reivax-boucoi/PCB_Kicad/Planar_XFMR/Validation/rounded_internal_corners_issue.png

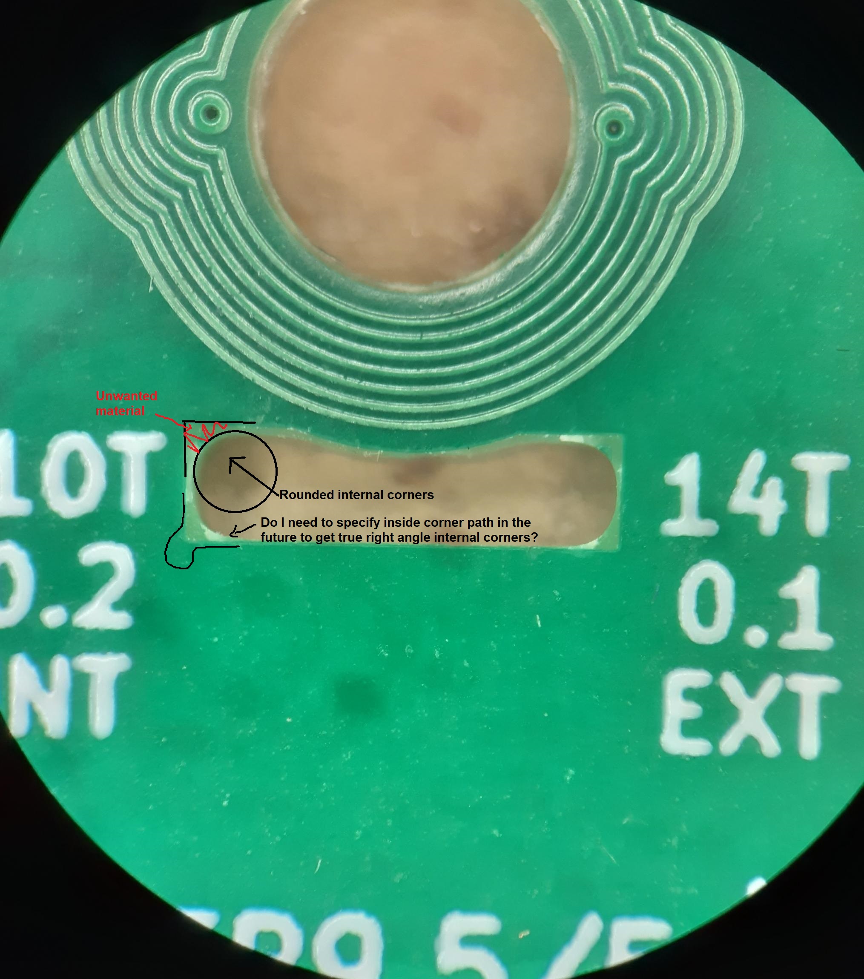
Planar_XFMR/Validation/rounded_internal_corners_issue.png
