reivax-boucoi/PCB_Kicad/Planar_XFMR/Validation/raw_brd.png

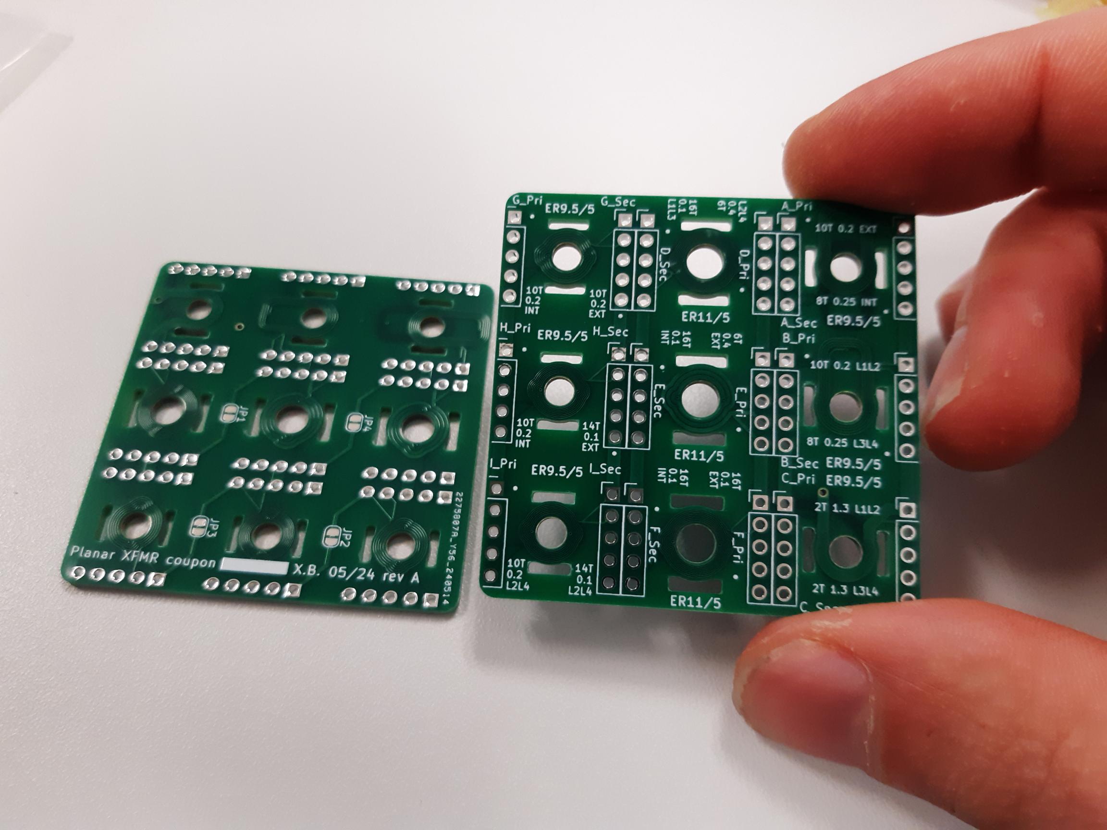
Planar_XFMR/Validation/raw_brd.png
