reivax-boucoi/PCB_Kicad/Planar_XFMR/Dimensions_labels.pptx

Core width

Pw

W

Sw

D S C S C S C S D

H

## Slide 2

N87 EP9.5-5 core (400nH/turns², B max = 390mT)

L1 copper 1oz

Prepreg 7628 0.21mm

L2 copper 0.5oz

Core 0.6mm

L2 copper 0.5oz

Prepreg 7628 0.21mm

L1 copper 1oz

Primary +

Primary -

Secondary +

Secondary -

Dielectric strength : 30kV/mm min.
