reivax-boucoi/PCB_Kicad/bike_lights2/bike_lights2_top.png

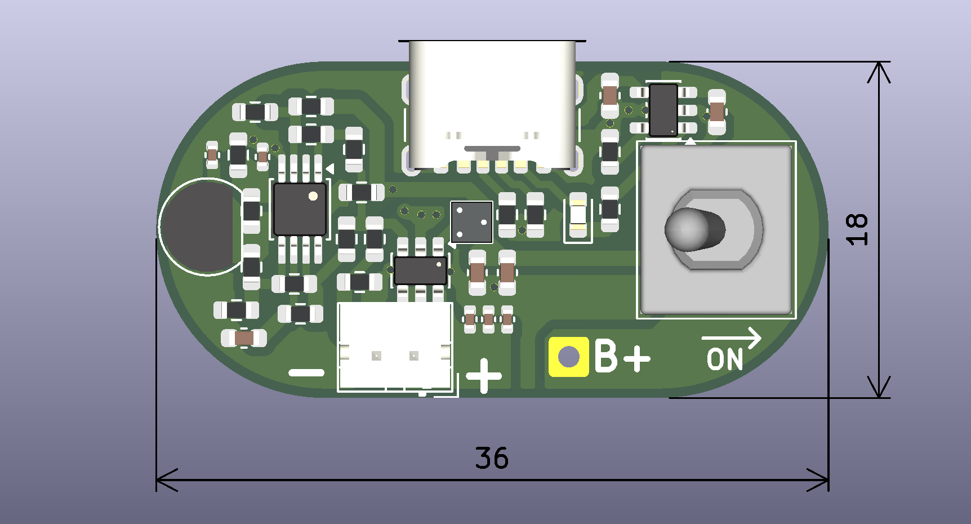
bike_lights2/bike_lights2_top.png
