reivax-boucoi/PCB_Kicad/elevator_altimeter/elevator_altimeter_back.png

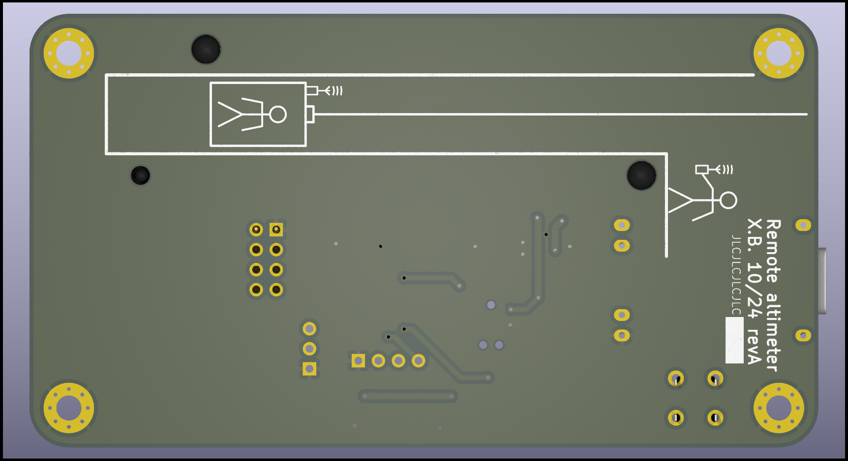
elevator_altimeter/elevator_altimeter_back.png
