reivax-boucoi/PCB_Kicad/elevator_altimeter/elevator_altimeter_front.png

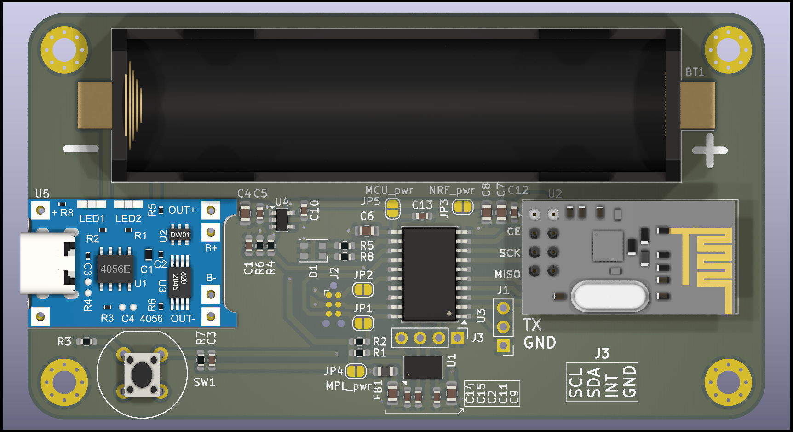
elevator_altimeter/elevator_altimeter_front.png
