reivax-boucoi/PCB_Kicad/elevator_altimeter/elevator_altimeter_iso.png

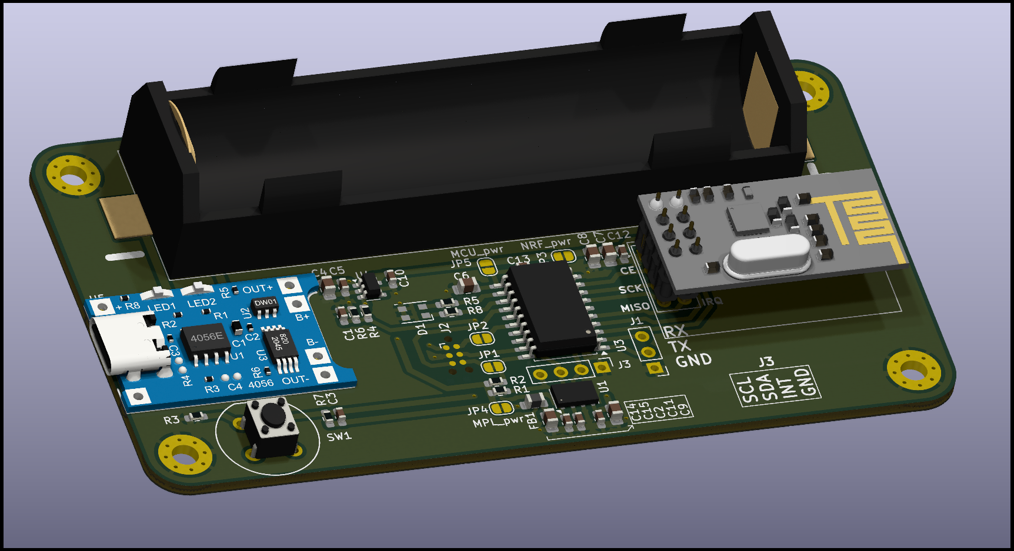
elevator_altimeter/elevator_altimeter_iso.png
