reivax-boucoi/PCB_Kicad/hall_sensor_matrix/hall_sensor_matrix_v2/hall_sensor_matrix_v2_back.png

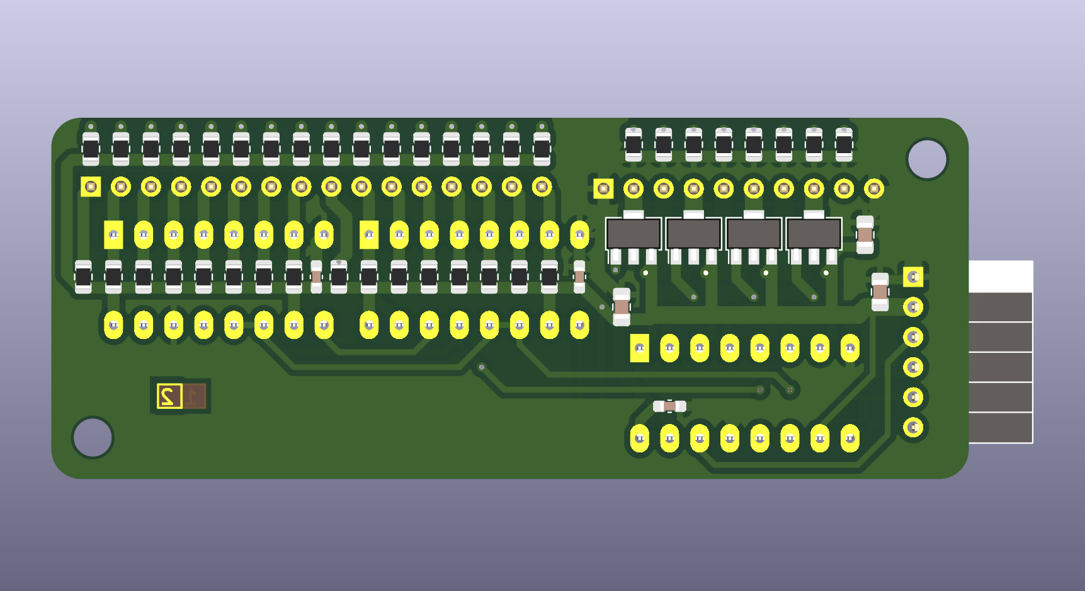
hall_sensor_matrix/hall_sensor_matrix_v2/hall_sensor_matrix_v2_back.png
