reivax-boucoi/PCB_Kicad/horse_feeder/Documentation/Source/system_diagram.drawio.png

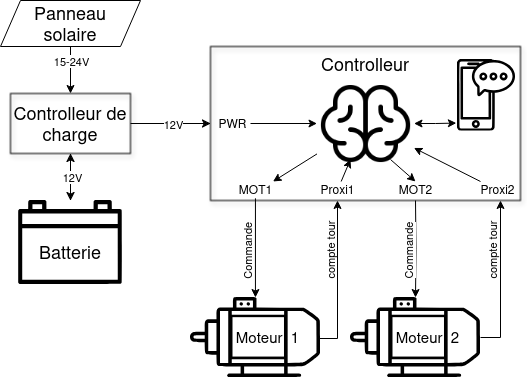
horse_feeder/Documentation/Source/system_diagram.drawio.png
