reivax-boucoi/PCB_Kicad/horse_feeder/HW/PCB_v2_M590E/horse_feeder_bot.png

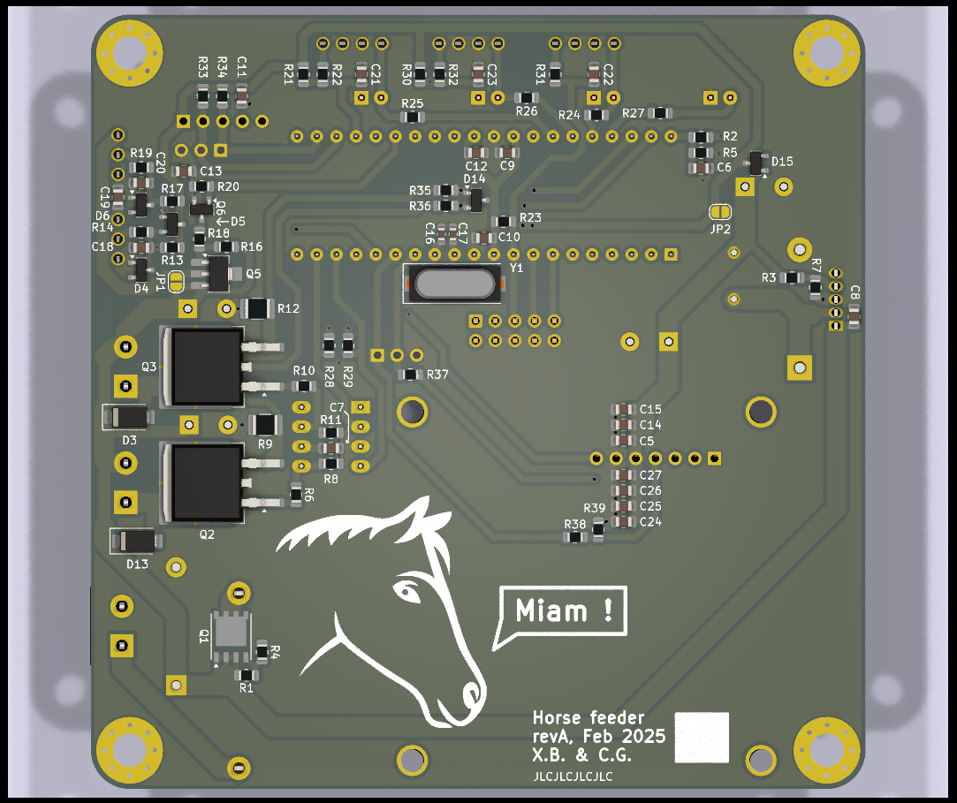
horse_feeder/HW/PCB_v2_M590E/horse_feeder_bot.png
