reivax-boucoi/PCB_Kicad/horse_feeder/HW/tremie/vue_coupe.png

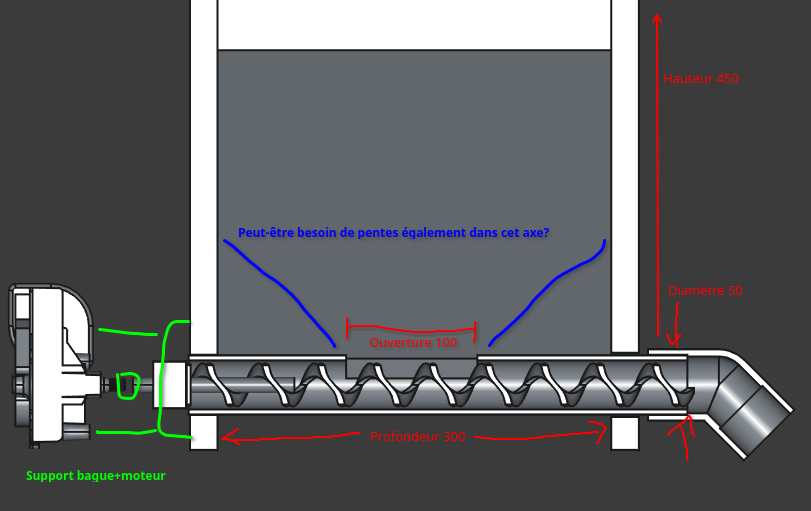
horse_feeder/HW/tremie/vue_coupe.png
