reivax-boucoi/PCB_Kicad/horse_feeder/HW/tremie/vue_iso.png

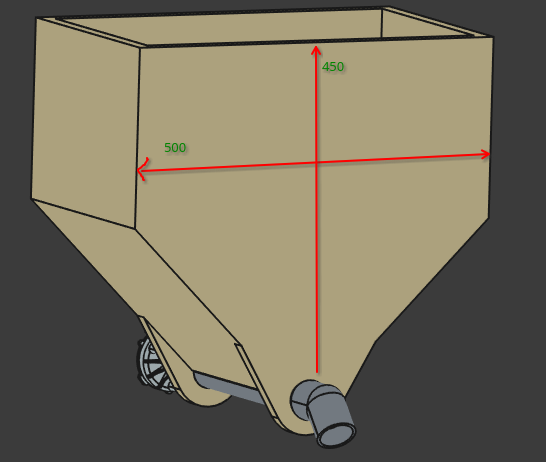
horse_feeder/HW/tremie/vue_iso.png
