reivax-boucoi/PCB_Kicad/Kheprism/HW/PCB_Ventil/PCB_Ventil_bot.png

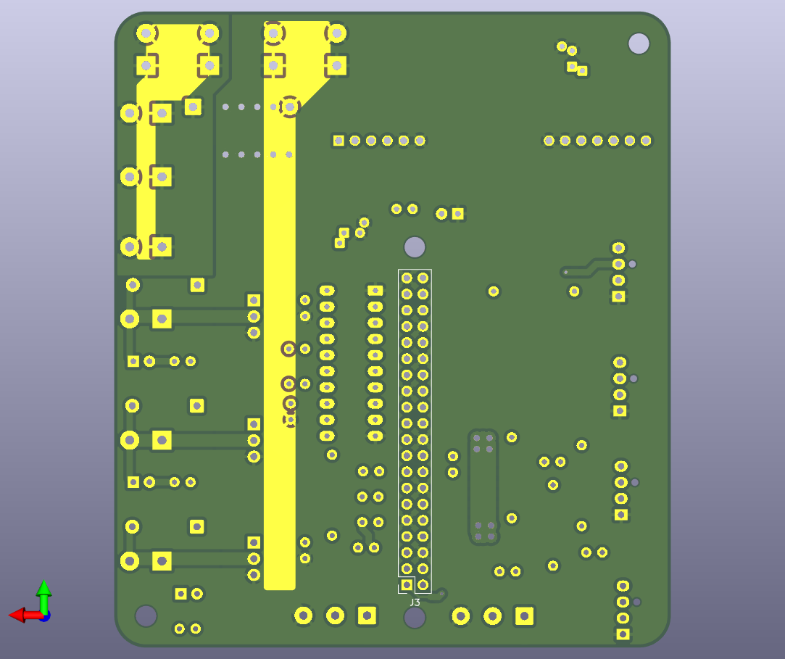
Kheprism/HW/PCB_Ventil/PCB_Ventil_bot.png
