reivax-boucoi/PCB_Kicad/Kheprism/HW/PCB_Ventil/PCB_Ventil_top.png

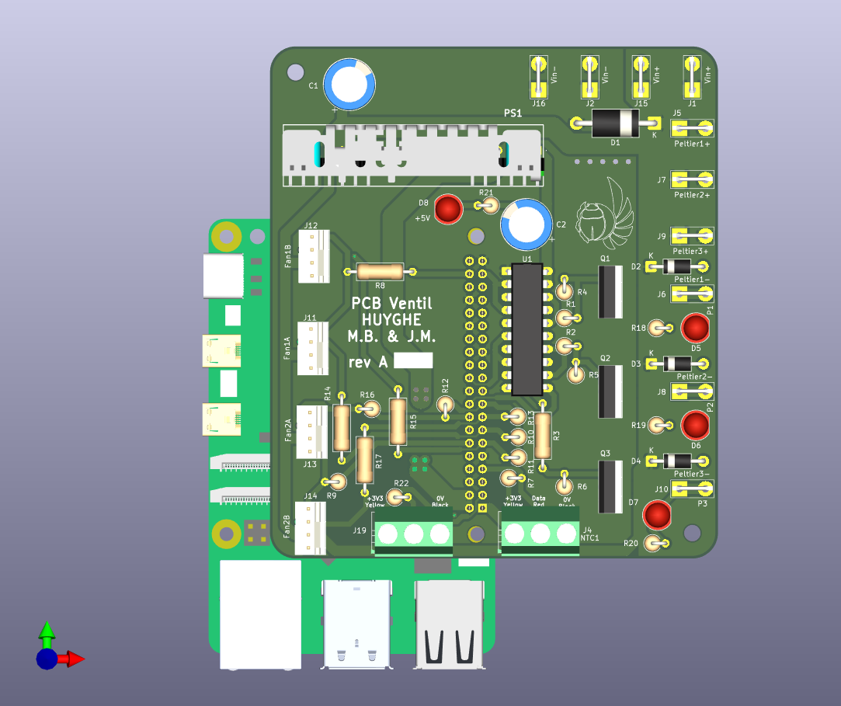
Kheprism/HW/PCB_Ventil/PCB_Ventil_top.png
