reivax-boucoi/PCB_Kicad/LED_poi/CTRL_board/LED_poi_brd_bot.png

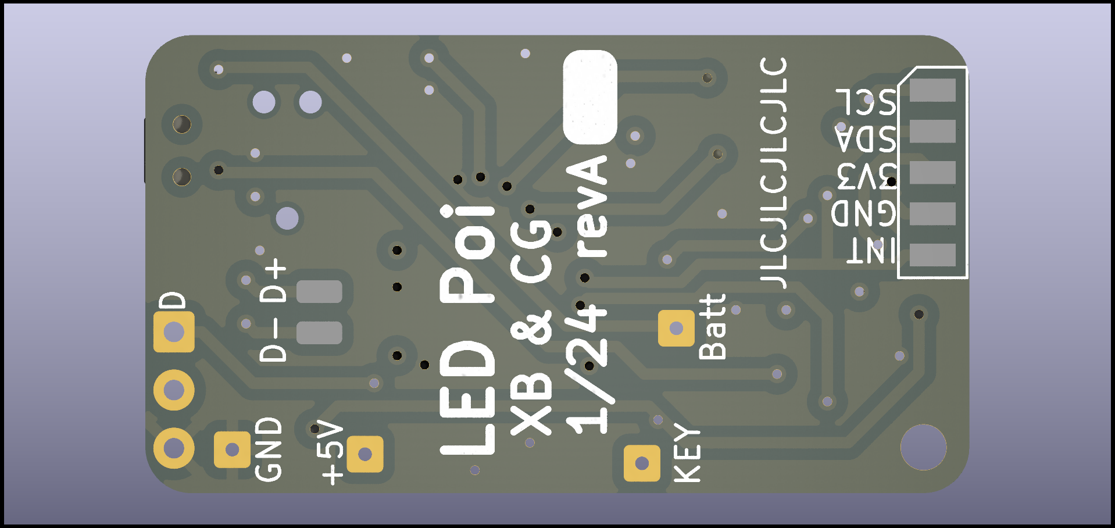
LED_poi/CTRL_board/LED_poi_brd_bot.png
