reivax-boucoi/PCB_Kicad/LED_poi/CTRL_board/LED_poi_brd_iso.png

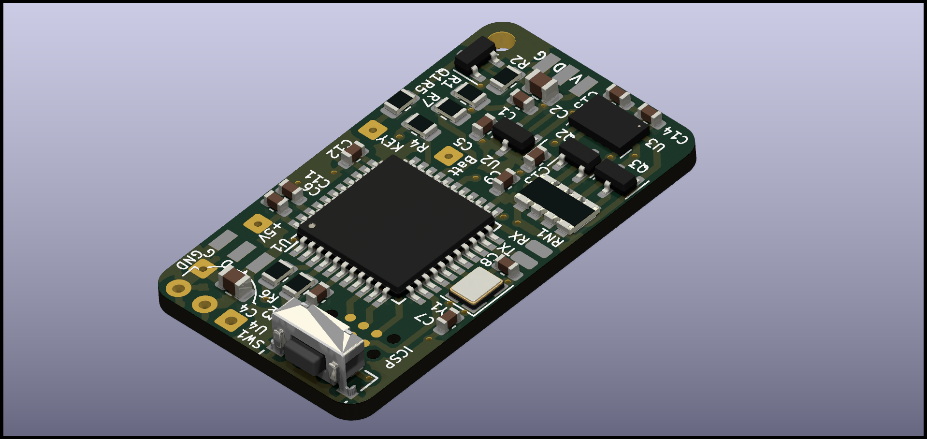
LED_poi/CTRL_board/LED_poi_brd_iso.png
