reivax-boucoi/PCB_Kicad/LED_poi/CTRL_board/LED_strip.png

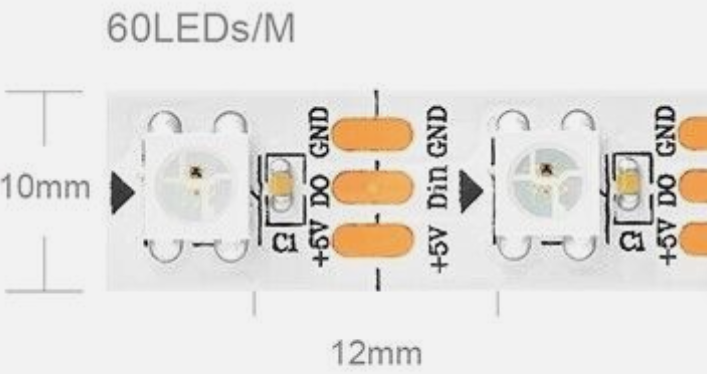
LED_poi/CTRL_board/LED_strip.png
