reivax-boucoi/PCB_Kicad/LED_poi/CTRL_board/USB_charger_pic.png

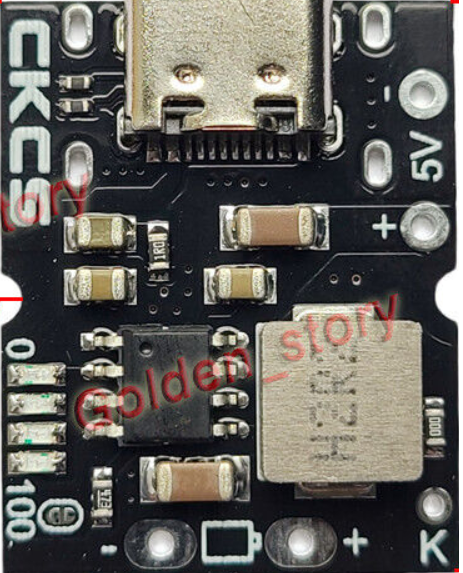
LED_poi/CTRL_board/USB_charger_pic.png
