reivax-boucoi/PCB_Kicad/LED_poi/Mechanical/mechanical_concept.png

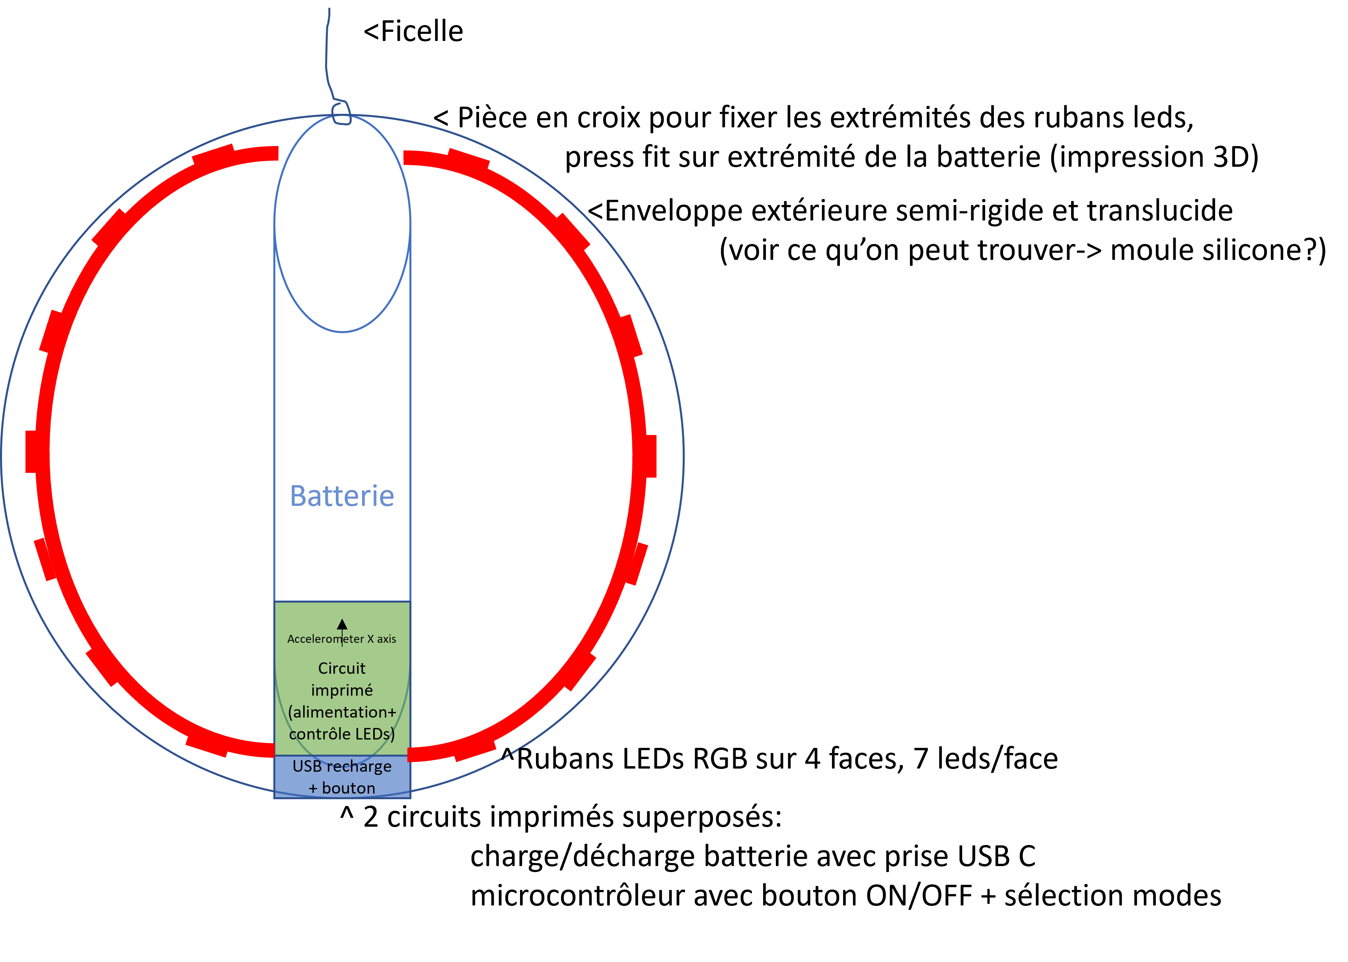
LED_poi/Mechanical/mechanical_concept.png
