reivax-boucoi/PCB_Kicad/LED_poi/Software/Accelero/capture_ko_sat.png

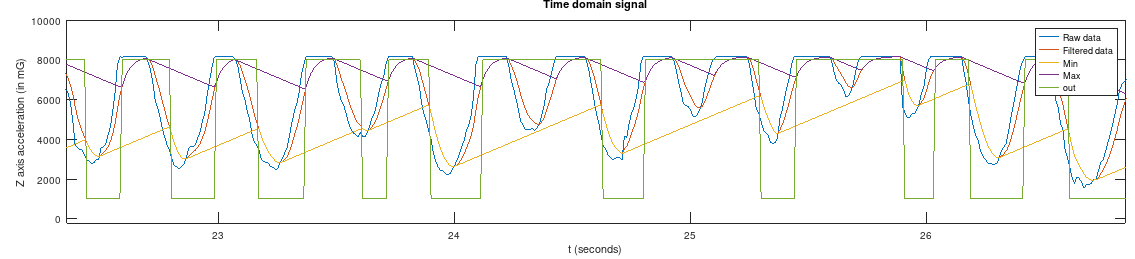
LED_poi/Software/Accelero/capture_ko_sat.png
