reivax-boucoi/PCB_Kicad/LED_poi/Software/Accelero/capture_ok.png

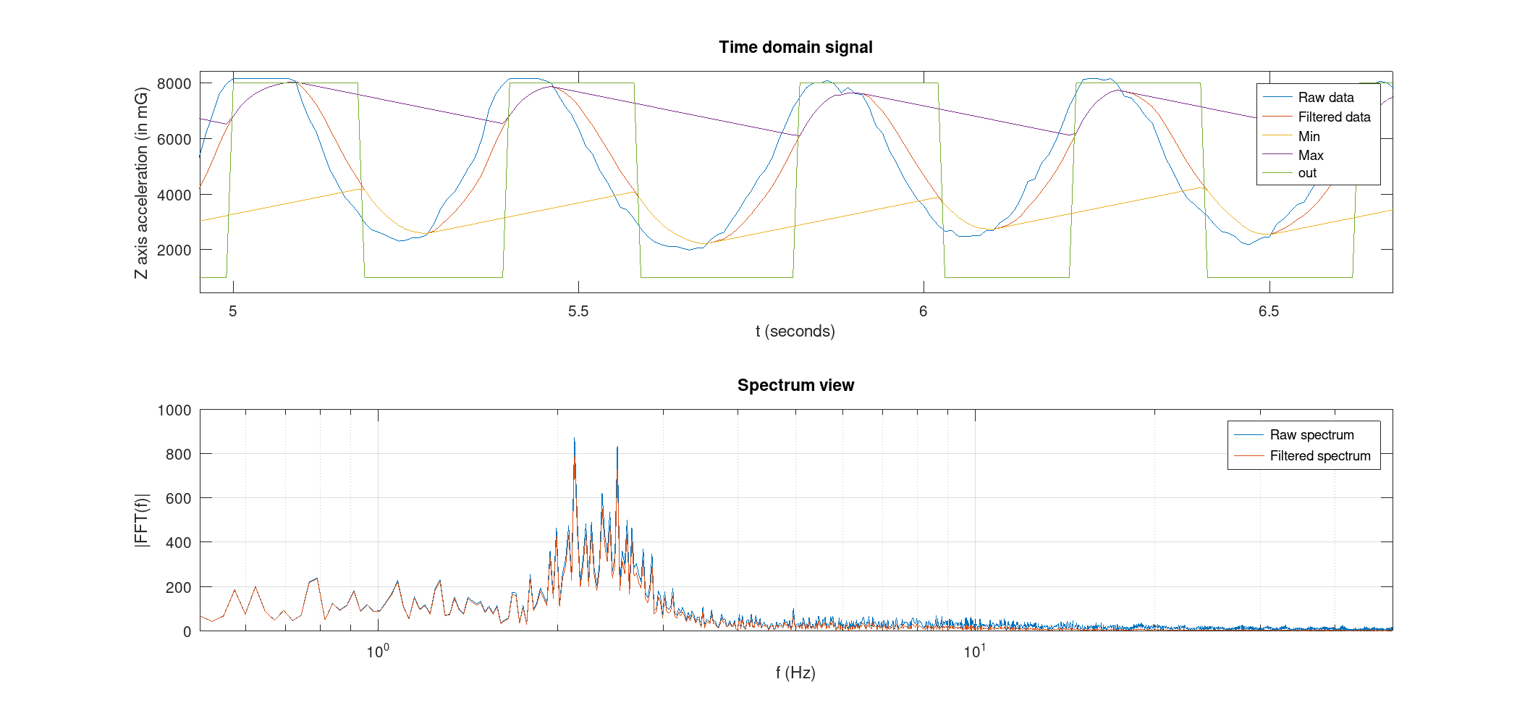
LED_poi/Software/Accelero/capture_ok.png
