reivax-boucoi/PCB_Kicad/Planar_XFMR/core.png

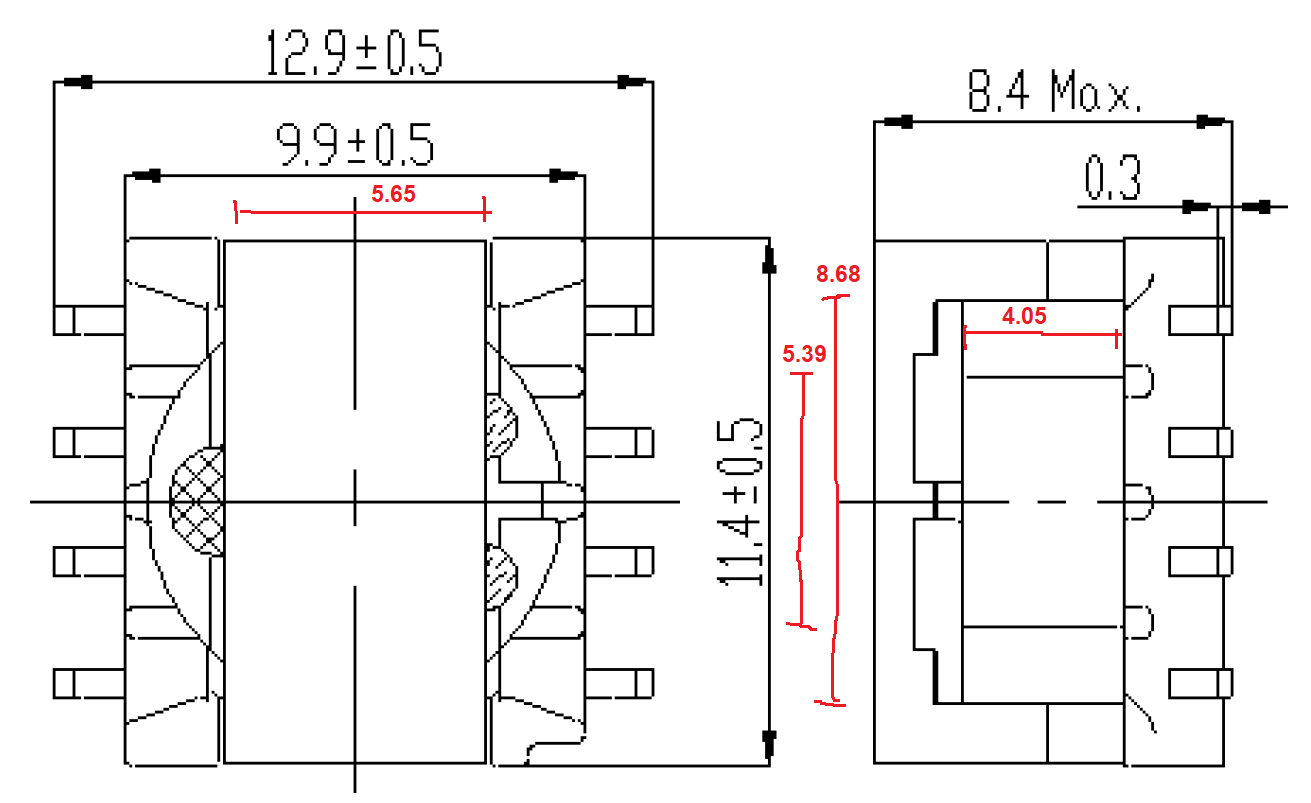
Planar_XFMR/core.png
