reivax-boucoi/PCB_Kicad/Planar_XFMR/Core_dimensions_labels.png

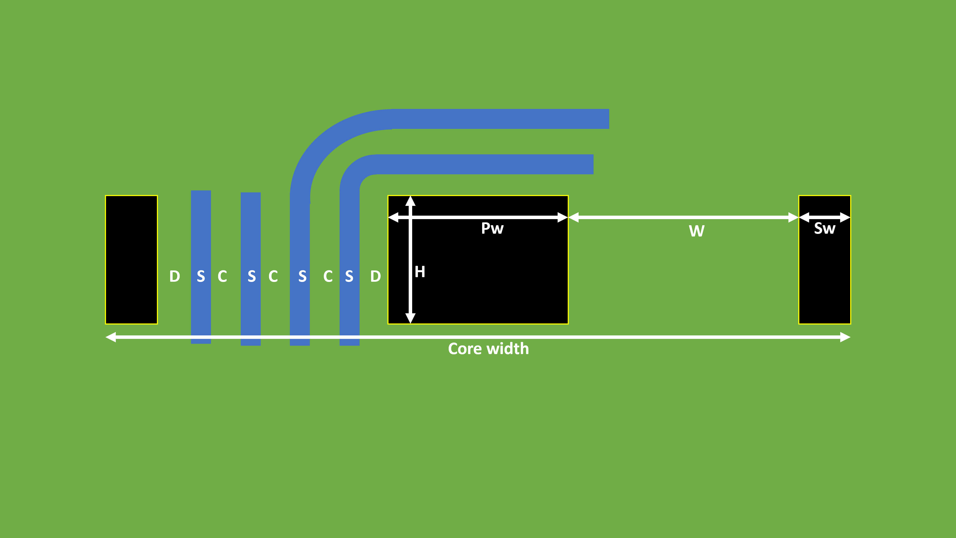
Planar_XFMR/Core_dimensions_labels.png
