reivax-boucoi/PCB_Kicad/split-flap-display2/split-flap-display2_front.png

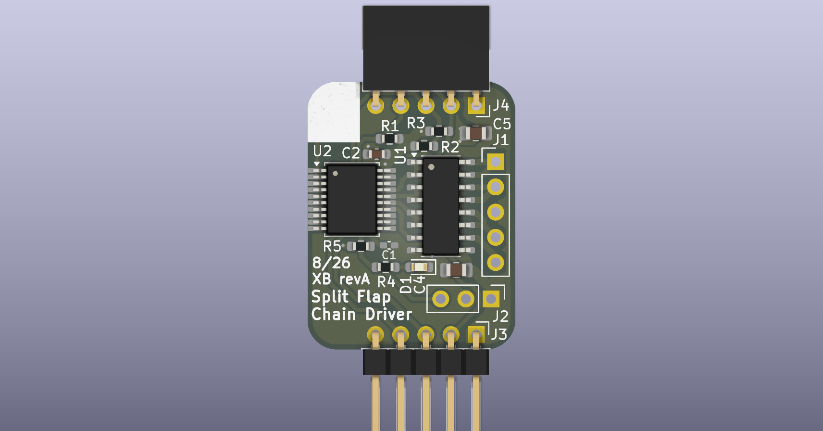
split-flap-display2/split-flap-display2_front.png
