reivax-boucoi/PCB_Kicad/Kheprism/HW/PCB_Ventil/PCB_Ventil_BOM.ods

Reference | Qty | DNP | Value | Unit Price | Total Price per board | Part Number | Footprint | Datasheet
C1,C2 | 2 | X | 100u |  | 0.00 € |  | Capacitor_THT:CP_Radial_D10.0mm_P2.50mm_P5.00mm | ~
D1 | 1 |  | P6KE36A/B | 0.11 € | 0.11 € | P6KE36A/B | Diode_THT:D_DO-201AE_P15.24mm_Horizontal | https://www.digikey.com/en/products/detail/yageo/P6KE36A-B/15856144
D2,D3,D4 | 3 |  | 1N4002 | 0.05 € | 0.14 € | 1N4002-G | Diode_THT:D_DO-41_SOD81_P10.16mm_Horizontal | https://www.digikey.com/en/products/detail/comchip-technology/1N4002-G/3307976
D5,D6,D7 | 3 |  | LED | 0.08 € | 0.23 € | BL-B5134-1-TBS20A | LED_THT:LED_D5.0mm | https://www.digikey.com/en/products/detail/american-bright-optoelectronics-corporation/BL-B5134-1-TBS20A/22486920
J1 | 1 |  | Vin+ | 0.08 € | 0.08 € | 4966 | 1287_250mil_Tab_P5.08:Faston_1287-250mils_P5.08mm | https://www.digikey.com/en/products/detail/keystone-electronics/4966/303924
J2 | 1 |  | Vin- | 0.08 € | 0.08 € | 4966 | 1287_250mil_Tab_P5.08:Faston_1287-250mils_P5.08mm | https://www.digikey.com/en/products/detail/keystone-electronics/4966/303924
J3 | 1 |  | Raspberry_Pi_4 | 1.76 € | 1.76 € | 61304021821 | Connector_PinSocket_2.54mm:PinSocket_2x20_P2.54mm_Vertical | https://www.digikey.com/en/products/detail/w%C3%BCrth-elektronik/61304021821/16608657
J4 | 1 |  | DS18B20 | 0.42 € | 0.42 € | BLR513-5-V | TerminalBlock:TerminalBlock_MaiXu_MX126-5.0-03P_1x03_P5.00mm | https://www.digikey.com/en/products/detail/dcomponents/BLR513-5-V/27565851
J5 | 1 |  | Peltier1+ | 0.08 € | 0.08 € | 4966 | 1287_250mil_Tab_P5.08:Faston_1287-250mils_P5.08mm | https://www.digikey.com/en/products/detail/keystone-electronics/4966/303924
J6 | 1 |  | Peltier1- | 0.08 € | 0.08 € | 4966 | 1287_250mil_Tab_P5.08:Faston_1287-250mils_P5.08mm | https://www.digikey.com/en/products/detail/keystone-electronics/4966/303924
J7 | 1 |  | Peltier2+ | 0.08 € | 0.08 € | 4966 | 1287_250mil_Tab_P5.08:Faston_1287-250mils_P5.08mm | https://www.digikey.com/en/products/detail/keystone-electronics/4966/303924
J8 | 1 |  | Peltier2- | 0.08 € | 0.08 € | 4966 | 1287_250mil_Tab_P5.08:Faston_1287-250mils_P5.08mm | https://www.digikey.com/en/products/detail/keystone-electronics/4966/303924
J9 | 1 |  | Peltier3+ | 0.08 € | 0.08 € | 4966 | 1287_250mil_Tab_P5.08:Faston_1287-250mils_P5.08mm | https://www.digikey.com/en/products/detail/keystone-electronics/4966/303924
J10 | 1 |  | Peltier3- | 0.08 € | 0.08 € | 4966 | 1287_250mil_Tab_P5.08:Faston_1287-250mils_P5.08mm | https://www.digikey.com/en/products/detail/keystone-electronics/4966/303924
J11 | 1 |  | Fan1A | 0.44 € | 0.44 € | 470531000 | Connector:FanPinHeader_1x04_P2.54mm_Vertical | https://www.digikey.com/en/products/detail/molex/0470531000/2421261
J12 | 1 |  | Fan1B | 0.44 € | 0.44 € | 470531000 | Connector:FanPinHeader_1x04_P2.54mm_Vertical | https://www.digikey.com/en/products/detail/molex/0470531000/2421261
J13 | 1 |  | Fan2A | 0.44 € | 0.44 € | 470531000 | Connector:FanPinHeader_1x04_P2.54mm_Vertical | https://www.digikey.com/en/products/detail/molex/0470531000/2421261
J14 | 1 |  | Fan2B | 0.44 € | 0.44 € | 470531000 | Connector:FanPinHeader_1x04_P2.54mm_Vertical | https://www.digikey.com/en/products/detail/molex/0470531000/2421261
PS1 | 1 |  | NID100-5 | 9.00 € | 9.00 € | NID100-5 | Librairie de Mano:NID1005 | https://www.meanwell.co.uk/power-supplies/dc-dc-power-supplies/nid100-series
Q1,Q2,Q3 | 3 |  | DMT6009LCT | 0.64 € | 1.92 € | DMT6009LCT | Package_TO_SOT_THT:TO-220-3_Vertical | https://www.digikey.com/en/products/detail/diodes-incorporated/DMT6009LCT/6051857
R1,R2,R3 | 3 |  | 100 | 0.02 € | 0.07 € | CFR-25JR-52-100R | Resistor_THT:R_Axial_DIN0309_L9.0mm_D3.2mm_P12.70mm_Horizontal | https://www.digikey.com/en/products/detail/yageo/CFR-25JR-52-100R/11950
R4,R5,R6,R7 | 4 |  | 10k | 0.02 € | 0.09 € | CFR-25JR-52-10K | Resistor_THT:R_Axial_DIN0309_L9.0mm_D3.2mm_P2.54mm_Vertical
R8,R9,R14,R15,R16,R17 | 6 |  | 100 | 0.02 € | 0.13 € | CFR-25JR-52-100R | Resistor_THT:R_Axial_DIN0309_L9.0mm_D3.2mm_P2.54mm_Vertical | https://www.digikey.com/en/products/detail/yageo/CFR-25JR-52-100R/11950
R10,R11,R12,R13 | 4 |  | 2k | 0.02 € | 0.09 € | CFR-25JR-52-2K | Resistor_THT:R_Axial_DIN0309_L9.0mm_D3.2mm_P2.54mm_Vertical | https://www.digikey.com/en/products/detail/yageo/CFR-25JR-52-2K/11981
R18,R19,R20 | 3 |  | 10k | 0.02 € | 0.07 € | CFR-25JR-52-10K | Resistor_THT:R_Axial_DIN0309_L9.0mm_D3.2mm_P2.54mm_Vertical | https://www.digikey.com/en/products/detail/yageo/CFR-25JR-52-10K/11998
U1 | 1 |  | CD74HCT241E | 0.86 € | 0.86 € | CD74HCT241E | Package_DIP:DIP-20_W7.62mm_LongPads | https://www.digikey.com/en/products/detail/texas-instruments/CD74HCT241E/38438
Total component count per board: | 45 |  |  | Total BOM price per board: | 17.27 €
Number of boards: | 10 |  |  | Total BOM price: | 172.70 €
 |  |  |  | PCB price (10 boards): | 85.50 €
 |  |  |  | PCB shipping: | 15.00 €
 |  |  |  | Total board cost: | 27.32 €
