reivax-boucoi/PCB_Kicad/Planar_XFMR/track_calc.xlsx

Sheet: EELP22
 |  |  |  |  |  |  |  | Current | 0.1 | A | Equivalent DC current | Vout | 24 | V |  |  |  | Ae | 78.5 | mm²
Core dimensions | Core width | 21.8 | mm | Total core width |  |  |  |  |  |  |  | Iout | 0.1 | A |  |  |  | L | 38 | µH
 | Pw | 5 | mm | Central pillar width |  |  |  |  |  |  |  | Pout | 2.4 | W |  |  |  | N | 5 | turns
 | H | 15.8 | mm | Central pillar height |  |  |  |  |  |  |  | Eff | 65% |  |  |  |  | Idc | 300 | mA
 | Sw | 2.5 | mm | Side lobe width |  |  |  |  |  |  |  | Pin | 3.692307692 | W |  |  |  | Ipk | 4.00 | A
 | Al | 1520 | nH/turn² | TODO: measure on core |  |  |  |  |  |  |  | Vin | 24 | V |  |  |  | Bmax | 387.26 | mT | Keep below 390mT
 | W | 5.9 | mm | Winding width W=(Core_width - Pw )/2 - Sw |  |  |  | T1 | 4 |  | # turns on Layer 1 | Iin | 0.1538461538 | A
 | Max T | 30 |  | Max number of turns using min spacing/min track size Max T = (W-2D+C)/(C+S) |  |  |  | T2 | 5 |  | # turns on Layer 2 | Dmax | 45% |  | Fsw | 300 | kHz | Ve | 120 | mm^3
 |  |  |  |  |  |  |  | T3 | 2 |  | # turns on Layer 3 | N ideal | 1.222222222 |  | Dmax | 42% |  | PV@300kHz | 390 | kW/m^3
 |  |  |  |  |  |  |  | Ttot | 4 |  | Total number of turns |  |  |  | Lpri max | 45.9 | µH | PV@500kHz | 215 | kW/m^3
Variable constraints | D | 0.3 | mm | Min copper to edge clearance |  |  |  | L | 24.3 | µH | Expected magnetizing inductance |  |  |  | Lpri targ | 24.3 | µH | P 300k | 46.8 | mW | Core losses
 | C | 0.1 | mm | Min track spacing |  |  |  |  |  |  |  |  |  |  | Lsec targ | 36.3 | µH | P 500k | 25.8 | mW
 | Copper 1 | 35 | µm |  |  |  |  |  |  |  |  |  |  |  | Npri targ | 3.998354925 | turns
 | Copper 2 | 35 | µm |  |  |  |  | R1 | 94.58440563 | mΩ | Layer 1 DCR |  |  |  | Nsec targ | 4.886878242 | turns
 | Copper 3 | 35 | µm |  |  |  |  | R2 | 0 | mΩ | Layer 2 DCR
 | N layers | 1 |  |  |  |  |  | R3 | 0 | mΩ | Layer 3 DCR
 |  |  |  |  |  |  |  | Rtot | 94.58440563 | mΩ | Total winding DCR (without vias) |  |  |  |  |  |  | Max energy transfer:
JLC capabilities | Min C | 0.09 | mm | Min track spacing |  |  |  |  |  |  |  |  |  |  |  |  |  | Lpri | 60 | µH
 | Min S | 0.09 | mm | Min track width |  |  |  | L1 section | 64.8 | mils² |  |  |  |  |  |  |  | I sat (+margin) | 1.1 | A
 | Min D | 0.3 | mm | Min trace to outline distance |  |  |  | L1 T rise | 0.005486624737 | °C |  |  |  |  |  |  |  | E pulse | 36.3 | µJ
 | Inner copper | 17.5 | µm |  |  |  |  | L2 section | 50.8 | mils² |  |  |  |  |  |  |  | Fsw | 100 | kHz
 | Outer copper | 35 | µm |  |  |  |  | L2 T rise | 0 | °C |  | 35/35 | Secondary |  |  |  |  | Pin calc | 3.63 | W
 | Cr | 1.72e-08 | Ω*m | Copper resistivity |  |  |  | L3 section | 134.7 | mils² |  | 7 | turns | N | 1.75
 |  |  |  |  |  |  |  | L3 T rise | 0 | °C |  | 40 | µH
step: | 5% |  |  |  |  |  |  |  |  |  |  | 429 | mOhm
 | S(mm) | Max Turns | Track length(mm) | Cross section (mm²) | Resistance L1 (mΩ) | Resistance L2 (mΩ) | Resistance L3 (mΩ)
 | 0.090 | 28.0 | 1719.2 | 0.0032 | 9387.580494 | 9387.580494 | 9387.580494 |  |  |  |  | 35/35 | Primary
 | 0.095 | 27.0 | 1651.6 | 0.0033 |  |  |  |  |  |  |  | 4 | turns | 1.2mm
 | 0.099 | 27.0 | 1662.1 | 0.0035 | 8231.653799 | 8231.653799 | 8231.653799 |  |  |  |  | 24.3 | µH
 | 0.104 | 26.0 | 1594.4 | 0.0036 | 7520.341695 | 7520.341695 | 7520.341695 |  |  |  |  | 150 | mOhm
 | 0.109 | 25.0 | 1526.8 | 0.0038
 | 0.115 | 25.0 | 1537.1 | 0.0040 | 6576.329345 | 6576.329345 | 6576.329345
 | 0.121 | 24.0 | 1469.4 | 0.0042 | 5987.21568 | 5987.21568 | 5987.21568
 | 0.127 | 23.0 | 1401.8 | 0.0044
 | 0.133 | 23.0 | 1411.9 | 0.0047 | 5218.023246 | 5218.023246 | 5218.023246 |  |  |  |  |  |  |  |  |  |  |  | Order options:
 | 0.140 | 22.0 | 1344.1 | 0.0049 | 4730.769221 | 4730.769221 | 4730.769221
 | 0.147 | 21.0 | 1276.4 | 0.0051 |  |  |  |  |  |  |  |  |  |  |  |  |  | $2 | 4Layer 50x50mm
 | 0.154 | 21.0 | 1286.0 | 0.0054 | 4105.719205 | 4105.719205 | 4105.719205 |  |  |  |  |  |  |  |  |  |  |  | or
 | 0.162 | 20.0 | 1218.0 | 0.0057 |  |  |  |  |  |  |  |  |  |  |  |  |  | $7 | 4Layer 100x100mm
 | 0.170 | 20.0 | 1227.7 | 0.0059 | 3555.016586 | 3555.016586 | 3555.016586 |  |  |  |  |  |  |  |  |  |  | $3 | Material: FR4 TG155
 | 0.178 | 19.0 | 1159.3 | 0.0062 | 3197.188344 | 3197.188344 | 3197.188344 |  |  |  |  |  |  |  |  |  |  | $0 | HASL
 | 0.187 | 18.0 | 1091.1 | 0.0065 |  |  |  |  |  |  |  |  |  |  |  |  |  | $15 | Inner & outer copper weight 1oz
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
 | 532.032 | 0.0 | 0.0 | 18.6211
 | 558.634 | 0.0 | 0.0 | 19.5522
 | 586.565 | 0.0 | 0.0 | 20.5298
 | 615.894 | 0.0 | 0.0 | 21.5563
 | 646.688 | 0.0 | 0.0 | 22.6341
 | 679.023 | 0.0 | 0.0 | 23.7658
 | 712.974 | 0.0 | 0.0 | 24.9541
 | 748.622 | 0.0 | 0.0 | 26.2018
 | 786.054 | 0.0 | 0.0 | 27.5119

Sheet: ER11-12V
 |  |  | https://www.mouser.fr/ProductDetail/EPCOS-TDK/B65525J0160A087
 |  |  | https://www.digikey.com/en/products/detail/epcos-tdk-electronics/B65525J0160A087/3913735 |  |  |  |  | Current | 0.1 | A | Equivalent DC current | Vout | 21 | V |  |  |  | Ae | 8.81 | mm²
Core dimensions | Core width | 11 | mm | Total core width |  |  |  |  |  |  |  | Iout | 0.1 | A |  |  |  | L | 80 | µH
 | Pw | 4.25 | mm | Central pillar width |  |  |  |  |  |  |  | Pout | 2.1 | W |  |  |  | N | 14 | turns
 | H | 4.25 | mm | Central pillar height |  |  |  |  |  |  |  | Eff | 70% |  |  |  |  | Idc | 100 | mA
 | Sw | 1.15 | mm | Side lobe width |  |  |  |  |  |  |  | Pin | 3 | W |  |  |  | Ipk | 476.19 | mA
 | Al | 160 | nH/turn² | TODO: measure on core |  |  |  |  |  |  |  | Vin | 24 | V |  |  |  | Bmax | 308.86 | mT | Keep below 390mT
 | W | 2.225 | mm | Winding width W=(Core_width - Pw )/2 - Sw |  |  |  | T1 | 3 |  | # turns on Layer 1 | Iin | 0.125 | A
 | Max T | 9 |  | Max number of turns using min spacing/min track size Max T = (W-2D+C)/(C+S) |  |  |  | T2 | 3 |  | # turns on Layer 2 | Dmax | 45% |  | Fsw | 250 | kHz | Ve | 120 | mm^3
 |  |  |  |  |  |  |  | T3 | 2 |  | # turns on Layer 3 | N ideal | 1.069444444 |  | Dmax | 42% |  | PV@300kHz | 390 | kW/m^3
 |  |  |  |  |  |  |  | Ttot | 6 |  | Total number of turns |  |  |  | Lpri max | 67.7 | µH | PV@500kHz | 215 | kW/m^3
Variable constraints | D | 0.3 | mm | Min copper to edge clearance |  |  |  | L | 5.8 | µH | Expected magnetizing inductance |  |  |  | Lpri targ | 60 | µH | P 300k | 46.8 | mW | Core losses
 | C | 0.1 | mm |  |  |  |  |  |  |  |  |  |  |  | Lsec targ | 68.6 | µH | P 500k | 25.8 | mW
 | Copper 1 | 35 | µm |  |  |  |  |  |  |  |  |  |  |  | Npri targ | 19.36491673 | turns
 | Copper 2 | 35 | µm |  |  |  |  | R1 | 59.20107158 | mΩ | Layer 1 DCR |  |  |  | Nsec targ | 20.70970262 | turns
 | Copper 3 | 35 | µm |  |  |  |  | R2 | 59.20107158 | mΩ | Layer 2 DCR
 | N layers | 2 |  |  |  |  |  | R3 | 0 | mΩ | Layer 3 DCR
 |  |  |  |  |  |  |  | Rtot | 118.4021432 | mΩ | Total winding DCR (without vias) |  |  |  |  |  |  | Max energy transfer:
JLC capabilities | Min C | 0.09 | mm | Min track spacing |  |  |  |  |  |  |  |  |  |  |  |  |  | Lpri | 60 | µH
 | Min S | 0.09 | mm | Min track width |  |  |  | L1 section | 24.8 | mils² |  |  |  |  |  |  |  | I sat (+margin) | 1.1 | A
 | Min D | 0.3 | mm | Min trace to outline distance |  |  |  | L1 T rise | 0.02677702159 | °C |  |  |  |  |  |  |  | E pulse | 36.3 | µJ
 | Inner copper | 17.5 | µm |  |  |  |  | L2 section | 24.8 | mils² |  |  |  |  |  |  |  | Fsw | 100 | kHz
 | Outer copper | 35 | µm |  |  |  |  | L2 T rise | 0.02677702159 | °C |  | 17.5/17.5 | Secondary |  |  |  |  | Pin calc | 3.63 | W
 | Cr | 1.72e-08 | Ω*m | Copper resistivity |  |  |  | L3 section | 28.4 | mils² |  | 16 | turns | N | 2.666666667
 |  |  |  |  |  |  |  | L3 T rise | 0 | °C |  | 41 | µH
step: | 7% |  |  |  |  |  |  |  |  |  |  | 2775 | mOhm | 1388/+0°C
 | S(mm) | Max Turns | Track length(mm) | Cross section (mm²) | Resistance L1 (mΩ) | Resistance L2 (mΩ) | Resistance L3 (mΩ) |  |  |  |  | +4°C
 | 0.090 | 9.0 | 176.5 | 0.0032 | 963.7000986 | 963.7000986 | 963.7000986 |  |  |  |  | 35/35 | Primary
 | 0.096 | 8.0 | 153.2 | 0.0034 |  |  |  |  |  |  |  | 6 | turns
 | 0.103 | 8.0 | 154.4 | 0.0036 |  |  |  |  |  |  |  | 5.8 | µH
 | 0.110 | 8.0 | 155.7 | 0.0039 | 693.8569075 | 693.8569075 | 693.8569075 |  |  |  |  | 118 | mOhm | 237/+6°C
 | 0.118 | 7.0 | 132.6 | 0.0041
 | 0.126 | 7.0 | 133.7 | 0.0044
 | 0.135 | 7.0 | 134.9 | 0.0047
 | 0.145 | 7.0 | 136.1 | 0.0051 | 462.8244956 | 462.8244956 | 462.8244956
 | 0.155 | 6.0 | 113.0 | 0.0054
 | 0.165 | 6.0 | 114.0 | 0.0058
 | 0.177 | 6.0 | 115.1 | 0.0062 | 319.5455009 | 319.5455009 | 319.5455009
 | 0.189 | 5.0 | 92.4 | 0.0066
 | 0.203 | 5.0 | 93.2 | 0.0071
 | 0.217 | 5.0 | 94.1 | 0.0076
 | 0.232 | 5.0 | 95.0 | 0.0081 | 201.2555734 | 201.2555734 | 201.2555734
 | 0.248 | 4.0 | 72.5 | 0.0087
 | 0.266 | 4.0 | 73.1 | 0.0093
 | 0.284 | 4.0 | 73.8 | 0.0100
 | 0.304 | 4.0 | 74.6 | 0.0106
 | 0.325 | 4.0 | 75.4 | 0.0114 | 113.8109655 | 113.8109655 | 113.8109655
 | 0.348 | 3.0 | 53.0 | 0.0122
 | 0.373 | 3.0 | 53.4 | 0.0130
 | 0.399 | 3.0 | 53.9 | 0.0140
 | 0.427 | 3.0 | 54.4 | 0.0149
 | 0.457 | 3.0 | 55.0 | 0.0160 | 59.20107158 | 59.20107158 | 59.20107158
 | 0.488 | 2.0 | 33.4 | 0.0171
 | 0.523 | 2.0 | 33.6 | 0.0183
 | 0.559 | 2.0 | 33.8 | 0.0196
 | 0.598 | 2.0 | 34.1 | 0.0209
 | 0.640 | 2.0 | 34.3 | 0.0224
 | 0.685 | 2.0 | 34.6 | 0.0240
 | 0.733 | 2.0 | 34.9 | 0.0257 | 23.39905166 | 23.39905166 | 23.39905166
 | 0.784 | 1.0 | 14.8 | 0.0275
 | 0.839 | 1.0 | 14.8 | 0.0294
 | 0.898 | 1.0 | 14.8 | 0.0314
 | 0.961 | 1.0 | 14.8 | 0.0336
 | 1.028 | 1.0 | 14.8 | 0.0360
 | 1.100 | 1.0 | 14.8 | 0.0385
 | 1.177 | 1.0 | 14.8 | 0.0412
 | 1.260 | 1.0 | 14.8 | 0.0441
 | 1.348 | 1.0 | 14.8 | 0.0472
 | 1.442 | 1.0 | 14.8 | 0.0505
 | 1.543 | 1.0 | 14.8 | 0.0540 | 4.724822317 | 4.724822317 | 4.724822317
 | 1.651 | 0.0 | 0.0 | 0.0578
 | 1.767 | 0.0 | 0.0 | 0.0618
 | 1.890 | 0.0 | 0.0 | 0.0662
 | 2.023 | 0.0 | 0.0 | 0.0708
 | 2.164 | 0.0 | 0.0 | 0.0757
 | 2.316 | 0.0 | 0.0 | 0.0810

Sheet: ER9.5-48V
 |  |  |  |  |  |  |  | Current | 0.1 | A | Equivalent DC current | Vout | 24 | V |  |  |  | Ae | 8.81 | mm²
Core dimensions | Core width | 9.5 | mm | Total core width |  |  |  |  |  |  |  | Iout | 0.1 | A |  |  |  | L | 78 | µH
 | Pw | 3.5 | mm | Central pillar width |  |  |  |  |  |  |  | Pout | 2.4 | W |  |  |  | N | 14 | turns
 | H | 3.5 | mm | Central pillar height |  |  |  |  |  |  |  | Eff | 70% |  |  |  |  | Idc | 100 | mA
 | Sw | 1 | mm | Side lobe width |  |  |  |  |  |  |  | Pin | 3.428571429 | W |  |  |  | Ipk | 0.50 | A
 | Al | 400 | nH/turn² | TODO: measure on core |  |  |  |  |  |  |  | Vin | 30 | V |  |  |  | Bmax | 316.20 | mT | Keep below 390mT
 | W | 2 | mm | Winding width W=(Core_width - Pw )/2 - Sw |  |  |  | T1 | 5 |  | # turns on Layer 1 | Iin | 0.1142857143 | A
 | Max T | 8 |  | Max number of turns using min spacing/min track size Max T = (W-2D+C)/(C+S) |  |  |  | T2 | 5 |  | # turns on Layer 2 | Dmax | 45% |  | Fsw | 500 | kHz | Ve | 120 | mm^3
 |  |  |  |  |  |  |  | T3 | 2 |  | # turns on Layer 3 | N ideal | 0.9777777778 |  | Dmax | 42% |  | PV@300kHz | 390 | kW/m^3
 |  |  |  |  |  |  |  | Ttot | 10 |  | Total number of turns |  |  |  | Lpri max | 46.3 | µH | PV@500kHz | 215 | kW/m^3
Variable constraints | D | 0.3 | mm | Min copper to edge clearance |  |  |  | L | 40.0 | µH | Expected magnetizing inductance |  |  |  | Lpri targ | 40 | µH | P 300k | 46.8 | mW | Core losses
 | C | 0.1 | mm |  |  |  |  |  |  |  |  |  |  |  | Lsec targ | 38.2 | µH | P 500k | 25.8 | mW
 | Copper 1 | 35 | µm |  |  |  |  |  |  |  |  |  |  |  | Npri targ | 10 | turns
 | Copper 2 | 35 | µm |  |  |  |  | R1 | 214.3049604 | mΩ | Layer 1 DCR |  |  |  | Nsec targ | 9.777777778 | turns
 | Copper 3 | 35 | µm |  |  |  |  | R2 | 214.3049604 | mΩ | Layer 2 DCR
 | N layers | 2 |  |  |  |  |  | R3 | 0 | mΩ | Layer 3 DCR
 |  |  |  |  |  |  |  | Rtot | 428.6099208 | mΩ | Total winding DCR (without vias) |  |  |  |  |  |  | Max energy transfer:
JLC capabilities | Min C | 0.09 | mm | Min track spacing |  |  |  |  |  |  |  |  |  |  |  |  |  | Lpri | 60 | µH
 | Min S | 0.09 | mm | Min track width |  |  |  | L1 section | 10.3 | mils² |  |  |  |  |  |  |  | I sat (+margin) | 1.1 | A
 | Min D | 0.3 | mm | Min trace to outline distance |  |  |  | L1 T rise | 0.1140712349 | °C |  |  |  |  |  |  |  | E pulse | 36.3 | µJ
 | Inner copper | 17.5 | µm |  |  |  |  | L2 section | 10.3 | mils² |  |  |  |  |  |  |  | Fsw | 100 | kHz
 | Outer copper | 35 | µm |  |  |  |  | L2 T rise | 0.1140712349 | °C |  | 17.5/17.5 | Secondary |  |  |  |  | Pin calc | 3.63 | W
 | Cr | 1.72e-08 | Ω*m | Copper resistivity |  |  |  | L3 section | 28.4 | mils² |  | 10 | turns | N | 0.7142857143
 |  |  |  |  |  |  |  | L3 T rise | 0 | °C |  | 40 | µH
step: | 7% |  |  |  |  |  |  |  |  |  |  | 429 | mOhm
 | S(mm) | Max Turns | Track length(mm) | Cross section (mm²) | Resistance L1 (mΩ) | Resistance L2 (mΩ) | Resistance L3 (mΩ)
 | 0.090 | 7.0 | 115.3 | 0.0032 |  |  |  |  |  |  |  | 35/35 | Primary
 | 0.096 | 7.0 | 116.1 | 0.0034 |  |  |  |  |  |  |  | 14 | turns
 | 0.103 | 7.0 | 117.0 | 0.0036 |  |  |  |  |  |  |  | 78.4 | µH
 | 0.110 | 7.0 | 117.9 | 0.0039 | 525.6743187 | 525.6743187 | 525.6743187 |  |  |  |  | 1934 | mOhm
 | 0.118 | 6.0 | 97.9 | 0.0041
 | 0.126 | 6.0 | 98.6 | 0.0044
 | 0.135 | 6.0 | 99.5 | 0.0047
 | 0.145 | 6.0 | 100.4 | 0.0051 | 341.2490638 | 341.2490638 | 341.2490638
 | 0.155 | 5.0 | 80.4 | 0.0054 |  |  |  |  |  |  |  |  |  |  |  |  |  |  | Order options:
 | 0.165 | 5.0 | 81.1 | 0.0058
 | 0.177 | 5.0 | 81.8 | 0.0062 |  |  |  |  |  |  |  |  |  |  |  |  |  | $2 | 4Layer 50x50mm
 | 0.189 | 5.0 | 82.6 | 0.0066 | 214.3049604 | 214.3049604 | 214.3049604 |  |  |  |  |  |  |  |  |  |  |  | or
 | 0.203 | 4.0 | 63.0 | 0.0071 |  |  |  |  |  |  |  |  |  |  |  |  |  | $7 | 4Layer 100x100mm
 | 0.217 | 4.0 | 63.5 | 0.0076 |  |  |  |  |  |  |  |  |  |  |  |  |  | $3 | Material: FR4 TG155
 | 0.232 | 4.0 | 64.1 | 0.0081 |  |  |  |  |  |  |  |  |  |  |  |  |  | $0 | HASL
 | 0.248 | 4.0 | 64.7 | 0.0087 |  |  |  |  |  |  |  |  |  |  |  |  |  | $15 | Inner & outer copper weight 1oz
 | 0.266 | 4.0 | 65.3 | 0.0093 | 120.8272175 | 120.8272175 | 120.8272175 |  |  |  |  |  |  |  |  |  |  | $0 | Plugged vias
 | 0.284 | 3.0 | 45.9 | 0.0100 |  |  |  |  |  |  |  |  |  |  |  |  |  | $0 | Min size/hole diameter 0.3mm/0.45mm
 | 0.304 | 3.0 | 46.3 | 0.0106 |  |  |  |  |  |  |  |  |  |  |  |  |  |  |  | No extra charge for hole<0.3mm if pad>=0.45mm
 | 0.325 | 3.0 | 46.7 | 0.0114 |  |  |  |  |  |  |  |  |  |  |  |  |  | $8 | Board outline tolerance: +/-0.1mm (precision)
 | 0.348 | 3.0 | 47.1 | 0.0122 |  |  |  |  |  |  |  |  |  |  |  |  |  | $0.5 | Confirm production file: yes
 | 0.373 | 3.0 | 47.6 | 0.0130 |  |  |  |  |  |  |  |  |  |  |  |  |  | $0 | Remove order number: specify a location
 | 0.399 | 3.0 | 48.1 | 0.0140 | 59.22714428 | 59.22714428 | 59.22714428
 | 0.427 | 2.0 | 29.1 | 0.0149
 | 0.457 | 2.0 | 29.3 | 0.0160
 | 0.488 | 2.0 | 29.5 | 0.0171 |  |  |  |  |  |  |  |  |  |  |  |  |  | proto | $15
 | 0.523 | 2.0 | 29.7 | 0.0183 |  |  |  |  |  |  |  |  |  |  |  |  |  | HB 4L 15x15 | $55
 | 0.559 | 2.0 | 29.9 | 0.0196
 | 0.598 | 2.0 | 30.2 | 0.0209
 | 0.640 | 2.0 | 30.4 | 0.0224 | 23.34884256 | 23.34884256 | 23.34884256
 | 0.685 | 1.0 | 12.9 | 0.0240
 | 0.733 | 1.0 | 12.9 | 0.0257
 | 0.784 | 1.0 | 12.9 | 0.0275
 | 0.839 | 1.0 | 12.9 | 0.0294
 | 0.898 | 1.0 | 12.9 | 0.0314
 | 0.961 | 1.0 | 12.9 | 0.0336
 | 1.028 | 1.0 | 12.9 | 0.0360
 | 1.100 | 1.0 | 12.9 | 0.0385
 | 1.177 | 1.0 | 12.9 | 0.0412
 | 1.260 | 1.0 | 12.9 | 0.0441
 | 1.348 | 1.0 | 12.9 | 0.0472 | 4.698397014 | 4.698397014 | 4.698397014
 | 1.442 | 0.0 | 0.0 | 0.0505
 | 1.543 | 0.0 | 0.0 | 0.0540
 | 1.651 | 0.0 | 0.0 | 0.0578
 | 1.767 | 0.0 | 0.0 | 0.0618
 | 1.890 | 0.0 | 0.0 | 0.0662
 | 2.023 | 0.0 | 0.0 | 0.0708
 | 2.164 | 0.0 | 0.0 | 0.0757
 | 2.316 | 0.0 | 0.0 | 0.0810

Sheet: Sheet2
 |  |  |  |  |  |  | Al | 155 | nH/turns² | With DC bias |  | 6 turns |  |  |  | 7 turns |  |  |  | 10 turns
 |  |  |  |  | Turns | 100kHz standalone | Formula | Error |  | Turns | 100kHz | Current | L 100k |  |  | Current | L 100k |  |  | Current | L 100k |  |  | Conductor width W | Conductor height | Er | Er eff | pF/cm
Fsw | 500 | kHz | µ0 | 1 | 1 | 159 | 155 | 2.51572327% |  | 1 | 150 | 0 | 4.87 |  | 0 | 0 | 6.31 |  | 0 | 0 | 14.22 |  | 0 | 0.127 | 0.254 | 4.6 | 2.9 | 0.6708
Tsw | 2 | µs | µrdg | 1 | 2 | 633 | 620 | 2.05371248% |  | 2 | 582 | 0.1 | 4.87 | 0% | 0.6 | 0.1 | 6.4 | 1.426307448% | 0.7 | 0.2 | 14.29 | 0.4922644163% | 2 | 0.254 | 0.254 | 4.6 | 3.1 | 0.8956
 |  |  | Bm | 400 | 3 | 1370 | 1395 | -1.824817518% |  | 3 | 1000 | 0.3 | 4.88 | 0.205338809% | 1.8 | 0.2 | 6.44 | 2.06022187% | 1.4 | 0.4 | 14.33 | 0.7735583685% | 4 | 0.508 | 0.254 | 4.6 | 3.3412 | 1.3143
Pout | 2.5 | W |  |  | 4 | 2516 | 2480 | 1.430842607% |  | 4 | 1818 | 0.5 | 4.88 | 0.205338809% | 3 | 0.4 | 6.48 | 2.694136292% | 2.8 | 0.6 | 14.3 | 0.5625879044% | 6 | 1 | 0.254 | 4.6 | 3.6095 | 2.0974
duty | 40% |  |  |  | 5 | 3500 | 3875 | -10.71428571% |  | 5 | 2900 | 0.7 | 4.88 | 0.205338809% | 4.2 | 0.6 | 6.5 | 3.011093502% | 4.2 | 0.9 | 14.2 | -0.1406469761% | 9 | 2 | 0.254 | 4.6 | 3.8888 | 3.6715
Ton | 0.8 | µs |  |  | 6 | 5420 | 5580 | -2.95202952% |  | 6 | 4630 | 1.44 | 4.85 | -0.4106776181% | 8.64 | 0.9 | 6.51 | 3.169572108% | 6.3 | 1.2 | 14 | -1.547116737% | 12 | 20 | 0.254 | 4.6 | 4.453 | 32.2164
Eout | 5 | µJ |  |  | 7 | 7360 | 7595 | -3.192934783% |  | 7 | 6310 | 1.9 | 4.8 | -1.437371663% | 11.4 | 1.2 | 6.5 | 3.011093502% | 8.4 | 1.5 | 13.6 | -4.360056259% | 15
Efficiency | 70% |  |  |  | 8 | 9640 | 9920 | -2.904564315% |  | 10 | 14220 | 2.2 | 4.78 | -1.848049281% | 13.2 | 1.5 | 6.5 | 3.011093502% | 10.5 | 1.8 | 12.9 | -9.282700422% | 18
Em | 7.142857143 | µJ |  |  |  |  |  |  |  |  |  | 2.6 | 4.67 | -4.106776181% | 15.6 | 1.8 | 6.43 | 1.901743265% | 12.6 | 2.1 | 11.3 | -20.53445851% | 21
Pmax | 8.928571429 | W |  |  |  |  |  |  |  |  |  | 2.8 | 4.62 | -5.133470226% | 16.8 | 2.1 | 6.36 | 0.7923930269% | 14.7 | 2.2 | 9.9 | -30.37974684% | 22 | W (mm) | height (mm) | L (cm) | Er | Cap | Cap+edge
 |  |  |  |  |  |  |  |  |  |  |  | 3 | 4.59 | -5.749486653% | 18 | 2.5 | 6.19 | -1.901743265% | 17.5 | 2.3 | 7.6 | -46.55414909% | 23 | 0.15 | 0.21 | 1 | 4.2 | 2.655 | 3.1077
Vol | 8.928571429e-11 |  |  |  |  |  |  |  |  |  |  |  |  |  |  | 2.9 | 5.77 | -8.557844691% | 20.3 | 2.5 | 5 | -64.83825598% | 25
 |  |  |  |  | 0.97 | 2.5 | 38.8% |  |  |  |  |  |  |  |  | 2.8 | 5.95 | -5.705229794% | 19.6 |  |  |  | 0
 |  |  |  |  |  |  |  |  |  |  |  |  |  |  |  |  |  |  |  |  |  |  |  | W(mm) | t(µm) | g(mm) | d | Cap in pf/m
 |  |  |  |  |  |  |  |  |  |  |  |  |  |  |  |  |  |  |  |  |  |  |  | 10 | 2 | 0.5 | 3.5 | 0.99
 |  |  |  |  | 48 | V |  | 950
 |  |  |  |  | 24 | V |  | 10
 |  |  |  |  | 10 | mA |  | 2000
 |  |  |  |  | 24 | V |  | 4.726368159 | V
 |  |  |  |  | 2.4 | kOhm
 |  |  |  |  | 240 | mW

Sheet: Sheet1
Pout needed | 1.5 | W
burst duty | 85%
Pout pk | 1.76 | W
Est eff | 75%
Pin pk | 2.35 | W | E pulse | 7.54147813 | µJ | P/Fsw
Fsw | 312 | kHz |  |  |  | E=1/2Li²
Tsw | 3.205128205 | µs |  |  |  | i=sqrt(2E/L)
Vin | 30 | V
Lpri | 79 | µH
Ipri min | 0.44 | A
chg time | 1.15 | µs |  |  |  | U=Ldi/dt
chg duty | 35.89964225% |  |  |  |  | dt=Ldi/U
chg time comp | 1.21 | µs
chg duty comp | 37.86445611%
Iavg | 82.7 | mA
Irms | 155.2 | mA |  |  |  | i(t)=(v-v*exp(-rt/L))/r
Pmos | 81.9310962 | mW |  |  |  | t(i)=-ln((V-Ri)/V)*L/R
Rth mos | 350 | °C/W |  |  | t | 2.67 | µs
Trise MOS | 28.67588367 | °C |  |  | i | 0.9029102764 | A
Coil DCR | 2 | Ω
MOS Rdson | 4 | Ω
Shunt | 1 | Ω
Total R | 7 | Ω

Sheet: ER11-48V
 |  |  | https://www.mouser.fr/ProductDetail/EPCOS-TDK/B65525J0160A087
 |  |  | https://www.digikey.com/en/products/detail/epcos-tdk-electronics/B65525J0160A087/3913735 |  |  |  |  | Current | 0.24 | A | Equivalent DC current | Vout | 21 | V |  |  |  |  | Ae | 12.4 | mm²
Core dimensions | Core width | 11 | mm | Total core width |  |  |  |  |  |  |  | Iout | 0.1 | A |  |  |  |  | L | 23.0 | µH
 | Pw | 4.25 | mm | Central pillar width |  |  |  |  |  |  |  | Pout | 2.1 | W |  |  |  |  | N | 12 | turns
 | H | 4.25 | mm | Central pillar height |  |  |  |  |  |  |  | Eff | 70% |  |  |  |  |  | Idc | 500 | mA
 | Sw | 1.15 | mm | Side lobe width |  |  |  |  |  |  |  | Pin | 3 | W |  |  |  |  | Ipk | 2380.95 | mA
 | Al | 160 | nH/turn² | TODO: measure on core |  |  |  |  |  |  |  | Vin | 24 | V |  |  |  |  | Bmax | 368.66 | mT | Keep below 390mT
 | W | 2.225 | mm | Winding width W=(Core_width - Pw )/2 - Sw |  |  |  | T1 | 3 |  | # turns on Layer 1 | Iin | 0.125 | A
 | Max T | 9 |  | Max number of turns using min spacing/min track size Max T = (W-2D+C)/(C+S) |  |  |  | T2 | 3 |  | # turns on Layer 2 | Dmax | 45% |  | Fsw | 250 | kHz |  | Ve | 120 | mm^3
 |  |  |  |  |  |  |  | T3 | 3 |  | # turns on Layer 3 | N ideal | 1.069444444 |  | Dmax | 42% |  |  | PV@300kHz | 390 | kW/m^3
 |  |  |  |  |  |  |  | T4 | 3 |  | # turns on Layer 4
 |  |  |  |  |  |  |  | Ttot | 12 |  | Total number of turns |  |  |  | Lpri max | 67.7 | µH |  | PV@500kHz | 215 | kW/m^3
Variable constraints | D | 0.3 | mm | Min copper to edge clearance |  |  |  | L | 23.0 | µH | Expected magnetizing inductance |  |  |  | Lpri targ | 60 | µH |  | P 300k | 46.8 | mW | Core losses
 | C | 0.1 | mm |  |  |  |  |  |  |  |  |  |  |  | Lsec targ | 68.6 | µH |  | P 500k | 25.8 | mW
 | Copper 1 | 35 | µm |  |  |  |  |  |  |  |  |  |  |  | Npri targ | 19.36491673 | turns
 | Copper 2 | 35 | µm |  |  |  |  | R1 | 58.8169432 | mΩ | Layer 1 DCR |  |  |  | Nsec targ | 20.70970262 | turns
 | Copper 3 | 35 | µm |  |  |  |  | R2 | 58.8169432 | mΩ | Layer 2 DCR
 | N layers | 4 |  |  |  |  |  | R3 | 117.6338864 | mΩ | Layer 3 DCR
 |  |  |  |  |  |  |  | Rtot | 235.2677728 | mΩ | Total winding DCR (without vias) |  |  |  |  |  |  |  | Max energy transfer:
JLC capabilities | Min C | 0.09 | mm | Min track spacing |  |  |  |  |  |  |  |  |  |  |  |  |  |  | Lpri | 23 | µH
 | Min S | 0.09 | mm | Min track width |  |  |  | L1 section | 25.0 | mils² |  |  |  |  |  |  |  |  | I sat (+margin) | 0.5 | A
 | Min D | 0.3 | mm | Min trace to outline distance |  |  |  | L1 T rise | 0.193353915 | °C |  |  |  |  |  |  |  |  | E pulse | 2.875 | µJ
 | Inner copper | 35 | µm |  |  |  |  | L2 section | 25.0 | mils² |  |  |  |  |  |  |  |  | Fsw | 450 | kHz
 | Outer copper | 35 | µm |  |  |  |  | L2 T rise | 0.193353915 | °C |  | 35/35 | Secondary |  |  |  |  |  | Pin calc | 1.29375 | W
 | Cr | 1.72e-08 | Ω*m | Copper resistivity |  |  |  | L3 section | 22.2 | mils² |  | 8 | turns | N | 0.6666666667
 |  |  |  |  |  |  |  | L3 T rise | 0.2342865184 | °C |  | 10.2 | µH
step: | 6% |  |  |  |  |  |  |  |  |  |  | 228 | mOhm |  |  |  |  | 35/35 | Secondary
 | S(mm) | Max Turns | Track length(mm) | Cross section (mm²) | Resistance L1 (mΩ) | Resistance L2 (mΩ) | Resistance L3 (mΩ) |  |  |  |  |  |  |  |  |  |  | 8 | turns | N | 0.6666666667
 | 0.090 | 9.0 | 176.5 | 0.0032 | 963.7000986 | 963.7000986 | 963.7000986 |  |  |  |  | 35/35 | Primary |  |  |  |  | 10.2 | µH
 | 0.095 | 8.0 | 153.1 | 0.0033 |  |  |  |  |  |  |  | 12 | turns |  |  |  |  | 228 | mOhm
 | 0.101 | 8.0 | 154.1 | 0.0035 |  |  |  |  |  |  |  | 23 | µH
 | 0.107 | 8.0 | 155.1 | 0.0038 |  |  |  |  |  |  |  | 237 | mOhm |  |  |  |  | 35/35 | Primary
 | 0.114 | 8.0 | 156.3 | 0.0040 | 675.8467589 | 675.8467589 | 675.8467589 |  |  |  |  |  |  |  |  |  |  | 12 | turns
 | 0.120 | 7.0 | 132.9 | 0.0042 |  |  |  |  |  |  |  |  |  |  |  |  |  | 23 | µH
 | 0.128 | 7.0 | 133.9 | 0.0045 |  |  |  |  |  |  |  |  |  |  |  |  |  | 235 | mOhm
 | 0.135 | 7.0 | 134.9 | 0.0047
 | 0.143 | 7.0 | 136.0 | 0.0050 | 465.8042523 | 465.8042523 | 465.8042523
 | 0.152 | 6.0 | 112.8 | 0.0053
 | 0.161 | 6.0 | 113.6 | 0.0056
 | 0.171 | 6.0 | 114.5 | 0.0060
 | 0.181 | 6.0 | 115.5 | 0.0063 | 313.428975 | 313.428975 | 313.428975
 | 0.192 | 5.0 | 92.5 | 0.0067
 | 0.203 | 5.0 | 93.2 | 0.0071
 | 0.216 | 5.0 | 94.0 | 0.0075
 | 0.229 | 5.0 | 94.8 | 0.0080
 | 0.242 | 5.0 | 95.7 | 0.0085 | 194.0274204 | 194.0274204 | 194.0274204
 | 0.257 | 4.0 | 72.8 | 0.0090
 | 0.272 | 4.0 | 73.4 | 0.0095
 | 0.289 | 4.0 | 74.0 | 0.0101
 | 0.306 | 4.0 | 74.6 | 0.0107
 | 0.324 | 4.0 | 75.3 | 0.0114 | 114.1544495 | 114.1544495 | 114.1544495
 | 0.344 | 3.0 | 52.9 | 0.0120
 | 0.364 | 3.0 | 53.3 | 0.0128
 | 0.386 | 3.0 | 53.7 | 0.0135
 | 0.409 | 3.0 | 54.1 | 0.0143
 | 0.434 | 3.0 | 54.6 | 0.0152
 | 0.460 | 3.0 | 55.1 | 0.0161 | 58.8169432 | 58.8169432 | 58.8169432
 | 0.488 | 2.0 | 33.4 | 0.0171
 | 0.517 | 2.0 | 33.5 | 0.0181
 | 0.548 | 2.0 | 33.7 | 0.0192
 | 0.581 | 2.0 | 33.9 | 0.0203
 | 0.616 | 2.0 | 34.2 | 0.0215
 | 0.653 | 2.0 | 34.4 | 0.0228
 | 0.692 | 2.0 | 34.6 | 0.0242
 | 0.733 | 2.0 | 34.9 | 0.0257 | 23.39371881 | 23.39371881 | 23.39371881
 | 0.777 | 1.0 | 14.8 | 0.0272
 | 0.824 | 1.0 | 14.8 | 0.0288
 | 0.873 | 1.0 | 14.8 | 0.0306
 | 0.926 | 1.0 | 14.8 | 0.0324
 | 0.981 | 1.0 | 14.8 | 0.0343
 | 1.040 | 1.0 | 14.8 | 0.0364
 | 1.103 | 1.0 | 14.8 | 0.0386
 | 1.169 | 1.0 | 14.8 | 0.0409
 | 1.239 | 1.0 | 14.8 | 0.0434
 | 1.313 | 1.0 | 14.8 | 0.0460
 | 1.392 | 1.0 | 14.8 | 0.0487
 | 1.475 | 1.0 | 14.8 | 0.0516 | 4.941088254 | 4.941088254 | 4.941088254

Sheet: 48V_design_measurements
 | 48V
F | 177.3 | pri1+pri2+caps
IN1 | 161.9 | pri1+pri2
IN2 | x
IN3 | x
IN4 | 204.6 | pri1+pri2+supply |  | supply 75.6mm
B | 170.7 | pri1+pri2+feed
tot | 725.5
pri X HS | L1 | L2 | L5 | L6 | total | config | width (mm) | length (mm) | DCR (mΩ) | Current at 20°C rise
tours | 3 | 3 | 3 | 3 | 12 | L1->L2->L5->L6 in series | 0.45 | 250.3 | 613 | 1.54
pri X LS | L1 | L2 | L5 | L6 | total | config | width (mm) | length (mm) | DCR (mΩ) | Current at 20°C rise
 | 6 | 6 | 6 | 6 | 12 | (L1->L2)//(L5->L6) | 0.18 | 598 *2 in // | 1275 | 0.84
pri X HS |  |  | pri X LS |  |  | sec X HS
segments droits |  |  | 7.6 | top |  | 7.85 | L3
13.12 | bot |  | 20.04
21.33 |  |  | 19.96
19.63 |  |  | 18.8
11.57 |  |  | 17.64
7.8 |  |  | 16.48
19.63 |  |  | 15.32
21.33 |  |  | 30.65
25.06 |  |  | 20.04 | Début L2
21.33 |  |  | 7.6
19.63 |  |  | 20.04
9.32 |  |  | 19.96
10.25 |  |  | 18.8
19.63 |  |  | 17.64
21.33 |  |  | 16.48
9.3 | top |  | 15.32 | Fin L2
250.26 | tot segments |  | 282.37 | total L1+L2
segments courbes |  |  | segments courbes
rayon (mm) | angle (°) | longueur (mm) | rayon (mm) | angle (°) | longueur (mm)
2.71 | 242 | 11.4462183 | 2.52 | 242 | 10.64371591
3.26 | 236 | 13.42786513 | 2.8 | 239 | 11.67974335
3.8 | 231 | 15.32050017 | 3.08 | 236 | 12.68644927
 | tot arc/layer | 40.19458361 | 3.35 | 233 | 13.62316748
 | tot arc | 160.7783344 | 3.64 | 231 | 14.67542648
tot arc+segments |  |  | 3.91 | 229 | 15.62750359
411.0383344 | mm |  |  | tot arc/layer | 78.93600608
 |  |  |  | tot arc | 315.7440243
 |  |  | tot arc+segments
 |  |  | 598.1140243 | mm
