reivax-boucoi/PCB_Kicad/LED_poi/calculs.xlsx

Sheet: Main
Vitesse rotation max | 1.2 | tours/s |  | Autonomie cible | 1.5 | heures | (a pleine puissance (blanc, x2 sur utilisation moyenne)
Vitesse rotation max | 1.8 | tours/s
Diamètre boule | 8.2 | cm
Longueur ficelle | 42 | cm
Période rotation max | 833.3333333 | ms |  | Diamètre intérieur boule | 7.2 | cm |  | Comparaison de tailles de batteries lithium courantes
Période rotation min | 555.5555556 | ms |  | Périmètre intérieur boule | 22.6 | cm |  | Si la 26650 est trop lourde on pourra passer sur la 18650 (autonomie /2)
 |  |  |  | # demi-diamètres | 4 |  |  | Cell name | Capacity (Ah) | Diameter (mm) | Length (mm) | Min diam. ball | Volume (cm3) | Weight (g) | Density (g/cm3) | Est. Lifetime (hours)
 |  |  |  | Longueur total ruban | 90.5 | cm |  | 18650 | 2.2 | 18 | 650 | 650.2 | 165.4 | 50 | 0.302 | 0.8
WS2812 refresh rate | 400 | Hz | 400Hz, 2812B is 2kHz? |  |  |  |  | 26650 | 5 | 26 | 650 | 650.5 | 345.1 | 103.5311859 |  | 1.8
WS2812 refresh interval | 2.5 | ms |  |  |  |  |  | 21700 | 5 | 21 | 700 | 700.3 | 242.5 | 70 | 0.289 | 1.8
WS2812 data rate | 800 | kbps |  | Densité ruban | 60 | LEDs/m |  | 32700 | 6 | 32 | 700 | 700.7 | 563.0 | 168.8920211 |  | 2.1
WS2812 data length | 24 | bits |  | Pitch ruban | 1.67 | cm/LED |  | 4680 | 26 | 46 | 800 | 801.3 | 1329.5 | 355 | 0.267 | 9.2
frame bit length | 168 | bits |  | # LEDs total | 28
frame duration (+RST) | 260 | µs |  | # LEDs par branche | 7 |  | < 4 branches en étoile couvrant 4 demi-périmètres de la boule
LED Busy ratio | 10.4% |  | < occupation temps processeur | Puissance individuelle | 0.3 | W/LED
 |  |  |  | Puissance ruban | 8.4 | W | < j'espère que ce sera assez lumineux. A voir en fonction de la transparence du boitier
Rayon effectif | 46.1 | cm |  | Tension LEDs | 5 | V
Périmètre cercle | 289.6548427 | cm |  | Courant LEDs | 1.68 | A
Vitesse cercle min | 347.5858112 | cm/s |  | Boost efficiency | 80%
Vitesse cercle max | 625.6544601 | cm/s
Résolution spatiale Vmax | 3.1 | cm | < taille mini d'un segment de couleur en rot°
Résolution spatiale Vmin | 1.7 | cm
 |  |  |  | Puissance batterie | 10.5 | W
 |  |  |  | Capacité batterie min | 15.75 | Wh
Fréquence quartz | 16 | MHz |  | Tension batterie | 3.7 | V
Tolérance quartz | 30 | ppm |  | Courant batterie | 2.8 | A
Durée show | 5 | min |  | Capacité batterie min | 4.26 | Ah
Décalage max | 18 | ms | < décalage entre 2 poi après 5min
Décalage RC 5% | 30 | s |  | Standby current | 3000 | µA
 |  |  |  | Storage lifetime | 59.1 | days | < durée de vie de la batterie en stockage (autodécharge)
Vitesse angulaire max | 11.31 | rad/s
Vitesse angulaire min | 7.54 | rad/s
Acceleration min | 2.67 | g
Acceleration max | 6.01 | g
Si je ne me plante pas, l'accéléromètre devrait retourner sur l'axe colinéaire à la ficelle: - une valeur contante proportionnelle à la vitesse de rotation - et +/- 1g lié à la gravité (peut être utilisé pour une synchro angulaire du motif) cf onglet Accéléro

Sheet: Weight
Case | 65 | g
Battery | 104 | g | Possibilité de réduire à 50g (45min d'autonomie au lieu d'1h30)
LED strip | 7 | g
Charger PCB | 3 | g
Ctrl PCB | 5 | g
3D prints | 5 | g
 |  |  | Les masses sont estimées au pifomètre pour l'instant (sauf batterie)
Total | 189 | g
Masse cible | 155 | g
Ecart | 21.93548387%
Un recherche rapide pour une enveloppe translucide (à voir si il faut qqch de plus rigide):
https://www.amazon.fr/SENHAI-silicone-cr%C3%A9atifs-fabrication-d%C3%A9coration/dp/B09YV1P8BJ
https://www.amazon.fr/SAVITA-Moules-Silicone-Tailles-Compte-gouttes/dp/B09T9HXSCL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
https://www.amazon.fr/Moule-boules-silicone-r%C3%A9sine-pendentif/dp/B0CM3B7629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
https://www.amazon.fr/iSuperb-Silicone-Sph%C3%A9riques-Pendentif-Artisanat/dp/B09Q2V88KN

Sheet: BOM
 | Reference | Value | Footprint | DNP | Qty | Unit cost | Total cost
Carte contrôle | C1, C5, C6, C9, C12, C14, C15 | 100n | Capacitor_SMD:C_0603_1608Metric |  | 7.00 | $0.01 | $0.07
 | C2-C4 | 10u | Capacitor_SMD:C_0805_2012Metric |  | 3.00 | $0.01 | $0.03
 | C7, C8 | 22p | Capacitor_SMD:C_0603_1608Metric |  | 2.00 | $0.01 | $0.02
 | C10, C11 | 1u | Capacitor_SMD:C_0603_1608Metric |  | 2.00 | $0.01 | $0.02
 | C13 | 2u2 | Capacitor_SMD:C_0603_1608Metric |  | 1.00 | $0.01 | $0.01
 | J1-J3 | Conn_01x03 | Connector_PinHeader_2.54mm:PinHeader_1x03_P2.54mm_Vertical | x | 3.00 | $0 | $0.00
 | J4 | D+ | Connector_Wire:SolderWire-0.1sqmm_1x01_D0.4mm_OD1mm | x | 1.00 | $0 | $0.00
 | J5 | Batt | Connector_Wire:SolderWire-0.75sqmm_1x01_D1.25mm_OD2.3mm | x | 1.00 | $0 | $0.00
 | J6 | +5V | Connector_Wire:SolderWire-0.75sqmm_1x01_D1.25mm_OD2.3mm | x | 1.00 | $0 | $0.00
 | J7 | KEY | Connector_Wire:SolderWire-0.1sqmm_1x01_D0.4mm_OD1mm | x | 1.00 | $0 | $0.00
 | J8 | D- | Connector_Wire:SolderWire-0.1sqmm_1x01_D0.4mm_OD1mm | x | 1.00 | $0 | $0.00
 | J9 | GND | Connector_Wire:SolderWire-0.75sqmm_1x01_D1.25mm_OD2.3mm | x | 1.00 | $0 | $0.00
 | J10 | AVR-ICSP-TagConnect | Connector:Tag-Connect_TC2030-IDC-NL_2x03_P1.27mm_Vertical | x | 1.00 | $0 | $0.00
 | J11 | Ext_ACC | Connector_PinHeader_2.54mm:PinHeader_1x05_P2.54mm_Vertical | x | 1.00 | $0 | $0.00
 | J12 | RX | Connector_Wire:SolderWirePad_1x01_SMD_1x2mm | x | 1.00 | $0 | $0.00
 | J13 | TX | Connector_Wire:SolderWirePad_1x01_SMD_1x2mm | x | 1.00 | $0 | $0.00
 | Q1-Q3 | 2N7002 | Package_TO_SOT_SMD:SOT-23 |  | 3.00 | $0.05 | $0.15
 | R1, R5, R7 | 10k | Resistor_SMD:R_0805_2012Metric |  | 3.00 | $0.01 | $0.03
 | R2 | 100k | Resistor_SMD:R_0805_2012Metric |  | 1.00 | $0.01 | $0.01
 | R3, R6 | 22 | Resistor_SMD:R_0805_2012Metric |  | 2.00 | $0.01 | $0.02
 | R4 | 10 | Resistor_SMD:R_0805_2012Metric |  | 1.00 | $0.01 | $0.01
 | RN1 | 10k | Resistor_SMD:R_Array_Convex_4x1206 |  | 1.00 | $0.03 | $0.03
 | SW1 | SW_Push | footprints:TL3330 |  | 1.00 | $0.03 | $0.03
 | U1 | ATmega32U4-A | Package_QFP:TQFP-44_10x10mm_P0.8mm |  | 1.00 | $4.80 | $4.80
 | U2 | MCP1810 | Package_TO_SOT_SMD:SOT-23 |  | 1.00 | $0.30 | $0.30
 | U3 | ADXL343 | Package_LGA:LGA-14_3x5mm_P0.8mm_LayoutBorder1x6y |  | 1.00 | $2.53 | $2.53
 | Y1 | 16MHz | Crystal:Crystal_SMD_SeikoEpson_FA238-4Pin_3.2x2.5mm |  | 1.00 | $0.41 | $0.41
 | U4 | TSOP23xx | OptoDevice:Vishay_MOLD-3Pin |  | 1.00 | $1.38 | $1.38
Autres composants | LED strip | 293044194822 | 1M WS2812B/5050 LED 60Leds/m |  | 0.25 | $9.90 | $2.48
 | Ctrl bare PCB |  | 5pcs 4 layers 38x20mm |  | 0.20 | $4.40 | $0.88
 | Battery | 26650 | To be confirmed |  | 1.00 | $3.40 | $3.40
 | Charge board | 264869408372 | 5V 2A USB C battery charger for 18650 |  | 0.25 | $12.67 | $3.17
 | Case | ? | ? |  | 1.00 | 0 | $0.00
 |  |  |  | # of components: | 47.70 | Total HW cost | $19.77

Sheet: Accelerometer
Speed | 90 | rpm | Ang. Speed | 9.425 | rad/s | Centripetal | 4.18 | g
Speed | 60 | rpm | Ang. Speed | 6.283 | rad/s | Centripetal | 1.86 | g
Timestep | 3 | ms | Radius | 0.461 | m
 |  | 60 RPM |  |  |  |  | 90 RPM
 | Time(ms) | Position (°) | Gravity | Forces sum | Pos° | Gravity | Forces sum |  | Min
 | 0 | 0 | 0 | 1.86 | 0.00 | 0 | 4.18 |  | 4.18
 | 3 | 1.08 | 0.01884843972 | 1.87 | 1.62 | 0.02827056677 | 4.20 |  | 4.18
 | 6 | 2.16 | 0.03769018267 | 1.89 | 3.24 | 0.05651853448 | 4.23 |  | 4.18
 | 9 | 3.24 | 0.05651853448 | 1.91 | 4.86 | 0.08472132214 | 4.26 |  | 4.18
 | 12 | 4.32 | 0.07532680553 | 1.93 | 6.48 | 0.1128563849 | 4.29 |  | 4.18
 | 15 | 5.4 | 0.09410831332 | 1.95 | 8.10 | 0.1409012319 | 4.32 |  | 4.18
 | 18 | 6.48 | 0.1128563849 | 1.97 | 9.72 | 0.1688334447 | 4.34 |  | 4.18
 | 21 | 7.56 | 0.1315643591 | 1.99 | 11.34 | 0.1966306946 | 4.37 |  | 4.18
 | 24 | 8.64 | 0.1502255891 | 2.01 | 12.96 | 0.2242707609 | 4.40 |  | 4.18
 | 27 | 9.72 | 0.1688334447 | 2.02 | 14.58 | 0.2517315487 | 4.43 |  | 4.18
 | 30 | 10.8 | 0.1873813146 | 2.04 | 16.20 | 0.278991106 | 4.45 |  | 4.18
 | 33 | 11.88 | 0.2058626088 | 2.06 | 17.82 | 0.3060276422 | 4.48 |  | 4.18
 | 36 | 12.96 | 0.2242707609 | 2.08 | 19.44 | 0.3328195445 | 4.51 |  | 4.18
 | 39 | 14.04 | 0.2425992308 | 2.10 | 21.06 | 0.359345396 | 4.53 |  | 4.18
 | 42 | 15.12 | 0.2608415063 | 2.12 | 22.68 | 0.3855839923 | 4.56 |  | 4.18
 | 45 | 16.2 | 0.278991106 | 2.13 | 24.30 | 0.4115143586 | 4.59 |  | 4.18
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
 | 1656 | 236.16 | -0.8305958992 | 1.03 | 174.24 | 0.1003617149 | 4.28 |  | 3.26
 | 1659 | 237.24 | -0.8409445823 | 1.01 | 175.86 | 0.07219377188 | 4.25 |  | 3.26
 | 1662 | 238.32 | -0.8509944818 | 1.00 | 177.48 | 0.04396811832 | 4.22 |  | 3.26
 | 1665 | 239.4 | -0.860742027 | 1.00 | 179.10 | 0.01570731731 | 4.19 |  | 3.26
 | 1668 | 240.48 | -0.8701837547 | 0.99 | 180.72 | -0.01256603988 | 4.16 |  | 3.26
