reivax-boucoi/PCB_Kicad/transistor_clock/transistor_clock.ods

Designator | Value | Foootprint | Assembly? | LCSC PN | Price /unit | Qty | Price /comp type | Joints/unit | Joints tot
> C1, C2, C4, C7, C13, C15, C17, C19, C22, C27, C28, C31, C36, C39, C43, C57, C58, C60, C61, C67, C72, C76, C79 | 10u | Capacitor_SMD:C_0805_2012Metric | True | C15850 | 0.0105 | 23 | 0.2415 | 2 | 46
> C3, C8-C12, C14, C16, C18, C23-C26, C32-C35, C40, C44-C55, C62-C64, C85-C96 | 1n | Capacitor_SMD:C_0603_1608Metric | True | C1588 | 0.0027 | 45 | 0.1215 | 2 | 90
> C5, C6, C20, C21, C29, C30, C37, C38, C41, C42, C56, C59, C68, C69, C73, C77, C80 | 100n | Capacitor_SMD:C_0603_1608Metric | True | C14663 | 0.0021 | 17 | 0.0357 | 2 | 34
> C65, C66, C74, C75, C81-C83 | 470u | Capacitor_SMD:CP_Elec_8x5.4 | False |  |  | 7 | 0 |  | 0
> C70, C71 | 1u | Capacitor_SMD:C_0805_2012Metric | False |  |  | 2 | 0 |  | 0
C78 | 220p | Capacitor_SMD:C_0805_2012Metric | False |  |  | 1 | 0 |  | 0
> D1-D7, D63, D64, D119-D122, D124-D126, D128, D129, D131, D133, D135, D138, D140, D143, D145, D146, D149, D199, D201, D251, D254, D257, D259, D260, D263, D268, D279, D280, D282-D284, D316, D317 | LED | footprints:LED_filament_38mm | False |  | 0.41 | 43 | 17.63 |  | 0
> D8-D62, D65-D118, D123, D127, D130, D132, D134, D136, D137, D139, D141, D142, D144, D147, D148, D150-D198, D200, D202-D250, D252, D253, D255, D256, D258, D261, D262, D264-D267, D269-D278, D281, D285-D296, D298-D315, D318-D327 | 1N4148W | Diode_SMD:D_SOD-123 | True | C81598 | 0.0061 | 283 | 1.7263 | 2 | 566
D297 | 3V3 | Diode_SMD:D_MiniMELF | False |  |  | 1 | 0 |  | 0
> H2-H4 | M4 | MountingHole:MountingHole_4.3mm_M4 | False |  |  | 3 | 0 |  | 0
J2 | 2mm | Connector_JST:JST_PH_B2B-PH-K_1x02_P2.00mm_Vertical | False |  |  | 1 | 0 |  | 0
> JP1, JP2 | VCC | Jumper:SolderJumper-2_P1.3mm_Open_RoundedPad1.0x1.5mm | False |  |  | 2 | 0 | 2 | 4
> Q1-Q9, Q11, Q13, Q15, Q17, Q19-Q29, Q31-Q33, Q35, Q36, Q38, Q39, Q41, Q42, Q44-Q46, Q48, Q49, Q51, Q53, Q54, Q56-Q59, Q61-Q63, Q65-Q67, Q69, Q71, Q73, Q75, Q76, Q78-Q80, Q82-Q85, Q87, Q89, Q91, Q93, Q94, Q96, Q97, Q99-Q101, Q103-Q106, Q108, Q110, Q111, Q113, Q115, Q118, Q121, Q124, Q127, Q132, Q134, Q136, Q138, Q140, Q142, Q144, Q146, Q148, Q150, Q152, Q154, Q155, Q157, Q158 | MMBT5551 | Package_TO_SOT_SMD:SOT-23 | True | C2145 | 0.0136 | 101 | 1.3736 | 3 | 303
> Q10, Q12, Q14, Q16, Q18, Q30, Q34, Q37, Q40, Q43, Q47, Q50, Q52, Q55, Q60, Q64, Q68, Q70, Q72, Q74, Q77, Q81, Q86, Q88, Q90, Q92, Q95, Q98, Q102, Q107, Q109, Q112, Q114, Q116, Q117, Q119, Q120, Q122, Q126, Q128, Q131, Q133, Q135, Q137, Q139, Q141, Q143, Q145, Q147, Q149, Q151, Q153, Q156 | MMBT5401 | Package_TO_SOT_SMD:SOT-23 | True | C8326 | 0.0137 | 53 | 0.7261 | 3 | 159
Q123 | VN3205 | Package_TO_SOT_SMD:SOT-89-3 | False |  |  | 1 | 0 |  | 0
R1 | 3k9 | Resistor_SMD:R_0603_1608Metric | False |  |  | 1 | 0 |  | 0
> R2, R3, R5, R7, R9, R11, R13, R15, R17, R18, R21, R23, R25, R27, R29, R31, R33, R35, R37, R39, R41, R43, R45, R47, R49, R51, R52, R55, R57, R59, R61, R63, R65, R67, R69, R71, R73, R75, R77, R79, R81, R83, R85, R87, R89, R90, R93, R95, R97, R99, R101, R103, R105, R107, R109, R111, R113, R115, R117, R118, R121, R123, R125, R127, R129, R131, R133, R135, R137, R139, R141, R143, R145, R147, R149, R151, R153, R155, R157, R159, R161, R163, R165, R167, R168, R171, R173, R175, R177, R179, R181, R183, R185, R187, R189, R191, R193-R196, R199, R201, R203, R205, R207, R209, R211, R213, R215, R217, R219, R221, R225, R227, R229, R232, R233, R237, R238, R241, R246, R249, R251, R254, R260, R262, R264, R265, R273, R275, R277, R279, R281, R283, R285, R287, R289, R291, R293, R295, R297, R299, R301, R303, R305, R307, R309, R311, R313, R315, R317, R319-R321, R324, R326-R328 | 10k | Resistor_SMD:R_0603_1608Metric | True | C25804 | 0.0008 | 158 | 0.1264 | 2 | 316
> R4, R6, R8, R10, R12, R14, R16, R40, R42, R44, R46, R48, R50, R54, R56, R58, R64, R66, R72, R78, R84, R92, R98, R108, R114, R116, R124, R126, R130, R132, R142, R152, R158, R160, R170, R186, R198, R200, R202, R208, R210, R212, R222, R223, R230, R231, R239, R242, R247, R250, R256-R259, R263, R266, R330, R331 | 100k | Resistor_SMD:R_0603_1608Metric | True | C25803 | 0.0009 | 58 | 0.0522 | 2 | 116
> R19, R20, R22, R24, R26, R28, R30, R32, R34, R36, R38, R53, R60, R62, R68, R70, R74, R76, R80, R82, R86, R88, R91, R94, R96, R100, R102, R104, R106, R110, R112, R119, R120, R122, R128, R134, R136, R138, R140, R144, R146, R148, R150, R154, R156, R162, R164, R166, R169, R172, R174, R176, R178, R180, R182, R184, R188, R190, R192, R197, R204, R206, R214, R216, R218, R220, R224, R226, R228, R235, R240, R243, R245, R248, R252, R255, R272, R274, R276, R278, R280, R282, R284, R286, R288, R290, R292, R294, R296, R298, R300, R302, R304, R306, R308, R310, R312, R314, R316, R318, R323, R325, R329 | 2k2 | Resistor_SMD:R_0603_1608Metric | True | C4190 | 0.0009 | 103 | 0.0927 | 2 | 206
R234 | 4.7k | Resistor_SMD:R_0603_1608Metric | False |  |  | 1 | 0 |  | 0
> R236, R244, R261 | 1k | Resistor_SMD:R_0603_1608Metric | True | C21190 | 0.0005 | 3 | 0.0015 | 2 | 6
R253 | 22k | Resistor_SMD:R_0603_1608Metric | False |  |  | 1 | 0 |  | 0
> R267, R269 | DNP | Resistor_SMD:R_0603_1608Metric | False |  |  | 2 | 0 |  | 0
> RV1, RV2 | 1k | Potentiometer_THT:Potentiometer_Vishay_T73YP_Vertical | False |  |  | 2 | 0 |  | 0
SW1 | Heures | footprints:TL3330 | False |  |  | 1 | 0 |  | 0
SW2 | Minutes | footprints:TL3330 | False |  |  | 1 | 0 |  | 0
> TP1-TP4 | GND | footprints:RCSRCW_0C_testpoint_1206 | False |  |  | 4 | 0 |  | 0
TP5 | VCC | footprints:RCSRCW_0C_testpoint_1206 | False |  |  | 1 | 0 |  | 0
TP6 | VD | footprints:RCSRCW_0C_testpoint_1206 | False |  |  | 1 | 0 |  | 0
TP7 | Vref | footprints:RCSRCW_0C_testpoint_1206 | False |  |  | 1 | 0 |  | 0
TP8 | 50Hz | footprints:RCSRCW_0C_testpoint_1206 | False |  |  | 1 | 0 |  | 0
TP9 | 5Hz | footprints:RCSRCW_0C_testpoint_1206 | False |  |  | 1 | 0 |  | 0
TP10 | 1s | footprints:RCSRCW_0C_testpoint_1206 | False |  |  | 1 | 0 |  | 0
TP11 | 10s | footprints:RCSRCW_0C_testpoint_1206 | False |  |  | 1 | 0 |  | 0
TP12 | 1min | footprints:RCSRCW_0C_testpoint_1206 | False |  |  | 1 | 0 |  | 0
TP13 | 10min | footprints:RCSRCW_0C_testpoint_1206 | False |  |  | 1 | 0 |  | 0
TP14 | 1hr | footprints:RCSRCW_0C_testpoint_1206 | False |  |  | 1 | 0 |  | 0
TP15 | 24_rst | footprints:RCSRCW_0C_testpoint_1206 | False |  |  | 1 | 0 |  | 0
 |  |  |  |  |  |  | 0 |  | 0
 |  |  |  |  |  |  | 0 |  | 0
 |  |  |  |  |  |  | 0 |  | 0
 |  |  |  |  |  |  | 0 |  | 0
 |  |  |  |  |  |  | 0 |  | 0
 |  |  |  |  |  |  | 0 |  | 0
 |  |  |  |  |  |  | 0 |  | 0
 |  |  |  |  |  |  | 0 |  | 0
 |  |  |  |  |  |  | 0 |  | 0
 |  |  |  |  |  |  | 0 |  | 0
 |  |  |  |  |  | NB components | Raw comp cost | Exlc filament | NB joints
 |  |  |  |  |  | 929 | 22.1275 | 4.4975 | 1846
 |  |  |  |  |  | Setup fee | 8
 |  |  |  |  |  | Stencil | 1.5
 |  |  |  |  |  | Joints | 3.1382
 |  |  |  |  |  | Xray | 1.6
 |  |  |  |  |  | Total / brd | 9.2357
 |  |  |  |  |  | Assy Qty | 5
 |  |  |  |  |  | Tot assy | 55.6785
 |  |  |  |  |  | PCB tot | 16 | For 5 brds
 |  |  |  |  |  | Tot | 71.6785
