reivax-boucoi/PCB_Kicad/3phase_gen/3phase_gen.ods

Placed | Sourced | Qty | Reference(s) | Value | Footprint
 | x | 20 | C1, C2, C3, C5, C7, C10, C12, C13, C14, C16, C17, C18, C19, C20, C22, C23, C26, C27, C28, C29 | 100n | Capacitor_SMD:C_0805_2012Metric_Pad1.15x1.40mm_HandSolder
 | x | 6 | C4, C6, C8, C11, C21, C25 | 10u | Capacitor_THT:CP_Radial_D5.0mm_P2.50mm
 | x | 1 | C9 | 1u | Capacitor_THT:C_Disc_D6.0mm_W2.5mm_P5.00mm
 | - | 1 | C15 | DNP | Capacitor_SMD:C_0805_2012Metric_Pad1.15x1.40mm_HandSolder
 | x | 1 | C24 | 10u | Capacitor_SMD:C_0805_2012Metric_Pad1.15x1.40mm_HandSolder
 | x | 1 | D1 | D | Diode_THT:D_DO-15_P12.70mm_Horizontal
 | x | 2 | D4, D5 | BAT54W | Package_TO_SOT_SMD:SOT-323_SC-70
 | - | 1 | F1 | Fuse | Fuse:Fuseholder_Cylinder-5x20mm_Stelvio-Kontek_PTF78_Horizontal_Open
 | x | 1 | FB1 | BlueBead | solar_mppt1:FerriteBead
 | - | 4 | H1, H2, H3, H4 | MountingHole_Pad | MountingHole:MountingHole_3.2mm_M3_Pad
 | - | 1 | J1 | Conn_02x06_Odd_Even | Connector_PinHeader_2.54mm:PinHeader_2x06_P2.54mm_Horizontal
 | x | 1 | J2 | Conn_WallSocket_Earth | footprints:IEC_mains_3pin
 |  | 1 | J3 | INTERLOCK | Connector_Wire:SolderWirePad_1x02_P3.81mm_Drill1.2mm
 | - | 4 | J4, J5, J6, J10 | Conn_01x08 | Connector_PinHeader_2.54mm:PinHeader_1x08_P2.54mm_Vertical
 | - | 2 | J7, J8 | Conn_01x01 | Connector_PinHeader_2.54mm:PinHeader_1x01_P2.54mm_Vertical
 | - | 3 | J9, J14, J15 | Conn_01x05 | Connector_PinHeader_2.54mm:PinHeader_1x05_P2.54mm_Vertical
 | - | 2 | J11, J13 | Conn_01x03 | Connector_PinHeader_2.54mm:PinHeader_1x03_P2.54mm_Vertical
 | - | 1 | J12 | Conn_01x02 | Connector_PinHeader_2.54mm:PinHeader_1x02_P2.54mm_Vertical
 | - | 1 | JP1 | Jumper_3_Bridged12 | Jumper:SolderJumper-3_P1.3mm_Bridged12_RoundedPad1.0x1.5mm
 | - | 1 | NT1 | GNDS | NetTie:NetTie-2_SMD_Pad0.5mm
 | ! | 6 | R1, R11, R12, R13, R14, R15 | 1M | Resistor_THT:R_Axial_DIN0207_L6.3mm_D2.5mm_P10.16mm_Horizontal
 | x | 3 | R2, R3, R16 | 470 | Resistor_SMD:R_0805_2012Metric_Pad1.15x1.40mm_HandSolder
 |  | 1 | R4 | 0 | Resistor_THT:R_Axial_DIN0207_L6.3mm_D2.5mm_P10.16mm_Horizontal
 | x | 6 | R5, R6, R7, R8, R9, R10 | 1M | Resistor_SMD:R_0805_2012Metric_Pad1.15x1.40mm_HandSolder
 | x | 1 | T1 | Transformer_1P_1S | footprints:VB1-2-1-12_transformer
 | xx | 2 | U1, U3 | 74HC14 | Package_DIP:DIP-14_W7.62mm_LongPads
 | x! | 1 | U2 | TangNano | footprints:TangNano
 | x | 1 | U4 | MAX1112 | Package_SO:SSOP-20_5.3x7.2mm_P0.65mm
 | x | 1 | U5 | MIC5209 | Package_TO_SOT_SMD:SOT-223-3_TabPin2
 | x | 1 | U6 | L7805 | Package_TO_SOT_THT:TO-220F-3_Vertical
