reivax-boucoi/PCB_Kicad/horse_feeder/HW/packing_list.ods

Qté | Composant | Prix/unité | Prix tot | Statut | Description
2 | moteurs essuie glace | 20 | 40 |  | A la casse?
2 | vis sans fin | 14 | 28 |  | https://www.amazon.com/MorningRo-Brushing-Replacement-Bushing-Pellet/dp/B0DC6WQ6ZV
2 | Capteurs proximité | 2 | 4 |  | Commandé le 12/02
1 | Tube PVC Ø40 4m | 6 | 6 |  | Brico Chatel
2 | Coude 45° PVC Ø40 | 3 | 6 |  | Brico Chatel
1 | Panneau solaire 40W | 0 | 0 |  | A ramener de TLS
1 | Controleur solaire MPPT | 0 | 0 |  | A ramener de TLS
2 | Batteries Pb 12Ah | 0 | 0 |  | A ramener de TLS
1 | PCB contrôle | 2 | 2 |  | Commandé le 16/02
1 | Boitier PCB contrôle | 0 | 0
1 | Carte SIM | 10 | 10 |  | Free? Abonné freebox?
