reivax-boucoi/PCB_Kicad/3phase_gen/3phase_gen-drl_map.dxf

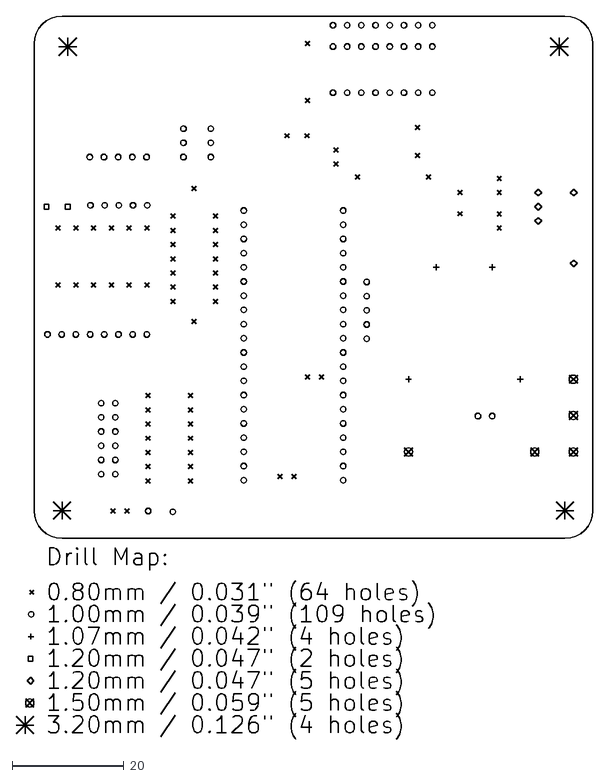
[picture p33: CAD file, 2022-01-01]
3phase_gen/3phase_gen-drl_map.dxf
103.2 x 129.4
