reivax-boucoi/PCB_Kicad/bike_lights2/bike_lights2.step

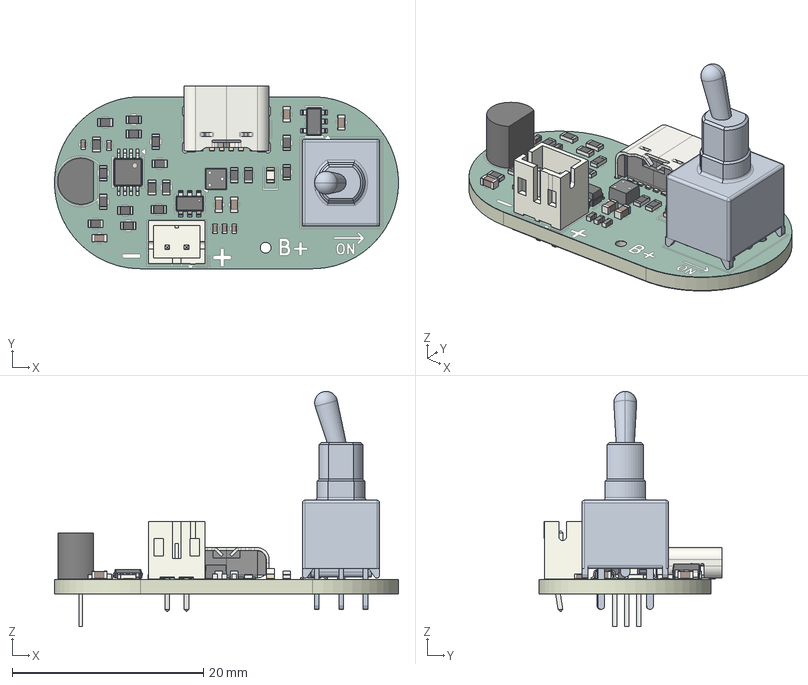
[picture p34: CAD file, 2026-08-25]
bike_lights2/bike_lights2.step
36.0 x 19.1 x 24.6 mm
C_0603_1608Metric x 5
TL42P005000
EPL2014
SOT-23-6
SOT-23-5
R_0603_1608Metric x 18
USB_C_Receptacle_GCT_USB4125-xx-x_6P_TopMnt_Horizontal
C_0402_1005Metric x 5
JST_B2B_PH_K
MSOP-8_3x3mm_P0.65mm
LED_0603_1608Metric
TO-92_Inline_Narrow
bike_lights2_silkscreen x 2
bike_lights2_soldermask x 2
bike_lights2_PCB
