reivax-boucoi/PCB_Kicad/horse_feeder/HW/tremie/LJ12A3-4-Z_BX v6.step

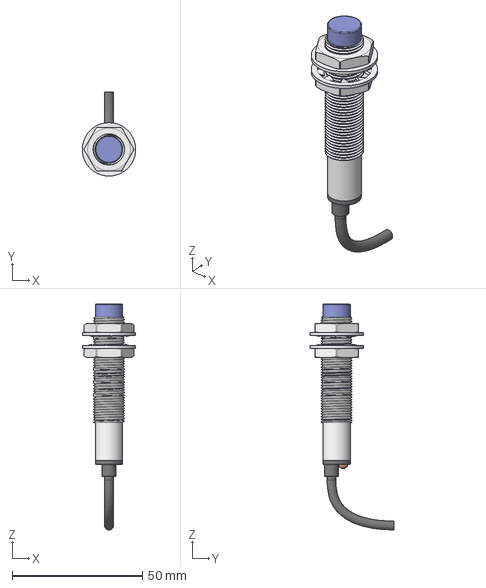
[picture p35: CAD file, 2025-02-26]
horse_feeder/HW/tremie/LJ12A3-4-Z_BX v6.step
20.5 x 32.3 x 86.7 mm
93925A300 x 2
Nut x 2
