reivax-boucoi/PCB_Kicad/hv_discharge_v2c/hv_discharge_v2c.step

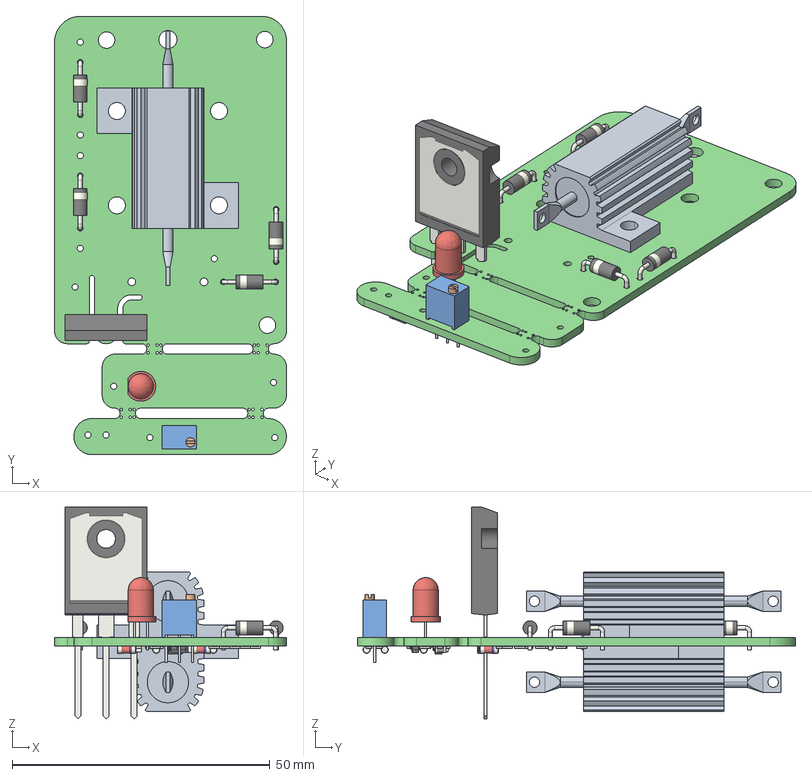
[picture p36: CAD file, 2022-10-03]
hv_discharge_v2c/hv_discharge_v2c.step
45.0 x 85.0 x 41.1 mm
hv_discharge_v2c PCB
