reivax-boucoi/PCB_Kicad/Kheprism/HW/PCB_Ventil/Kicad/keystone-PN4966.STEP

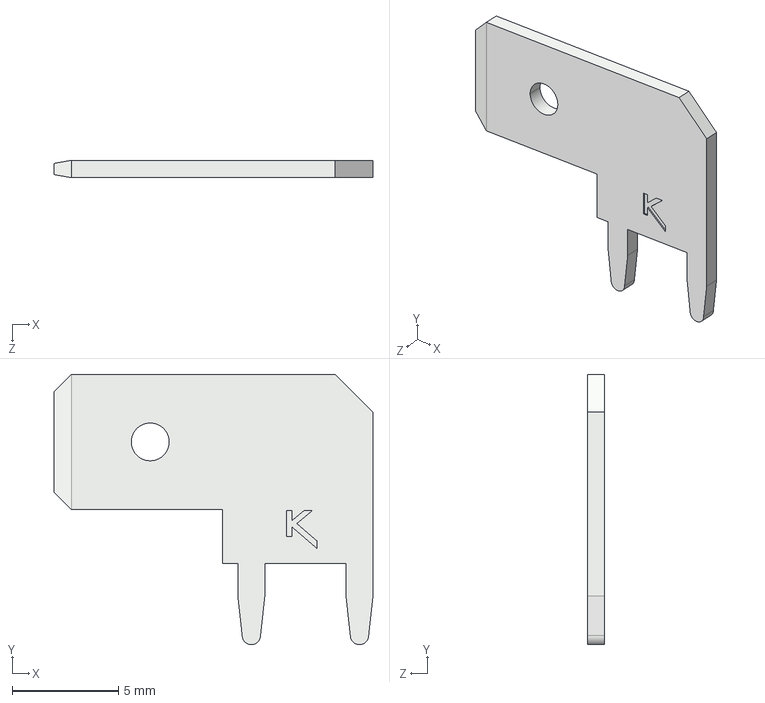
[picture p37: CAD file, 2026-03-25]
Kheprism/HW/PCB_Ventil/Kicad/keystone-PN4966.STEP
15.0 x 12.7 x 0.813 mm
