reivax-boucoi/PCB_Kicad/LabBooster/LabBooster-drl_map.dxf

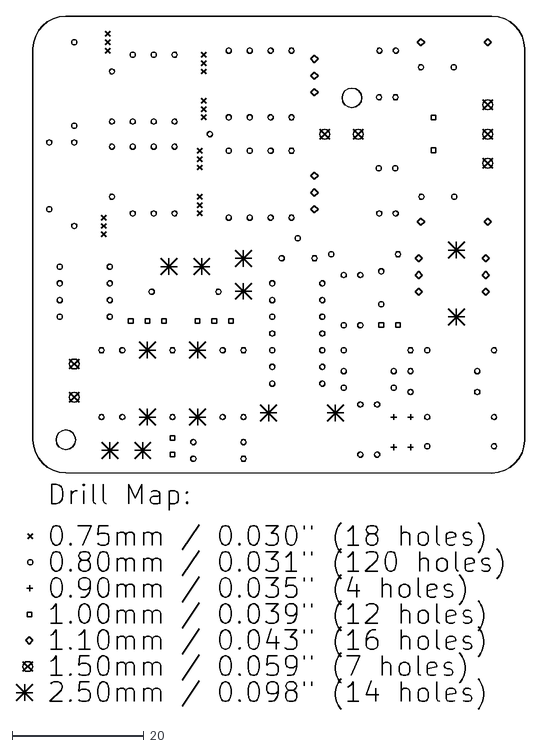
[picture p38: CAD file, 2022-01-09]
LabBooster/LabBooster-drl_map.dxf
77.3 x 105.4
