reivax-boucoi/PCB_Kicad/LED_poi/Mechanical/USB_C_Receptacle_GCT_USB4105-xx-A_16P_TopMnt_Horizontal.step

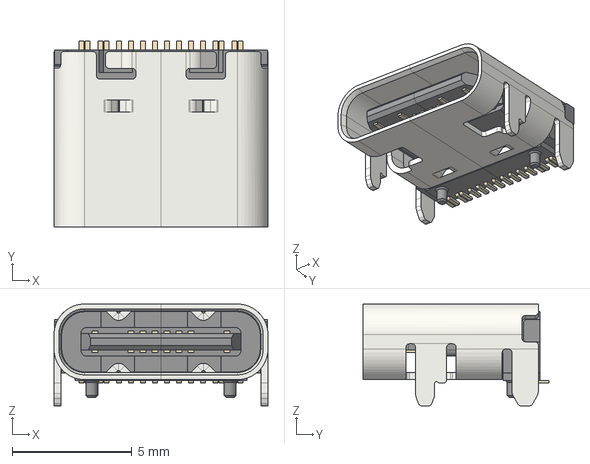
[picture p39: CAD file, 2024-04-03]
LED_poi/Mechanical/USB_C_Receptacle_GCT_USB4105-xx-A_16P_TopMnt_Horizontal.step
8.94 x 7.78 x 4.26 mm
