reivax-boucoi/PCB_Kicad/Planar_XFMR/3D/ER_cores.FCStd

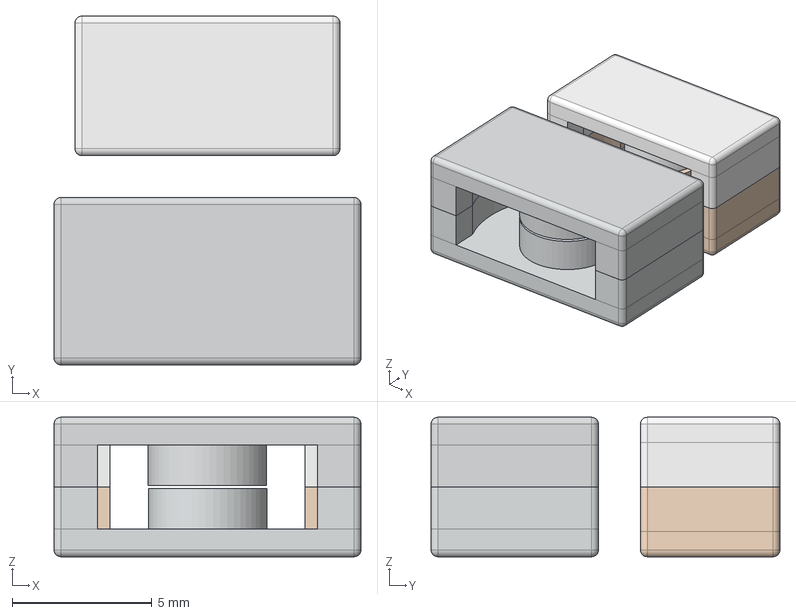
[picture p40: CAD file, 2025-01-23]
Planar_XFMR/3D/ER_cores.FCStd
11.0 x 12.5 x 5.00 mm
ER11-5_top
ER11-5
ER9.5-5
ER9.5-5_top
