reivax-boucoi/PCB_Kicad/Planar_XFMR/output/Planar_XFMR-In1_Cu.dxf

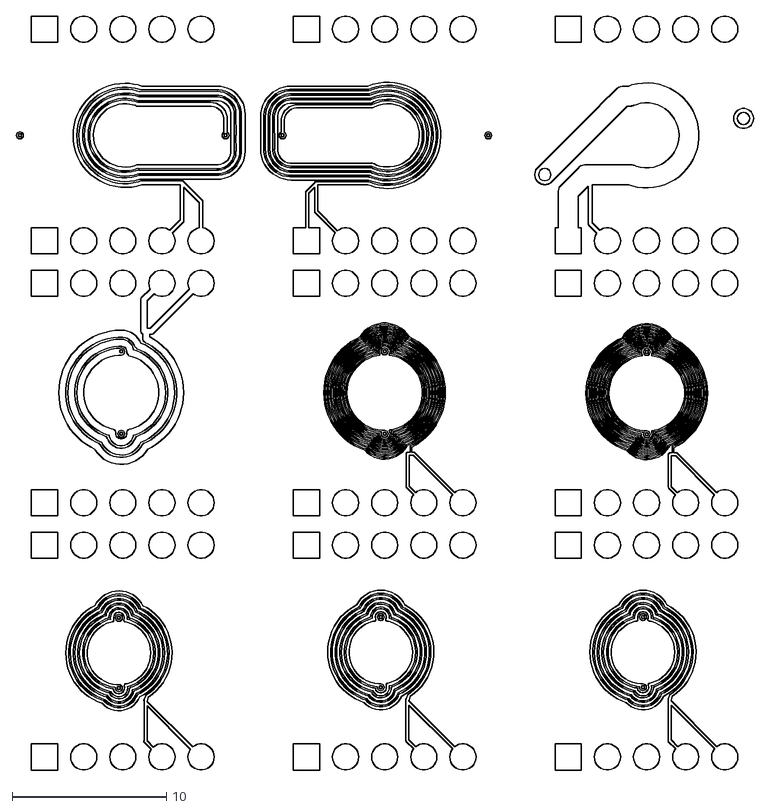
[picture p41: CAD file, 2024-10-03]
Planar_XFMR/output/Planar_XFMR-In1_Cu.dxf
47.8 x 48.9
