reivax-boucoi/PCB_Kicad/Planar_XFMR/Planar_XFMR.step

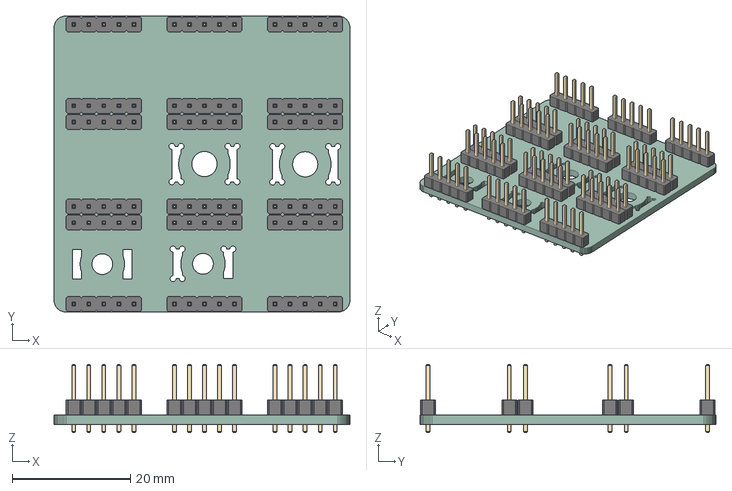
[picture p42: CAD file, 2024-03-06]
Planar_XFMR/Planar_XFMR.step
50.0 x 50.0 x 11.5 mm
PinHeader_1x05_P254mm_Vertical x 18
Planar_XFMR PCB
