reivax-boucoi/PCB_Kicad/solar_mppt1/freecad/inductor_support.FCStd

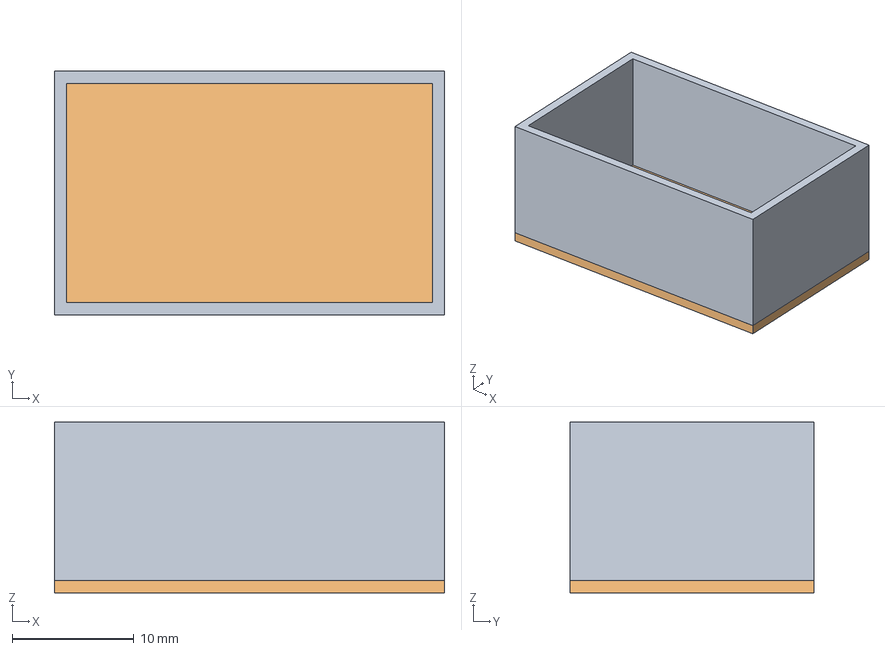
[picture p43: CAD file, 2022-01-03]
solar_mppt1/freecad/inductor_support.FCStd
32.0 x 20.0 x 14.0 mm
