reivax-boucoi/PCB_Kicad/weight_scale/Hardware/Enclosure-Bottom_lid.stl

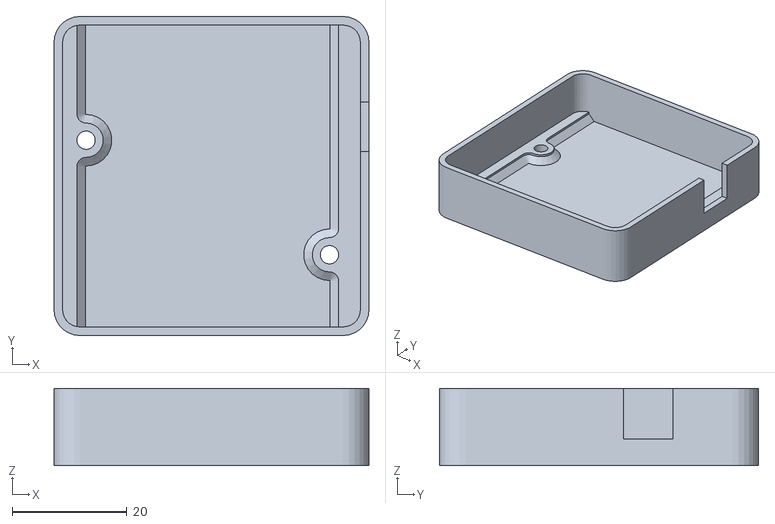
[picture p44: CAD file, 2025-01-23]
weight_scale/Hardware/Enclosure-Bottom_lid.stl
55.0 x 55.7 x 13.5
