reivax-boucoi/PCB_Kicad/horse_feeder/HW/tremie/tremie0.FCStd

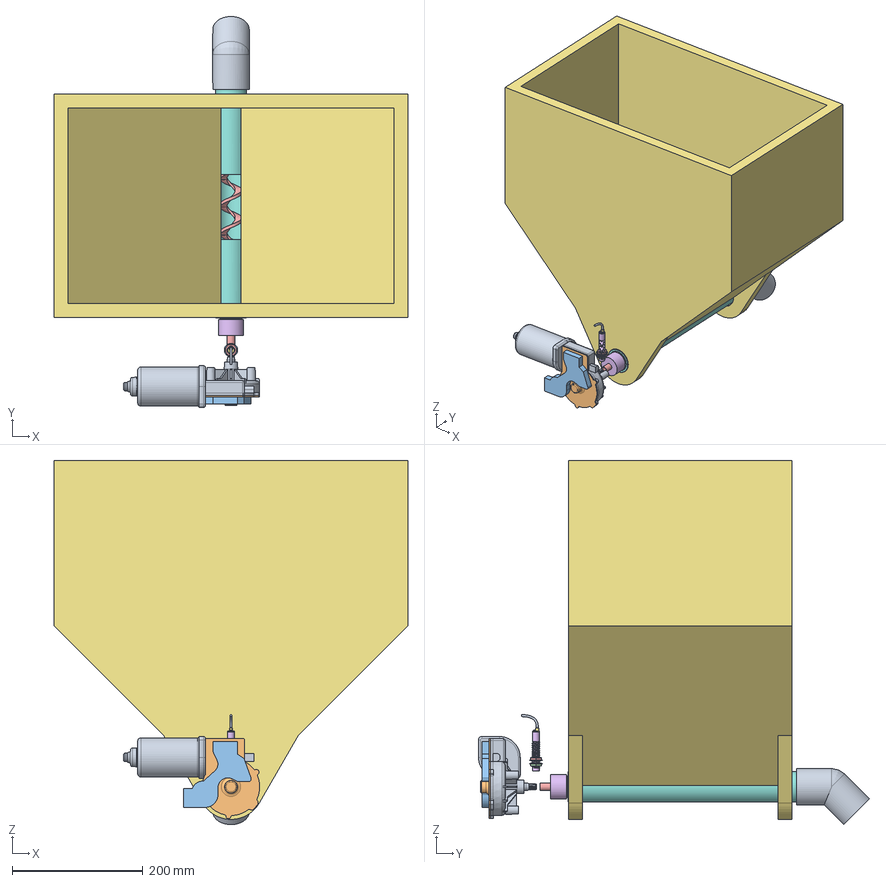
[picture p45: CAD file, 2025-02-26]
horse_feeder/HW/tremie/tremie0.FCStd
542.0 x 599.0 x 558.0 mm
Motor MAN TGA
Motor MAN TGA001
Motor MAN TGA002
Motor MAN TGA003
Leadscrew_body
screw_bushing
pipe001
elbow_45
93925A300
93925A301
Nut
Nut001
