reivax-boucoi/PCB_Kicad/Kheprism/HW/PCB_Ventil/Kicad/raspberry_pi_5.step

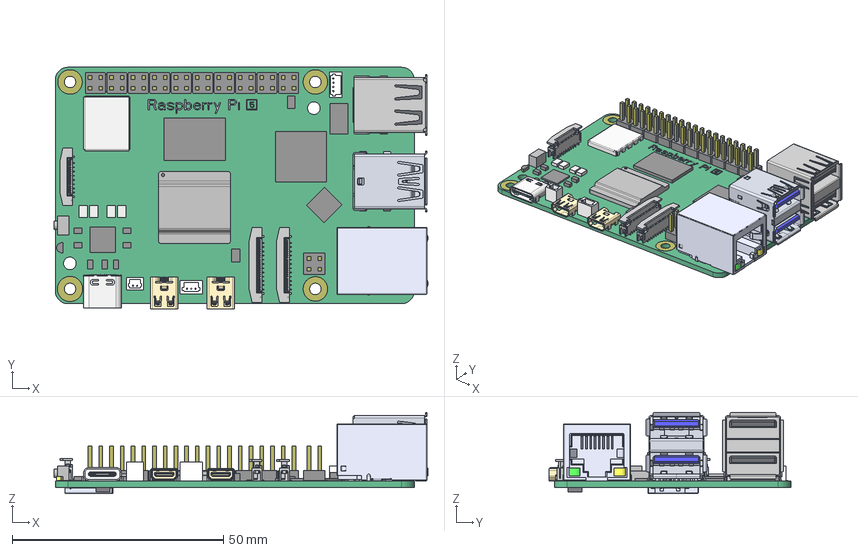
[picture p46: CAD file, 2026-03-25]
Kheprism/HW/PCB_Ventil/Kicad/raspberry_pi_5.step
88.5 x 57.2 x 19.2 mm
CONNECTOR
GPIO-HEADER
GROUND-1426
GROUND-1427
GROUND-1428
GROUND-1429
PCB
RAM
CPU
CHIP-1454
CHIP-1455
CHIP-1456
CHIP-1457
PMIC
POE_GEOMETRY
PWR-CONNECTOR
RP1
UART
XB-U224-08XN-1XR61
GIGABIT_ETHERNET_PORT__RPI4MODE
IMPORTED6-42380_1
IMPORTED9-52935_1
IMPORTED10-72927_1
IMPORTED7-187449_1
IMPORTED5-264500_1
IMPORTED3-272013_1
IMPORTED2-275127_1
N-396500_1
IMPORTED4-497392_1
IMPORTED8-498029_1
FEMALE_USB_TYPE_C_CONNECTOR__RP
FEMALE_MICRO_HDMI_CONNECTOR__RP x 2
2X_USB3_0_PORTS__RPI4MODELB_ANY
IR_1
CYPRESS_CYW43455_WIRELESS_MODUL
SWITCH-1559
LOGO
