reivax-boucoi/PCB_Kicad/LED_poi/Mechanical/all_Freecad.FCStd

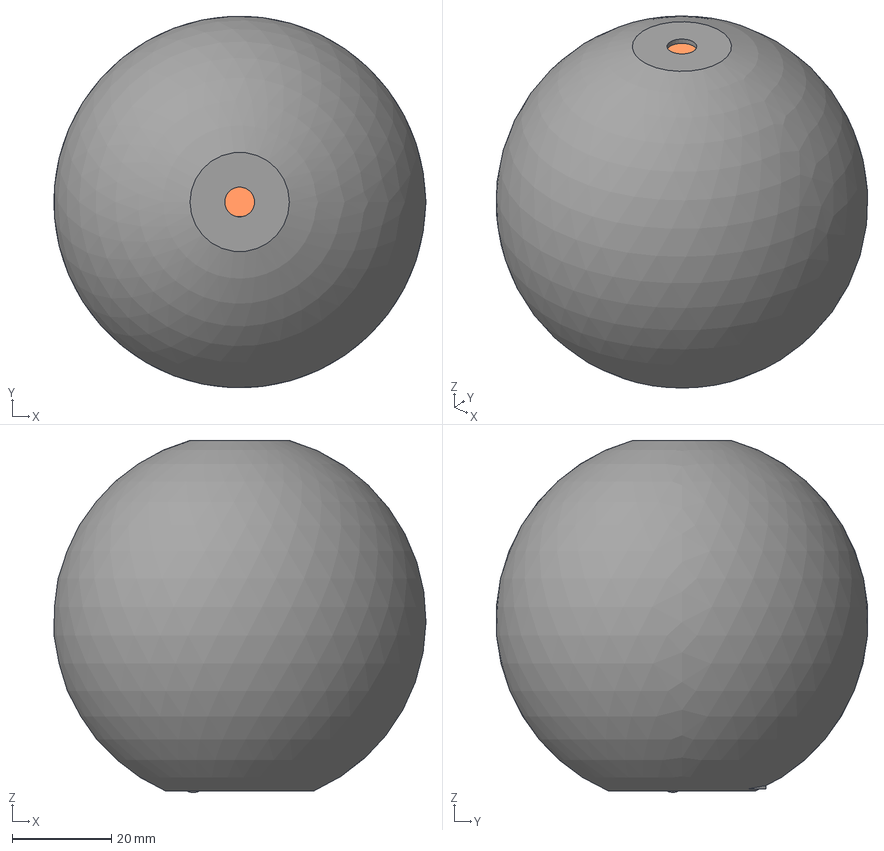
[picture p47: CAD file, 2024-04-03]
LED_poi/Mechanical/all_Freecad.FCStd
74.9 x 74.8 x 70.9 mm
Battery
Chg_PCB
USB_C_Receptacle_GCT_USB4105-xx-A_16P_TopMnt_Horizontal1_USB_C_Receptacle_16P_TopMnt_Horizontal_GCT_USB4105-xx-A_001
C_0603_1608Metric
SOT_23
R_Array_Convex_4x1206
C_0603_1608Metric002
R_0805_2012Metric
C_0805_2012Metric
C_0603_1608Metric004
R_0805_2012Metric002
Crystal_SMD_SeikoEpson_FA238-4Pin_3.2x2.5mm
SOT_024
R_0805_2012Metric004
TQFP_44_10x10mm_P08mm
R_0805_2012Metric006
C_0603_1608Metric006
C_0603_1608Metric008
SOT_025
R_0805_2012Metric008
C_0603_1608Metric010
R_0805_2012Metric010
C_0603_1608Metric012
C_0603_1608Metric014
C_0603_1608Metric016
SOT_026
LGA_14_3x5mm_P08mm_LayoutBorder1x6y
R_0805_2012Metric012
C_0603_1608Metric018
C_0603_1608Metric020
C_0805_2012Metric002
C_0603_1608Metric022
Vishay_MOLD-3pin
_autosave-LED_poi_PCB
BotCap
