reivax-boucoi/PCB_Kicad/Planar_XFMR/3D/Planar_XFMR-In2_Cu.dxf

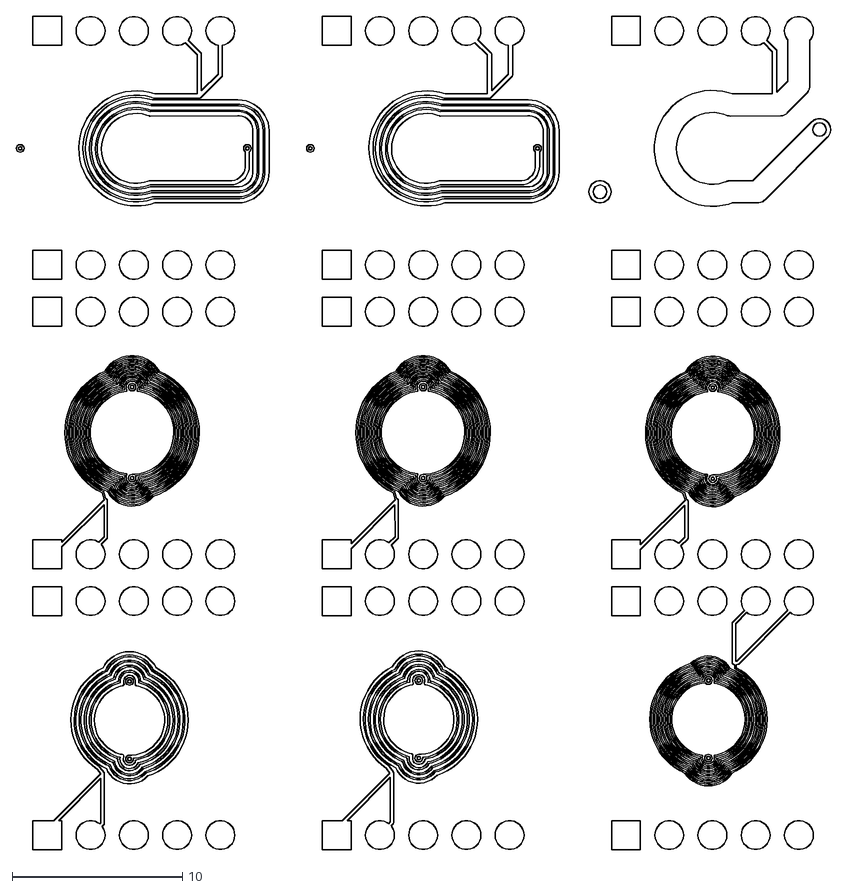
[picture p48: CAD file, 2024-10-03]
Planar_XFMR/3D/Planar_XFMR-In2_Cu.dxf
47.8 x 48.9
