reivax-boucoi/PCB_Kicad/weight_scale/Hardware/Enclosure-Top_lid.stl

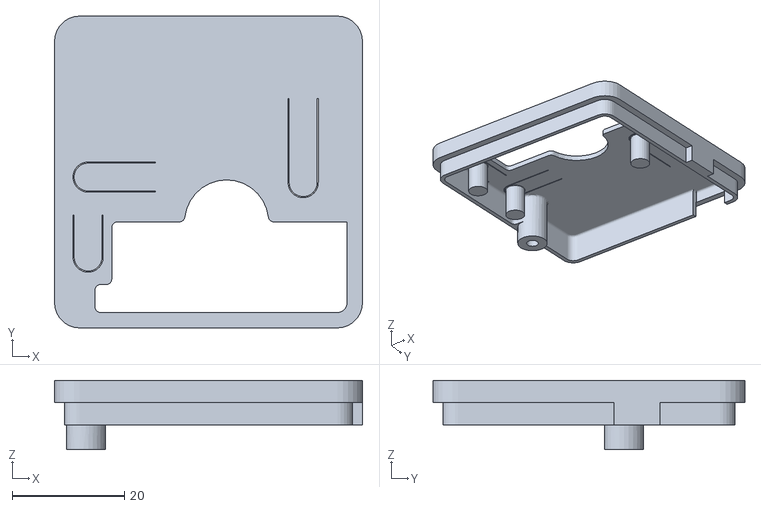
[picture p49: CAD file, 2025-01-23]
weight_scale/Hardware/Enclosure-Top_lid.stl
55.0 x 55.7 x 12.4
