reivax-boucoi/PCB_Kicad/horse_feeder/HW/tremie/wiper_motor.stp

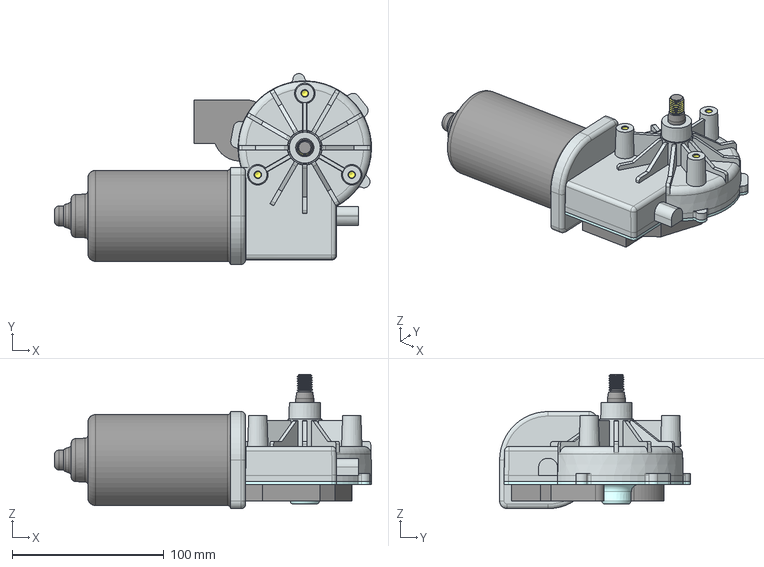
[picture p50: CAD file, 2025-02-20]
horse_feeder/HW/tremie/wiper_motor.stp
209.0 x 125.8 x 88.5 mm
