reivax-boucoi/PCB_Kicad/Kheprism/HW/PCB_Ventil/Kicad/c-63951-1-s-3d.stp

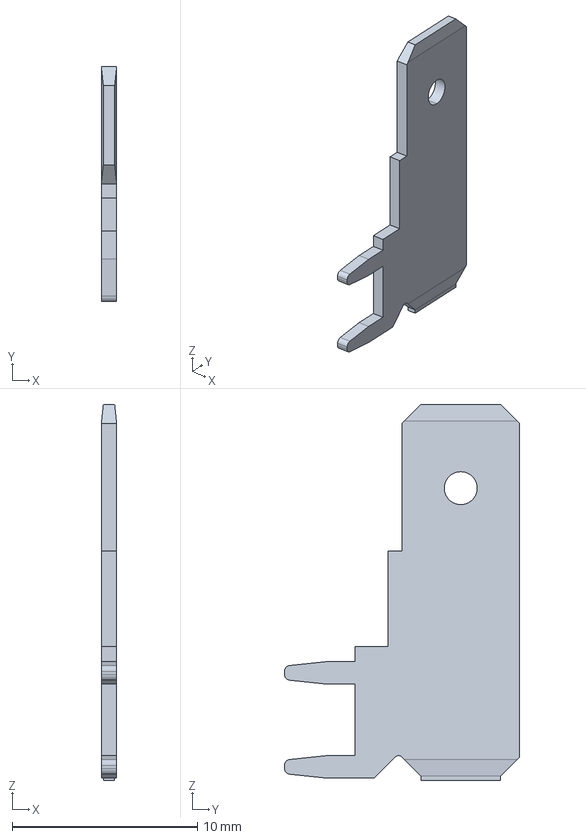
[picture p51: CAD file, 2026-03-25]
Kheprism/HW/PCB_Ventil/Kicad/c-63951-1-s-3d.stp
0.8 x 12.7 x 20.3 mm
