reivax-boucoi/PCB_Kicad/LED_poi/Mechanical/LED_poi_brd.step

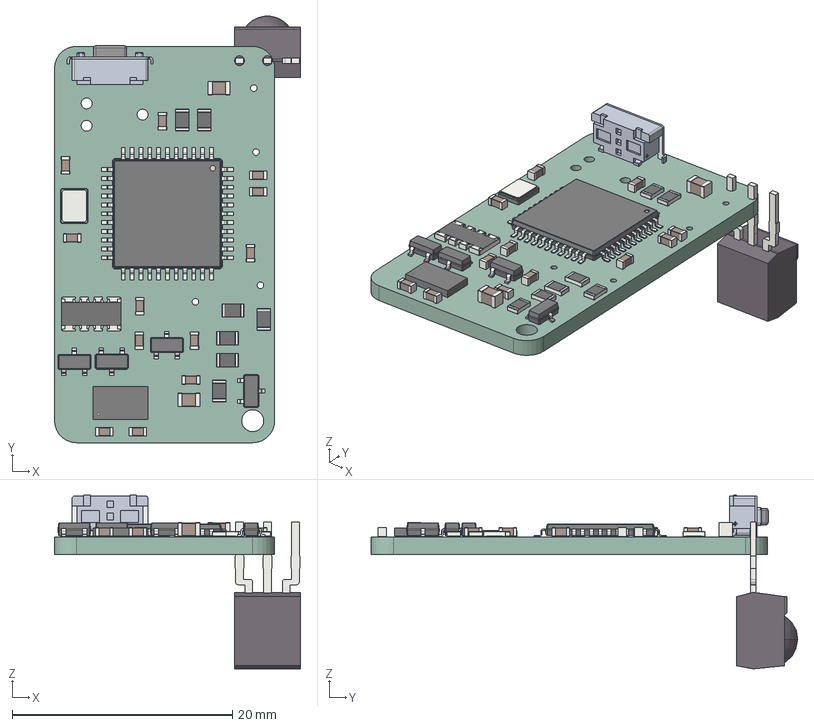
[picture p52: CAD file, 2024-04-03]
LED_poi/Mechanical/LED_poi_brd.step
22.3 x 38.7 x 15.8 mm
C_0603_1608Metric x 12
SOT_23 x 4
R_Array_Convex_4x1206
R_0805_2012Metric x 7
C_0805_2012Metric x 2
Crystal_SMD_SeikoEpson_FA238-4Pin_3.2x2.5mm
TQFP_44_10x10mm_P08mm
LGA_14_3x5mm_P08mm_LayoutBorder1x6y
Vishay_MOLD-3pin
_autosave-LED_poi_PCB
