reivax-boucoi/PCB_Kicad/weight_scale/Hardware/Enclosure_course.FCStd

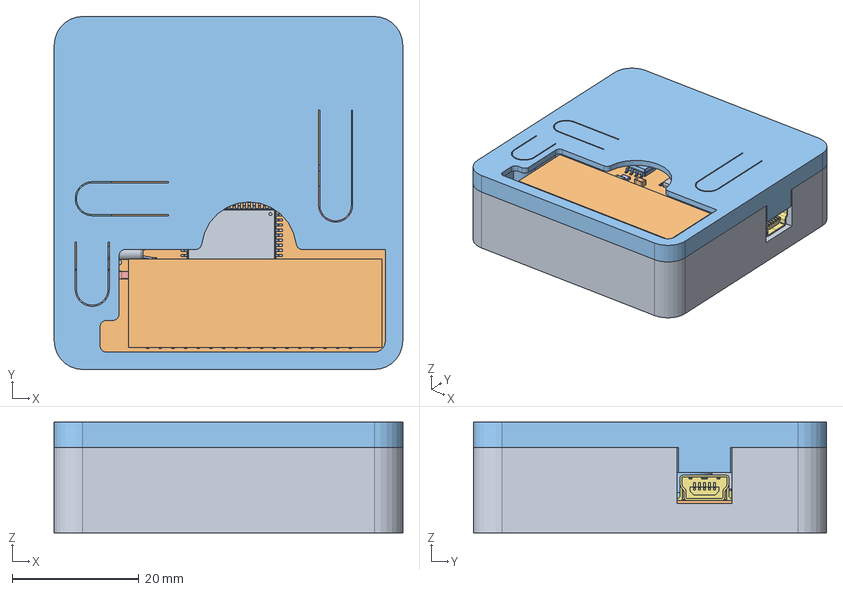
[picture p53: CAD file, 2025-01-23]
weight_scale/Hardware/Enclosure_course.FCStd
55.0 x 55.7 x 17.5 mm
Bottom_lid
C_0805_2012Metric
C_1206_3216Metric
R_0805_2012Metric
C_0805_2012Metric002
L_0805_2012Metric
C_0805_2012Metric004
C_0805_2012Metric006
R_0805_2012Metric002
CQ assembly
CQ assembly001
CQ assembly002
CQ assembly003
CQ assembly004
C_0805_2012Metric008
SOT_23_5
SW_PUSH_6mm
JST_B2B_XH_A
C_0805_2012Metric010
C_0805_2012Metric012
SW_PUSH_6mm002
C_0805_2012Metric014
C_0805_2012Metric016
C_0805_2012Metric018
R_0805_2012Metric004
C_0805_2012Metric020
SOIC_8_39x49mm_P127mm
R_0805_2012Metric006
C_0805_2012Metric022
R_0805_2012Metric008
R_0805_2012Metric010
C_1206_3216Metric002
C26_LF_Horizontal_1EP_2
C_1206_3216Metric004
R_0805_2012Metric012
R_0805_2012Metric014
R_0805_2012Metric016
C_1206_3216Metric006
LED_0805_2012Metric
TSSOP_20_44x65mm_P065mm
L_0805_2012Metric002
C_0805_2012Metric024
C_0805_2012Metric026
C_0805_2012Metric028
R_0805_2012Metric018
USB_Mini-B_Lumberg_2486_01_Horizontal
R_0805_2012Metric020
TQFP_64_14x14mm_P08mm
SOT_23_006
C_1206_3216Metric008
R_0805_2012Metric022
C_0805_2012Metric030
C_0805_2012Metric032
R_0805_2012Metric024
SW_PUSH_6mm004
C_0805_2012Metric034
_autosave-weight_scale_PCB
Top_lid
