reivax-boucoi/PCB_Kicad/Kheprism/HW/PCB_Ventil/Kicad/c-216926-1-a-3d.stp

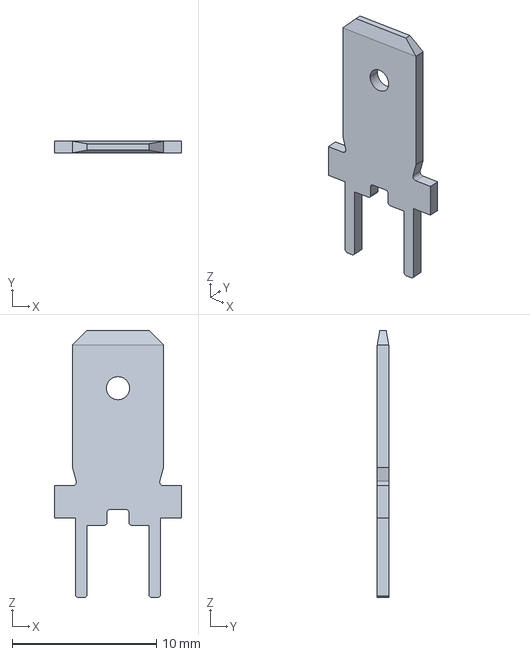
[picture p54: CAD file, 2026-03-25]
Kheprism/HW/PCB_Ventil/Kicad/c-216926-1-a-3d.stp
8.80 x 0.8 x 18.5 mm
