reivax-boucoi/PCB_Kicad/Kheprism/HW/PCB_Ventil/Kicad/NID100-5.stp

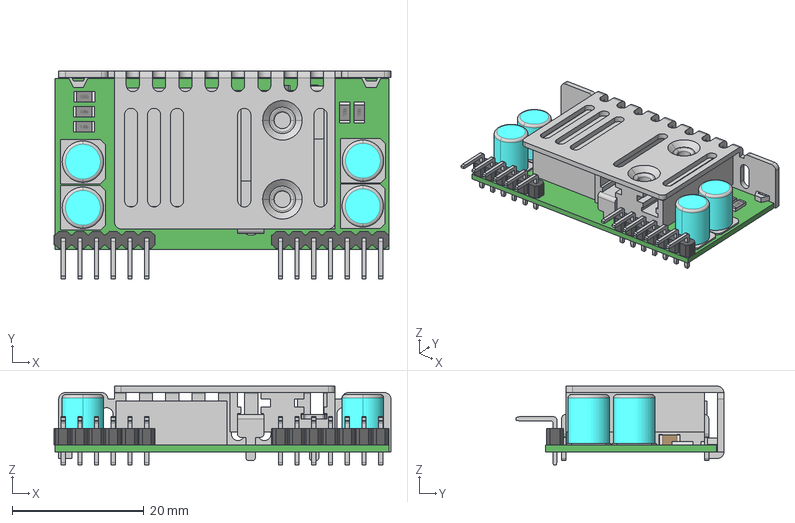
[picture p55: CAD file, 2026-03-25]
Kheprism/HW/PCB_Ventil/Kicad/NID100-5.stp
51.2 x 31.6 x 12.0 mm
HS-SZ091
HS-SZ090
a
CHBW
CHBW.1
CHBW.2
CHBW.2.1
L1
R0805_2.PRT x 4
R0805_1.PRT x 4
R1206_2.PRT x 5
R1206_1.PRT x 5
749839240.PRT
JS11201.1.1.1.1.1.1.1.1.1.1.1.1
JS11201.1.1.1.1.1.1.1.1.1.1.1
JS11201.1.1.1.1.1.1.1.1.1
JS11201.1.1.1.1.1.1.1.1.1.1
JS11201.1.1.1.1.1.1.1.1
JS11201.1.1.1.1.1.1
JS11201.1.1.1.1.1.1.1
JS1120 x 2
JS11201.1.1.1.1.1.2.1.1.1
JS11201.1.1.1.1.1.2.1.1
JS11201.1.1.1.1.1.2.1
JS11201.1.1.1.1.1.2
JS11201.1.1.1.1.1.2.1.1.1.1
JS11201.1.1.1.1.1
