reivax-boucoi/PCB_Kicad/(list of files, cad)

Other CAD files:
transistor_clock/Mechanical/transistor_clock.FCStd
transistor_clock/Mechanical/transistor_clock.dxf
