reivax-boucoi/PCB_Kicad/Planar_XFMR/Validation/DCR_valid.xlsx

 |  |  |  |  | Cr | 1.72e-08 | Ω*m | Copper resistivity
 |  | DCR (mΩ)
Winding | Proto | G | G | H | I | I | H
 | Winding | Pri | Sec | Pri | Pri | Sec | Sec
 | # of turns | 10 | 10 | 10 | 10 | 14 | 14
 | Track width (mm) | 0.2 | 0.2 | 0.2 | 0.2 | 0.1 | 0.1
 | Layers | L2L3 | L1L4 | L2L3 | L2L4 | L1L3 | L1L4
Measured DCR (mΩ) | #1 | 695 | 541 |  | 605 | 2280 | 2129
 | #2 | 695 | 561 |  | 634 | 2293 | 2179
 | #3 | 693 | 557 |  | 628 | 2222 | 2127
 | #4 | 690 | 592 |  | 640 | 2330 | 2273
 | #5 | 687 | 576 |  | 634 | 2279 | 2207
 | AVG | 692 | 565.4 |  | 628.2 | 2280.8 | 2183
 | VAR | 12 | 376.3 |  | 186.2 | 1507.7 | 3686
Calc | Length (mm) | 183 | 183 |  | 183 | 261.2 | 261.2
 | DCR (mΩ) | 525 | 450 |  | #REF! | #REF! | 1282
 |  | 31.80952381% | 25.64444444% |  | #REF! | #REF! | 70.28081123%
