reivax-boucoi/PCB_Kicad/Hi-pot_tester/Hi-pot_tester_3D_bot.png

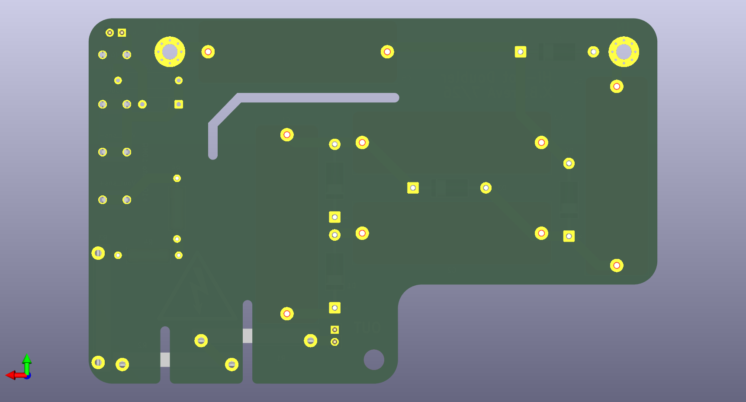
Hi-pot_tester/Hi-pot_tester_3D_bot.png
