reivax-boucoi/PCB_Kicad/hv_discharge_v2c/hv_discharge_v2_schematic.pdf

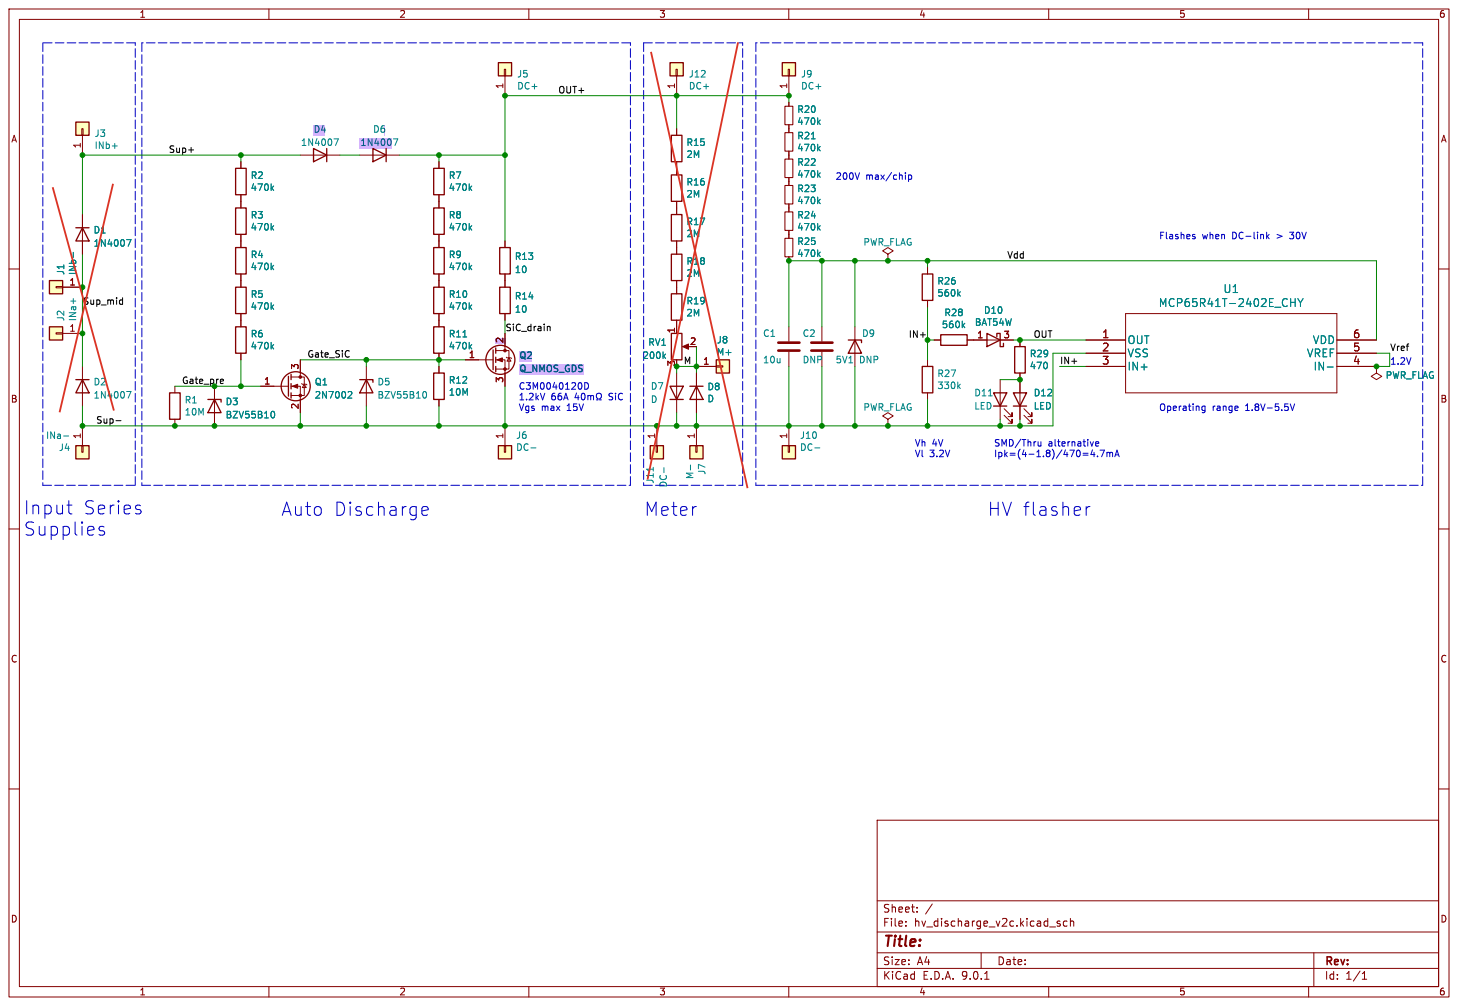
[picture p58: page 1]

Id: 1/1 Title: File: hv_discharge_v2c.kicad_sch Sheet: /
