reivax-boucoi/PCB_Kicad/transistor_clock/transistor_clock_schematic.pdf

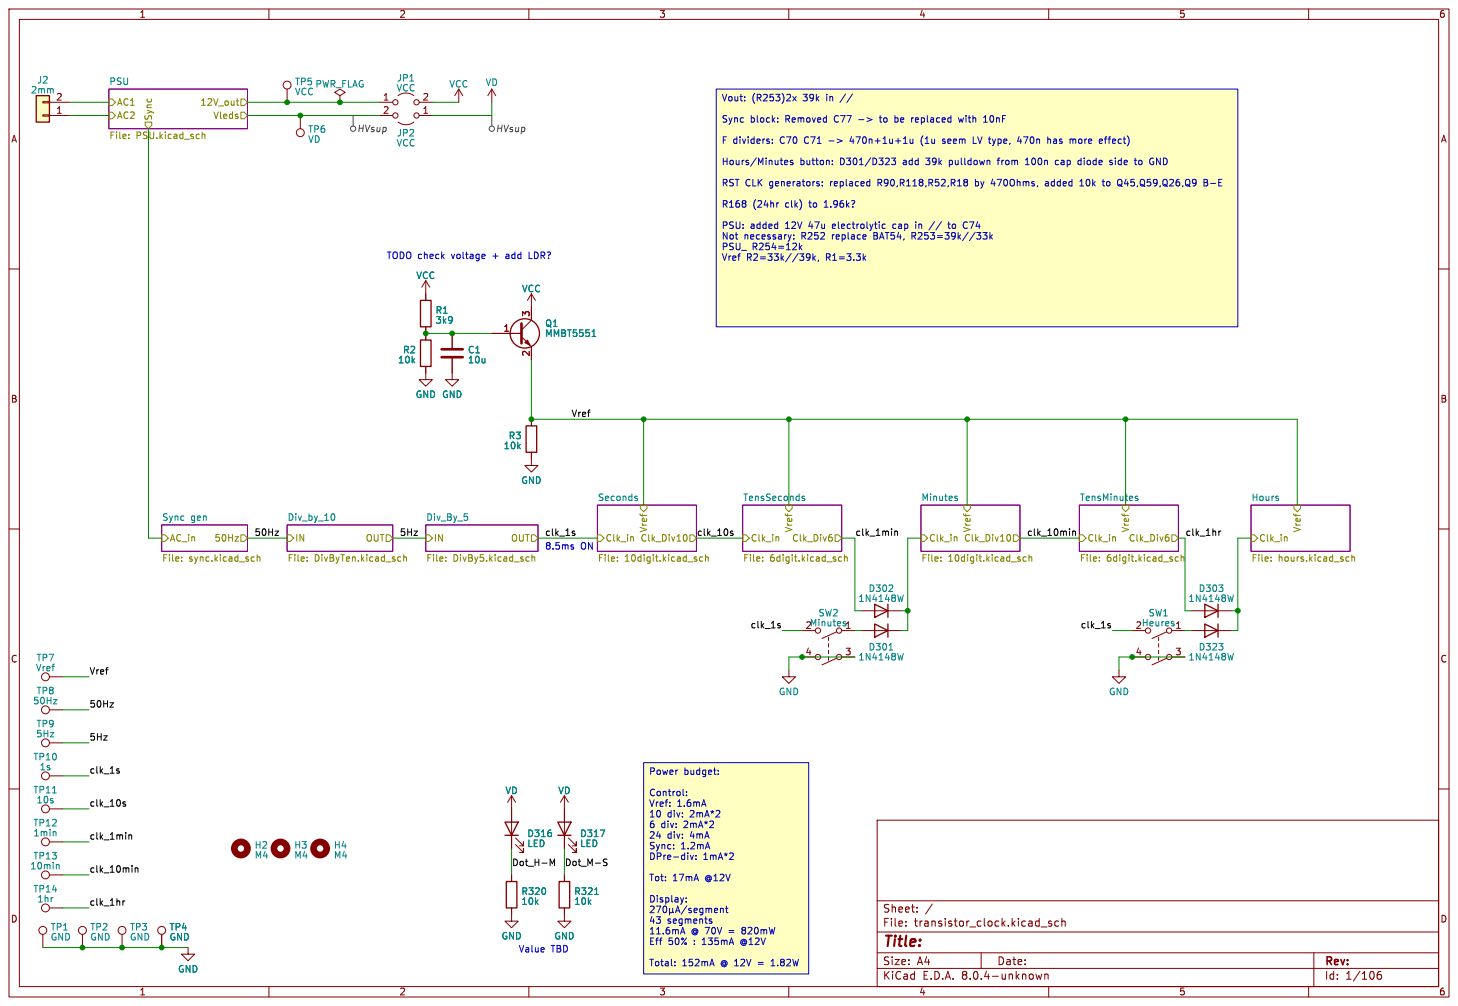
[picture p59: page 1]

TODO check voltage + add LDR?

Power budget: Control: Vref: 1.6mA

Id: 1/106 Title: File: transistor_clock.kicad_sch Sheet: /

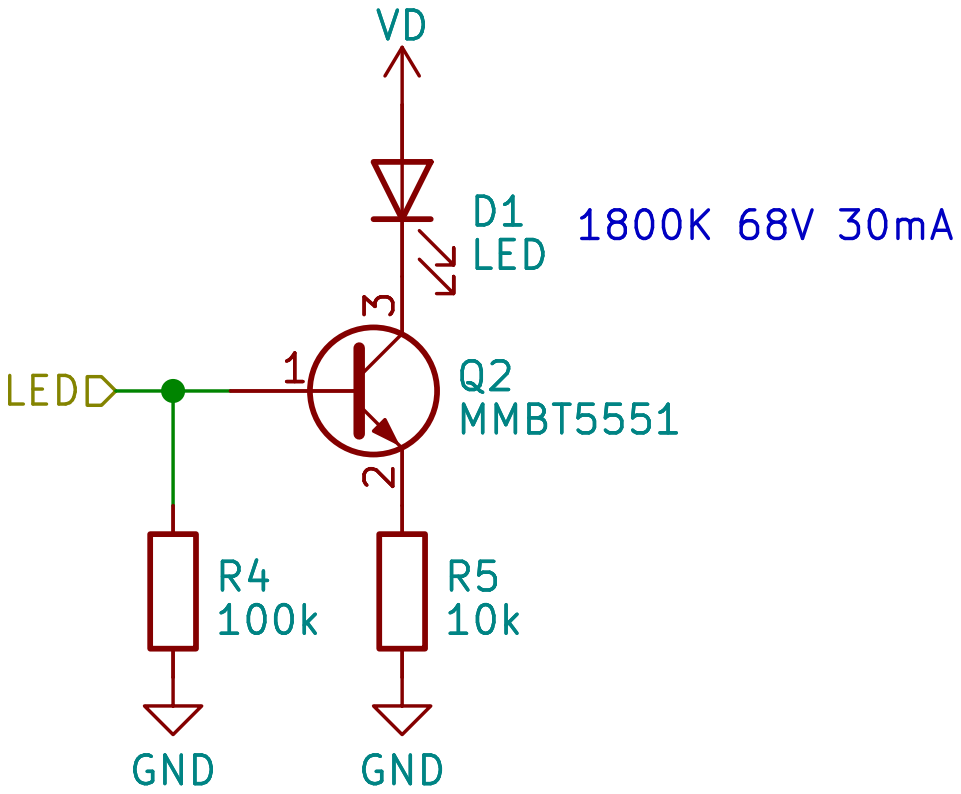
[picture p60: page 2]

Id: 2/106 Title: File: segment.kicad_sch Sheet: /Seconds/segmentA/

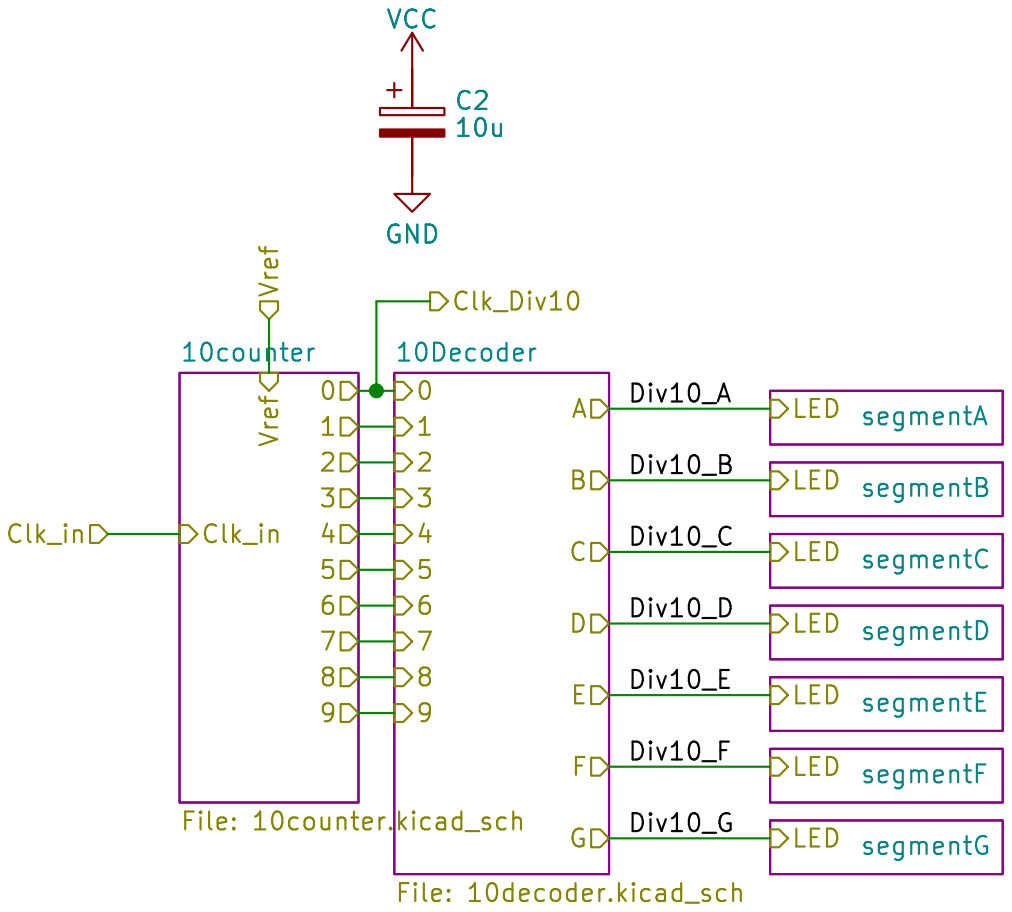
[picture p61: page 3]

Id: 3/106 Title: File: 10digit.kicad_sch Sheet: /Seconds/

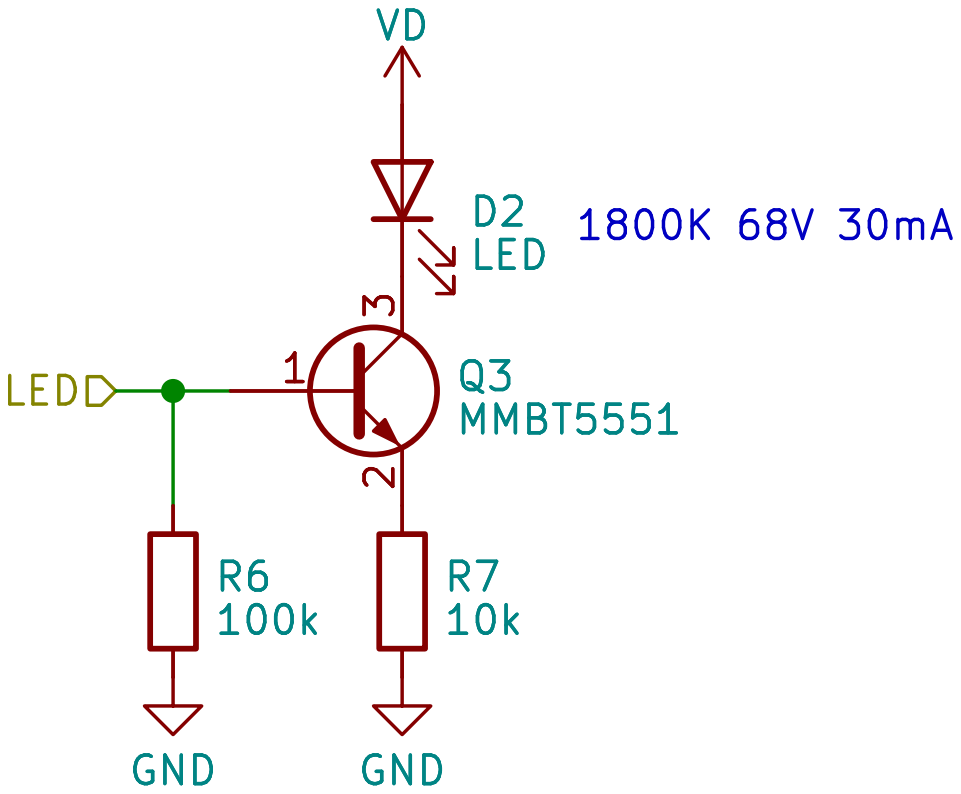
[picture p62: page 4]

Id: 4/106 Title: File: segment.kicad_sch Sheet: /Seconds/segmentB/

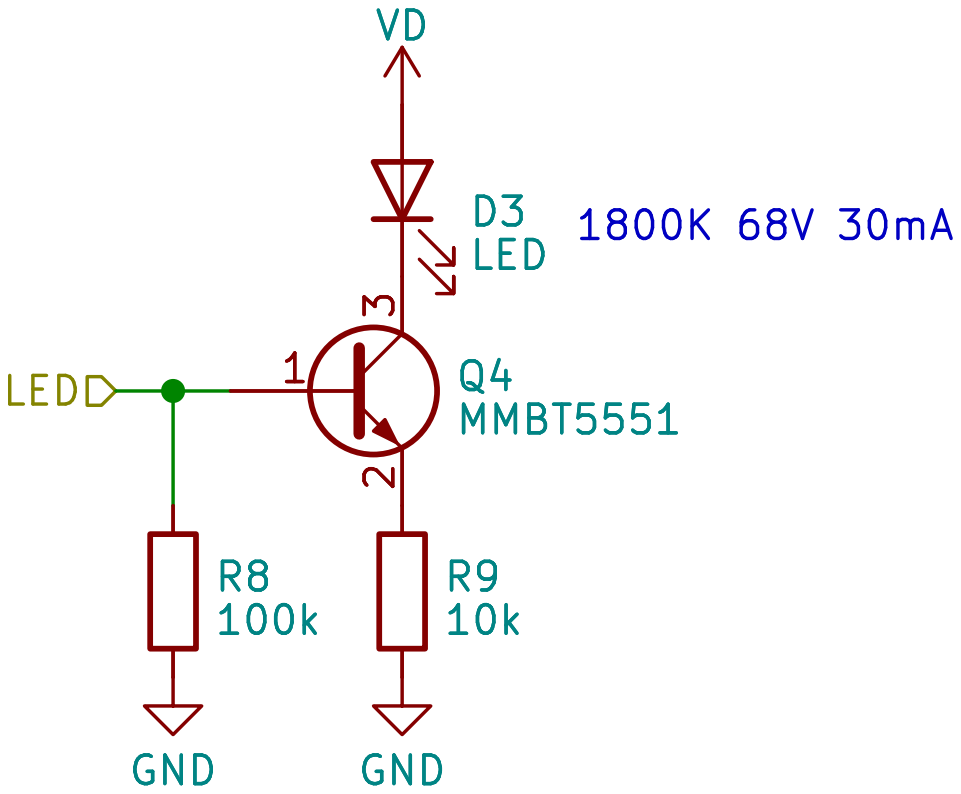
[picture p63: page 5]

Id: 5/106 Title: File: segment.kicad_sch Sheet: /Seconds/segmentC/

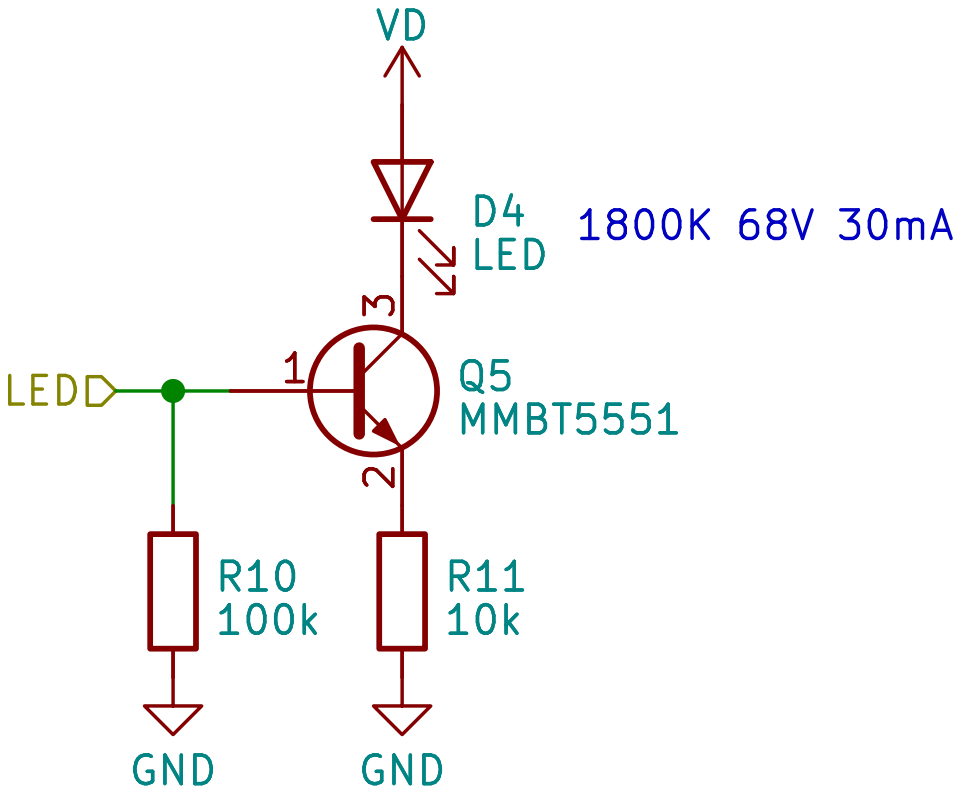
[picture p64: page 6]

Id: 6/106 Title: File: segment.kicad_sch Sheet: /Seconds/segmentD/

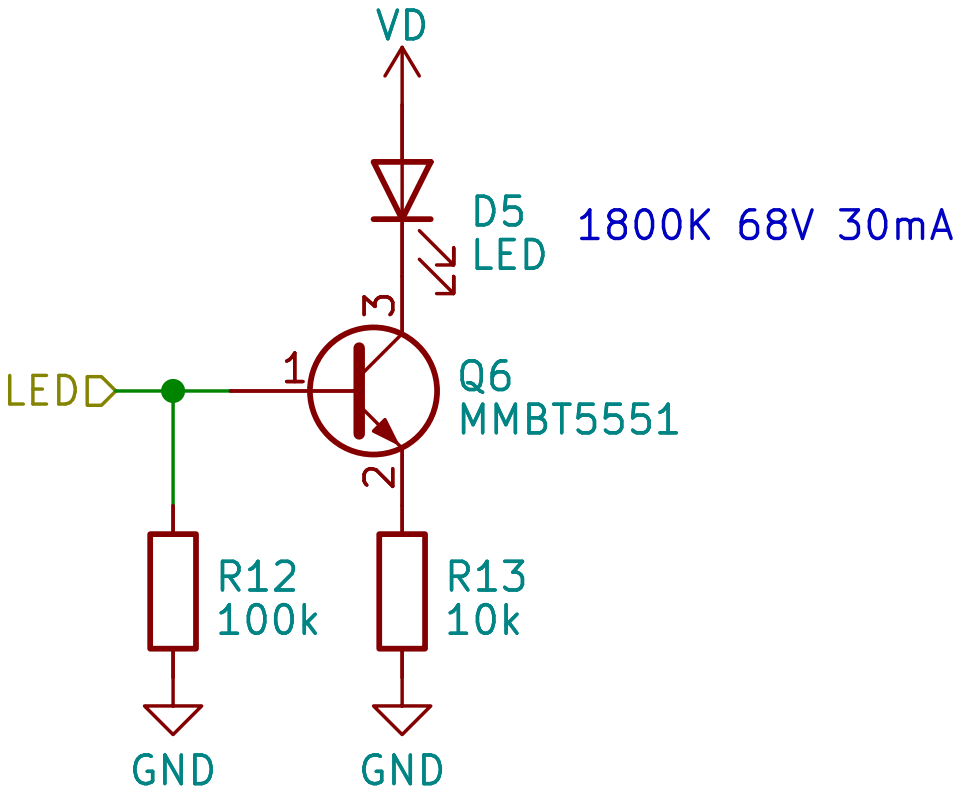
[picture p65: page 7]

Id: 7/106 Title: File: segment.kicad_sch Sheet: /Seconds/segmentE/

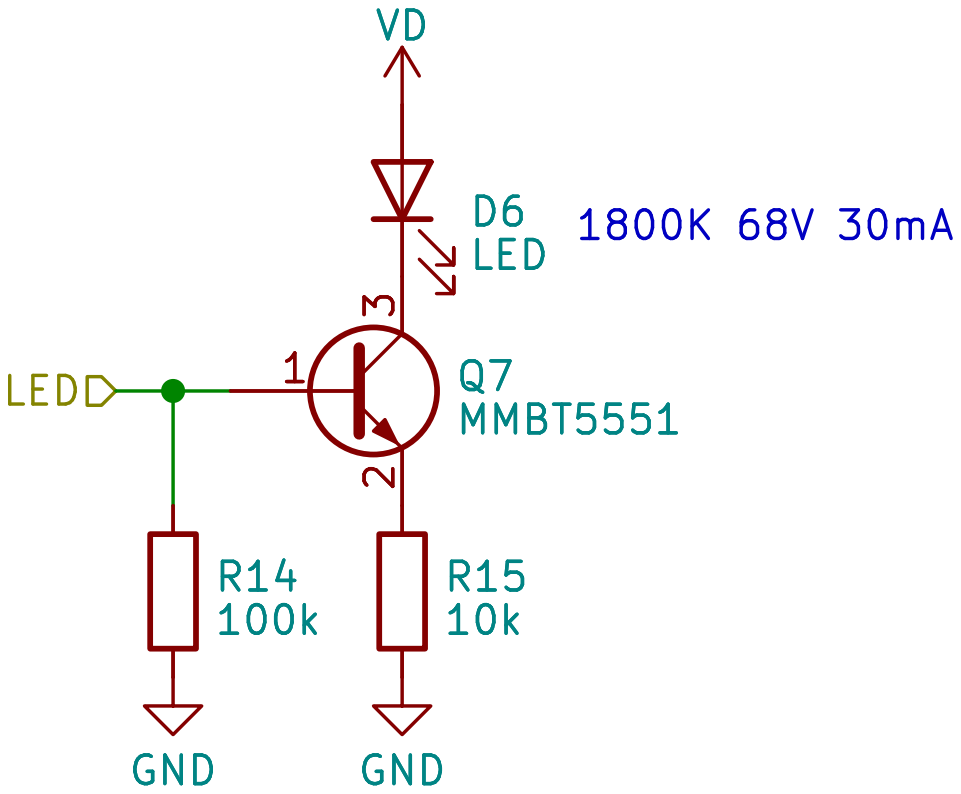
[picture p66: page 8]

Id: 8/106 Title: File: segment.kicad_sch Sheet: /Seconds/segmentF/

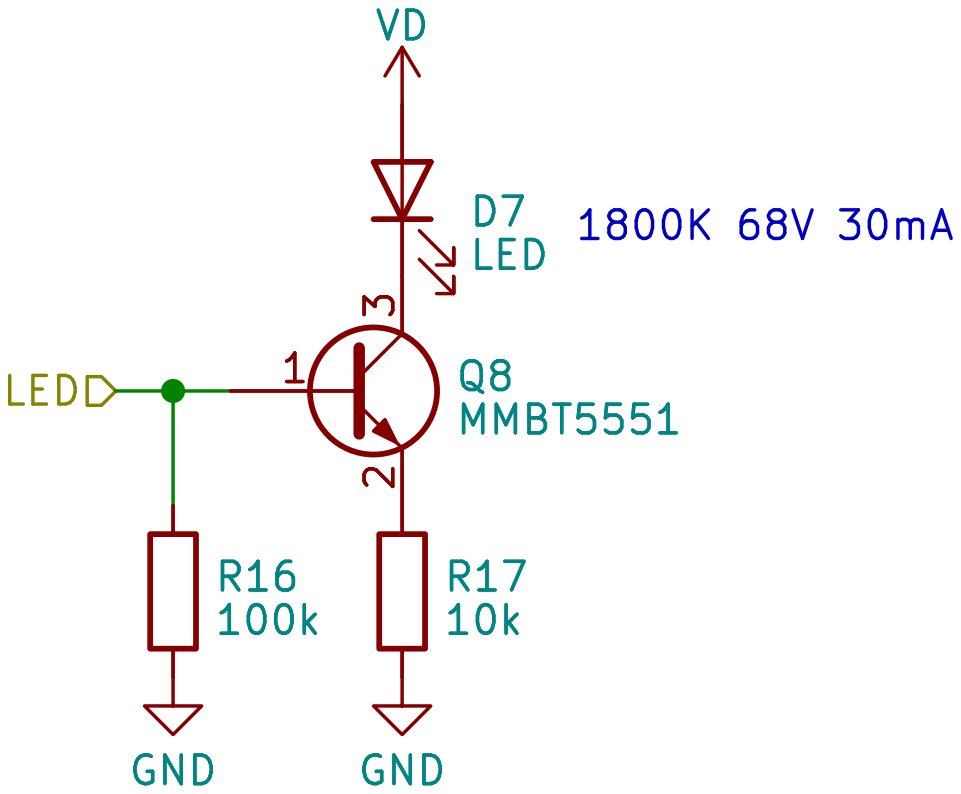
[picture p67: page 9]

Id: 9/106 Title: File: segment.kicad_sch Sheet: /Seconds/segmentG/

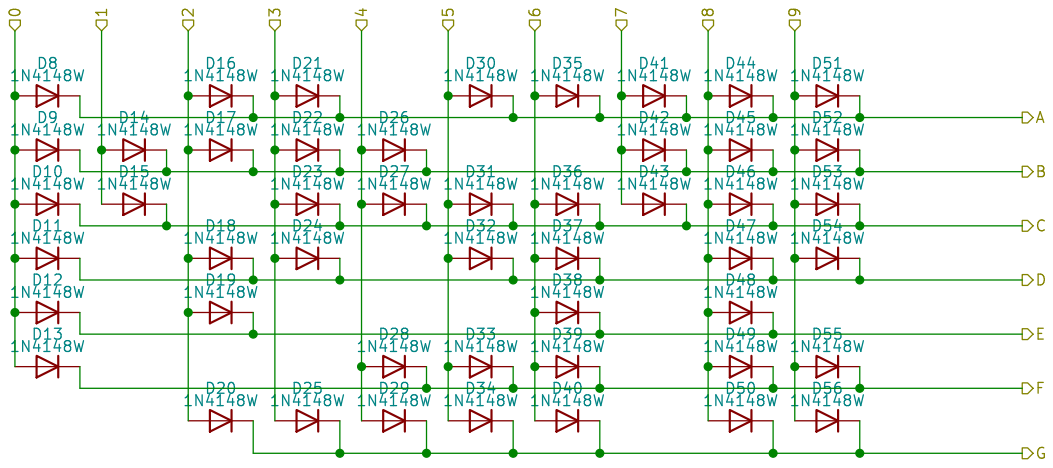
[picture p68: page 10]

Id: 10/106 Title: File: 10decoder.kicad_sch Sheet: /Seconds/10Decoder/

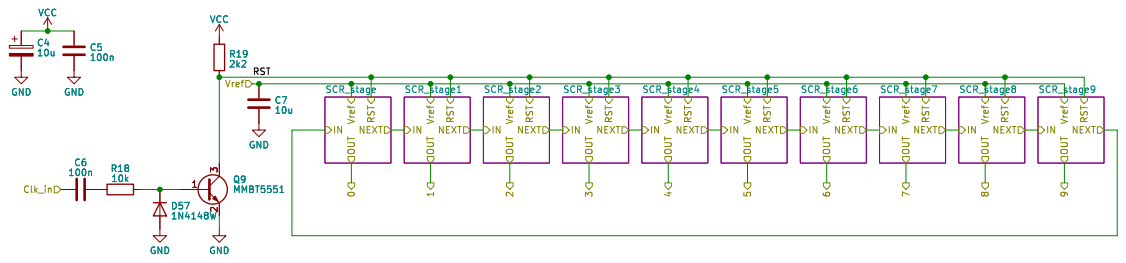
[picture p69: page 11]

Id: 11/106 Title: File: 10counter.kicad_sch Sheet: /Seconds/10counter/

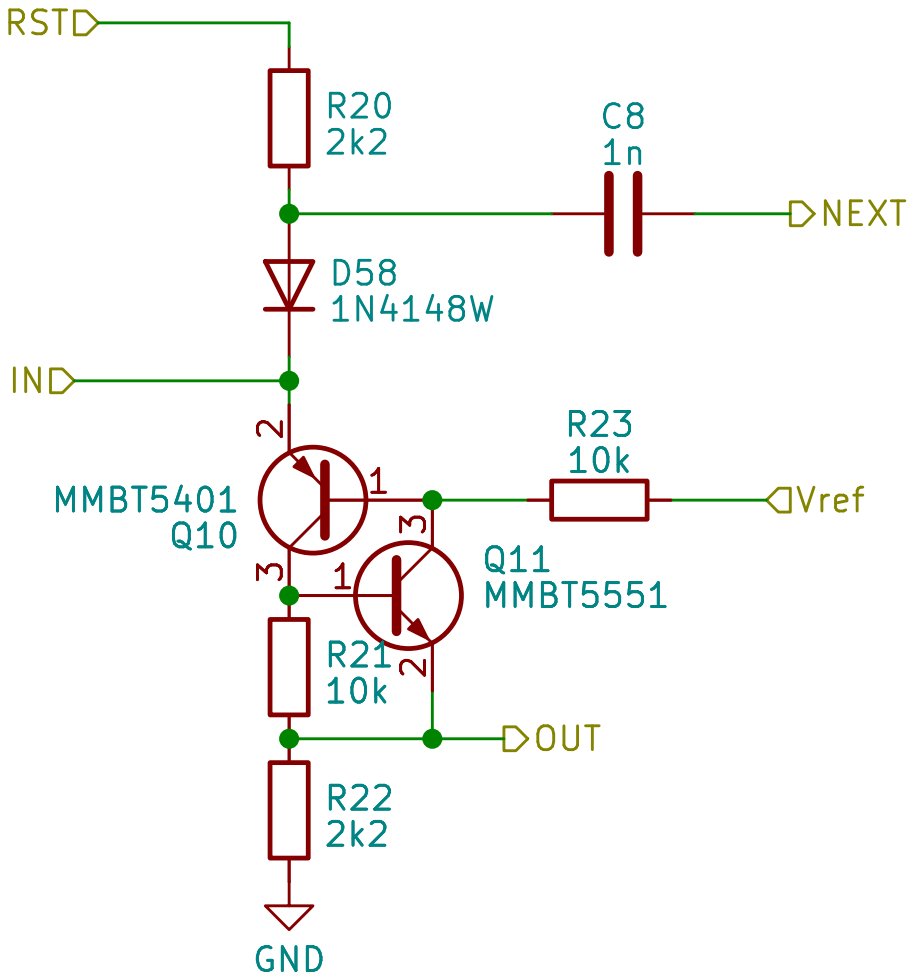
[picture p70: page 12]

Id: 12/106 Title: File: scr_stage.kicad_sch Sheet: /Seconds/10counter/SCR_stage/ R22

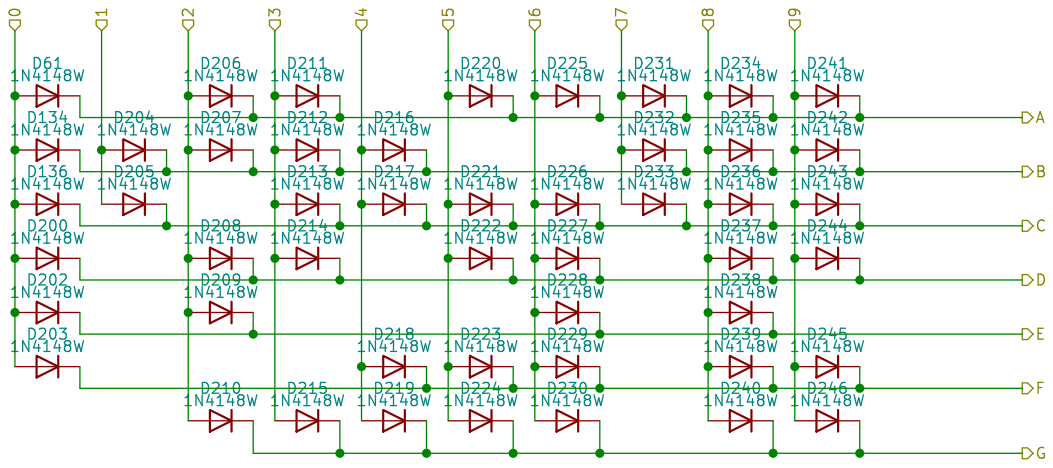
[picture p71: page 13]

Id: 13/106 Title: File: 10decoder.kicad_sch Sheet: /Hours/10Decoder1/

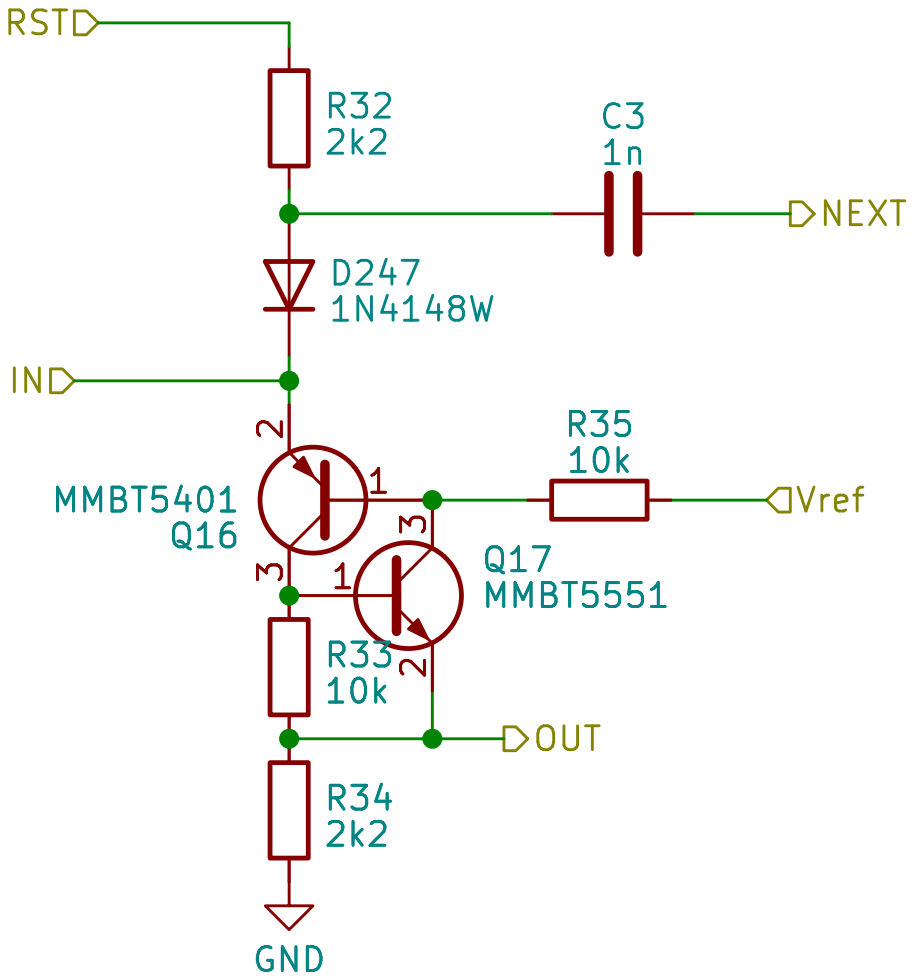
[picture p72: page 14]

Id: 14/106 Title: File: scr_stage.kicad_sch Sheet: /Hours/SCR_stage0/ R34

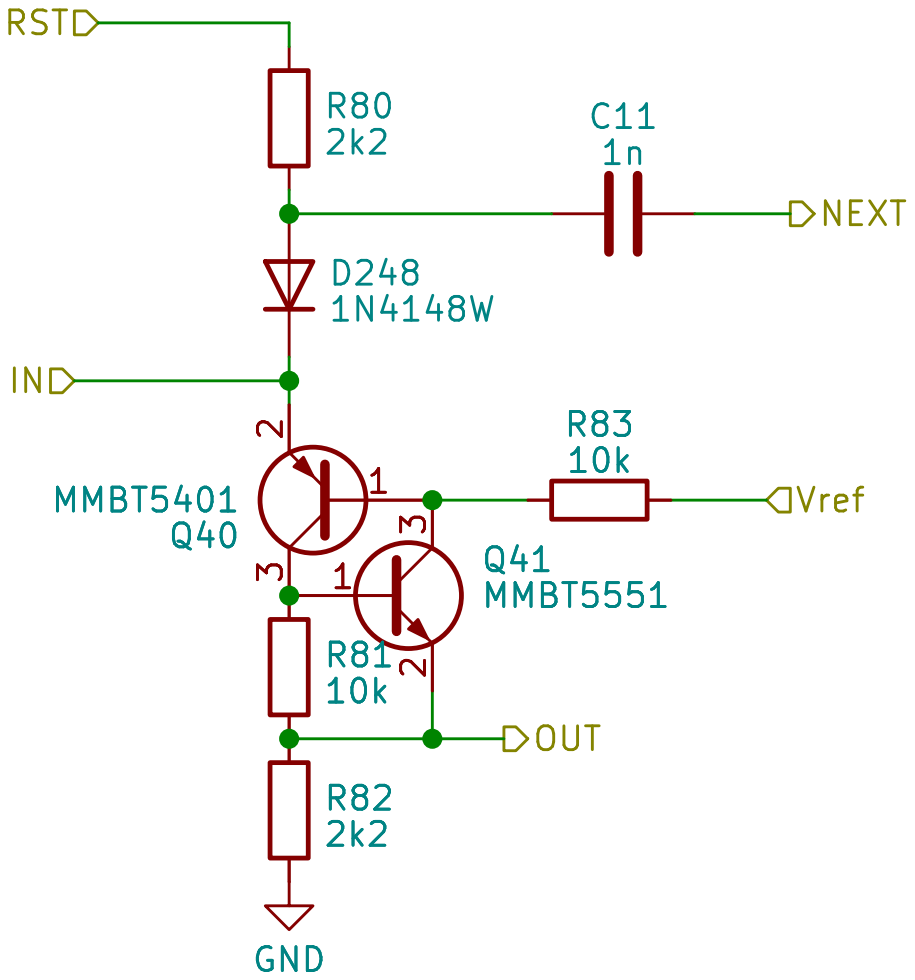
[picture p73: page 15]

Id: 15/106 Title: File: scr_stage.kicad_sch Sheet: /Hours/SCR_stage2/ R82
2k2 GND

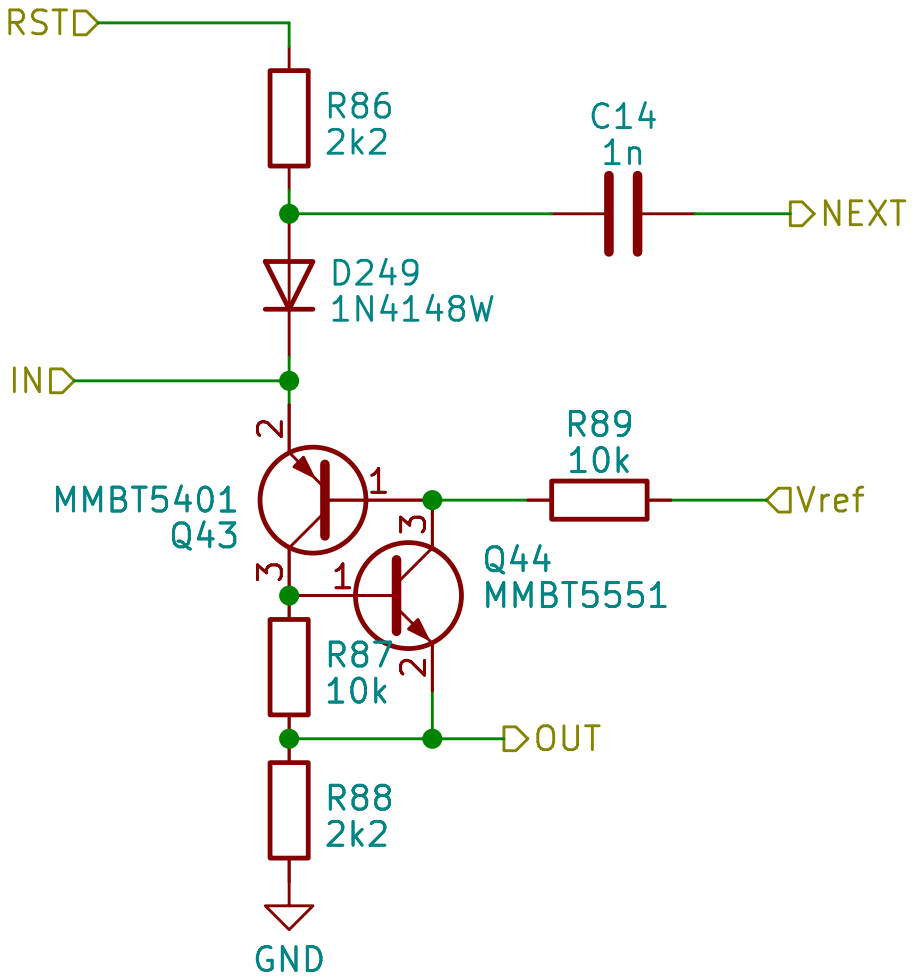
[picture p74: page 16]

Id: 16/106 Title: File: scr_stage.kicad_sch Sheet: /Hours/SCR_stage1/ R88

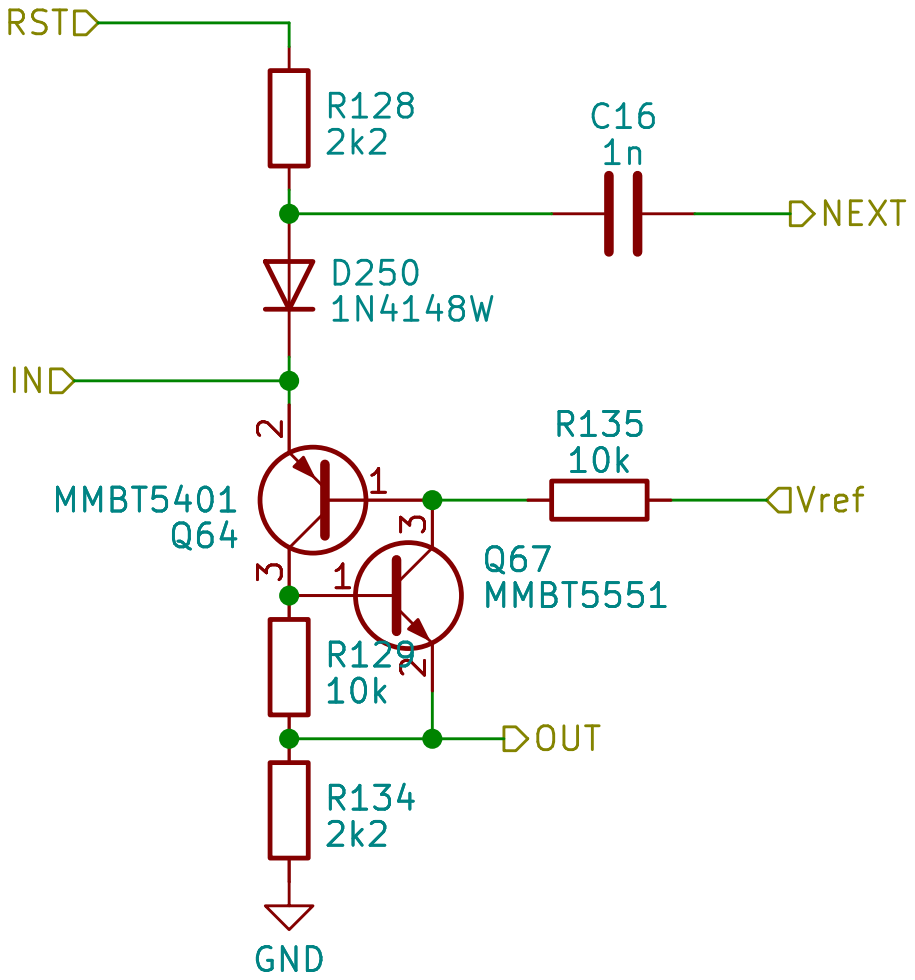
[picture p75: page 17]

Id: 17/106 Title: File: scr_stage.kicad_sch Sheet: /Hours/SCR_stage5/ R134

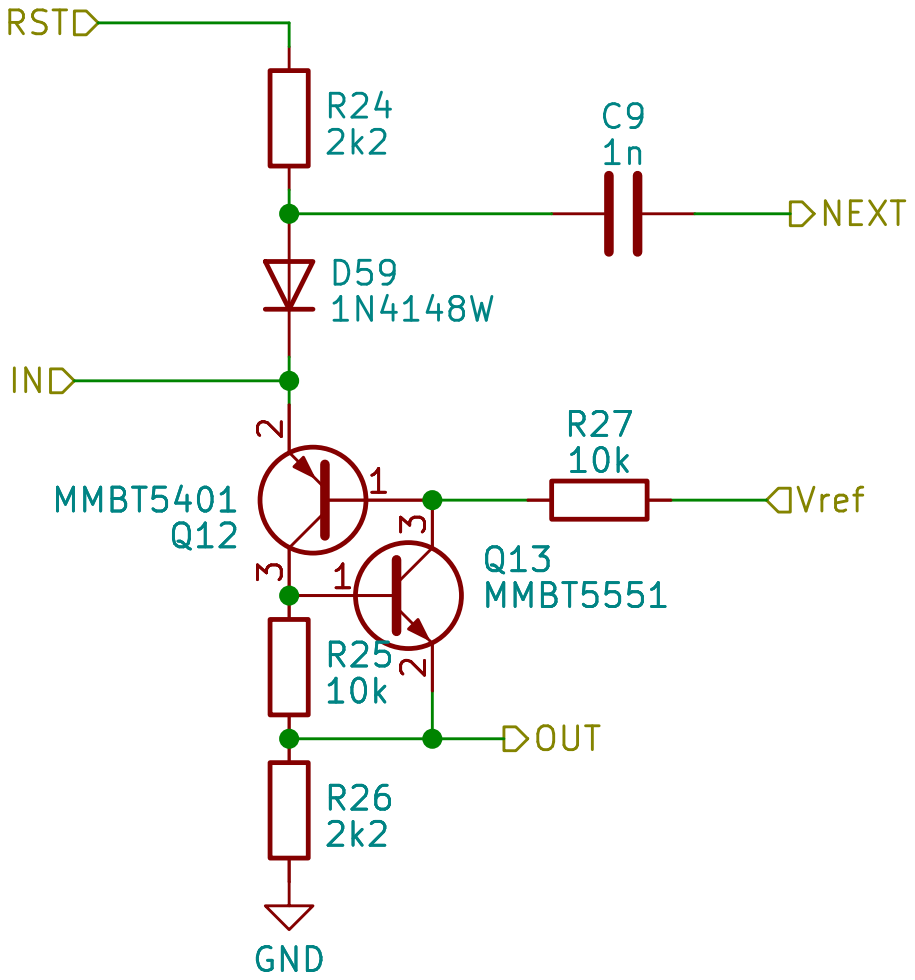
[picture p76: page 18]

Id: 18/106 Title: File: scr_stage.kicad_sch Sheet: /Seconds/10counter/SCR_stage1/ R26
2k2 GND

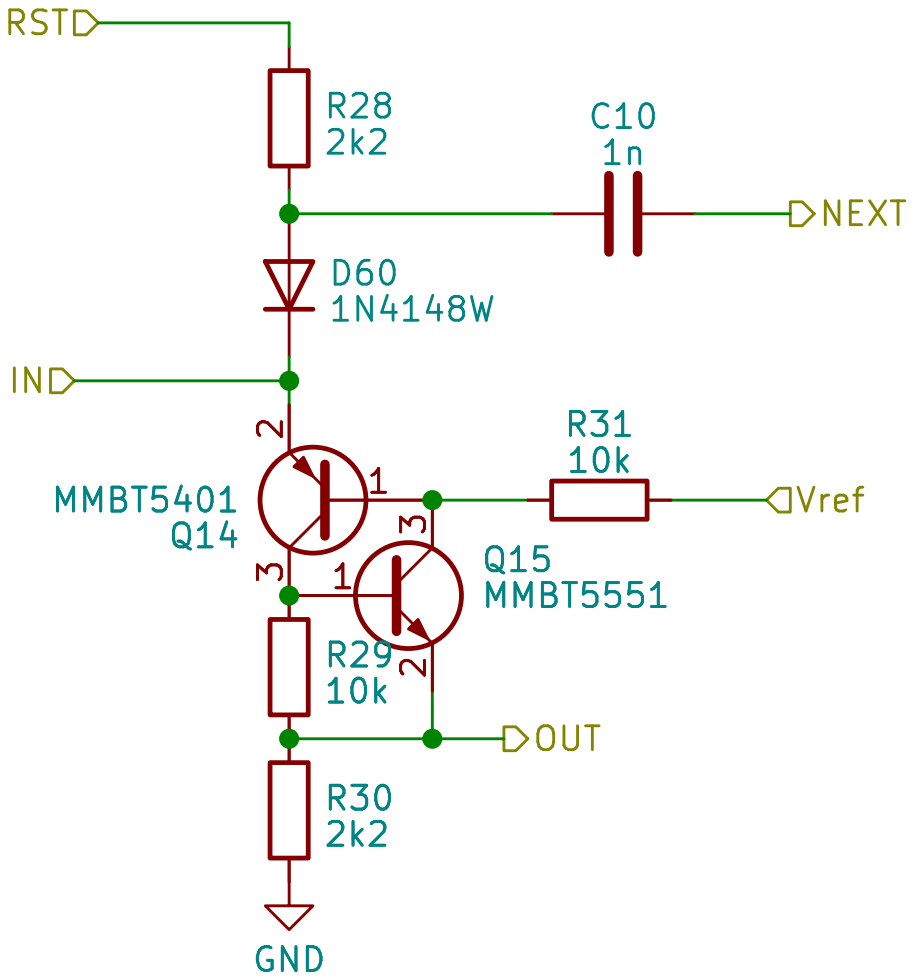
[picture p77: page 19]

Id: 19/106 Title: File: scr_stage.kicad_sch Sheet: /Minutes/10counter/SCR_stage1/ R30

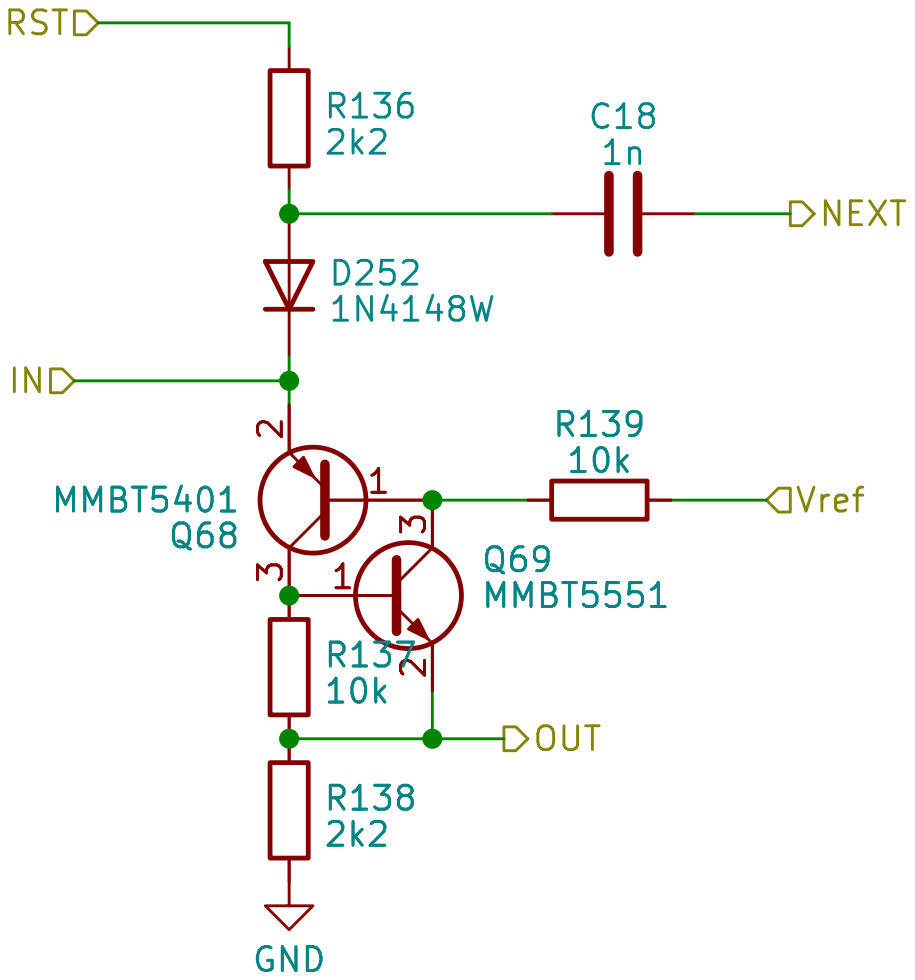
[picture p78: page 20]

Id: 20/106 Title: File: scr_stage.kicad_sch Sheet: /Hours/SCR_stage3/ R138

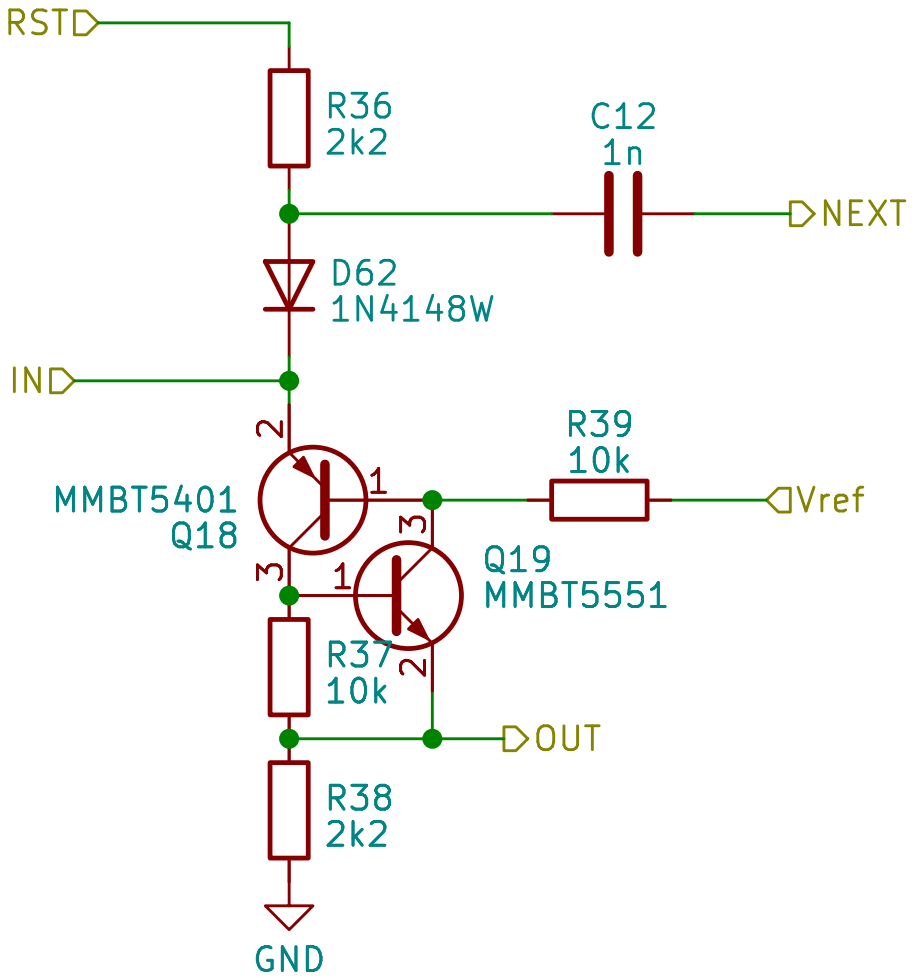
[picture p79: page 21]

Id: 21/106 Title: File: scr_stage.kicad_sch Sheet: /Seconds/10counter/SCR_stage2/ R38
2k2 GND

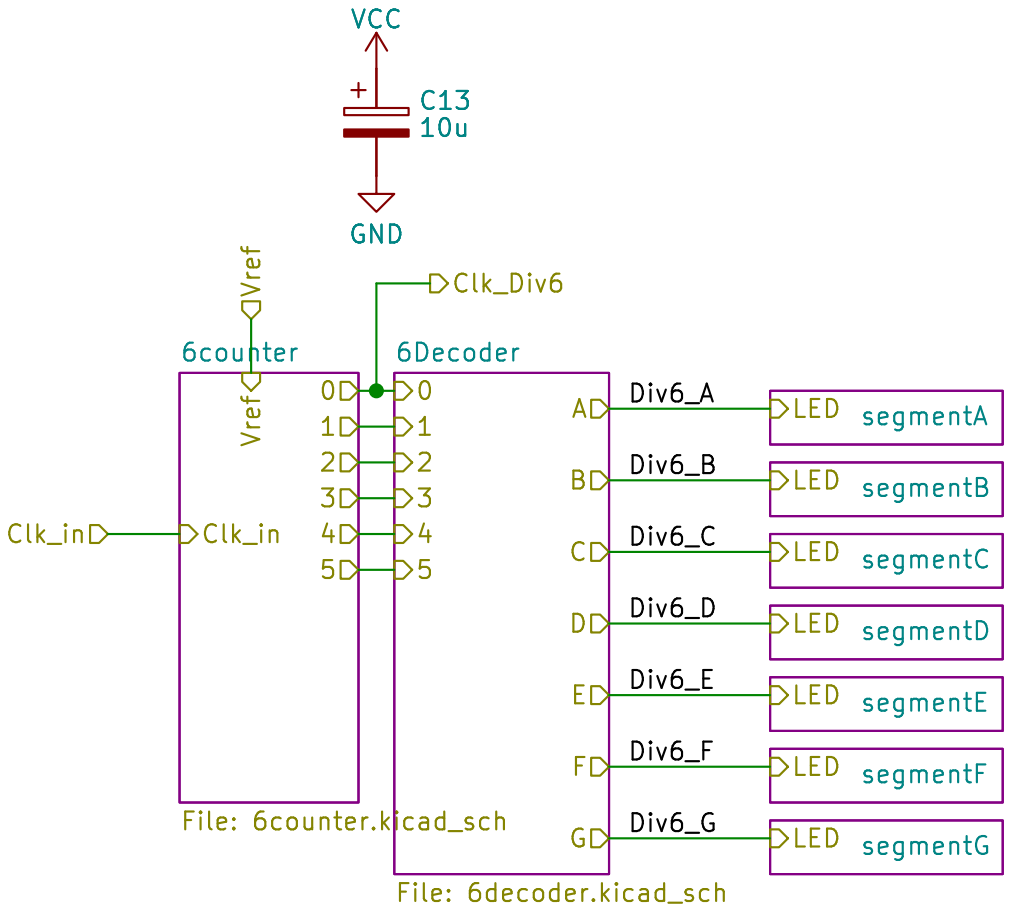
[picture p80: page 22]

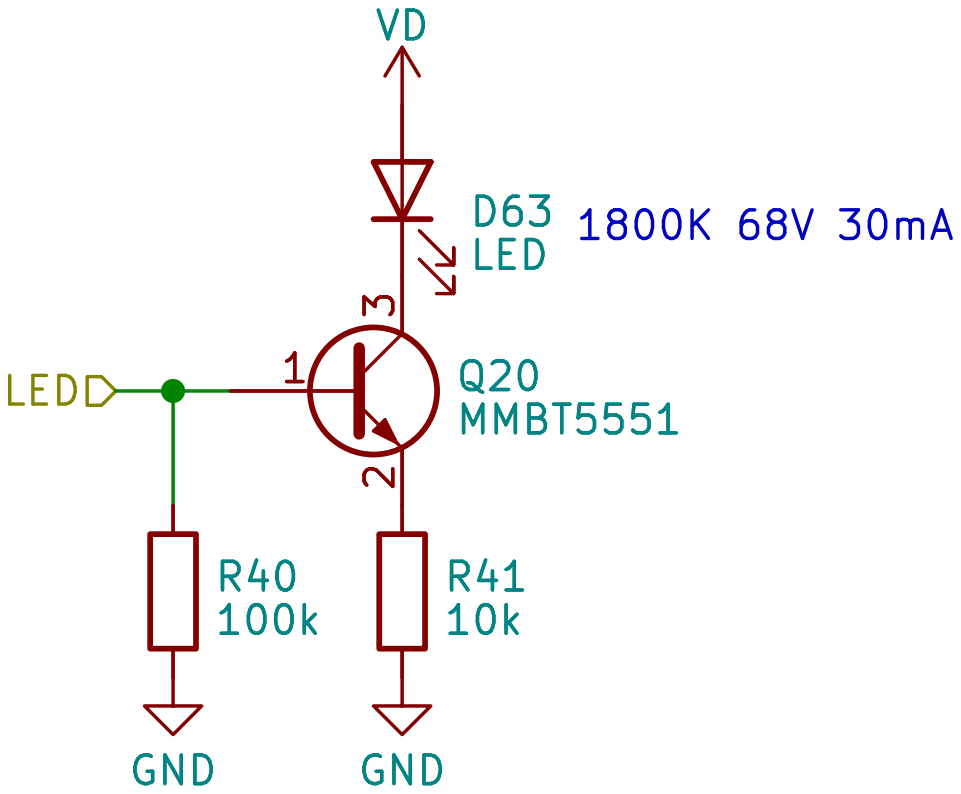
[picture p81: page 23]

Id: 23/106 Title: File: segment.kicad_sch Sheet: /TensSeconds/segmentC/

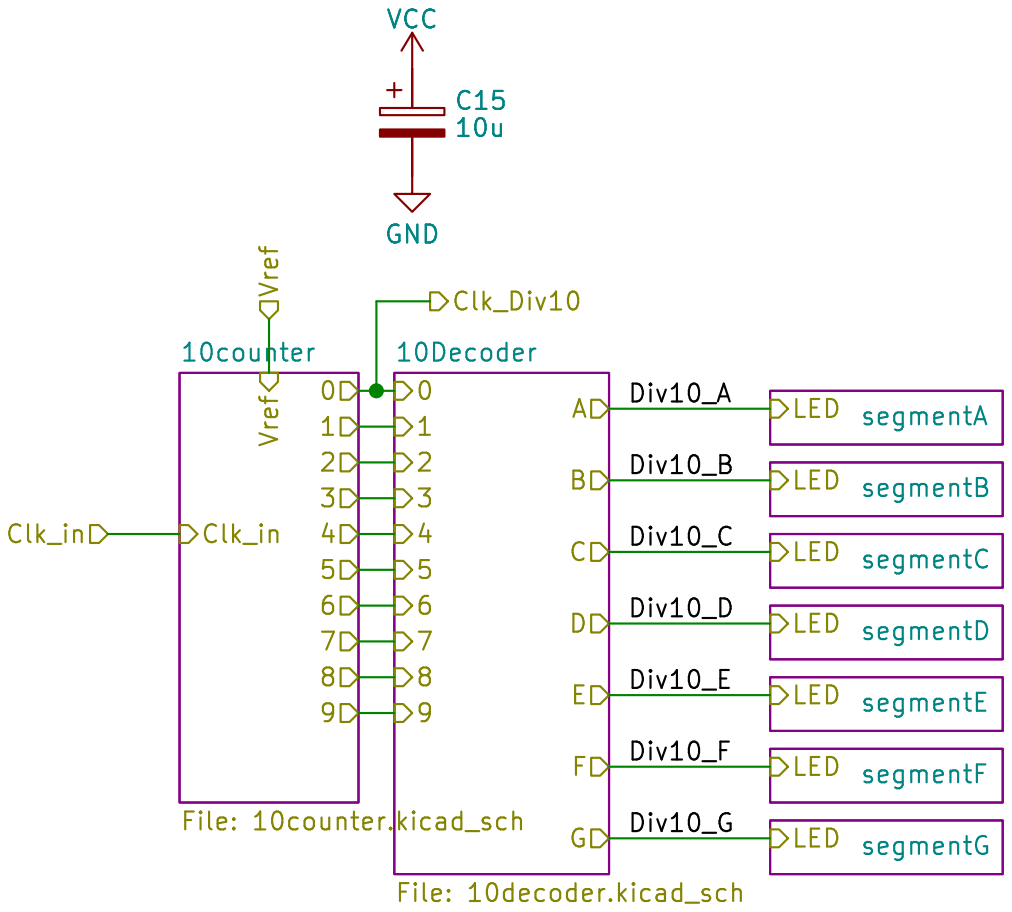
[picture p82: page 24]

Id: 24/106 Title: File: 10digit.kicad_sch Sheet: /Minutes/

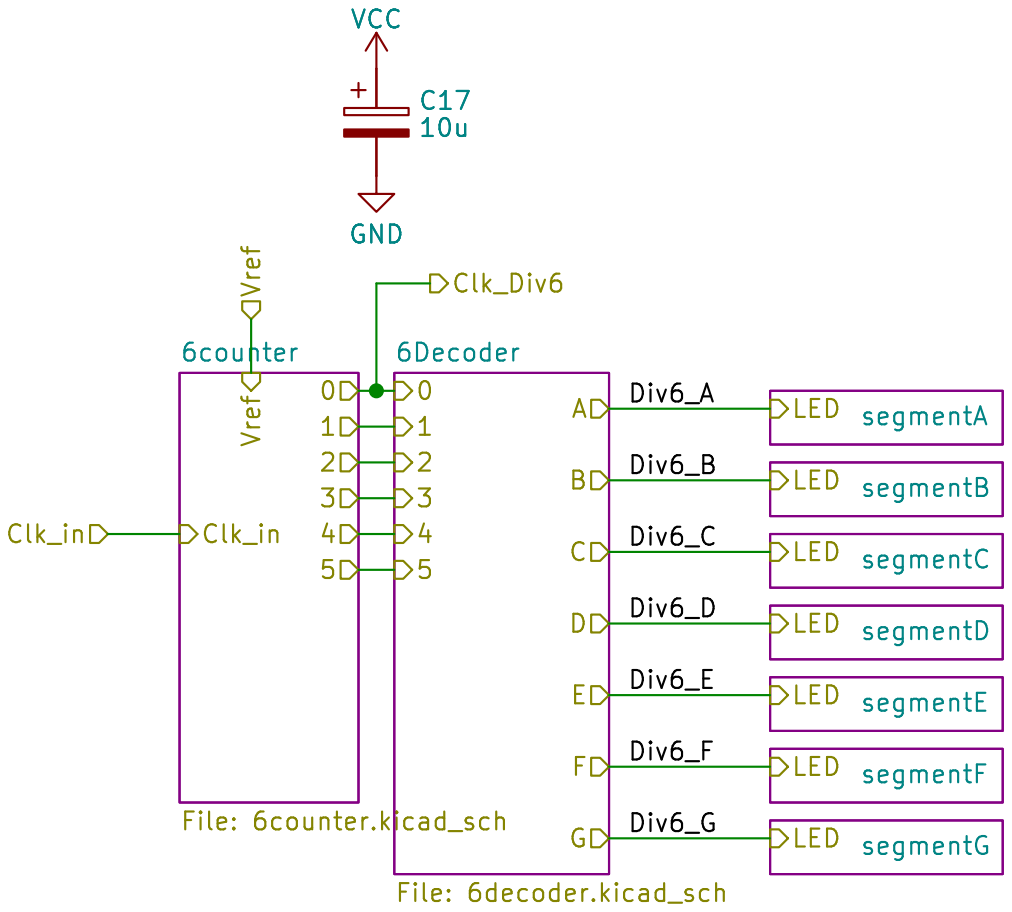
[picture p83: page 25]

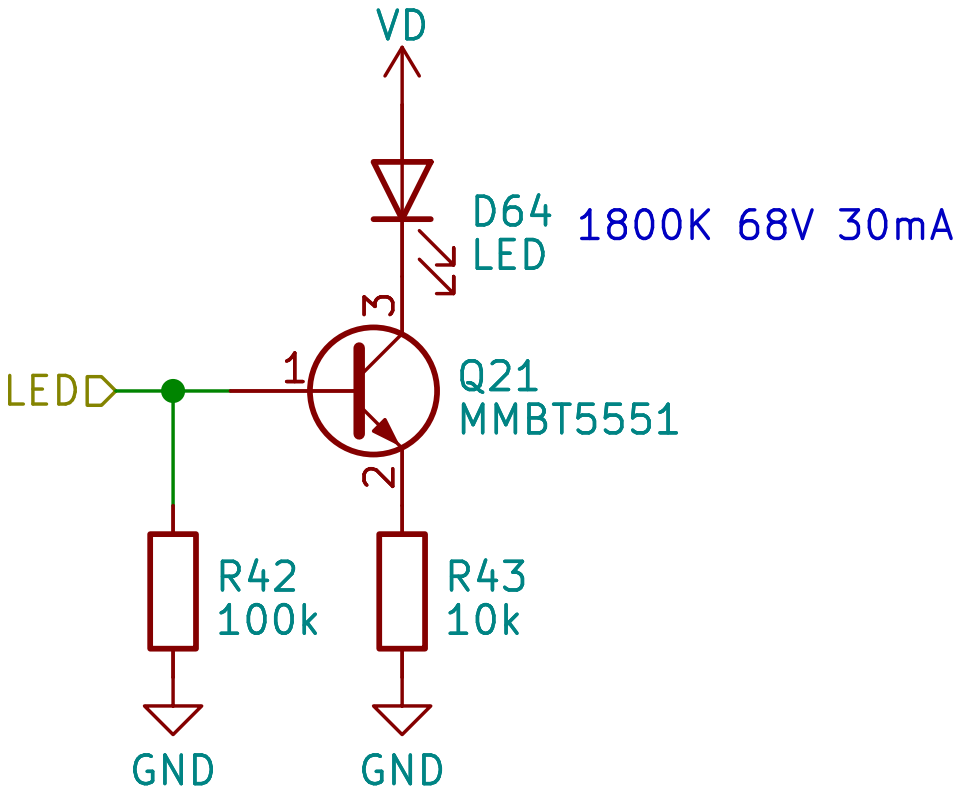
[picture p84: page 26]

Id: 26/106 Title: File: segment.kicad_sch Sheet: /TensMinutes/segmentD/

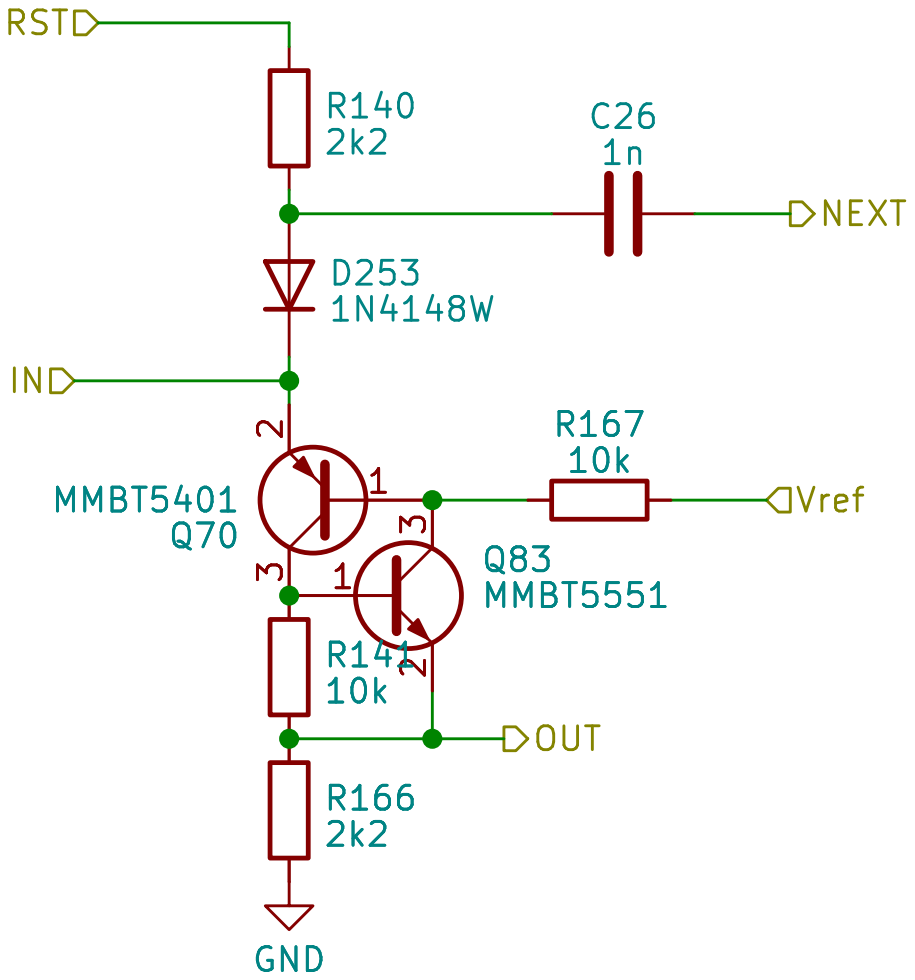
[picture p85: page 27]

Id: 27/106 Title: File: scr_stage.kicad_sch Sheet: /Hours/SCR_stage4/ R166

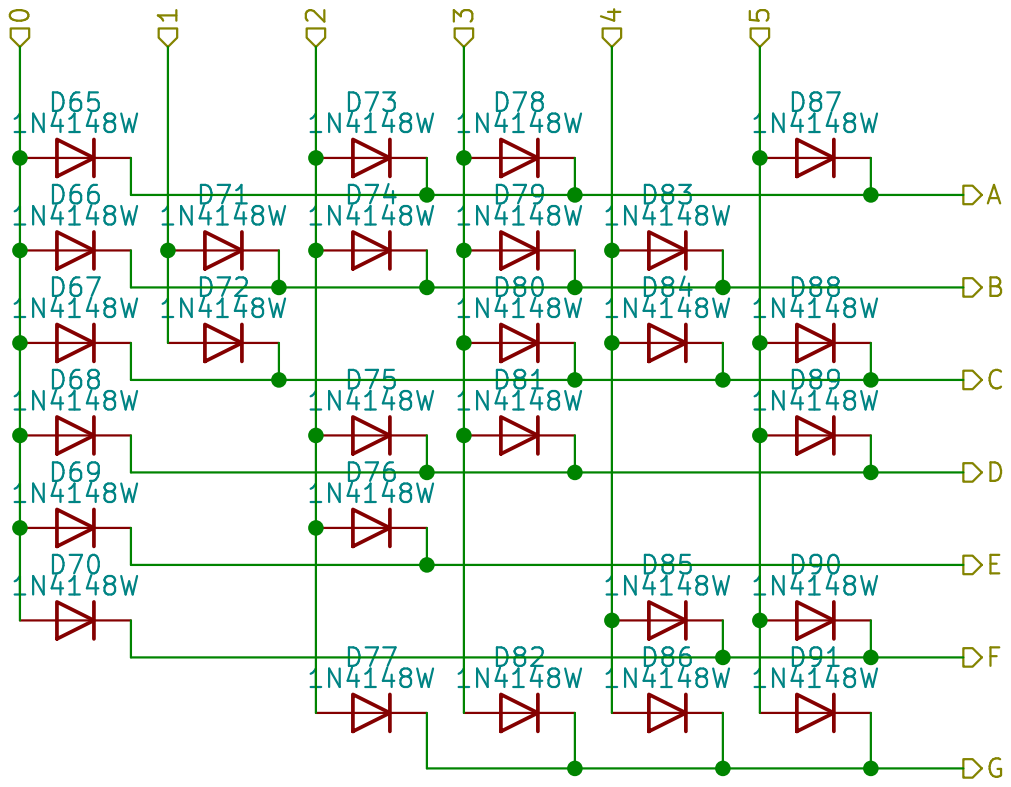
[picture p86: page 28]

Id: 28/106 Title: File: 6decoder.kicad_sch Sheet: /TensMinutes/6Decoder/ D70

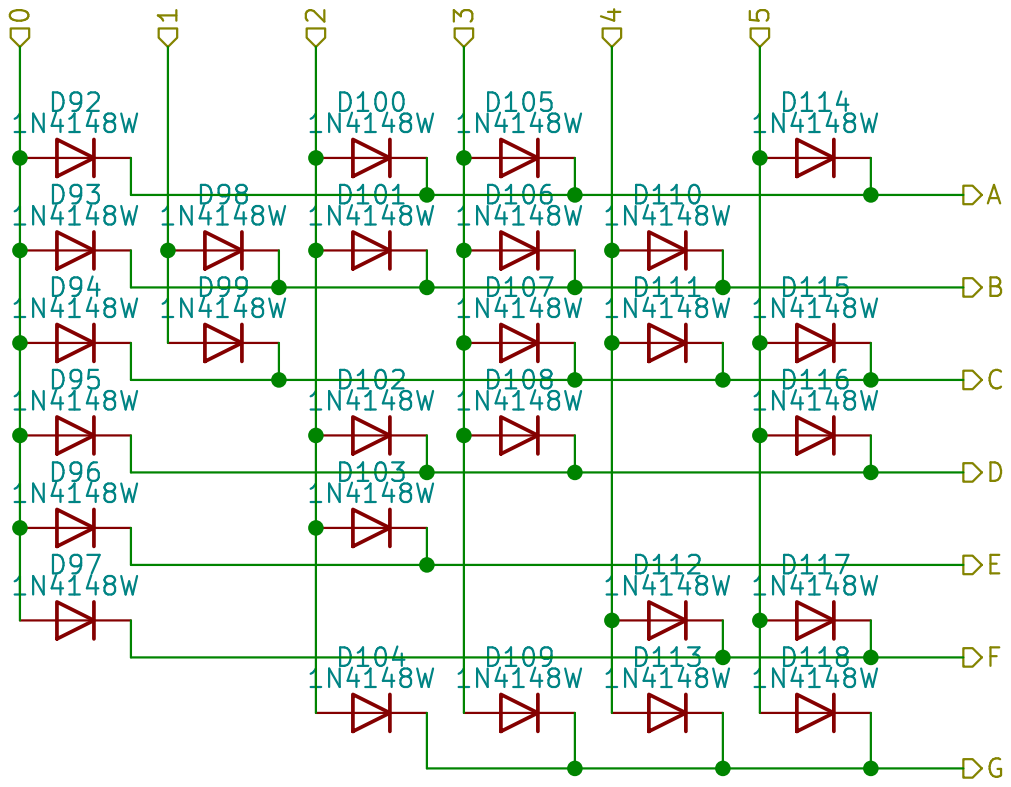
[picture p87: page 29]

Id: 29/106 Title: File: 6decoder.kicad_sch Sheet: /TensSeconds/6Decoder/ D97

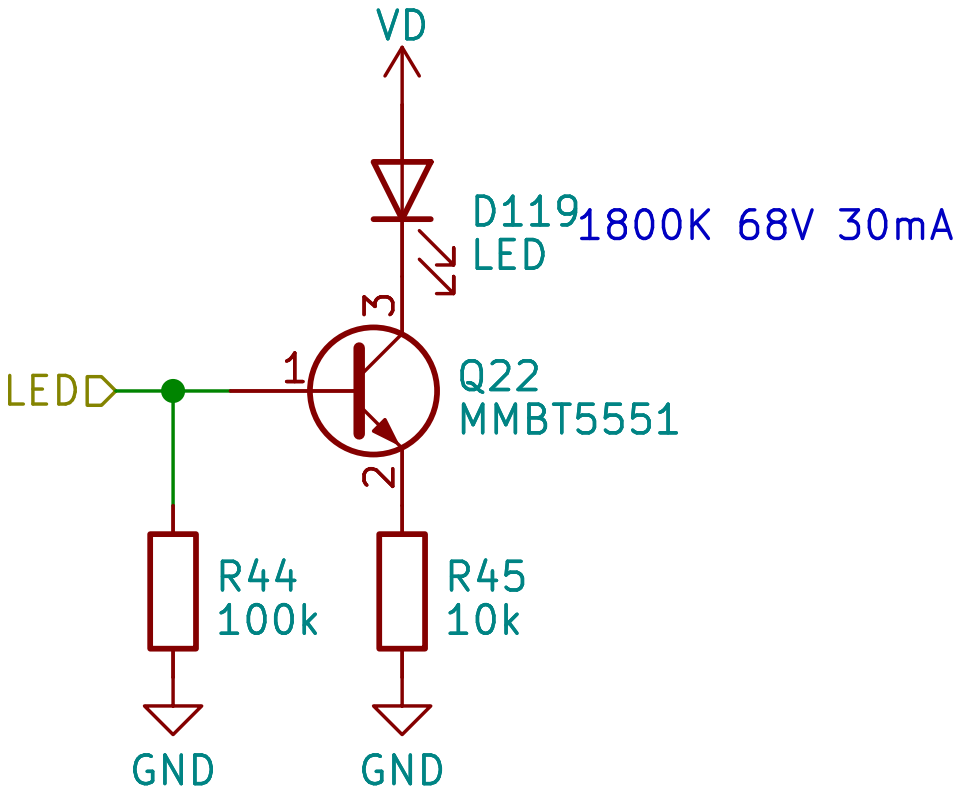
[picture p88: page 30]

Id: 30/106 Title: File: segment.kicad_sch Sheet: /TensSeconds/segmentG/

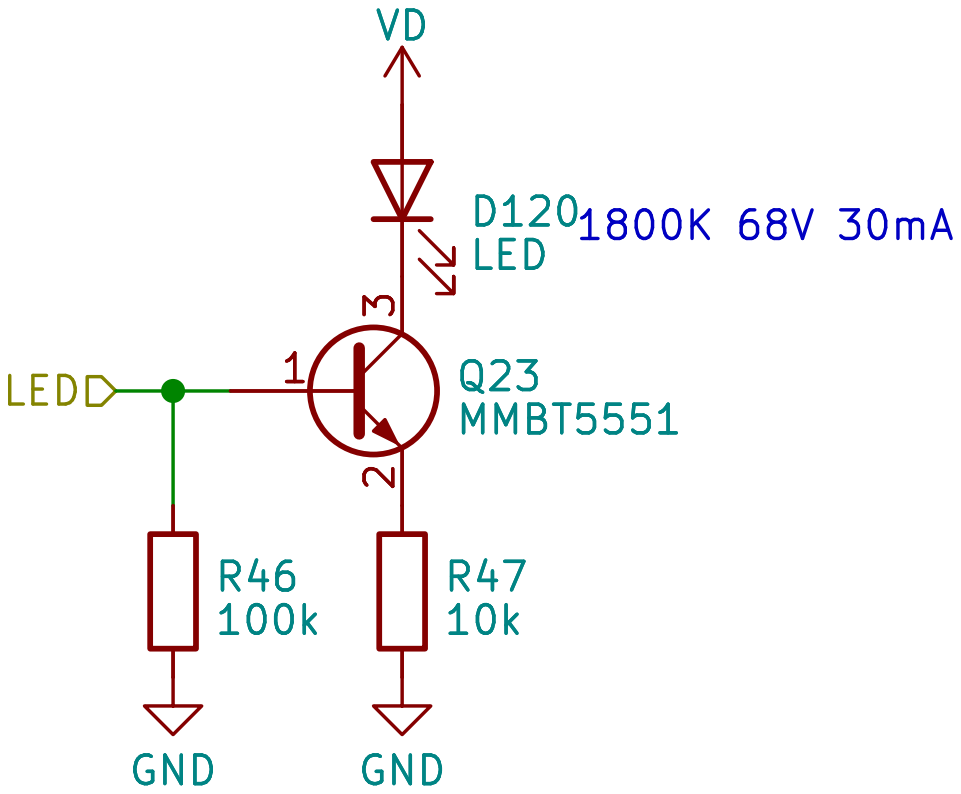
[picture p89: page 31]

Id: 31/106 Title: File: segment.kicad_sch Sheet: /TensMinutes/segmentE/

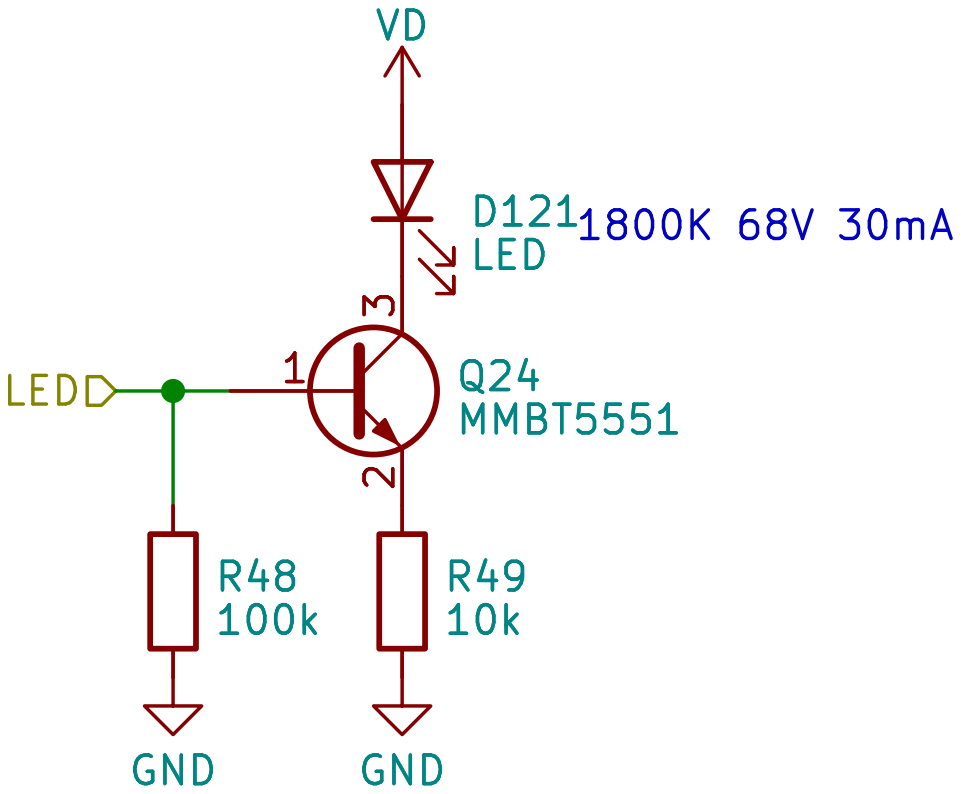
[picture p90: page 32]

Id: 32/106 Title: File: segment.kicad_sch Sheet: /TensSeconds/segmentA/

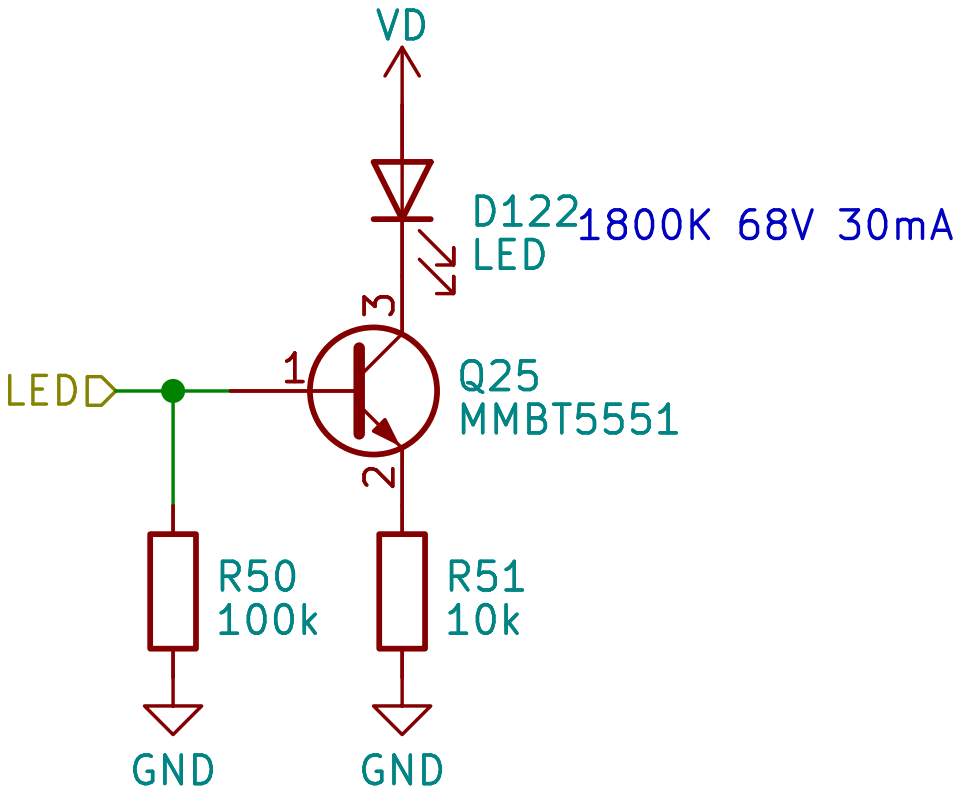
[picture p91: page 33]

Id: 33/106 Title: File: segment.kicad_sch Sheet: /Minutes/segmentA/

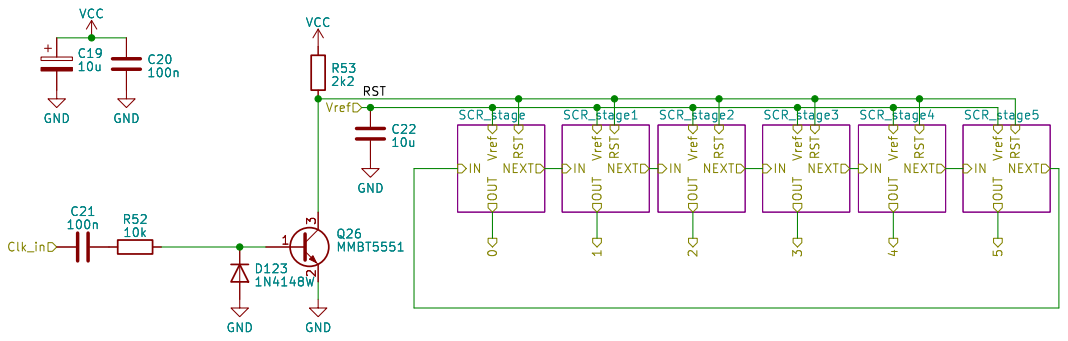
[picture p92: page 34]

Id: 34/106 Title: File: 6counter.kicad_sch Sheet: /TensSeconds/6counter/

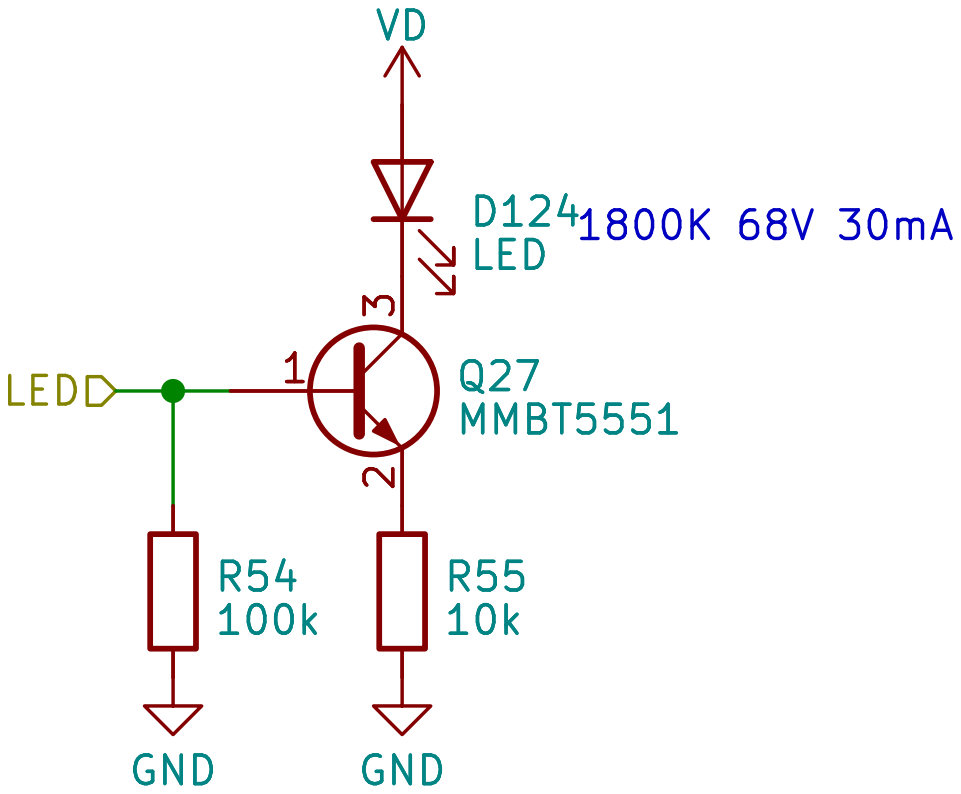
[picture p93: page 35]

Id: 35/106 Title: File: segment.kicad_sch Sheet: /Minutes/segmentB/

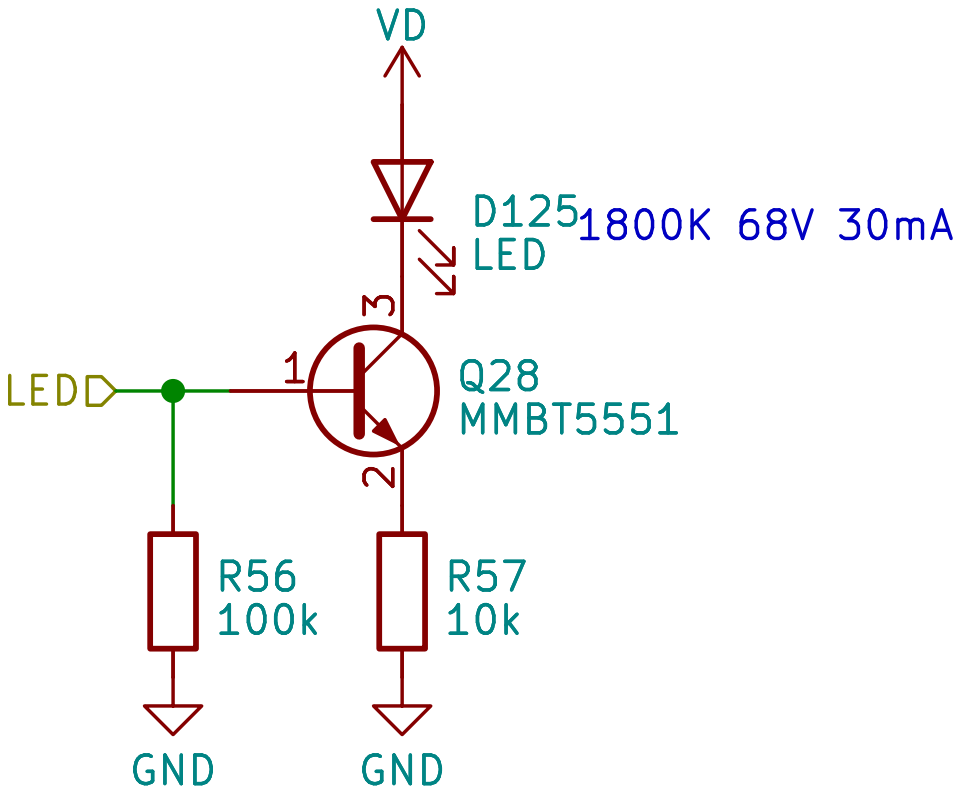
[picture p94: page 36]

Id: 36/106 Title: File: segment.kicad_sch Sheet: /TensSeconds/segmentE/

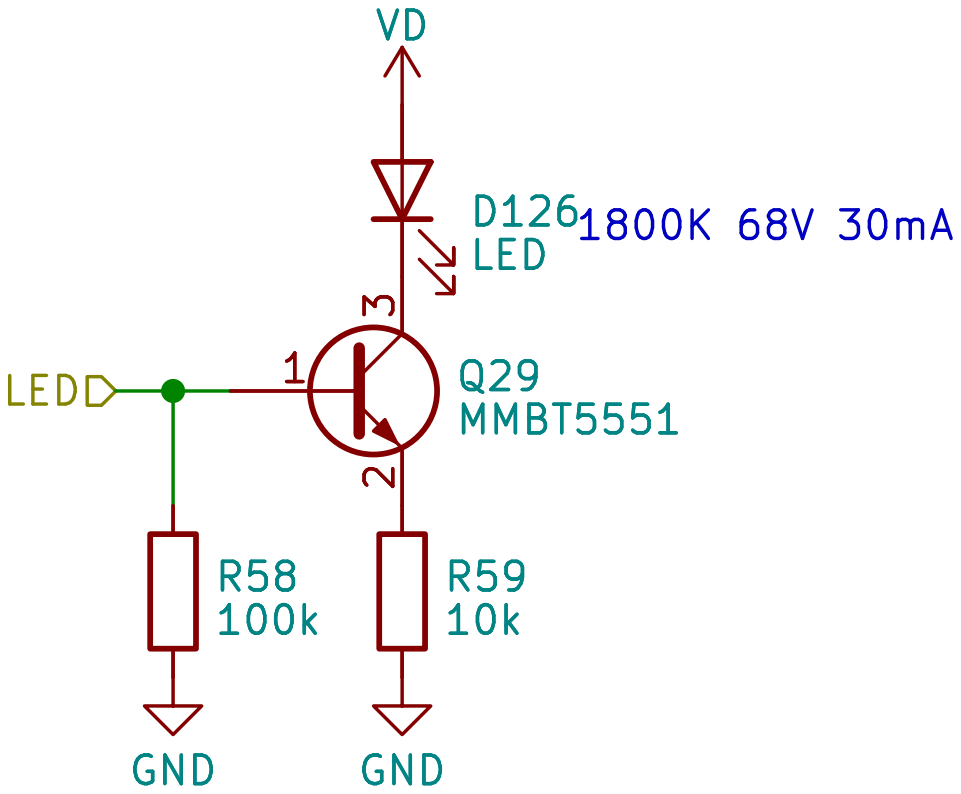
[picture p95: page 37]

Id: 37/106 Title: File: segment.kicad_sch Sheet: /TensSeconds/segmentD/

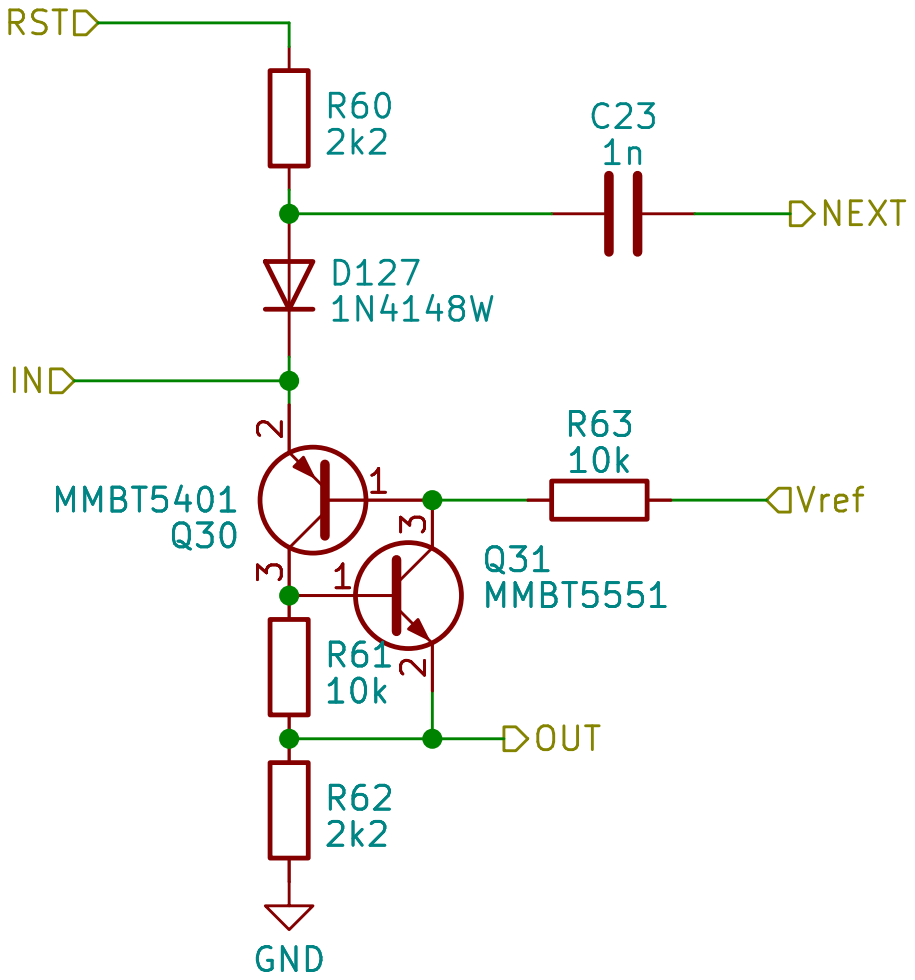
[picture p96: page 38]

Id: 38/106 Title: File: scr_stage.kicad_sch Sheet: /Seconds/10counter/SCR_stage3/ R62

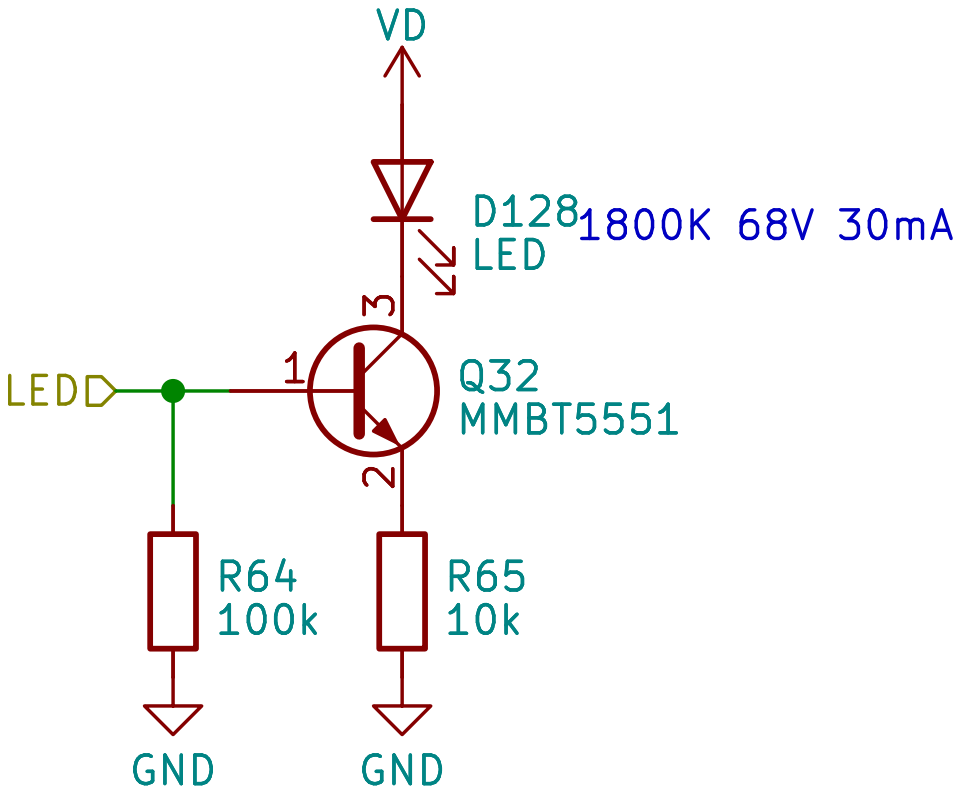
[picture p97: page 39]

Id: 39/106 Title: File: segment.kicad_sch Sheet: /TensSeconds/segmentF/

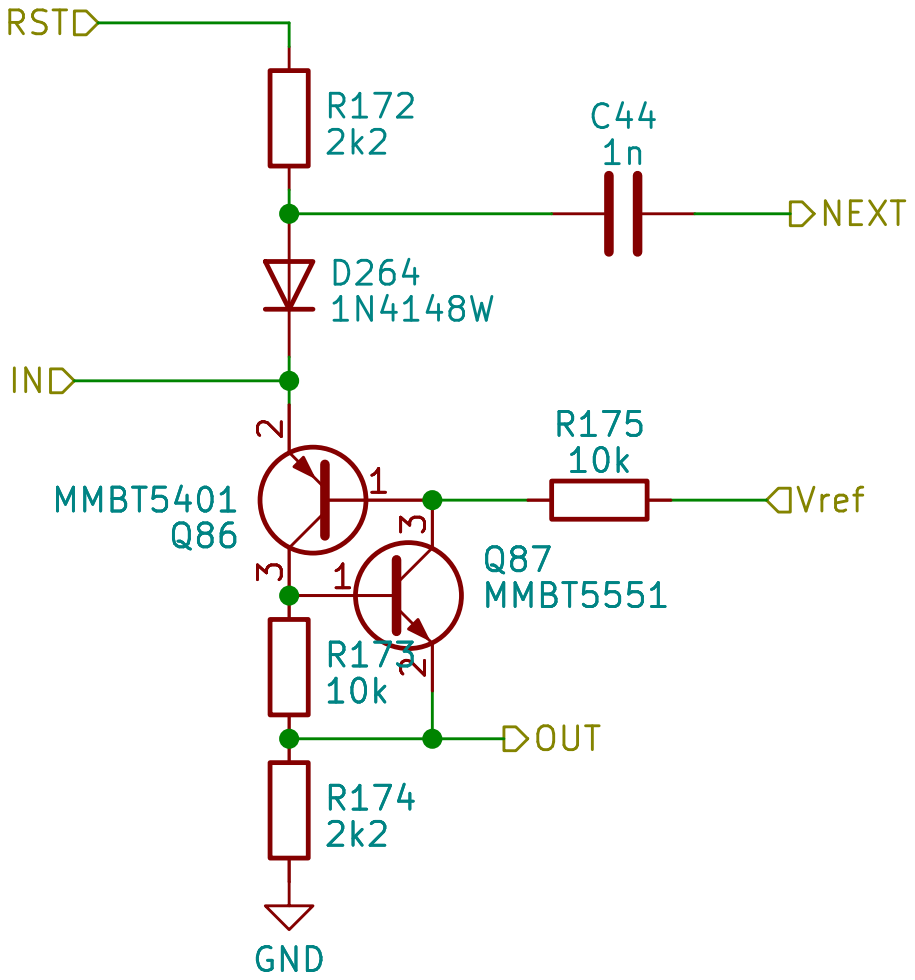
[picture p98: page 40]

Id: 40/106 Title: File: scr_stage.kicad_sch Sheet: /Hours/SCR_stage6/ R174
2k2 GND

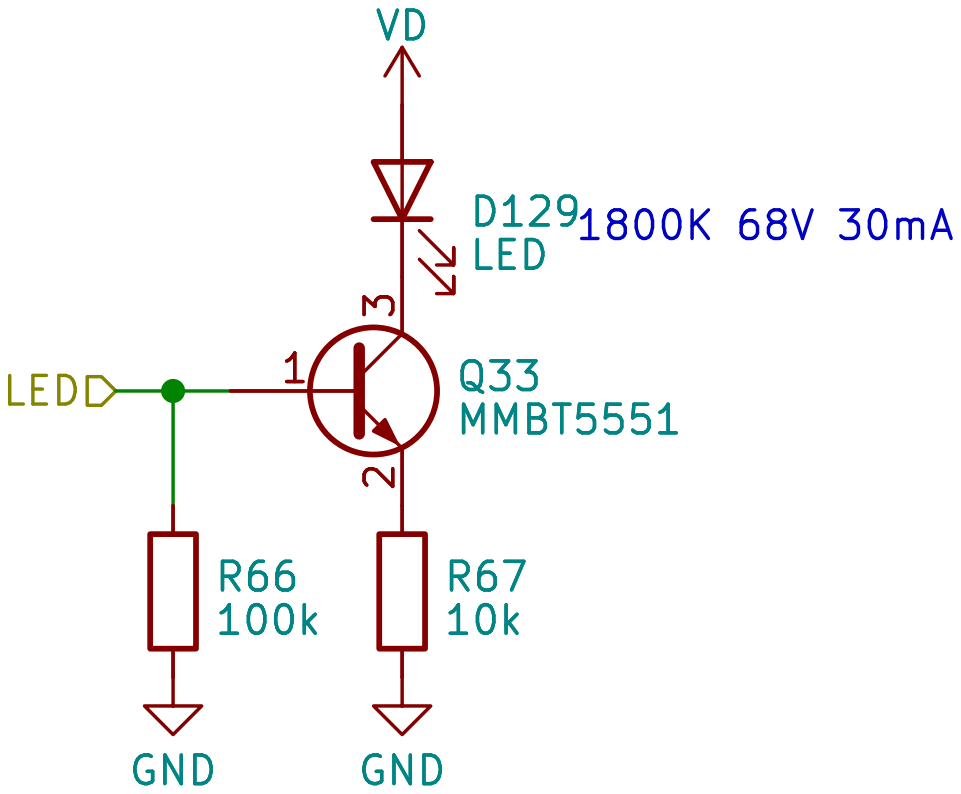
[picture p99: page 41]

Id: 41/106 Title: File: segment.kicad_sch Sheet: /TensSeconds/segmentB/

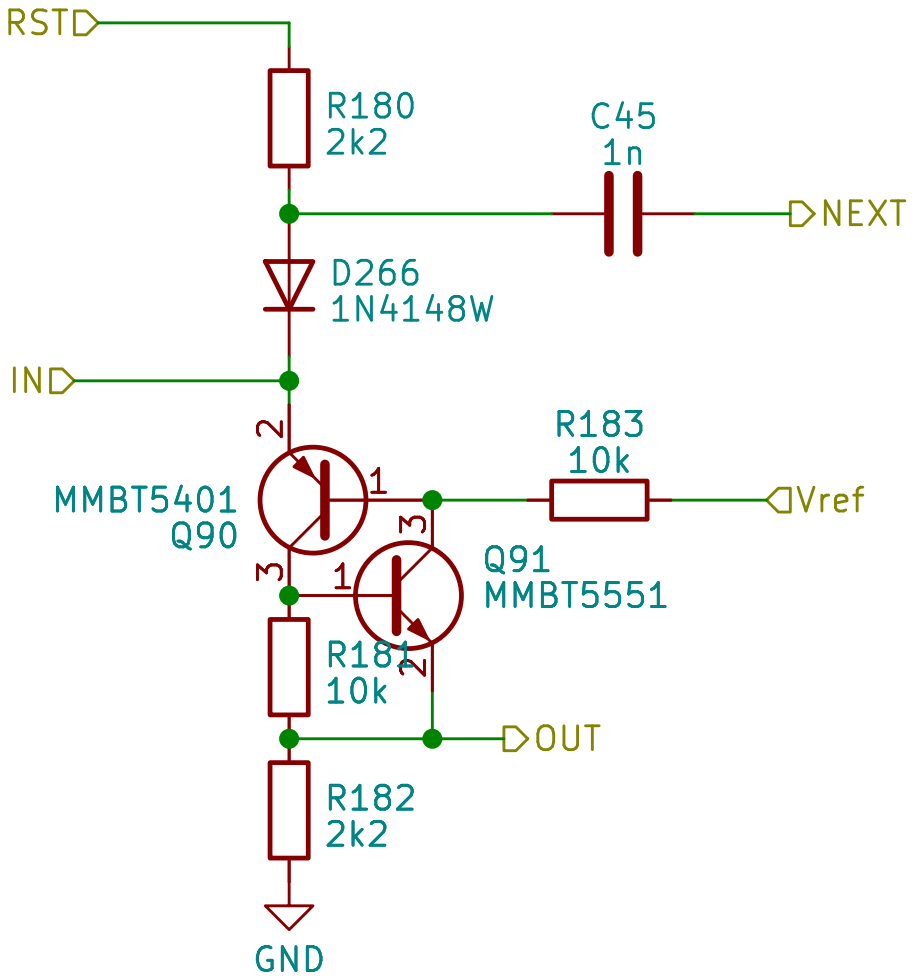
[picture p100: page 42]

Id: 42/106 Title: File: scr_stage.kicad_sch Sheet: /Hours/SCR_stage9/ R182

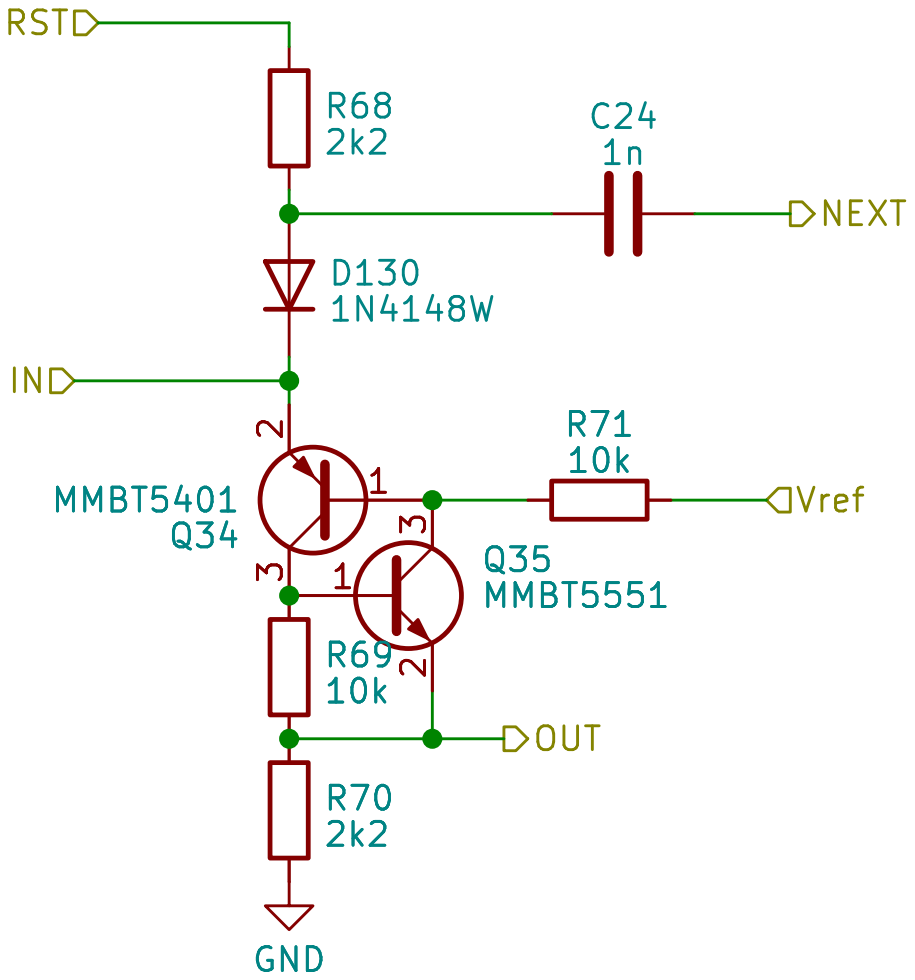
[picture p101: page 43]

Id: 43/106 Title: File: scr_stage.kicad_sch Sheet: /Minutes/10counter/SCR_stage3/ R70

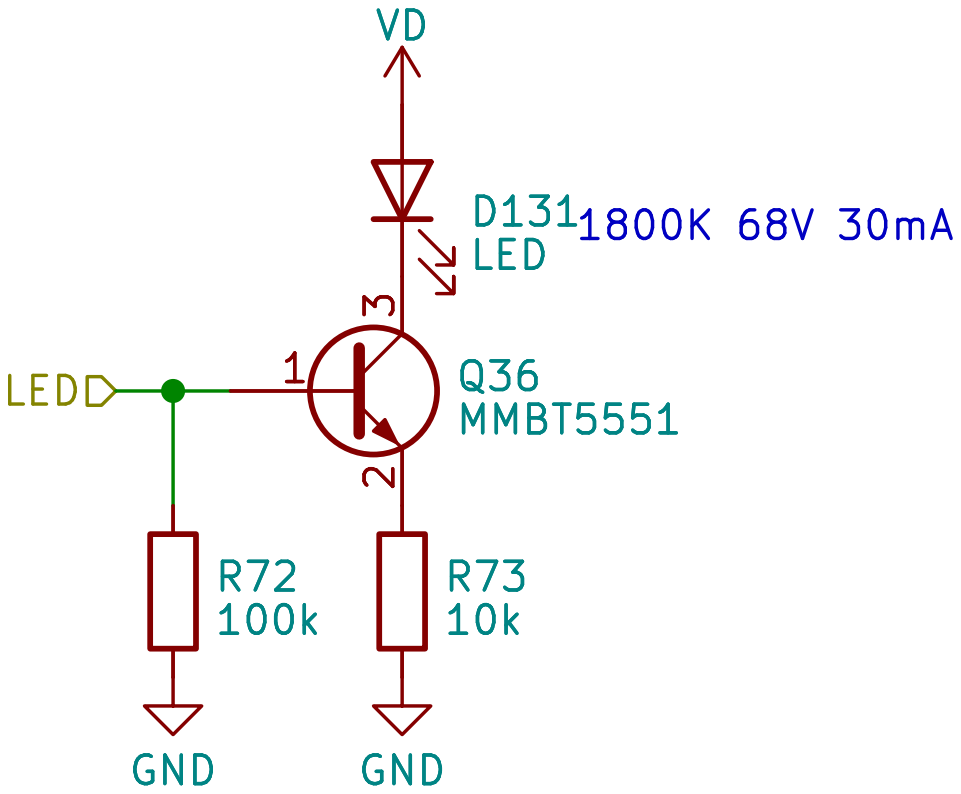
[picture p102: page 44]

Id: 44/106 Title: File: segment.kicad_sch Sheet: /TensMinutes/segmentC/

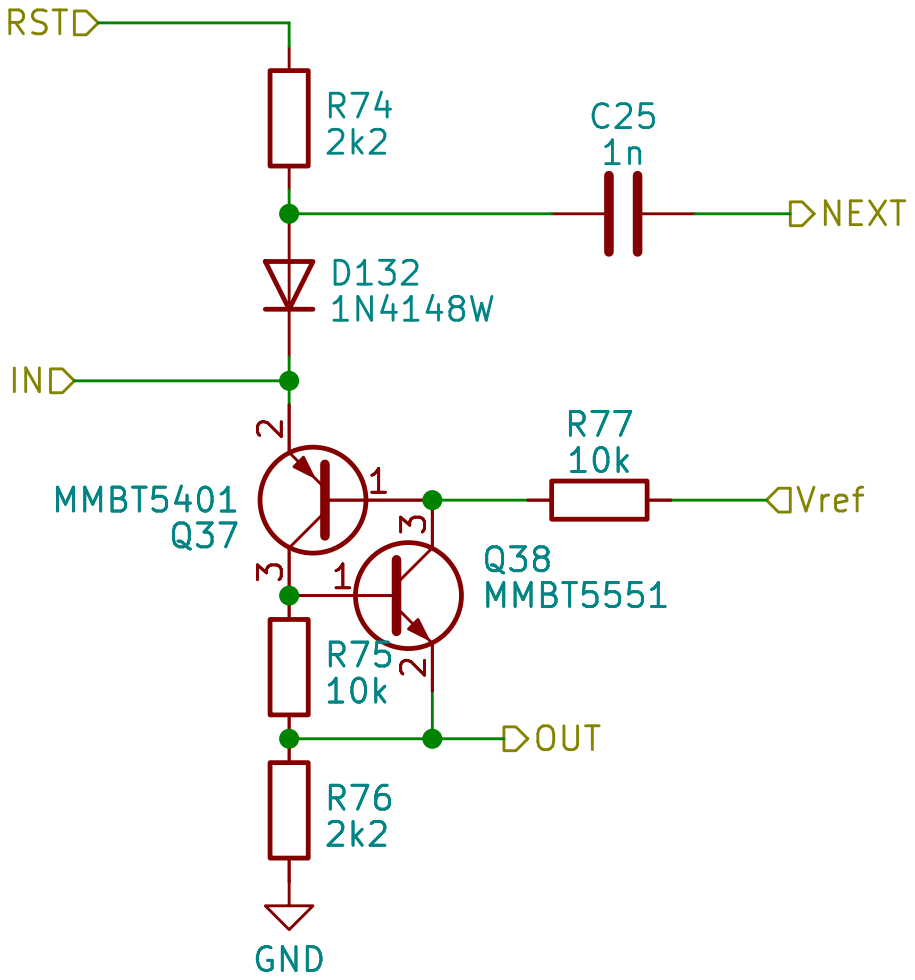
[picture p103: page 45]

Id: 45/106 Title: File: scr_stage.kicad_sch Sheet: /Minutes/10counter/SCR_stage2/ R76
2k2 GND

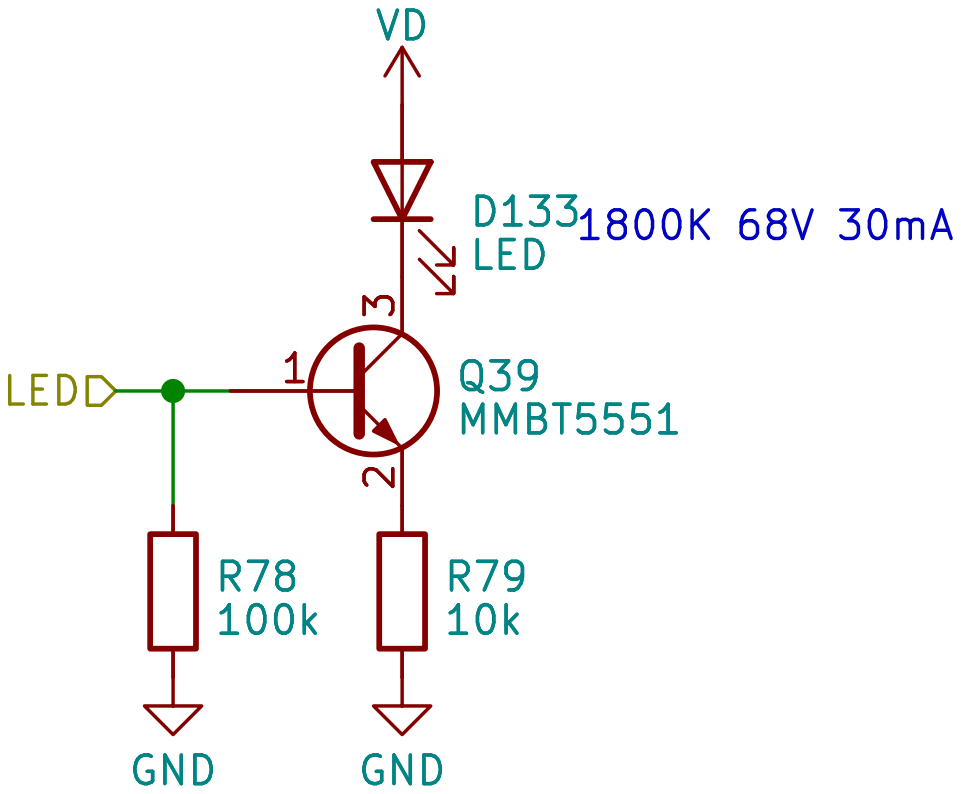
[picture p104: page 46]

Id: 46/106 Title: File: segment.kicad_sch Sheet: /TensMinutes/segmentA/

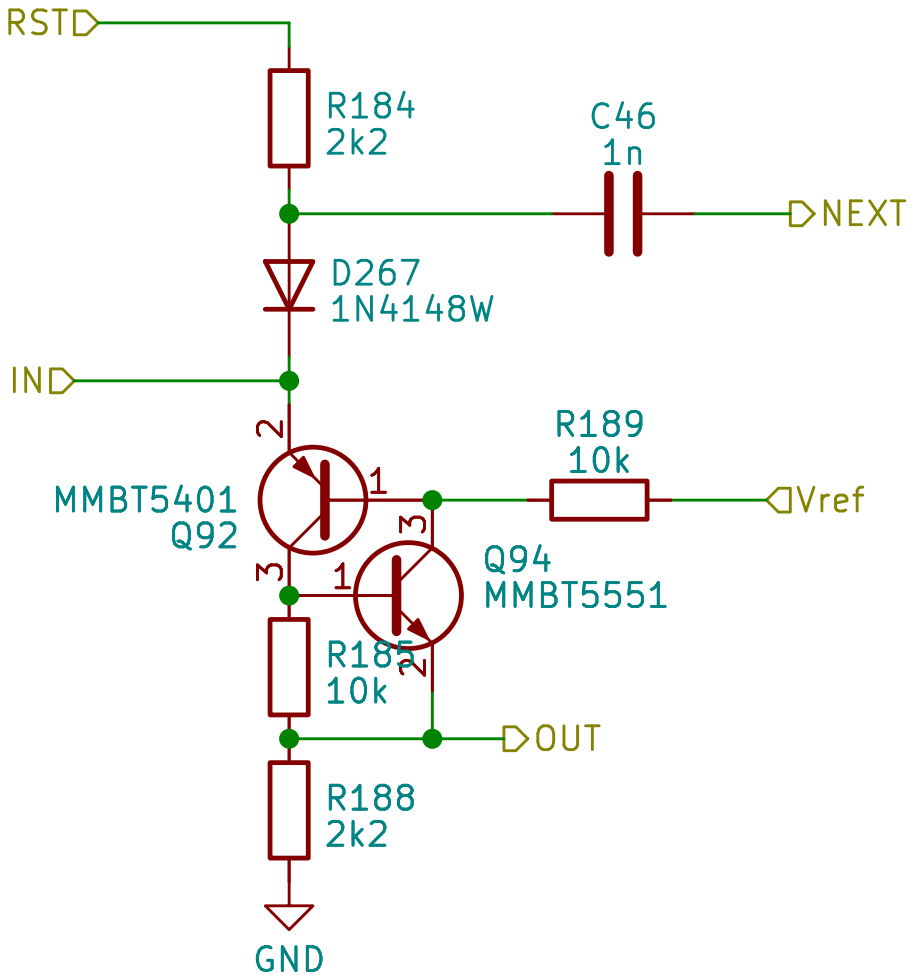
[picture p105: page 47]

Id: 47/106 Title: File: scr_stage.kicad_sch Sheet: /Hours/SCR_stage7/ R188

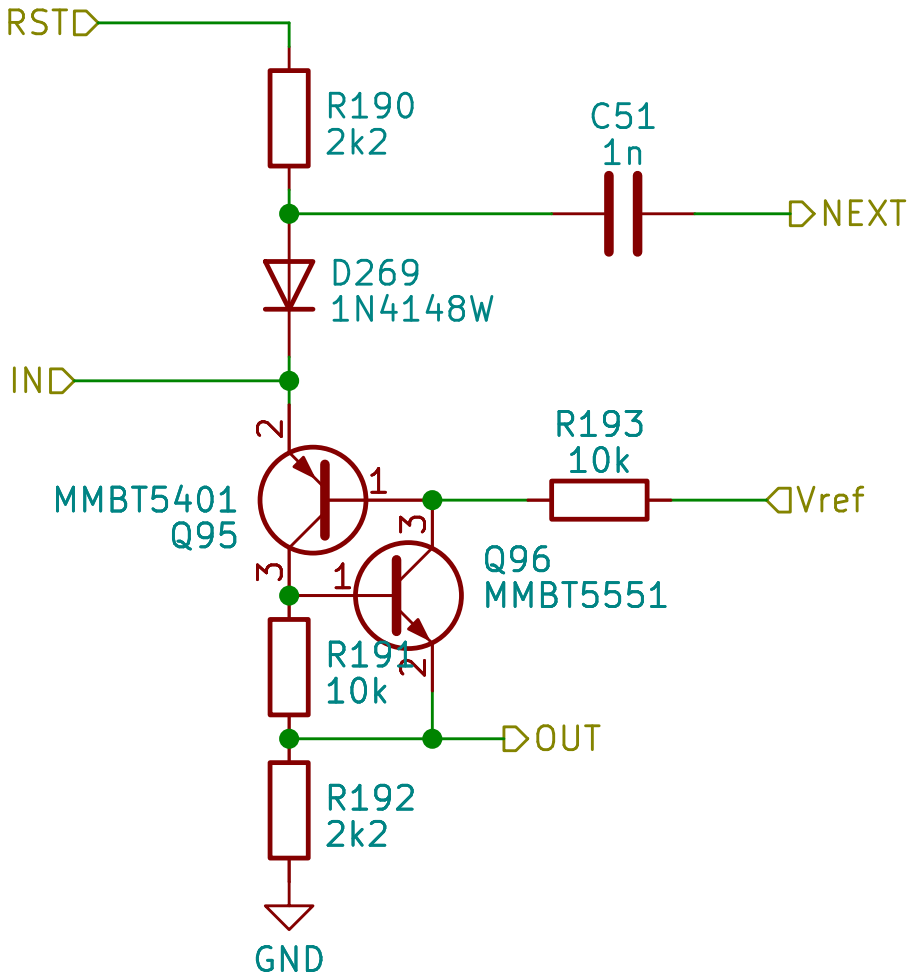
[picture p106: page 48]

Id: 48/106 Title: File: scr_stage.kicad_sch Sheet: /Hours/SCR_stage8/ R192

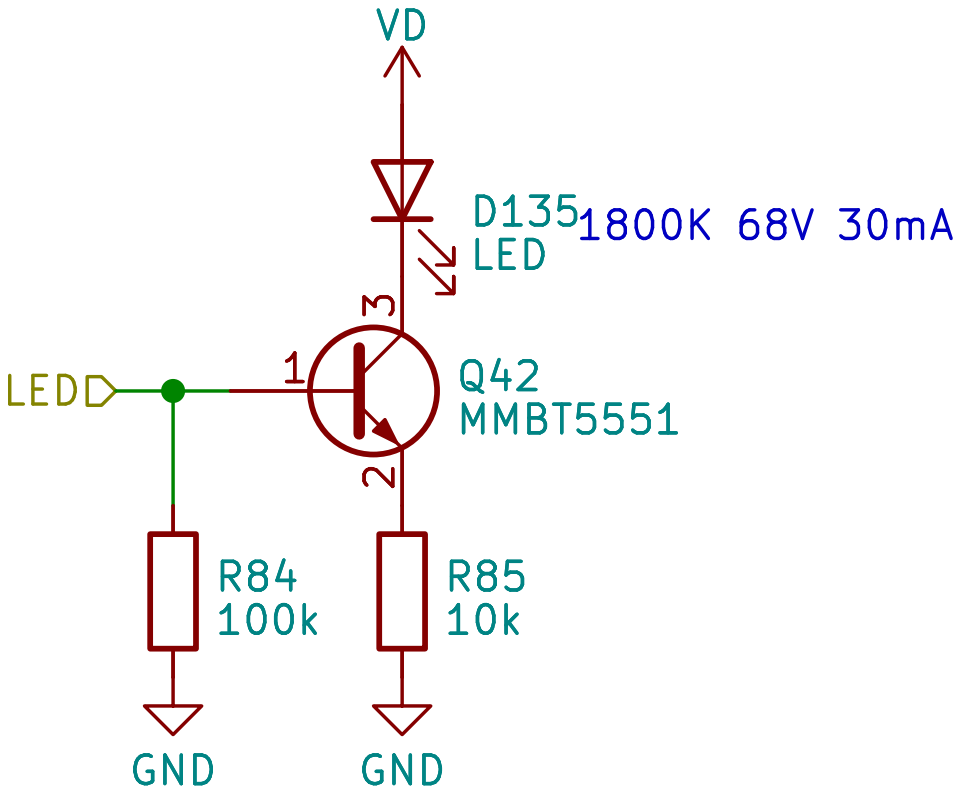
[picture p107: page 49]

Id: 49/106 Title: File: segment.kicad_sch Sheet: /TensMinutes/segmentG/

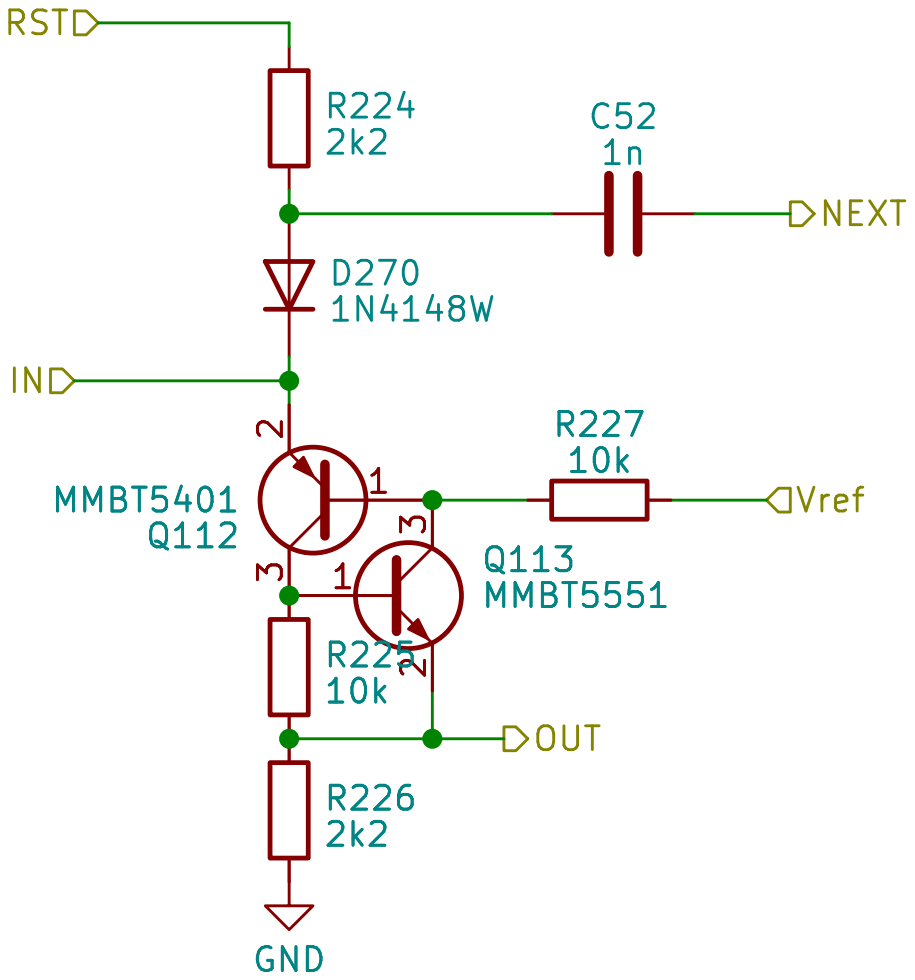
[picture p108: page 50]

Id: 50/106 Title: File: scr_stage.kicad_sch Sheet: /Hours/SCR_stage11/ R226
2k2 GND

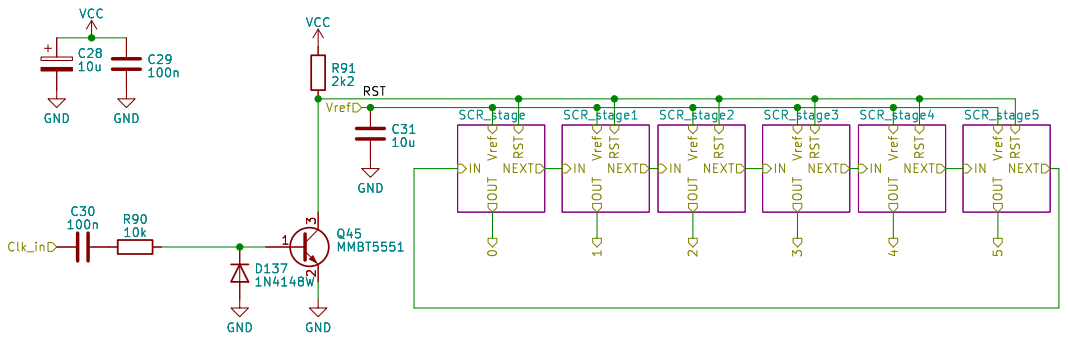
[picture p109: page 51]

Id: 51/106 Title: File: 6counter.kicad_sch Sheet: /TensMinutes/6counter/

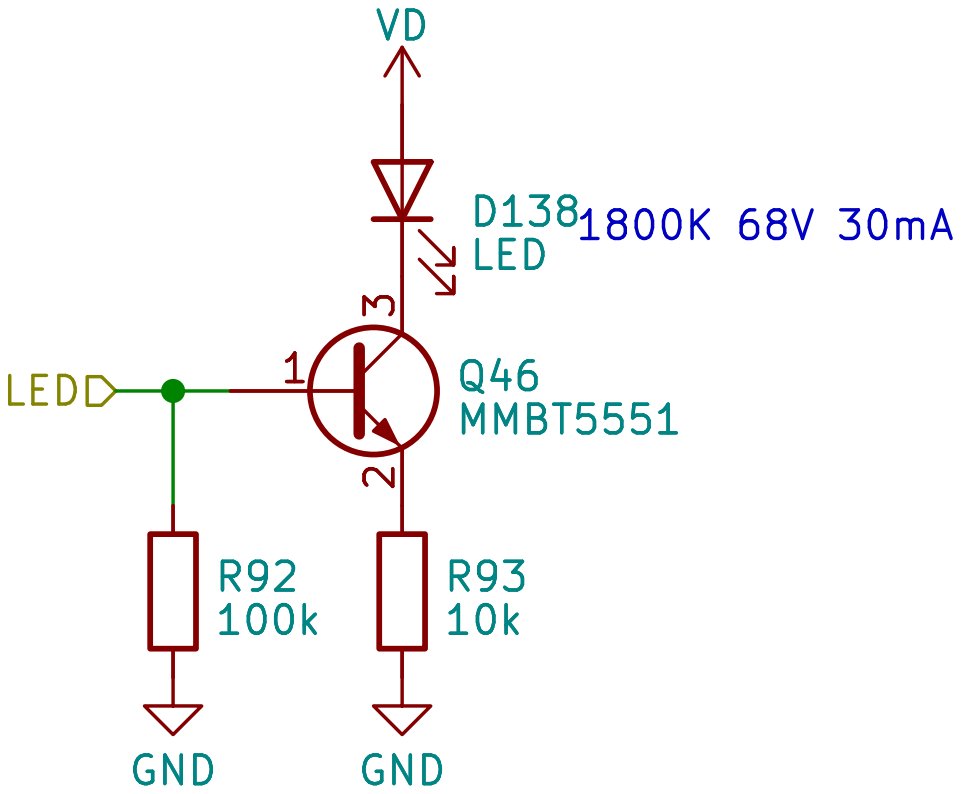
[picture p110: page 52]

Id: 52/106 Title: File: segment.kicad_sch Sheet: /TensMinutes/segmentB/

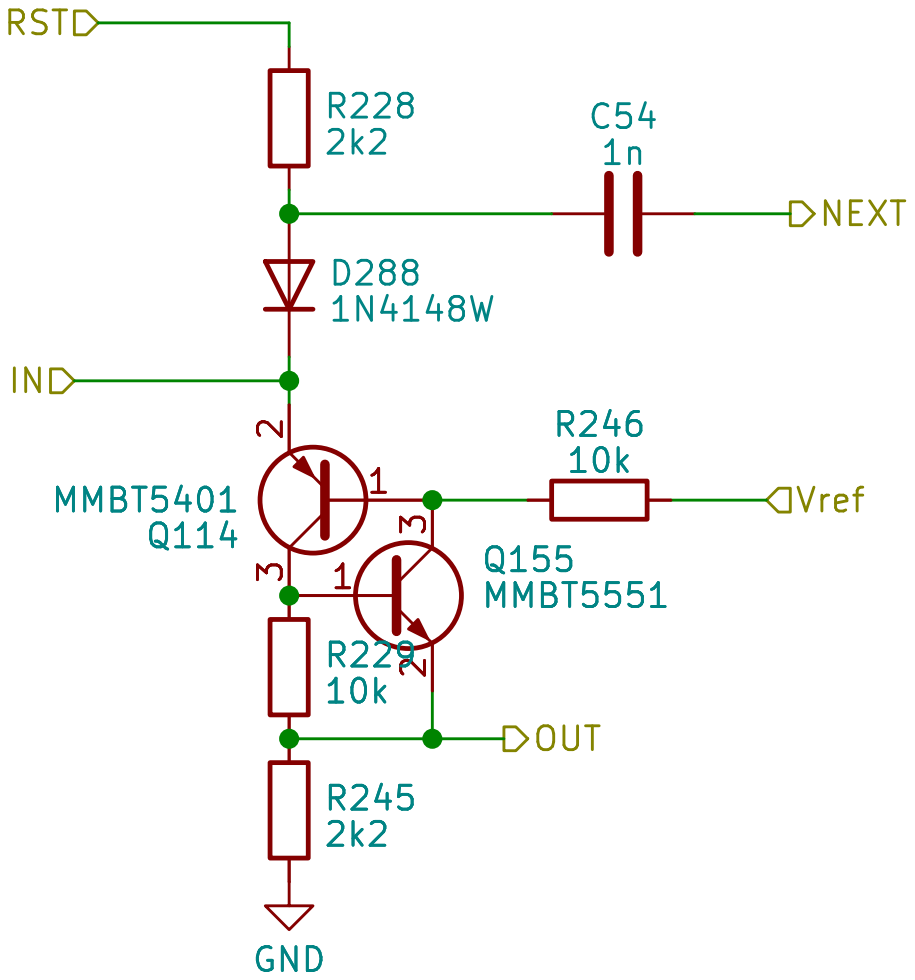
[picture p111: page 53]

Id: 53/106 Title: File: scr_stage.kicad_sch Sheet: /Hours/SCR_stage10/ R245

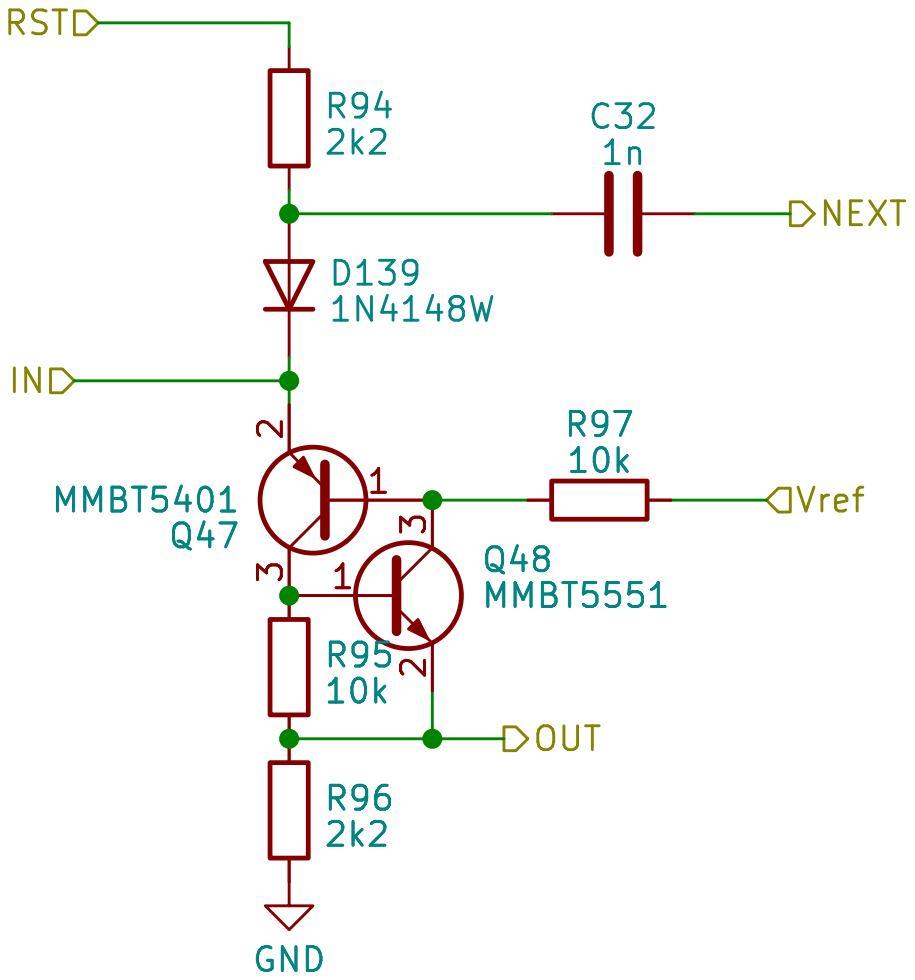
[picture p112: page 54]

Id: 54/106 Title: File: scr_stage.kicad_sch Sheet: /Seconds/10counter/SCR_stage4/ R96

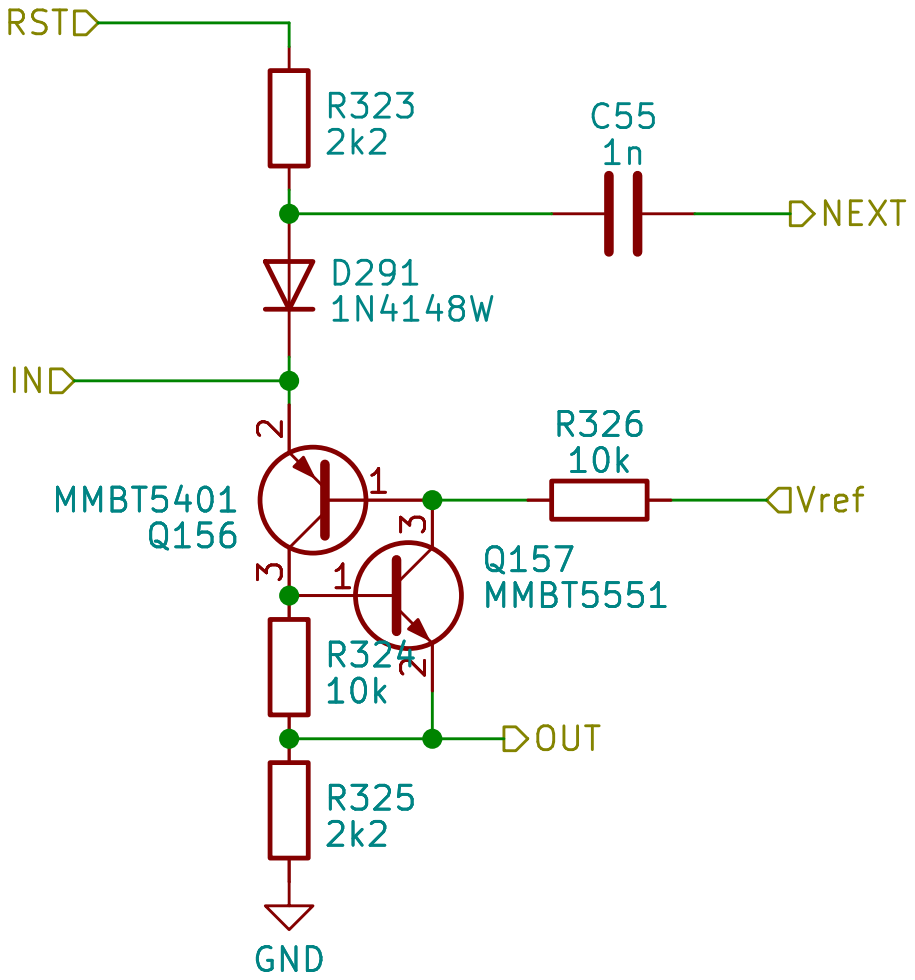
[picture p113: page 55]

Id: 55/106 Title: File: scr_stage.kicad_sch Sheet: /Hours/SCR_stage12/ R325
2k2 GND

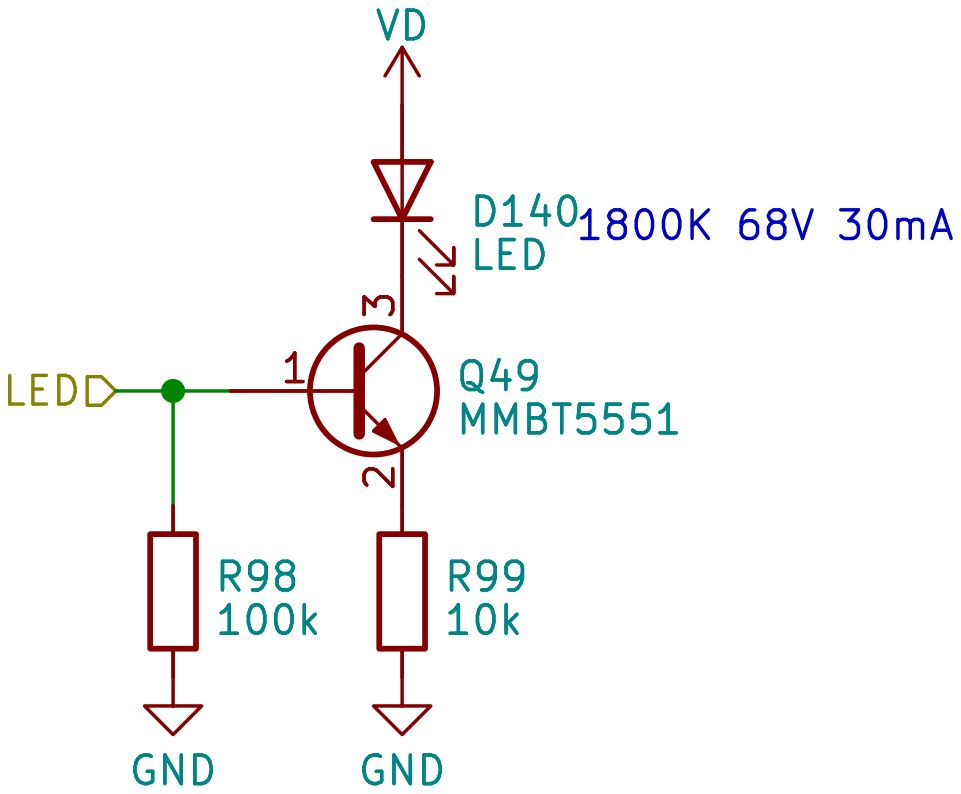
[picture p114: page 56]

Id: 56/106 Title: File: segment.kicad_sch Sheet: /Minutes/segmentC/

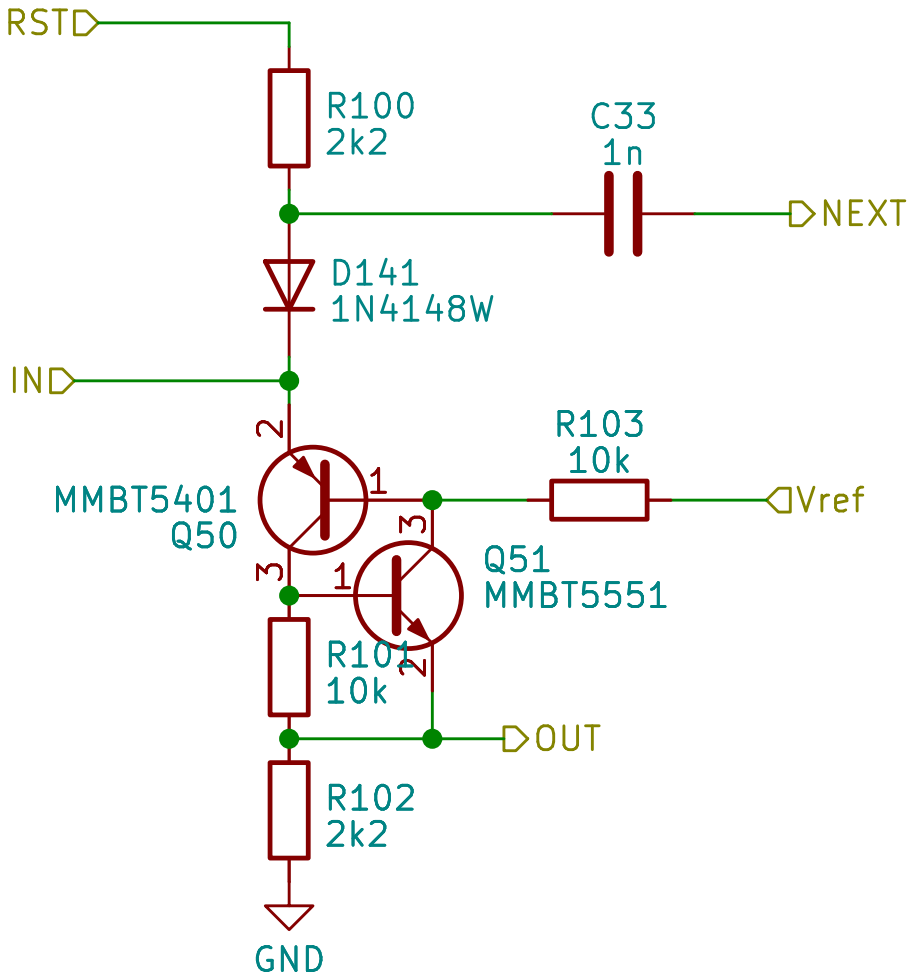
[picture p115: page 57]

Id: 57/106 Title: File: scr_stage.kicad_sch Sheet: /Seconds/10counter/SCR_stage5/ R102

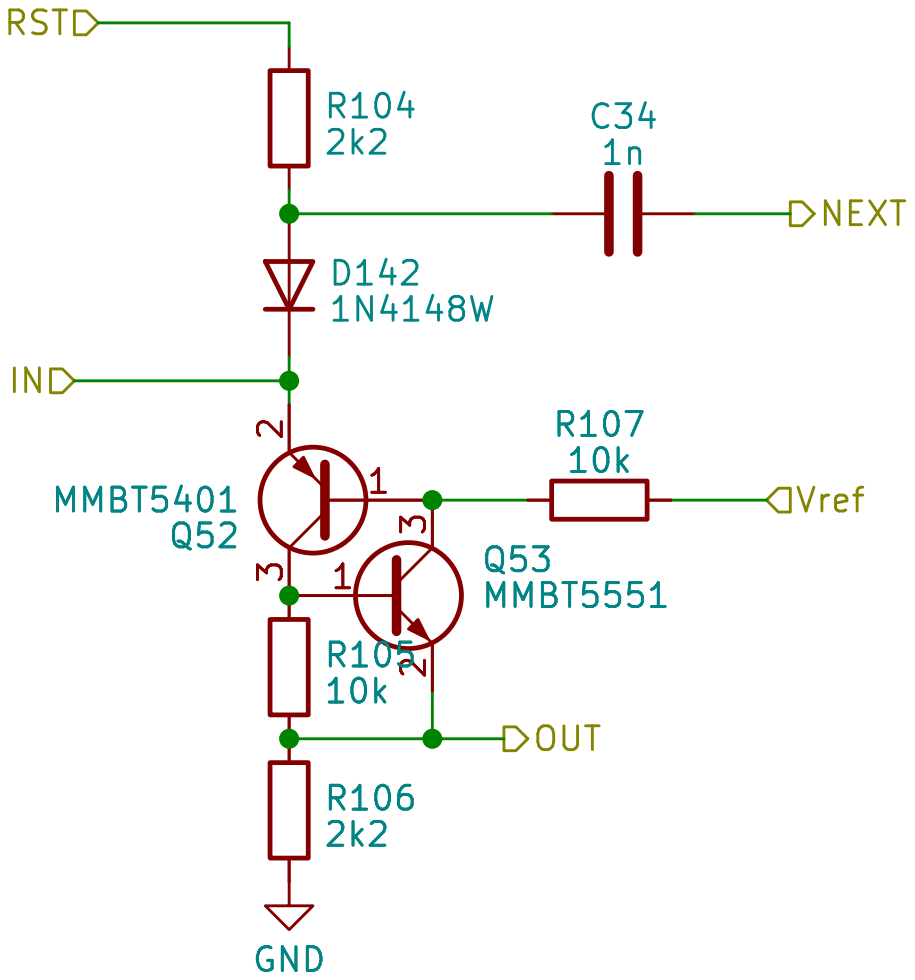
[picture p116: page 58]

Id: 58/106 Title: File: scr_stage.kicad_sch Sheet: /Minutes/10counter/SCR_stage5/ R106

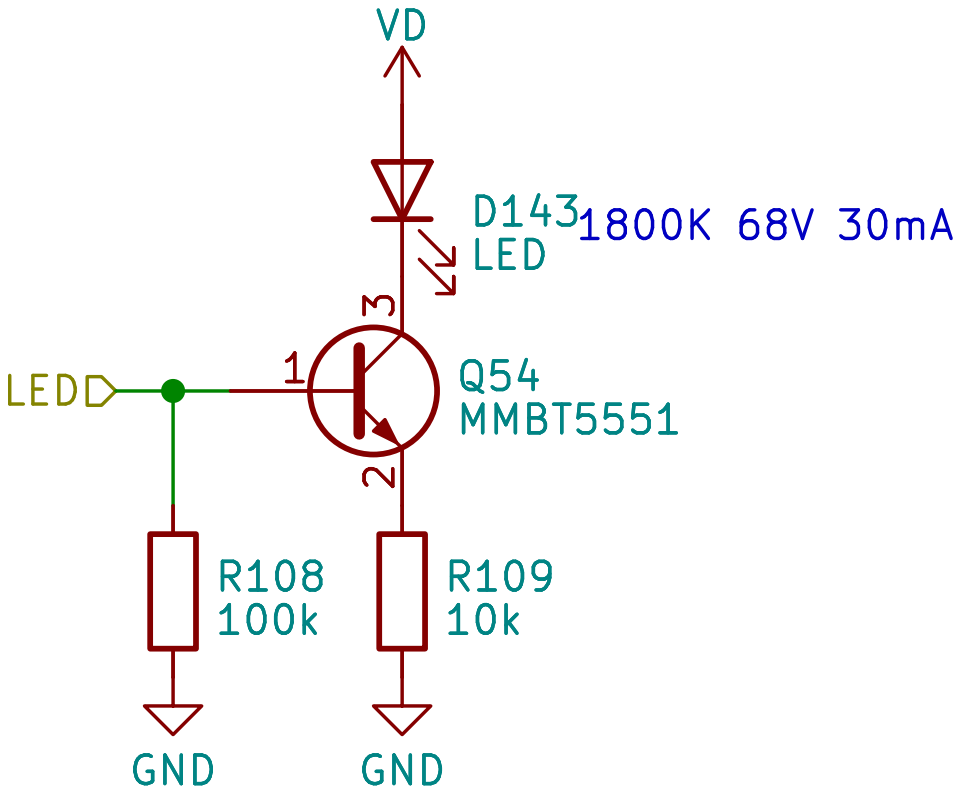
[picture p117: page 59]

Id: 59/106 Title: File: segment.kicad_sch Sheet: /TensMinutes/segmentF/

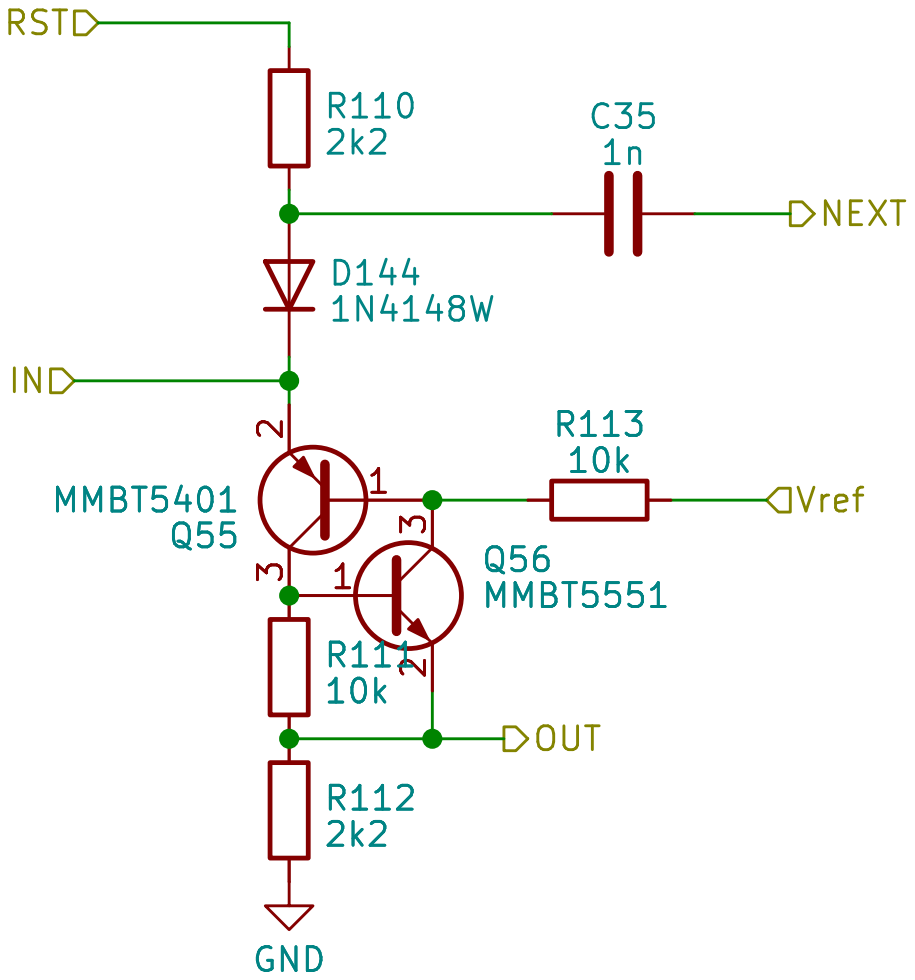
[picture p118: page 60]

Id: 60/106 Title: File: scr_stage.kicad_sch Sheet: /Minutes/10counter/SCR_stage4/ R112
2k2 GND

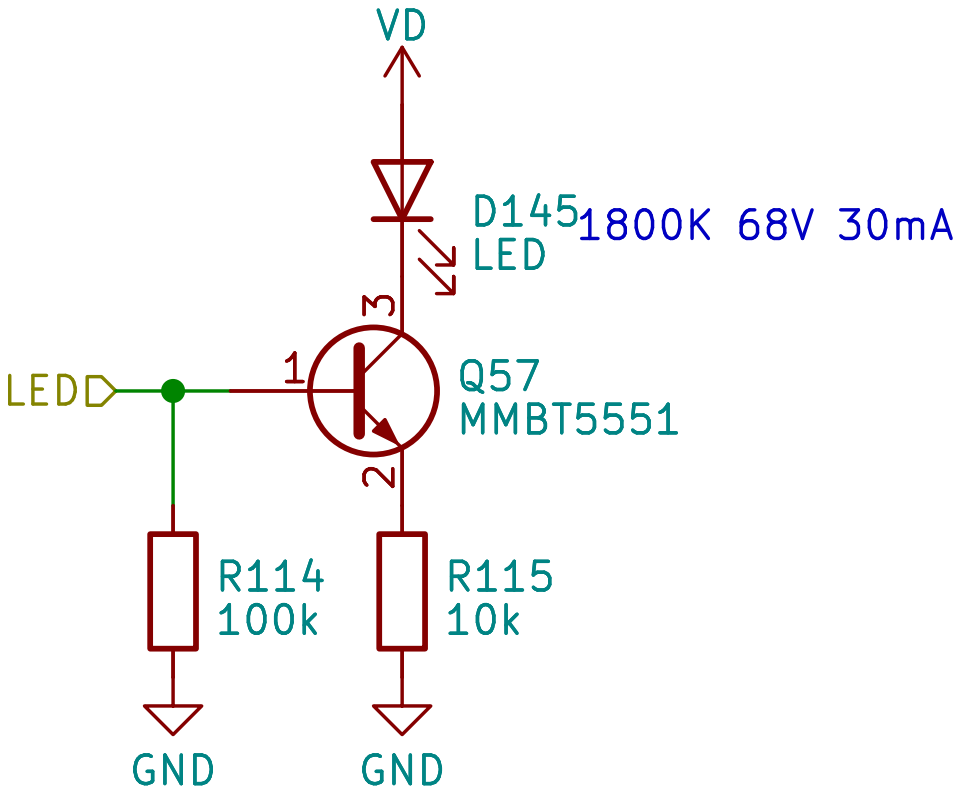
[picture p119: page 61]

Id: 61/106 Title: File: segment.kicad_sch Sheet: /Minutes/segmentG/

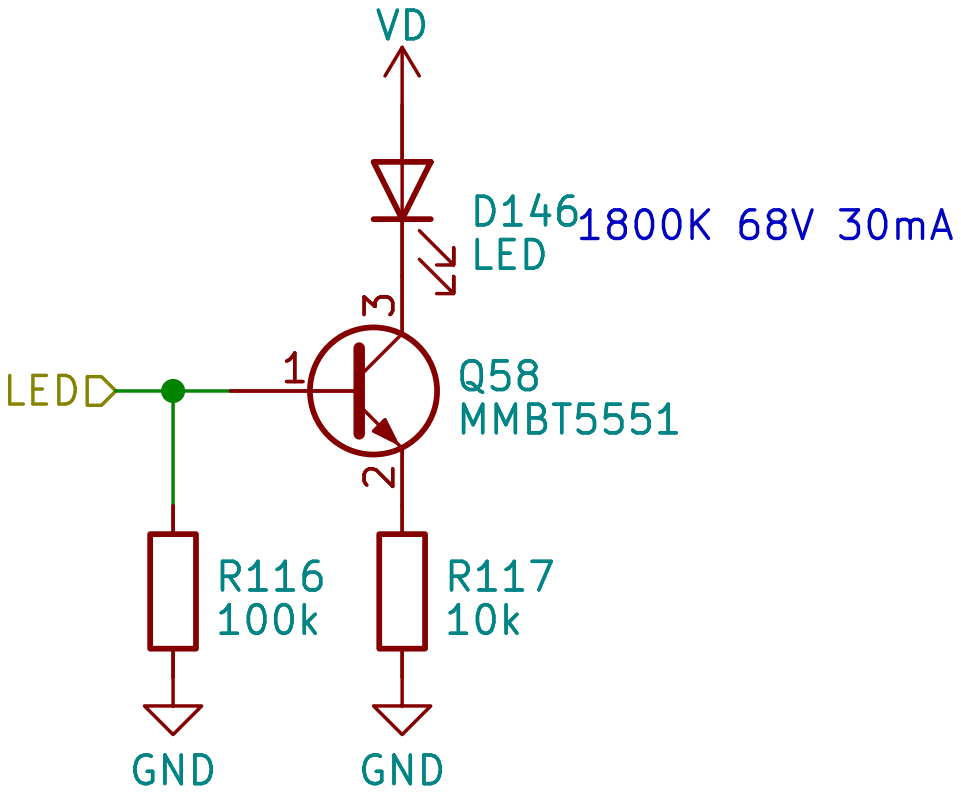
[picture p120: page 62]

Id: 62/106 Title: File: segment.kicad_sch Sheet: /Minutes/segmentD/

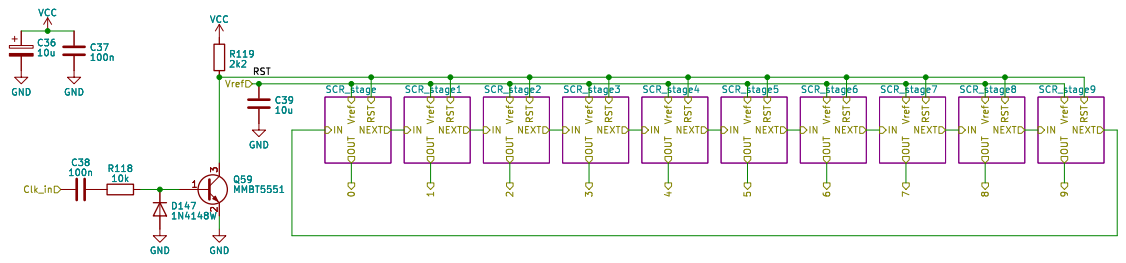
[picture p121: page 63]

2 3 GND GND GND GND GND

Id: 63/106 Title: File: 10counter.kicad_sch Sheet: /Minutes/10counter/

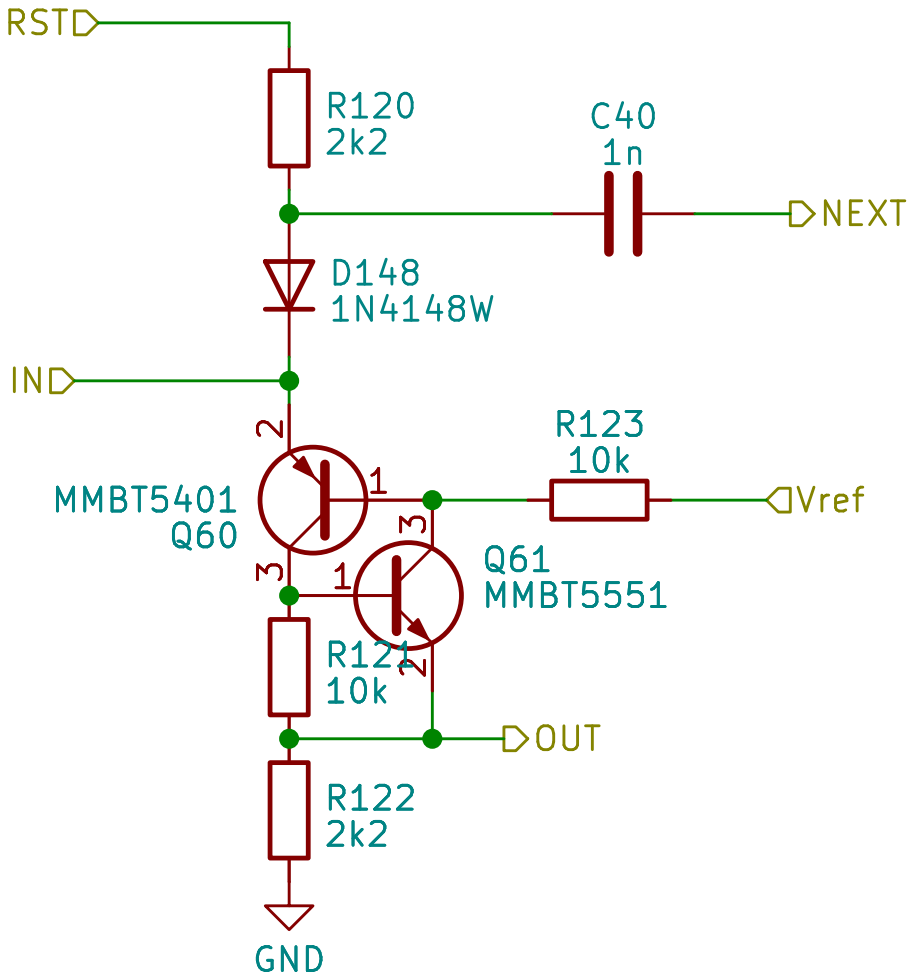
[picture p122: page 64]

Id: 64/106 Title: File: scr_stage.kicad_sch Sheet: /Minutes/10counter/SCR_stage/ R122

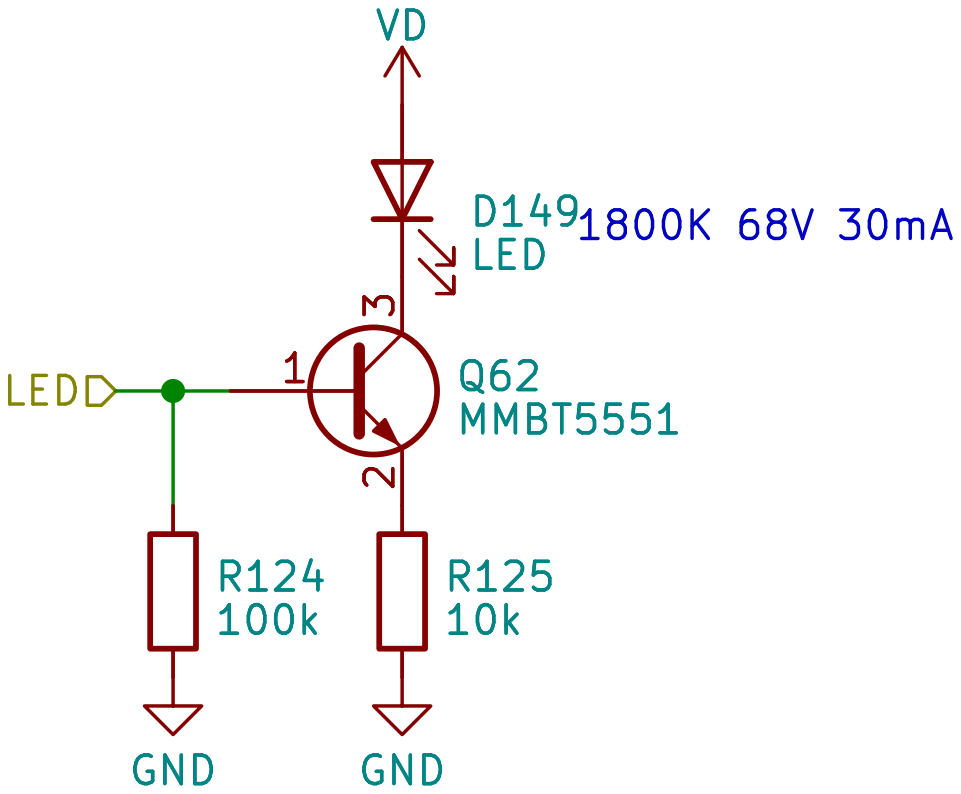
[picture p123: page 65]

Id: 65/106 Title: File: segment.kicad_sch Sheet: /Minutes/segmentE/

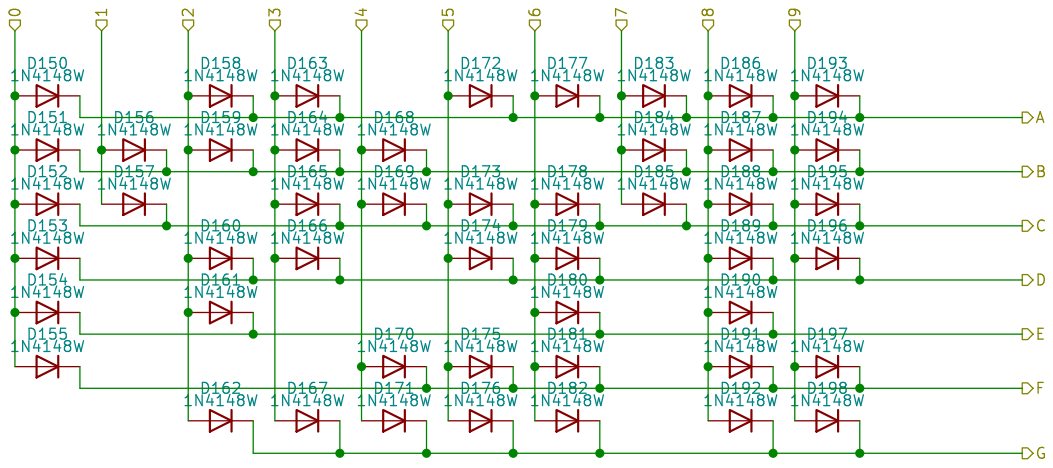
[picture p124: page 66]

Id: 66/106 Title: File: 10decoder.kicad_sch Sheet: /Minutes/10Decoder/

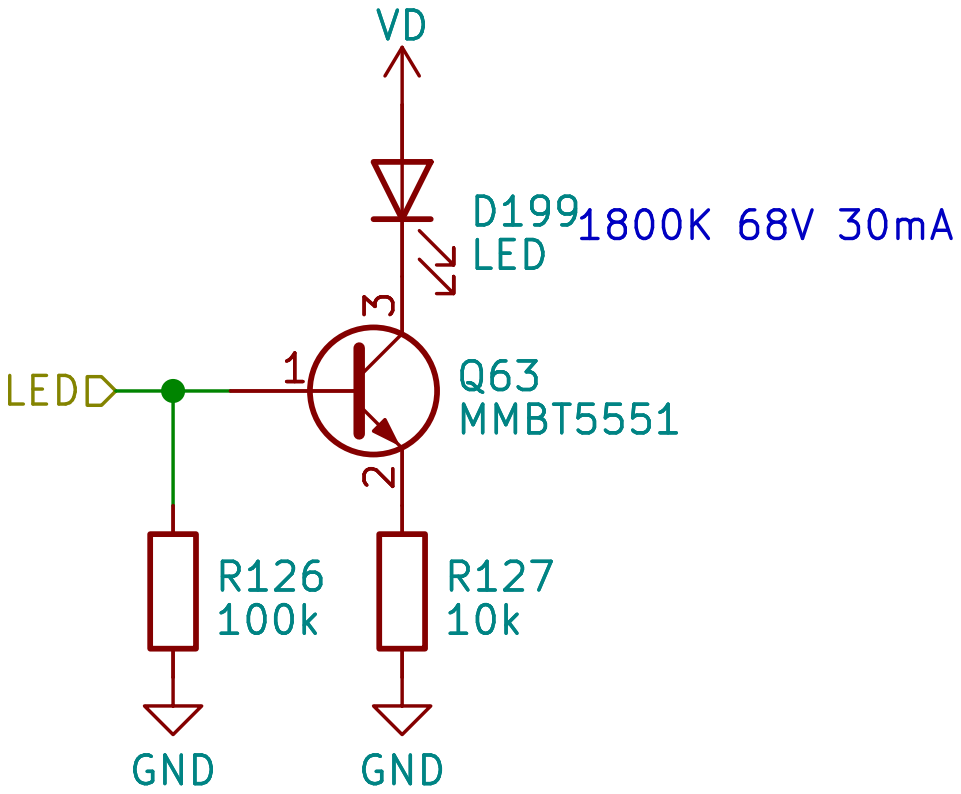
[picture p125: page 67]

Id: 67/106 Title: File: segment.kicad_sch Sheet: /Minutes/segmentF/

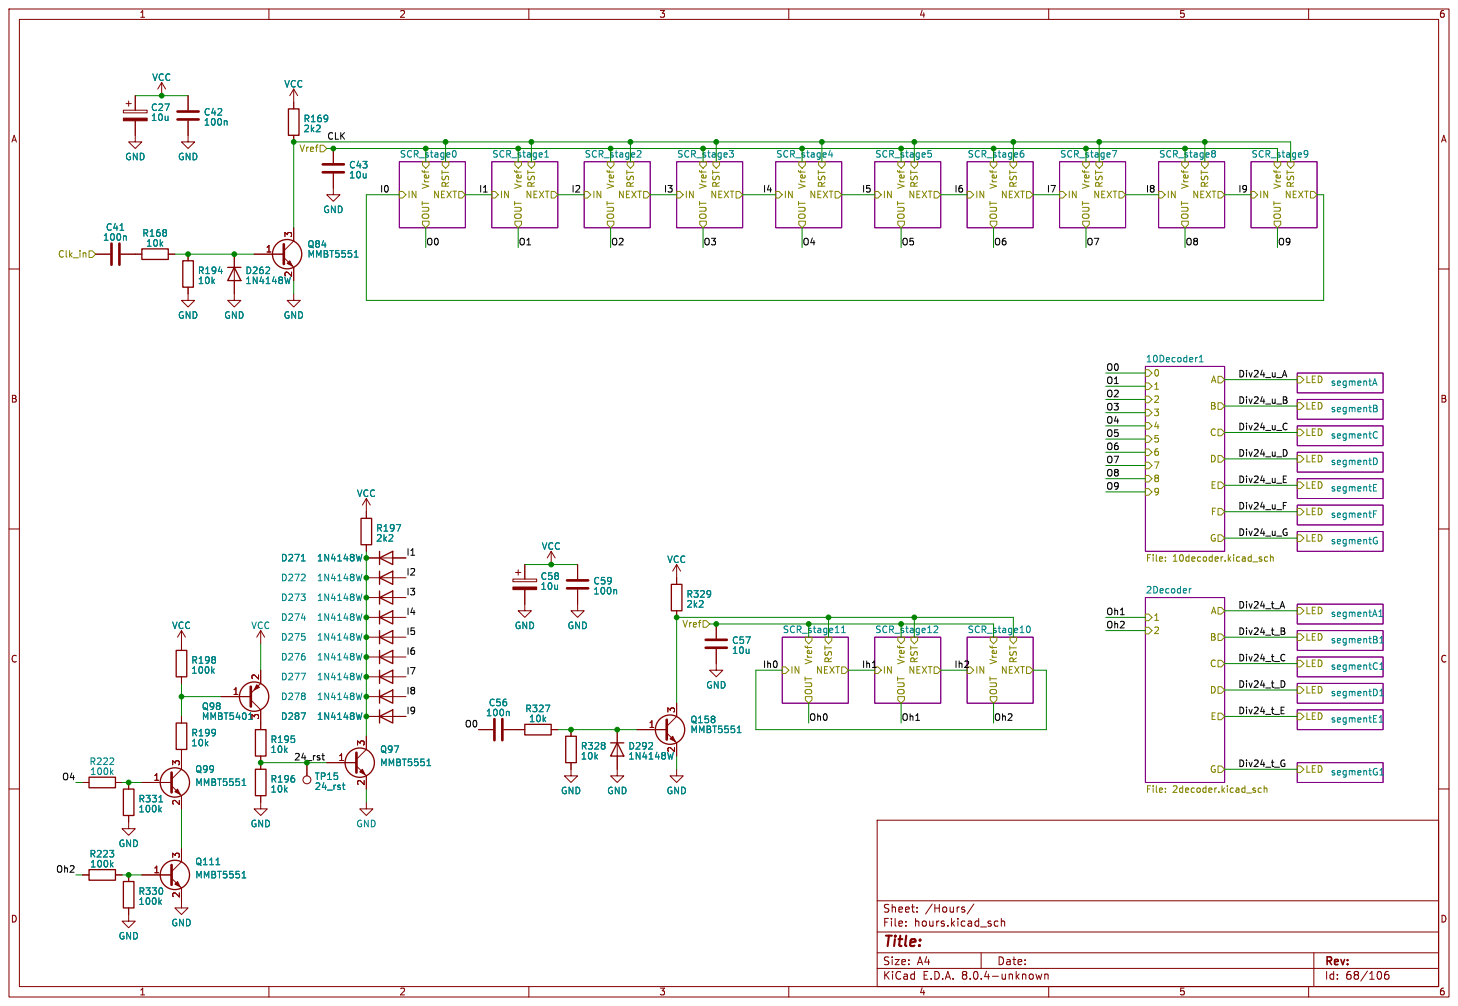
[picture p126: page 68]

Id: 68/106 Title: File: hours.kicad_sch Sheet: /Hours/

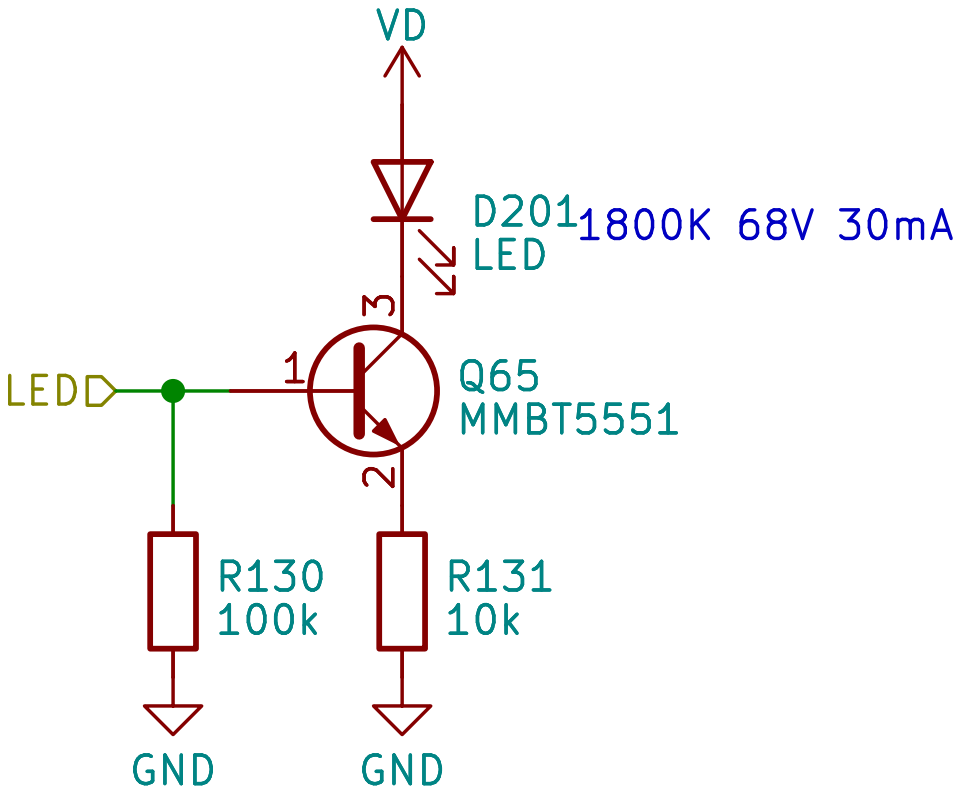
[picture p127: page 69]

Id: 70/106 Title: File: segment.kicad_sch Sheet: /Hours/segmentE/

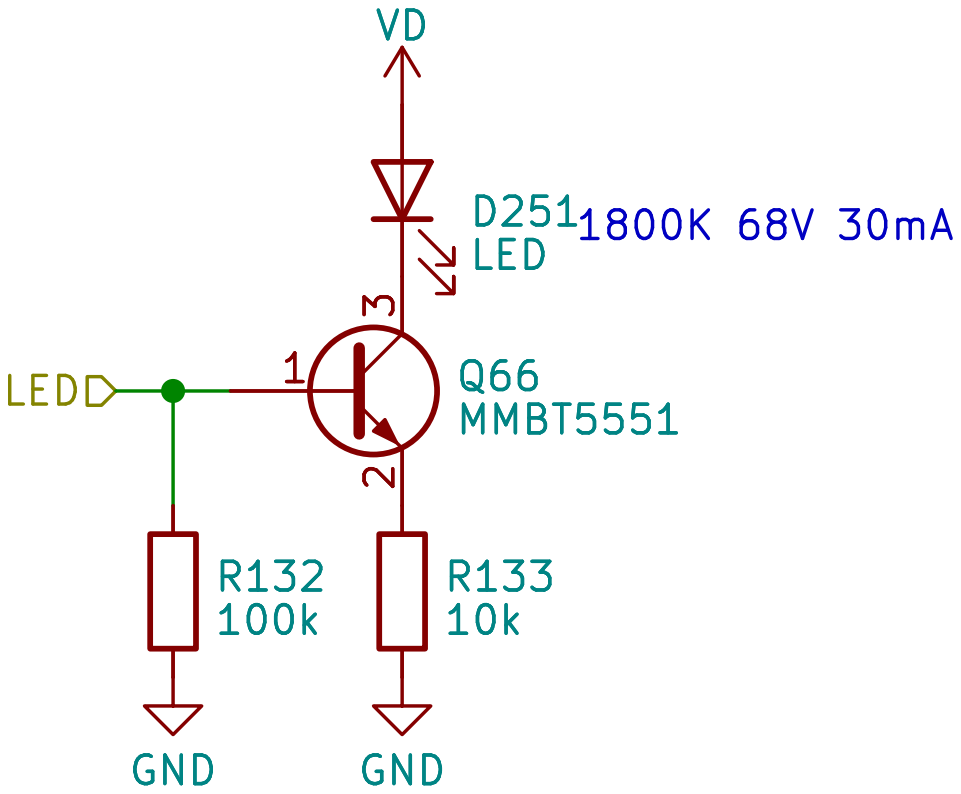
[picture p128: page 70]

Id: 72/106 Title: File: segment.kicad_sch Sheet: /Hours/segmentC/

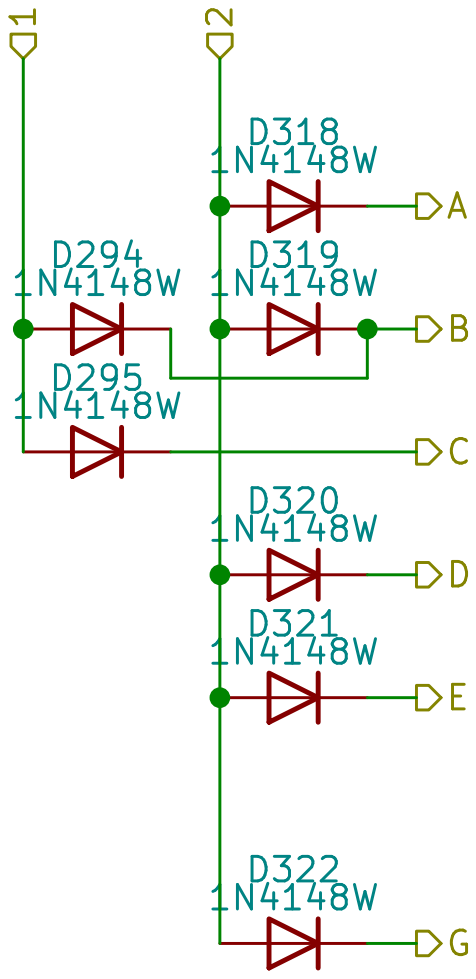
[picture p129: page 71]

Id: 73/106 Title: File: 2decoder.kicad_sch Sheet: /Hours/2Decoder/

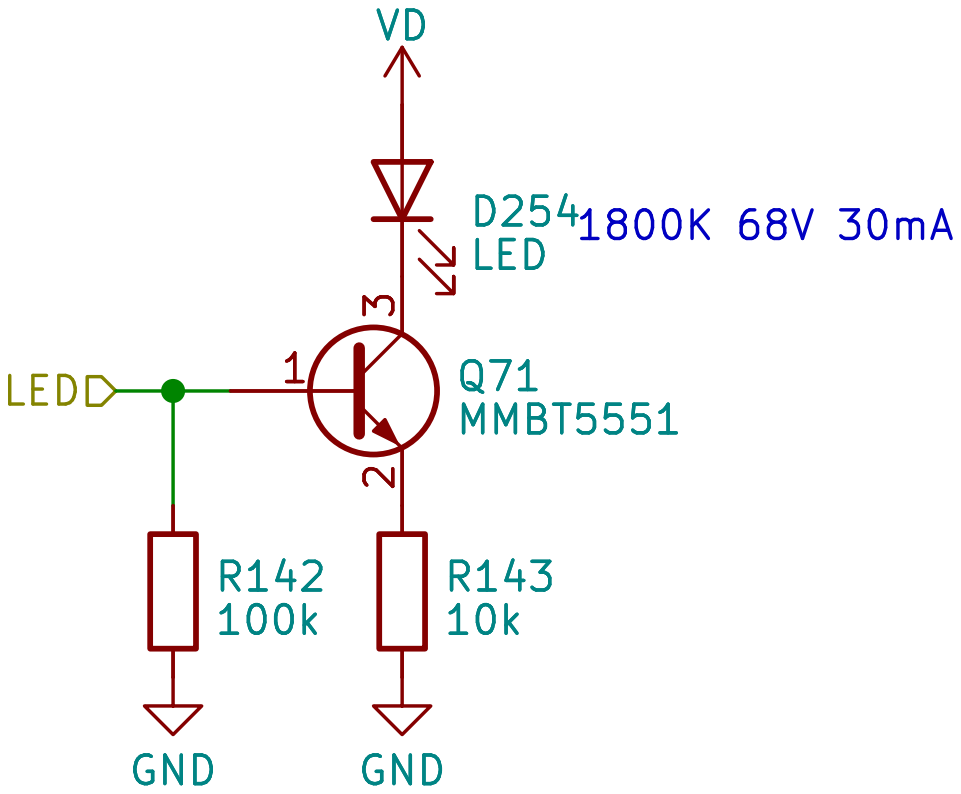
[picture p130: page 72]

Id: 75/106 Title: File: segment.kicad_sch Sheet: /Hours/segmentD/

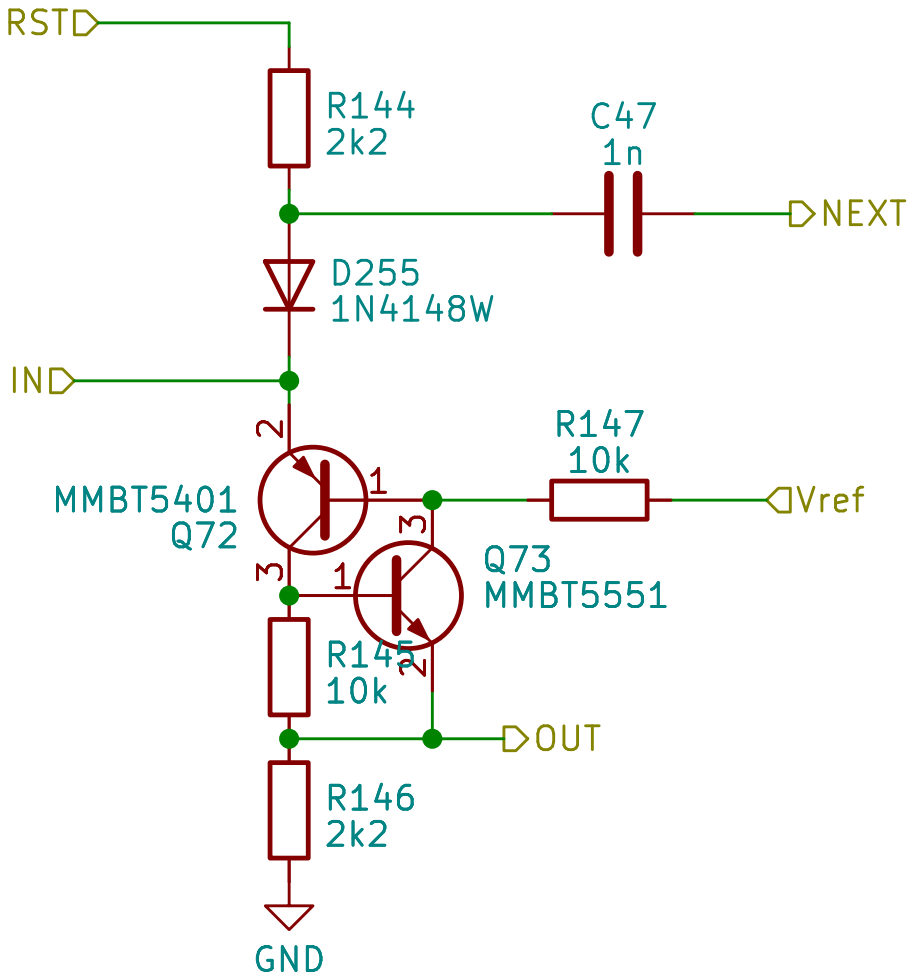
[picture p131: page 73]

Id: 76/106 Title: File: scr_stage.kicad_sch Sheet: /Seconds/10counter/SCR_stage6/ R146

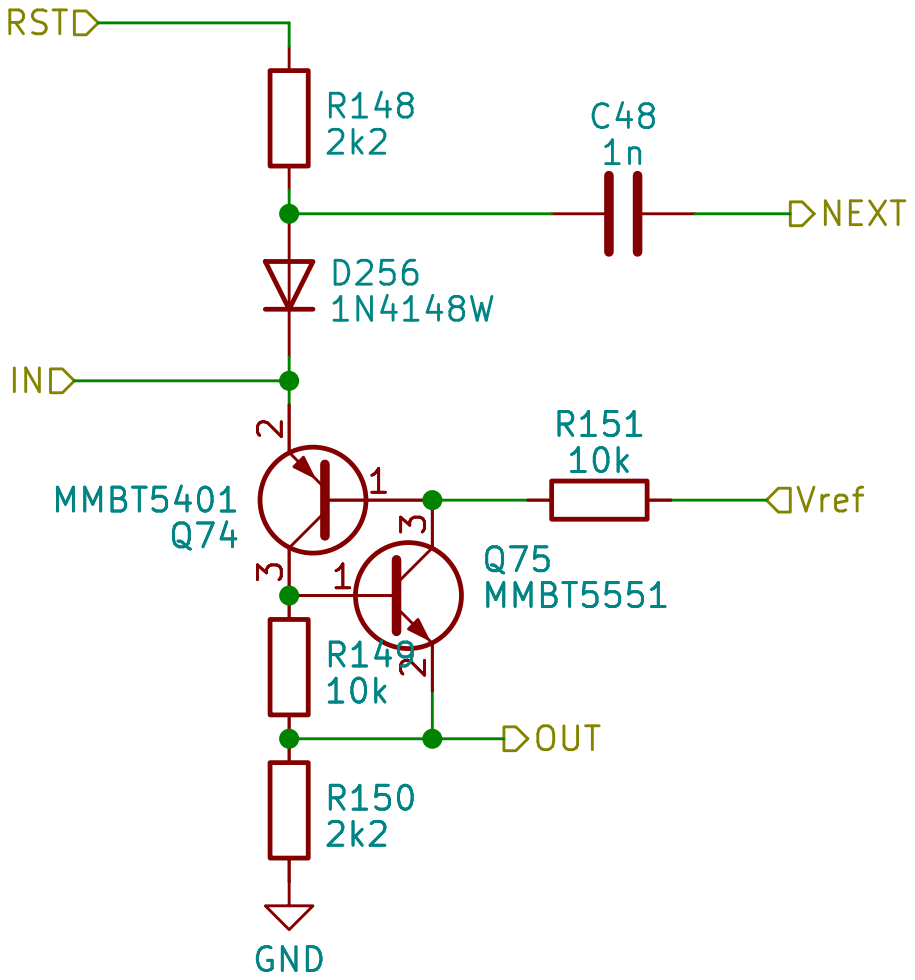
[picture p132: page 74]

Id: 77/106 Title: File: scr_stage.kicad_sch Sheet: /Seconds/10counter/SCR_stage7/ R150
2k2 GND

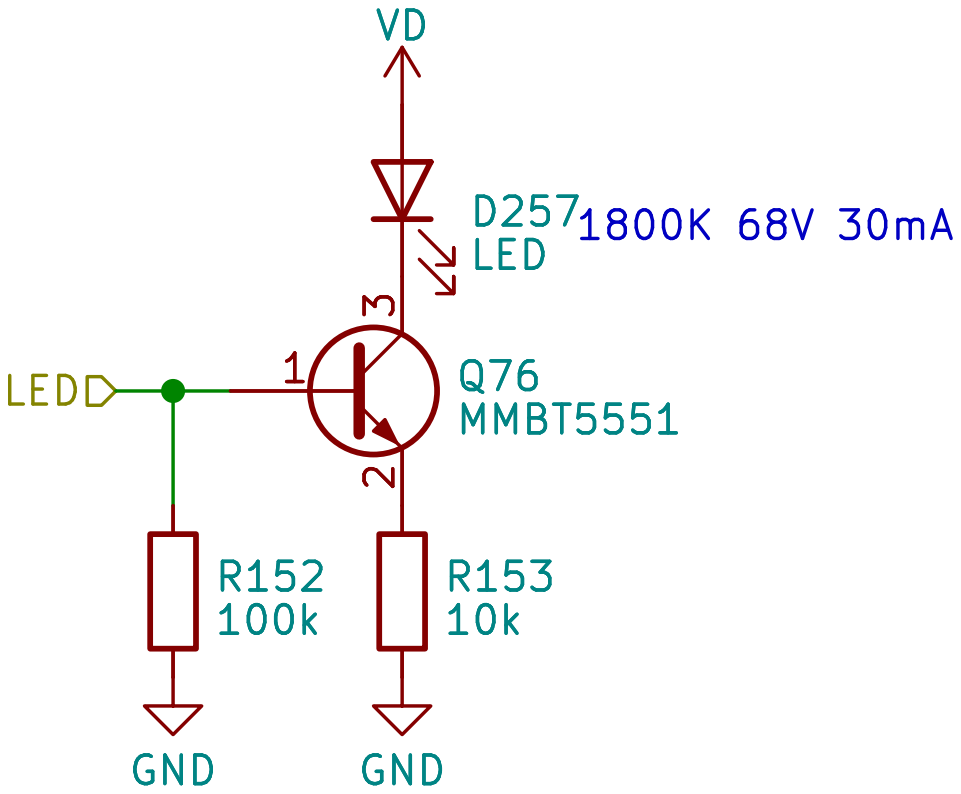
[picture p133: page 75]

Id: 78/106 Title: File: segment.kicad_sch Sheet: /Hours/segmentF/

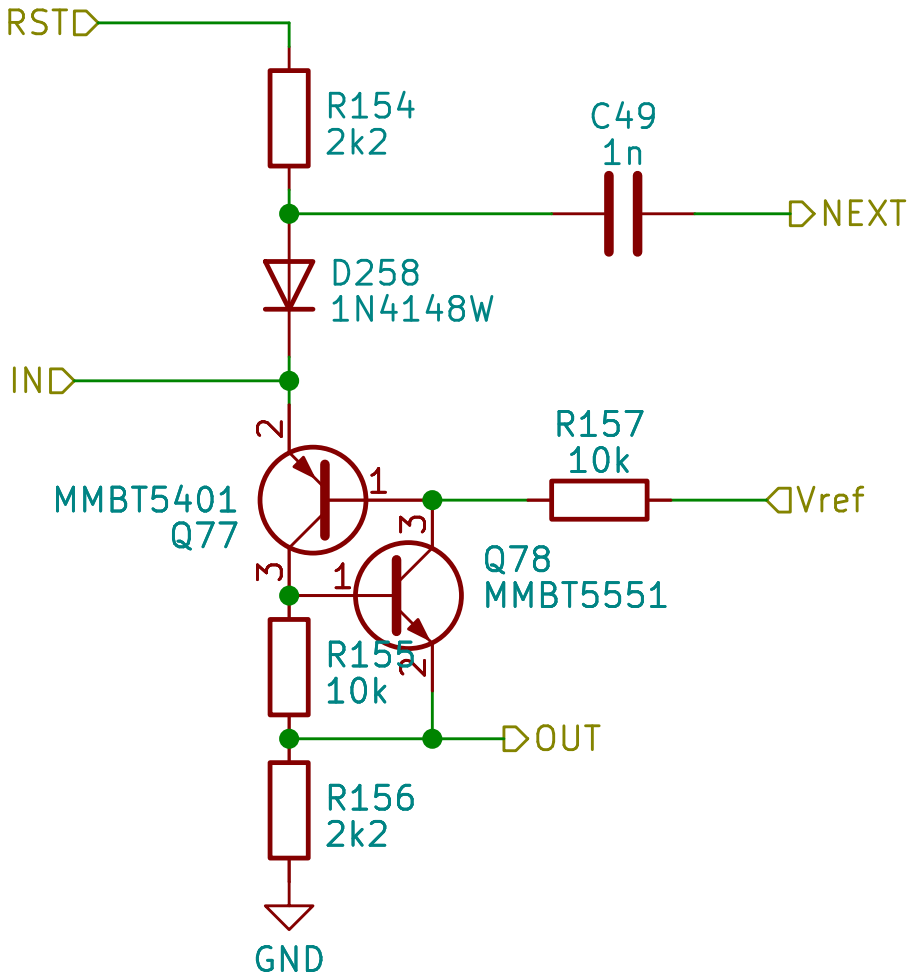
[picture p134: page 76]

Id: 79/106 Title: File: scr_stage.kicad_sch Sheet: /Minutes/10counter/SCR_stage7/ R156

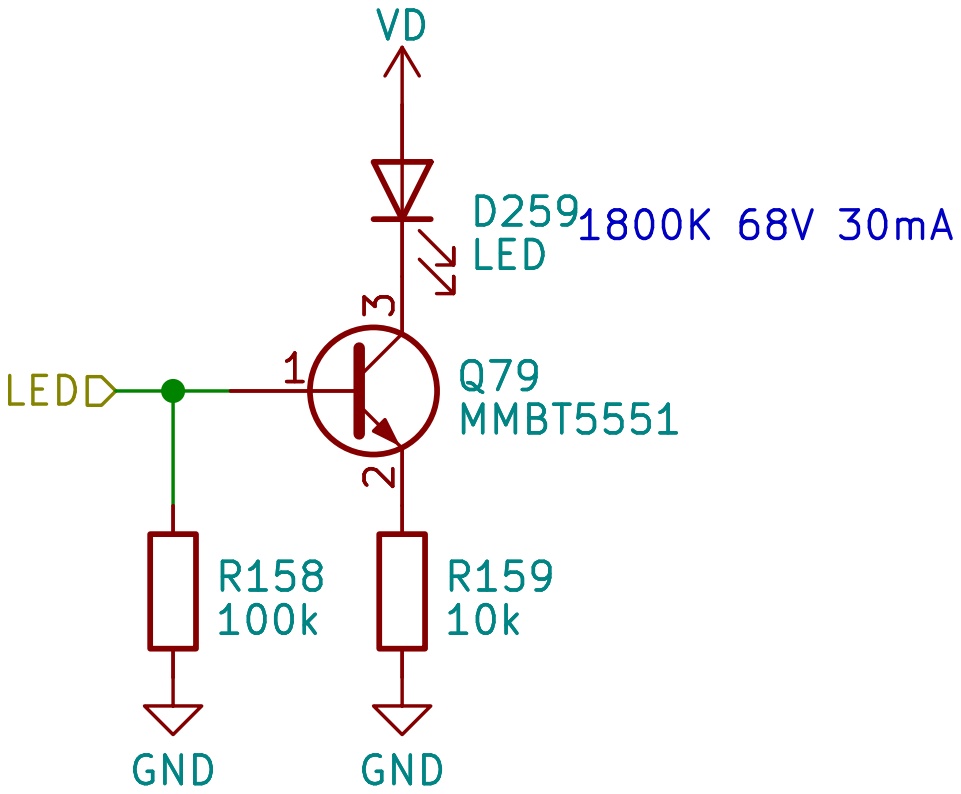
[picture p135: page 77]

Id: 80/106 Title: File: segment.kicad_sch Sheet: /Hours/segmentA/

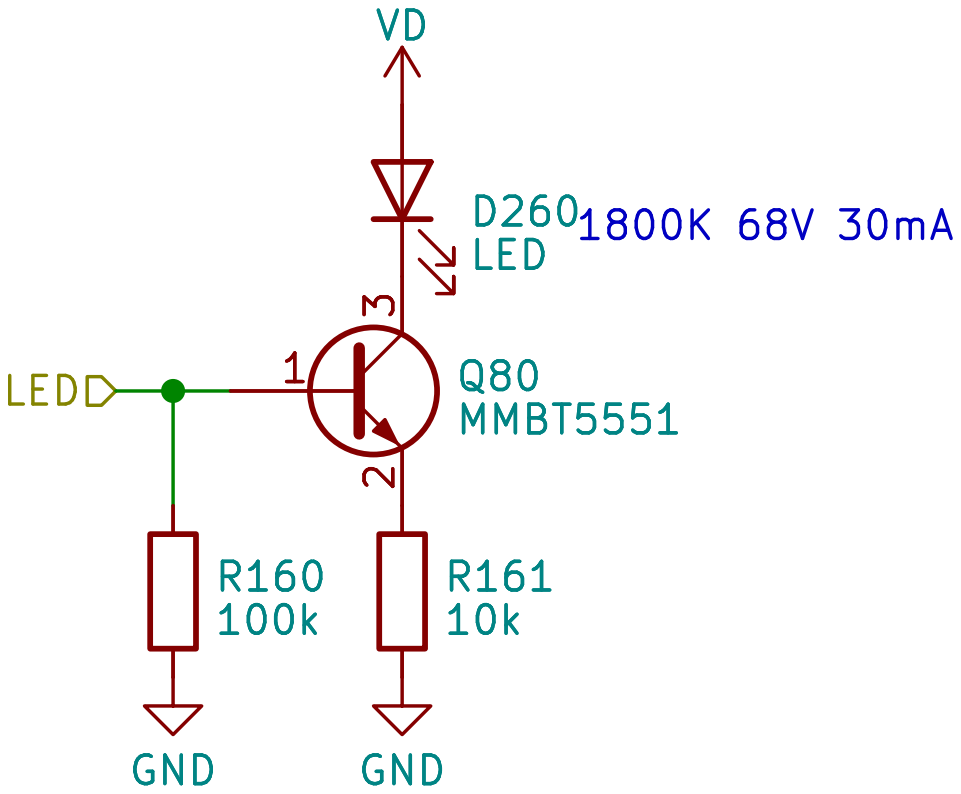
[picture p136: page 78]

Id: 81/106 Title: File: segment.kicad_sch Sheet: /Hours/segmentG/

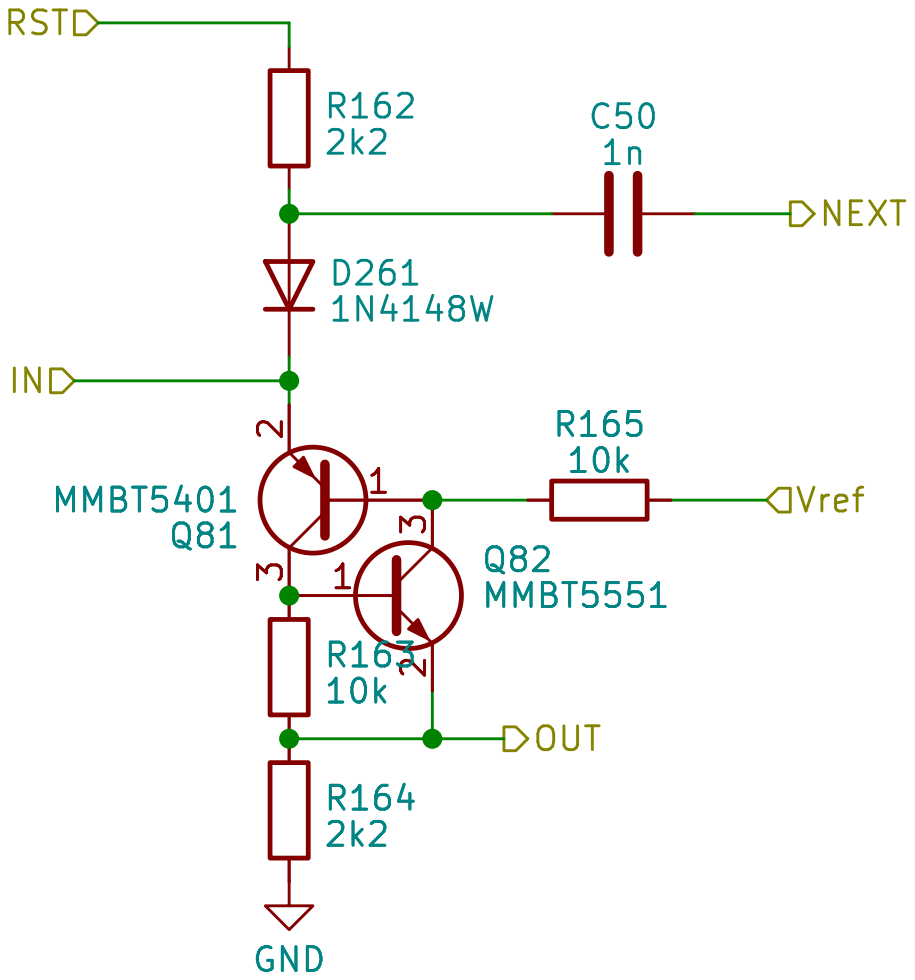
[picture p137: page 79]

Id: 82/106 Title: File: scr_stage.kicad_sch Sheet: /Minutes/10counter/SCR_stage6/ R164

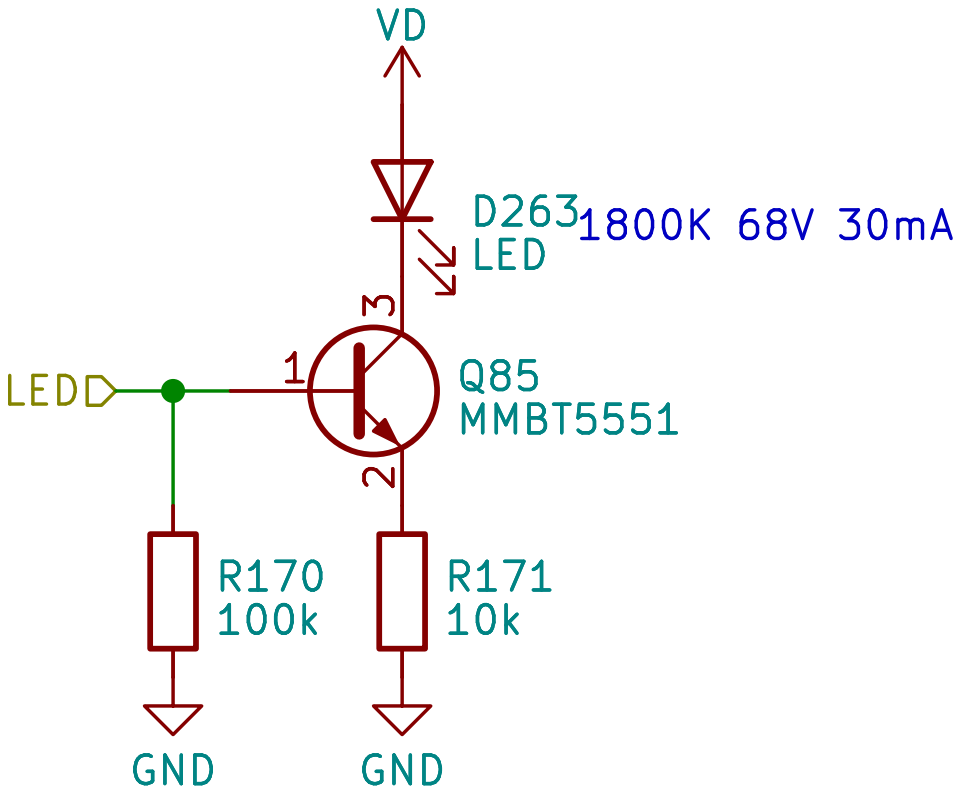
[picture p138: page 80]

Id: 84/106 Title: File: segment.kicad_sch Sheet: /Hours/segmentB/

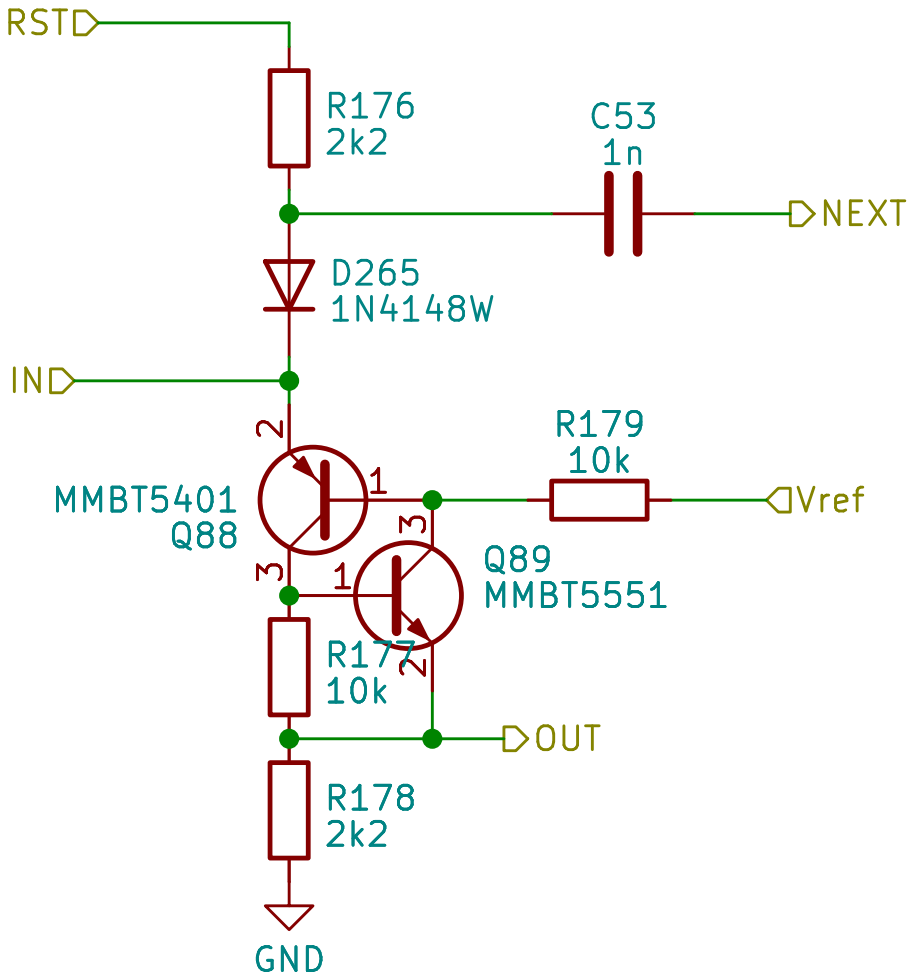
[picture p139: page 81]

Id: 86/106 Title: File: scr_stage.kicad_sch Sheet: /Seconds/10counter/SCR_stage8/ R178
2k2 GND

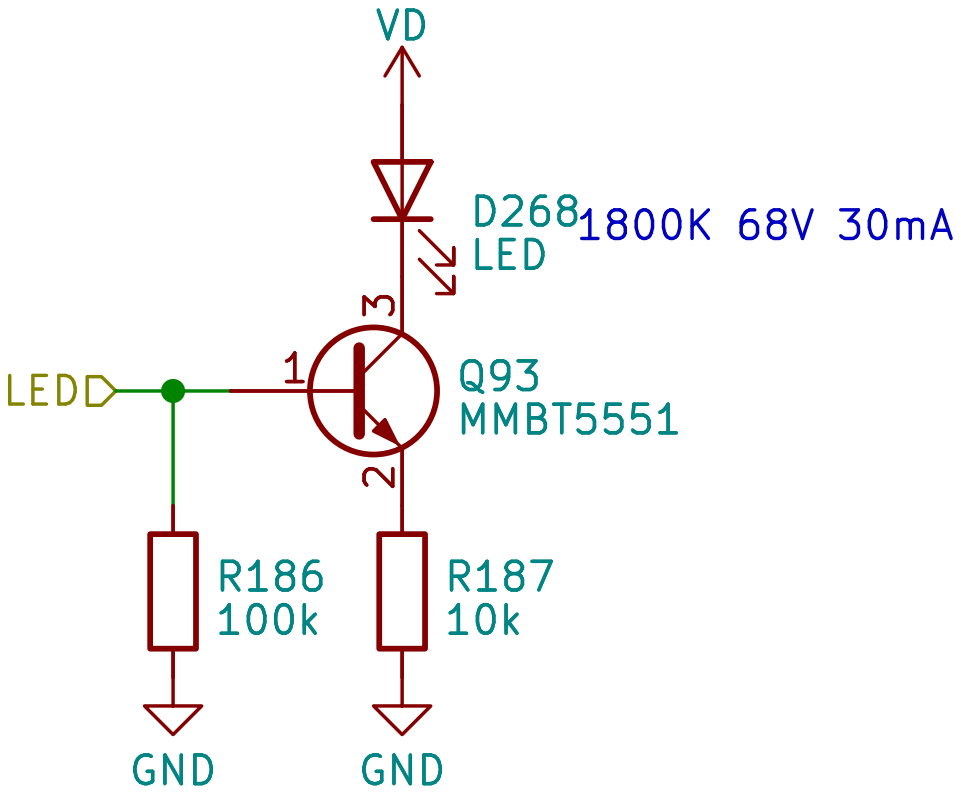
[picture p140: page 82]

Id: 89/106 Title: File: segment.kicad_sch Sheet: /Hours/segmentE1/

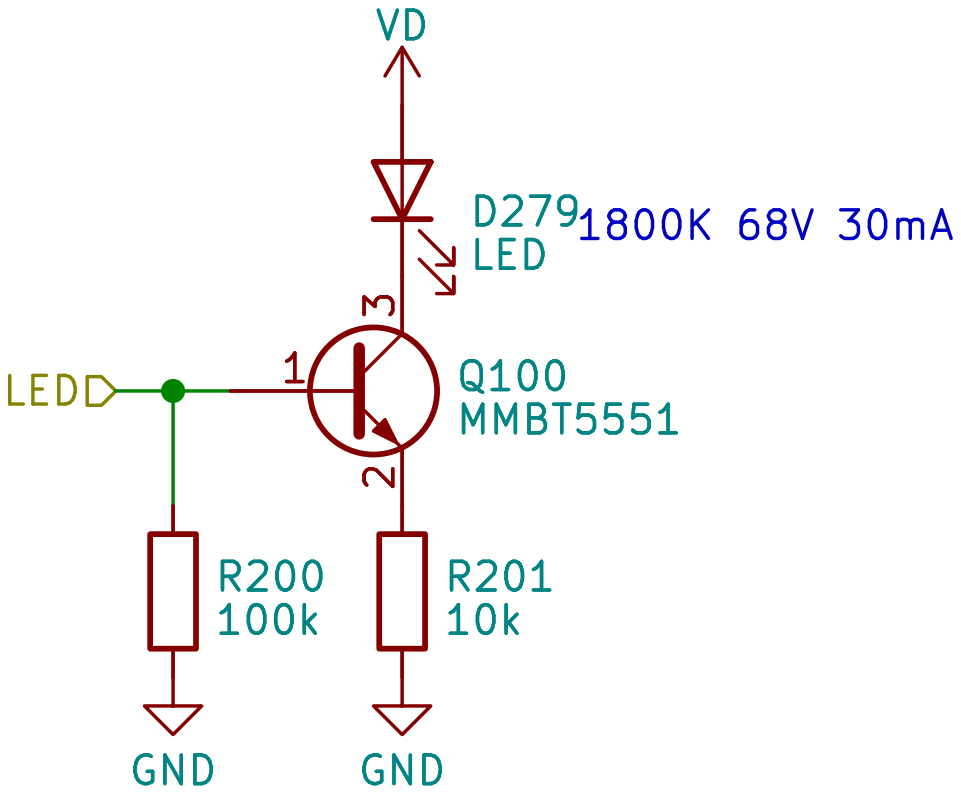
[picture p141: page 83]

Id: 94/106 Title: File: segment.kicad_sch Sheet: /Hours/segmentC1/

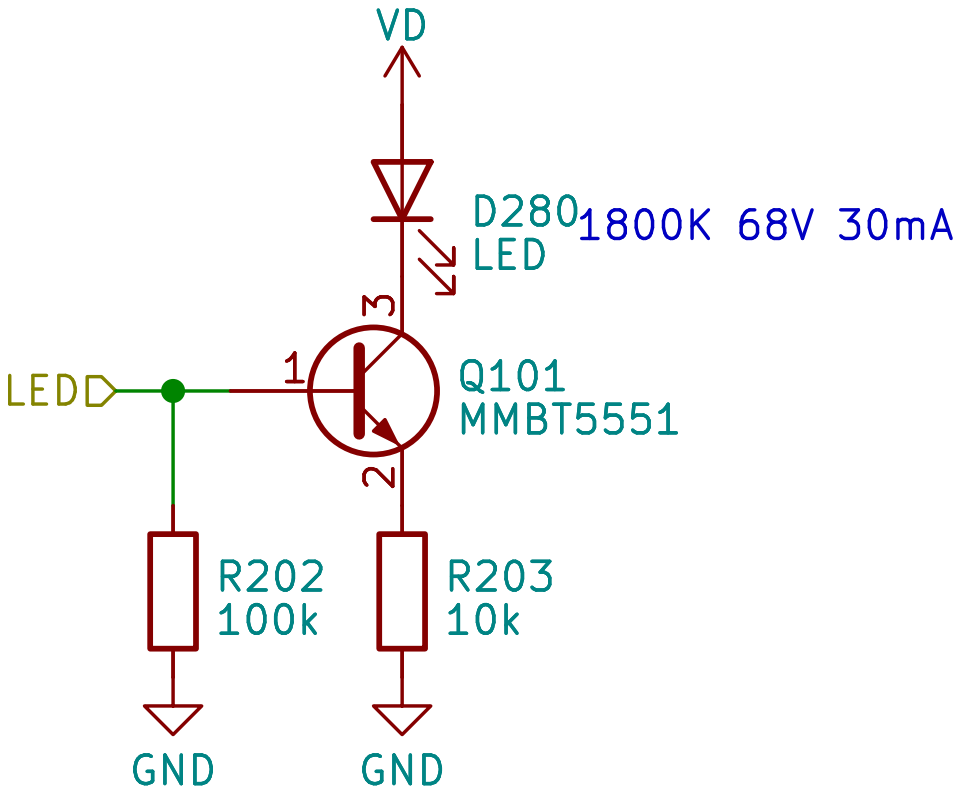
[picture p142: page 84]

Id: 95/106 Title: File: segment.kicad_sch Sheet: /Hours/segmentD1/

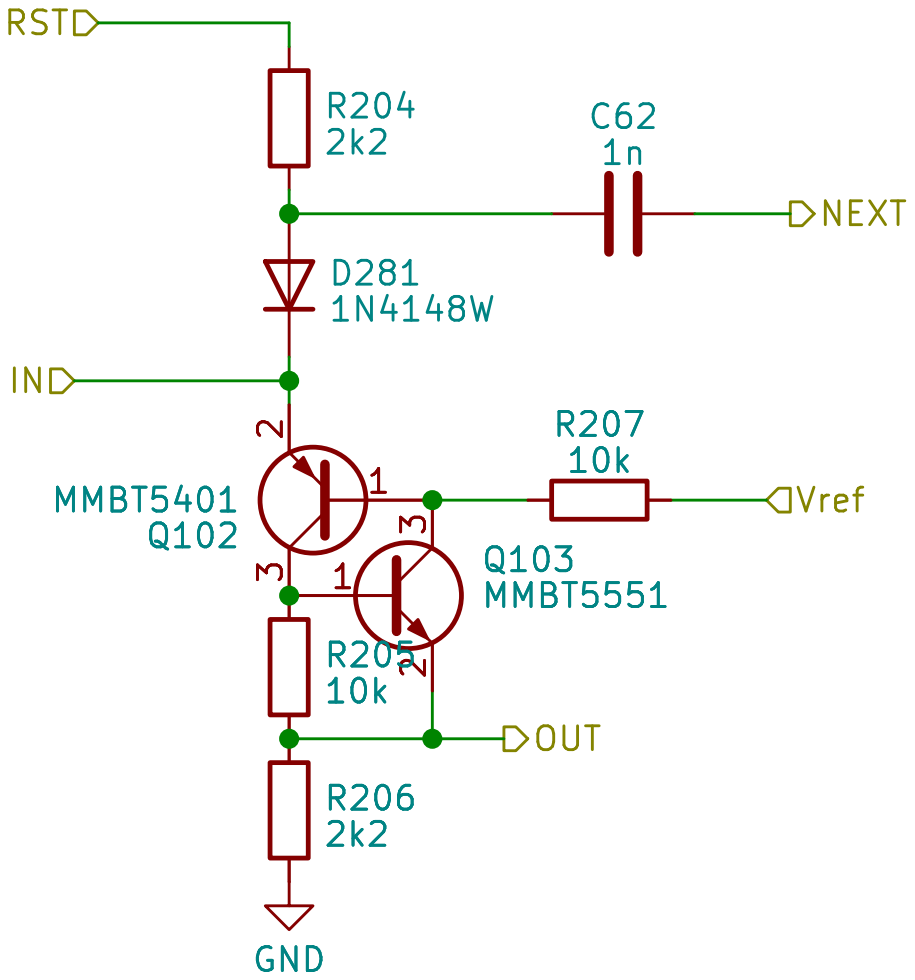
[picture p143: page 85]

Id: 96/106 Title: File: scr_stage.kicad_sch Sheet: /Seconds/10counter/SCR_stage9/ R206

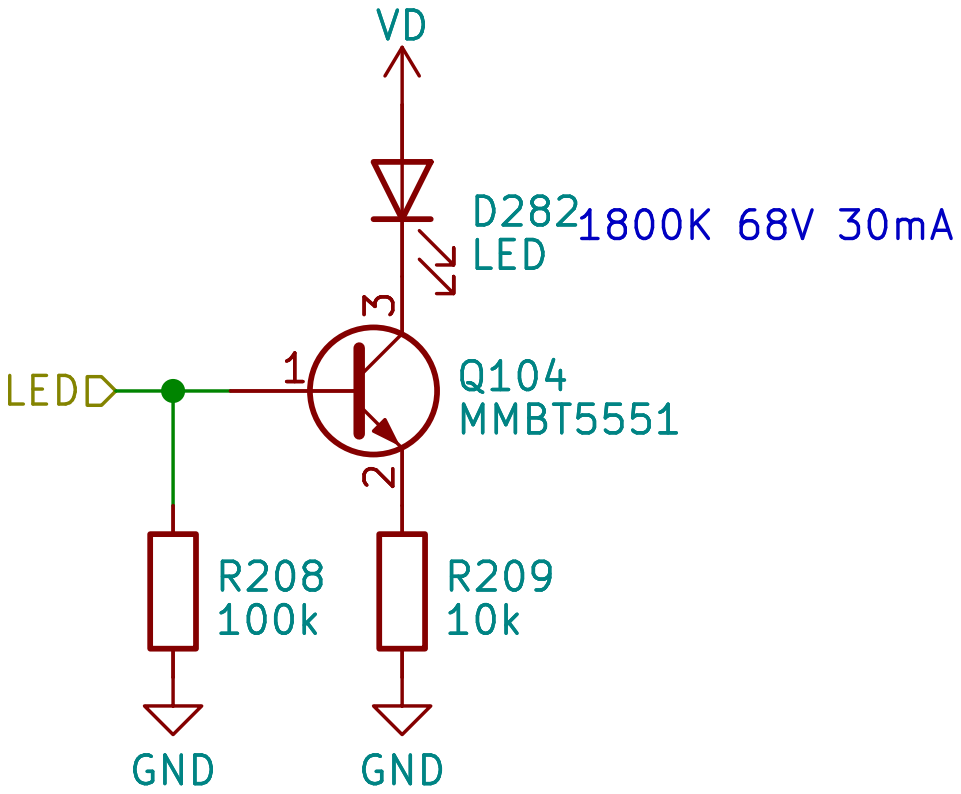
[picture p144: page 86]

Id: 97/106 Title: File: segment.kicad_sch Sheet: /Hours/segmentA1/

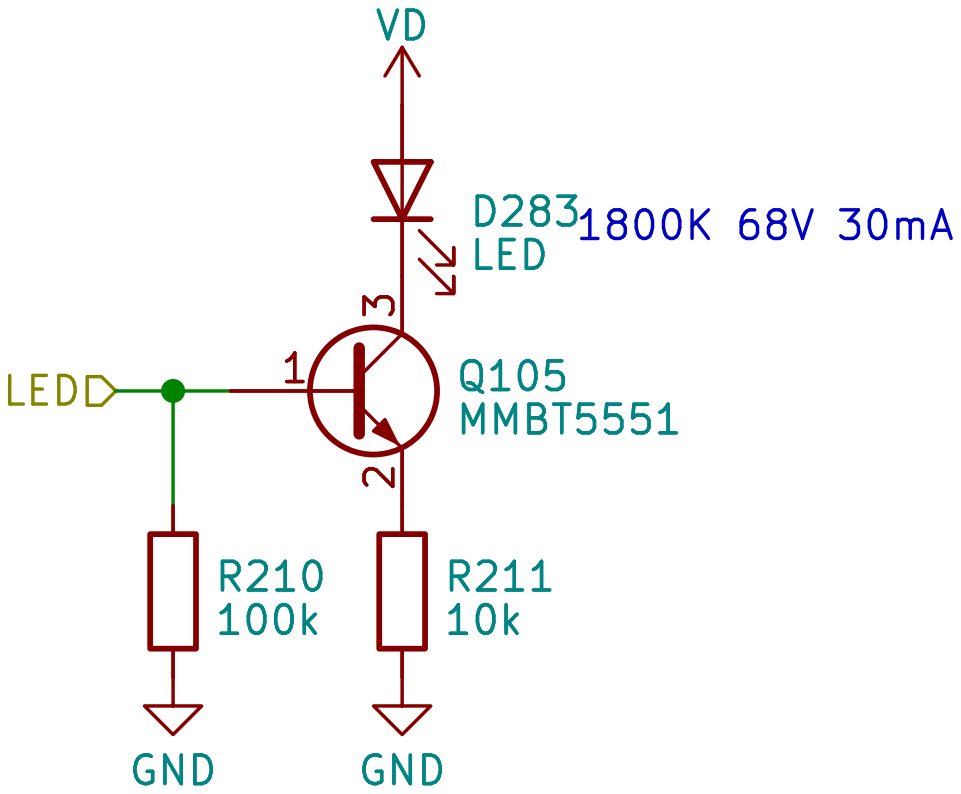
[picture p145: page 87]

Id: 98/106 Title: File: segment.kicad_sch Sheet: /Hours/segmentG1/

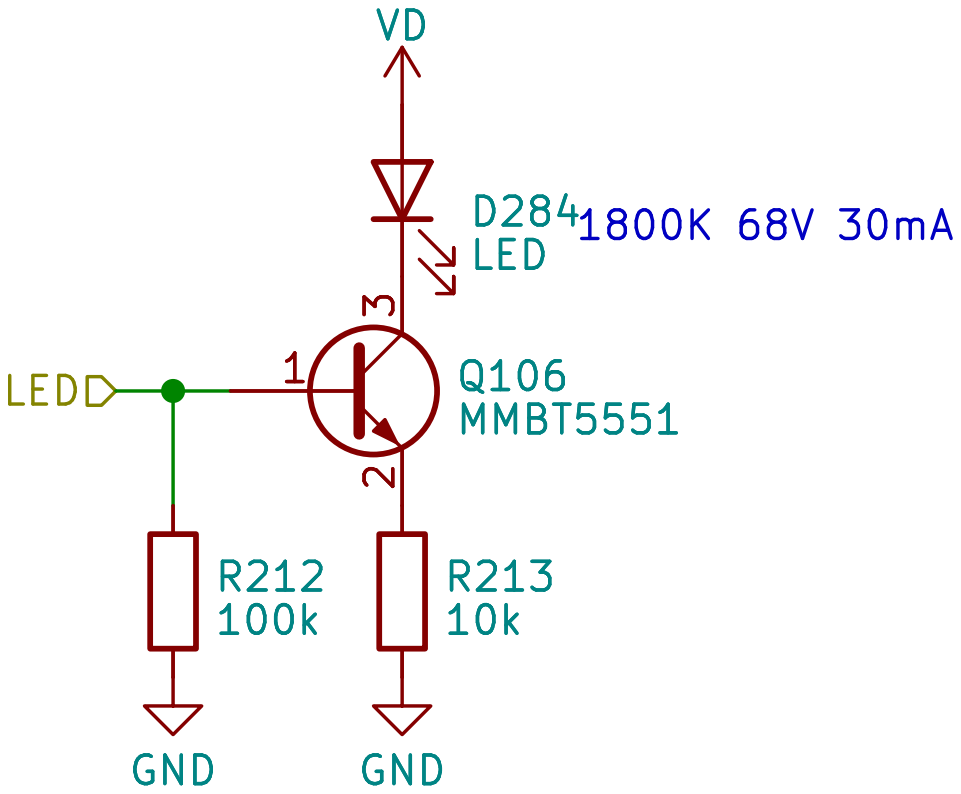
[picture p146: page 88]

Id: 99/106 Title: File: segment.kicad_sch Sheet: /Hours/segmentB1/

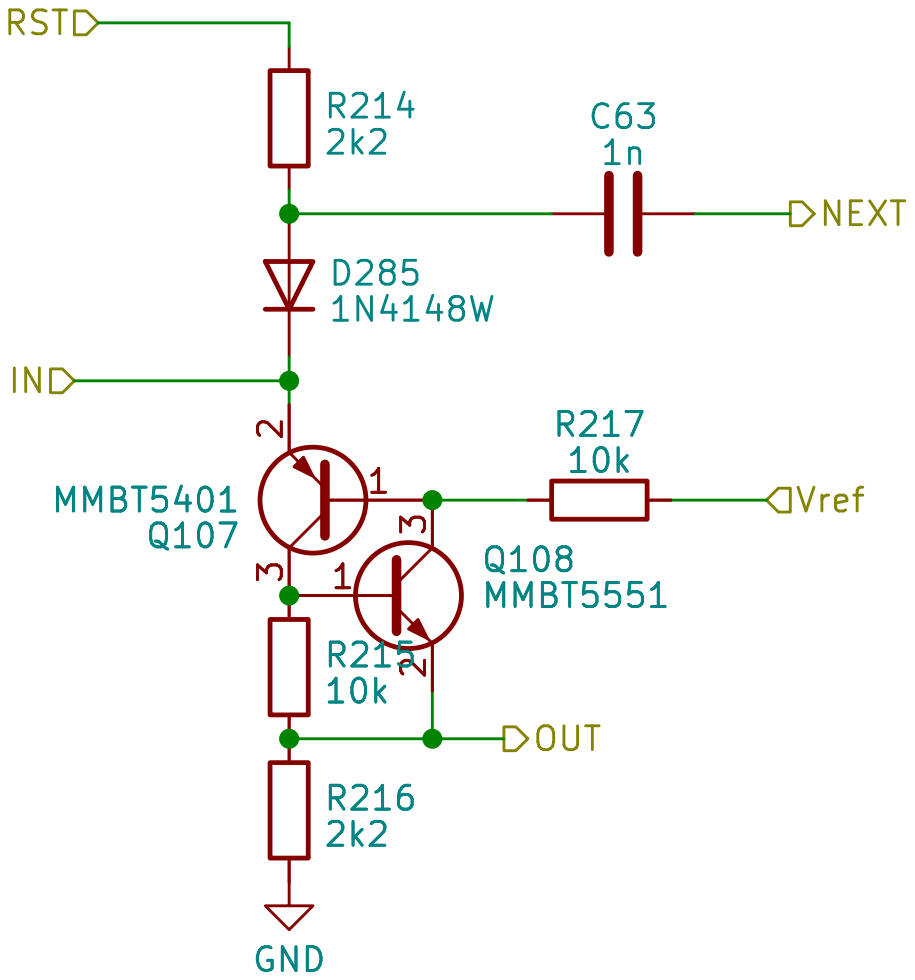
[picture p147: page 89]

Id: 100/106 Title: File: scr_stage.kicad_sch Sheet: /Minutes/10counter/SCR_stage9/ R216

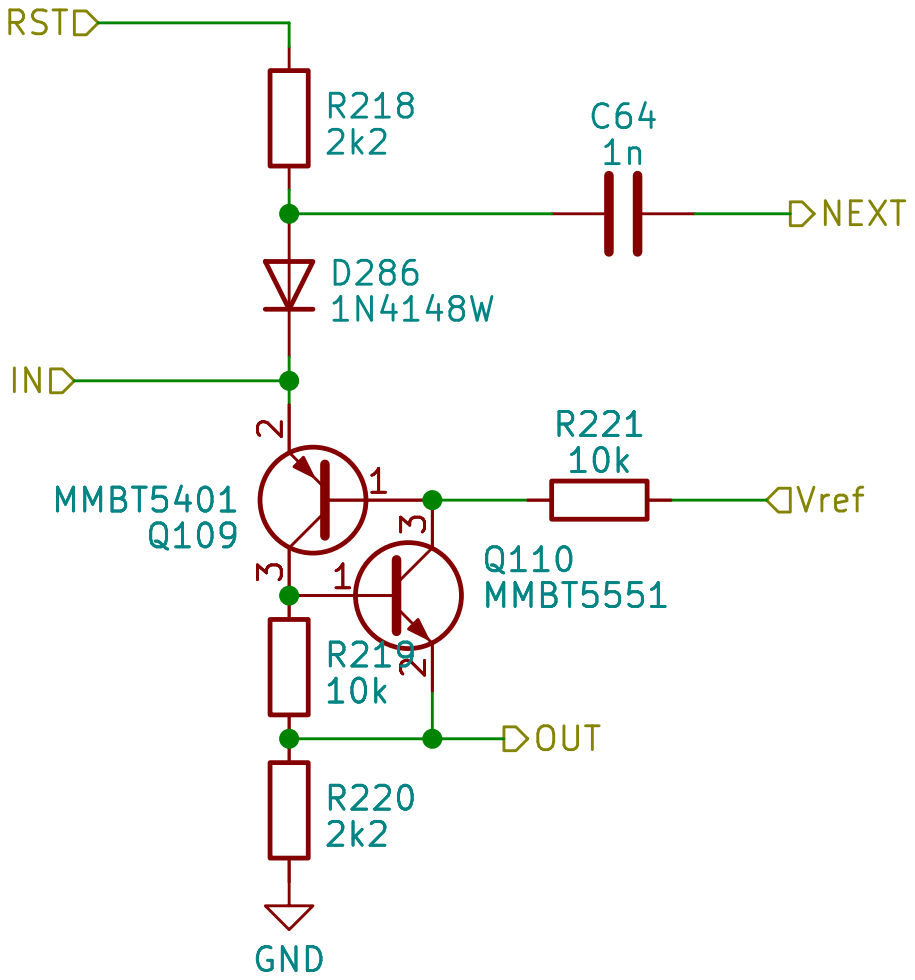
[picture p148: page 90]

Id: 101/106 Title: File: scr_stage.kicad_sch Sheet: /Minutes/10counter/SCR_stage8/ R220
2k2 GND

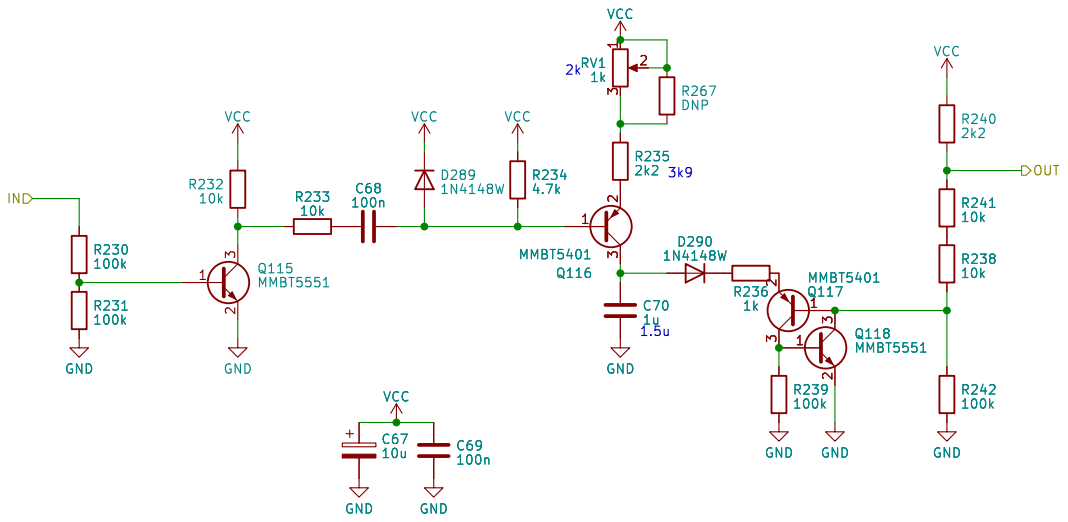
[picture p149: page 91]

Id: 105/106 Title: File: DivByTen.kicad_sch Sheet: /Div_by_10/

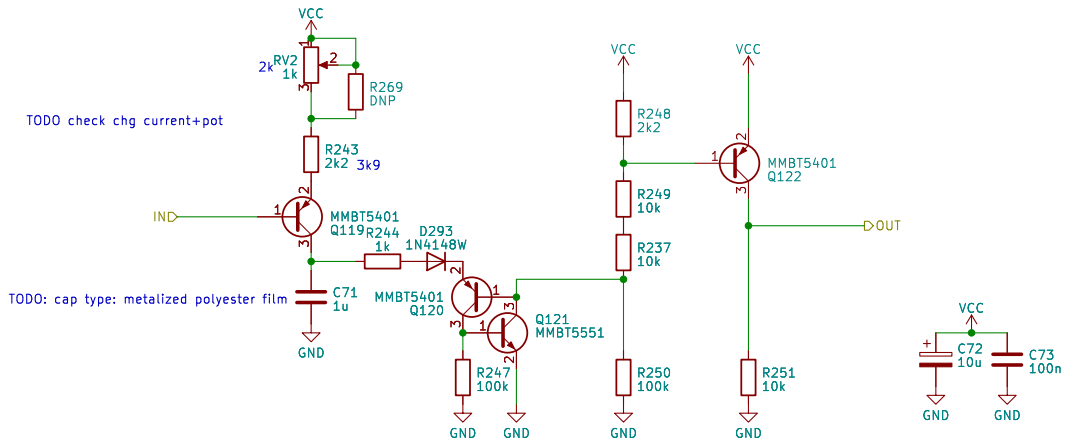
[picture p150: page 92]

Id: 106/106 Title: File: DivBy5.kicad_sch Sheet: /Div_By_5/ VCC

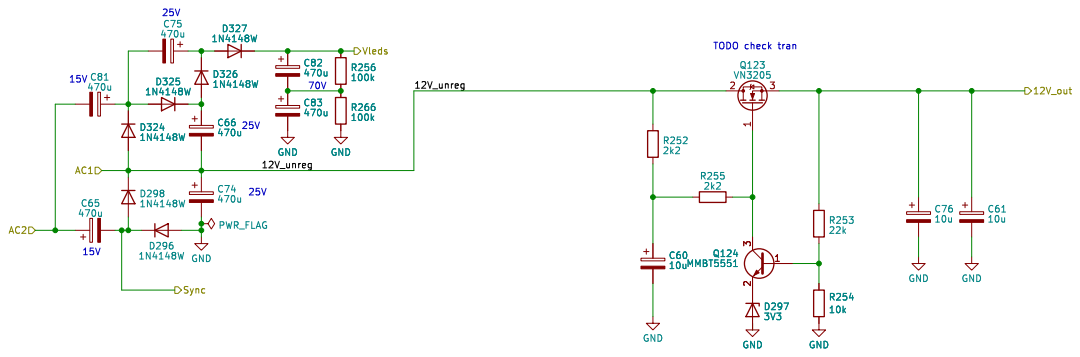
[picture p151: page 93]

Id: 107/106 Title: File: PSU.kicad_sch Sheet: /PSU/

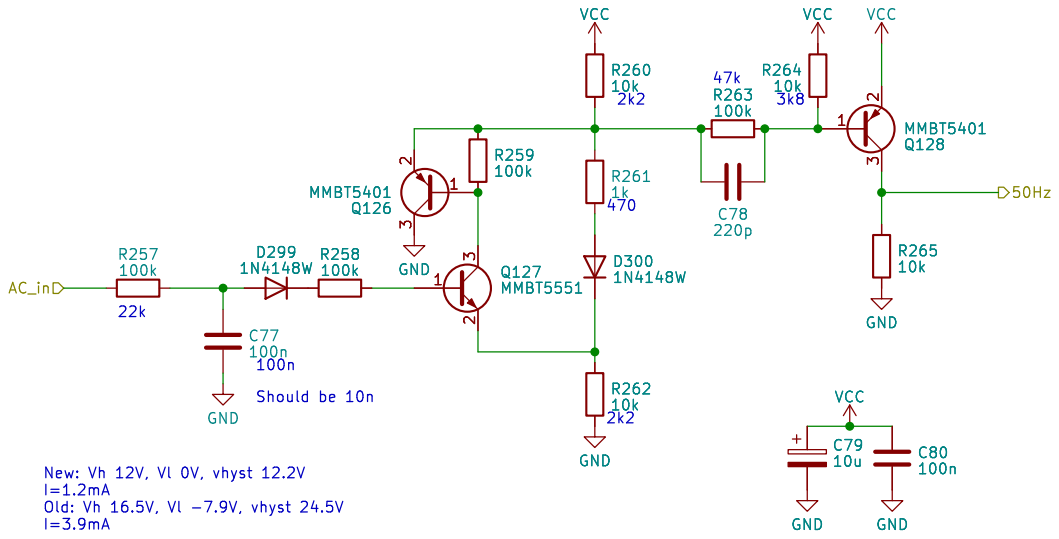
[picture p152: page 94]

50Hz New: Vh 12V, Vl 0V, vhyst 12.2V

Id: 108/106 Title: Transistor clock

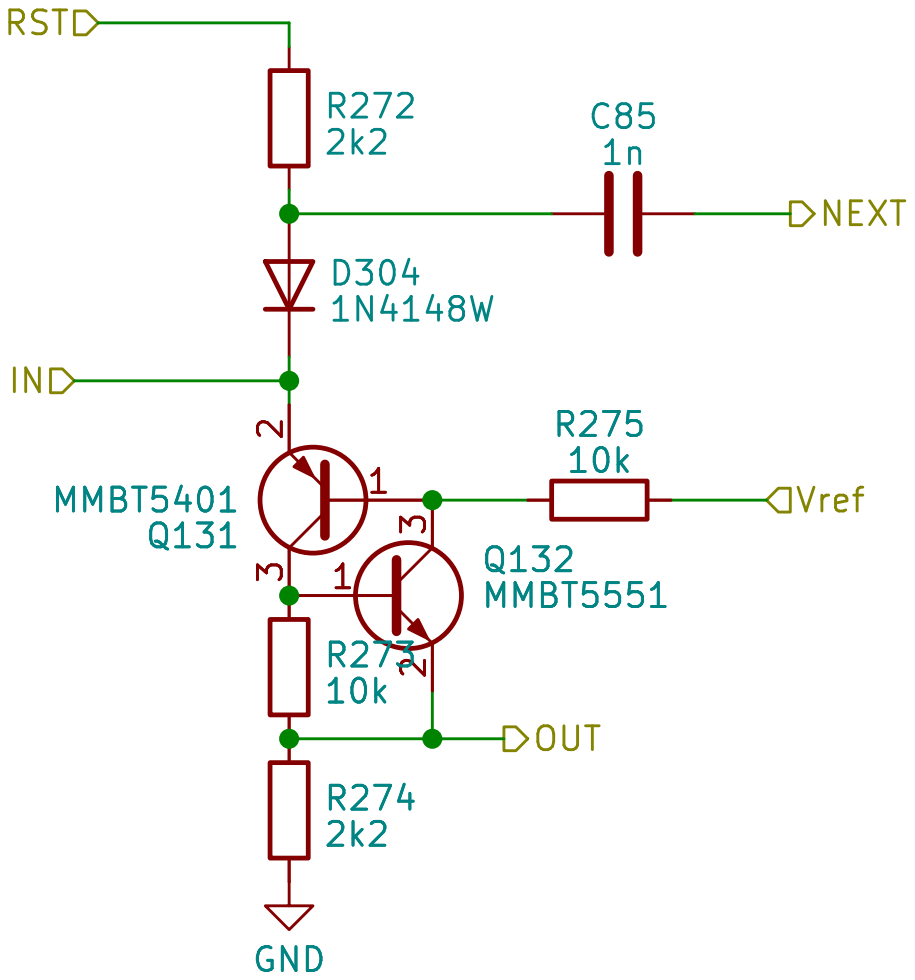
[picture p153: page 95]

Id: 95/106 Title: File: scr_stage.kicad_sch Sheet: /TensSeconds/6counter/SCR_stage/ R274

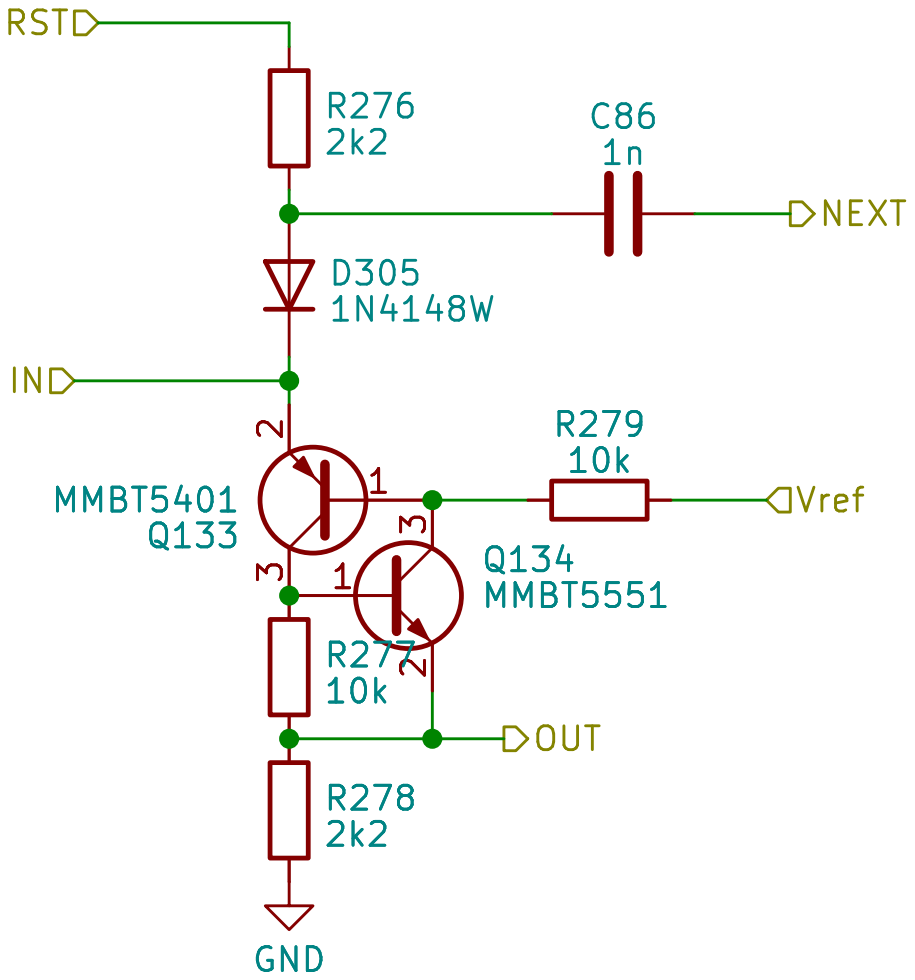
[picture p154: page 96]

Id: 96/106 Title: File: scr_stage.kicad_sch Sheet: /TensSeconds/6counter/SCR_stage1/ R278

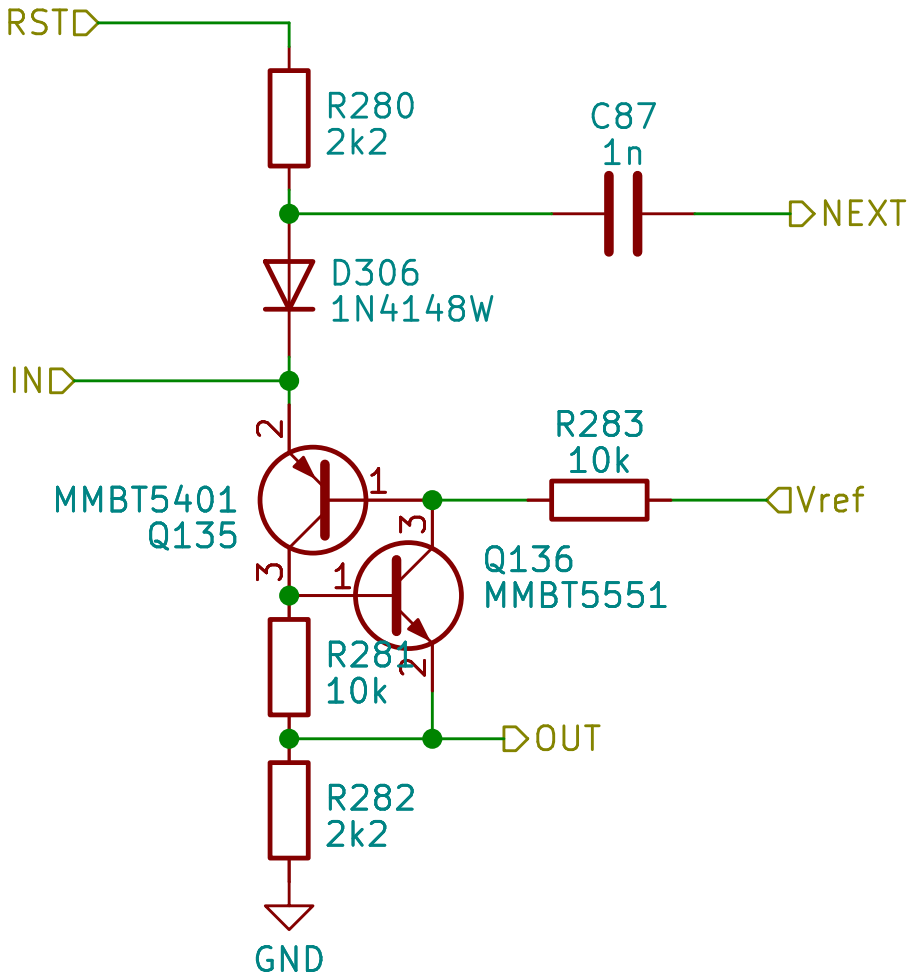
[picture p155: page 97]

Id: 97/106 Title: File: scr_stage.kicad_sch Sheet: /TensSeconds/6counter/SCR_stage2/ R282
2k2 GND

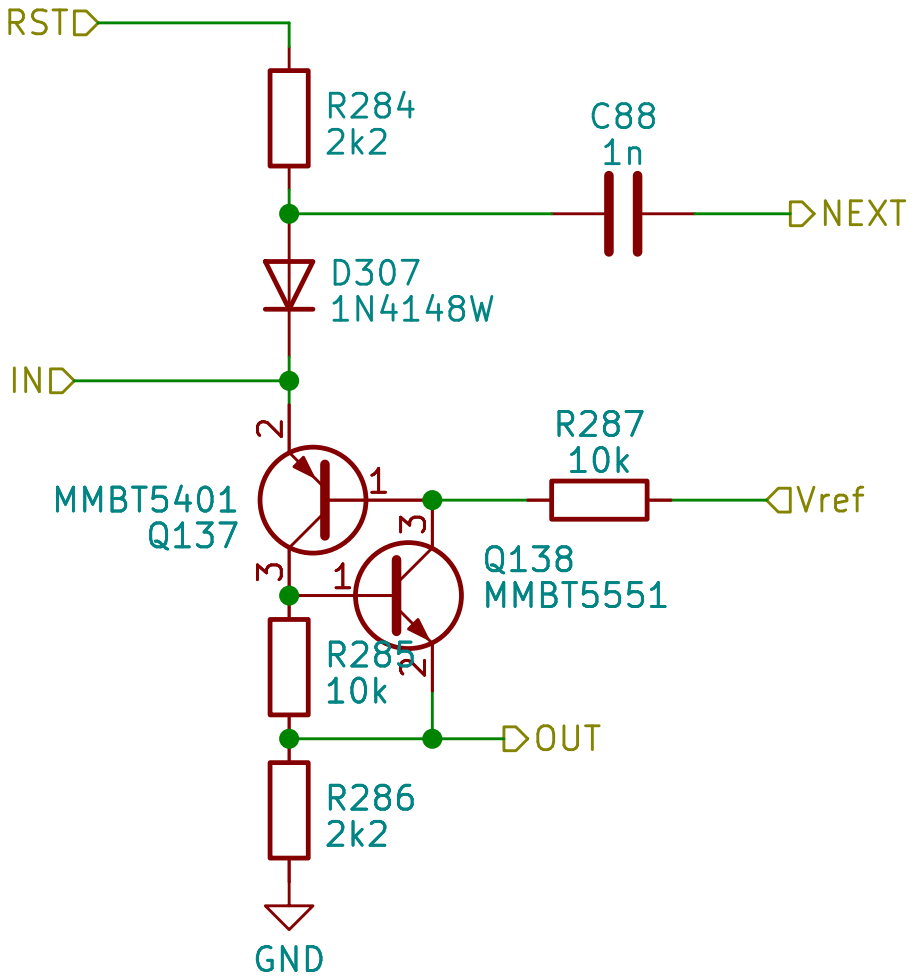
[picture p156: page 98]

Id: 98/106 Title: File: scr_stage.kicad_sch Sheet: /TensSeconds/6counter/SCR_stage3/ R286

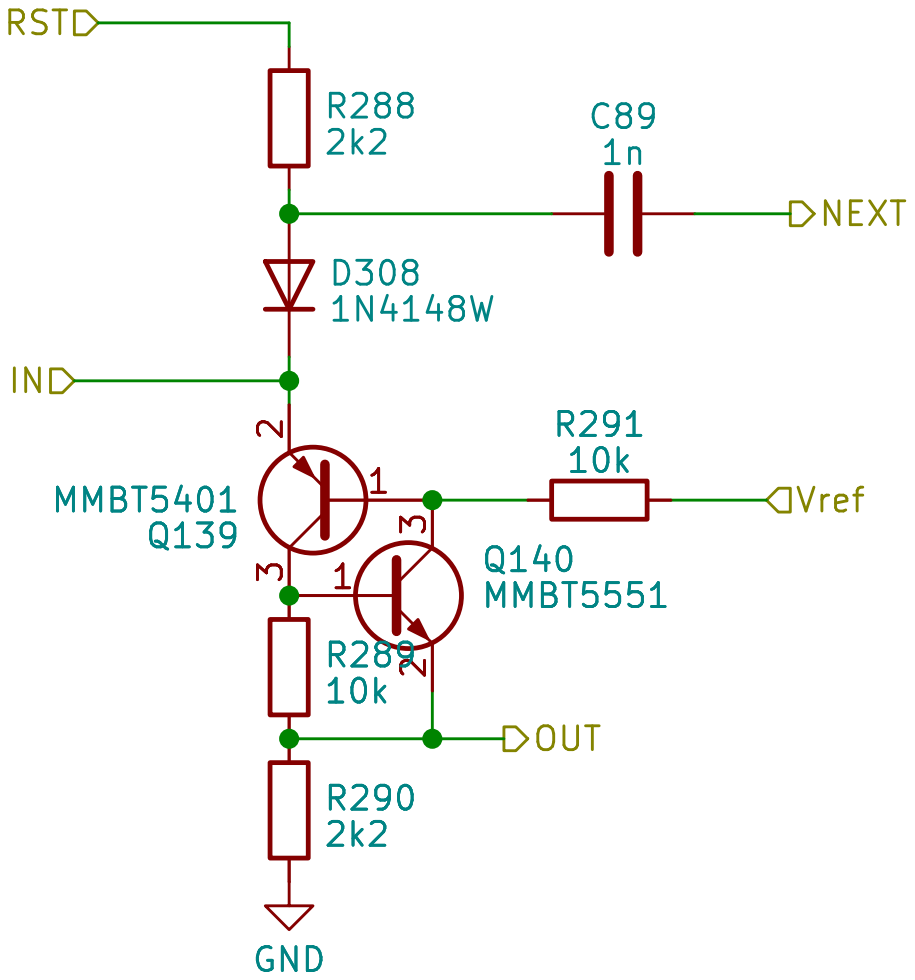
[picture p157: page 99]

Id: 99/106 Title: File: scr_stage.kicad_sch Sheet: /TensSeconds/6counter/SCR_stage4/ R290

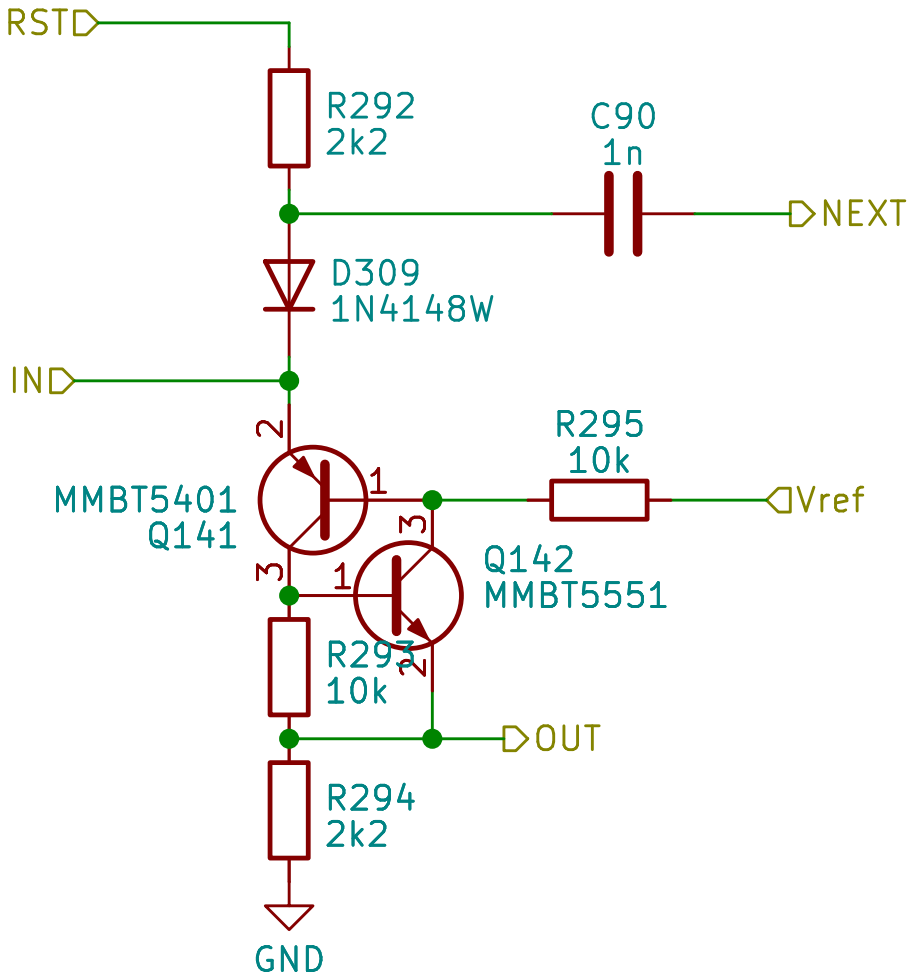
[picture p158: page 100]

Id: 100/106 Title: File: scr_stage.kicad_sch Sheet: /TensSeconds/6counter/SCR_stage5/ R294
2k2 GND

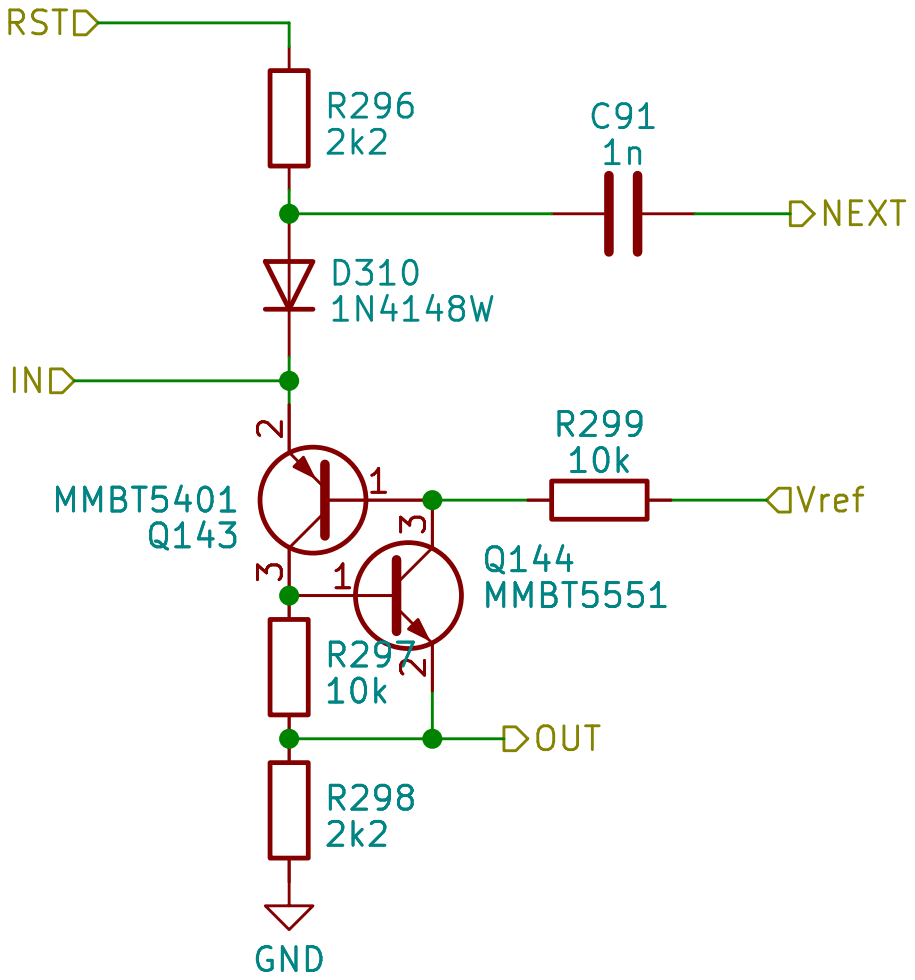
[picture p159: page 101]

Id: 101/106 Title: File: scr_stage.kicad_sch Sheet: /TensMinutes/6counter/SCR_stage/ R298

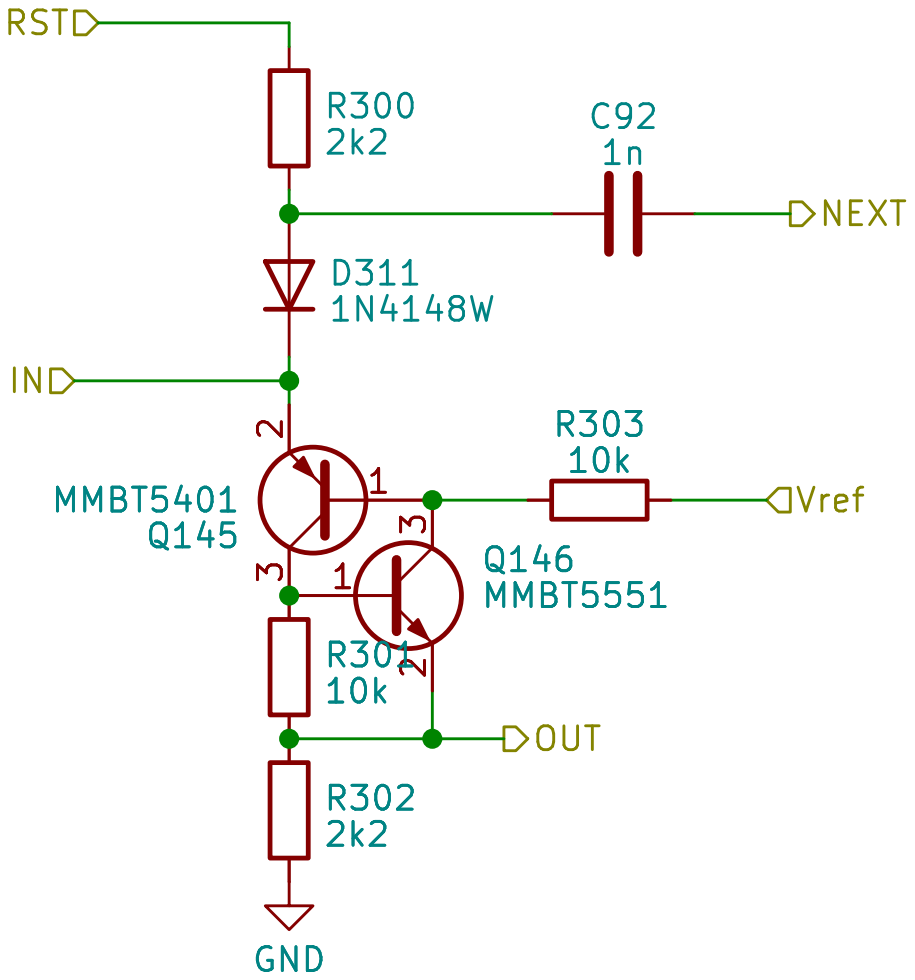
[picture p160: page 102]

Id: 102/106 Title: File: scr_stage.kicad_sch Sheet: /TensMinutes/6counter/SCR_stage1/ R302

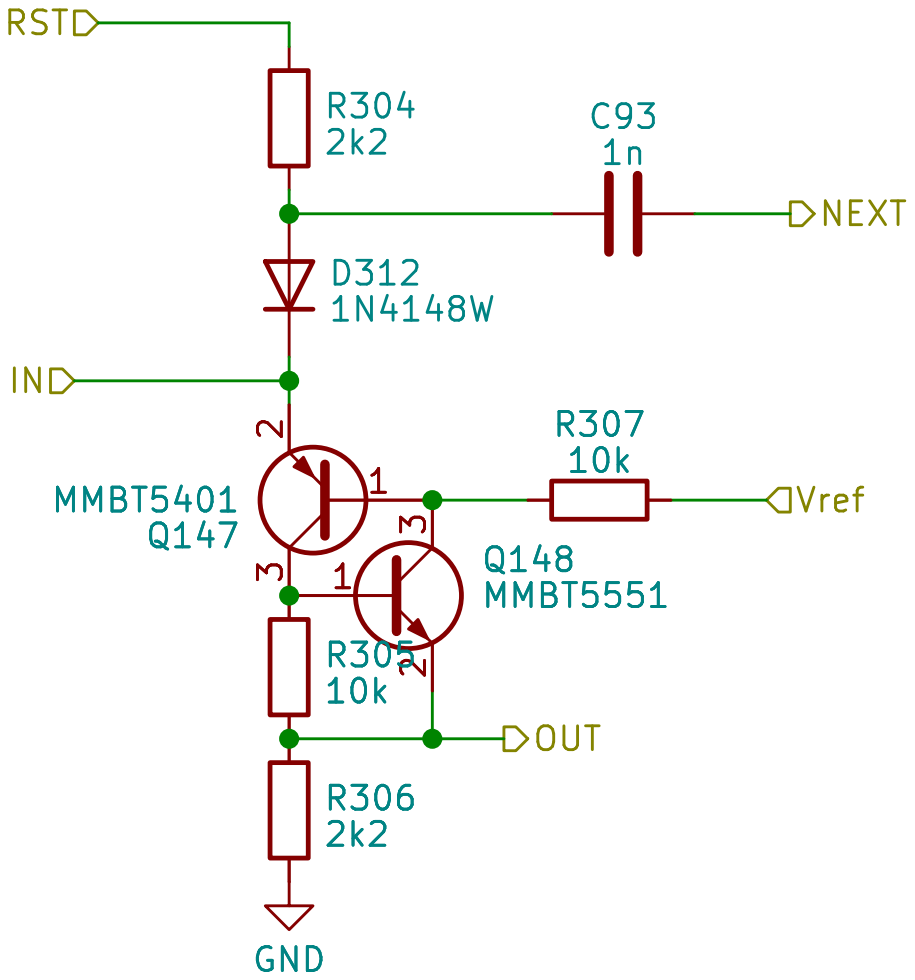
[picture p161: page 103]

Id: 103/106 Title: File: scr_stage.kicad_sch Sheet: /TensMinutes/6counter/SCR_stage2/ R306
2k2 GND

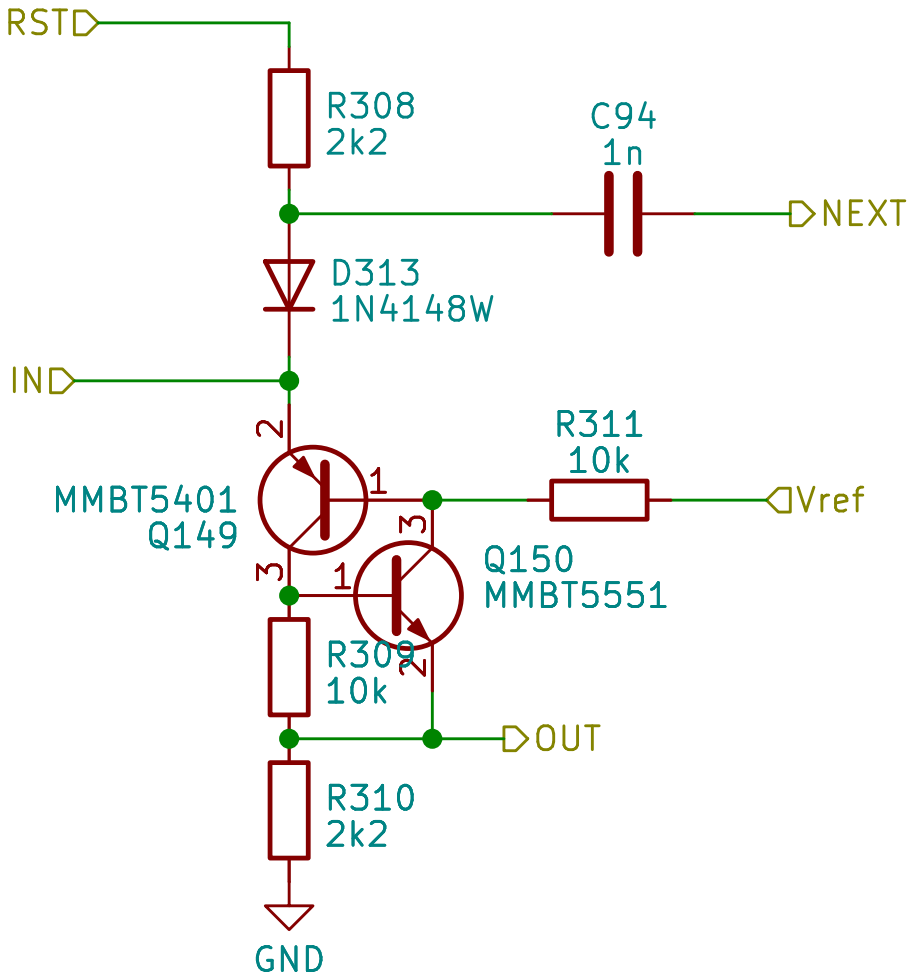
[picture p162: page 104]

Id: 104/106 Title: File: scr_stage.kicad_sch Sheet: /TensMinutes/6counter/SCR_stage3/ R310

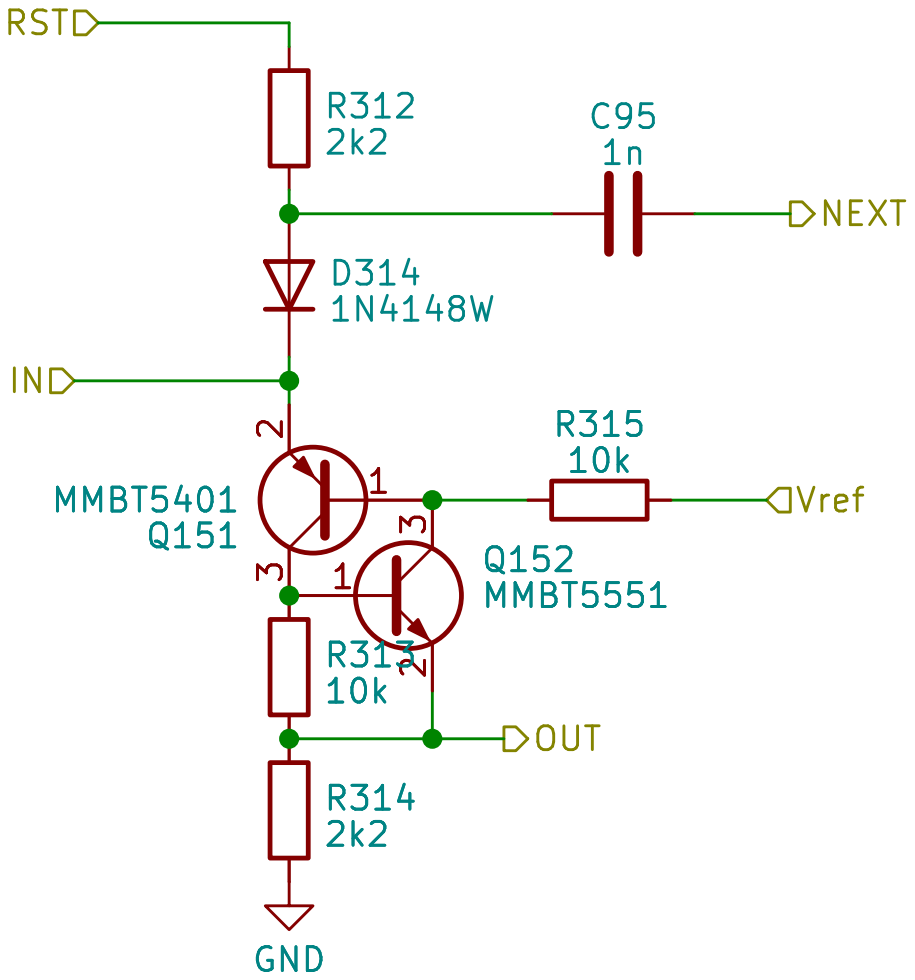
[picture p163: page 105]

Id: 105/106 Title: File: scr_stage.kicad_sch Sheet: /TensMinutes/6counter/SCR_stage4/ R314

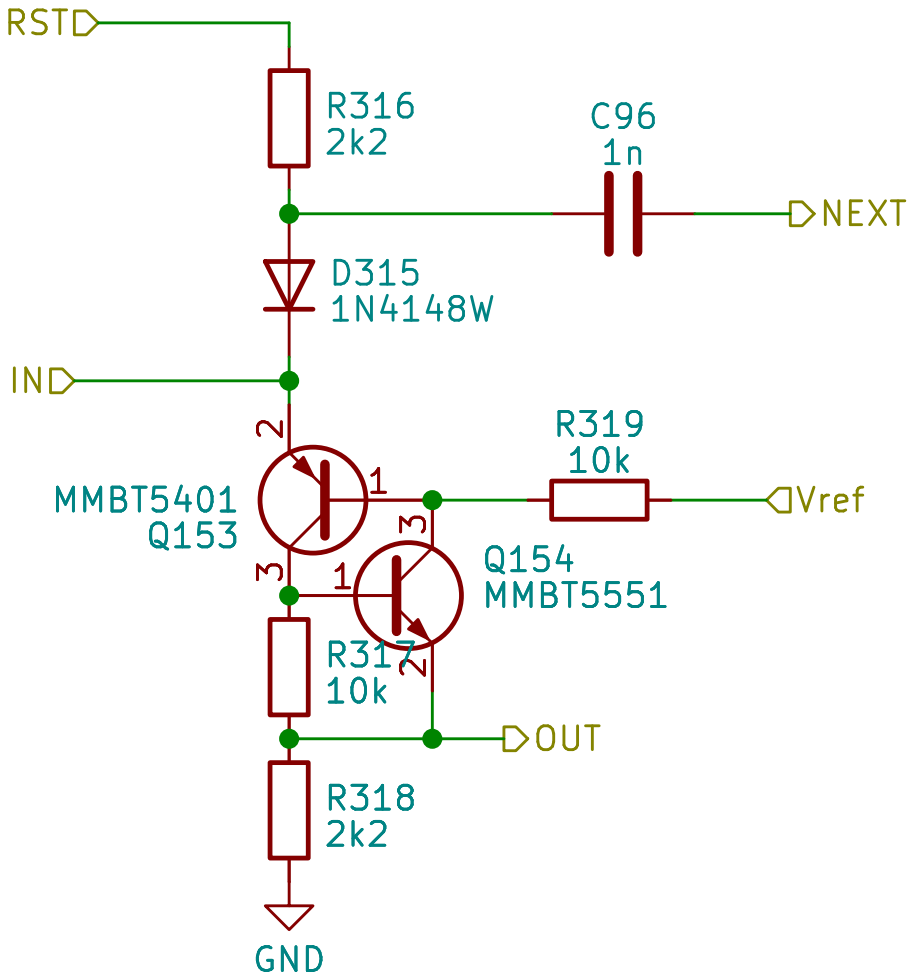
[picture p164: page 106]

Id: 106/106 Title: File: scr_stage.kicad_sch Sheet: /TensMinutes/6counter/SCR_stage5/ R318
2k2 GND
