reivax-boucoi/PCB_Kicad/transistor_clock/original_fernekes_design.pdf

1

2

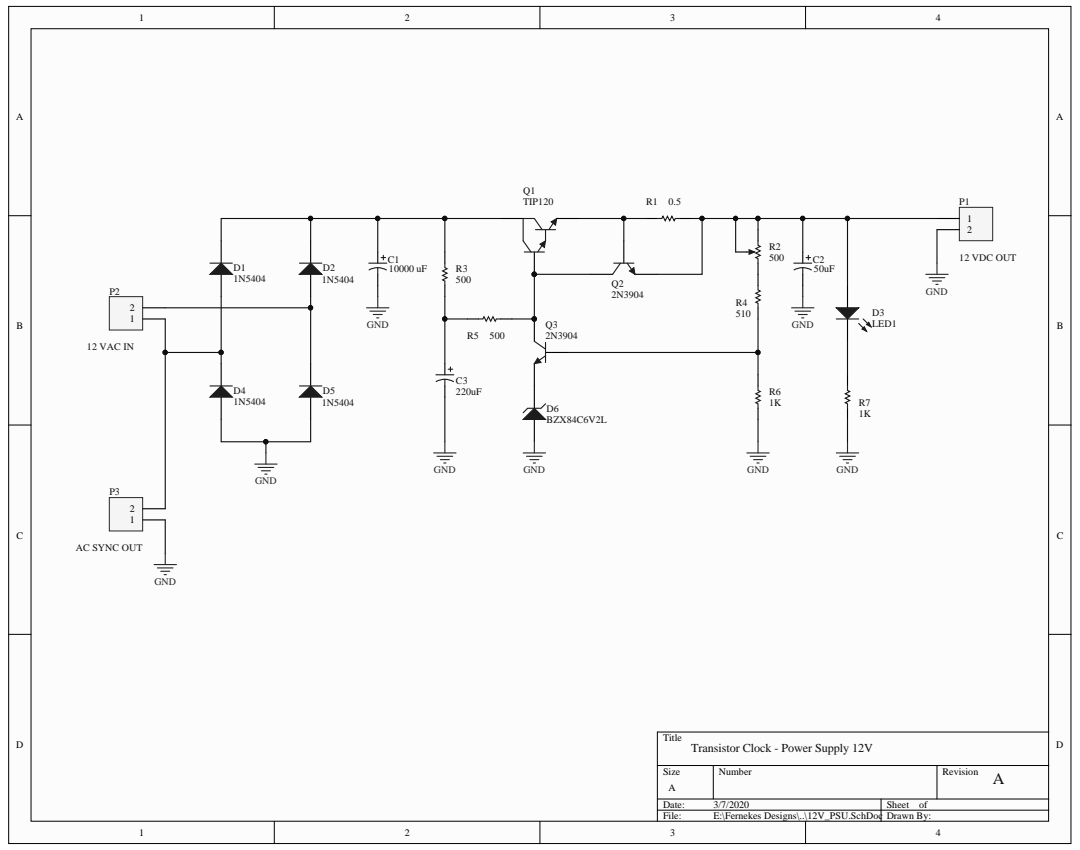
[picture p165: page 1]

Title
Transistor Clock - Power Supply 12V

1

2

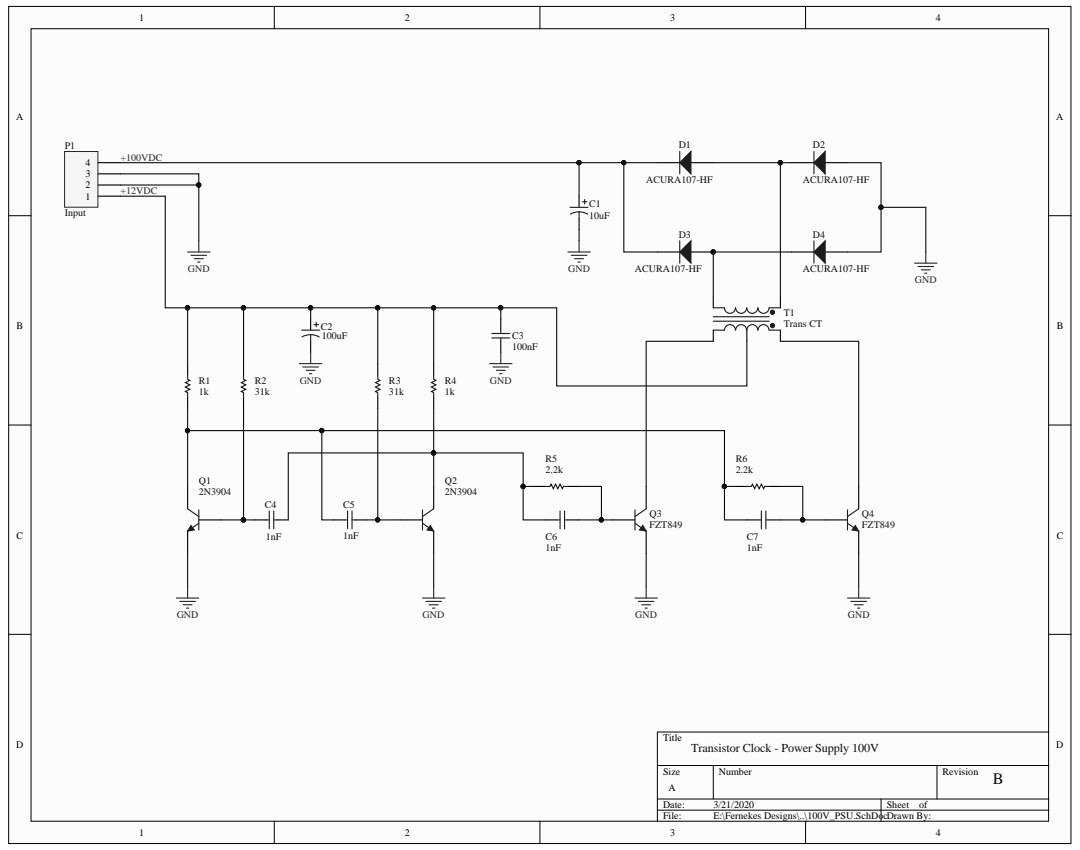
[picture p166: page 2]

Title
Transistor Clock - Power Supply 100V

1

2

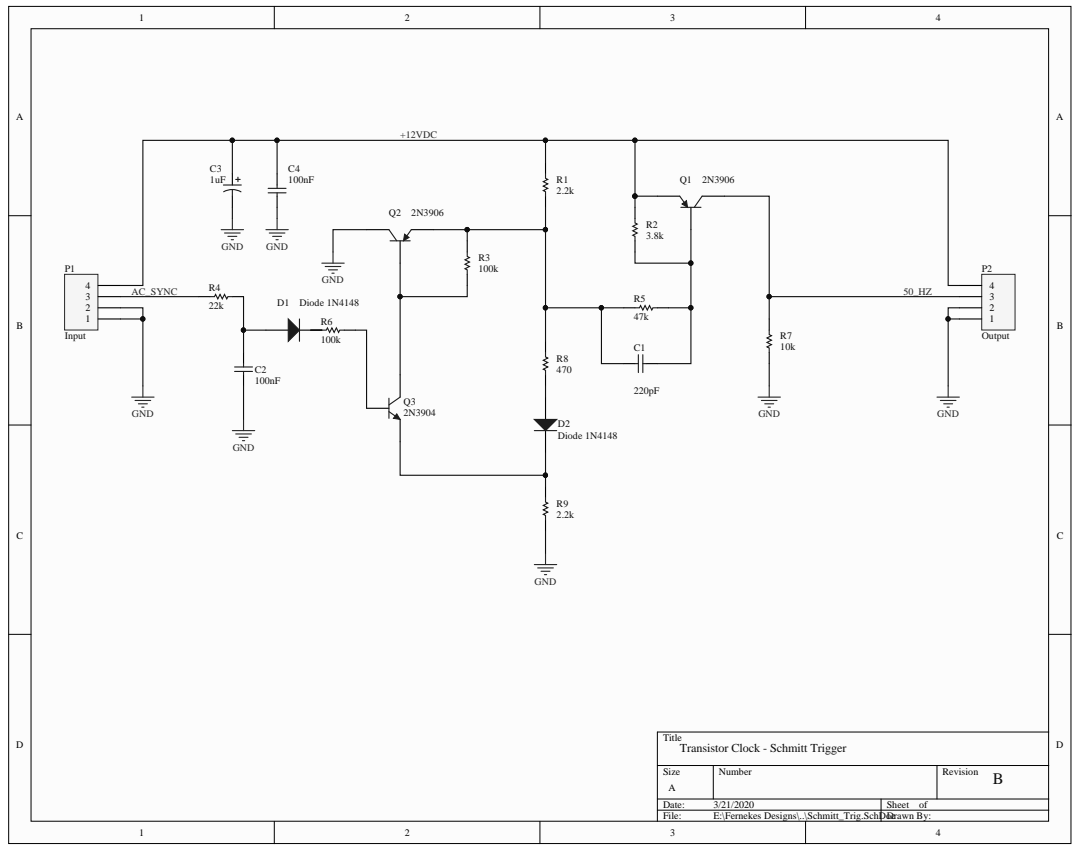
[picture p167: page 3]

Title
Transistor Clock - Schmitt Trigger

1

2

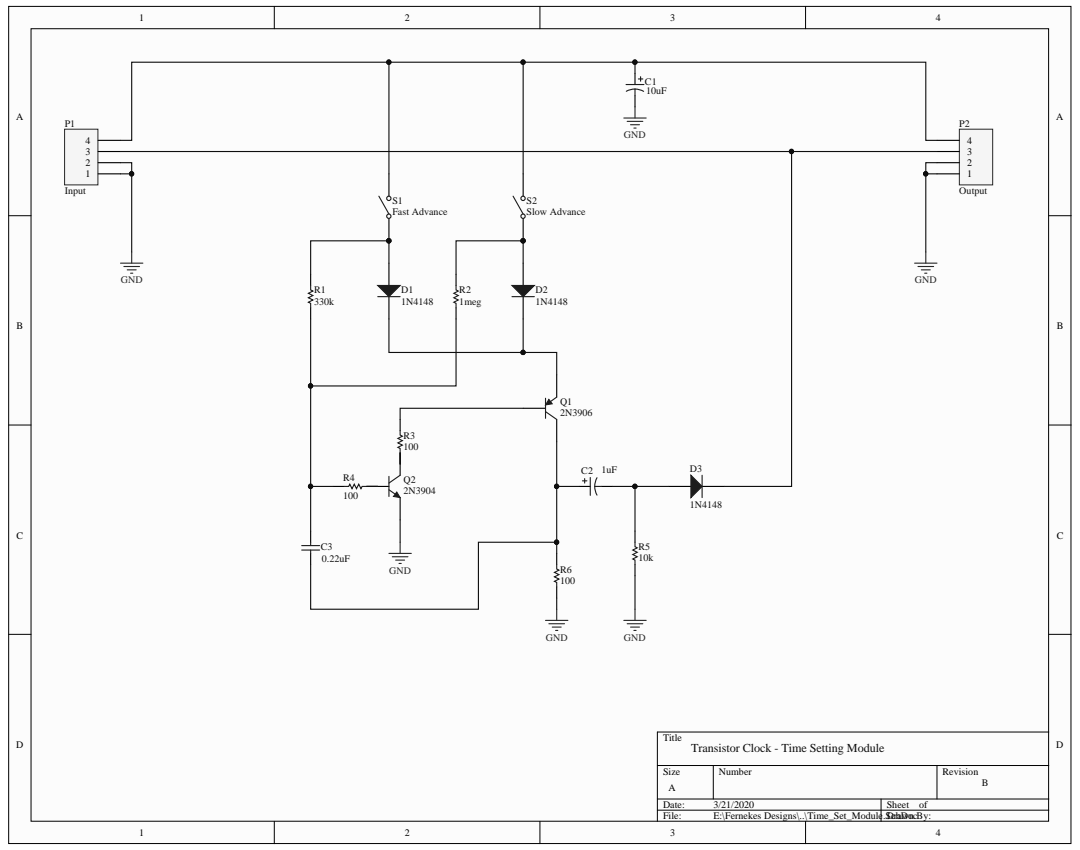
[picture p168: page 4]

Title
Transistor Clock - Time Setting Module

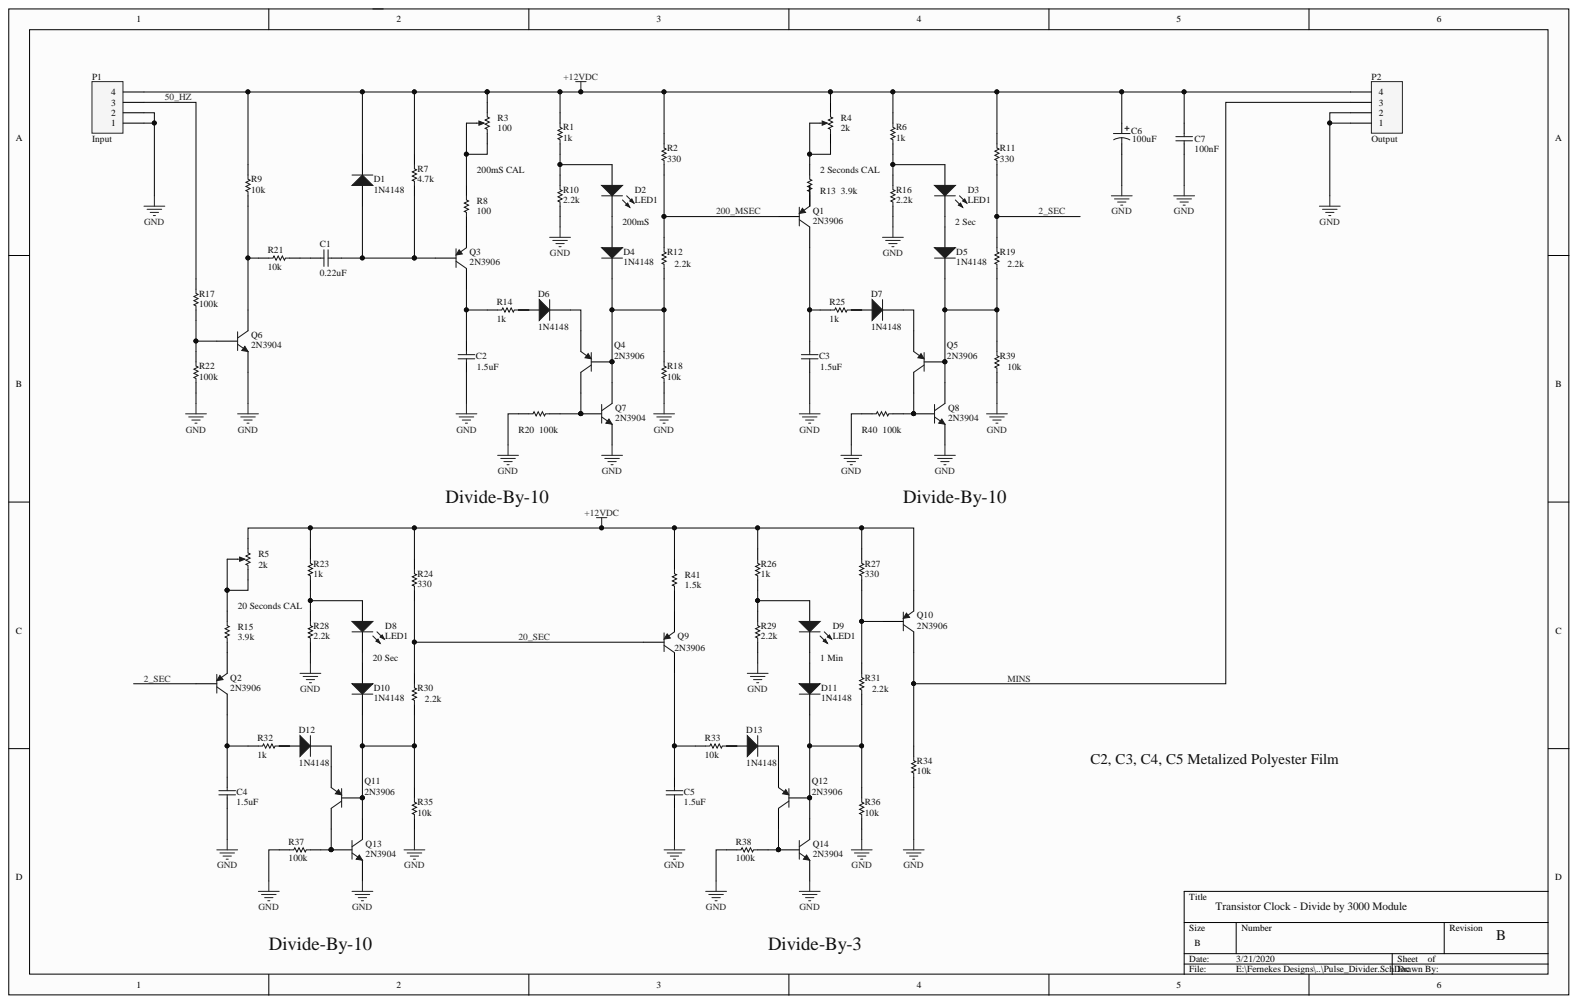
[picture p169: page 5]

Transistor Clock - Divide by 3000 Module

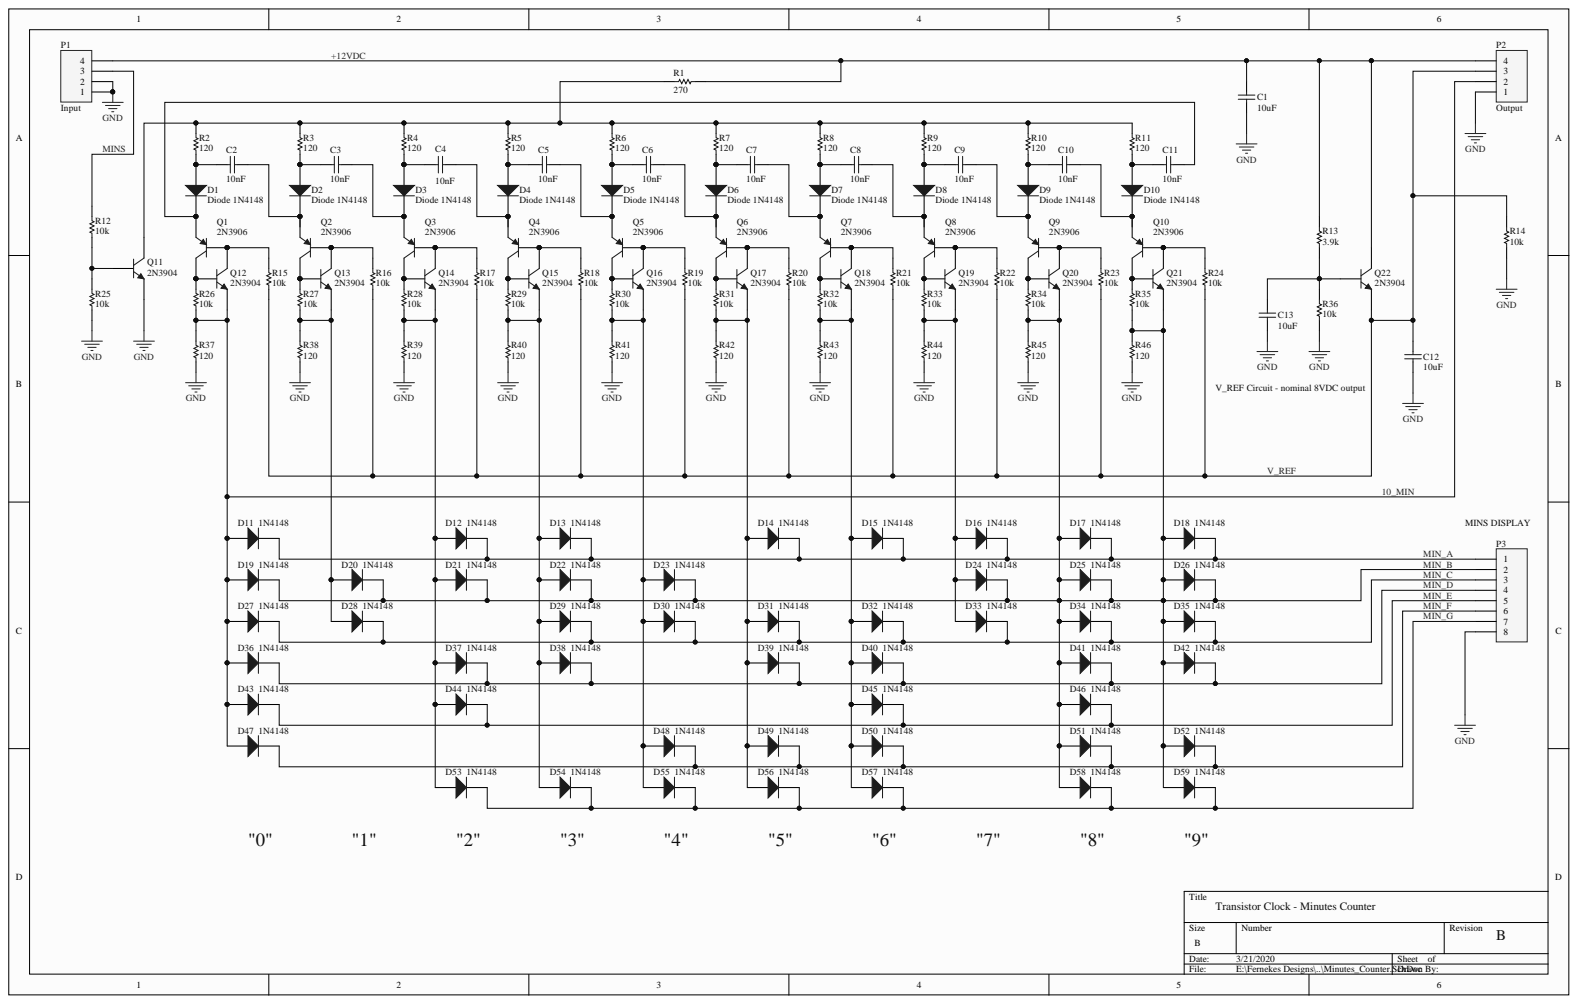
[picture p170: page 6]

Transistor Clock - Minutes Counter

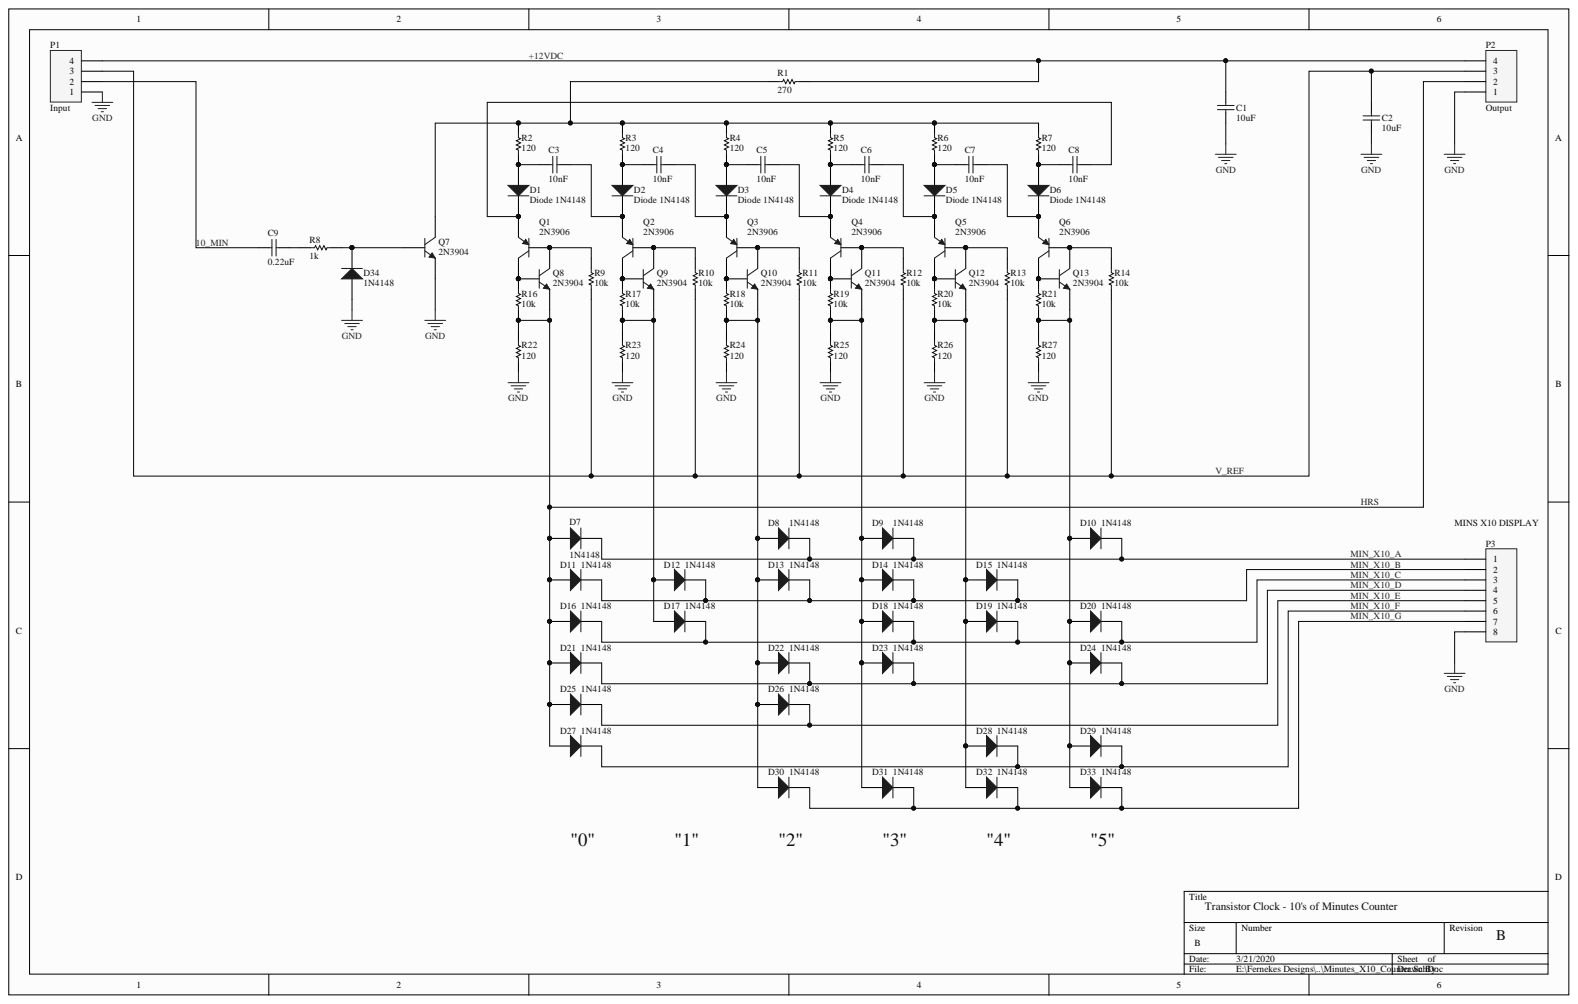
[picture p171: page 7]

Transistor Clock - 10's of Minutes Counter

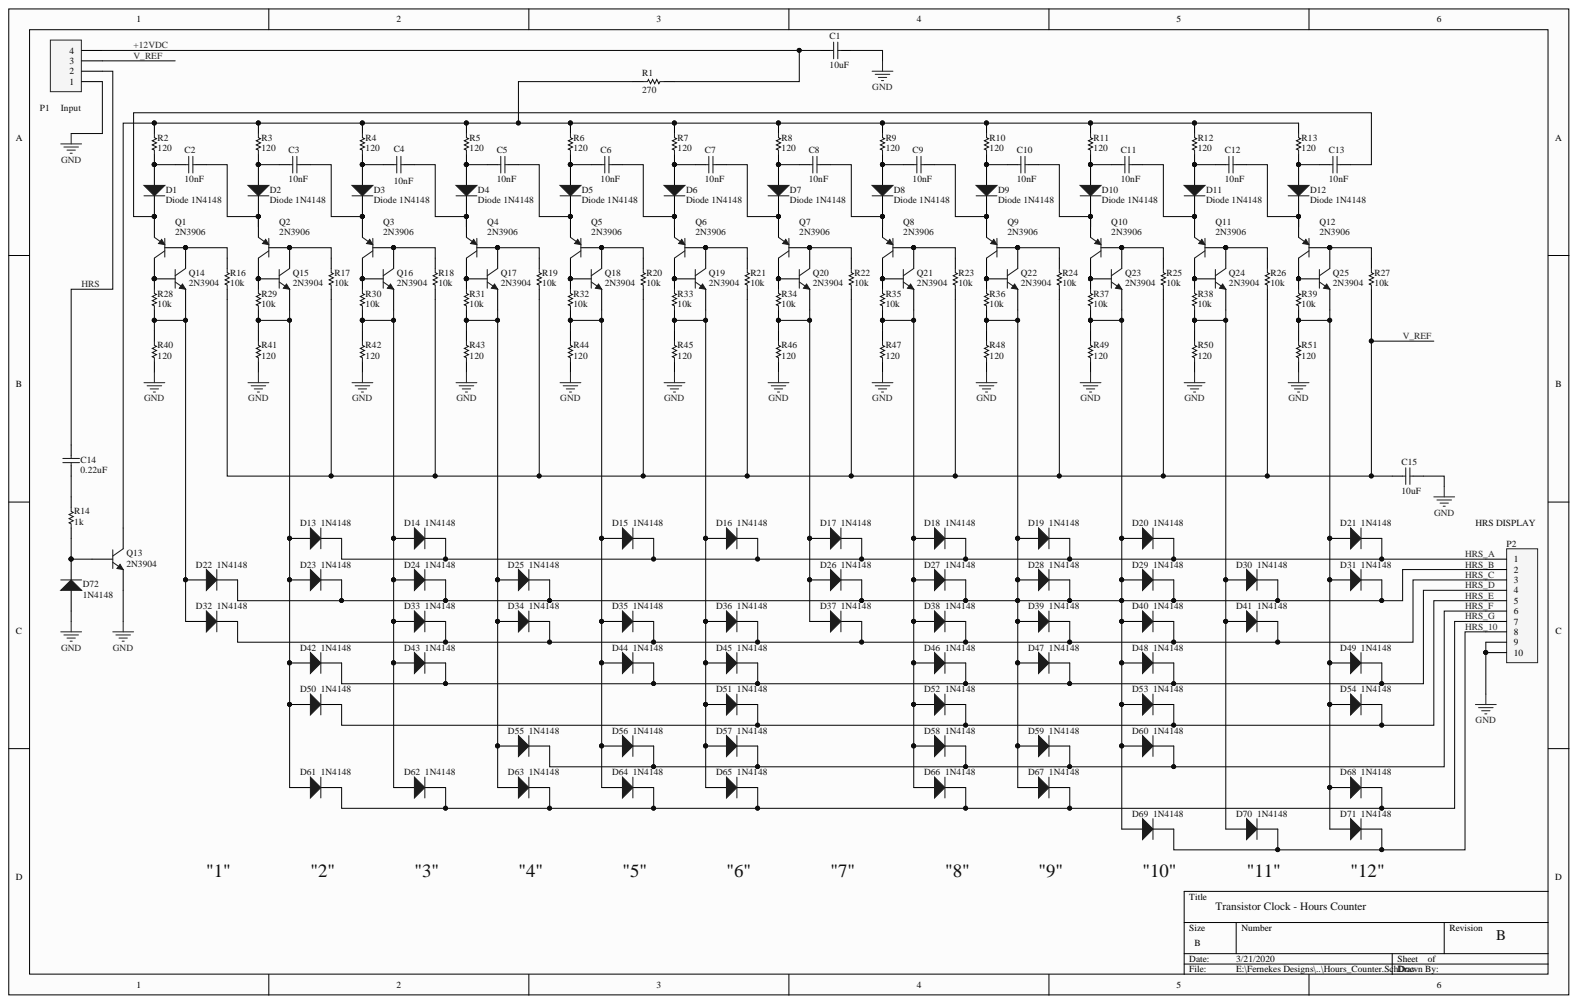
[picture p172: page 8]

Transistor Clock - Hours Counter

"A"

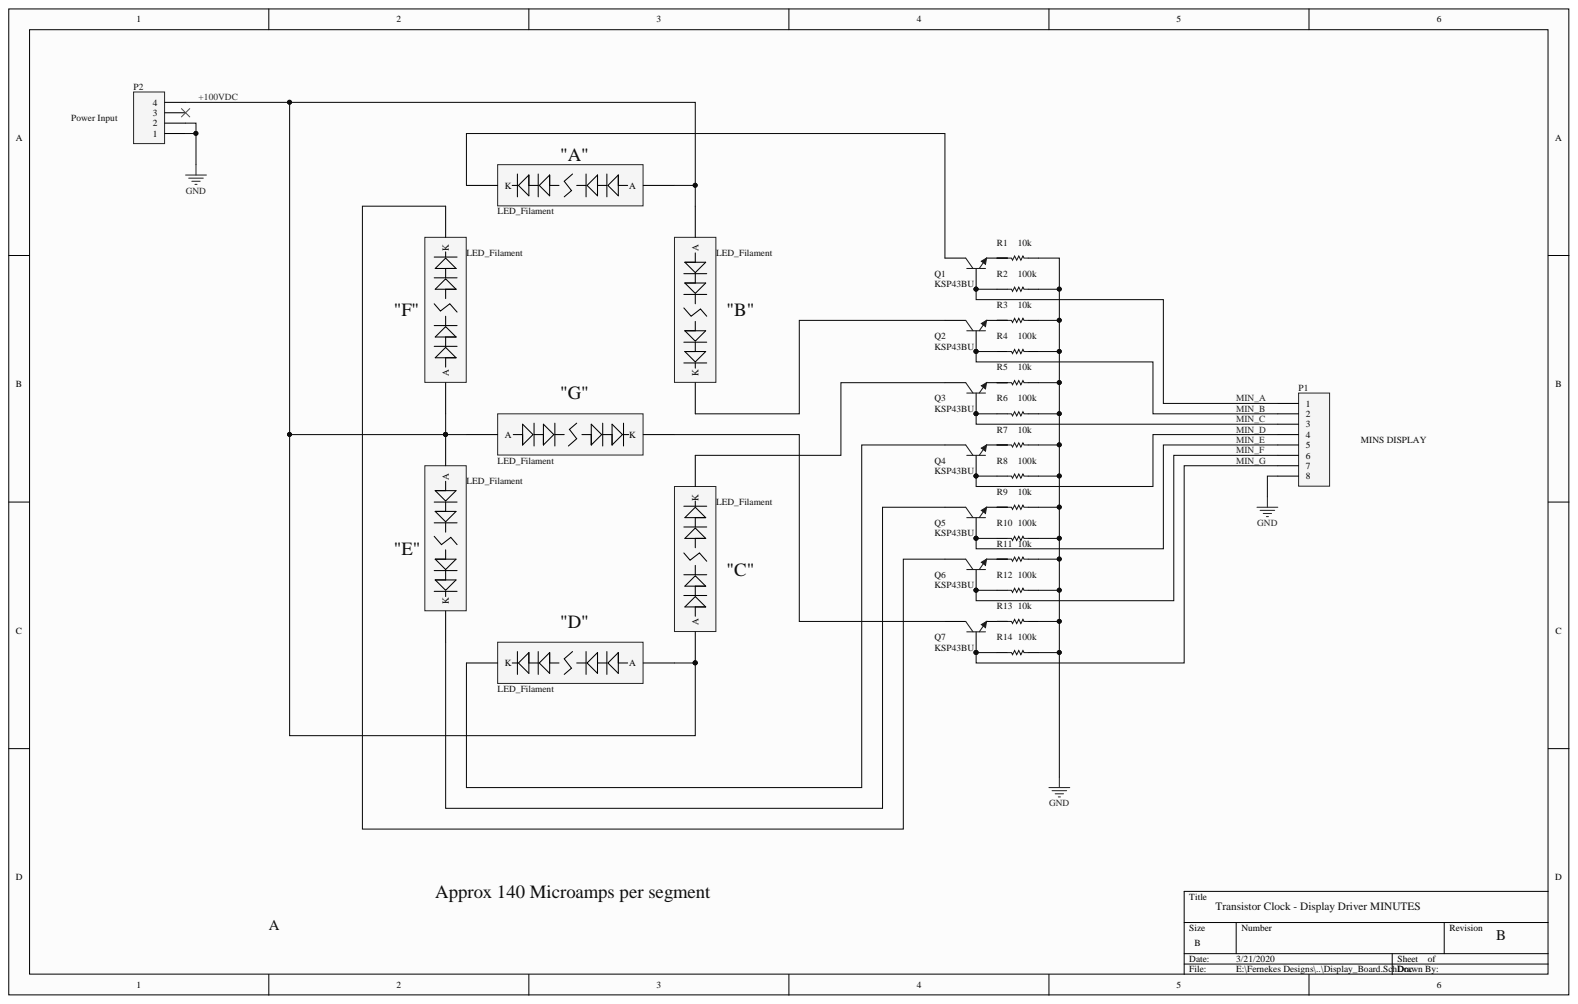
[picture p173: page 9]

Approx 140 Microamps per segment

Transistor Clock - Display Driver MINUTES

"A"

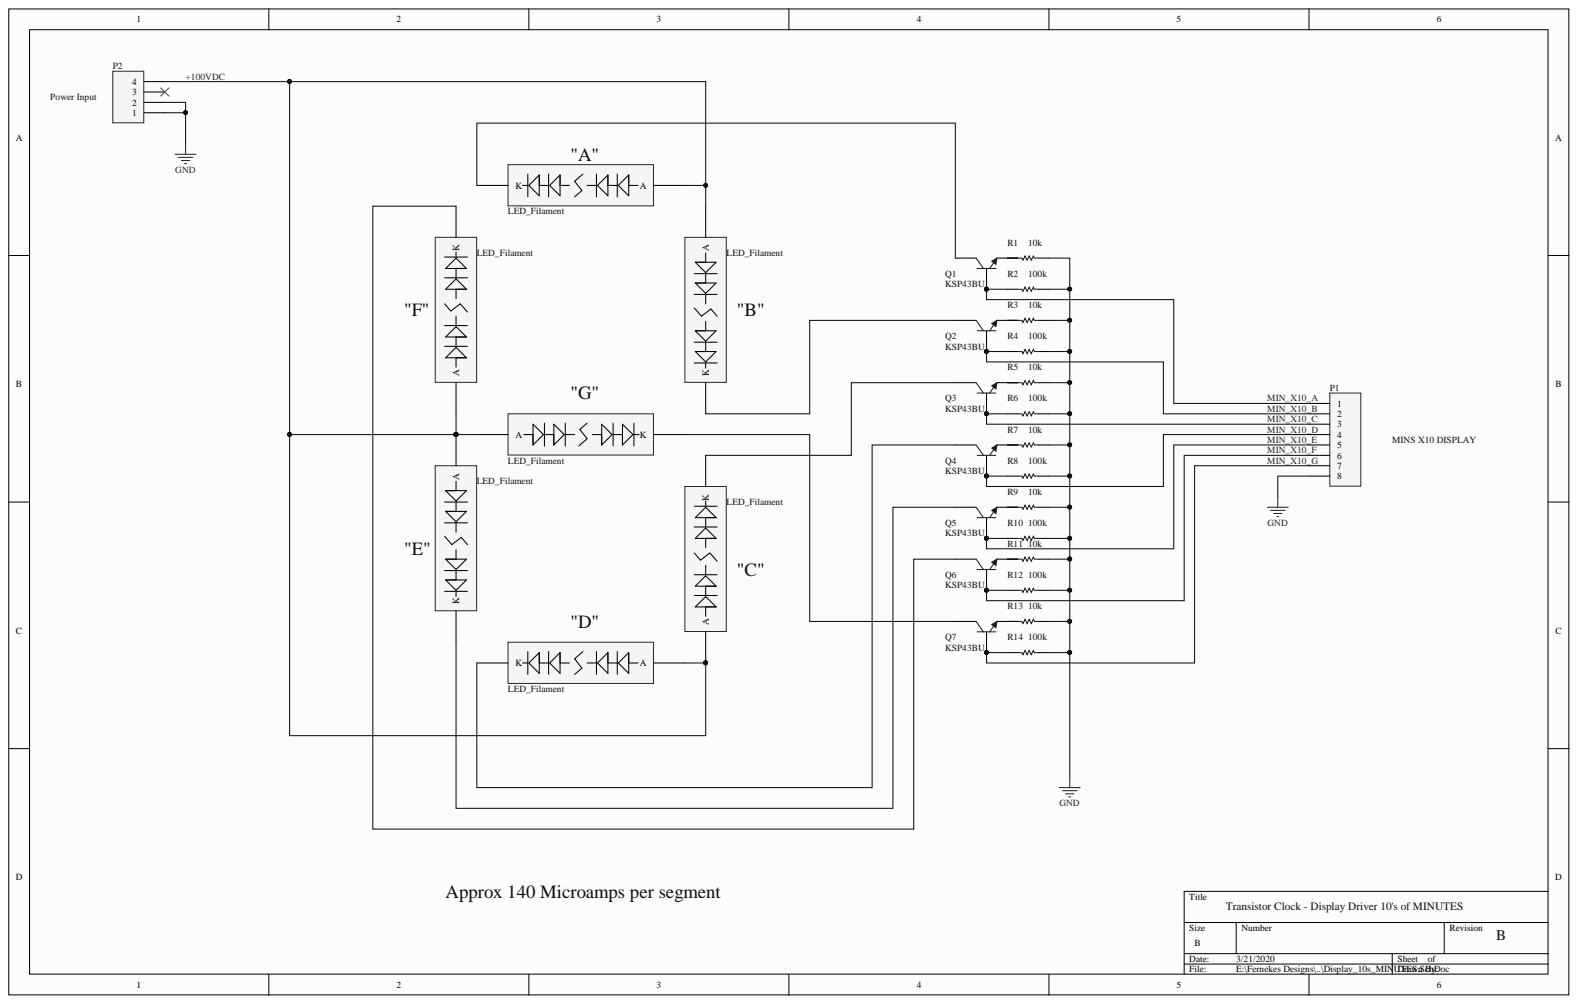
[picture p174: page 10]

Approx 140 Microamps per segment

Transistor Clock - Display Driver 10's of MINUTES

"A"

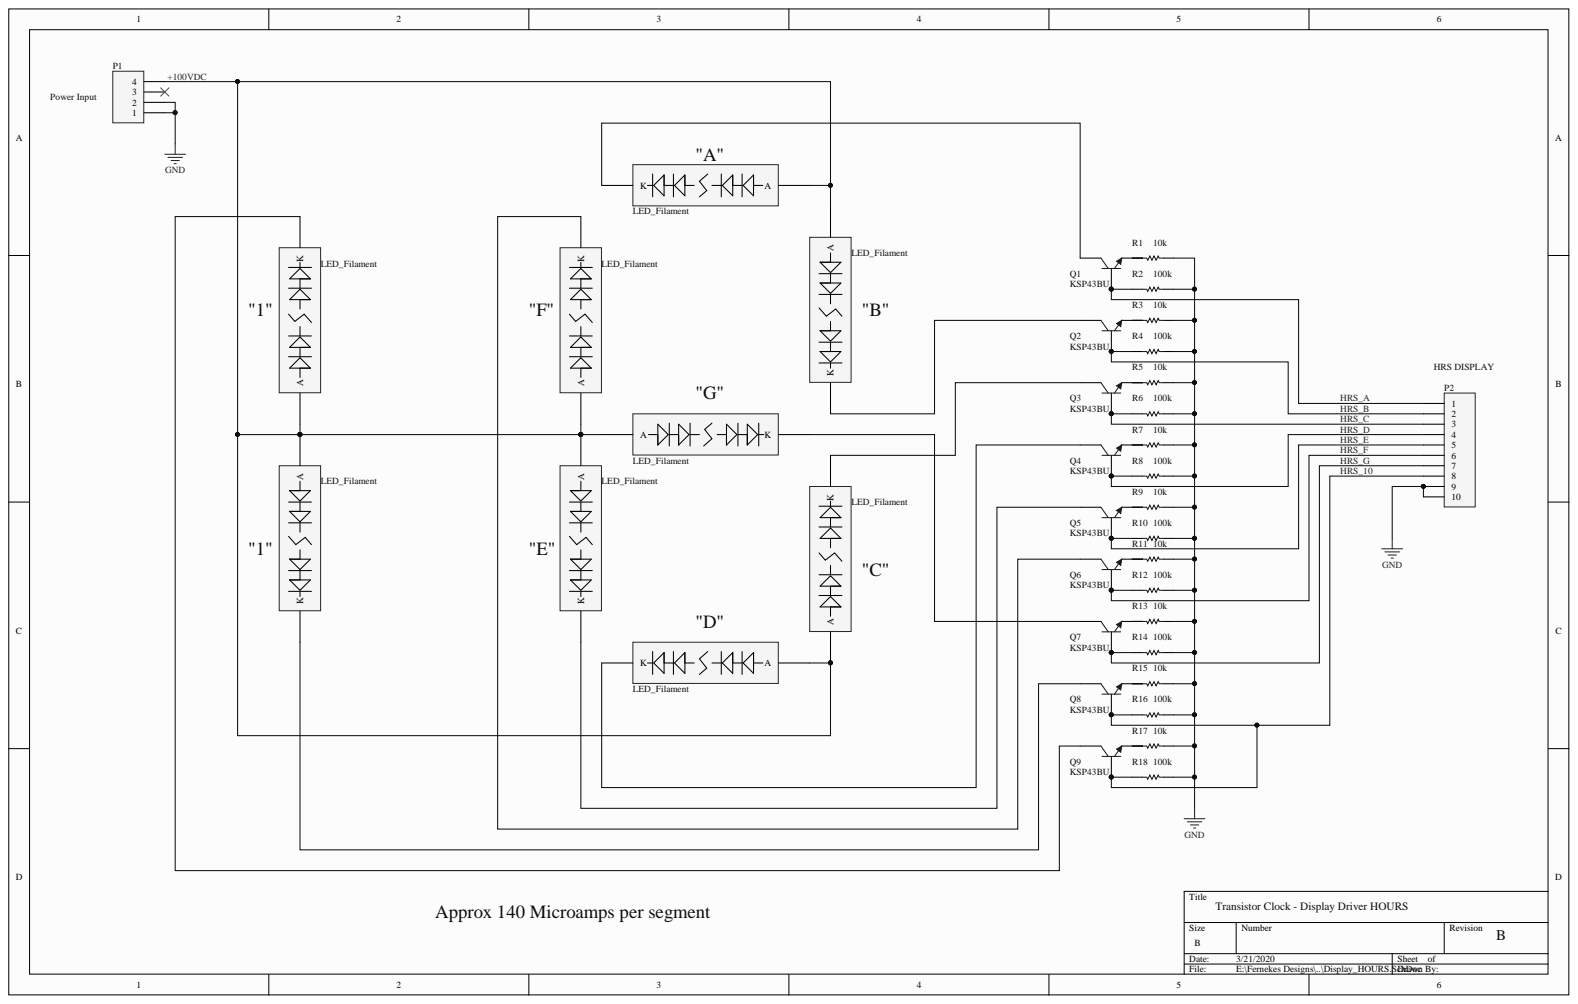
[picture p175: page 11]

Approx 140 Microamps per segment

Transistor Clock - Display Driver HOURS
