reivax-boucoi/PCB_Kicad/LED_poi/CTRL_board/LED_poi_schematic.pdf

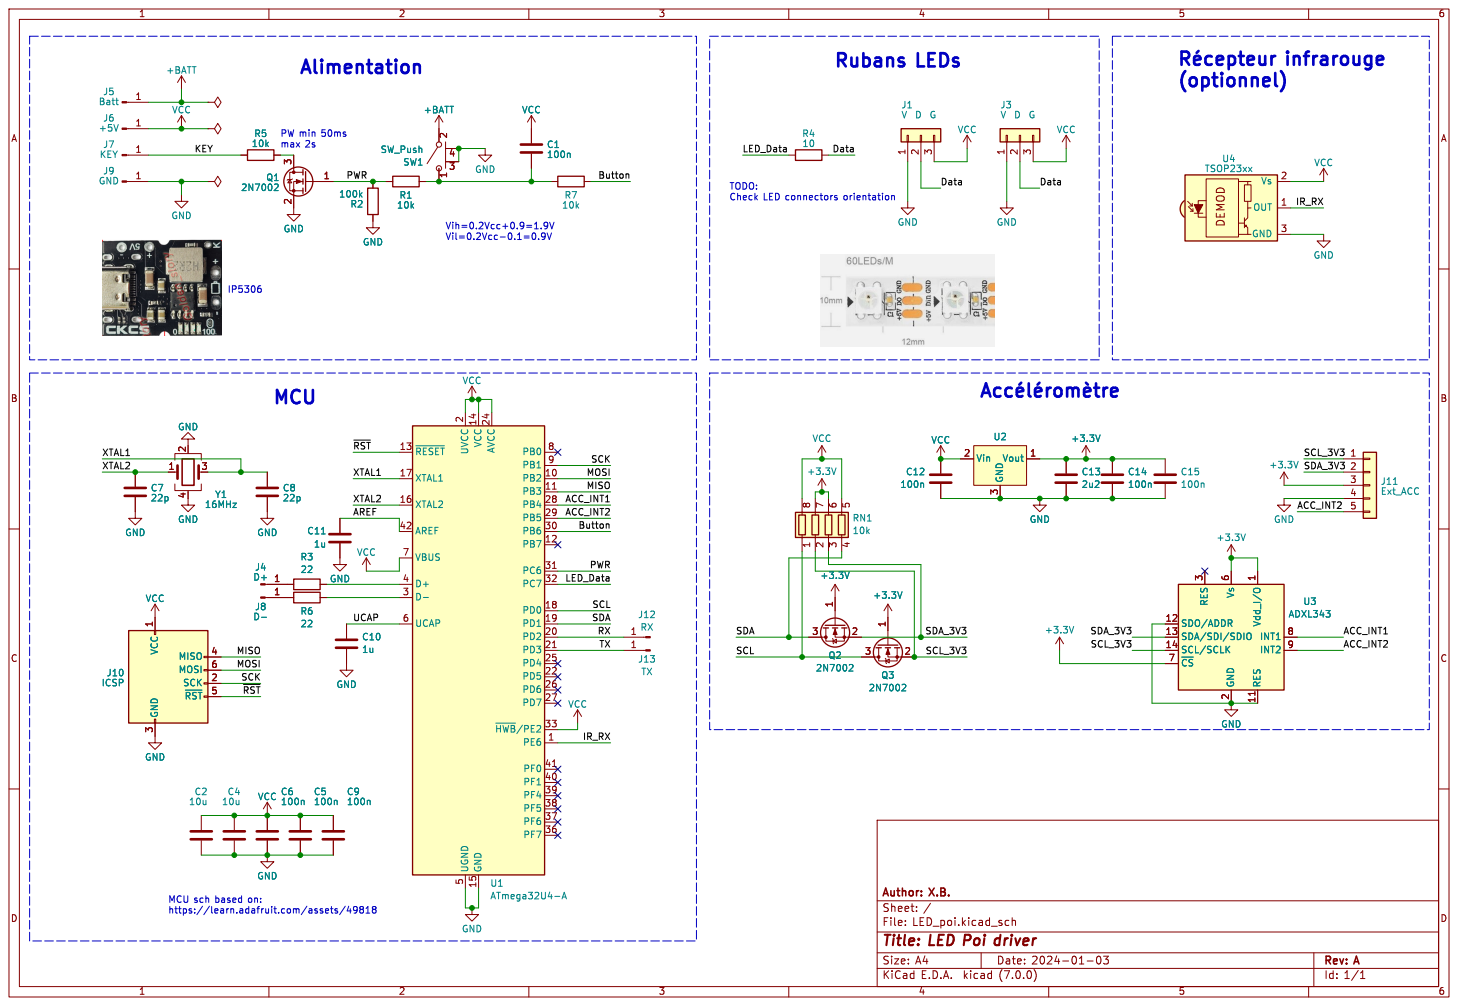
[picture p176: page 1]

SW1 SW_Push
~{RST} MOSI MCU sch based on: https://learn.adafruit.com/assets/49818

3 MISO 4 ~{RST}5 MOSI 6 GND GND

22 VCC
Id: 1/1 Title: LED Poi driver File: LED_poi.kicad_sch Sheet: / Author: X.B. GND VCC

1 RES 11 SDO/ADDR 12 SDA/SDI/SDIO 13 SCL/SCLK 14 GND
