reivax-boucoi/PCB_Kicad/weight_scale/Hardware/weight_scale.pdf

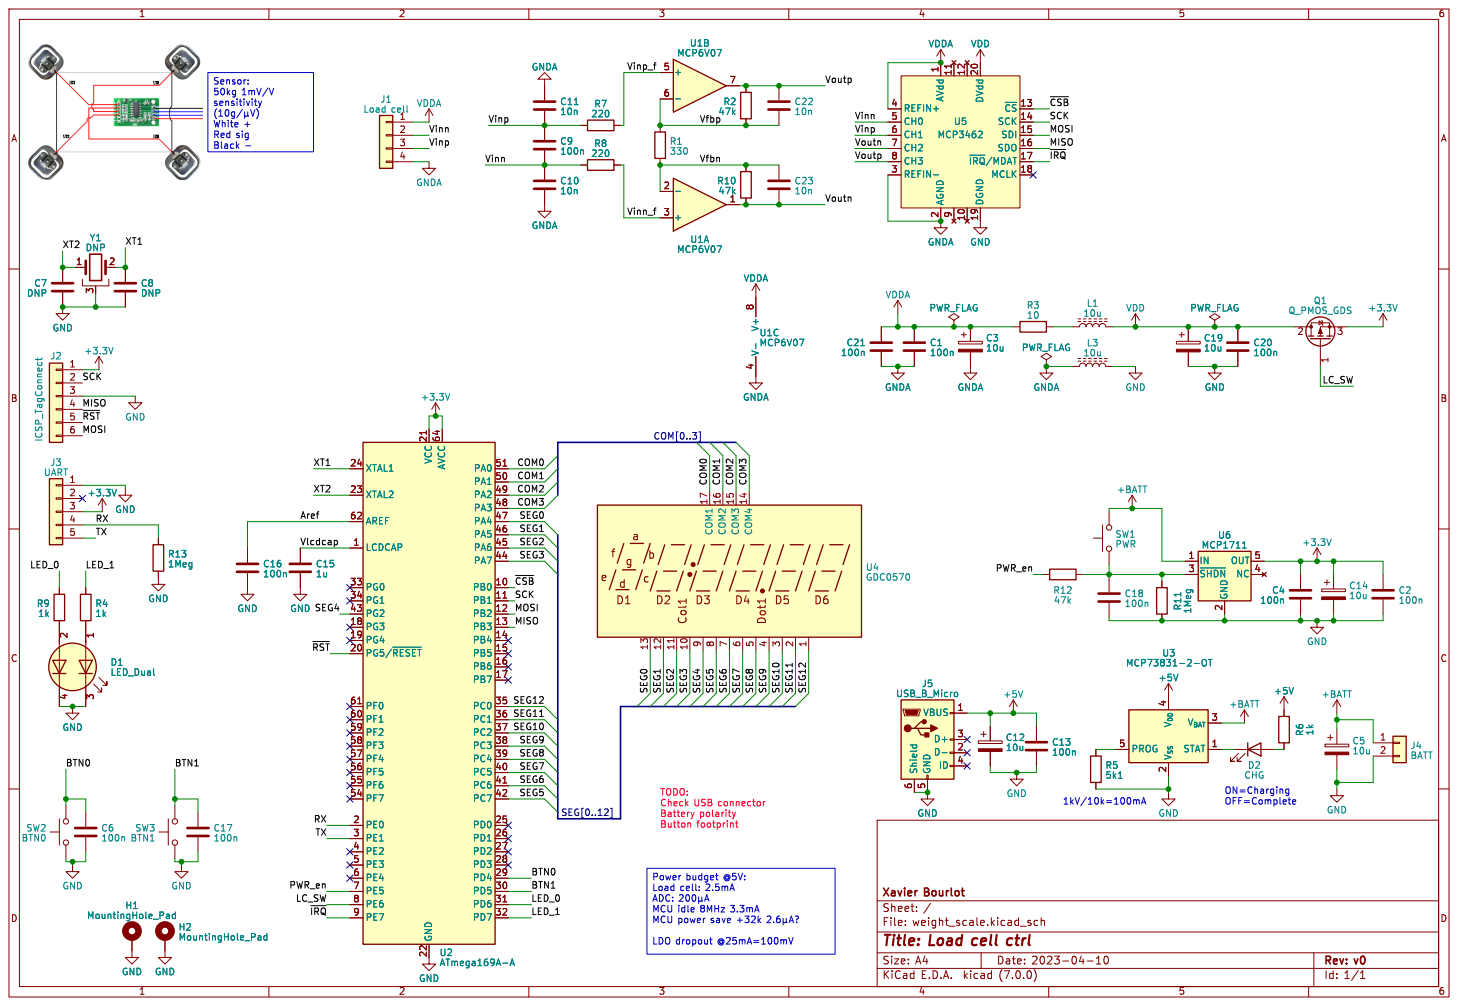
[picture p177: page 1]

Voutn Voutp SEG5 Vinn Vinp

TODO: Check USB connector Battery polarity Button footprint
OFF=Complete Power budget @5V: Load cell: 2.5mA

ADC: þÿ200µA MCU idle 8MHz 3.3mA MCU power save +32k þÿ2.6µA?
