reivax-boucoi/PCB_Kicad/Kheprism/HW/PCB_Ventil/PCB_Ventil_schematic.pdf

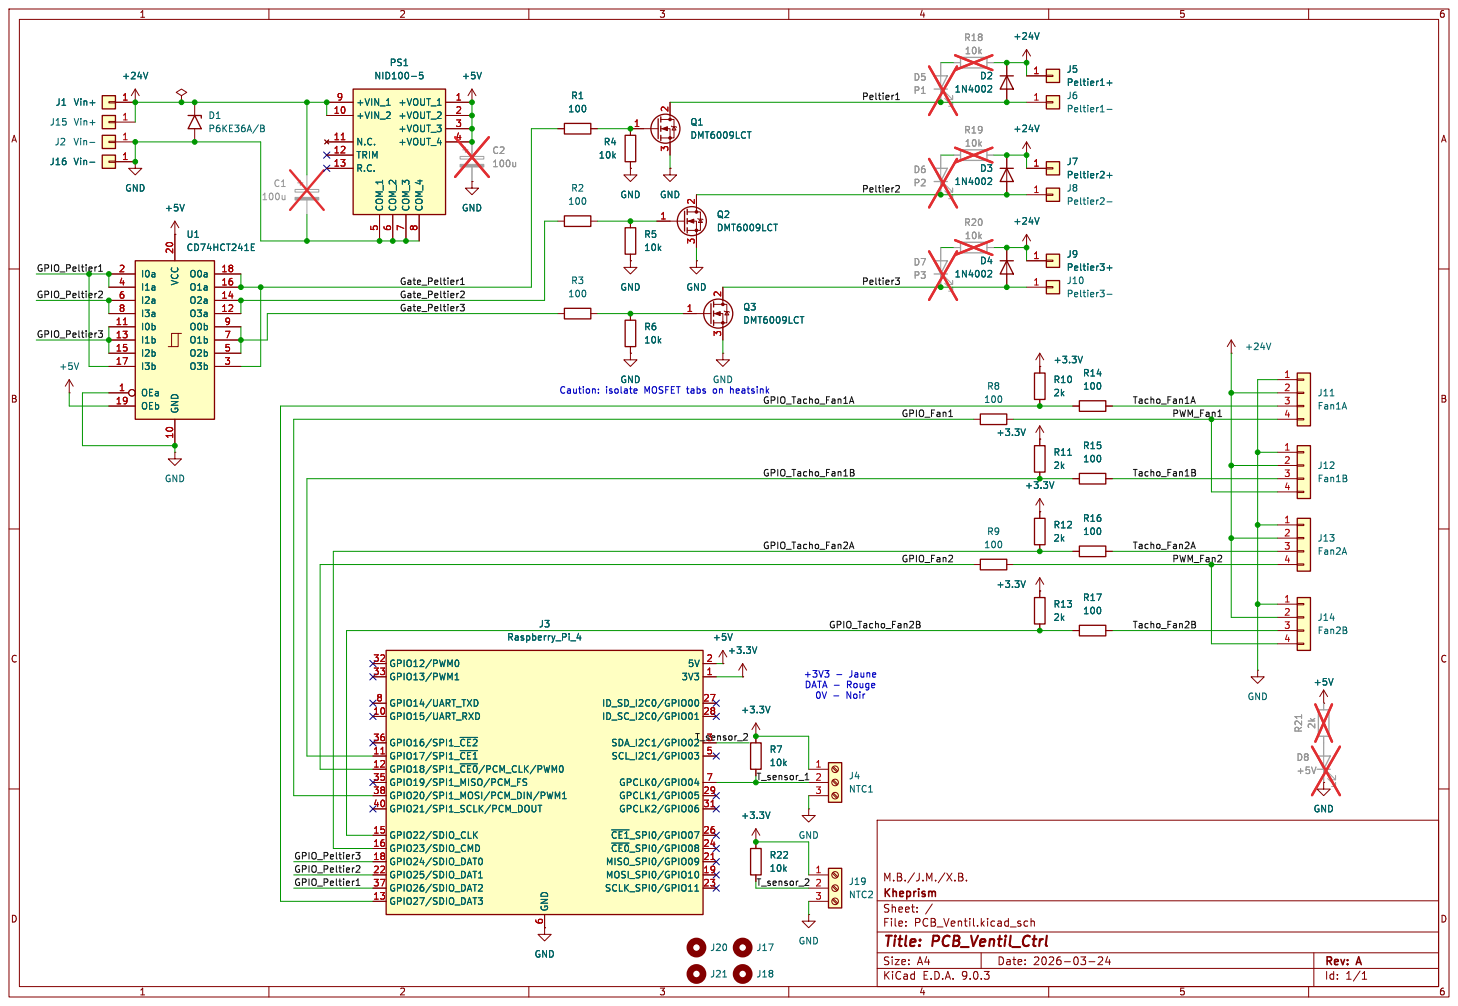
[picture p178: page 1]

Id: 1/1 Title: PCB_Ventil_Ctrl File: PCB_Ventil.kicad_sch Sheet: / Kheprism
