reivax-boucoi/PCB_Kicad/horse_feeder/HW/PCB_v2_M590E/horse_feeder_schematic.pdf

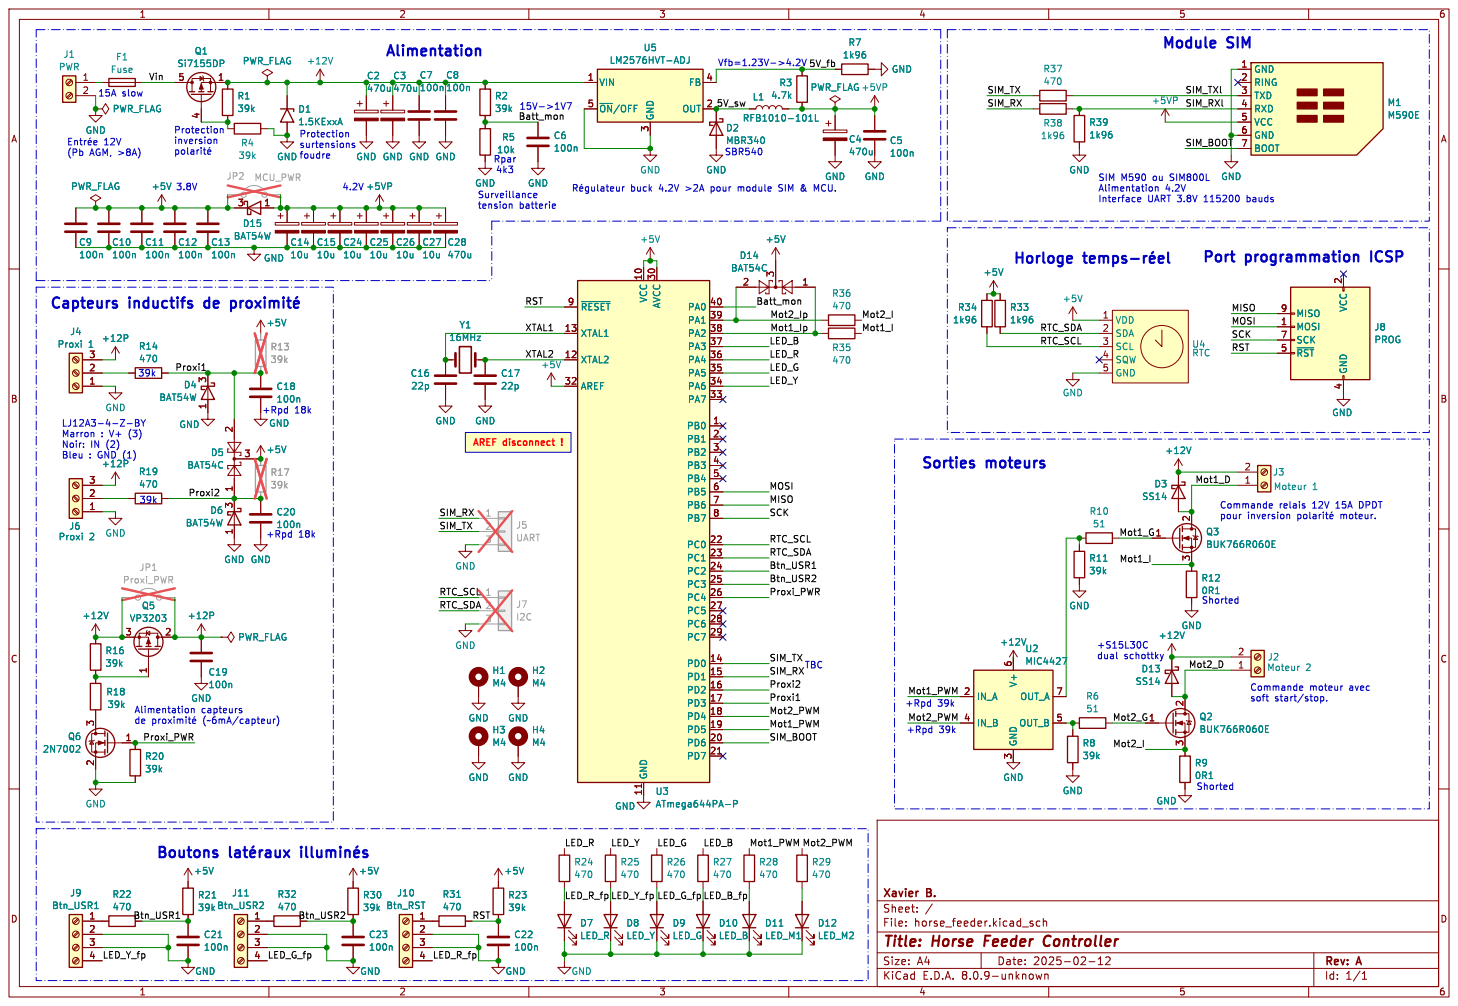
[picture p179: page 1]

3 FB 4 ~{ON}/OFF 5 GND

BOOT 7 GND 1 RING 2 TXD 3 RXD 4 VCC 5 GND 6 +5V R34

þÿRégulateur buck 4.2V >2A pour module SIM & MCU. TBC

Shorted Shorted Commande relais 12V 15A DPDT
