reivax-boucoi/PCB_Kicad/RCP_PWM_breakout/RCP_PWM_breakout.pdf

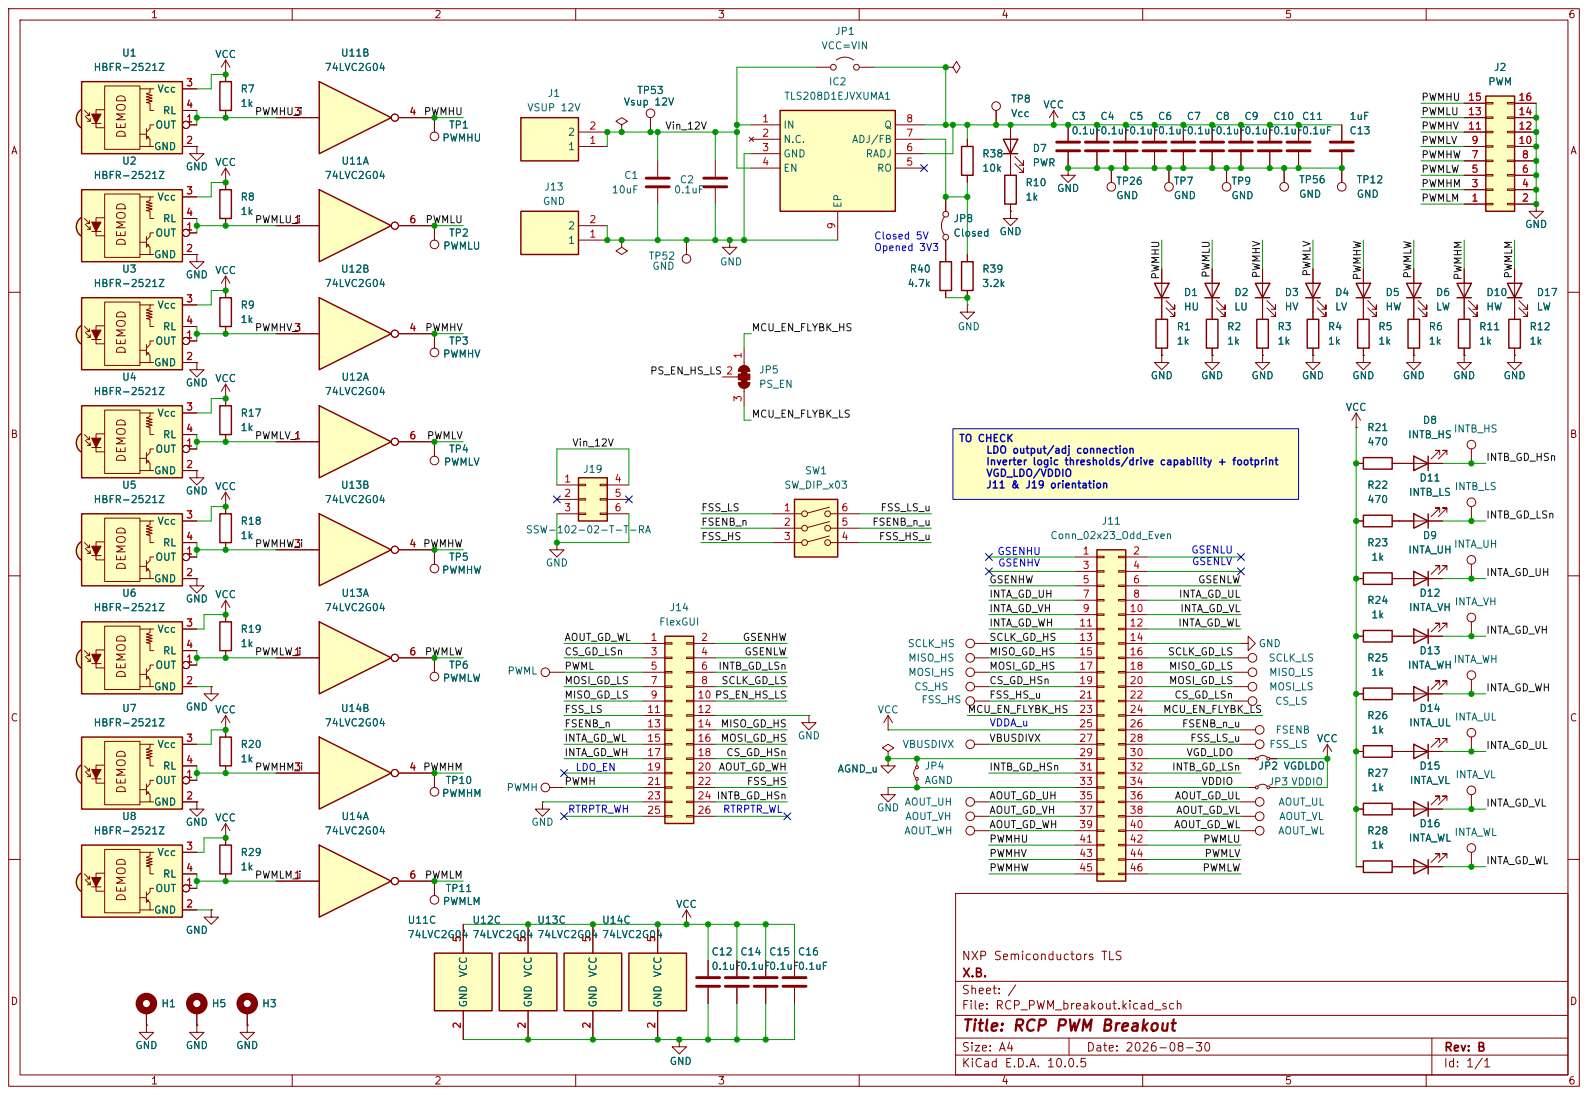
[picture p180: page 1]

TO CHECK
LDO output/adj connection
INTB_GD_HSn PWMHV
Inverter logic thresholds/drive capability + footprint
VGD_LDO/VDDIO

Size: A4 | Rev: B
KiCad E.D.A. 10.0.5 | Id: 1/1
