reivax-boucoi/PCB_Kicad/bike_lights2/bike_lights2.pdf

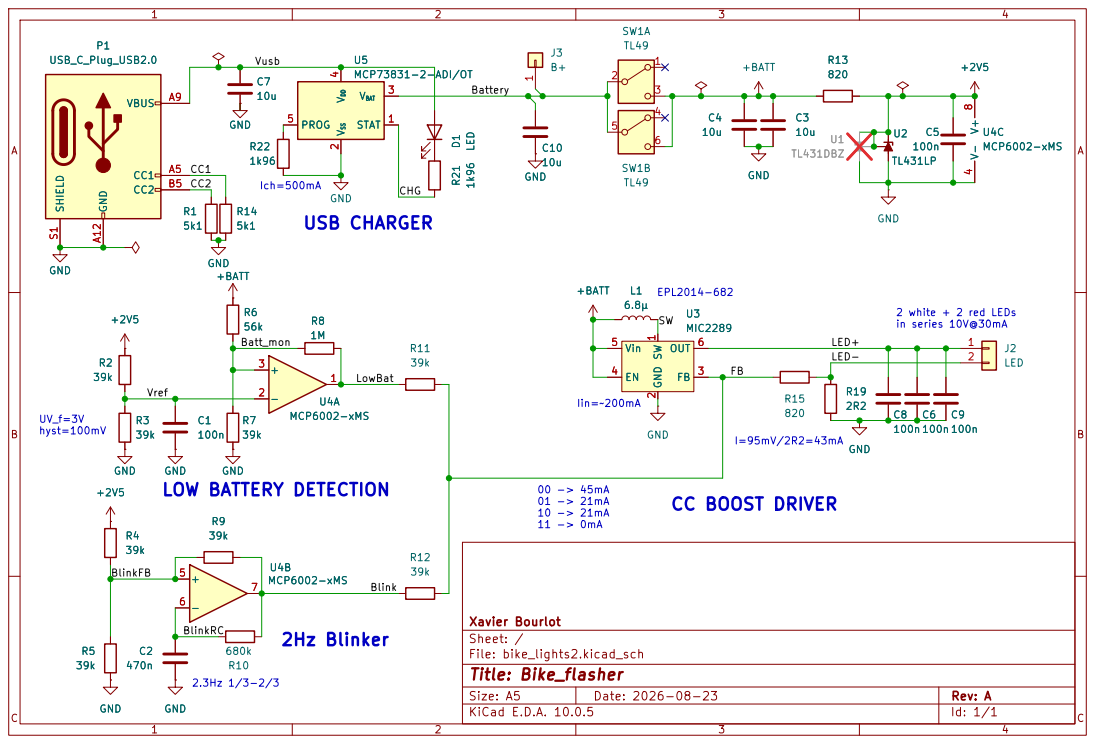
[picture p181: page 1]

VDD 4 PROG 5 U5MCP73831-2-ADI/OTD1 LED

Size: A5 | Rev: A | C Date: 2026-08-23
KiCad E.D.A. 10.0.5 | Id: 1/1
