reivax-boucoi/PCB_Kicad/split-flap-display2/split-flap-display2.pdf

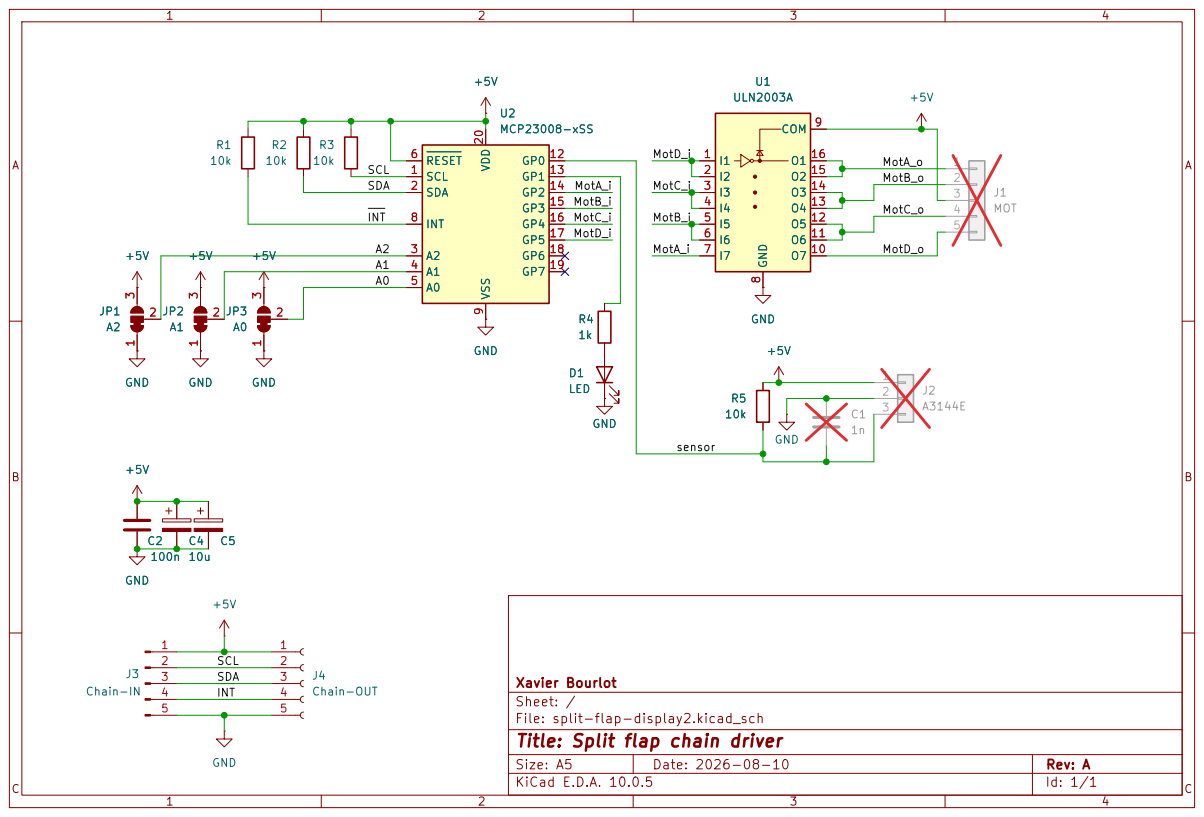
[picture p182: page 1]

Sheet: /
File: split-flap-display2.kicad_sch
Title: Split flap chain driver

Size: A5 | Rev: A | C Date: 2026-08-10
KiCad E.D.A. 10.0.5 | Id: 1/1
