reivax-boucoi/PCB_Kicad/bike_speed_sensor/bike_speed_sensor.pdf

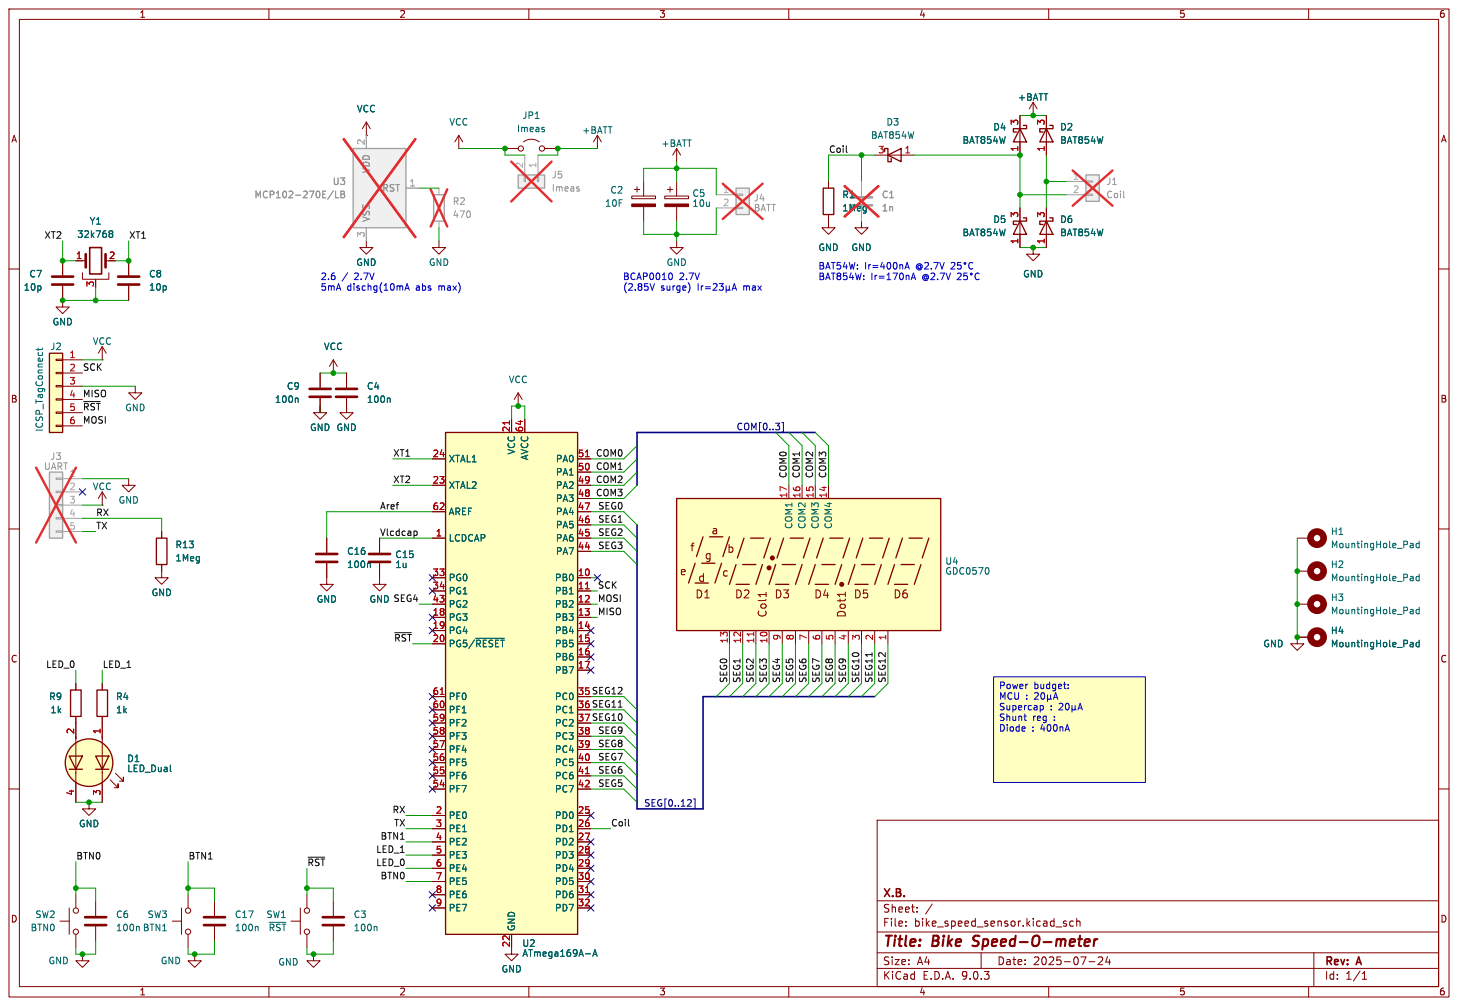
[picture p183: page 1]

3 RST 1 GND GND GND

Id: 1/1 Title: Bike Speed-O-meter File: bike_speed_sensor.kicad_sch Sheet: / X.B. R9
