reivax-boucoi/PCB_Kicad/HTOL_pulser/HTOL_pulser.pdf

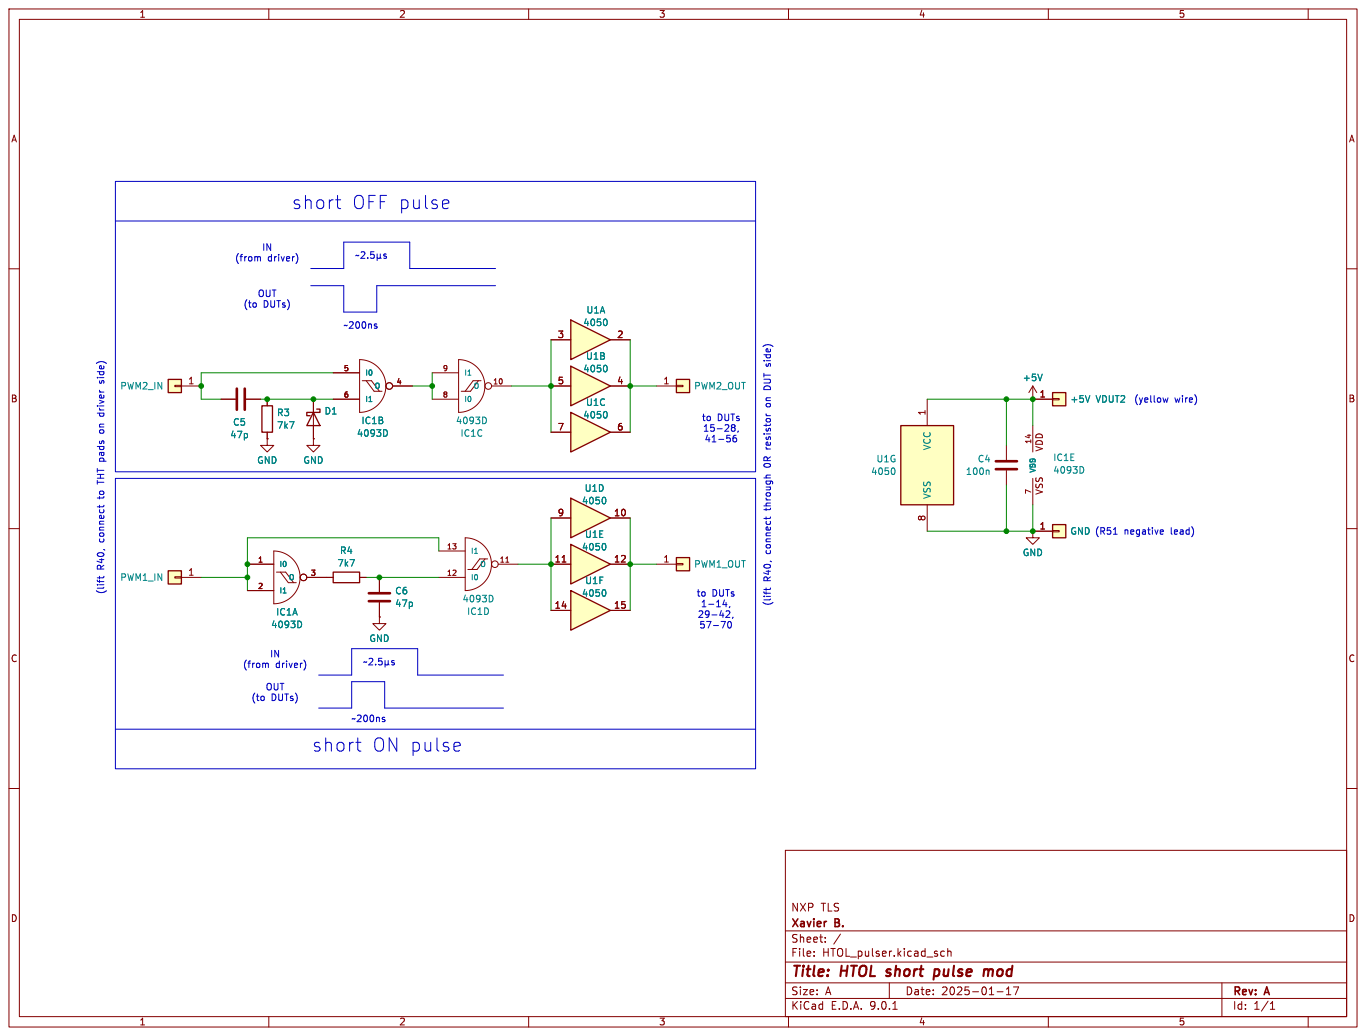
[picture p184: page 1]

(from driver) (lift R40, connect to THT pads on driver side)
1 PWM2_IN

Id: 1/1 Title: HTOL short pulse mod
