reivax-boucoi/PCB_Kicad/elevator_altimeter/elevator_altimeter.pdf

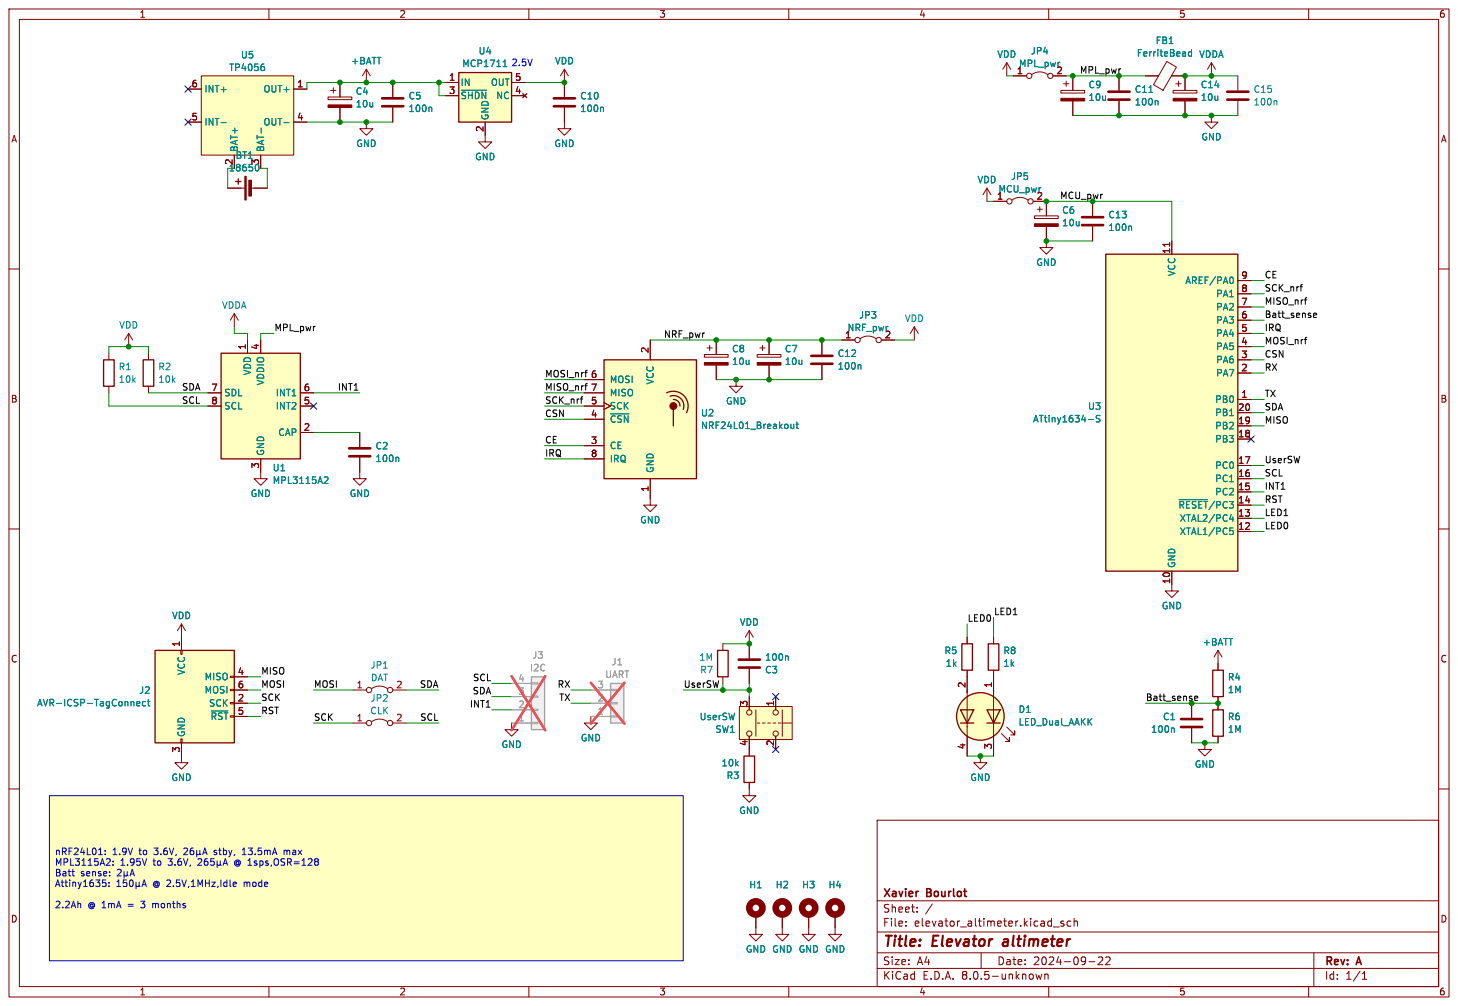
[picture p185: page 1]

2 ~{SHDN} 3 NC 4 OUT 5 U4 MCP1711 GND GND

2 ~{SHDN} 3 NC 4 OUT 5 GND

2 CE 3 ~{CSN} 4 SCK 5 MOSI 6 MISO 7

nRF24L01: 1.9V to 3.6V, þÿ26µAstby, 13.5mA max MPL3115A2: 1.95V to 3.6V, þÿ265µA@ 1sps,OSR=128 Batt sense: þÿ2µA
