reivax-boucoi/PCB_Kicad/RGB_strip_driver/RGB_strip_driver.pdf

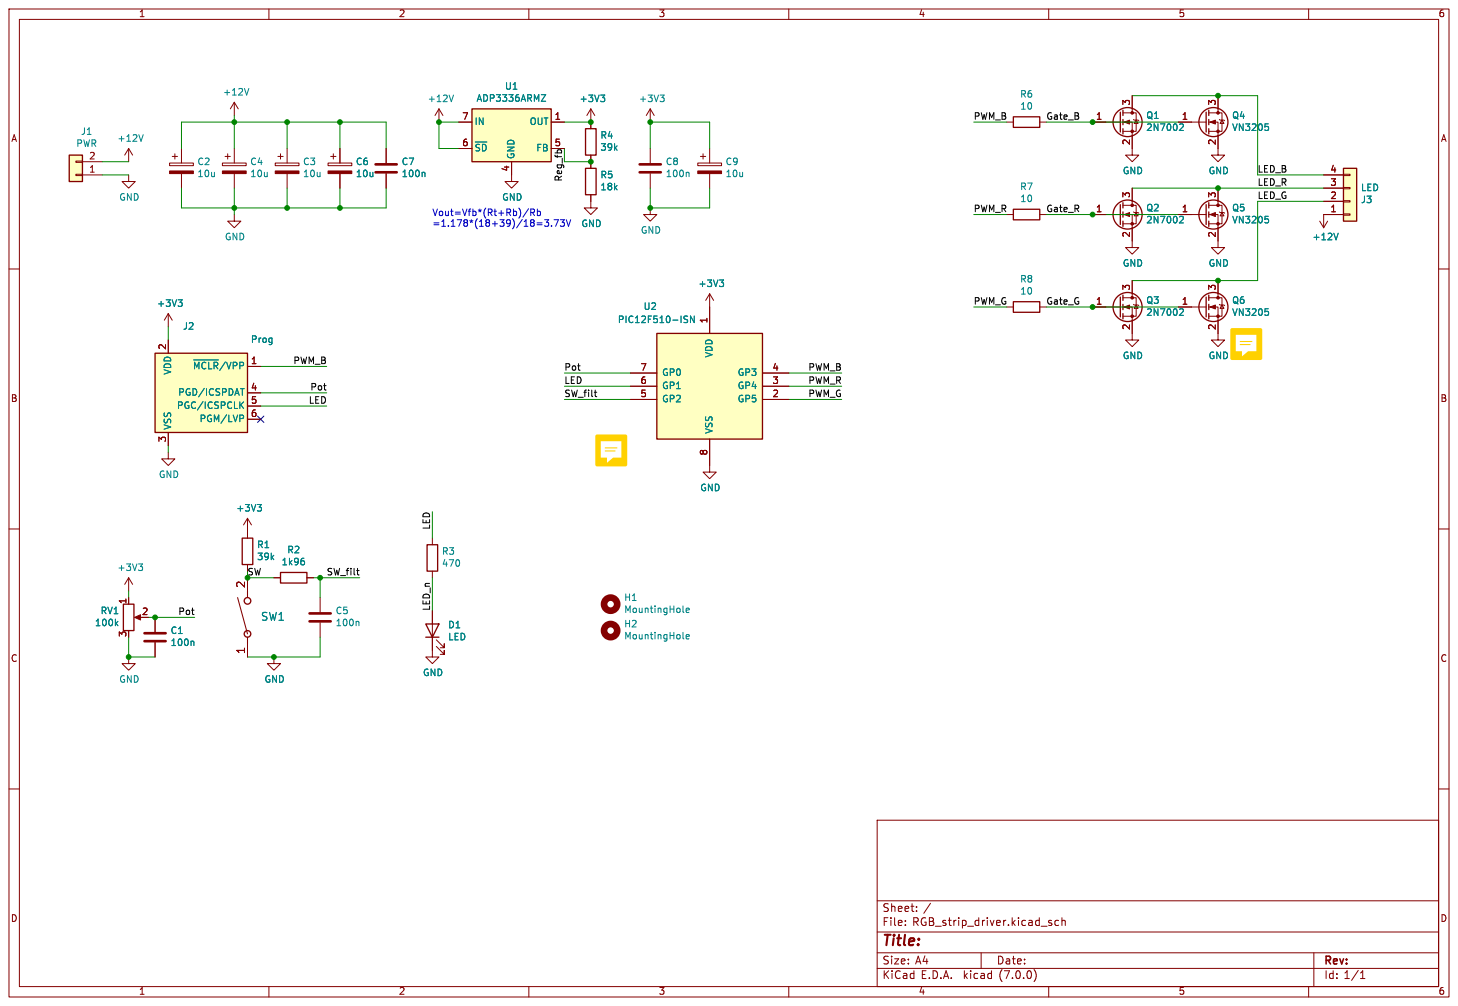
[picture p186: page 1]

3 PGD/ICSPDAT 4 PGC/ICSPCLK 5 PGM/LVP 6 GND Q2

Vout=Vfb*(Rt+Rb)/Rb

3 PGD/ICSPDAT 4 PGC/ICSPCLK 5 PGM/LVP 6

Id: 1/1 Title: File: RGB_strip_driver.kicad_sch Sheet: /
