reivax-boucoi/PCB_Kicad/relay_brd/relay_brd.pdf

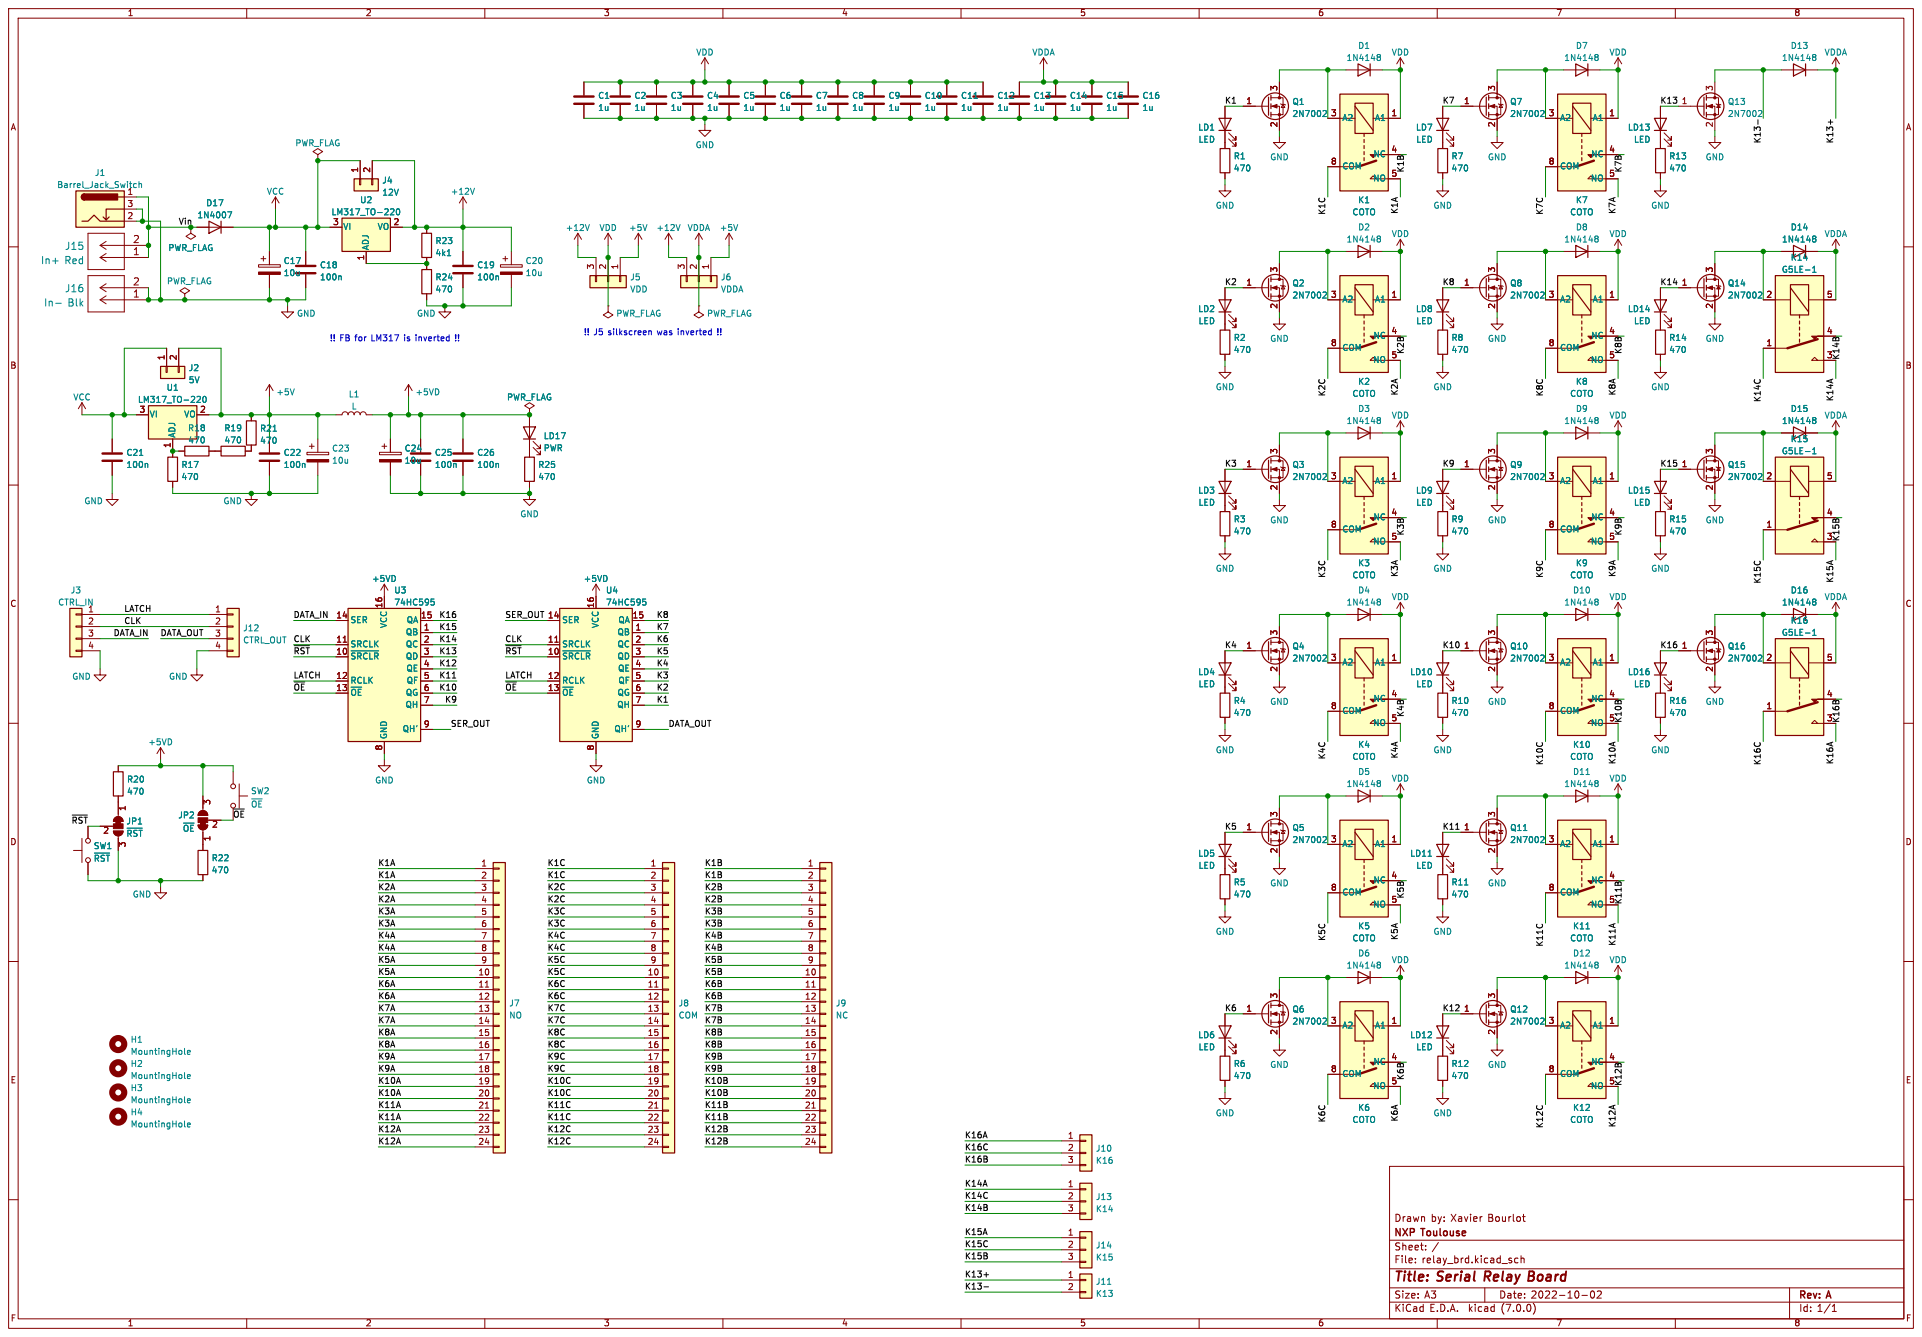
[picture p187: page 1]

Id: 1/1 Title: Serial Relay Board
