reivax-boucoi/PCB_Kicad/hv_discharge_v2/hv_discharge.pdf

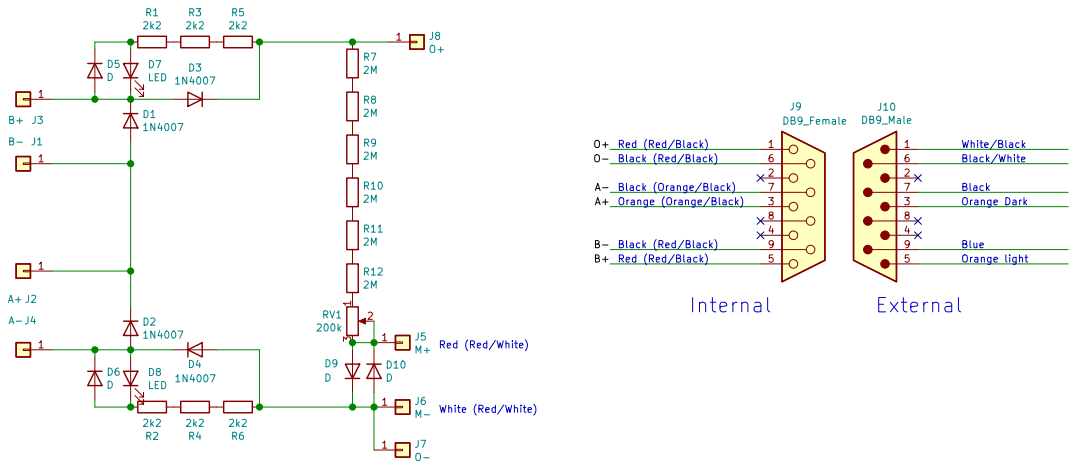
[picture p188: page 1]

Id: 1/1 Title: Z+ HV discharge, series and meter circuit
