reivax-boucoi/PCB_Kicad/hall_sensor_matrix/hall_sensor_matrix_v2/hall_sensor_matrix_v2.pdf

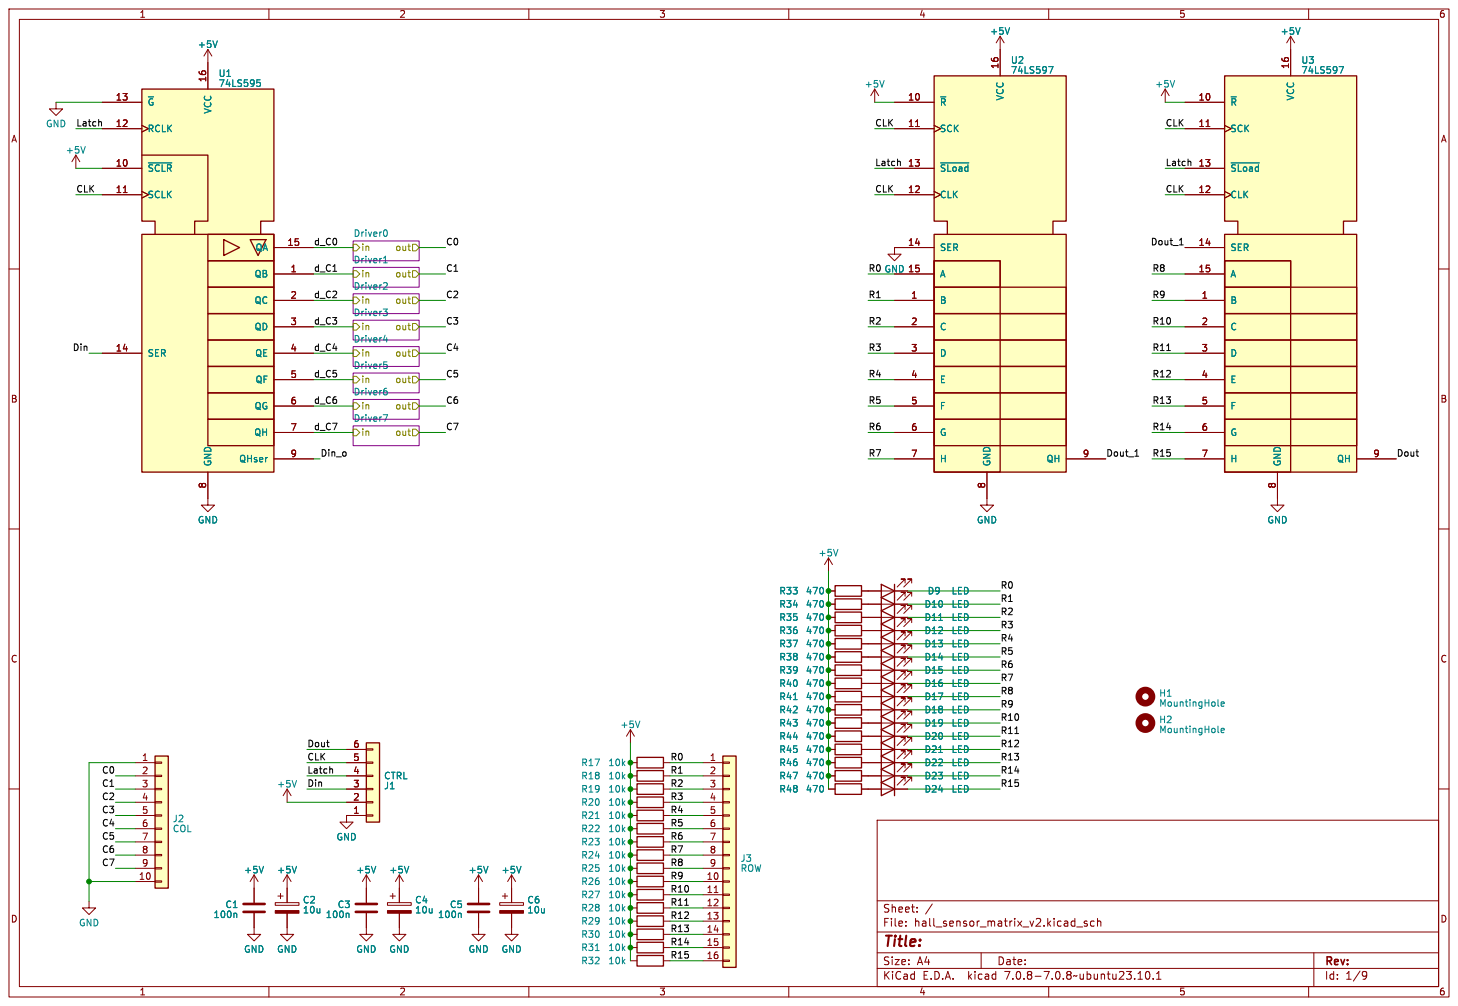
[picture p190: page 1]

Id: 1/9 Title: File: hall_sensor_matrix_v2.kicad_sch Sheet: /

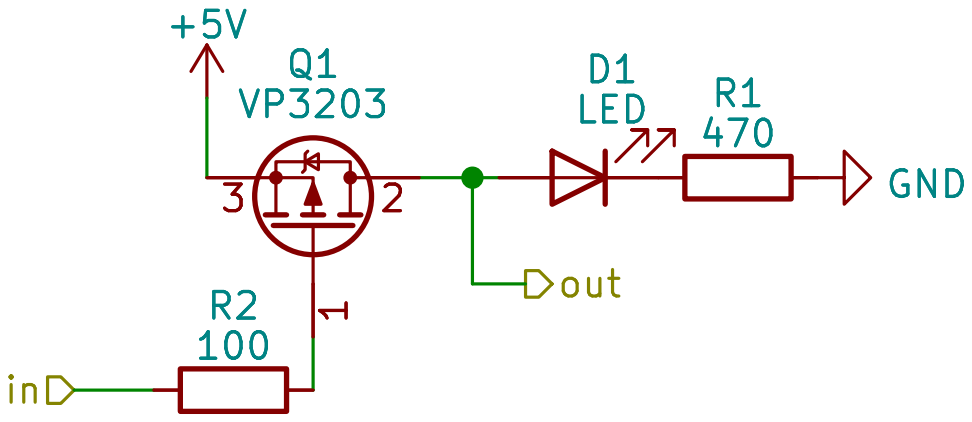
[picture p191: page 2]

Id: 2/9 Title: File: driver.kicad_sch Sheet: /Driver0/

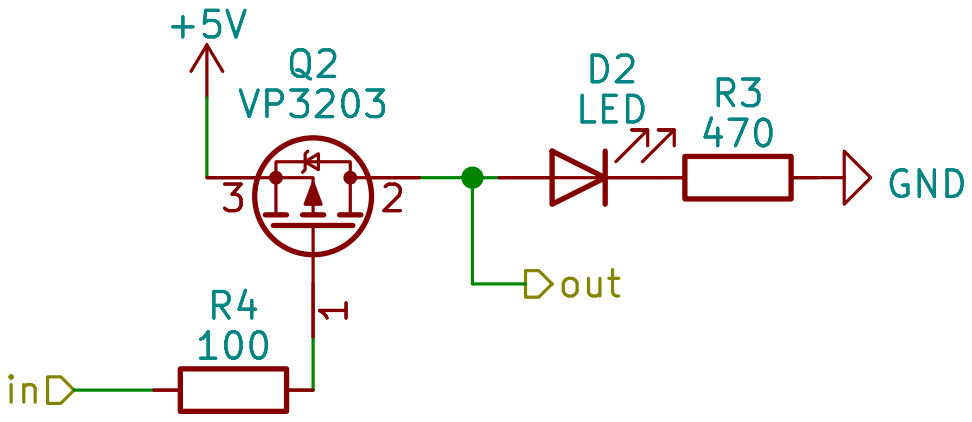
[picture p192: page 3]

Id: 2/9 Title: File: driver.kicad_sch Sheet: /Driver1/

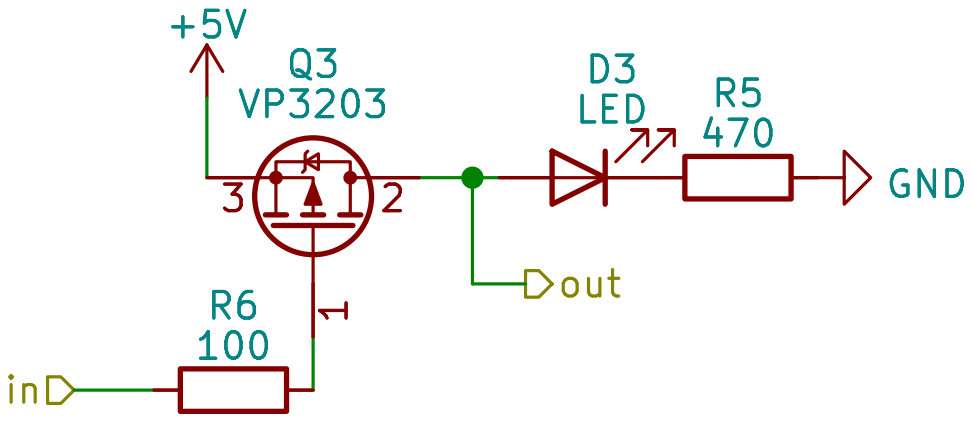
[picture p193: page 4]

Id: 2/9 Title: File: driver.kicad_sch Sheet: /Driver2/

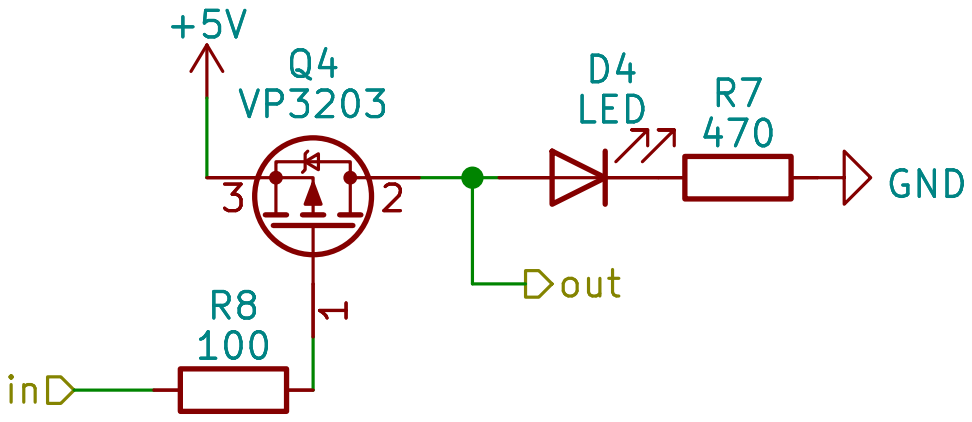
[picture p194: page 5]

Id: 2/9 Title: File: driver.kicad_sch Sheet: /Driver3/

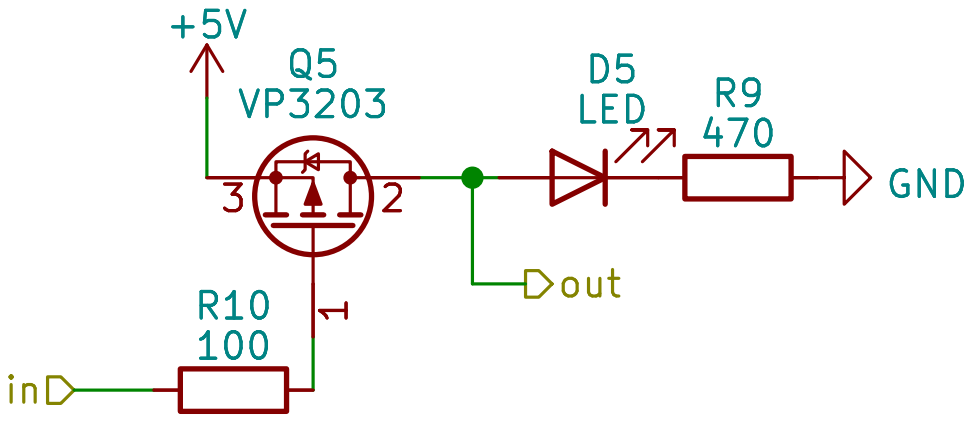
[picture p195: page 6]

Id: 2/9 Title: File: driver.kicad_sch Sheet: /Driver4/

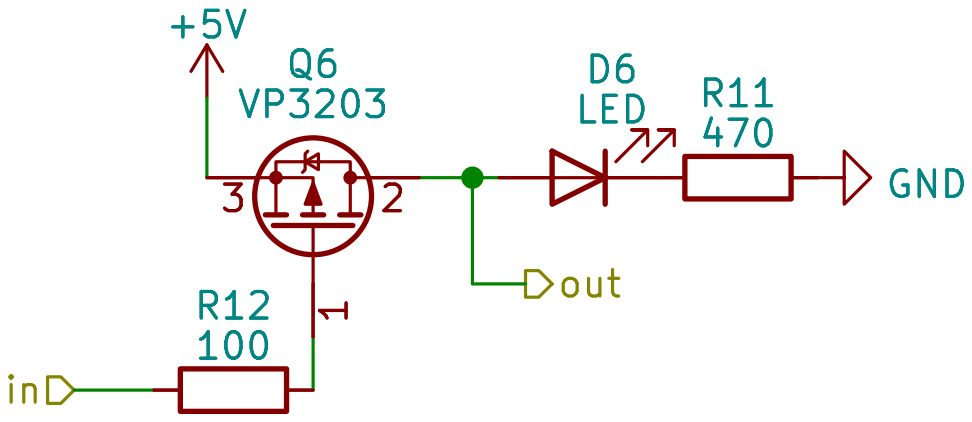
[picture p196: page 7]

Id: 2/9 Title: File: driver.kicad_sch Sheet: /Driver5/

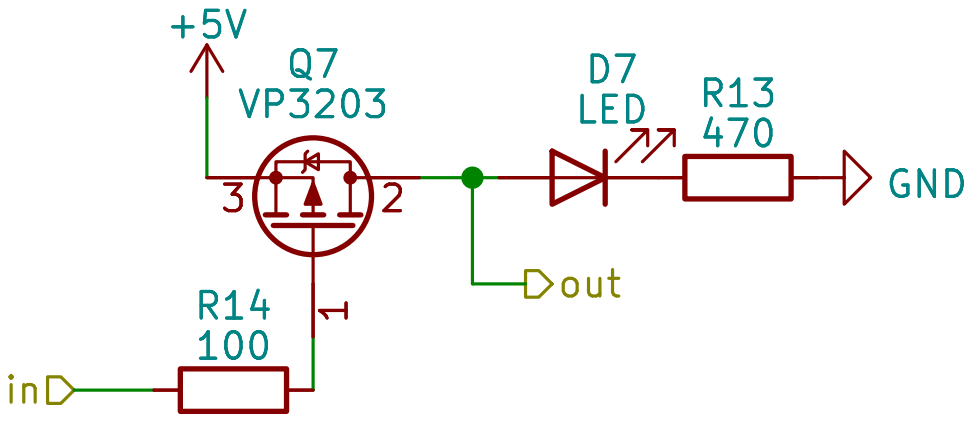
[picture p197: page 8]

Id: 2/9 Title: File: driver.kicad_sch Sheet: /Driver6/

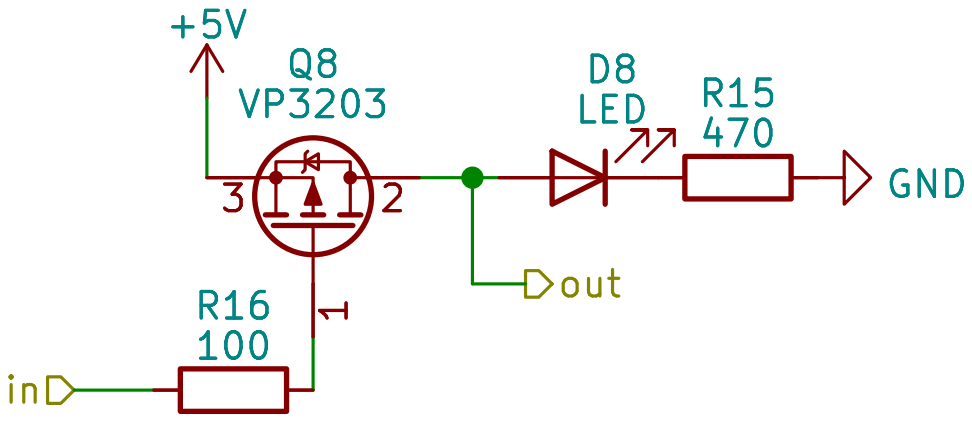
[picture p198: page 9]

Id: 2/9 Title: File: driver.kicad_sch Sheet: /Driver7/
