reivax-boucoi/PCB_Kicad/modPSU/MIC28517/MIC28517_sch.pdf

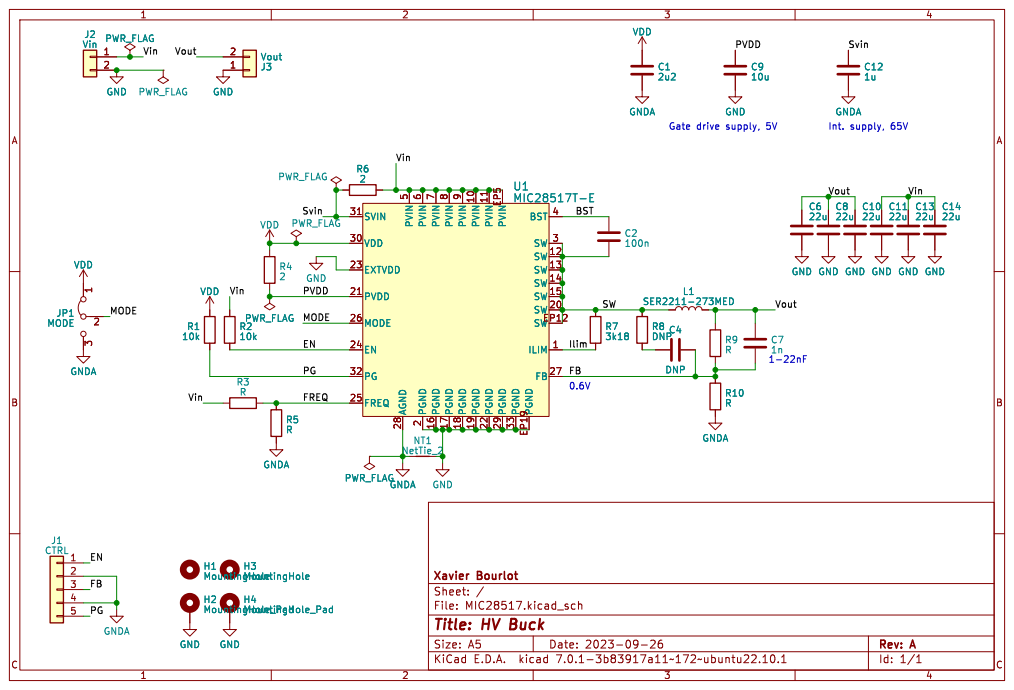
[picture p199: page 1]

VDD R6 2 | 22u GNDA C12 1u GNDA C8

1-22nF Gate drive supply, 5V R10 R GNDA R7

2 SW20 PVDD 21 PGND 22 EXTVDD 23 EN 24 FREQ 25 MODE 26 FB 27 AGND 28 PGND 29 SW 3 SVIN 31 PG 32 PGND 33 BST 4 PVIN

Id: 1/1 Title: HV Buck
