reivax-boucoi/PCB_Kicad/Kheprism/HW/proto_expo_v0/proto_expo_v0.pdf

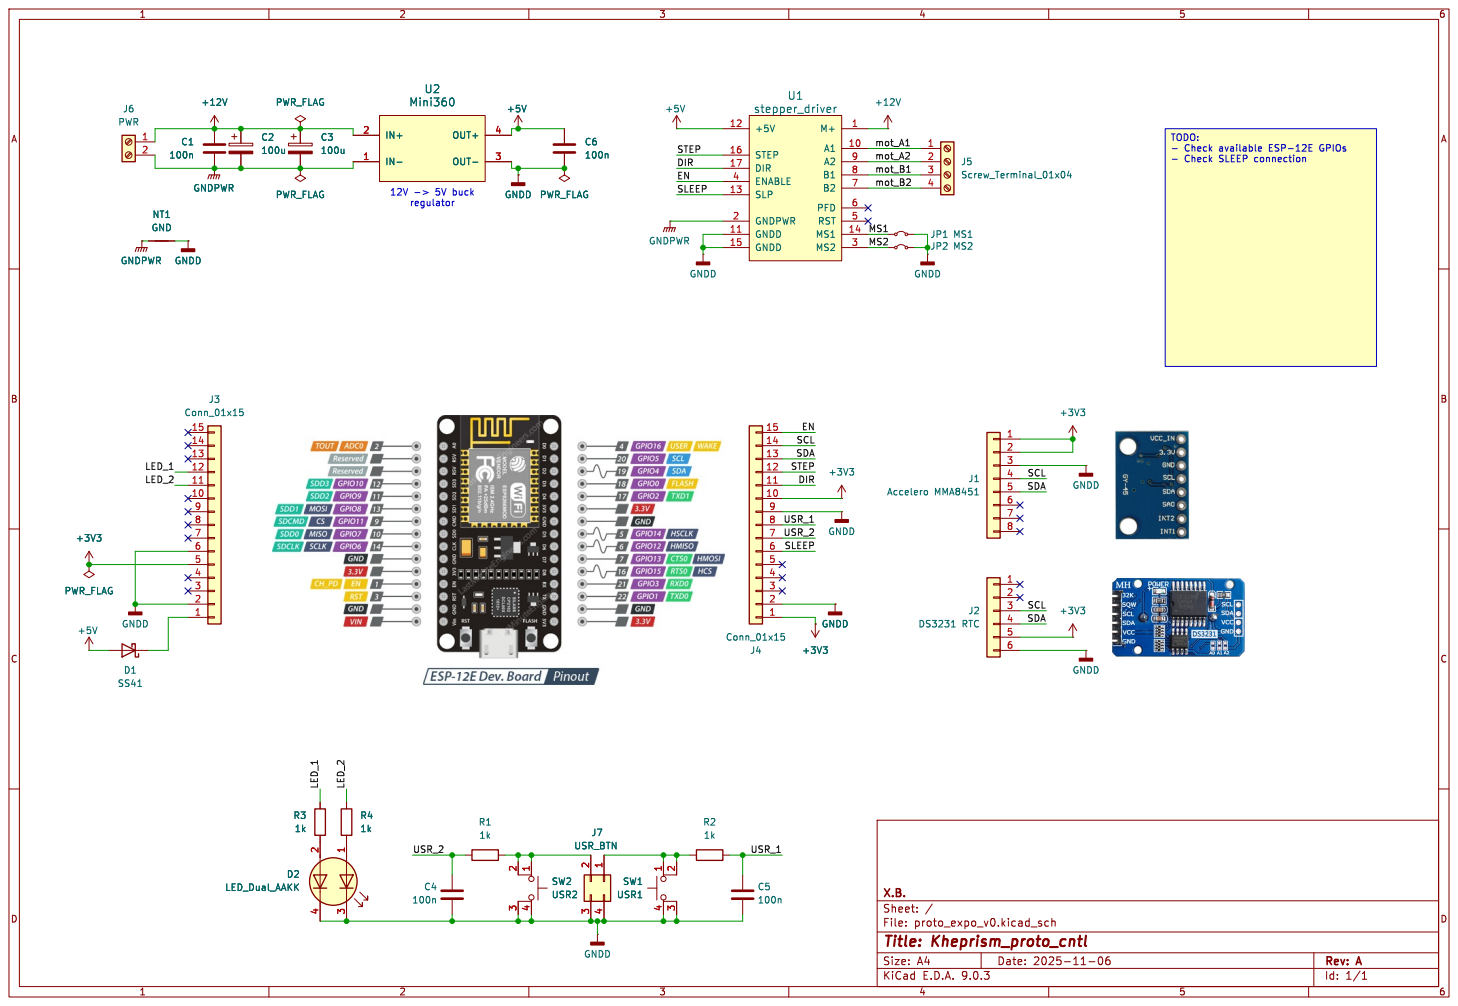
[picture p200: page 1]

Id: 1/1 Title: Kheprism_proto_cntl File: proto_expo_v0.kicad_sch Sheet: / X.B.
