reivax-boucoi/PCB_Kicad/horse_feeder/HW/PCB_v1_SIM800L/horse_feeder.pdf

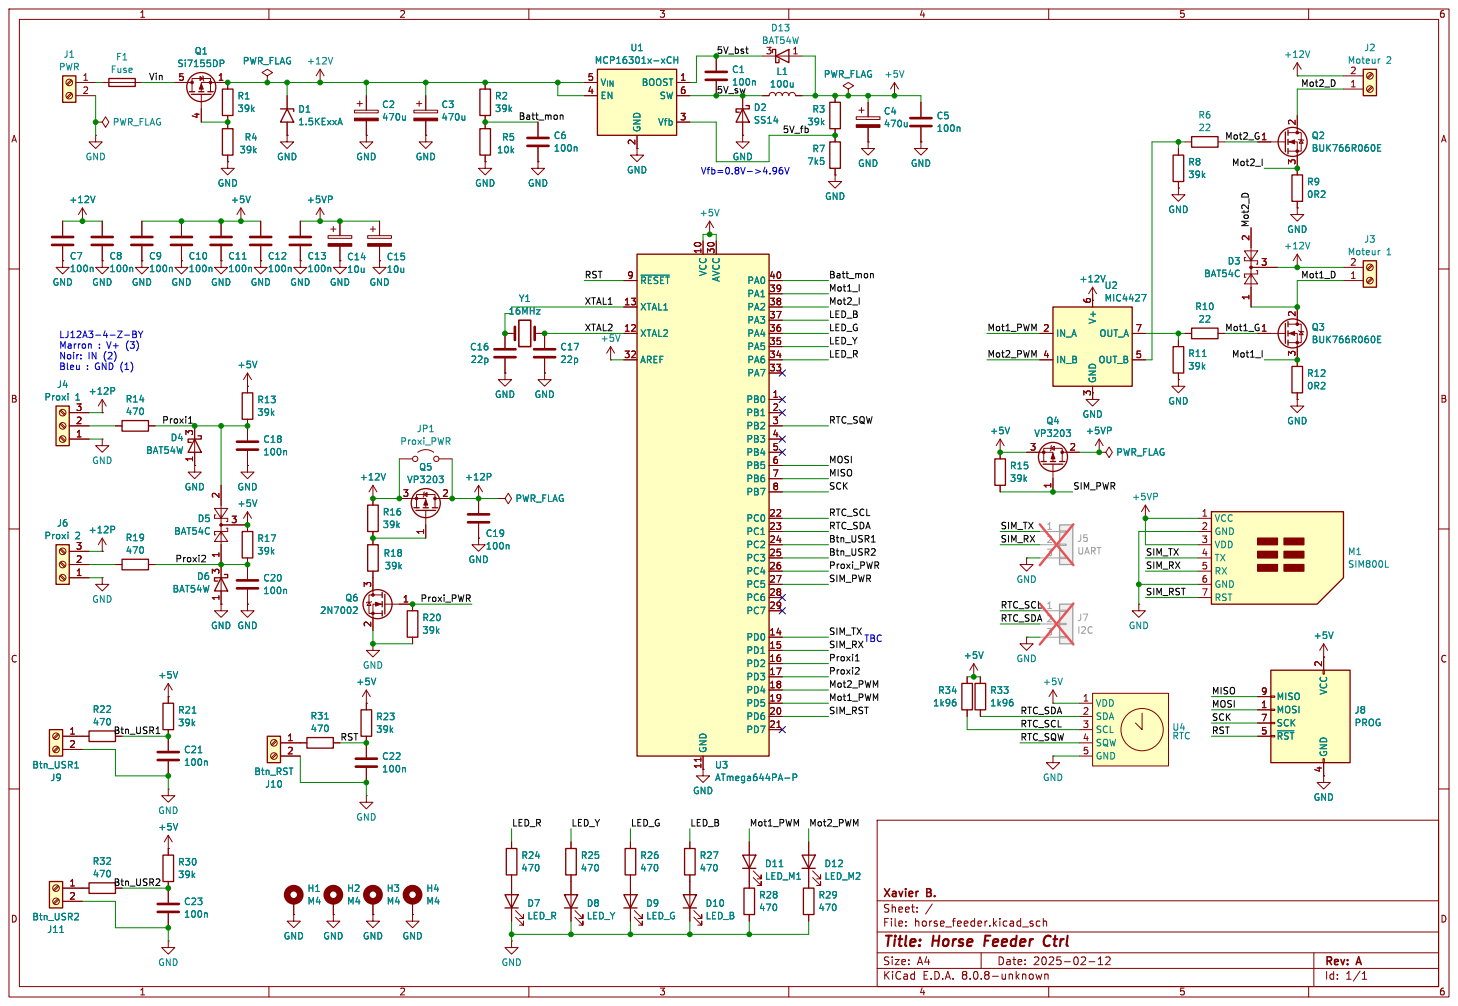
[picture p201: page 1]

2 Vfb 3 EN 4 V_{IN} 5 SW 6 U1 MCP16301x-xCH

2 Vfb 3 EN 4 V_{IN} 5 SW 6 GND GND
16MHz R5
