reivax-boucoi/PCB_Kicad/50W_LED_boost/led_boost/led_boost_MIC3230/led_boost_MIC3230.pdf

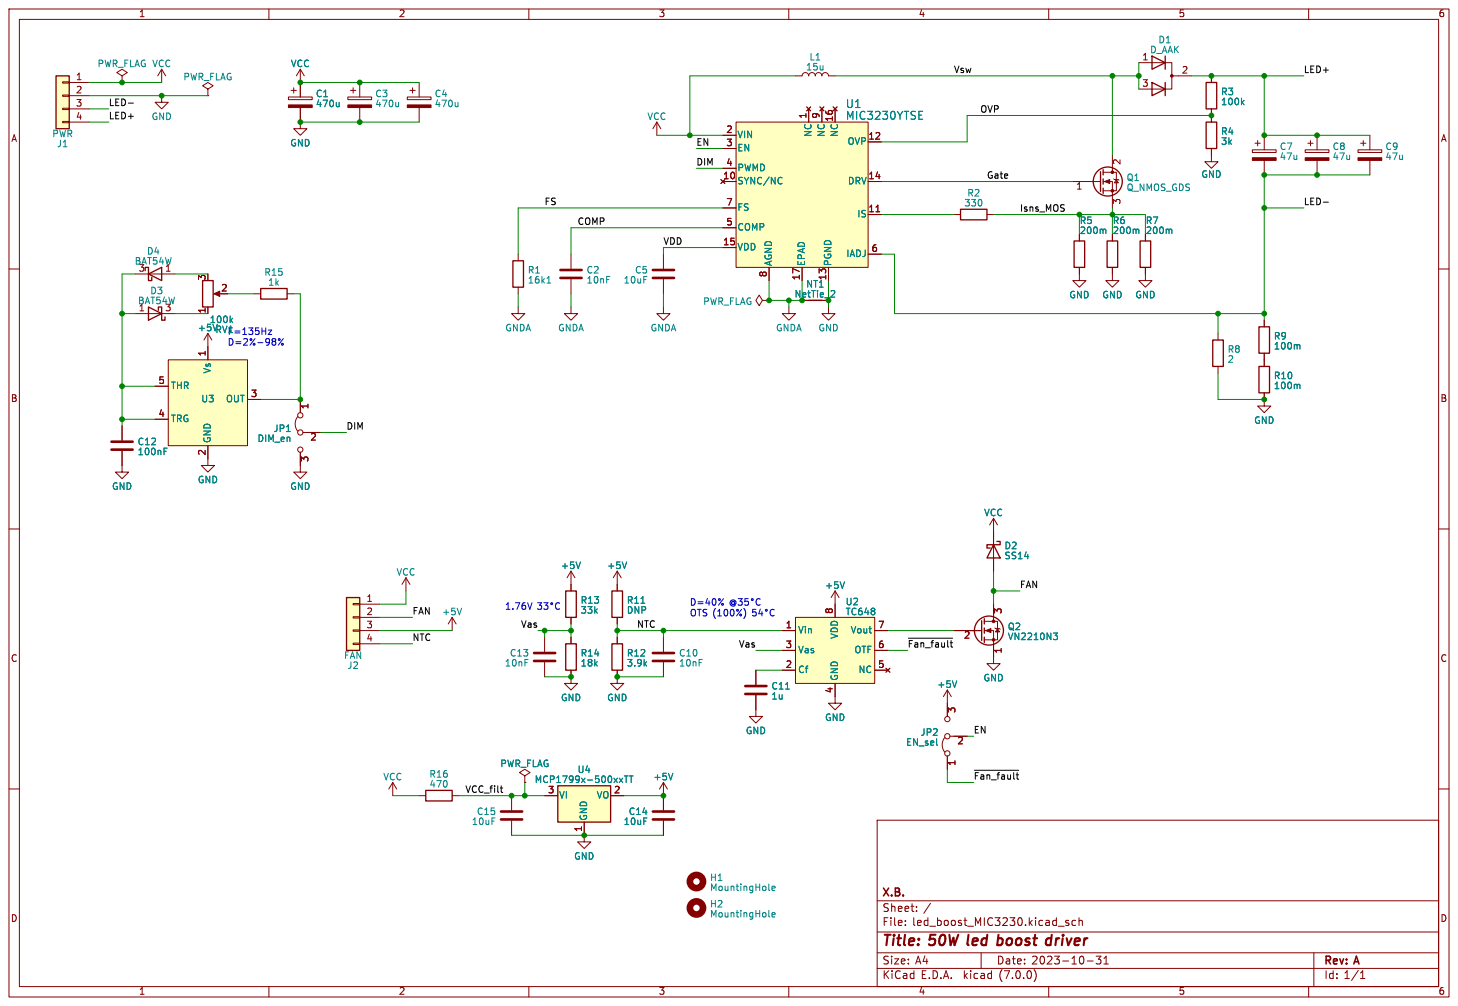
[picture p202: page 1]

9 SYNC/NC 10 OVP 12 VDD 15 EPAD 17 U1 MIC3230YTSE

9 SYNC/NC 10 OVP 12 VDD 15 EPAD 17

4 NC 5 OTF 6 Vout 7 VDD

Id: 1/1 Title: 50W led boost driver File: led_boost_MIC3230.kicad_sch Sheet: / X.B. C15
