reivax-boucoi/PCB_Kicad/Hi-pot_tester/Hi-pot_tester.pdf

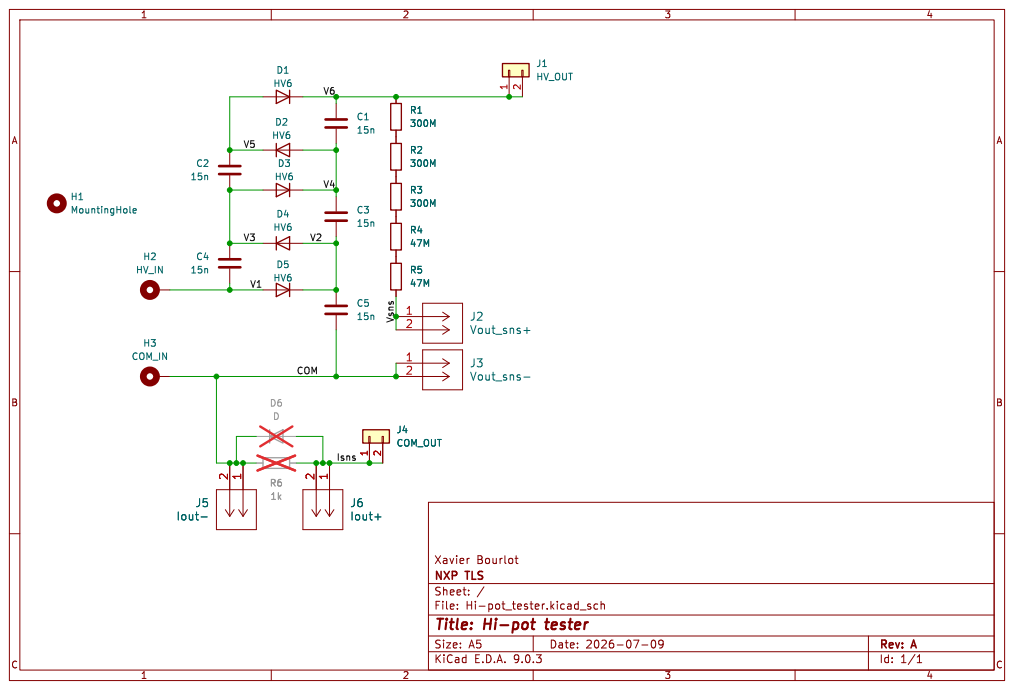
[picture p203: page 1]
