reivax-boucoi/PCB_Kicad/miains_timer_2/schematic.pdf

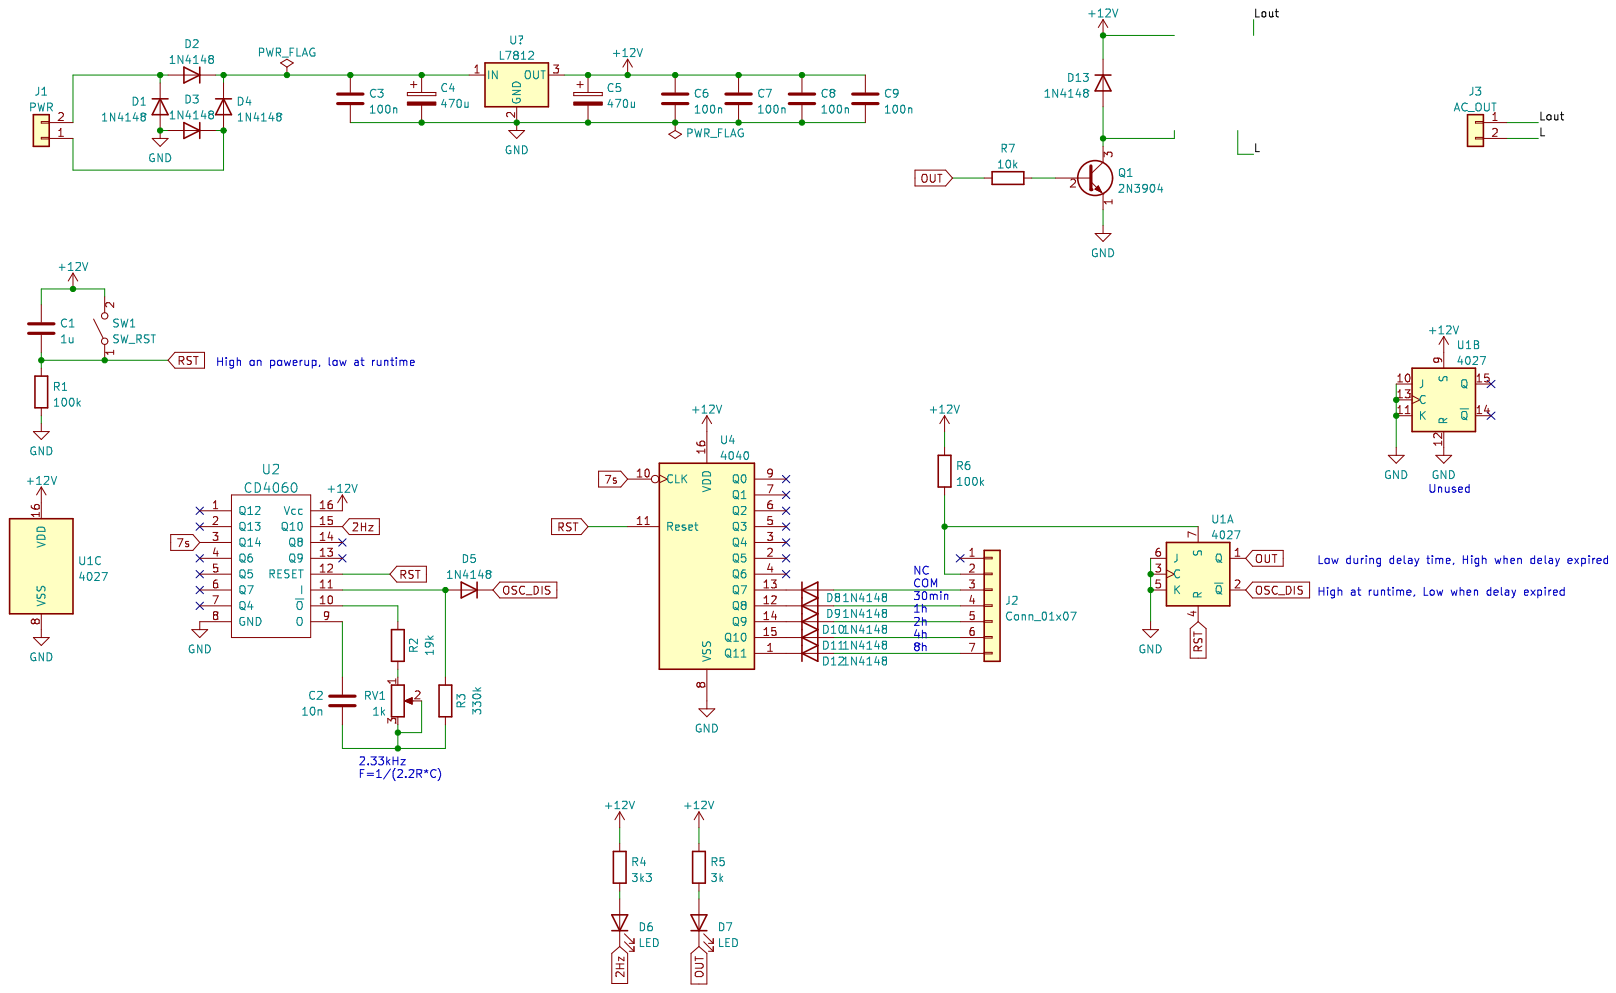
[picture p204: page 1]
