reivax-boucoi/PCB_Kicad/solar_mppt1/schematic.pdf

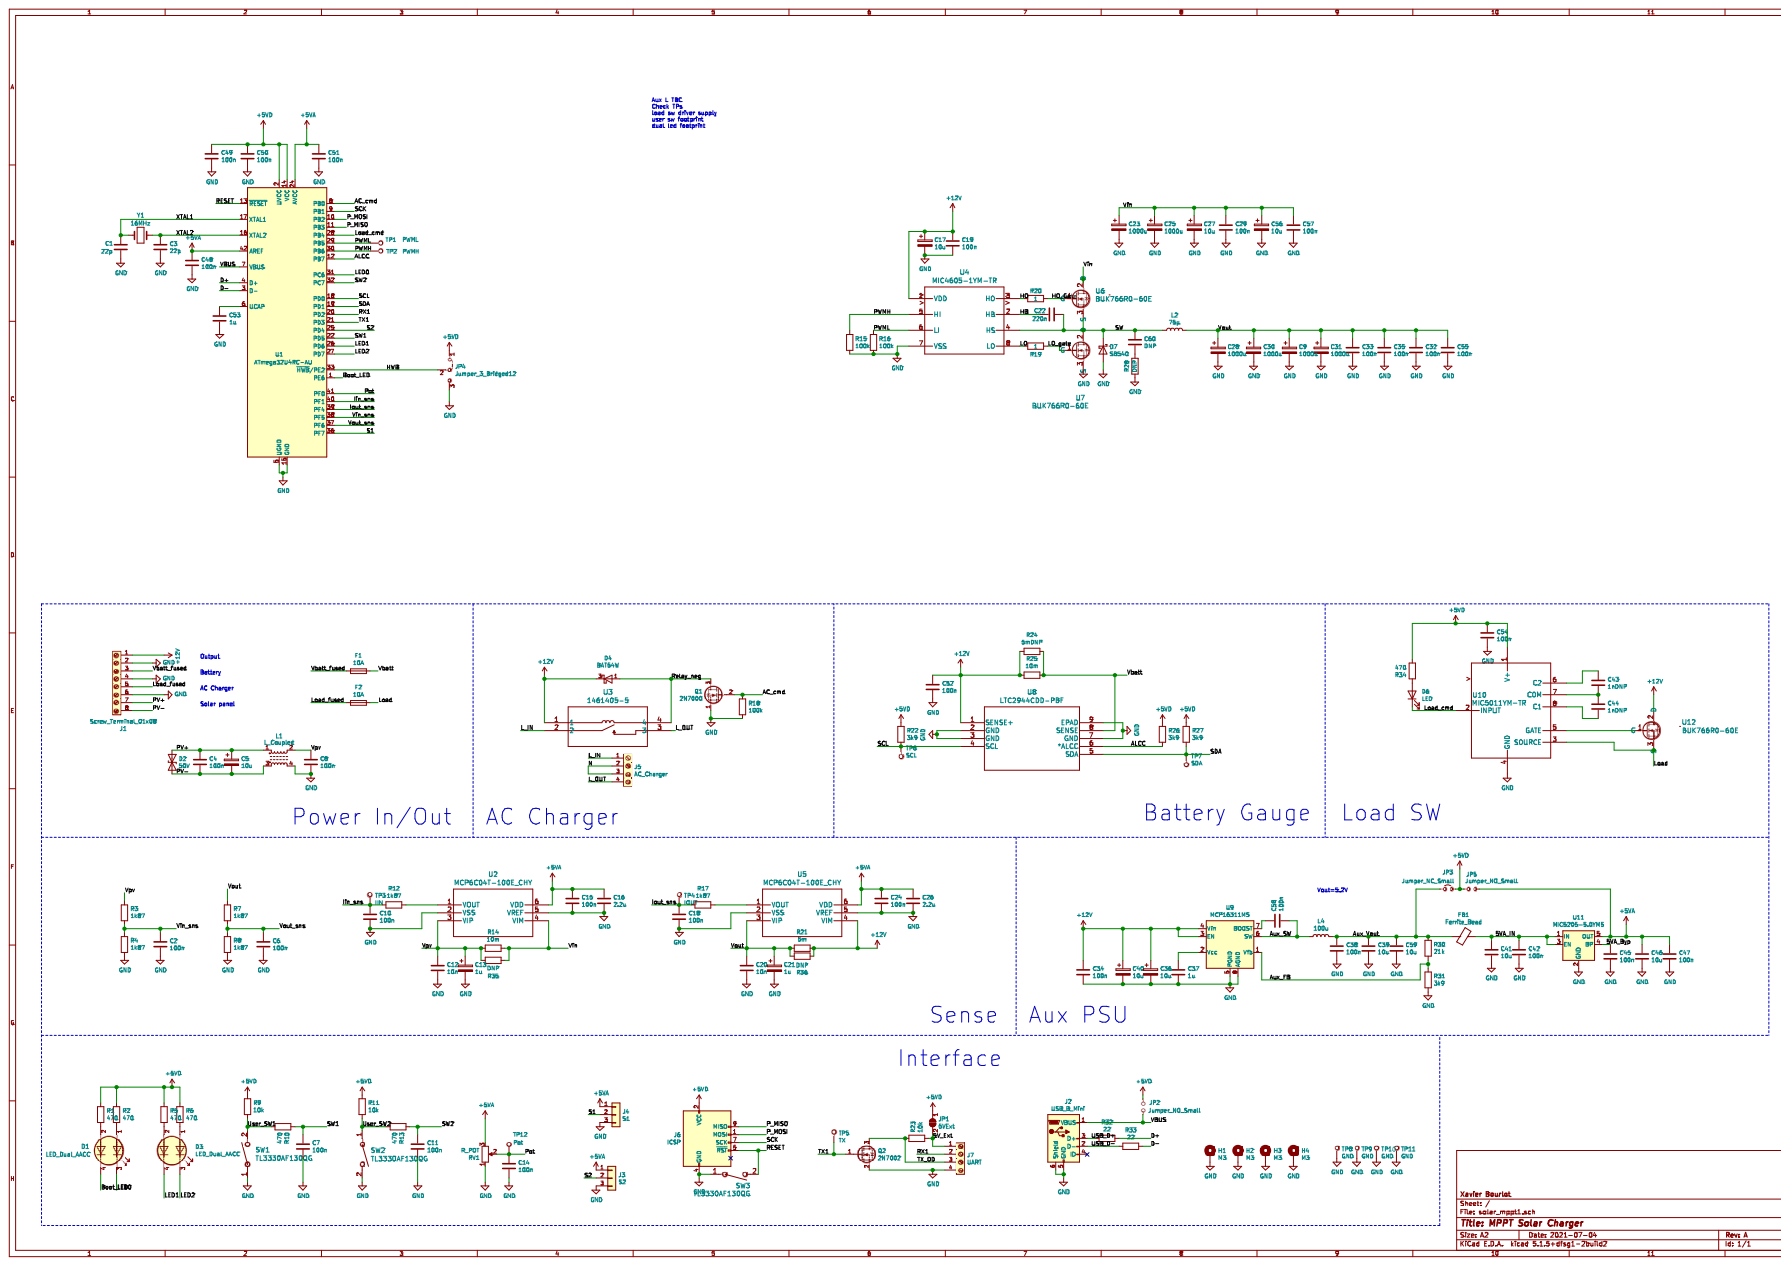
[picture p205: page 1]
