reivax-boucoi/PCB_Kicad/usb_switch/schematic.pdf

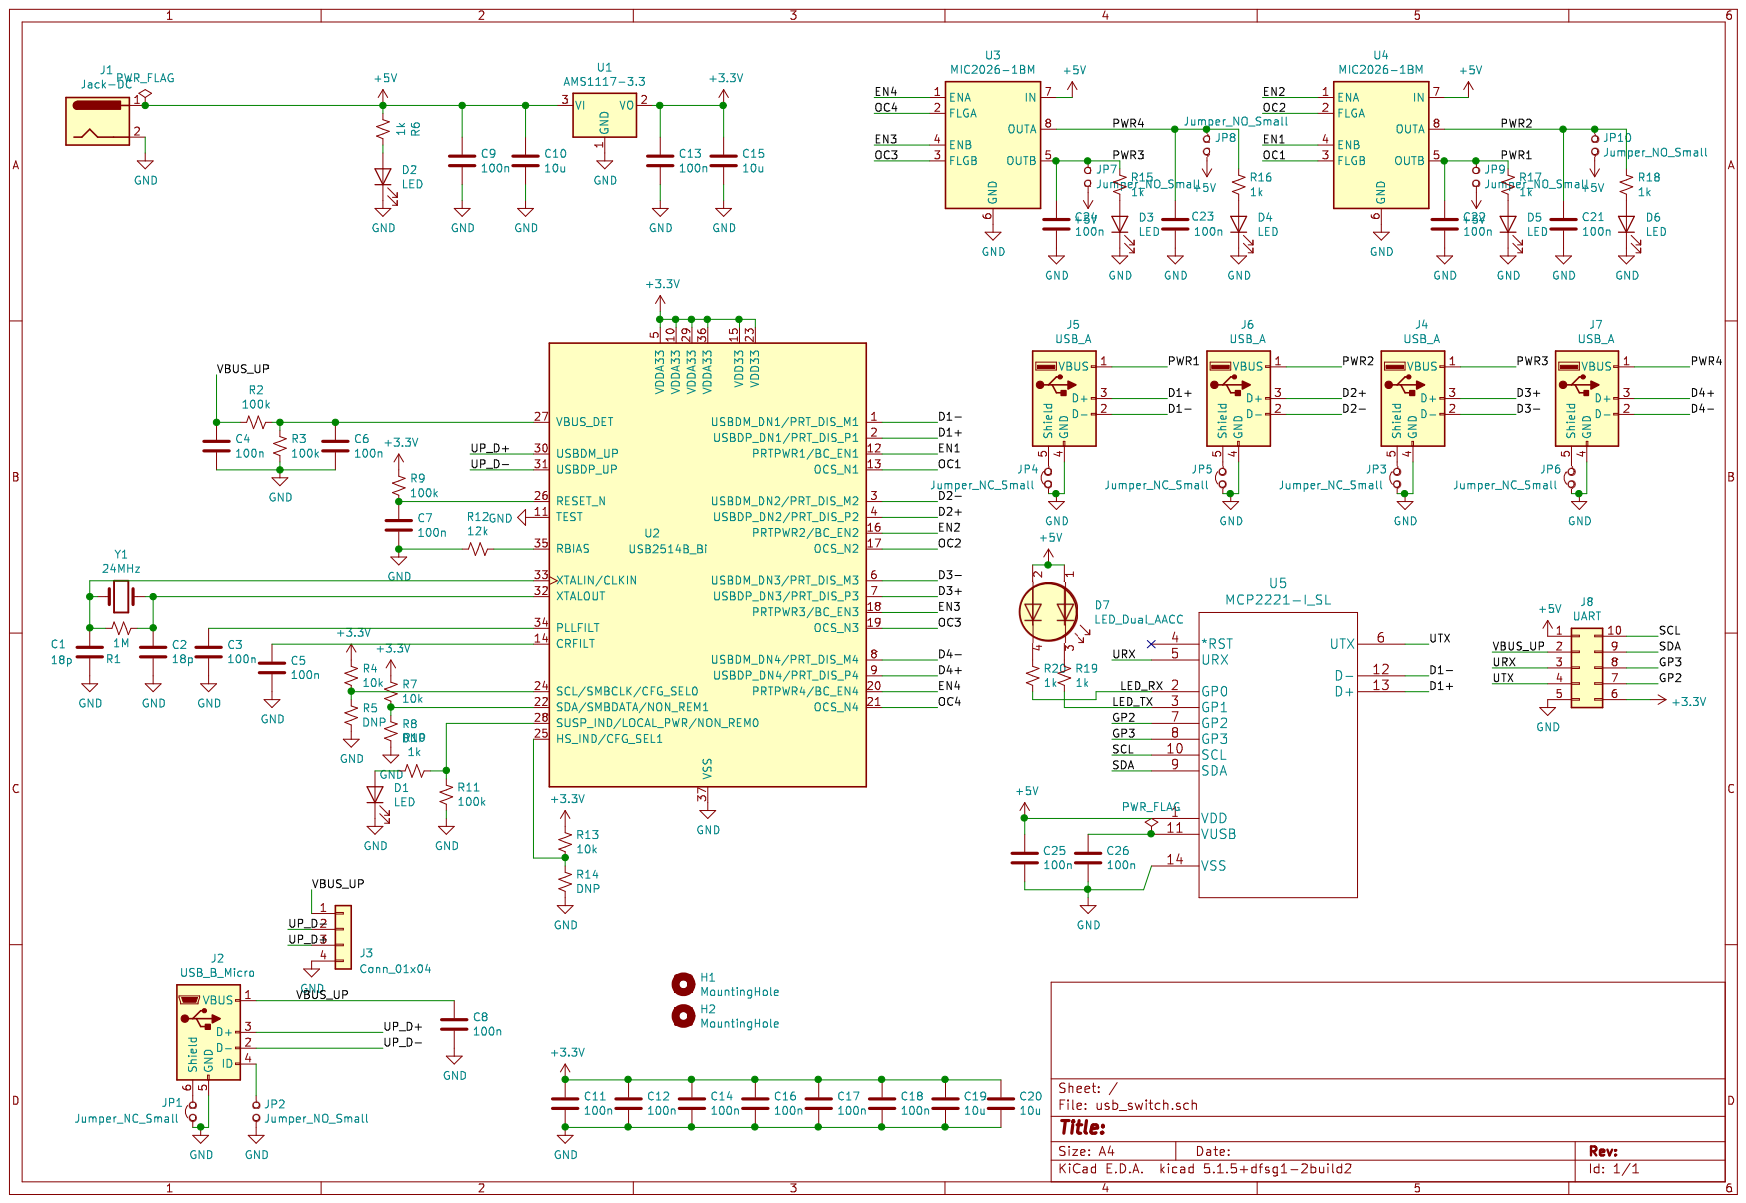
[picture p206: page 1]
