reivax-boucoi/PCB_Kicad/flyback_DCM/schematic.pdf

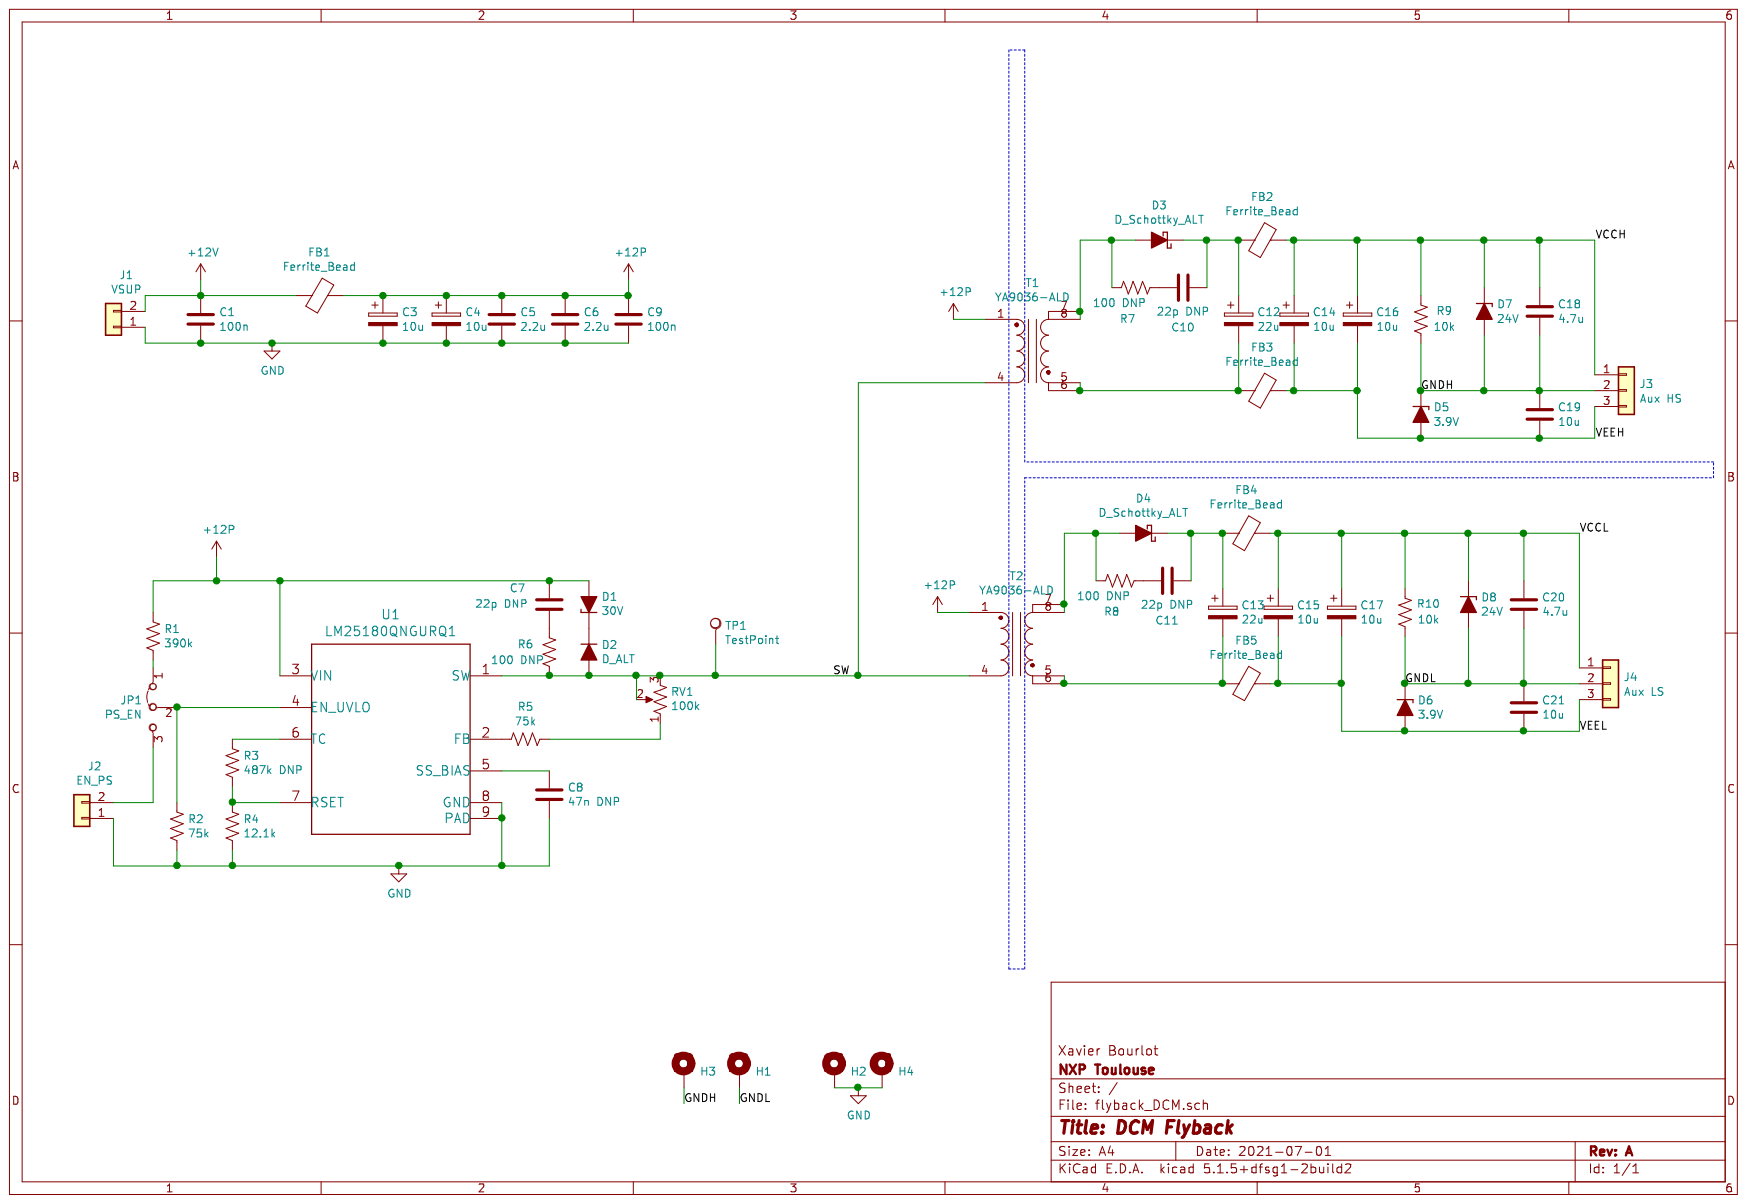
[picture p207: page 1]
