reivax-boucoi/PCB_Kicad/LabBooster/LabBooster_schematic.pdf

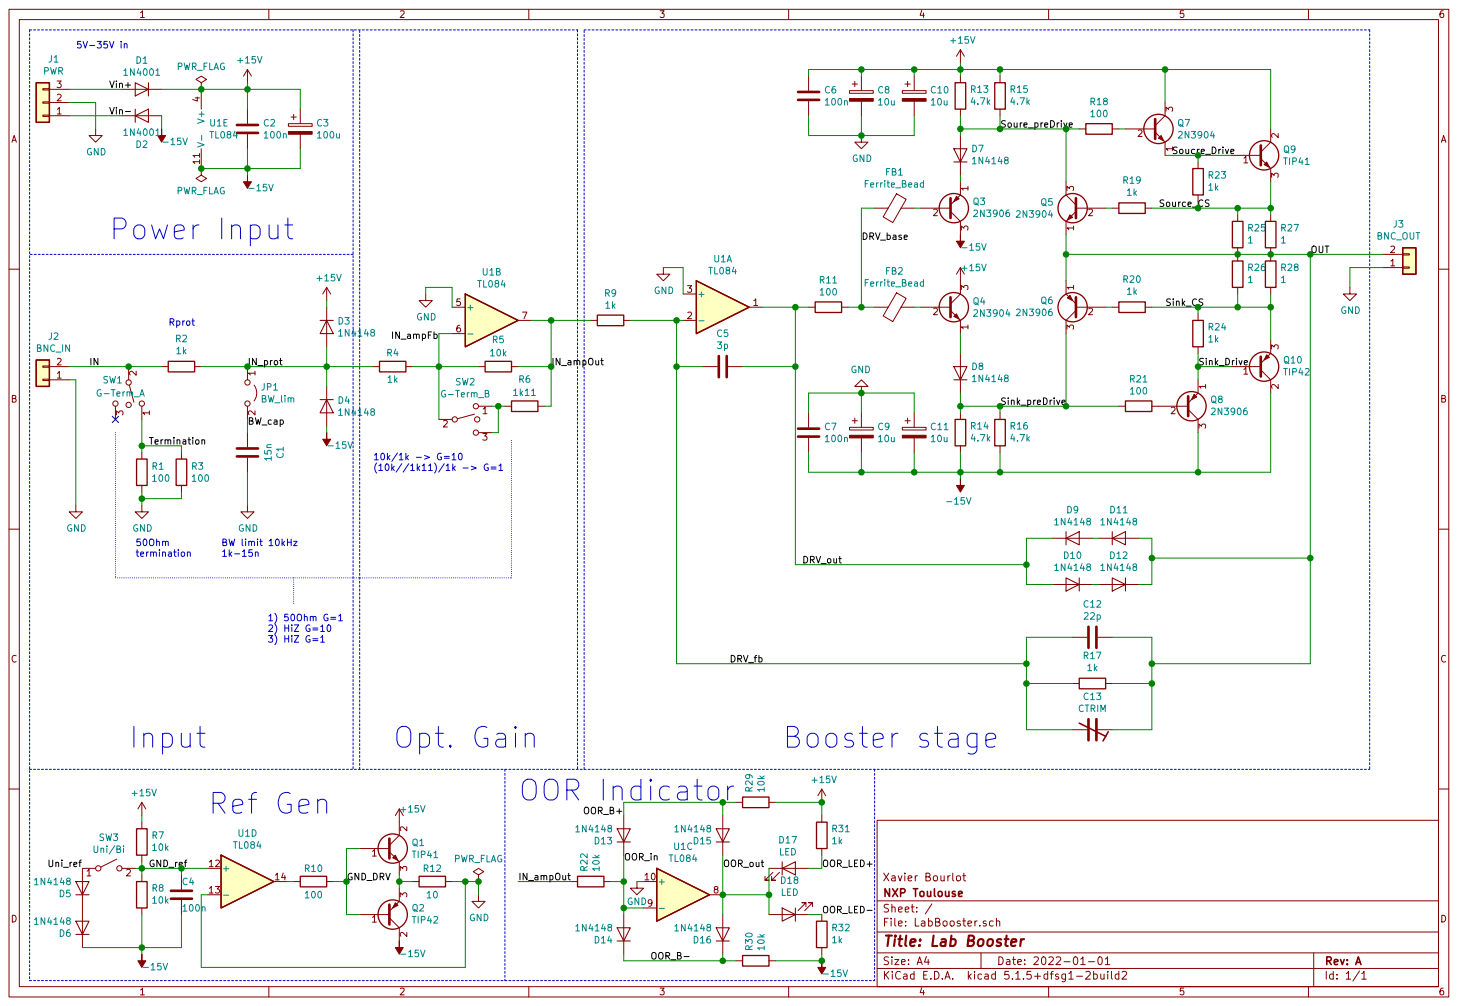
[picture p208: page 1]

D1 PWR_FLAG

Id: 1/1 Title: Lab Booster File: LabBooster.sch Sheet: / NXP Toulouse Xavier Bourlot
