reivax-boucoi/PCB_Kicad/Hi-pot_tester/output/Hi-pot_tester.pdf

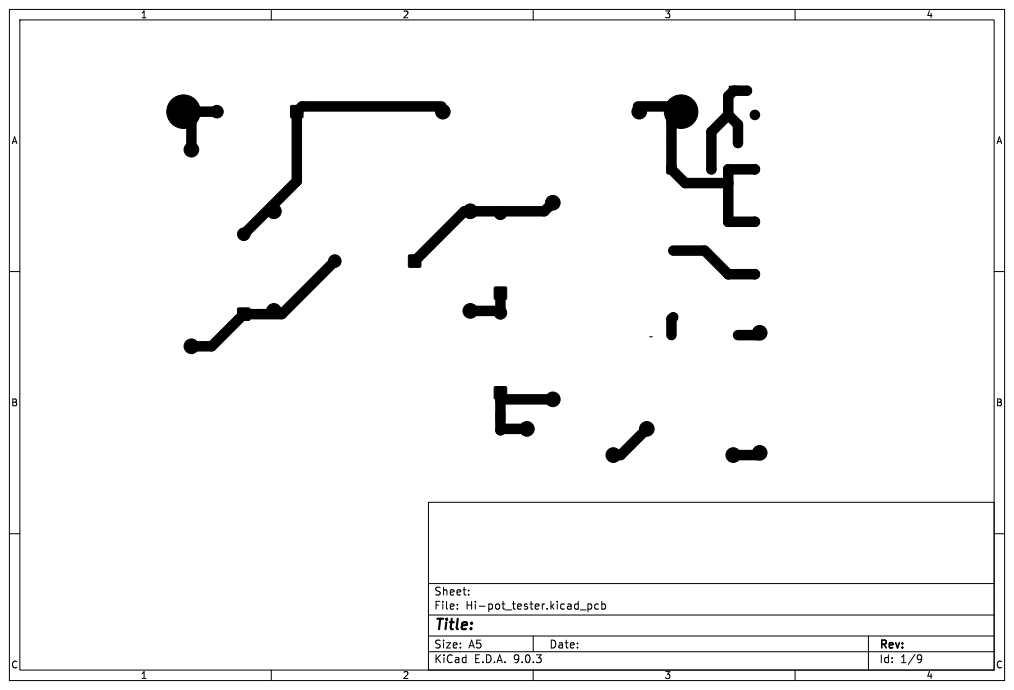
[picture p209: page 1]

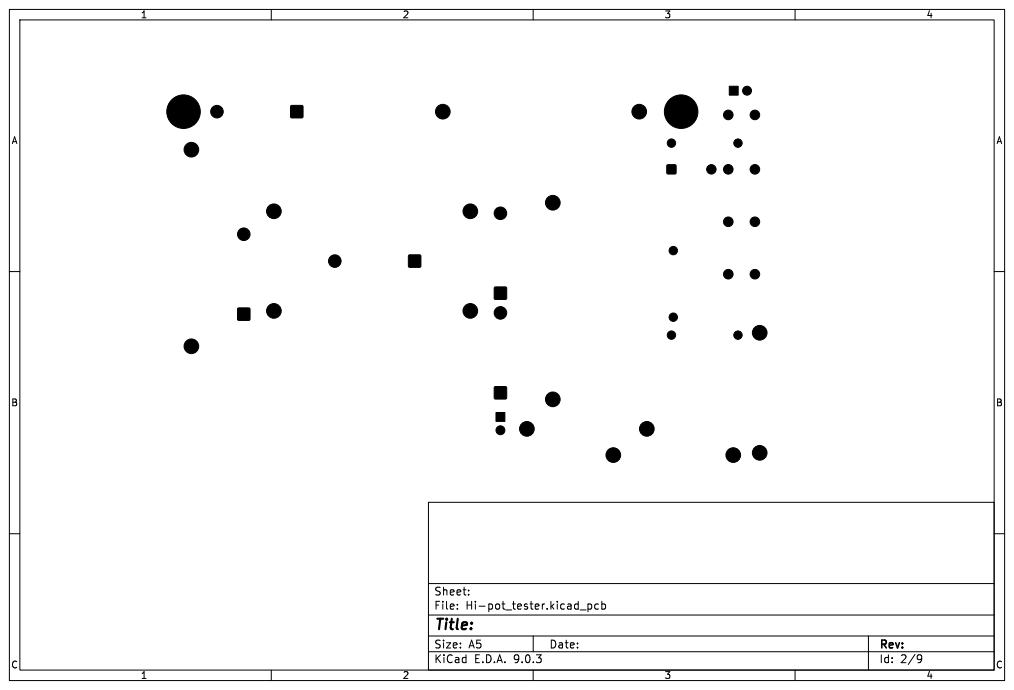
[picture p210: page 2]

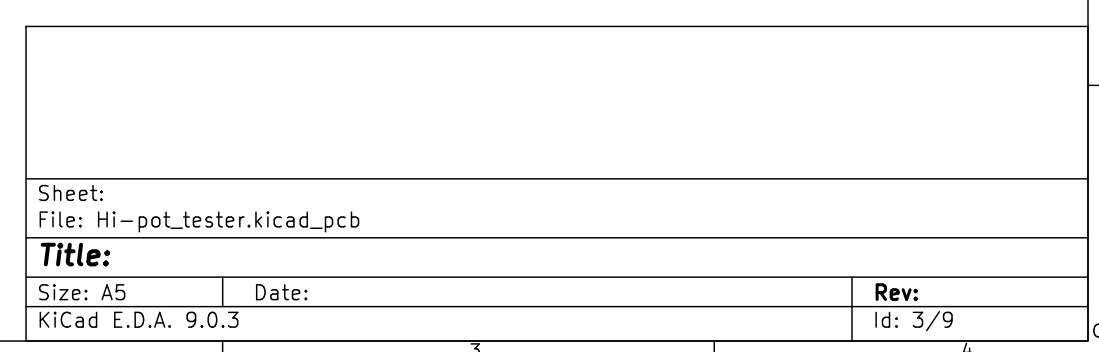
[picture p211: page 3]

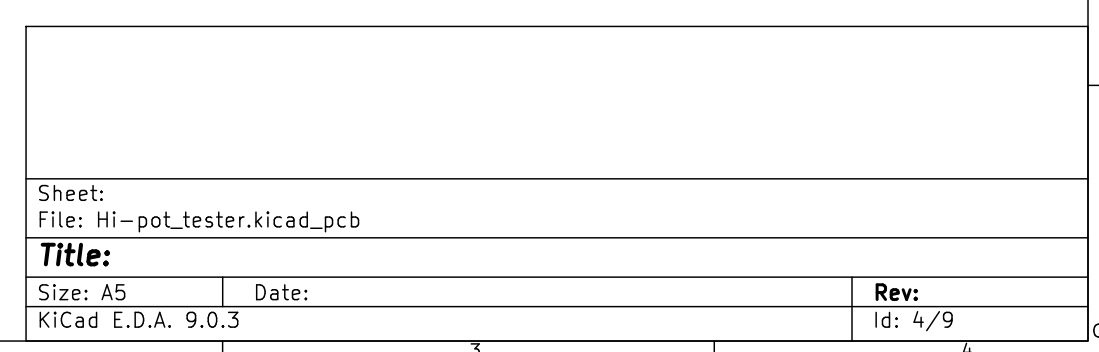
[picture p212: page 4]

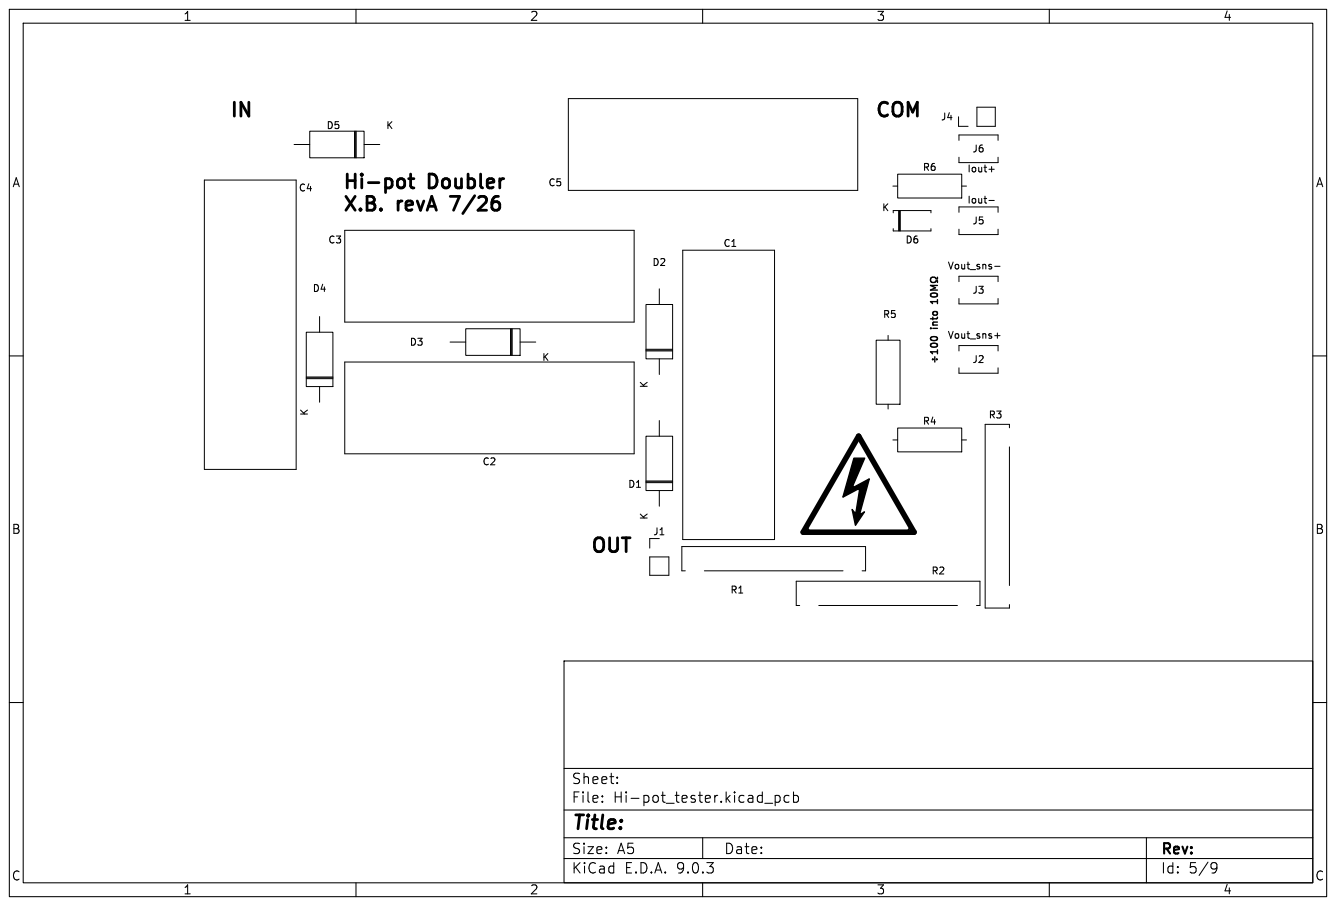
[picture p213: page 5]

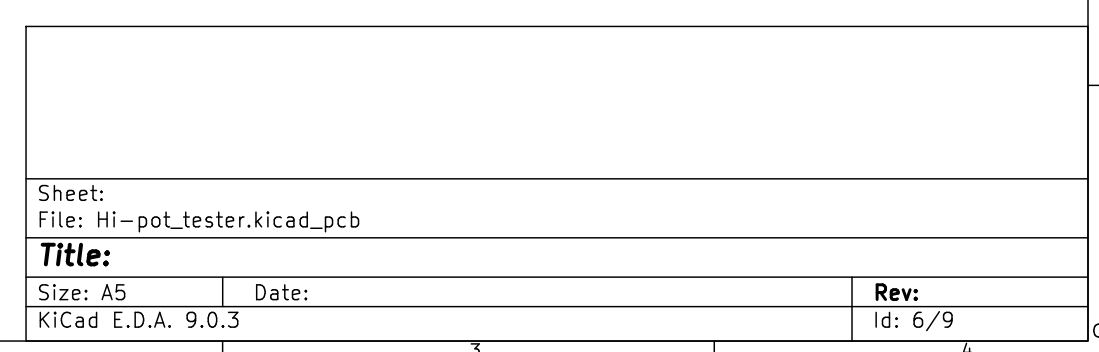
[picture p214: page 6]

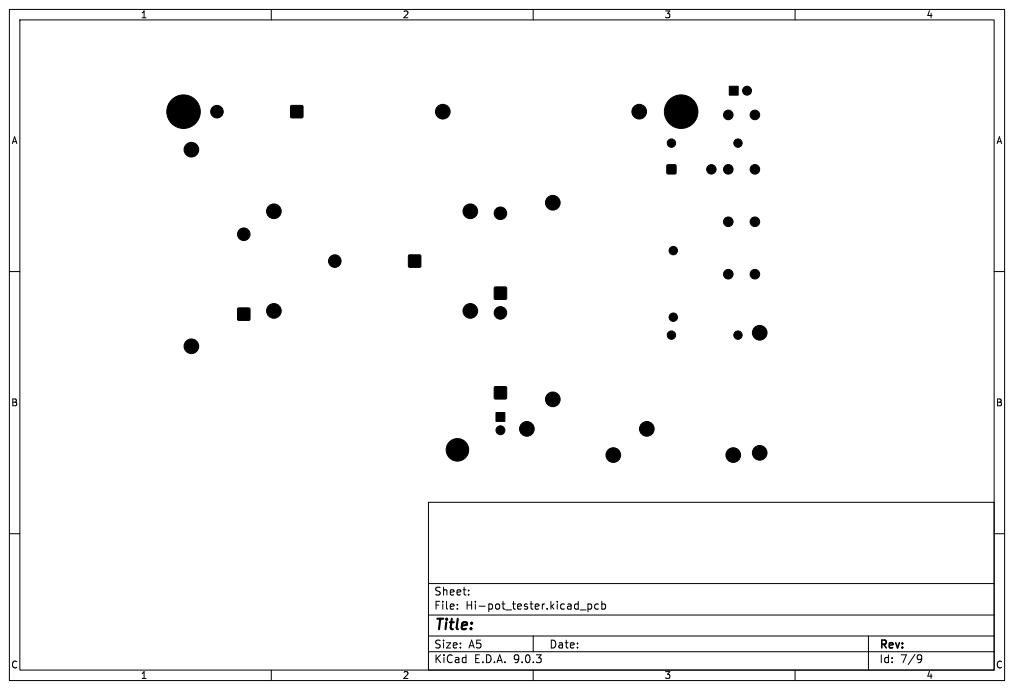
[picture p215: page 7]

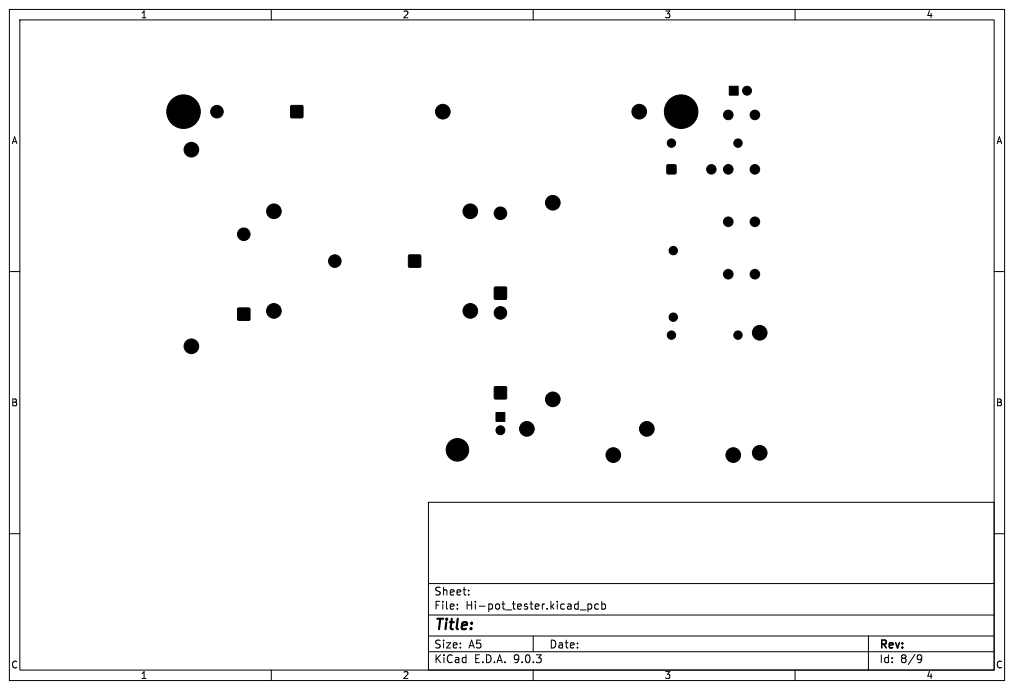
[picture p216: page 8]

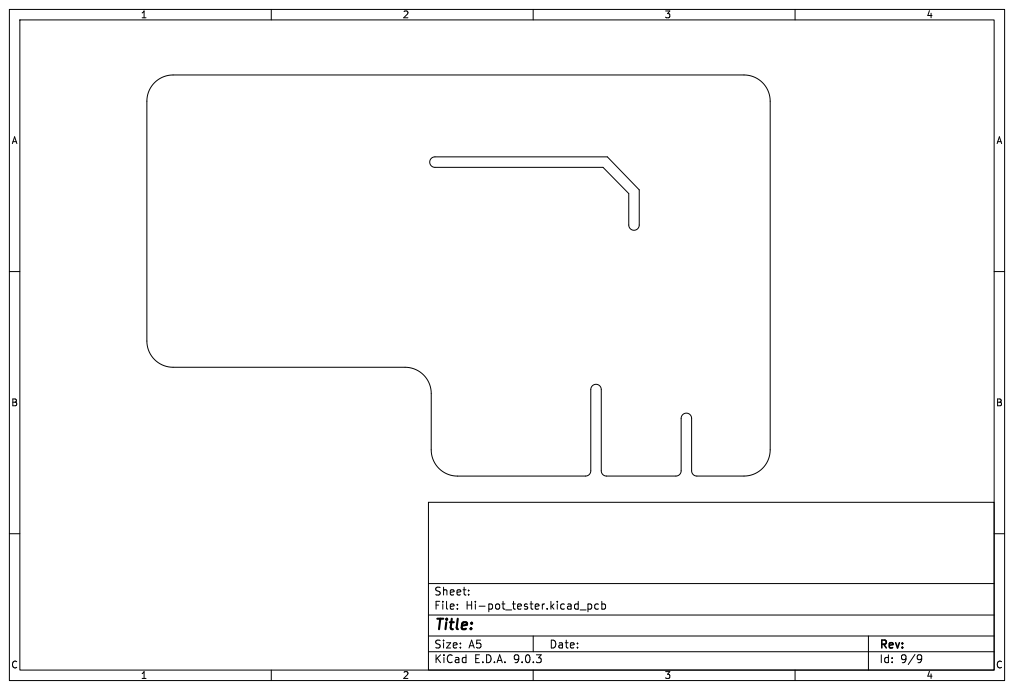
[picture p217: page 9]
