reivax-boucoi/PCB_Kicad/GaN_Vth/GaN_Vth.pdf

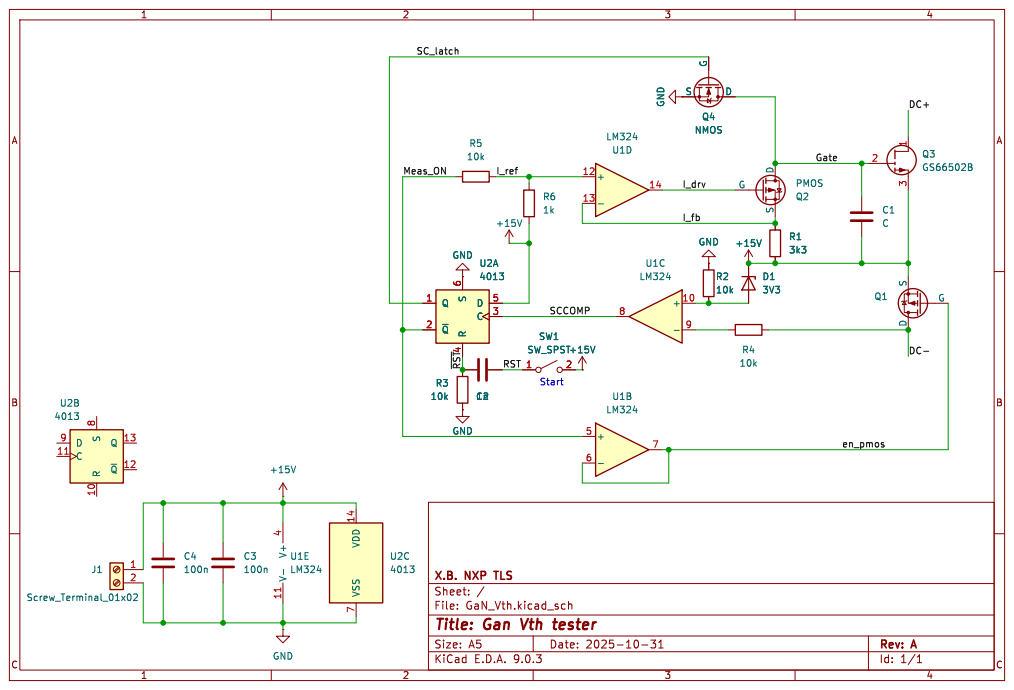
[picture p218: page 1]
