reivax-boucoi/PCB_Kicad/series_light/series_light.pdf

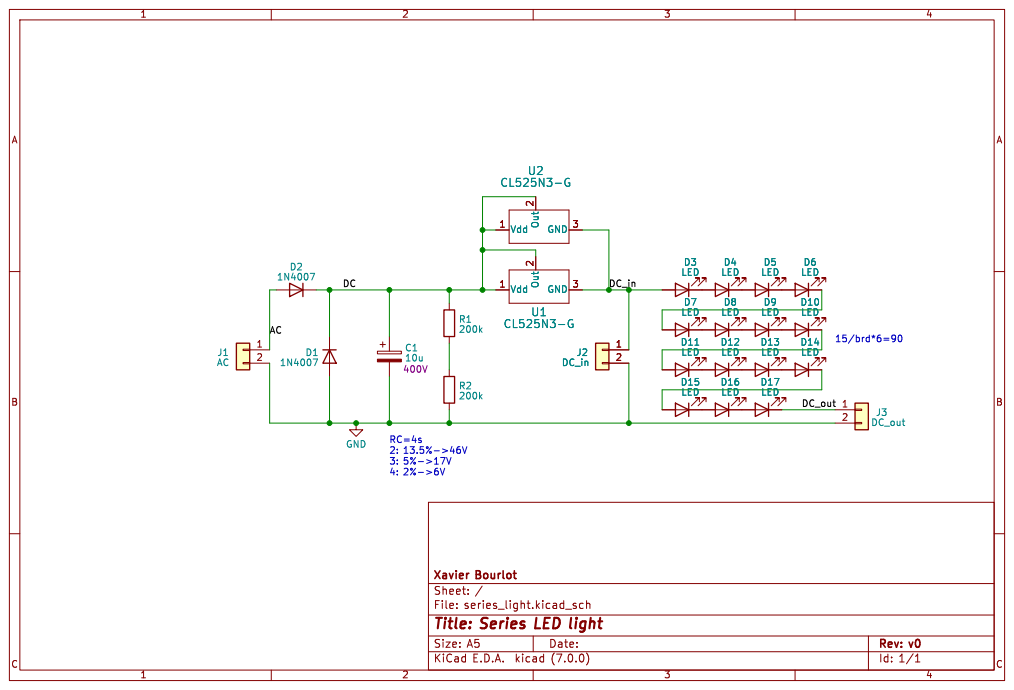
[picture p219: page 1]
