reivax-boucoi/PCB_Kicad/opposition_bench/bottom_cu_outline.pdf

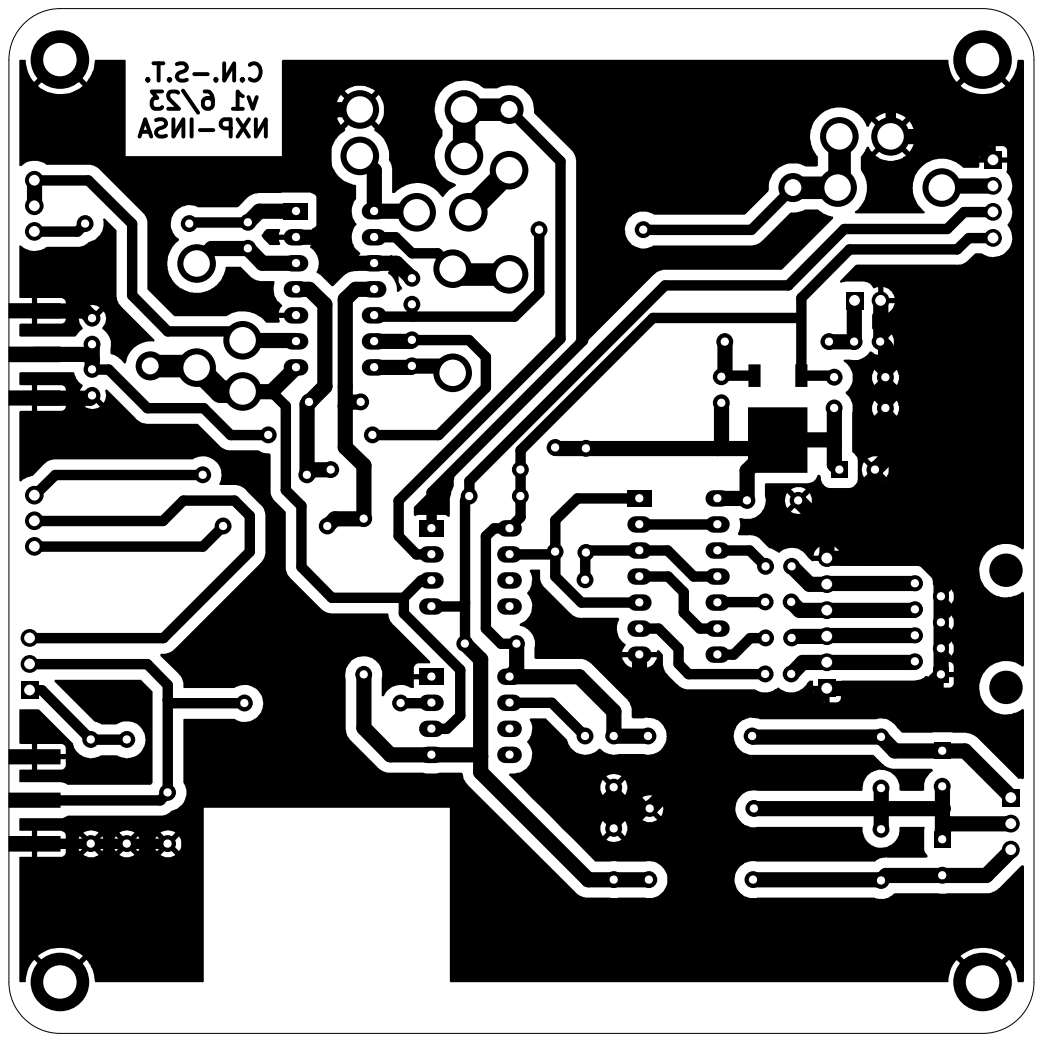
[picture p220: page 1]
