reivax-boucoi/PCB_Kicad/pickit_adapter/output.pdf

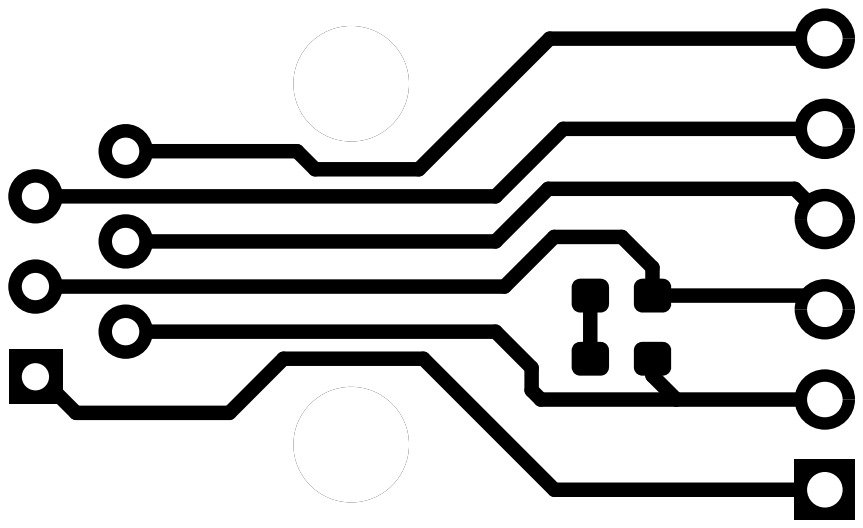
[picture p221: page 1]
