reivax-boucoi/PCB_Kicad/LabBooster/LabBooster_bottom.pdf

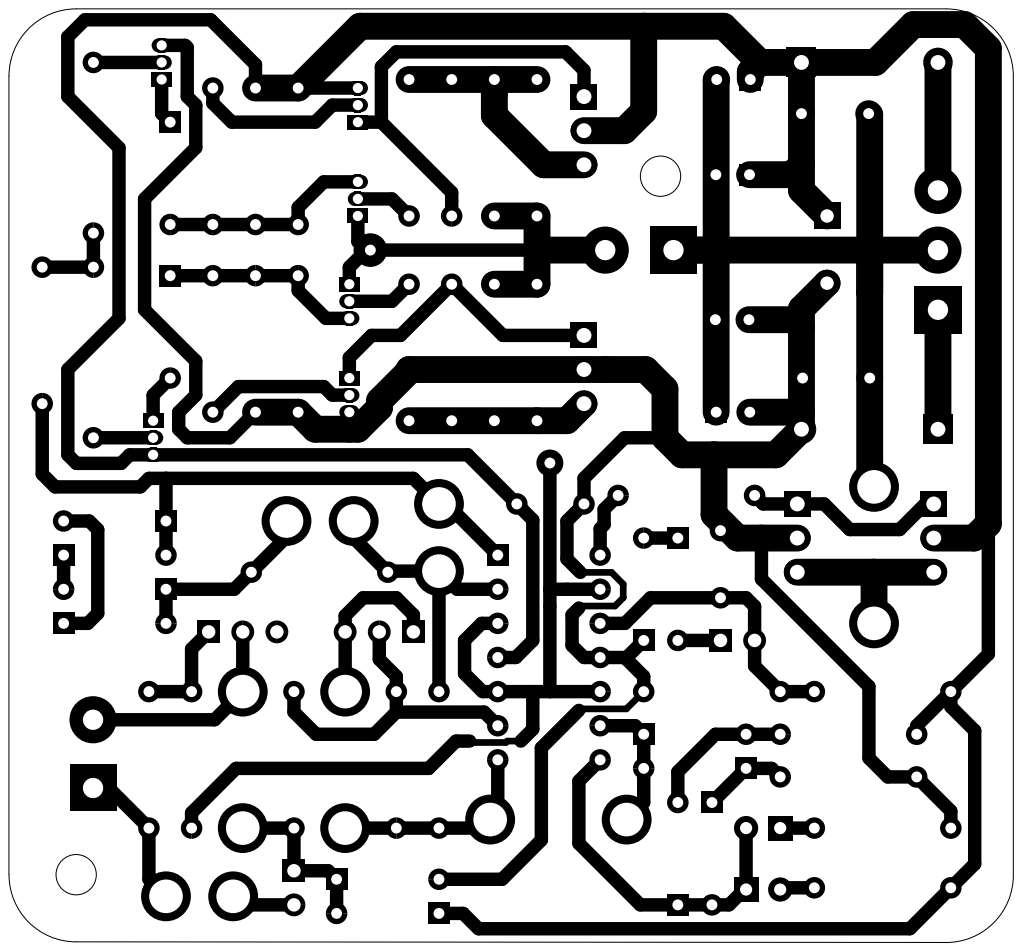
[picture p222: page 1]
