reivax-boucoi/PCB_Kicad/LabBooster/LabBooster_placement.pdf

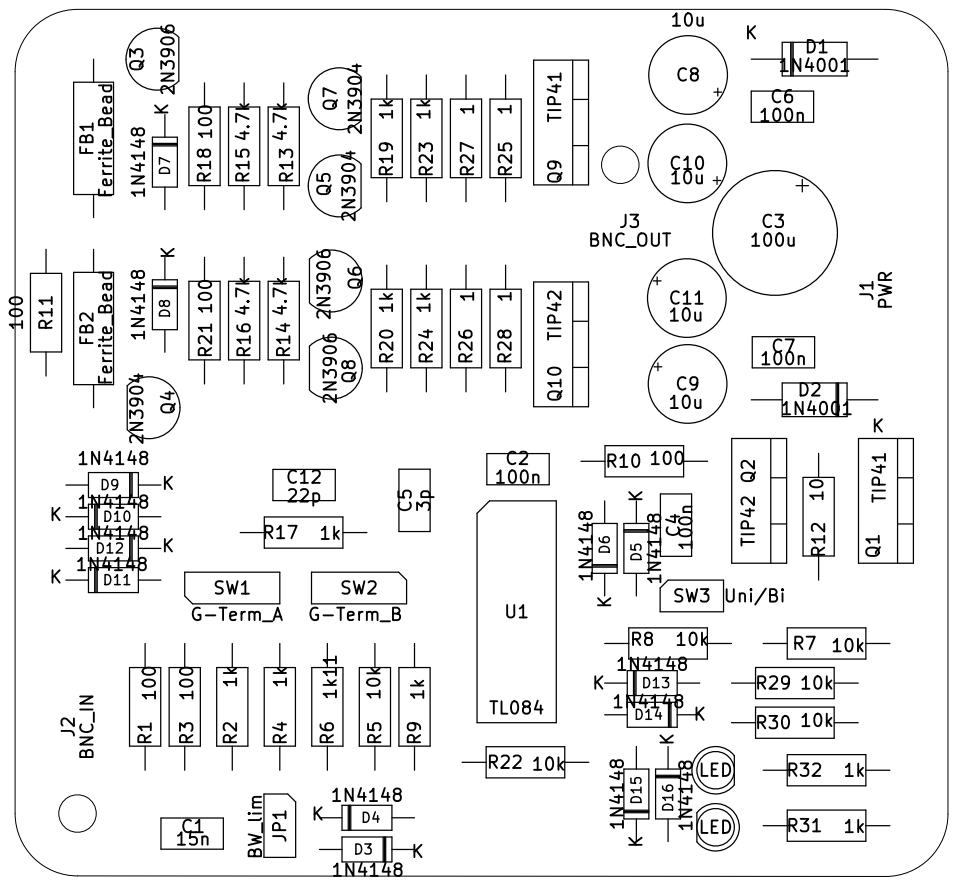
[picture p223: page 1]
