reivax-boucoi/PCB_Kicad/3phase_gen/3phase_gen-B_Cu.pdf

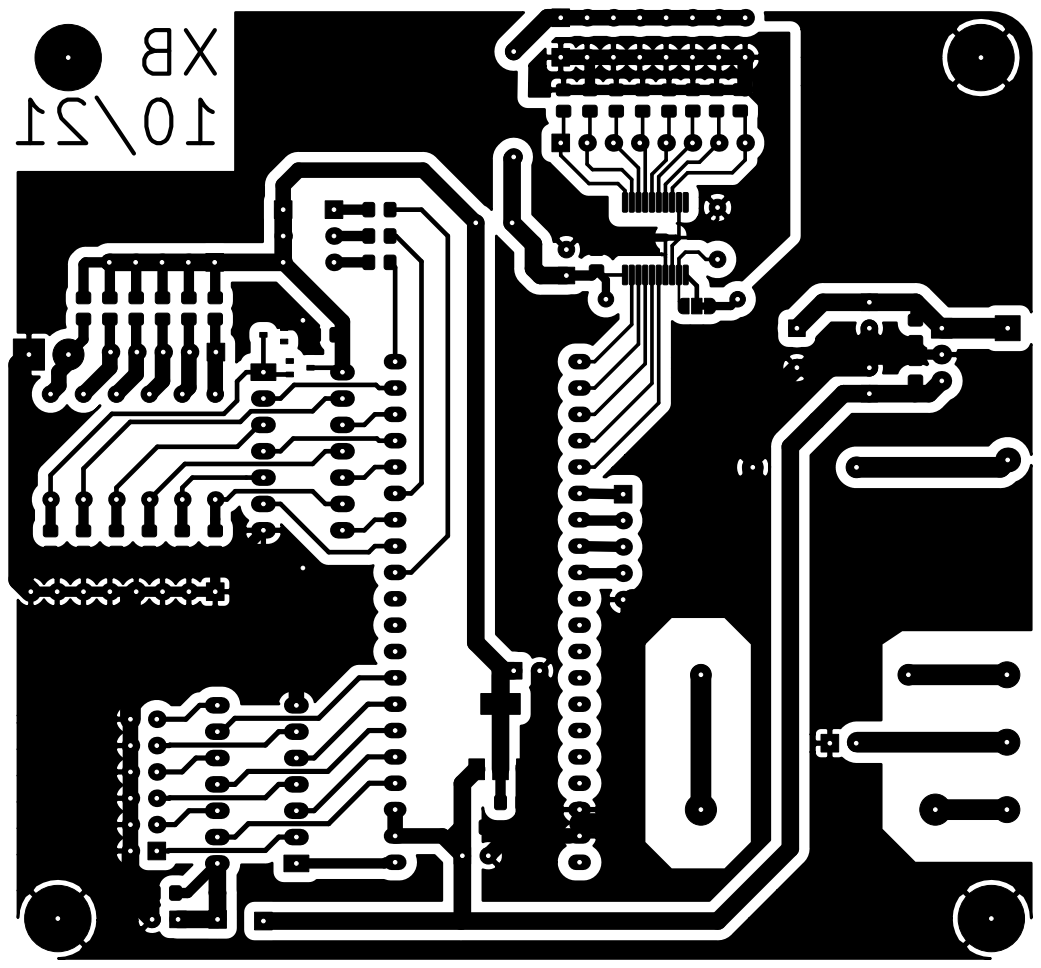
[picture p224: page 1]
