reivax-boucoi/PCB_Kicad/3phase_gen/3phase_gen-B_SilkS.pdf

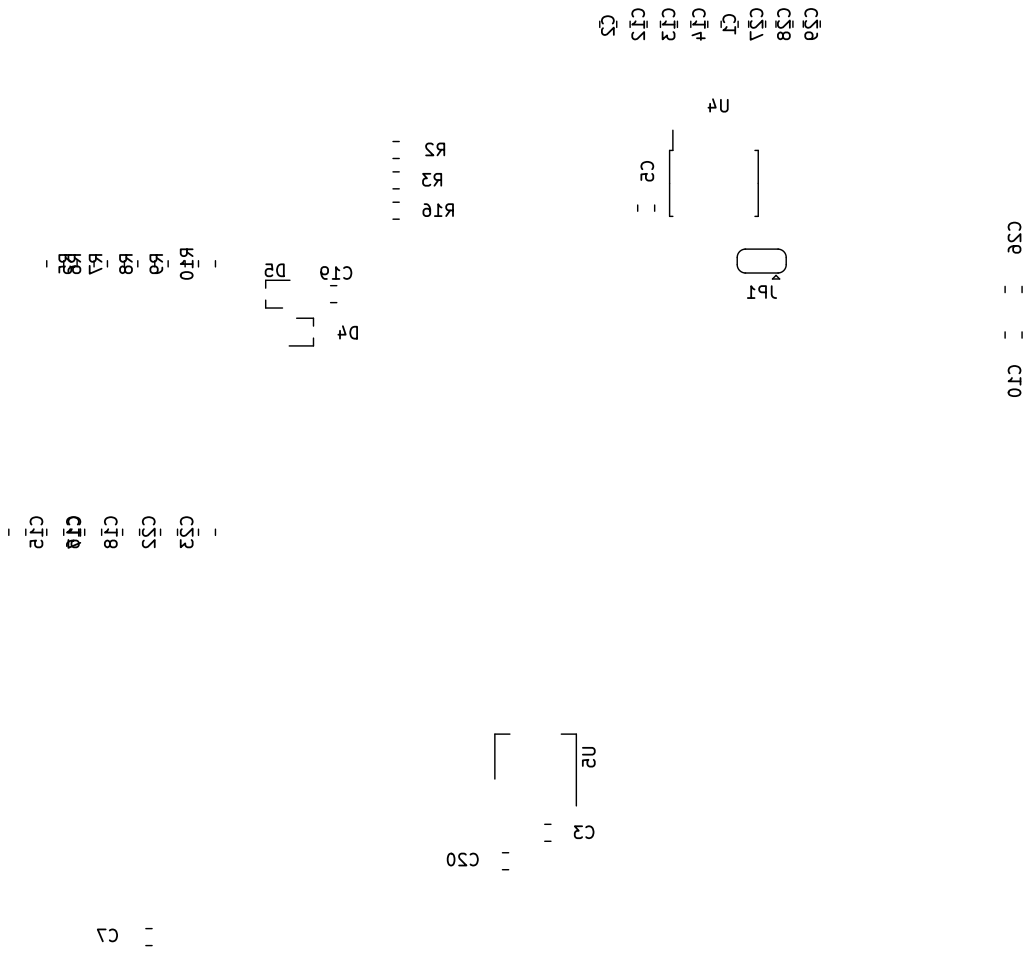
[picture p225: page 1]
