reivax-boucoi/PCB_Kicad/3phase_gen/3phase_gen-Edge_Cuts.pdf

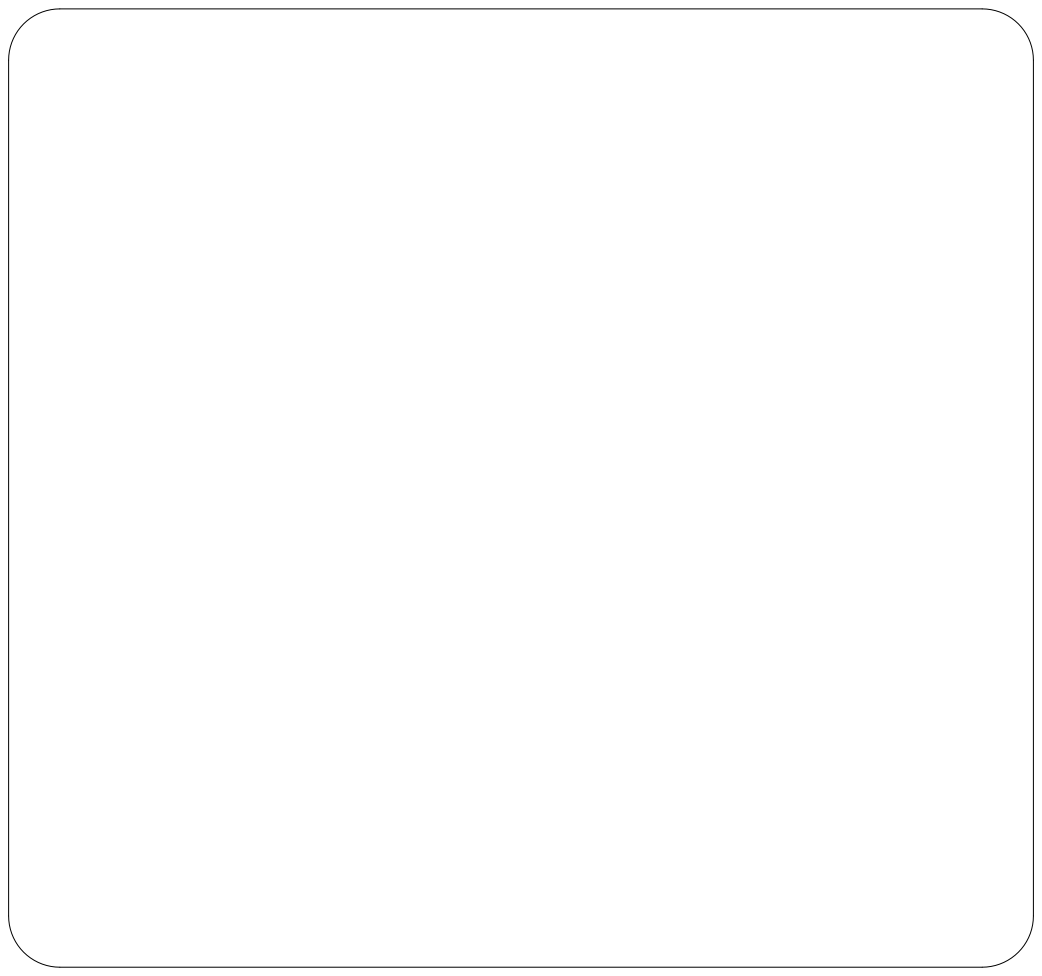
[picture p226: page 1]
