reivax-boucoi/PCB_Kicad/3phase_gen/3phase_gen-F_Fab.pdf

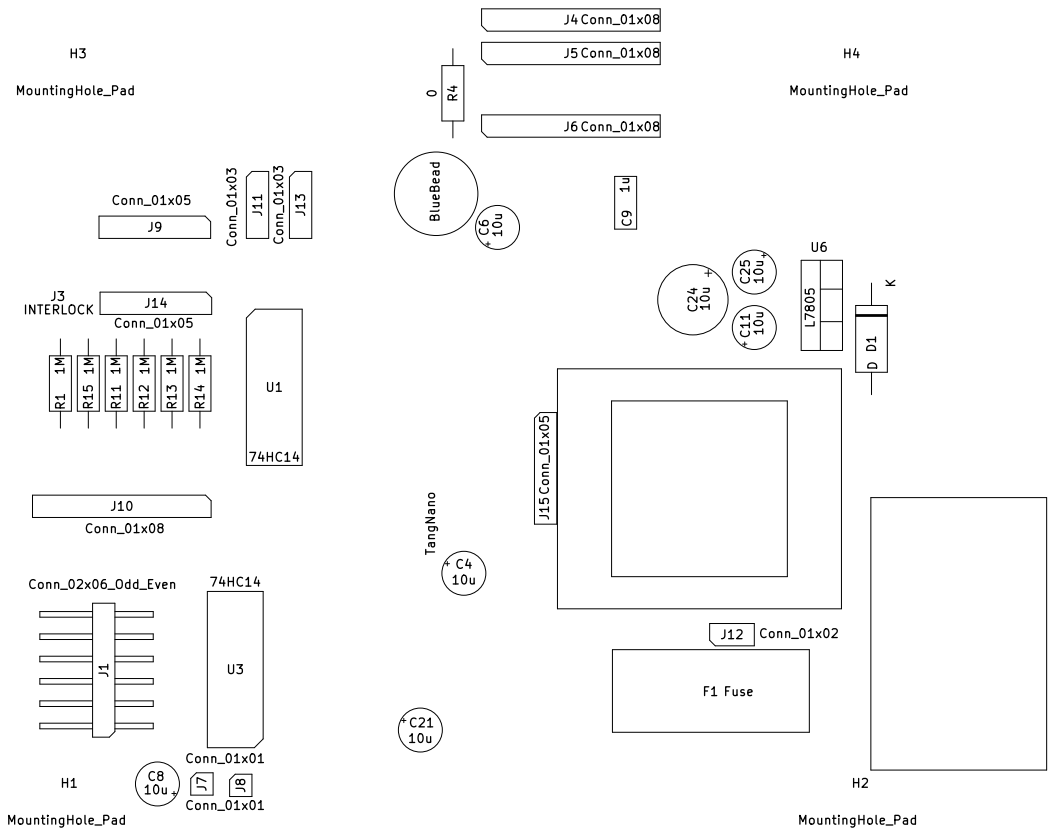
[picture p227: page 1]
