reivax-boucoi/PCB_Kicad/3phase_gen/3phase_gen-F_SilkS.pdf

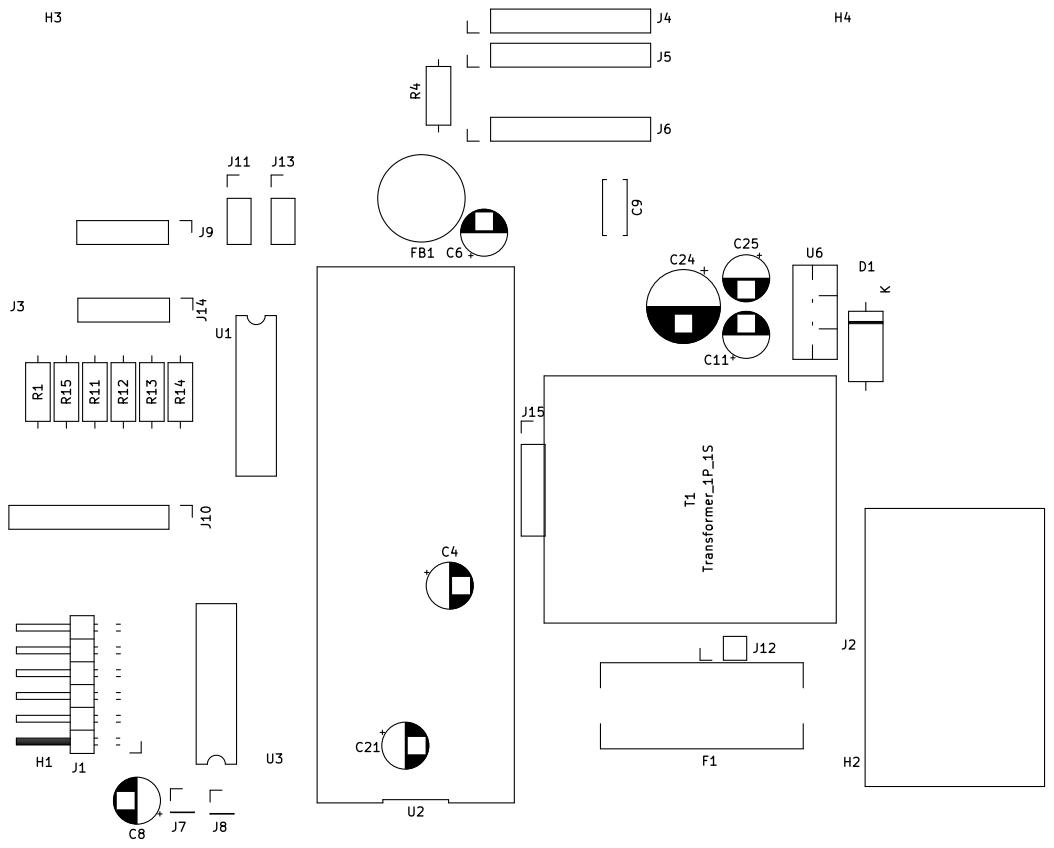
[picture p228: page 1]
