reivax-boucoi/PCB_Kicad/bike_lights/output/bike_lights.pdf

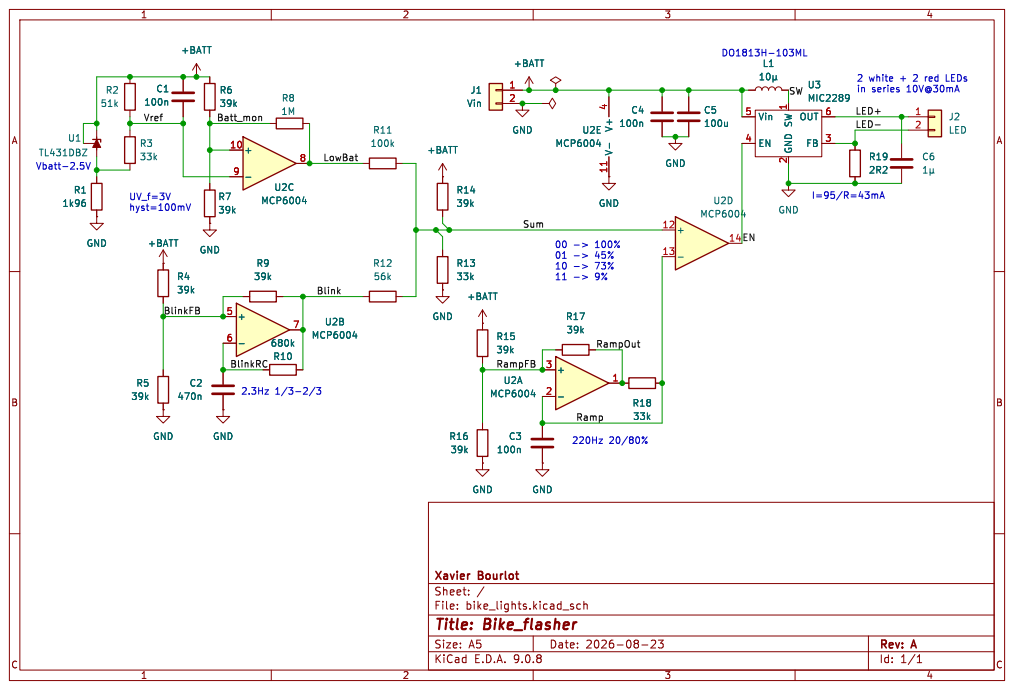
[picture p229: page 1]
