reivax-boucoi/PCB_Kicad/hv_discharge_v2c/Discharge.asc

C1: cap; 10µ
Cdclink: cap; 12mF
D1: LED; LUW-W5AP
D2: schottky; 1N5817
M1: nmos
R1: res; 470
R2: res; 560k
R3: res; 560k
R4: res; 330k
R5: res; 2820k
R6: res; 1Meg
R7: res; 1k
R8: res; 1
Ruban: LED; LUW-W5AP
U1: LTC1440
U2: UniversalOpAmp
V1: voltage; 1000
Named nets: 0, Vref, Out, Vsup, Vfb, HVDC, Vdclink, 12V
6x 470k
200V/chip
.tran 1
Oscillates wrt C1/R1
Max 4.3V Min 2.3V
1.2V
8mA pk
10ms ON time
Frequency proportionnal to DClink V
Courant constant
Consigne courant
prop. à Vdclink
