reivax-boucoi/PCB_Kicad/hv_discharge_v2c/Draft2.asc

A1: buf
A2: buf
C1: cap; 3m; Rser=1m
L1: ind; {L}; Rser=5m
L2: ind; 100µ; Rser=10m
S1: sw; MYSW
S2: sw; MYSW
S3: sw; MYSW
S4: sw; MYSW
U1: LT1720
U2: LT1720
V1: voltage; PULSE(0 {VCC} 0 {0.5/Fpwm} {0.5/Fpwm} 0 {1/Fpwm})
V2: voltage; {Ph1Duty*VCC}
V3: voltage; {VCC}
V4: voltage; SINE({VCC/2} {Ph2Amp*VCC} {Ph2Freq} 0 0 90)
V5: voltage; {Vbus}; Rser=1m
Named nets: 0, PWM, PWM1H, PWM1L, COM, PWM1, PWM2H, PWM2L, PWM2, Vbus, Vdc, PH1, PH2
.tran {5/Ph2Freq}
.param Fpwm=10k Ph1Duty=0.5 VCC=5 Ph2Amp=0.05 Ph2Freq=100 L=100µ Vbus=800
.model MYSW SW(Ron=2m Roff=10Meg Vt=.5 Vh=0.1)
Voltage mode: fixed duty cycle
Current: sine modulation
Triangle PWM gen
