reivax-boucoi/PCB_Kicad/hv_discharge_v2c/Draft1.asc

D1: diode
D2: diode
D3: diode
D4: diode
D5: diode
I1: current
I2: current
I3: current
I4: current
M1: nmos
M2: nmos
M3: nmos
M4: nmos
M5: nmos
R1: res; 100
V1: voltage
V2: voltage; 15
Named nets: Vmeas, Imeas
Config 1
Config 2
Config 3
Config 4
Config 5
