reivax-boucoi/PCB_Kicad/hv_discharge_v2c/Rbot_bias_sim.asc

D1: zener; BZX84C8V2L
I1: current; {Ileak}
R1: res; {6*470000}
R2: res; {Rbot}
V1: voltage; PWL(0 0 100m 100)
Named nets: 0, Vgate, VDC
.tran 1
.step param Rbot 100k 1Meg 10k
.param Ileak=100n Rbot=330k
.meas TRAN Vth FIND V(VDC) WHEN V(Vgate)=3.2
