reivax-boucoi/PCB_Kicad/bike_speed_sensor/LTSpice/Draft_withCDload.asc

B1: bv; V=V(cap)*I(C1)
B2: bv; V=-{N}*{A}*ddt(V(Bext))
B3: bv; V=-{N}*{N}*{mu}*{A}/{len}*ddt(I(L1))
B4: bv; V={N}*{mu}/{len}*I(L1)
B5: bv; V=V(Bint)+V(Bext)
B6: bv; V=-{N}*{A}*ddt(V(Btot))
B7: bv; V=idt(V(Pload))
B8: bv; V=V(Bemf_tot)
C1: cap; 1m
D1: diode; BAT54
D2: diode; BAT54
D3: diode; BAT54
D4: diode; BAT54
L1: ind; {L}
R1: res; {DCR}
V1: voltage; PULSE(0 -300m 1m {dtMag} {dtMag} 1n)
Named nets: 0, load, Bext, Bemf_ext, Bemf_int, Bint, Btot, Bemf_tot, Pload, Eload, cap
.param N=500 D=15m wd=0.1m Cr=1.68e-8 mu=1
.tran {dtMag*5}
.ic I(R1)=0 V(cap)=2.5
.param A=3.1415*D*D/4 coil_depth=wd*N len=3.1415*(D+coil_depth) coil_len=len*N DCR=Cr*coil_len/(3.1415*wd*wd/4) L=D*D/4*N*N/(203.2*D/2+279.4*coil_depth)*1m
.meas DCR_ param DCR
.meas Lself_ PARAM L*1e6
.meas Vbike param v_bike
.meas Frep param f_rep
.meas TRAN Vpkload MAX ABS(V(load))
.meas TRAN Eload MAX V(Eload)
.meas Pavg param Eload*Frep
.meas Iavg param Pavg/2.5
.step dec param N 10 10k 20
.param wheel_P=2.174 magnet_pos=0.9 v_bike=25 v_ms=v_bike/3.6 f_rep=v_ms/wheel_P dtMag=2*D/v_ms*magnet_pos
.step param v_bike list 3 25 60
.step param mu list 1 10
