reivax-boucoi/PCB_Kicad/bike_speed_sensor/LTSpice/Draft_withRload.asc

B1: bv; V=-V(load)*I(R2)
B2: bv; V=-{N}*{A}*ddt(V(Bext))
B3: bv; V=-{N}*{N}*{A}/{len}*ddt(I(L1))
B4: bv; V={N}/{len}*I(L1)
B5: bv; V=V(Bint)+V(Bext)
B6: bv; V=-{N}*{A}*ddt(V(Btot))
B7: bv; V=idt(V(Pload))
L1: ind; {L}
R1: res; {DCR}
R2: res; {Rload}
V1: voltage; PULSE(0 300m 1m 5m 5m 1n)
Named nets: 0, load, Bext, Bemf_ext, Bemf_int, Bemf_tot, Bint, Btot, Pload, Eload
.param N=10 D=15m wd=0.1m Cr=1.68e-8 Rload=10
.tran 25m
.ic I(R1)=0
.param A=3.1415*D*D/4 coil_depth=wd*N len=3.1415*(D+coil_depth) coil_len=len*N DCR=Cr*coil_len/(3.1415*wd*wd/4) L=D*D/4*N*N/(203.2*D/2+279.4*coil_depth)*1m
.meas DCR_ param DCR
.meas Lself_ PARAM L*1e6
.meas TRAN Vpkload MAX ABS(V(load))
.meas TRAN Eload MAX V(Eload)
.step dec param Rload 1 10k 20
.step param N list 5 10 20
