reivax-boucoi/PCB_Kicad/transistor_clock/LTSpice/Draft3.asc

C1: cap; C1206C106K3RAC
C2: cap; C1206C106K3RAC
C3: cap; C0603C104K3RAC
I1: current; PULSE(0 2 0 1u 1n 1n 2u); AC 1
L1: ind; CBA_0402_782429261_260ohm
V1: voltage; 12
Named nets: 0, Vsup
.tran 200u
.ac oct 100 1 1e9
.SUBCKT C0603C104K3RAC 1 6
*Temp = 25°C, Bias = 0VDC, Center Frequency = 10000 Hz
*KEMET Model RLC Cerm
R1 3 4 2.65222787857056
R2 2 5 2.25999999046326
R3 1 6 10000000000
L1 1 2 3.7999997593019E-11
L2 2 3 7.2199995426736E-10
C1 4 6 9.63658450814364E-08
C2 5 6 2.04999995231628E-12
.ENDS
.SUBCKT C1206C106K3RAC 1 6
*Temp = 25°C, Bias = 0VDC, Center Frequency = 10000 Hz
*KEMET Model RLC Cerm
R1 3 4 0.0520095974206924
R2 2 5 0.469999998807907
R3 1 6 125000000
L1 1 2 3.04999997480238E-11
L2 2 3 5.79499995212451E-10
C1 4 6 7.7092681749491E-06
C2 5 6 6.00000023841858E-13
.ENDS
.subckt CBA_0402_782429261_260ohm 1 2
Rp 1 2 393.732923
Cp 1 2 0.6121285421p
Rs 1 N3 0.12
L1 N3 2 0.617816383u
.ends CBA_0402_782429261_260ohm
