reivax-boucoi/PCB_Kicad/transistor_clock/LTSpice/10counter.asc

B1: bv; V=(V(O1)*1+V(O2)*2+V(O3)*3+V(O4)*4+V(O5)*5+V(O6)*6+V(O7)*7+V(O8)*8+V(O9)*9)/3.83
B2: bv; V=(V(Oh1)*1+V(Oh2)*2)/3.83*10
B3: bv; V=V(Units)+V(Tens)
C1: cap; 1n
C2: cap; {Cn}
C3: cap; 100n
C4: cap; {Cn}
C5: cap; {Cn}
C6: cap; {Cn}
C7: cap; {Cn}
C8: cap; {Cn}
C9: cap; {Cn}
C10: cap; {Cn}
C11: cap; {Cn}
C12: cap; {Cn}
C13: cap; {Cn}
C14: cap; {Cn}
C15: cap; 2n
C16: cap; 10n
C17: cap; 10n
C18: cap; 22n
D1: LED; LXHL-BW02; N=10
D2: diode; 1N4148
D3: diode; 1N4148
D4: diode; 1N4148
D5: diode; 1N4148
D6: diode; 1N4148
D7: diode; 1N4148
D8: diode; 1N4148
D9: diode; 1N4148
D10: diode; 1N4148
D11: diode; 1N4148
D12: diode; 1N4148
D13: diode; 1N4148
D14: diode; 1N4148
D15: diode; 1N4148
D16: diode; 1N4148
D17: diode; 1N4148
D18: diode; 1N4148
D19: diode; 1N4148
D20: diode; 1N4148
D21: diode; 1N4148
D22: diode; 1N4148
D23: diode; 1N4148
D24: diode; 1N4148
D25: diode; 1N4148
D26: LED; LXHL-BW02; N=10
D27: diode; 1N4148
D28: LED; LXHL-BW02; N=10
D29: diode; 1N4148
D30: LED; LXHL-BW02; N=10
D31: diode; 1N4148
D32: LED; LXHL-BW02; N=10
D33: diode; 1N4148
D34: LED; LXHL-BW02; N=10
D35: diode; 1N4148
D36: LED; LXHL-BW02; N=10
D37: diode; 1N4148
D38: LED; LXHL-BW02; N=10
D39: diode; 1N4148
D40: LED; LXHL-BW02; N=10
D41: diode; 1N4148
D42: LED; LXHL-BW02; N=10
D43: diode; 1N4148
D44: LED; LXHL-BW02; N=10
D45: diode; 1N4148
D46: LED; LXHL-BW02; N=10
D47: diode; 1N4148
Q1: npn; 2N5550
Q2: npn; 2N3904
Q3: npn; 2N3904
Q4: pnp; 2N3906
Q5: npn; 2N3904
Q6: pnp; 2N3906
Q7: npn; 2N3904
Q8: pnp; 2N3906
Q9: npn; 2N3904
Q10: pnp; 2N3906
Q11: npn; 2N3904
Q12: pnp; 2N3906
Q13: npn; 2N3904
Q14: pnp; 2N3906
Q15: npn; 2N3904
Q16: pnp; 2N3906
Q17: npn; 2N3904
Q18: pnp; 2N3906
Q19: npn; 2N3904
Q20: pnp; 2N3906
Q21: npn; 2N3904
Q22: pnp; 2N3906
Q23: npn; 2N3904
Q24: npn; 2N5550
Q25: pnp; 2N3906
Q26: npn; 2N3904
Q27: pnp; 2N3906
Q28: npn; 2N3904
Q29: pnp; 2N3906
Q30: npn; 2N3904
Q31: npn; 2N3904
Q32: npn; 2N3904
Q33: npn; 2N5550
Q34: npn; 2N5550
Q35: npn; 2N3904
Q36: npn; 2N5550
Q37: npn; 2N5550
Q38: npn; 2N5550
Q39: npn; 2N5550
Q40: npn; 2N5550
Q41: npn; 2N5550
Q42: npn; 2N5550
Q43: npn; 2N5550
Q44: npn; 2N3904
Q45: pnp; 2N3906
R1: res; 10k
R2: res; 100k
R3: res; 10k
R4: res; 10k
R5: res; {Rrst}
R6: res; 10k
R7: res; 10k
R8: res; 3k9
R9: res; {Rbot}
R10: res; {Rb}
R11: res; {Rvref}
R12: res; {Rrst}
R13: res; {Rbot}
R14: res; {Rb}
R15: res; {Rvref}
R16: res; {Rrst}
R17: res; {Rbot}
R18: res; {Rb}
R19: res; {Rvref}
R20: res; 2k2
R21: res; {LDR}
R22: res; 2k2
R23: res; {Rrst}
R24: res; {Rbot}
R25: res; {Rb}
R26: res; {Rvref}
R27: res; {Rrst}
R28: res; {Rbot}
R29: res; {Rb}
R30: res; {Rvref}
R31: res; {Rrst}
R32: res; {Rbot}
R33: res; {Rb}
R34: res; {Rvref}
R35: res; {Rrst}
R36: res; {Rbot}
R37: res; {Rb}
R38: res; {Rvref}
R39: res; {Rrst}
R40: res; {Rbot}
R41: res; {Rb}
R42: res; {Rvref}
R43: res; {Rrst}
R44: res; {Rbot}
R45: res; {Rb}
R46: res; {Rvref}
R47: res; {Rrst}
R48: res; {Rbot}
R49: res; {Rb}
R50: res; {Rvref}
R51: res; 10k
R52: res; 14k
R53: res; {Rrst}
R54: res; {Rbot}
R55: res; {Rb}
R56: res; {Rvref}
R57: res; {Rrst}
R58: res; {Rbot}
R59: res; {Rb}
R60: res; {Rvref}
R61: res; {Rrst}
R62: res; {Rbot}
R63: res; {Rb}
R64: res; {Rvref}
R65: res; 1k
R66: res; 2k2
R67: res; 1k
R68: res; 1k
R69: res; 10k
R70: res; 100k
R71: res; 10k
R72: res; 14.3k
R73: res; 10k
R74: res; 100k
R75: res; 100k
R76: res; 10k
R77: res; 100k
R78: res; 10k
R79: res; 100k
R80: res; 10k
R81: res; 100k
R82: res; 10k
R83: res; 100k
R84: res; 10k
R85: res; 14k
R86: res; 10k
R87: res; 100k
R88: res; 10k
R89: res; 100k
R90: res; 10k
R91: res; 100k
R92: res; 2k2
R93: res; 10k
R94: res; 100k
V1: voltage; 80
V2: voltage; 12
V3: voltage; PULSE(0 12 0 1n 1n 10m 20m)
Named nets: VCC, 0, Vref, Vd, O3, CLK, S1, S2, S3, O1, O2, T1, T2, T3, O4, O5, O6, O7, O8, O9, O0, Oh0, Oh1, Oh2, src_clk, Sh0, Th1, Units, Tens, Tot, S4, S5, S6, S7, S8, S9, Th2, Th0, Sh1, Sh2, S0, T0, T4, T5
.tran 2
.step param LDR list 1Meg 10k
.param Cn=1n Rrst=2k2 Rbot=2k2 Rvref=10k Rb=10k
.param LDR 100Meg
.ic V(Sh1,Th2)=12 V(T1,S2)=0
.meas TRAN maxUnit MAX V(Units)
.meas TRAN maxTens MAX V(Tens)
.meas TRAN maxTot MAX V(Tot)
