reivax-boucoi/PCB_Kicad/transistor_clock/LTSpice/24counter_flipflop.asc

B1: bv; V=(V(Q1n)*1+V(Q2n)*2+V(Q3n)*4+V(Q4n)*8+V(Q5n)*16)/11
C1: cap; {Cf}
C2: cap; {Cf}
C3: cap; 1n
C4: cap; {Cf}
C5: cap; {Cf}
C6: cap; 220p
C7: cap; 220p
C8: cap; {Cf}
C9: cap; {Cf}
C10: cap; 200p
C11: cap; {Cf}
C12: cap; {Cf}
C13: cap; 200p
C14: cap; {Cf}
C15: cap; {Cf}
C16: cap; 10n
D1: diode; 1N4148
D2: diode; 1N4148
D3: diode; 1N4148
D4: diode; 1N4148
D5: diode; 1N4148
D6: diode; 1N4148
D7: diode; 1N4148
D8: diode; 1N4148
D9: diode; 1N4148
D10: diode; 1N4148
D11: diode; 1N4148
D12: diode; 1N4148
D13: diode; 1N4148
D14: diode; 1N4148
D15: diode; 1N4148
D16: diode; 1N4148
D17: diode; 1N4148
D18: diode; 1N4148
D19: diode; 1N4148
D20: diode; 1N4148
Q1: npn; 2N3904
Q2: npn; 2N3904
Q3: npn; 2N3904
Q4: npn; 2N3904
Q5: npn; 2N3904
Q6: npn; 2N3904
Q7: npn; 2N3904
Q8: npn; 2N3904
Q9: npn; 2N3904
Q10: npn; 2N3904
Q11: npn; 2N3904
R1: res; {Rt}
R2: res; {Rt}
R3: res; {Rp}
R4: res; {Rp}
R5: res; 10k
R6: res; 100k
R7: res; 100k
R8: res; {Rt}
R9: res; {Rt}
R10: res; {Rp}
R11: res; {Rp}
R12: res; 100k
R13: res; 100k
R14: res; 10k
R15: res; 100k
R16: res; 100k
R17: res; 100k
R18: res; 10k
R19: res; {Rt}
R20: res; {Rt}
R21: res; {Rp}
R22: res; {Rp}
R23: res; 100k
R24: res; 10k
R25: res; {Rt}
R26: res; {Rt}
R27: res; {Rp}
R28: res; {Rp}
R29: res; 100k
R30: res; 100k
R31: res; 10k
R32: res; {Rt}
R33: res; {Rt}
R34: res; {Rp}
R35: res; {Rp}
R36: res; 10k
V1: voltage; 12
V2: voltage; PULSE(12 0 5m 1u 1u 50u 5m)
V3: voltage; PULSE(0 12 1m 10u 10u 1m)
Named nets: 0, vcc, Q1, Q1n, B1, B1n, clk1, Q2, Q2n, B2, B2n, clk2, Q3, Q3n, B3, B3n, clk4, Q4, Q4n, B4, B4n, clk8, Q5, Q5n, B5, B5n, clk16
.tran 250m
.param Rt=10k Cf=220p Rp=100k
