reivax-boucoi/PCB_Kicad/transistor_clock/LTSpice/6counter.asc

C1: cap; 1n
C2: cap; {Cn}
C3: cap; 100n
C4: cap; {Cn}
C5: cap; {Cn}
C6: cap; {Cn}
C18: cap; 22n
D1: LED; LXHL-BW02; N=10
D2: diode; 1N4148
D3: diode; 1N4148
D4: diode; 1N4148
D5: diode; 1N4148
D7: diode; 1N4148
D8: diode; 1N4148
D26: LED; LXHL-BW02; N=10
D27: diode; 1N4148
D28: LED; LXHL-BW02; N=10
D29: diode; 1N4148
D30: LED; LXHL-BW02; N=10
D31: diode; 1N4148
D36: LED; LXHL-BW02; N=10
D37: diode; 1N4148
D42: LED; LXHL-BW02; N=10
D43: diode; 1N4148
Q1: npn; 2N5550
Q2: npn; 2N3904
Q3: npn; 2N3904
Q4: pnp; 2N3906
Q5: npn; 2N3904
Q6: pnp; 2N3906
Q7: npn; 2N3904
Q8: pnp; 2N3906
Q9: npn; 2N3904
Q10: pnp; 2N3906
Q11: npn; 2N3904
Q12: pnp; 2N3906
Q13: npn; 2N3904
Q24: npn; 2N5550
Q33: npn; 2N5550
Q34: npn; 2N5550
Q38: npn; 2N5550
Q41: npn; 2N5550
R1: res; 10k
R2: res; 100k
R3: res; 10k
R4: res; 10k
R5: res; {Rrst}
R6: res; 10k
R7: res; 10k
R8: res; 3k9
R9: res; {Rbot}
R10: res; {Rb}
R11: res; {Rvref}
R12: res; {Rrst}
R13: res; {Rbot}
R14: res; {Rb}
R15: res; {Rvref}
R16: res; {Rrst}
R17: res; {Rbot}
R18: res; {Rb}
R19: res; {Rvref}
R20: res; 2k2
R21: res; {LDR}
R23: res; {Rrst}
R24: res; {Rbot}
R25: res; {Rb}
R26: res; {Rvref}
R27: res; {Rrst}
R28: res; {Rbot}
R29: res; {Rb}
R30: res; {Rvref}
R51: res; 10k
R52: res; 14k
R71: res; 10k
R72: res; 14.3k
R73: res; 10k
R75: res; 100k
R80: res; 10k
R81: res; 100k
R86: res; 10k
R87: res; 100k
V1: voltage; 80
V2: voltage; 12
V3: voltage; PULSE(0 12 0 1n 1n 10m 20m)
Named nets: VCC, 0, Vref, Vd, O3, CLK, S1, S2, S3, O1, O2, T1, T2, T3, O4, O5, src_clk, S4, S5, T4, T5, O0
.tran 2
.step param LDR list 1Meg 10k
.param Cn=1n Rrst=2k2 Rbot=2k2 Rvref=10k Rb=10k
.param LDR 100Meg
.ic V(T1,S2)=0
