reivax-boucoi/PCB_Kicad/transistor_clock/LTSpice/DoublersXFMR_CZ.asc

C1: cap; 60µ
C2: cap; 10µ
C4: cap; {Cb}
C13: cap; 220µ
C15: cap; {Cv}
C16: cap; {Cv}
C17: cap; {Cb}
C18: cap; {Cb}
C19: cap; {Cb}
D1: zener; 1N750
D13: diode; 1N4148
D14: diode; 1N4148
D15: diode; 1N4148
D16: diode; 1N4148
D17: diode; 1N4148
D18: diode; 1N4148
I5: current; PULSE(20m 35m 1.7 1n 1n 100m)
I6: current; {Iled}
M1: nmos; QS6K21
Q3: npn; 2N3904
R1: res; 2k2
R2: res; 10k
R3: res; 15k
R4: res; 2k2
V3: voltage; SINE(0 17.2 50); Rser=8
Named nets: Vout2, 0, Vled2
.step param Iled list 0m 15m 20m
.tran 2
.param Cv=470u Cb=470u Iled=15m Isup=20m
.step param Isup list 0m 20m 40m
