reivax-boucoi/PCB_Kicad/transistor_clock/LTSpice/Draft2.asc

C1: cap; 68n
C2: cap; 100n
D1: diode; 1N4148
Q1: npn; 2N3904
Q2: pnp; 2N3906
Q4: npn; 2N3904
Q5: pnp; 2N3906
R1: res; {Rch}
R2: res; 1k
R3: res; 10k
R4: res; 10
R5: res; 1k
R6: res; 10k
R8: res; 100k
V1: voltage; 12
V2: voltage; 12
Named nets: 0, vref, vcc, out, chg, chg1
.param Rch=100k
.tran 500m
.ic V(chg)=12
.ic V(chg1)=0
