reivax-boucoi/PCB_Kicad/transistor_clock/LTSpice/HVPSU.asc

C1: cap; 10µ
C2: cap; 1µ
C3: cap; 1n
D1: diode; MMSD4148
D3: zener; 1N5373B
I1: current; PWL(0 0 10m 0 11m 12m)
L1: ind2; 100µ
Q1: npn; 2N5550
Q2: npn; 2N3904
Q3: pnp; 2N3906
R1: res; 5.1
R2: res; 470
R3: res; 10k
R4: res; 1k
R5: res; 100k
V1: voltage; 12; Rser=1
Named nets: 0, VCC, vled, Isense
.tran 20m startup
