reivax-boucoi/PCB_Kicad/transistor_clock/LTSpice/LVPSU.asc

C1: cap; {Craw}
C2: cap; 10µ
C3: cap; 50µ
D1: diode
D2: diode
D3: diode
D4: diode
D5: diode; 1N4148
D6: zener; BZX84C12L
I1: current; {Iload}
I2: current; 135m
Q1: npn; 2N3055
Q2: npn; 2N3904
R1: res; 1k
V2: voltage; SINE(0 20 50)
Named nets: 0, Vraw, Vout
.tran 2
.step param Iload 0 100m 10m
.param Craw 40u
.meas TRAN Vinpp PP V(vraw) FROM 1.5 TO 2
.meas TRAN Vin_min MIN V(vraw) FROM 1.5 TO 2
.meas TRAN Voutpp PP V(Vout) FROM 1.5 TO 2
.meas TRAN Vout_min MIN V(Vout) FROM 1.5 TO 2
.step param Craw list 60u 280u
