reivax-boucoi/PCB_Kicad/transistor_clock/LTSpice/XFMR_CZ.asc

C1: cap; 470µ
D1: diode
D2: diode
D3: diode
D4: diode
R1: res; {Load}
V1: voltage; SINE(0 17.2 50); Rser=8
Named nets: 0, Vout
.tran 2
.meas TRAN Vout AVG V(Vout) FROM 1.9 TO 2
.meas TRAN Iout AVG I(R1) FROM 1.9 TO 2
.meas TRAN Vout_pp PP V(Vout) FROM 1.9 TO 2
.param Load=10Meg
.step param Load list 10Meg 210.6 110.6 64.2 60.6 30 24.2 20.6 14.2 3.6
