reivax-boucoi/PCB_Kicad/transistor_clock/LTSpice/Draft1.asc

C1: cap; 220µ
C2: cap; {Cv}
C3: cap; {Cv}
C4: cap; {Cb}
C5: cap; {Cb}
C6: cap; {Cb}
C7: cap; 60µ
C8: cap; 10µ
C9: cap; 10n
C10: cap; 220p
C11: cap; 100n
C12: cap; 1µ
C13: cap; 1µ
C14: cap; 100n
C15: cap; {Cn}
C16: cap; {Cn}
C17: cap; {Cn}
C18: cap; {Cn}
C19: cap; {Cn}
C20: cap; {Cn}
C21: cap; {Cn}
C22: cap; {Cn}
C23: cap; {Cn}
C24: cap; {Cn}
C25: cap; 10µ
C26: cap; {Cn}
C27: cap; {Cn}
C28: cap; {Cn}
C29: cap; {Cn}
C30: cap; {Cn}
C31: cap; 22n
C32: cap; {Cn}
C33: cap; {Cn}
C34: cap; {Cn}
C35: cap; {Cn}
C36: cap; {Cn}
C37: cap; 22n
C38: cap; 10µ
C39: cap; {Cn}
C40: cap; {Cn}
C41: cap; {Cn}
C42: cap; {Cn}
C43: cap; {Cn}
C44: cap; {Cn}
C45: cap; {Cn}
C46: cap; {Cn}
C47: cap; {Cn}
C48: cap; {Cn}
C49: cap; 22n
C50: cap; 10µ
C51: cap; {Cn}
C52: cap; {Cn}
C53: cap; 22n
C54: cap; 10µ
C63: cap; {Cn}
C64: cap; {Cn}
C65: cap; {Cn}
C66: cap; {Cn}
C67: cap; {Cn}
C68: cap; {Cn}
C69: cap; {Cn}
C70: cap; {Cn}
C71: cap; {Cn}
C72: cap; {Cn}
C73: cap; 22n
C74: cap; 10µ
C75: cap; {Cn}
C76: cap; {Cn}
C77: cap; {Cn}
C85: cap; 22n
C86: cap; 10µ
D1: diode; 1N4148
D2: diode; 1N4148
D3: diode; 1N4148
D4: diode; 1N4148
D5: diode; 1N4148
D6: diode; 1N4148
D7: zener; 1N750
D8: diode; 1N4148
D9: diode; 1N4148
D10: diode; 1N4148
D11: diode; 1N4148
D12: diode; 1N4148
D13: diode; 1N4148
D14: diode; 1N4148
D15: diode; 1N4148
D16: diode; 1N4148
D17: diode; 1N4148
D18: diode; 1N4148
D19: diode; 1N4148
D20: diode; 1N4148
D21: diode; 1N4148
D22: diode; 1N4148
D23: diode; 1N4148
D24: diode; 1N4148
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
R300: res; {Rbot}
R301: res; {Rb}
R302: res; {Rvref}
R303: res; {Rrst}
R304: res; {Rbot}
R305: res; {Rb}
R306: res; {Rvref}
R307: res; 10k
R308: res; 14.3k
R309: res; 10k
R310: res; 14.3k
R311: res; 10k
R312: res; 14.3k
R313: res; 10k
R314: res; 14.3k
R315: res; 10k
R316: res; 14.3k
R317: res; 10k
R318: res; 14.3k
R319: res; 10k
R320: res; 14.3k
R321: res; 10k
R322: res; 10k
R323: res; {Rrst}
R324: res; {Rbot}
R325: res; {Rb}
R326: res; {Rvref}
R327: res; {Rrst}
R328: res; {Rbot}
R329: res; {Rb}
R330: res; {Rvref}
R331: res; {Rrst}
R332: res; {Rbot}
R333: res; {Rb}
R334: res; {Rvref}
R335: res; 2k2
R364: res; 10k
R365: res; 14.3k
R368: res; 10k
R369: res; 14.3k
R370: res; 10k
R371: res; 14.3k
R372: res; 10k
R373: res; 14.3k
R374: res; 10k
R375: res; 14.3k
R376: res; 10k
R377: res; 14.3k
V1: voltage; SINE(0 17.2 50); Rser=8
Named nets: 12V_raw, Vd, 0, VCC, 50Hz, AC_sync, 5Hz, 1Hz, Vref, T2, T3, T0, T4, T5, 10s, 1min, 10min, 1hour, 10hour, S1, S3, S4, S5, S6, S7, S8, S9, Oh2, O4, S2
.param Cv=470u Cb=470u
Ton=8.16ms
SUPPLY
AC SYNC
.tran 20
50Hz->1Hz
Divider
.param Cn=1n Rrst=2k2 Rbot=2k2 Rvref=10k Rb=10k
SECONDS
10 SECONDS
MINUTES
HOURS
10 HOURS
10 MINUTES
