reivax-boucoi/PCB_Kicad/transistor_clock/LTSpice/Oscillator.asc

C1: cap; 220n
C2: cap; 1µ
D1: diode; 1N4148
Q1: npn; 2N3904
Q2: pnp; 2N3906
R1: res; 500k
R2: res; 100
R3: res; 100
R4: res; 10k
R5: res; 100
V1: voltage; PWL(0 0 9.999m 0 10m 12)
V2: voltage; 12
Named nets: VCC, 0, a
.tran {50*1/50}
.ic V(a)=0
