reivax-boucoi/PCB_Kicad/transistor_clock/LTSpice/Dividers.asc

C1: cap; 220n
C2: cap; 1µ5; Rpar=1Meg
C3: cap; 100n
C4: cap; 1µ
C5: cap; 1µ5
C6: cap; 1µ
D1: diode; 1N4148
D2: diode; 1N4148
D3: diode; 1N4148
D4: LED; NSPW500BS
D5: diode; 1N4148
D6: diode; 1N4148
D7: diode; 1N4148
D8: diode; 1N4148
D9: LED; NSPW500BS
D10: diode; 1N4148
Q1: npn; 2N3904
Q2: pnp; 2N3906
Q3: pnp; 2N3906
Q4: npn; 2N3904
Q5: npn; 2N3904
Q6: pnp; 2N3906
Q7: pnp; 2N3906
Q8: npn; 2N3904
Q9: pnp; 2N3906
Q10: pnp; 2N3906
Q11: npn; 2N3904
Q12: pnp; 2N3906
Q13: pnp; 2N3906
Q14: pnp; 2N3906
Q15: npn; 2N3904
Q16: pnp; 2N3906
R1: res; 100k
R2: res; 100k
R3: res; 10k
R4: res; 10k
R5: res; {Rp}
R6: res; 1k
R7: res; 100k
R8: res; 2k2
R9: res; 1k
R10: res; 2k2
R11: res; 10k
R12: res; 330
R13: res; 4k7
R14: res; 100k
R15: res; 100k
R16: res; 10k
R17: res; 10k
R18: res; {Rpn}
R19: res; 1k
R20: res; 100k
R21: res; 2k7
R22: res; 1k
R23: res; 20k
R24: res; 100k
R25: res; 2k2
R26: res; 4k7
R27: res; 100k
R28: res; 2k2
R29: res; 1k
R30: res; 2k2
R31: res; 10k
R32: res; 330
R33: res; 10k
R34: res; 2k7
R35: res; 1k
R36: res; 100k
R39: res; 20k
R40: res; 100k
R41: res; 2k2
R42: res; 10k
V1: voltage; PULSE(0 12 0 10u 10u 8m 20m)
V2: voltage; 12
V4: voltage; 12
Named nets: 0, VCC, out10, VCC1, out10_new, in, out50, out50_new
.tran {150*1/50}
.param Rp=3.9k Rpn=2k7
