reivax-boucoi/PCB_Kicad/transistor_clock/LTSpice/Schmitt_trigger.asc

C1: cap; 100n
C2: cap; 220p
C3: cap; 10n
C4: cap; 220p
D1: diode; 1N4148
D2: diode; 1N4148
D3: diode; 1N4148
D4: diode; 1N4148
Q1: npn; 2N3904
Q2: pnp; 2N3906
Q3: pnp; 2N3906
Q4: npn; 2N3904
Q5: pnp; 2N3906
Q6: pnp; 2N3906
R1: res; 22K
R2: res; 100K
R3: res; 2K2
R4: res; 2K2
R5: res; 470
R6: res; 47k
R7: res; 3k8
R8: res; 10K
R9: res; 100K
R10: res; 100k
R11: res; 100K
R12: res; 10k
R13: res; 10k
R14: res; 1k
R15: res; 100k
R16: res; 10k
R17: res; 10K
R18: res; 100k
V1: voltage; SINE(0 20 50)
V2: voltage; 12
V4: voltage; 12
Named nets: 0, VCC, OUT, VCC1, OUT_new, in
.tran {10*1/50}
Ton=8.16ms
Ton=8.16ms
