reivax-boucoi/PCB_Kicad/50W_LED_boost/sim_ltspice/led_emulator.asc

D1: zener; DFLZ33
D2: zener; UDZV12B
I1: current; {Isnk}
I2: current; {Isnk}
Q1: npn; 2N3055
Q2: npn; 2N2222
Q3: npn; 2N3055
Q4: npn; 2N2222
R1: res; 1k
R2: res; {Rt}
R4: res; 1k
Named nets: 0, Vzen, Vmult
.op
.step param Isnk 100m 2 100m
.step param Rt list 1k 13k
