reivax-boucoi/PCB_Kicad/50W_LED_boost/sim_ltspice/sim.asc

C1: cap; 288µ
D1: schottky; MBR20100CT
G1: g; 1
L1: ind; 100µ
M1: nmos; BSC057N08NS3
R1: res; .12
R2: res; 1
V1: voltage; 12
V2: voltage; PULSE(0 12 0n 250n 250n 15u 19.2u)
V3: voltage; PULSE(1 0.5 20m 10u 10u 30m)
Named nets: 0
.tran 50m
