reivax-boucoi/PCB_Kicad/RCP_PWM_breakout/RCP_PWM_breakout.kicad_pcb

## KiCad design RCP_PWM_breakout/RCP_PWM_breakout.kicad_pcb (2026-09-01)

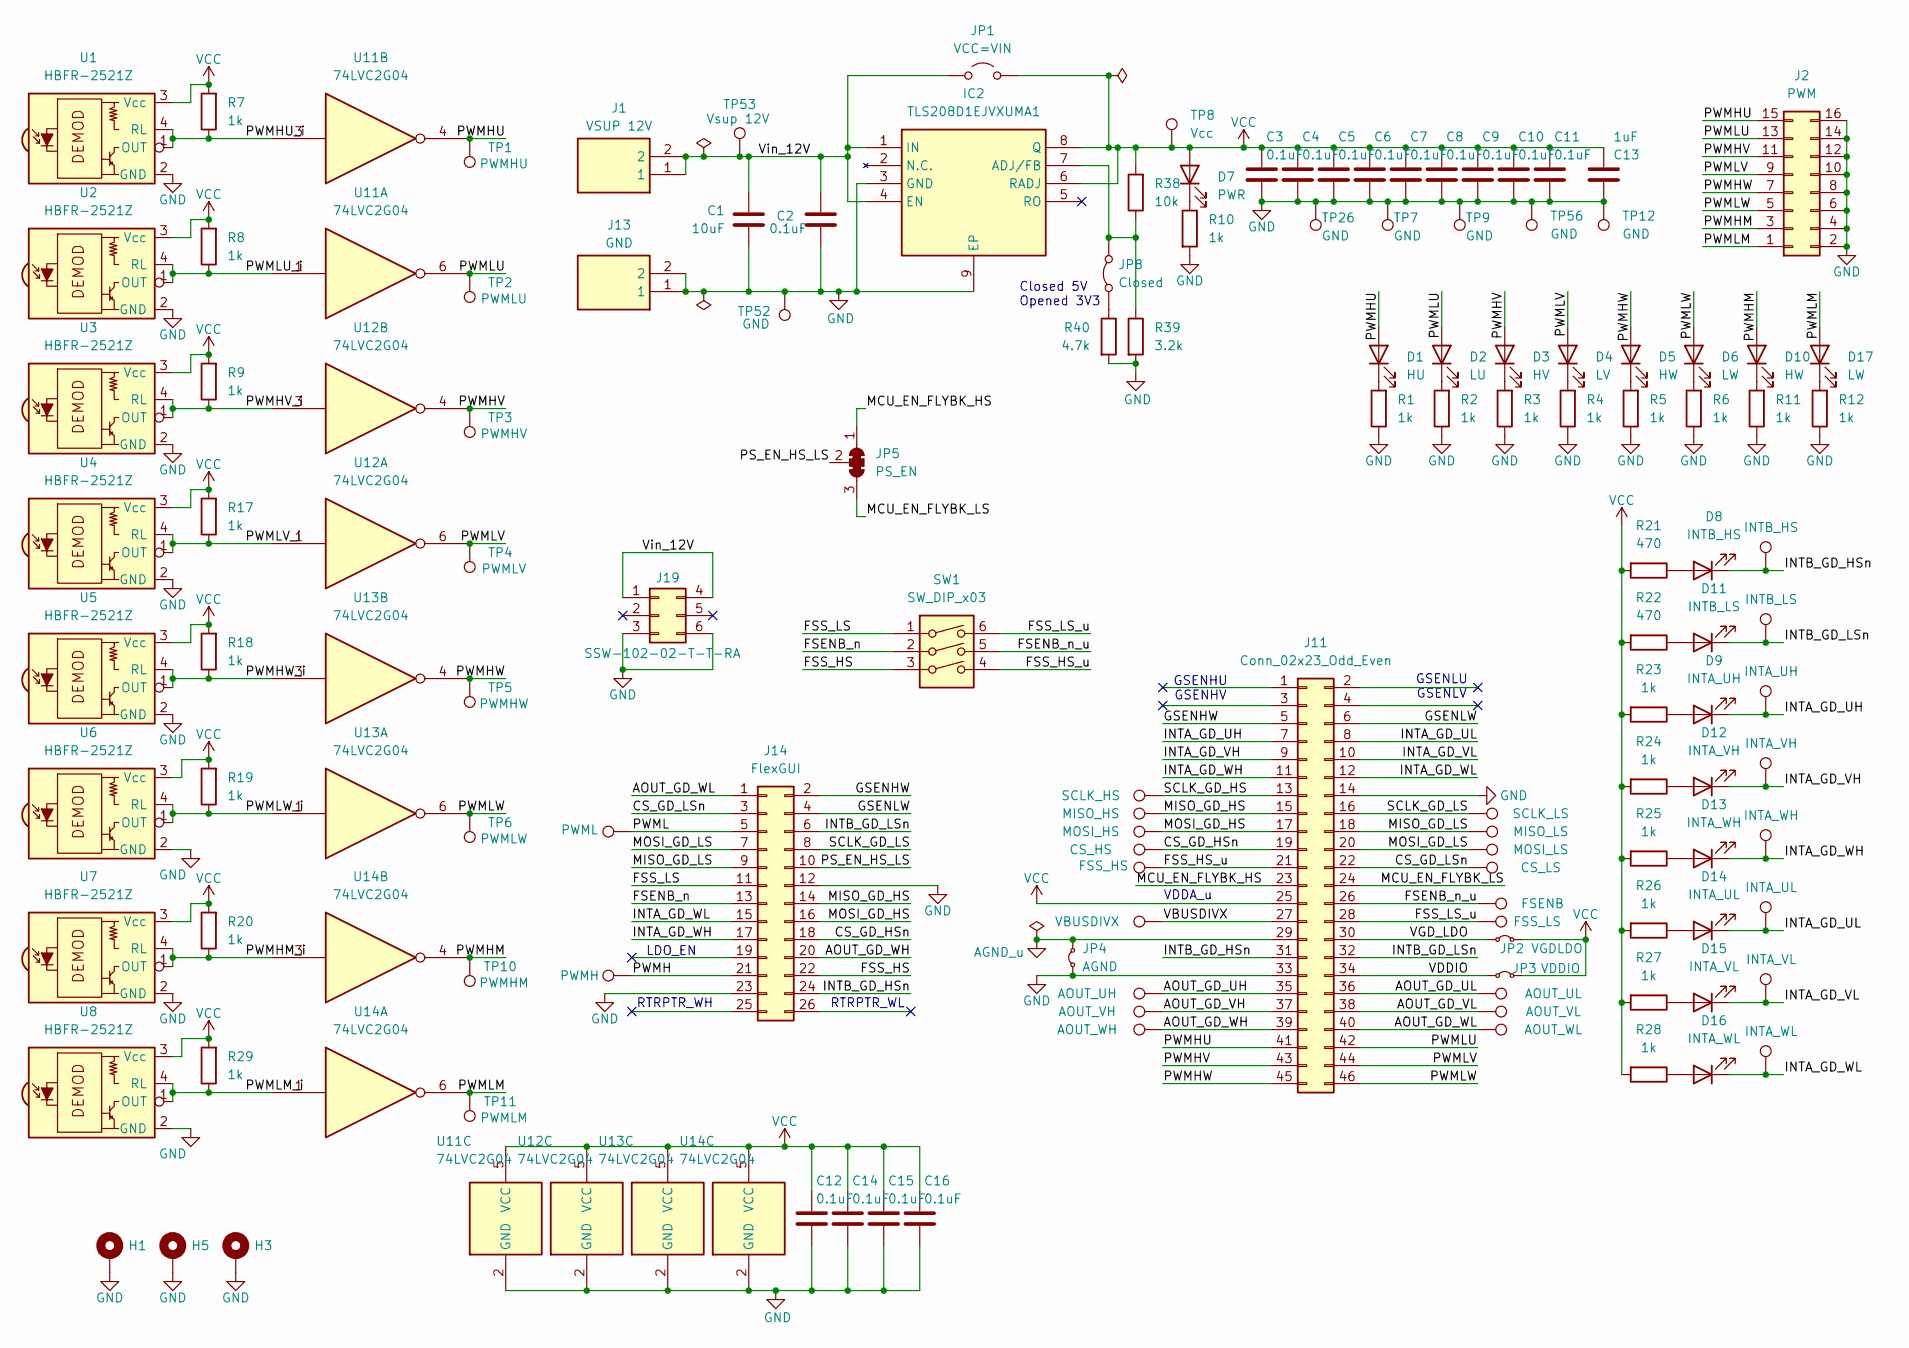
[picture p230: schematic RCP_PWM_breakout.kicad_sch, RCP PWM Breakout]

Parts:
C1: 10uF; C_0805_2012Metric_Pad1.18x1.45mm_HandSolder; MFG_PN 08053D106KAT2A; Mouser Part Number 581-08053D106KAT2A
C2, C3, C4, C5, C6, C7, C8, C9, C10, C11, C12, C14, C15, C16: 0.1uF; C_0603_1608Metric_Pad1.08x0.95mm_HandSolder; MFG_PN 06035C104JAT2A; Mouser Part Number 581-06035C104JAT2A
C13: 1uF; C_0805_2012Metric_Pad1.18x1.45mm_HandSolder; MFG_PN 08053D105KAT2A; Mouser Part Number 581-08053D105K
D1: HU; LED_0805_2012Metric; MFG_PN 598-8140-107F
D2: LU; LED_0805_2012Metric; MFG_PN 598-8140-107F
D3: HV; LED_0805_2012Metric; MFG_PN 598-8140-107F
D4: LV; LED_0805_2012Metric; MFG_PN 598-8140-107F
D5, D10: HW; LED_0805_2012Metric; MFG_PN 598-8140-107F
D6, D17: LW; LED_0805_2012Metric; MFG_PN 598-8140-107F
D7: PWR; LED_0805_2012Metric; MFG_PN 598-8181-107F
D8: INTB_HS; LED_0805_2012Metric; MFG_PN 598-8110-107F
D9: INTA_UH; LED_0805_2012Metric; MFG_PN 598-8130-107F
D11: INTB_LS; LED_0805_2012Metric; MFG_PN 598-8110-107F
D12: INTA_VH; LED_0805_2012Metric; MFG_PN 598-8130-107F
D13: INTA_WH; LED_0805_2012Metric; MFG_PN 598-8130-107F
D14: INTA_UL; LED_0805_2012Metric; MFG_PN 598-8130-107F
D15: INTA_VL; LED_0805_2012Metric; MFG_PN 598-8130-107F
D16: INTA_WL; LED_0805_2012Metric; MFG_PN 598-8130-107F
H1, H3, H5: MountingHole_Pad; MountingHole_3.2mm_M3_DIN965_Pad
IC2: TLS208D1EJVXUMA1; SOIC-8-1EP_3.9x4.9mm_P1.27mm_EP2.29x3mm_ThermalVias; Mouser Part Number 726-TLS208D1EJVXUMA1
J1: VSUP 12V; 1050752001; Mouser Part Number 530-105-0752-150
J2: PWM; PinHeader_2x08_P2.54mm_Vertical; MFG_PN TSW-103-07-S-D; Mouser Part Number 200-TSW10307SD
J11: Conn_02x23_Odd_Even; PinSocket_2x23_P2.54mm_Horizontal; MFG_PN SSW-123-02-T-D-RA; Mouser Part Number 200-SSW12302TDRA
J13: GND; 1050752001; Mouser Part Number 530-105-0753-150
J14: FlexGUI; PinHeader_2x13_P2.54mm_Vertical; MFG_PN TSW-113-07-S-D; Mouser Part Number 200-TSW11307SD
J19: SSW-102-02-T-T-RA; SAMTEC_SSW-102-02-T-T-RA; PARTREV R; Mouser Part Number 200-SSW10202TTRA
JP1: VCC=VIN; SolderJumper-2_P1.3mm_Open_RoundedPad1.0x1.5mm
JP2: VGDLDO; SolderJumper-2_P1.3mm_Bridged_RoundedPad1.0x1.5mm
JP3: VDDIO; SolderJumper-2_P1.3mm_Bridged_RoundedPad1.0x1.5mm
JP4: AGND; SolderJumper-2_P1.3mm_Bridged_RoundedPad1.0x1.5mm
JP5: PS_EN; SolderJumper-3_P1.3mm_Bridged123_Pad1.0x1.5mm_NumberLabels
JP8: Closed; SolderJumper-2P_Closed_THT+SMD
R1, R2, R3, R4, R5, R6, R7, R8, R9, R10, R11, R12, R17, R18, R19, R20, R23, R24, R25, R26, R27, R28, R29: 1k; R_0603_1608Metric_Pad0.98x0.95mm_HandSolder; MFG_PN CRCW06031K00FKEA; Mouser Part Number 71-CRCW0603-1.0K-E3
R21, R22: 470; R_0603_1608Metric_Pad0.98x0.95mm_HandSolder; MFG_PN CRCW0603470RFKEA; Mouser Part Number 71-CRCW0603-470-E3
R38: 10k; R_0603_1608Metric_Pad0.98x0.95mm_HandSolder; MFG_PN CRCW060310K0FKEA; Mouser Part Number 71-CRCW0603-10K-E3
R39: 3.2k; R_0603_1608Metric_Pad0.98x0.95mm_HandSolder; MFG_PN RN73H1JTTD3201F100; Mouser Part Number 660-RN73H1JT3201F100
R40: 4.7k; R_0603_1608Metric_Pad0.98x0.95mm_HandSolder; MFG_PN RK73H1JTTD4701F; Mouser Part Number 660-RK73H1JTTD4701F
SW1: SW_DIP_x03; SW_DIP_SPSTx03_Slide_6.7x9.18mm_W8.61mm_P2.54mm_LowProfile
TP1: PWMHU; TestPoint_Keystone_5012_white; MFG_PN 5012; Mouser PN 534-5012
TP2: PWMLU; TestPoint_Keystone_5012_white; MFG_PN 5012; Mouser PN 534-5012
TP3: PWMHV; TestPoint_Keystone_5012_white; MFG_PN 5012; Mouser PN 534-5012
TP4: PWMLV; TestPoint_Keystone_5012_white; MFG_PN 5012; Mouser PN 534-5012
TP5: PWMHW; TestPoint_Keystone_5012_white; MFG_PN 5012; Mouser PN 534-5012
TP6: PWMLW; TestPoint_Keystone_5012_white; MFG_PN 5012; Mouser PN 534-5012
TP7, TP9, TP26, TP52: GND; TestPoint_Keystone_5011_Black; MFG_PN 5011; Mouser PN 534-5011
TP8: Vcc; TestPoint_Keystone_5010_Red; MFG_PN 5010; Mouser PN 534-5012
TP10: PWMHM; TestPoint_Keystone_5012_white; MFG_PN 5012; Mouser PN 534-5012
TP11: PWMLM; TestPoint_Keystone_5012_white; MFG_PN 5012; Mouser PN 534-5012
TP12, TP56: GND; TestPoint_Keystone_5011_Black; MFG_PN 5011; Mouser PN 534-5012
TP18: MISO_HS; TestPoint_Keystone_5012_white; MFG_PN 5012; Mouser PN 534-5012
TP19: MOSI_HS; TestPoint_Keystone_5012_white; MFG_PN 5012; Mouser PN 534-5012
TP20: MOSI_LS; TestPoint_Keystone_5012_white; MFG_PN 5012; Mouser PN 534-5012
TP21: INTB_HS; TestPoint_Keystone_5012_white; MFG_PN 5012; Mouser PN 534-5012
TP22: AOUT_UH; TestPoint_Keystone_5012_white; MFG_PN 5012; Mouser PN 534-5012
TP23: AOUT_VH; TestPoint_Keystone_5012_white; MFG_PN 5012; Mouser PN 534-5012
TP24: AOUT_WH; TestPoint_Keystone_5012_white; MFG_PN 5012; Mouser PN 534-5012
TP25: CS_LS; TestPoint_Keystone_5012_white; MFG_PN 5012; Mouser PN 534-5012
TP27: PWMH; TestPoint_Keystone_5012_white; MFG_PN 5012; Mouser PN 534-5012
TP28: AOUT_UL; TestPoint_Keystone_5012_white; MFG_PN 5012; Mouser PN 534-5012
TP29: AOUT_VL; TestPoint_Keystone_5012_white; MFG_PN 5012; Mouser PN 534-5012
TP30: AOUT_WL; TestPoint_Keystone_5012_white; MFG_PN 5012; Mouser PN 534-5012
TP31: SCLK_HS; TestPoint_Keystone_5012_white; MFG_PN 5012; Mouser PN 534-5012
TP32: FSS_LS; TestPoint_Keystone_5012_white; MFG_PN 5012; Mouser PN 534-5012
TP33: FSENB; TestPoint_Keystone_5012_white; MFG_PN 5012; Mouser PN 534-5012
TP34: INTB_LS; TestPoint_Keystone_5012_white; MFG_PN 5012; Mouser PN 534-5012
TP35: INTA_UH; TestPoint_Keystone_5012_white; MFG_PN 5012; Mouser PN 534-5012
TP36: INTA_VH; TestPoint_Keystone_5012_white; MFG_PN 5012; Mouser PN 534-5012
TP37: INTA_WH; TestPoint_Keystone_5012_white; MFG_PN 5012; Mouser PN 534-5012
TP38: INTA_UL; TestPoint_Keystone_5012_white; MFG_PN 5012; Mouser PN 534-5012
TP39: INTA_VL; TestPoint_Keystone_5012_white; MFG_PN 5012; Mouser PN 534-5012
TP40: INTA_WL; TestPoint_Keystone_5012_white; MFG_PN 5012; Mouser PN 534-5012
TP41: FSS_HS; TestPoint_Keystone_5012_white; MFG_PN 5012; Mouser PN 534-5012
TP42: SCLK_LS; TestPoint_Keystone_5012_white; MFG_PN 5012; Mouser PN 534-5012
TP53: Vsup 12V; TestPoint_Keystone_5010_Red; MFG_PN 5010; Mouser PN 534-5012
TP54: PWML; TestPoint_Keystone_5012_white; MFG_PN 5012; Mouser PN 534-5012
TP60: CS_HS; TestPoint_Keystone_5012_white; MFG_PN 5012; Mouser PN 534-5012
TP61: MISO_LS; TestPoint_Keystone_5012_white; MFG_PN 5012; Mouser PN 534-5012
TP62: VBUSDIVX; TestPoint_Keystone_5012_white; MFG_PN 5012; Mouser PN 534-5012
U1, U2, U3, U4, U5, U6, U7, U8: HBFR-2521Z; FR50MHNR
U11, U12, U13, U14: 74LVC2G04; SOT-23-6_Handsoldering

Connections:
/AOUT_GD_UH: J11.35, TP22.1 (1_1)
/AOUT_GD_UL: J11.36, TP28.1 (1_1)
/AOUT_GD_VH: J11.37, TP23.1 (1_1)
/AOUT_GD_VL: J11.38, TP29.1 (1_1)
/AOUT_GD_WH: J11.39, J14.20, TP24.1 (1_1)
/AOUT_GD_WL: J11.40, J14.1, TP30.1 (1_1)
/CS_GD_HSn: J11.19, J14.18, TP60.1 (1_1)
/CS_GD_LSn: J11.22, J14.3, TP25.1 (1_1)
/FSENB_n: J14.13, SW1.2
/FSENB_n_u: J11.26, SW1.5, TP33.1 (1_1)
/FSS_HS: J14.22, SW1.3
/FSS_HS_u: J11.21, SW1.4, TP41.1 (1_1)
/FSS_LS: J14.11, SW1.1
/FSS_LS_u: J11.28, SW1.6, TP32.1 (1_1)
/GSENHW: J11.5, J14.2
/GSENLW: J11.6, J14.4
/INTA_GD_UH: D9.1 (K), J11.7, TP35.1 (1_1)
/INTA_GD_UL: D14.1 (K), J11.8, TP38.1 (1_1)
/INTA_GD_VH: D12.1 (K), J11.9, TP36.1 (1_1)
/INTA_GD_VL: D15.1 (K), J11.10, TP39.1 (1_1)
/INTA_GD_WH: D13.1 (K), J11.11, J14.17, TP37.1 (1_1)
/INTA_GD_WL: D16.1 (K), J11.12, J14.15, TP40.1 (1_1)
/INTB_GD_HSn: D8.1 (K), J11.31, J14.24, TP21.1 (1_1)
/INTB_GD_LSn: D11.1 (K), J11.32, J14.6, TP34.1 (1_1)
/MCU_EN_FLYBK_HS: J11.23, JP5.1 (A)
/MCU_EN_FLYBK_LS: J11.24, JP5.3 (B)
/MISO_GD_HS: J11.15, J14.14, TP18.1 (1_1)
/MISO_GD_LS: J11.18, J14.9, TP61.1 (1_1)
/MOSI_GD_HS: J11.17, J14.16, TP19.1 (1_1)
/MOSI_GD_LS: J11.20, J14.7, TP20.1 (1_1)
/PS_EN_HS_LS: J14.10, JP5.2 (C)
/PWMH: J14.21, TP27.1 (1_1)
/PWMHM: D10.2 (A), J2.3, TP10.1 (1_1), U14.4
/PWMHM_i: R20.1, U7.1 (OUT), U7.4 (RL), U14.3
/PWMHU: D1.2 (A), J2.15, J11.41, TP1.1 (1_1), U11.4
/PWMHU_i: R7.1, U1.1 (OUT), U1.4 (RL), U11.3
/PWMHV: D3.2 (A), J2.11, J11.43, TP3.1 (1_1), U12.4
/PWMHV_i: R9.1, U3.1 (OUT), U3.4 (RL), U12.3
/PWMHW: D5.2 (A), J2.7, J11.45, TP5.1 (1_1), U13.4
/PWMHW_i: R18.1, U5.1 (OUT), U5.4 (RL), U13.3
/PWML: J14.5, TP54.1 (1_1)
/PWMLM: D17.2 (A), J2.1, TP11.1 (1_1), U14.6
/PWMLM_i: R29.1, U8.1 (OUT), U8.4 (RL), U14.1
/PWMLU: D2.2 (A), J2.13, J11.42, TP2.1 (1_1), U11.6
/PWMLU_i: R8.1, U2.1 (OUT), U2.4 (RL), U11.1
/PWMLV: D4.2 (A), J2.9, J11.44, TP4.1 (1_1), U12.6
/PWMLV_i: R17.1, U4.1 (OUT), U4.4 (RL), U12.1
/PWMLW: D6.2 (A), J2.5, J11.46, TP6.1 (1_1), U13.6
/PWMLW_i: R19.1, U6.1 (OUT), U6.4 (RL), U13.1
/SCLK_GD_HS: J11.13, TP31.1 (1_1)
/SCLK_GD_LS: J11.16, J14.8, TP42.1 (1_1)
/VBUSDIVX: J11.27, TP62.1 (1_1)
/VDDIO: J11.34, JP3.1 (A)
/VGD_LDO: J11.30, JP2.1 (A)
/Vin_12V: C1.1, C2.2, IC2.1 (IN), IC2.4 (EN), J1.1, J1.2, J19.1, J19.4, JP1.1 (A), TP53.1 (1_1)
AGND_u: J11.29, JP4.2 (B)
GND: C1.2, C2.1, C3.2, C4.2, C5.2, C6.2, C7.2, C8.2, C9.2, C10.2, C11.2, C12.2, C13.1, C14.2, C15.2, C16.2, H1.1 (1_1), H3.1 (1_1), H5.1 (1_1), IC2.3 (GND), IC2.9 (EP), J2.2, J2.4, J2.6, J2.8, J2.10, J2.12, J2.14, J2.16, J11.14, J11.33, J13.1, J13.2, J14.12, J14.23, J19.3, J19.6, JP4.1 (A), R1.1, R2.1, R3.1, R4.1, R5.1, R6.1, R10.2, R11.1, R12.1, R39.2, R40.2, TP7.1 (1_1), TP9.1 (1_1), TP12.1 (1_1), TP26.1 (1_1), TP52.1 (1_1), TP56.1 (1_1), U1.2 (GND), U1.5 (GND), U1.8 (GND), U2.2 (GND), U2.5 (GND), U2.8 (GND), U3.2 (GND), U3.5 (GND), U3.8 (GND), U4.2 (GND), U4.5 (GND), U4.8 (GND), U5.2 (GND), U5.5 (GND), U5.8 (GND), U6.2 (GND), U6.5 (GND), U6.8 (GND), U7.2 (GND), U7.5 (GND), U7.8 (GND), U8.2 (GND), U8.5 (GND), U8.8 (GND), U11.2 (GND), U12.2 (GND), U13.2 (GND), U14.2 (GND)
unnamed: D1.1 (K), R1.2
unnamed: D2.1 (K), R2.2
unnamed: D3.1 (K), R3.2
unnamed: D4.1 (K), R4.2
unnamed: D5.1 (K), R5.2
unnamed: D6.1 (K), R6.2
unnamed: D7.1 (K), R10.1
unnamed: D8.2 (A), R21.1
unnamed: D9.2 (A), R23.1
unnamed: D10.1 (K), R11.2
unnamed: D11.2 (A), R22.1
unnamed: D12.2 (A), R24.1
unnamed: D13.2 (A), R25.1
unnamed: D14.2 (A), R26.1
unnamed: D15.2 (A), R27.1
unnamed: D16.2 (A), R28.1
unnamed: D17.1 (K), R12.2
unnamed: IC2.7 (ADJ/FB), JP8.2 (B), R38.1, R39.1
unnamed: JP8.1 (A), R40.1
VCC: C3.1, C4.1, C5.1, C6.1, C7.1, C8.1, C9.1, C10.1, C11.1, C12.1, C13.2, C14.1, C15.1, C16.1, D7.2 (A), IC2.6 (RADJ), IC2.8 (Q), J11.25, JP1.2 (B), JP2.2 (B), JP3.2 (B), R7.2, R8.2, R9.2, R17.2, R18.2, R19.2, R20.2, R21.2, R22.2, R23.2, R24.2, R25.2, R26.2, R27.2, R28.2, R29.2, R38.2, TP8.1 (1_1), U1.3 (Vcc), U2.3 (Vcc), U3.3 (Vcc), U4.3 (Vcc), U5.3 (Vcc), U6.3 (Vcc), U7.3 (Vcc), U8.3 (Vcc), U11.5 (VCC), U12.5 (VCC), U13.5 (VCC), U14.5 (VCC)

Notes on the sheet:
RTRPTR_WH
LDO_EN
RTRPTR_WL
VDDA_u
GSENLU GSENLV
Closed 5V Opened 3V3
GSENHU GSENHV

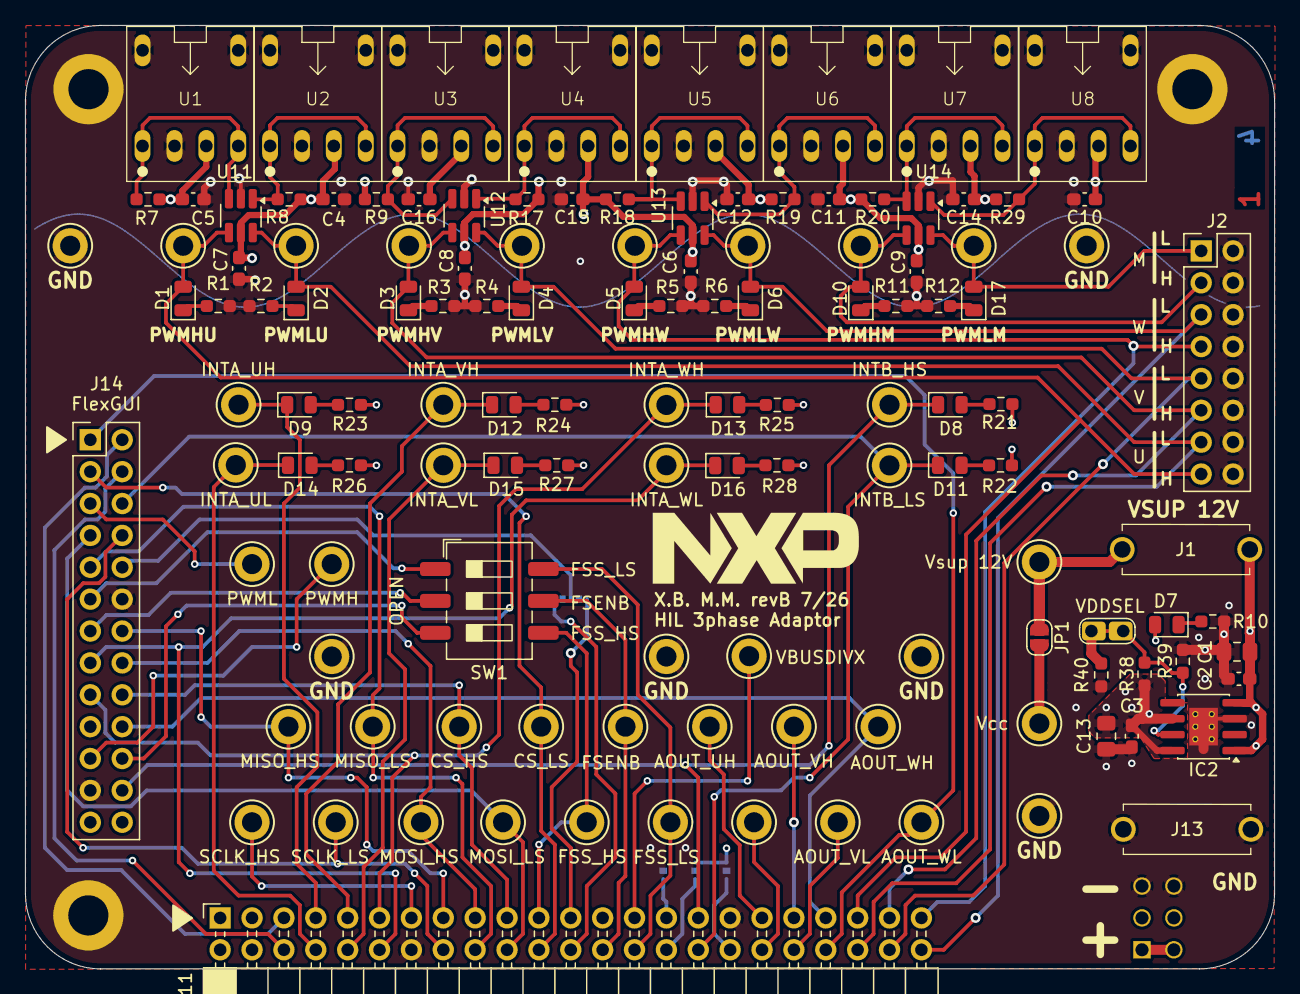
[picture p231: board RCP_PWM_breakout.kicad_pcb from above]

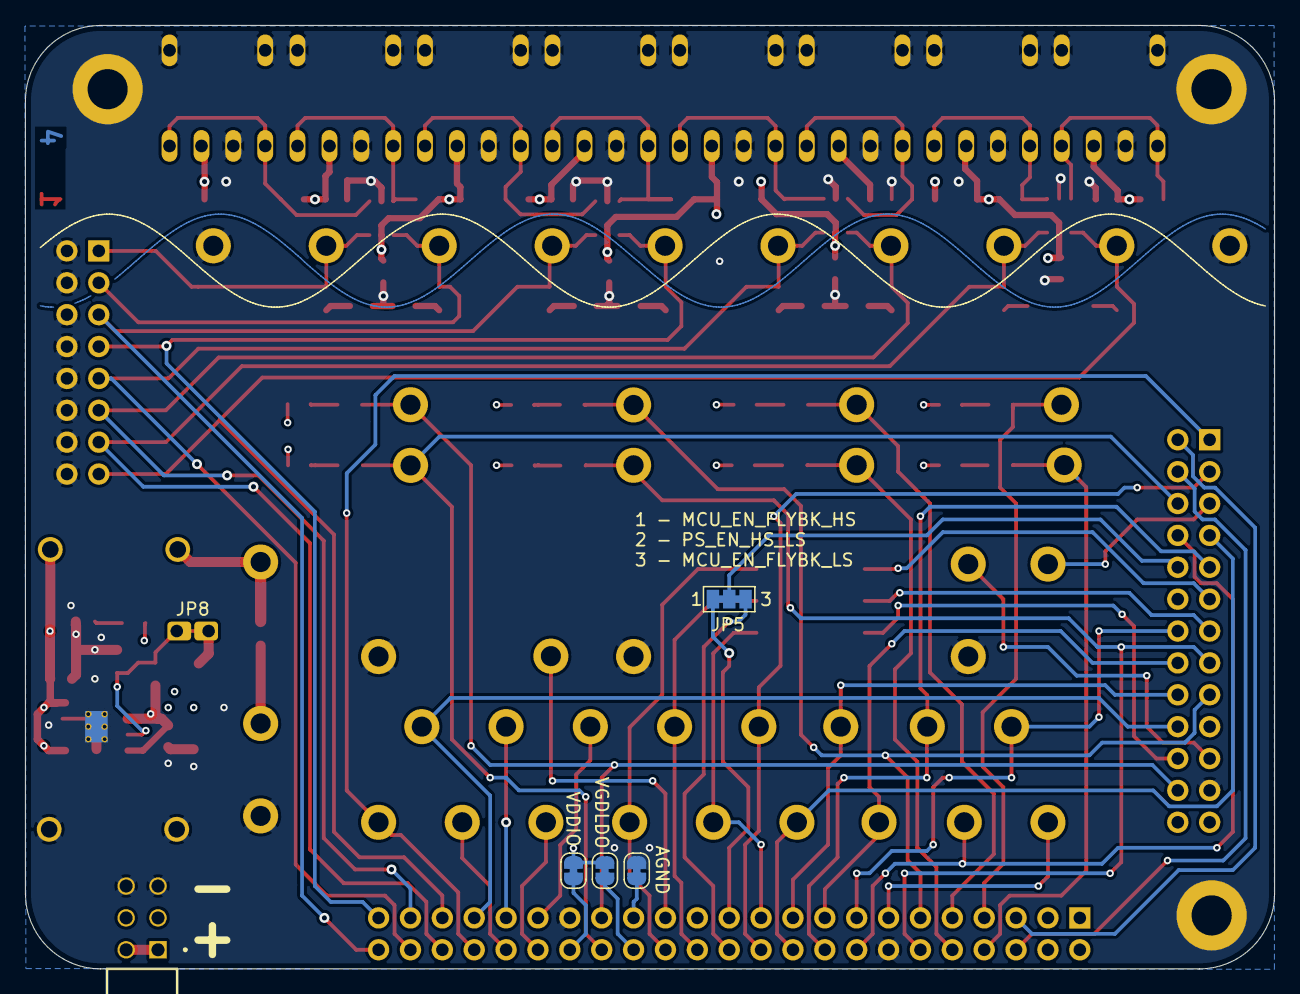
[picture p232: board RCP_PWM_breakout.kicad_pcb from below]

Board: 4 copper layers, 99.5 x 75.2 mm, 134 parts (5 on the bottom side), 77 nets.
