reivax-boucoi/PCB_Kicad/Sunlord_breakout/Sunlord_breakout.kicad_pcb

## KiCad design Sunlord_breakout/Sunlord_breakout.kicad_pcb (2026-08-31)

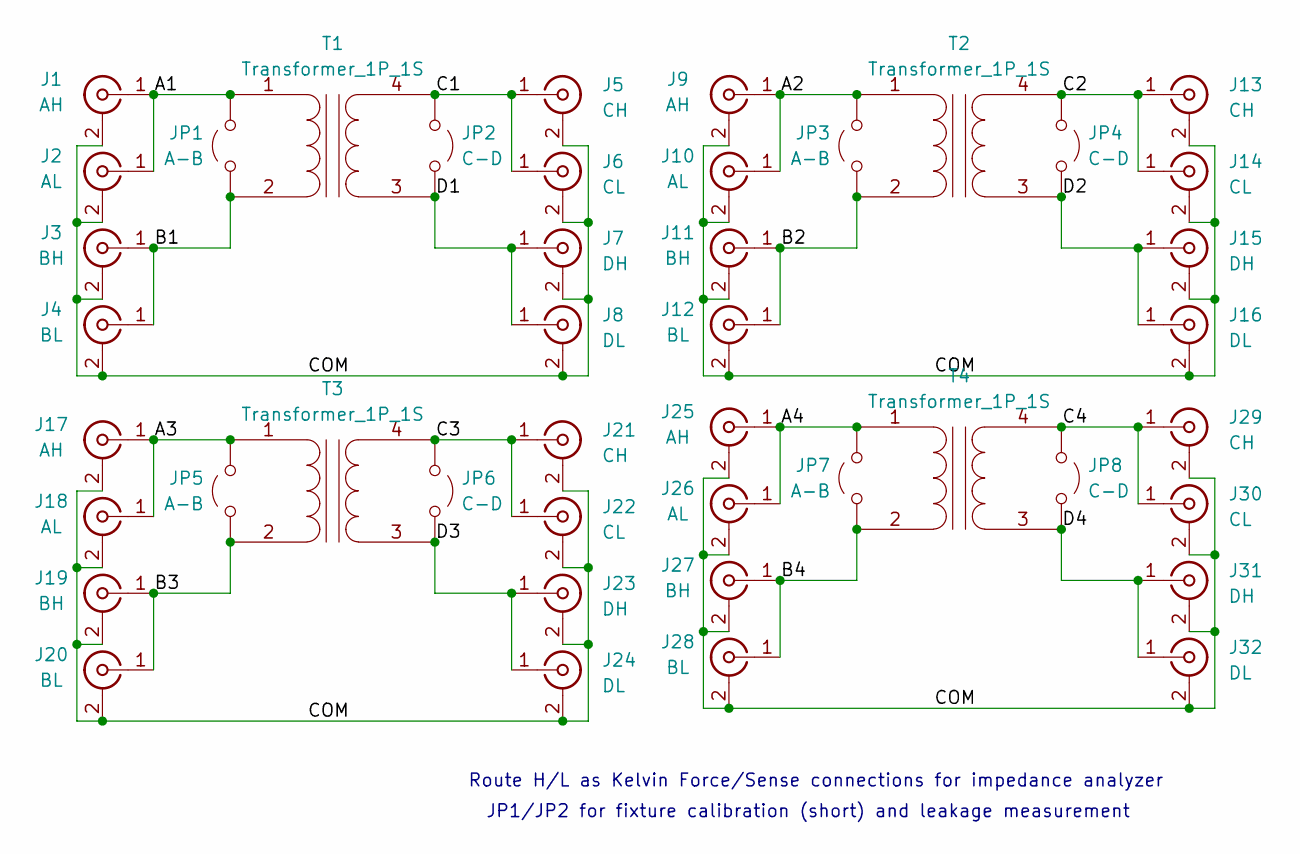
[picture p233: schematic Sunlord_breakout.kicad_sch, Sunload AW2222 revA Breakout]

Parts:
J1, J9, J17, J25: AH; SMA_Samtec_SMA-J-P-H-ST-EM1_EdgeMount
J2, J10, J18, J26: AL; SMA_Samtec_SMA-J-P-H-ST-EM1_EdgeMount
J3, J11, J19, J27: BH; SMA_Samtec_SMA-J-P-H-ST-EM1_EdgeMount
J4, J12, J20, J28: BL; SMA_Samtec_SMA-J-P-H-ST-EM1_EdgeMount
J5, J13, J21, J29: CH; SMA_Samtec_SMA-J-P-H-ST-EM1_EdgeMount
J6, J14, J22, J30: CL; SMA_Samtec_SMA-J-P-H-ST-EM1_EdgeMount
J7, J15, J23, J31: DH; SMA_Samtec_SMA-J-P-H-ST-EM1_EdgeMount
J8, J16, J24, J32: DL; SMA_Samtec_SMA-J-P-H-ST-EM1_EdgeMount
JP1, JP3, JP5, JP7: A-B; SolderJumper-2_P1.3mm_Open_RoundedPad1.0x1.5mm
JP2, JP4, JP6, JP8: C-D; SolderJumper-2_P1.3mm_Open_RoundedPad1.0x1.5mm
T1, T2, T3, T4: Transformer_1P_1S; AW2222_Sunlord_µXFMR

Connections:
/A1: J1.1 (In), J2.1 (In), JP1.2 (B), T1.1 (AA)
/A2: J9.1 (In), J10.1 (In), JP3.2 (B), T2.1 (AA)
/A3: J17.1 (In), J18.1 (In), JP5.2 (B), T3.1 (AA)
/A4: J25.1 (In), J26.1 (In), JP7.2 (B), T4.1 (AA)
/B1: J3.1 (In), J4.1 (In), JP1.1 (A), T1.2 (AB)
/B2: J11.1 (In), J12.1 (In), JP3.1 (A), T2.2 (AB)
/B3: J19.1 (In), J20.1 (In), JP5.1 (A), T3.2 (AB)
/B4: J27.1 (In), J28.1 (In), JP7.1 (A), T4.2 (AB)
/C1: J5.1 (In), J6.1 (In), JP2.1 (A), T1.4 (SB)
/C2: J13.1 (In), J14.1 (In), JP4.1 (A), T2.4 (SB)
/C3: J21.1 (In), J22.1 (In), JP6.1 (A), T3.4 (SB)
/C4: J29.1 (In), J30.1 (In), JP8.1 (A), T4.4 (SB)
/COM: J1.2 (Ext), J2.2 (Ext), J3.2 (Ext), J4.2 (Ext), J5.2 (Ext), J6.2 (Ext), J7.2 (Ext), J8.2 (Ext), J9.2 (Ext), J10.2 (Ext), J11.2 (Ext), J12.2 (Ext), J13.2 (Ext), J14.2 (Ext), J15.2 (Ext), J16.2 (Ext), J17.2 (Ext), J18.2 (Ext), J19.2 (Ext), J20.2 (Ext), J21.2 (Ext), J22.2 (Ext), J23.2 (Ext), J24.2 (Ext), J25.2 (Ext), J26.2 (Ext), J27.2 (Ext), J28.2 (Ext), J29.2 (Ext), J30.2 (Ext), J31.2 (Ext), J32.2 (Ext)
/D1: J7.1 (In), J8.1 (In), JP2.2 (B), T1.3 (SA)
/D2: J15.1 (In), J16.1 (In), JP4.2 (B), T2.3 (SA)
/D3: J23.1 (In), J24.1 (In), JP6.2 (B), T3.3 (SA)
/D4: J31.1 (In), J32.1 (In), JP8.2 (B), T4.3 (SA)

Notes on the sheet:
JP1/JP2 for fixture calibration (short) and leakage measurement
Route H/L as Kelvin Force/Sense connections for impedance analyzer

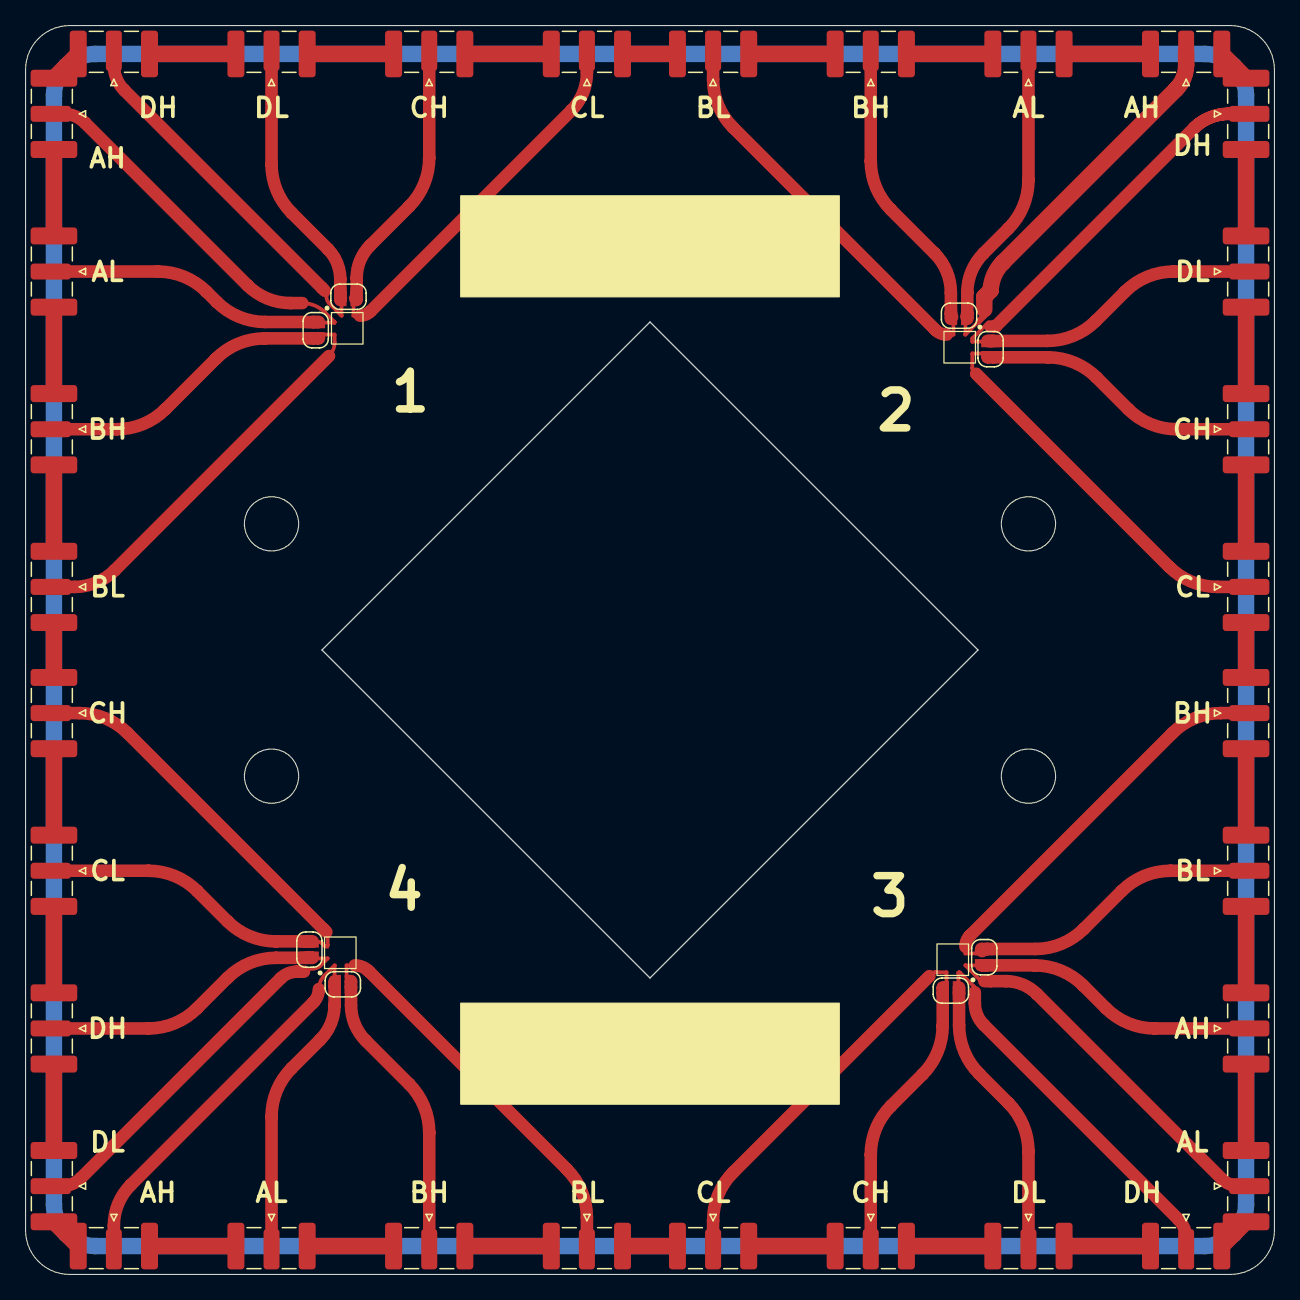
[picture p234: board Sunlord_breakout.kicad_pcb from above]

Board: 2 copper layers, 99.0 x 99.0 mm, 44 parts (0 on the bottom side), 17 nets.
