reivax-boucoi/PCB_Kicad/split-flap_display/split-flap_display.kicad_pcb

## KiCad design split-flap_display/split-flap_display.kicad_pcb (2026-08-28)

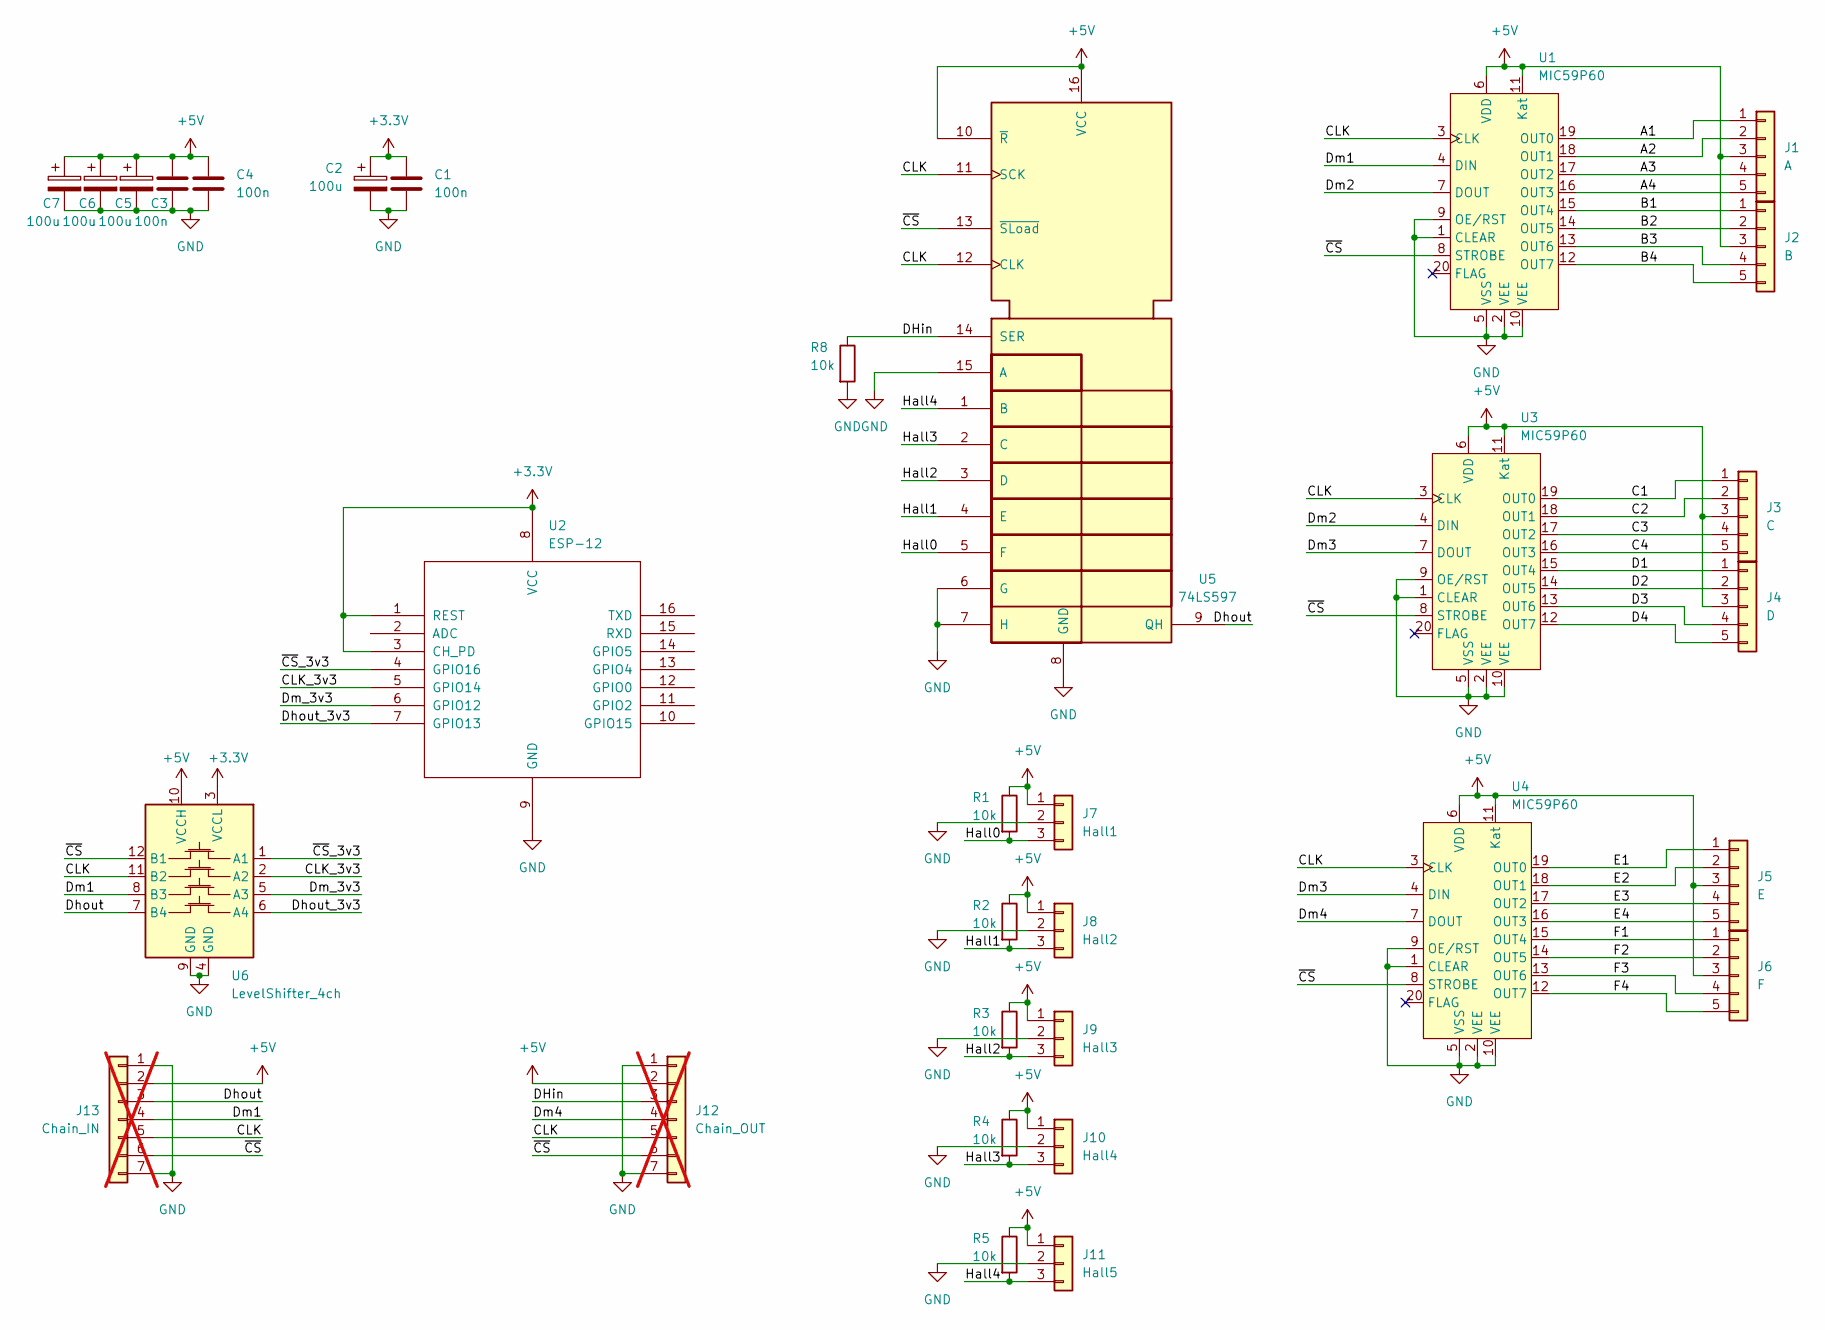
[picture p235: schematic split-flap_display.kicad_sch]

Parts:
C1, C3, C4: 100n; C_Disc_D6.0mm_W2.5mm_P5.00mm
C2, C5, C6, C7: 100u; CP_Radial_D8.0mm_P5.00mm
J1: A; PinHeader_1x05_P2.54mm_Vertical
J2: B; PinHeader_1x05_P2.54mm_Vertical
J3: C; PinHeader_1x05_P2.54mm_Vertical
J4: D; PinHeader_1x05_P2.54mm_Vertical
J5: E; PinHeader_1x05_P2.54mm_Vertical
J6: F; PinHeader_1x05_P2.54mm_Vertical
J7: Hall1; PinHeader_1x03_P2.54mm_Vertical
J8: Hall2; PinHeader_1x03_P2.54mm_Vertical
J9: Hall3; PinHeader_1x03_P2.54mm_Vertical
J10: Hall4; PinHeader_1x03_P2.54mm_Vertical
J11: Hall5; PinHeader_1x03_P2.54mm_Vertical
J12: Chain_OUT; PinHeader_1x07_P2.54mm_Vertical; not fitted
J13: Chain_IN; PinHeader_1x07_P2.54mm_Vertical; not fitted
R1, R2, R3, R4, R5: 10k; R_Axial_DIN0207_L6.3mm_D2.5mm_P5.08mm_Vertical
R8: 10k; R_Axial_DIN0207_L6.3mm_D2.5mm_P2.54mm_Vertical
U1, U3, U4: MIC59P60; DIP-20_W7.62mm_LongPads
U2: ESP-12
U5: 74LS597; DIP-16_W7.62mm_LongPads
U6: LevelShifter_4ch; DIP-12_LevelShifter

Connections:
+3.3V: C1.1, C2.1, U2.1 (REST), U2.3 (CH_PD), U2.8 (VCC), U6.3 (VCCL)
+5V: C3.1, C4.1, C5.1, C6.1, C7.1, J1.3, J2.3, J3.3, J4.3, J5.3, J6.3, J7.1, J8.1, J9.1, J10.1, J11.1, J12.2, J13.2, R1.1, R2.1, R3.1, R4.1, R5.1, U1.6 (VDD), U1.11 (Kat), U3.6 (VDD), U3.11 (Kat), U4.6 (VDD), U4.11 (Kat), U5.10 (~R), U5.16 (VCC), U6.10 (VCCH)
/A1: J1.1, U1.19 (OUT0)
/A2: J1.2, U1.18 (OUT1)
/A3: J1.4, U1.17 (OUT2)
/A4: J1.5, U1.16 (OUT3)
/B1: J2.1, U1.15 (OUT4)
/B2: J2.2, U1.14 (OUT5)
/B3: J2.4, U1.13 (OUT6)
/B4: J2.5, U1.12 (OUT7)
/C1: J3.1, U3.19 (OUT0)
/C2: J3.2, U3.18 (OUT1)
/C3: J3.4, U3.17 (OUT2)
/C4: J3.5, U3.16 (OUT3)
/CLK: J12.5, J13.5, U1.3 (CLK), U3.3 (CLK), U4.3 (CLK), U5.11 (SCK), U5.12 (CLK), U6.11 (B2)
/CLK_3v3: U2.5 (GPIO14), U6.2 (A2)
/D1: J4.1, U3.15 (OUT4)
/D2: J4.2, U3.14 (OUT5)
/D3: J4.4, U3.13 (OUT6)
/D4: J4.5, U3.12 (OUT7)
/DHin: J12.3, R8.1, U5.14 (SER)
/Dhout: J13.3, U5.9 (QH), U6.7 (B4)
/Dhout_3v3: U2.7 (GPIO13), U6.6 (A4)
/Dm1: J13.4, U1.4 (DIN), U6.8 (B3)
/Dm2: U1.7 (DOUT), U3.4 (DIN)
/Dm3: U3.7 (DOUT), U4.4 (DIN)
/Dm4: J12.4, U4.7 (DOUT)
/Dm_3v3: U2.6 (GPIO12), U6.5 (A3)
/E1: J5.1, U4.19 (OUT0)
/E2: J5.2, U4.18 (OUT1)
/E3: J5.4, U4.17 (OUT2)
/E4: J5.5, U4.16 (OUT3)
/F1: J6.1, U4.15 (OUT4)
/F2: J6.2, U4.14 (OUT5)
/F3: J6.4, U4.13 (OUT6)
/F4: J6.5, U4.12 (OUT7)
/Hall0: J7.3, R1.2, U5.5 (F)
/Hall1: J8.3, R2.2, U5.4 (E)
/Hall2: J9.3, R3.2, U5.3 (D)
/Hall3: J10.3, R4.2, U5.2 (C)
/Hall4: J11.3, R5.2, U5.1 (B)
/~CS: J12.6, J13.6, U1.8 (STROBE), U3.8 (STROBE), U4.8 (STROBE), U5.13 (~SLoad), U6.12 (B1)
/~CS_3v3: U2.4 (GPIO16), U6.1 (A1)
GND: C1.2, C2.2, C3.2, C4.2, C5.2, C6.2, C7.2, J7.2, J8.2, J9.2, J10.2, J11.2, J12.1, J12.7, J13.1, J13.7, R8.2, U1.1 (CLEAR), U1.2 (VEE), U1.5 (VSS), U1.9 (OE/RST), U1.10 (VEE), U2.9 (GND), U3.1 (CLEAR), U3.2 (VEE), U3.5 (VSS), U3.9 (OE/RST), U3.10 (VEE), U4.1 (CLEAR), U4.2 (VEE), U4.5 (VSS), U4.9 (OE/RST), U4.10 (VEE), U5.6 (G), U5.7 (H), U5.8 (GND), U5.15 (A), U6.4 (GND), U6.9 (GND)

Board: 2 copper layers, 30 parts (5 on the bottom side), 43 nets, no tracks yet.
