reivax-boucoi/PCB_Kicad/bike_lights2/bike_lights2.kicad_pcb

## KiCad design bike_lights2/bike_lights2.kicad_pcb (2026-08-25)

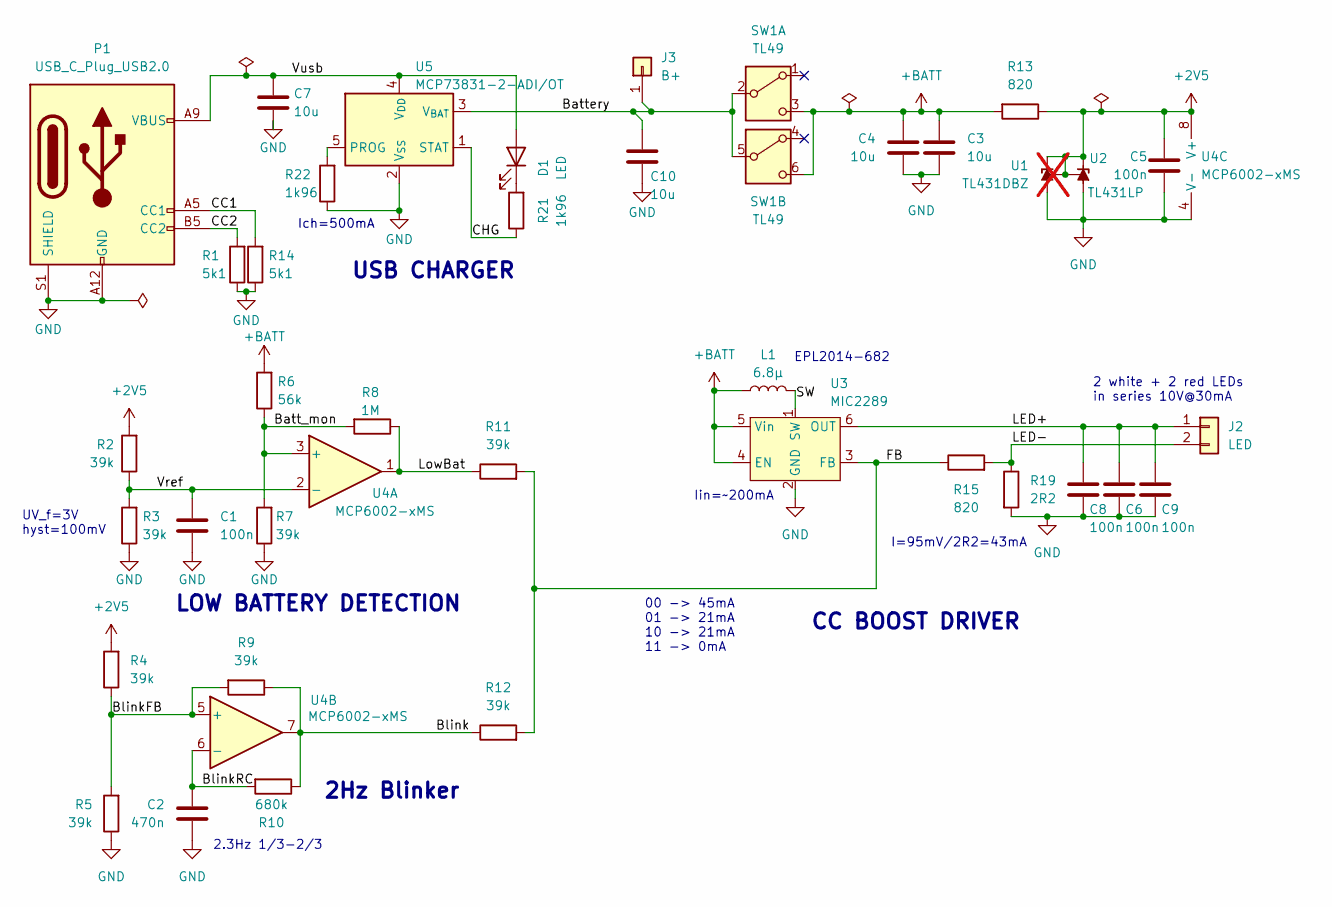
[picture p236: schematic bike_lights2.kicad_sch, Bike_flasher]

Parts:
C1, C5, C6, C8, C9: 100n; C_0402_1005Metric
C2: 470n; C_0603_1608Metric
C3, C4, C7, C10: 10u; C_0603_1608Metric
D1: LED; LED_0603_1608Metric
J2: LED; JST_PH_1x02_P2.0-2.5mm_Vertical
J3: B+; SolderWire-0.5sqmm_1x01_D0.9mm_OD2.1mm
L1: 6.8µ; EPL2014_2x2mm_inductor_Coilcraft
P1: USB_C_Plug_USB2.0; USB_C_Receptacle_GCT_USB4125-xx-x_6P_TopMnt_Horizontal
R1, R14: 5k1; R_0603_1608Metric
R2, R3, R4, R5, R7, R9, R11, R12: 39k; R_0603_1608Metric
R6: 56k; R_0603_1608Metric
R8: 1M; R_0603_1608Metric
R10: 680k; R_0603_1608Metric
R13, R15: 820; R_0603_1608Metric
R19: 2R2; R_0603_1608Metric
R21, R22: 1k96; R_0603_1608Metric
SW1: TL49; TL49PO
U1: TL431DBZ; SOT-23; not fitted
U2: TL431LP; TO-92_Inline
U3: MIC2289; SOT-23-6
U4: MCP6002-xMS; MSOP-8_3x3mm_P0.65mm
U5: MCP73831-2-ADI/OT; SOT-23-5

Connections:
+2V5: C5.1, R2.2, R4.2, R13.1, U1.1 (K), U1.2 (REF), U2.1 (REF), U2.3 (K), U4.8 (V+)
+BATT: C3.1, C4.1, L1.1, R6.2, R13.2, SW1.3 (C), SW1.6 (C), U3.4 (EN), U3.5 (Vin)
/Batt_mon: R6.1, R7.2, R8.2, U4.3 (+)
/Battery: C10.1, J3.1 (Pin_1_1), SW1.2 (B), SW1.5 (B), U5.3 (V_{BAT})
/Blink: R9.1, R10.1, R12.1, U4.7
/BlinkFB: R4.1, R5.2, R9.2, U4.5 (+)
/BlinkRC: C2.1, R10.2, U4.6 (-)
/CC1: P1.A5 (CC1), R14.2
/CC2: P1.B5 (CC2), R1.2
/CHG: R21.1, U5.1 (STAT)
/FB: R11.2, R12.2, R15.1, U3.3 (FB)
/LED+: C6.1, C8.1, C9.1, J2.1, U3.6 (OUT)
/LED-: J2.2, R15.2, R19.1
/LowBat: R8.1, R11.1, U4.1
/SW: L1.2, U3.1 (SW)
/Vref: C1.1, R2.1, R3.2, U4.2 (-)
/Vusb: C7.1, D1.2 (A), P1.A9 (VBUS), P1.B9 (VBUS), U5.4 (V_{DD})
GND: C1.2, C2.2, C3.2, C4.2, C5.2, C6.2, C7.2, C8.2, C9.2, C10.2, P1.A12 (GND), P1.B12 (GND), P1.S1 (SHIELD), R1.1, R3.1, R5.1, R7.1, R14.1, R19.2, R22.1, U1.3 (A), U2.2 (A), U3.2 (GND), U4.4 (V-), U5.2 (V_{SS})
unnamed: D1.1 (K), R21.2
unnamed: R22.2, U5.5 (PROG)

Notes on the sheet:
2.3Hz 1/3-2/3
2Hz Blinker
CC BOOST DRIVER
UV_f=3V hyst=100mV
00 -> 45mA 01 -> 21mA 10 -> 21mA 11 -> 0mA
Ich=500mA
2 white + 2 red LEDs in series 10V@30mA
EPL2014-682
LOW BATTERY DETECTION
I=95mV/2R2=43mA
Iin=~200mA
USB CHARGER

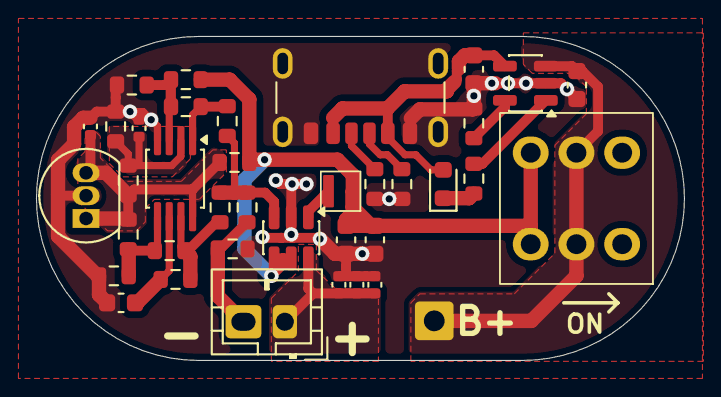
[picture p237: board bike_lights2.kicad_pcb from above]

Board: 2 copper layers, 36.0 x 18.0 mm, 38 parts (0 on the bottom side), 20 nets.
