reivax-boucoi/PCB_Kicad/bike_lights/bike_lights.kicad_pcb

## KiCad design bike_lights/bike_lights.kicad_pcb (2026-08-24)

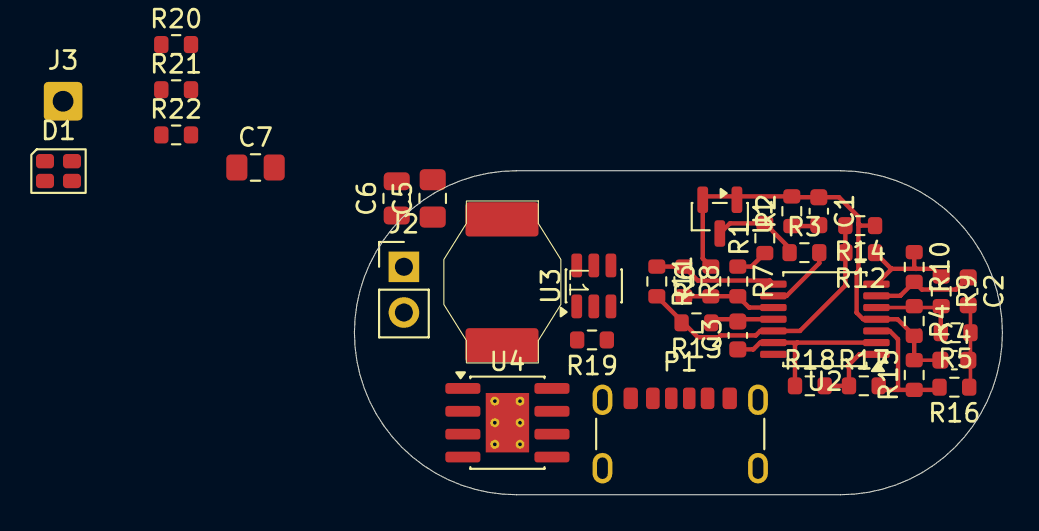
[picture p238: board bike_lights.kicad_pcb from above]

Board: 2 copper layers, 36.0 x 18.0 mm, 39 parts (1 on the bottom side), 23 nets.

Parts:
C1, C3, C4: 100n; C_0603_1608Metric
C2: 470n; C_0603_1608Metric
C5, C7: 10u; C_0805_2012Metric_Pad1.18x1.45mm_HandSolder
C6: 270n; C_0805_2012Metric
D1: LED_Dual_AAKK; LED_Cree-PLCC4_2x2mm_CW
H1: MountingHole_Pad; SolderWirePad_1x01_SMD_5x10mm
J2: LED; PinHeader_1x02_P2.54mm_Vertical
J3: B+; SolderWire-0.5sqmm_1x01_D0.9mm_OD2.1mm
L1: 10µ; DO1813H
P1: USB_C_Plug_USB2.0; USB_C_Receptacle_GCT_USB4125-xx-x_6P_TopMnt_Horizontal
R1, R20, R21, R22: 1k96; R_0603_1608Metric
R2: 51k; R_0603_1608Metric
R3, R13, R18: 33k; R_0603_1608Metric
R4, R5, R6, R7, R9, R14, R15, R16, R17: 39k; R_0603_1608Metric
R8: 1M; R_0603_1608Metric
R10: 680k; R_0603_1608Metric
R11: 100k; R_0603_1608Metric
R12: 56k; R_0603_1608Metric
R19: 2R2; R_0603_1608Metric
U1: TL431DBZ; SOT-23
U2: MCP6004; TSSOP-14_4.4x5mm_P0.65mm
U3: MIC2289; SOT-23-6
U4: TP4056-42-ESOP8; SOIC-8-1EP_3.9x4.9mm_P1.27mm_EP2.41x3.3mm_ThermalVias

Connections:
+BATT: C1.1, C4.1, C5.1, J3.1, L1.1, R2.2, R4.2, R6.2, R14.1, R15.2, U1.1 (K), U1.2 (REF), U2.4 (V+), U3.5 (Vin), U4.5 (BAT)
/Batt_mon: R6.1, R7.2, R8.2, U2.10 (+)
/Blink: R9.1, R10.1, R12.1, U2.7
/BlinkFB: R4.1, R5.2, R9.2, U2.5 (+)
/BlinkRC: C2.1, R10.2, U2.6 (-)
/EN: U2.14, U3.4 (EN)
/LED+: C6.1, J2.1, U3.6 (OUT)
/LED-: J2.2, R19.1, U3.3 (FB)
/LowBat: R8.1, R11.1, U2.8
/Ramp: C3.1, R18.1, U2.2 (-), U2.13 (-)
/RampFB: R15.1, R16.2, R17.2, U2.3 (+)
/RampOut: R17.1, R18.2, U2.1
/SW: L1.2, U3.1 (SW)
/Sum: R11.2, R12.2, R13.2, R14.2, U2.12 (+)
/Vref: C1.2, R2.1, R3.2, U2.9 (-)
/~CHRG: D1.4 (K2), R20.1
/~STDBY: D1.3 (K1), R21.1
GND: C2.2, C3.2, C4.2, C5.2, C6.2, C7.2, H1.1, P1.A12 (GND), P1.B12 (GND), P1.S1 (SHIELD), R1.1, R5.1, R7.1, R13.1, R16.1, R19.2, R22.1, U2.11 (V-), U3.2 (GND), U4.3 (GND), U4.9 (EPAD)
unnamed: C7.1, D1.1 (A1), D1.2 (A2), P1.A9 (VBUS), P1.B9 (VBUS), U4.4 (V_{CC}), U4.8 (CE)
unnamed: R1.2, R3.1, U1.3 (A)
unnamed: R22.2, U4.2 (PROG)
unnamed: R20.2, U4.7 (~CHRG)
unnamed: R21.2, U4.6 (~STDBY)
