reivax-boucoi/PCB_Kicad/split-flap-display2/split-flap-display2.kicad_pcb

## KiCad design split-flap-display2/split-flap-display2.kicad_pcb (2026-08-24)

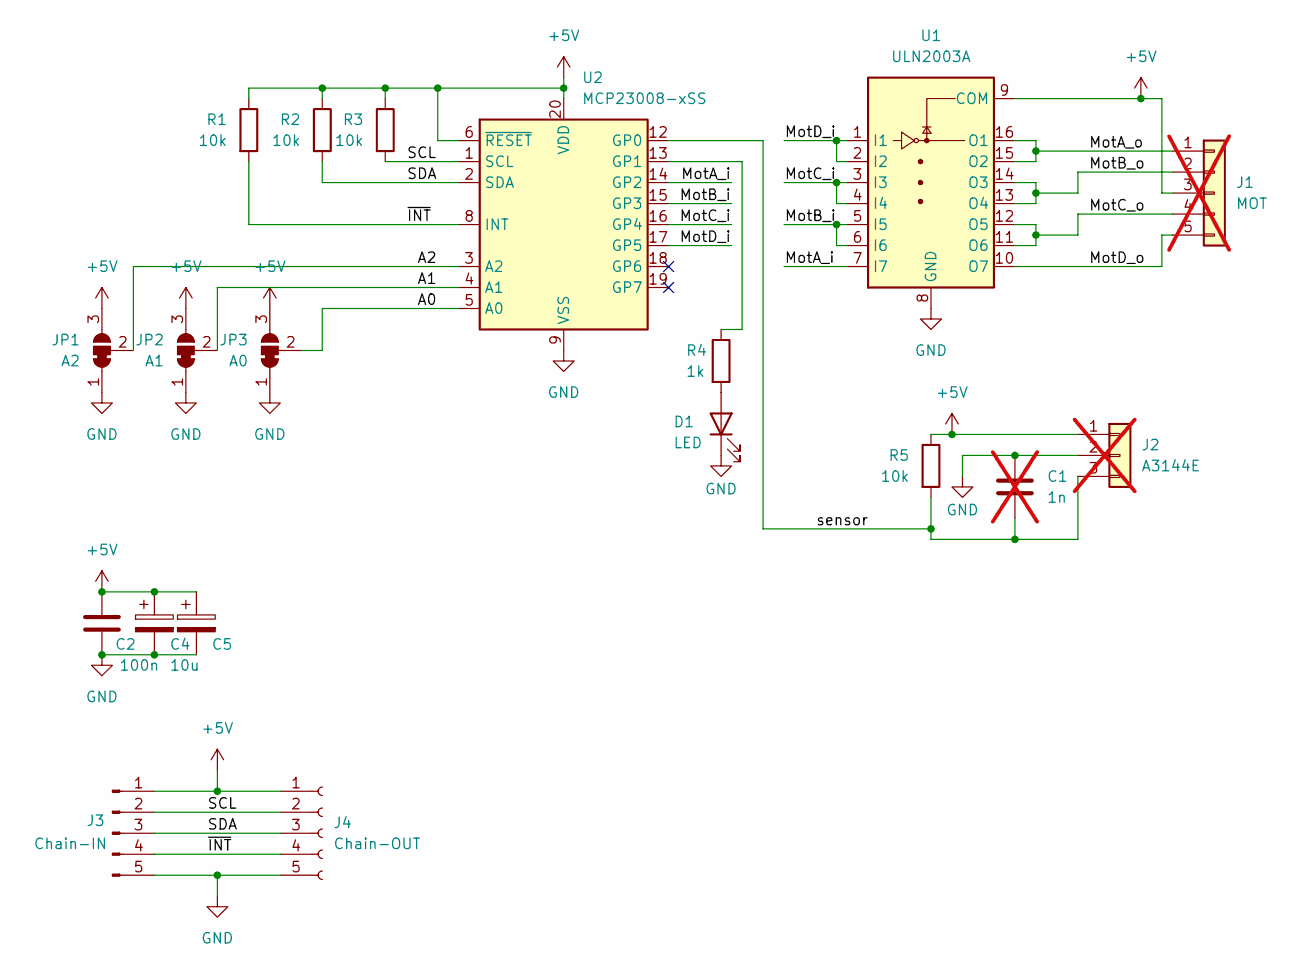
[picture p239: schematic split-flap-display2.kicad_sch, Split flap chain driver]

Parts:
C1: 1n; C_0402_1005Metric_Pad0.74x0.62mm_HandSolder; not fitted
C2: 100n; C_0603_1608Metric_Pad1.08x0.95mm_HandSolder
C4, C5: 10u; C_0805_2012Metric_Pad1.18x1.45mm_HandSolder
D1: LED; LED_0603_1608Metric_Pad1.05x0.95mm_HandSolder
J1: MOT; PinHeader_1x05_P2.54mm_Vertical; not fitted
J2: A3144E; PinHeader_1x03_P2.54mm_Vertical; not fitted
J3: Chain-IN; PinHeader_1x05_P2.54mm_Horizontal
J4: Chain-OUT; PinSocket_1x05_P2.54mm_Horizontal
JP1: A2; SolderJumper-3_P1.3mm_Bridged12_RoundedPad1.0x1.5mm
JP2: A1; SolderJumper-3_P1.3mm_Bridged12_RoundedPad1.0x1.5mm
JP3: A0; SolderJumper-3_P1.3mm_Bridged12_RoundedPad1.0x1.5mm
R1, R2, R3, R5: 10k; R_0603_1608Metric_Pad0.98x0.95mm_HandSolder
R4: 1k; R_0603_1608Metric_Pad0.98x0.95mm_HandSolder
U1: ULN2003A; SOIC-16_3.9x9.9mm_P1.27mm
U2: MCP23008-xSS; SSOP-20_5.3x7.2mm_P0.65mm

Connections:
+5V: C2.1, C4.1, C5.1, J1.3, J2.1, J3.1, J4.1, JP1.3 (B), JP2.3 (B), JP3.3 (B), R1.1, R2.1, R3.1, R5.1, U1.9 (COM), U2.6 (~RESET), U2.20 (VDD)
/A0: JP3.2 (C), U2.5 (A0)
/A1: JP2.2 (C), U2.4 (A1)
/A2: JP1.2 (C), U2.3 (A2)
/MotA_i: U1.7 (I7), U2.14 (GP2)
/MotA_o: J1.1, U1.15 (O2), U1.16 (O1)
/MotB_i: U1.5 (I5), U1.6 (I6), U2.15 (GP3)
/MotB_o: J1.2, U1.13 (O4), U1.14 (O3)
/MotC_i: U1.3 (I3), U1.4 (I4), U2.16 (GP4)
/MotC_o: J1.4, U1.11 (O6), U1.12 (O5)
/MotD_i: U1.1 (I1), U1.2 (I2), U2.17 (GP5)
/MotD_o: J1.5, U1.10 (O7)
/SCL: J3.2, J4.2, R3.2, U2.1 (SCL)
/SDA: J3.3, J4.3, R2.2, U2.2 (SDA)
/sensor: C1.2, J2.3, R5.2, U2.12 (GP0)
/~INT: J3.4, J4.4, R1.2, U2.8 (INT)
GND: C1.1, C2.2, C4.2, C5.2, D1.1 (K), J2.2, J3.5, J4.5, JP1.1 (A), JP2.1 (A), JP3.1 (A), U1.8 (GND), U2.9 (VSS)
unnamed: D1.2 (A), R4.2
unnamed: R4.1, U2.13 (GP1)

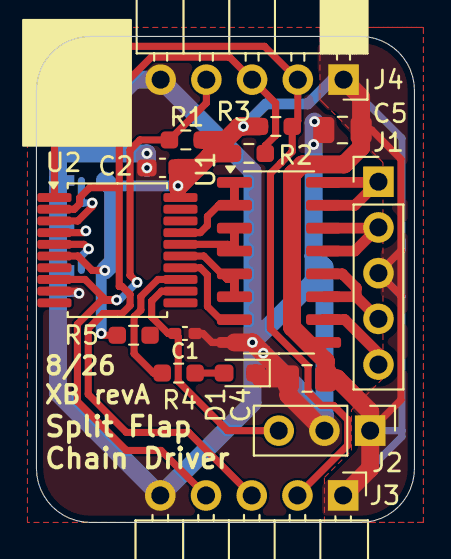
[picture p240: board split-flap-display2.kicad_pcb from above]

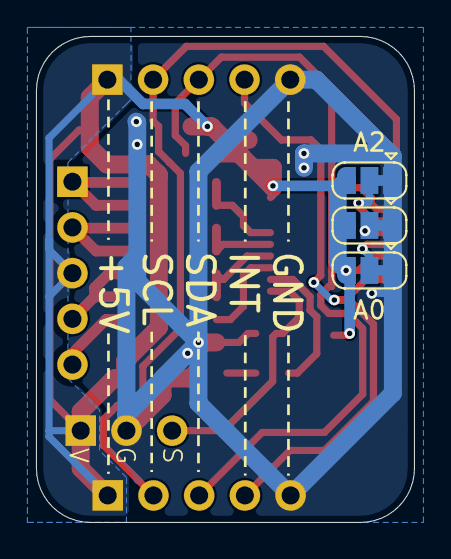
[picture p241: board split-flap-display2.kicad_pcb from below]

Board: 2 copper layers, 21.0 x 27.0 mm, 19 parts (3 on the bottom side), 19 nets.
