reivax-boucoi/PCB_Kicad/Hi-pot_tester/Hi-pot_tester.kicad_pcb

## KiCad design Hi-pot_tester/Hi-pot_tester.kicad_pcb (2026-08-24)

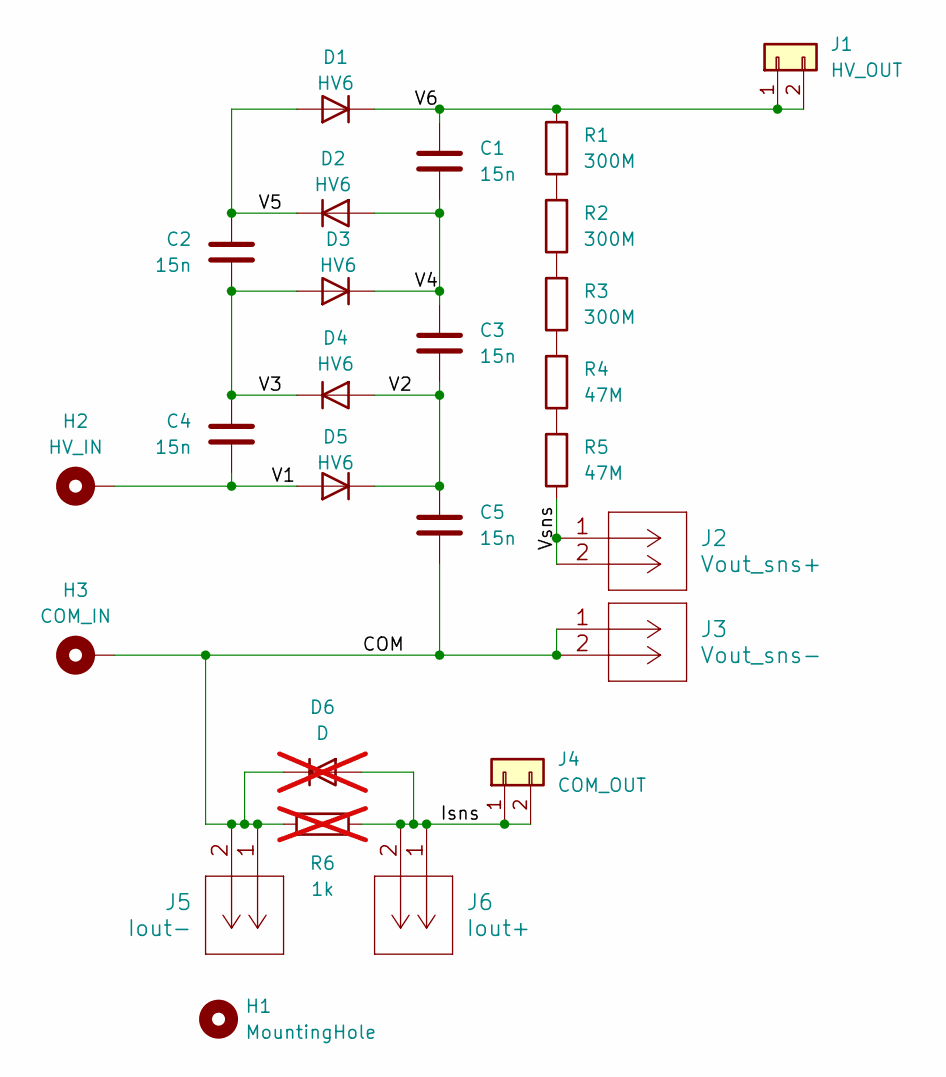
[picture p242: schematic Hi-pot_tester.kicad_sch, Hi-pot tester]

Parts:
C1, C2, C3, C4, C5: 15n; C_Rect_L41.5mm_W13.0mm_P37.50mm_MKS4
D1, D2, D3, D4, D5: HV6; D_DO-15_P15.24mm_Horizontal
D6: D; D_A-405_P7.62mm_Horizontal; not fitted
H1: MountingHole; MountingHole_4.3mm_M4
H2: HV_IN; MountingHole_3.2mm_M3_Pad_Via
H3: COM_IN; MountingHole_3.2mm_M3_Pad_Via
J1: HV_OUT; PinHeader_1x02_P2.54mm_Vertical
J2: Vout_sns+; 105-1102-001
J3: Vout_sns-; 105-1102-001
J4: COM_OUT; PinHeader_1x02_P2.54mm_Vertical
J5: Iout-; 105-1102-001
J6: Iout+; 105-1102-001
R1, R2, R3: 300M; HB01RE
R4, R5: 47M; R_Axial_DIN0309_L9.0mm_D3.2mm_P12.70mm_Horizontal
R6: 1k; R_Axial_DIN0309_L9.0mm_D3.2mm_P12.70mm_Horizontal; not fitted

Connections:
/COM: C5.2, D6.1 (K), H3.1, J3.1, J3.2, J5.1, J5.2, R6.1
/Isns: D6.2 (A), J4.1, J4.2, J6.1, J6.2, R6.2
/V1: C4.2, D5.2 (A), H2.1
/V2: C3.2, C5.1, D4.2 (A), D5.1 (K)
/V3: C2.2, C4.1, D3.2 (A), D4.1 (K)
/V4: C1.2, C3.1, D2.2 (A), D3.1 (K)
/V5: C2.1, D1.2 (A), D2.1 (K)
/V6: C1.1, D1.1 (K), J1.1, J1.2, R1.2
/Vsns: J2.1, J2.2, R5.1
unnamed: R1.1, R2.2
unnamed: R2.1, R3.2
unnamed: R3.1, R4.2
unnamed: R4.1, R5.2

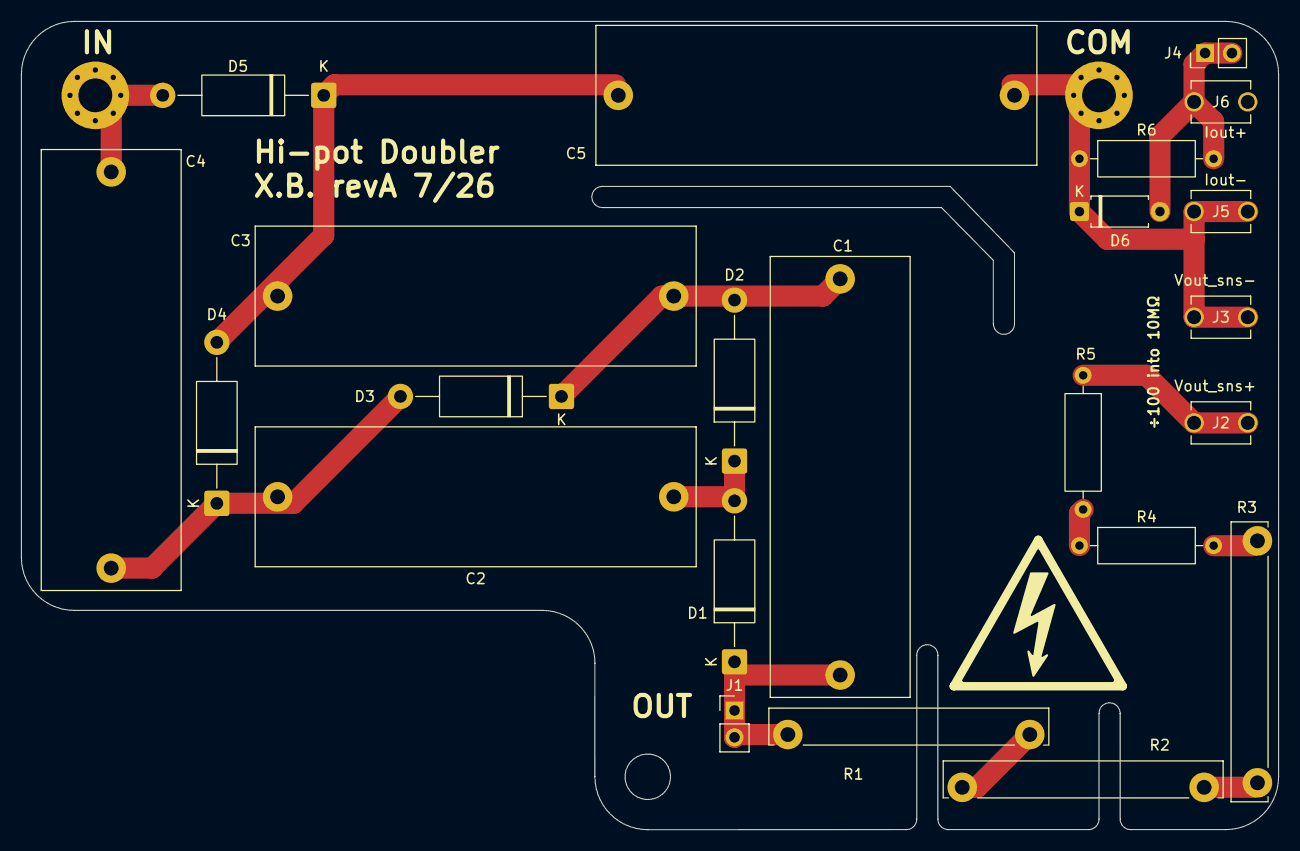
[picture p243: board Hi-pot_tester.kicad_pcb from above]

Board: 2 copper layers, 119.0 x 76.5 mm, 26 parts (0 on the bottom side), 13 nets.
