reivax-boucoi/PCB_Kicad/Pwr_breakout/Pwr_breakout.kicad_pcb

## KiCad design Pwr_breakout/Pwr_breakout.kicad_pcb (2026-07-09)

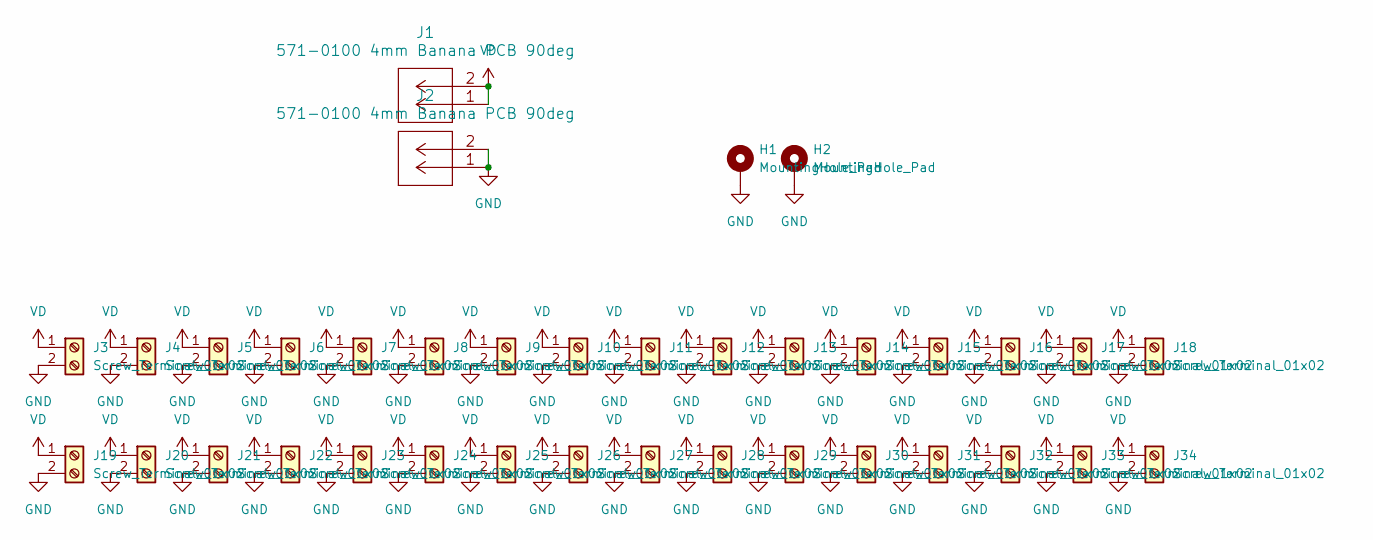
[picture p244: schematic Pwr_breakout.kicad_sch]

Parts:
H1, H2: MountingHole_Pad; MountingHole_6.4mm_M6_Pad_Via
J1, J2: 571-0100 4mm Banana PCB 90deg; 571-0100_Black
J3, J4, J5, J6, J7, J8, J9, J10, J11, J12, J13, J14, J15, J16, J17, J18, J19, J20, J21, J22, J23, J24, J25, J26, J27, J28, J29, J30, J31, J32, J33, J34: Screw_Terminal_01x02; TerminalBlock_bornier-2_P5.08mm

Connections:
GND: H1.1, H2.1, J2.1, J2.2, J3.2, J4.2, J5.2, J6.2, J7.2, J8.2, J9.2, J10.2, J11.2, J12.2, J13.2, J14.2, J15.2, J16.2, J17.2, J18.2, J19.2, J20.2, J21.2, J22.2, J23.2, J24.2, J25.2, J26.2, J27.2, J28.2, J29.2, J30.2, J31.2, J32.2, J33.2, J34.2
VD: J1.1, J1.2, J3.1, J4.1, J5.1, J6.1, J7.1, J8.1, J9.1, J10.1, J11.1, J12.1, J13.1, J14.1, J15.1, J16.1, J17.1, J18.1, J19.1, J20.1, J21.1, J22.1, J23.1, J24.1, J25.1, J26.1, J27.1, J28.1, J29.1, J30.1, J31.1, J32.1, J33.1, J34.1

Board: 2 copper layers, 36 parts (0 on the bottom side), 2 nets, no tracks yet.
