reivax-boucoi/PCB_Kicad/Kheprism/HW/PCB_Ventil/Kicad/PCB_Ventil.kicad_pcb

## KiCad design Kheprism/HW/PCB_Ventil/Kicad/PCB_Ventil.kicad_pcb (2026-03-25)

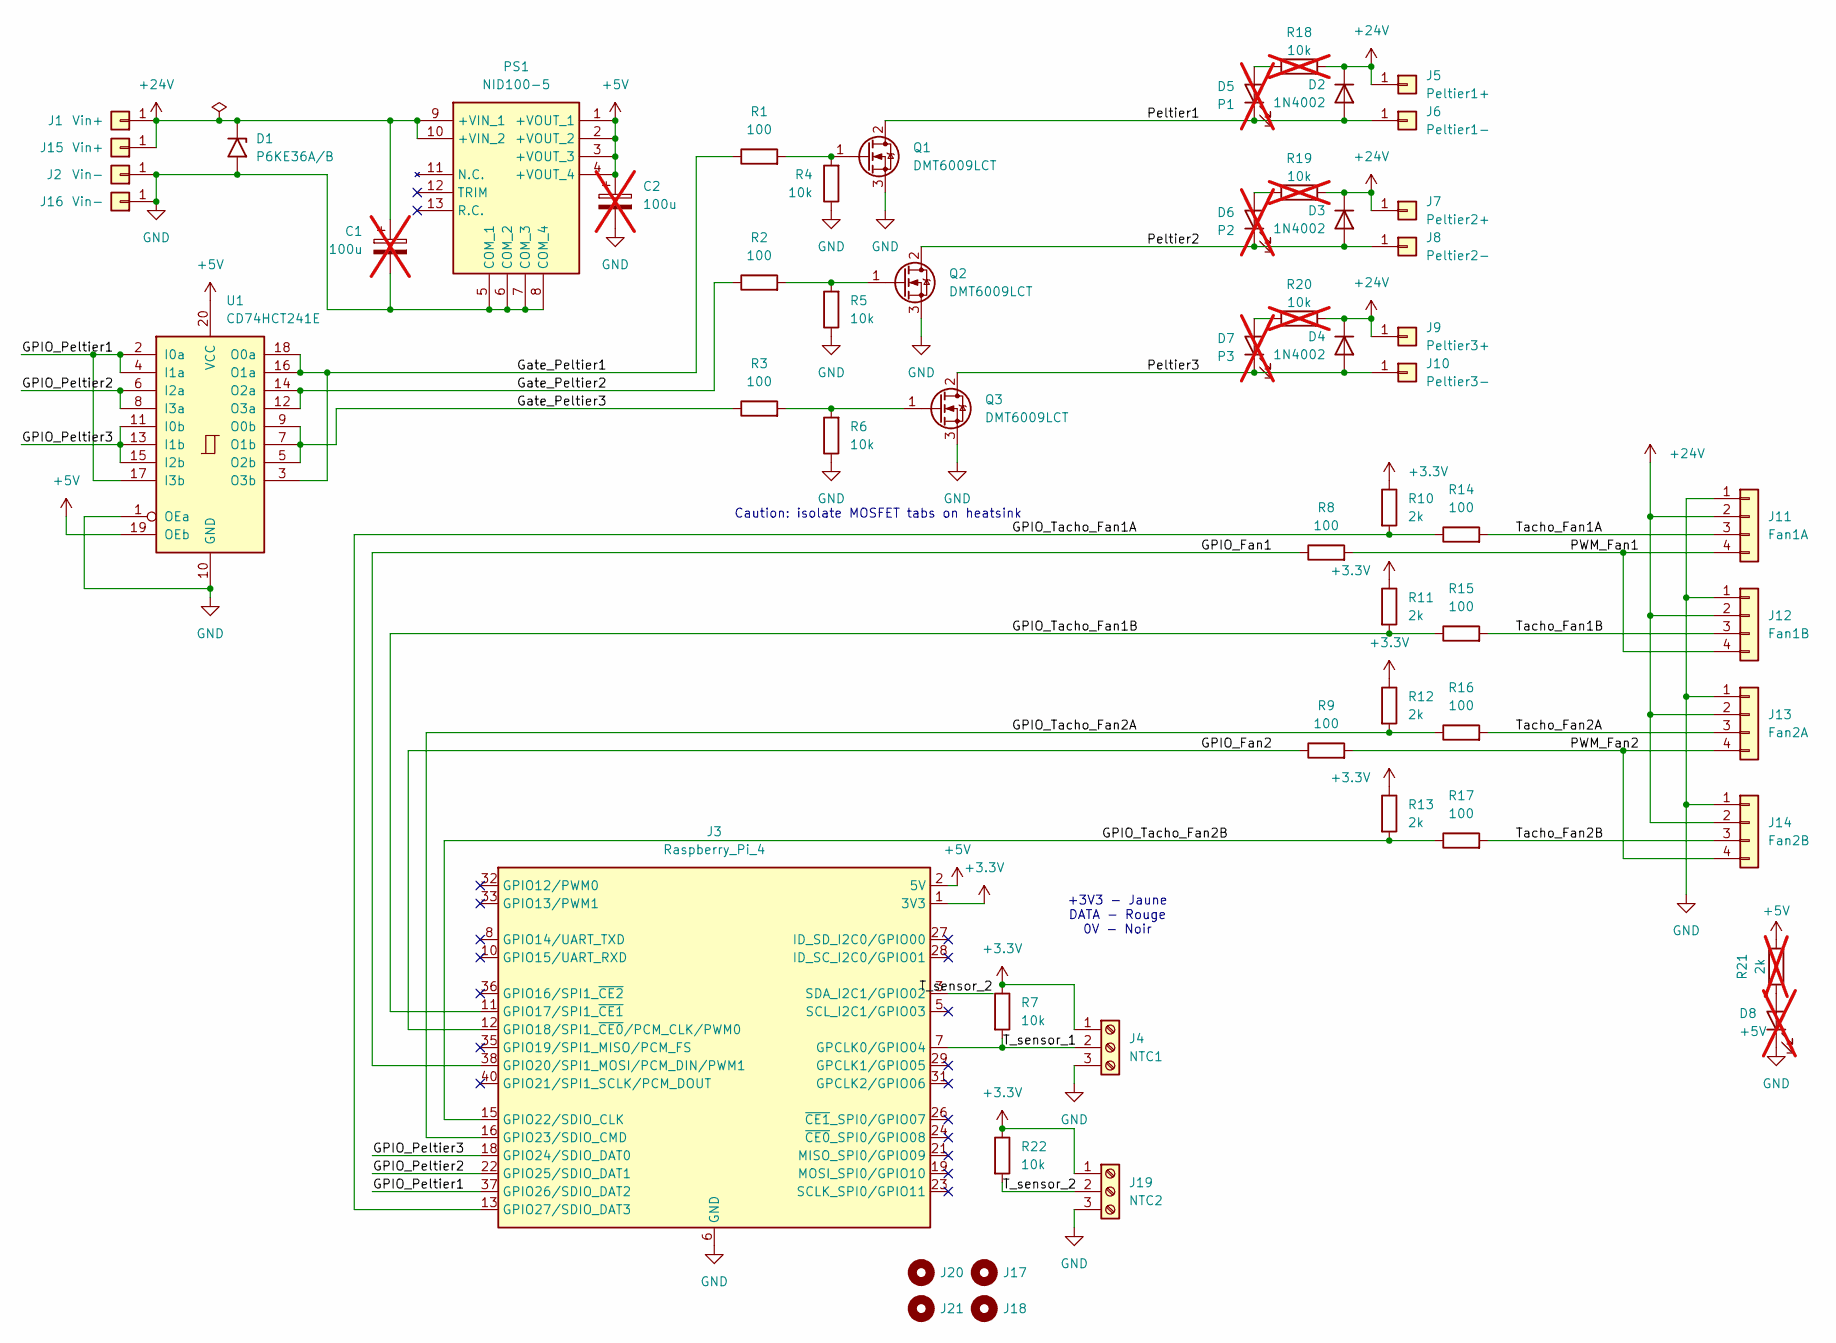
[picture p245: schematic PCB_Ventil.kicad_sch, PCB_Ventil_Ctrl]

Parts:
C1, C2: 100u; CP_Radial_D10.0mm_P2.50mm_P5.00mm; not fitted
D1: P6KE36A/B; D_DO-201AE_P15.24mm_Horizontal; Farnell Part Number P6KE36A/B
D2, D3, D4: 1N4002; D_DO-41_SOD81_P10.16mm_Horizontal; Farnell Part Number 1N4002-G
D5: P1; LED_D5.0mm; Farnell Part Number BL-B5134-1-TBS20A; not fitted
D6: P2; LED_D5.0mm; Farnell Part Number BL-B5134-1-TBS20A; not fitted
D7: P3; LED_D5.0mm; Farnell Part Number BL-B5134-1-TBS20A; not fitted
D8: +5V; LED_D5.0mm; Farnell Part Number BL-B5134-1-TBS20A; not fitted
J1, J15: Vin+; Faston_1287-250mils_P5.08mm; Farnell Part Number 4966
J2, J16: Vin-; Faston_1287-250mils_P5.08mm; Farnell Part Number 4966
J3: Raspberry_Pi_4; PinSocket_2x20_P2.54mm_Vertical; Farnell Part Number 61304021821
J4: NTC1; TerminalBlock_MaiXu_MX126-5.0-03P_1x03_P5.00mm; Farnell Part Number BLR513-5-V
J5: Peltier1+; Faston_1287-250mils_P5.08mm; Farnell Part Number 4966
J6: Peltier1-; Faston_1287-250mils_P5.08mm; Farnell Part Number 4966
J7: Peltier2+; Faston_1287-250mils_P5.08mm; Farnell Part Number 4966
J8: Peltier2-; Faston_1287-250mils_P5.08mm; Farnell Part Number 4966
J9: Peltier3+; Faston_1287-250mils_P5.08mm; Farnell Part Number 4966
J10: Peltier3-; Faston_1287-250mils_P5.08mm; Farnell Part Number 4966
J11: Fan1A; FanPinHeader_1x04_P2.54mm_Vertical; Farnell Part Number 0470531000
J12: Fan1B; FanPinHeader_1x04_P2.54mm_Vertical; Farnell Part Number 0470531000
J13: Fan2A; FanPinHeader_1x04_P2.54mm_Vertical; Farnell Part Number 0470531000
J14: Fan2B; FanPinHeader_1x04_P2.54mm_Vertical; Farnell Part Number 0470531000
J17, J18, J20, J21: Peltier1+; MountingHole_3.2mm_M3; Farnell Part Number 4966
J19: NTC2; TerminalBlock_MaiXu_MX126-5.0-03P_1x03_P5.00mm; Farnell Part Number BLR513-5-V
PS1: NID100-5; NID1005; Manufacturer_Part_Number NID100-5; Farnell Part Number NID100-5
Q1, Q2, Q3: DMT6009LCT; TO-220-3_Vertical; Farnell Part Number DMT6009LCT
R1, R2, R9, R16: 100; R_Axial_DIN0309_L9.0mm_D3.2mm_P2.54mm_Vertical; Farnell Price/Stock 0.0217
R3, R8, R14, R15, R17: 100; R_Axial_DIN0309_L9.0mm_D3.2mm_P12.70mm_Horizontal; Farnell Price/Stock 0.0217
R4, R5, R6, R7, R22: 10k; R_Axial_DIN0309_L9.0mm_D3.2mm_P2.54mm_Vertical; Farnell Price/Stock 0
R10, R11, R12, R13: 2k; R_Axial_DIN0309_L9.0mm_D3.2mm_P2.54mm_Vertical; Farnell Price/Stock 0
R18, R19, R20: 10k; R_Axial_DIN0309_L9.0mm_D3.2mm_P2.54mm_Vertical; Farnell Price/Stock 0; not fitted
R21: 2k; R_Axial_DIN0309_L9.0mm_D3.2mm_P2.54mm_Vertical; Farnell Price/Stock 0; not fitted
U1: CD74HCT241E; DIP-20_W7.62mm_LongPads

Connections:
+3.3V: J3.1 (3V3), J3.17 (3V3), J4.1, J19.1, R7.1, R10.1, R11.1, R12.1, R13.1, R22.1
+5V: C2.1, J3.2 (5V), J3.4 (5V), PS1.1 (+VOUT_1), PS1.2 (+VOUT_2), PS1.3 (+VOUT_3), PS1.4 (+VOUT_4), R21.1, U1.19 (OEb), U1.20 (VCC)
+24V: C1.1, D1.1 (A1), D2.1 (K), D3.1 (K), D4.1 (K), J1.1, J5.1, J7.1, J9.1, J11.2, J12.2, J13.2, J14.2, J15.1, PS1.9 (+VIN_1), PS1.10 (+VIN_2), R18.1, R19.1, R20.1
/GPIO_Fan1: J3.38 (GPIO20/SPI1_MOSI/PCM_DIN/PWM1), R8.1
/GPIO_Fan2: J3.12 (GPIO18/SPI1_~CE0/PCM_CLK/PWM0), R9.1
/GPIO_Peltier1: J3.37 (GPIO26/SDIO_DAT2), U1.2 (I0a), U1.4 (I1a), U1.17 (I3b)
/GPIO_Peltier2: J3.22 (GPIO25/SDIO_DAT1), U1.6 (I2a), U1.8 (I3a)
/GPIO_Peltier3: J3.18 (GPIO24/SDIO_DAT0), U1.11 (I0b), U1.13 (I1b), U1.15 (I2b)
/GPIO_Tacho_Fan1A: J3.13 (GPIO27/SDIO_DAT3), R10.2, R14.1
/GPIO_Tacho_Fan1B: J3.11 (GPIO17/SPI1_~CE1), R11.2, R15.1
/GPIO_Tacho_Fan2A: J3.16 (GPIO23/SDIO_CMD), R12.2, R16.1
/GPIO_Tacho_Fan2B: J3.15 (GPIO22/SDIO_CLK), R13.2, R17.1
/Gate_Peltier1: R1.1, U1.3 (O3b), U1.16 (O1a), U1.18 (O0a)
/Gate_Peltier2: R2.1, U1.12 (O3a), U1.14 (O2a)
/Gate_Peltier3: R3.1, U1.5 (O2b), U1.7 (O1b), U1.9 (O0b)
/PWM_Fan1: J11.4, J12.4, R8.2
/PWM_Fan2: J13.4, J14.4, R9.2
/Peltier1: D2.2 (A), D5.1 (K), J6.1, Q1.2 (D)
/Peltier2: D3.2 (A), D6.1 (K), J8.1, Q2.2 (D)
/Peltier3: D4.2 (A), D7.1 (K), J10.1, Q3.2 (D)
/T_sensor_1: J3.7 (GPCLK0/GPIO04), J4.2, R7.2
/T_sensor_2: J3.3 (SDA_I2C1/GPIO02), J19.2, R22.2
/Tacho_Fan1A: J11.3, R14.2
/Tacho_Fan1B: J12.3, R15.2
/Tacho_Fan2A: J13.3, R16.2
/Tacho_Fan2B: J14.3, R17.2
GND: C1.2, C2.2, D1.2 (A2), D8.1 (K), J2.1, J3.6 (GND), J3.9 (GND), J3.14 (GND), J3.20 (GND), J3.25 (GND), J3.30 (GND), J3.34 (GND), J3.39 (GND), J4.3, J11.1, J12.1, J13.1, J14.1, J16.1, J19.3, PS1.5 (COM_1), PS1.6 (COM_2), PS1.7 (COM_3), PS1.8 (COM_4), Q1.3 (S), Q2.3 (S), Q3.3 (S), R4.1, R5.1, R6.1, U1.1 (OEa), U1.10 (GND)
unnamed: D5.2 (A), R18.2
unnamed: D6.2 (A), R19.2
unnamed: D7.2 (A), R20.2
unnamed: D8.2 (A), R21.2
unnamed: Q1.1 (G), R1.2, R4.2
unnamed: Q2.1 (G), R2.2, R5.2
unnamed: Q3.1 (G), R3.2, R6.2

Notes on the sheet:
Caution: isolate MOSFET tabs on heatsink
+3V3 - Jaune DATA - Rouge 0V - Noir

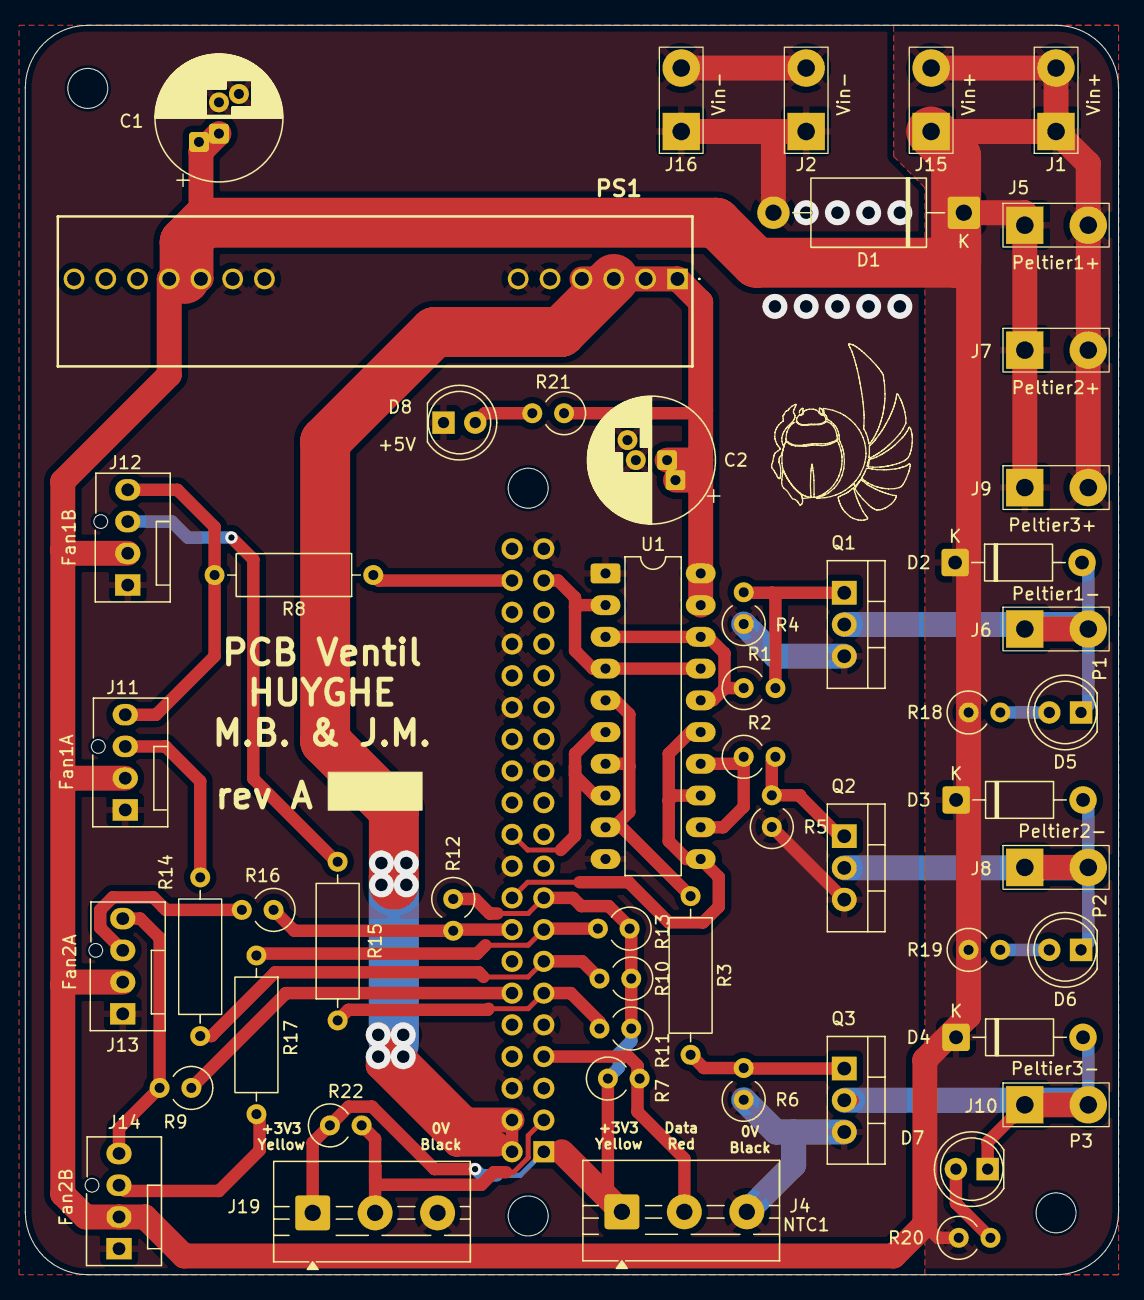
[picture p246: board PCB_Ventil.kicad_pcb from above]

Board: 2 copper layers, 87.5 x 100.0 mm, 58 parts (1 on the bottom side), 34 nets.
