reivax-boucoi/PCB_Kicad/Kheprism/HW/proto_expo_v0/proto_expo_v0.kicad_pcb

## KiCad design Kheprism/HW/proto_expo_v0/proto_expo_v0.kicad_pcb (2025-11-18)

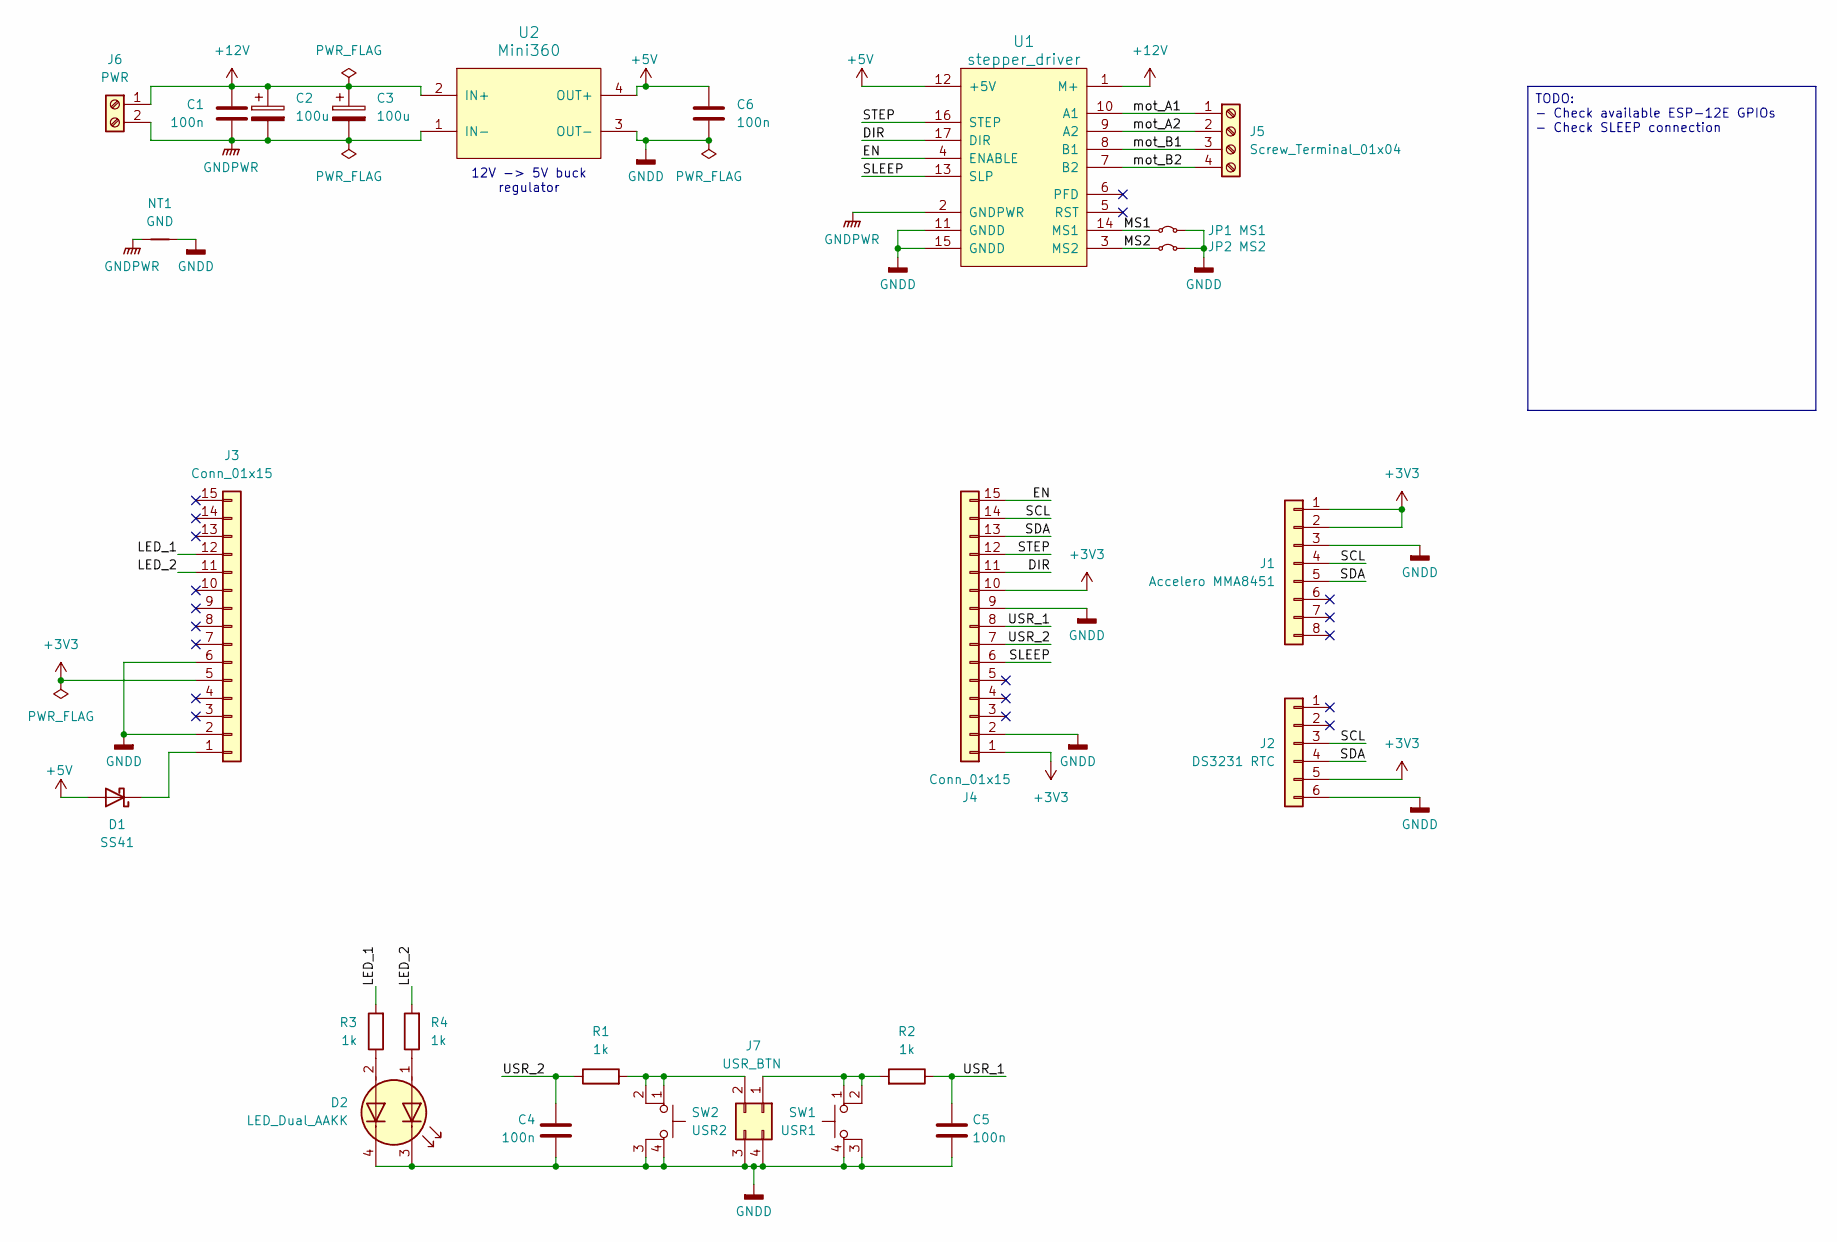
[picture p247: schematic proto_expo_v0.kicad_sch, Kheprism_proto_cntl]

Parts:
C1, C4, C5, C6: 100n; C_0805_2012Metric_Pad1.18x1.45mm_HandSolder
C2, C3: 100u; CP_Radial_D10.0mm_P2.50mm_P5.00mm
D1: SS41; D_SMB
D2: LED_Dual_AAKK; LED_Avago_PLCC4_3.2x2.8mm_CW
J1: Accelero MMA8451; PinSocket_1x08_P2.54mm_Vertical
J2: DS3231 RTC; PinSocket_1x06_P2.54mm_Vertical
J3, J4: Conn_01x15; PinSocket_1x15_P2.54mm_Vertical
J5: Screw_Terminal_01x04; TerminalBlock_bornier-4_P5.08mm
J6: PWR; TerminalBlock_bornier-2_P5.08mm
J7: USR_BTN; PinHeader_2x02_P2.00mm_Vertical
JP1: MS1; SolderJumper-2_P1.3mm_Bridged_RoundedPad1.0x1.5mm
JP2: MS2; SolderJumper-2_P1.3mm_Bridged_RoundedPad1.0x1.5mm
NT1: GND; NetTie-2_SMD_Pad0.5mm
R1, R2, R3, R4: 1k; R_0805_2012Metric_Pad1.20x1.40mm_HandSolder
SW1: USR1; SW_PUSH_6mm_H4.3mm
SW2: USR2; SW_PUSH_6mm_H4.3mm
U1: stepper_driver; easy_stepper_driver
U2: Mini360; Mini360_step-down

Connections:
+3V3: J1.1, J1.2, J2.5, J3.5, J4.1, J4.10
+5V: C6.1, D1.2 (A), U1.12 (+5V), U2.4 (OUT+)
+12V: C1.1, C2.1, C3.1, J6.1, U1.1 (M+), U2.2 (IN+)
/DIR: J4.11, U1.17 (DIR)
/EN: J4.15, U1.4 (ENABLE)
/LED_1: J3.12, R3.2
/LED_2: J3.11, R4.2
/MS1: JP1.1 (A), U1.14 (MS1)
/MS2: JP2.1 (A), U1.3 (MS2)
/SCL: J1.4, J2.3, J4.14
/SDA: J1.5, J2.4, J4.13
/SLEEP: J4.6, U1.13 (SLP)
/STEP: J4.12, U1.16 (STEP)
/USR_1: C5.1, J4.8, R2.1
/USR_2: C4.1, J4.7, R1.1
/mot_A1: J5.1, U1.10 (A1)
/mot_A2: J5.2, U1.9 (A2)
/mot_B1: J5.3, U1.8 (B1)
/mot_B2: J5.4, U1.7 (B2)
GNDD: C4.2, C5.2, C6.2, D2.3 (K1), D2.4 (K2), J1.3, J2.6, J3.2, J3.6, J4.2, J4.9, J7.3, J7.4, JP1.2 (B), JP2.2 (B), NT1.2, SW1.3 (K), SW1.4 (A), SW2.3 (K), SW2.4 (A), U1.11 (GNDD), U1.15 (GNDD), U2.3 (OUT-)
GNDPWR: C1.2, C2.2, C3.2, J6.2, NT1.1, U1.2 (GNDPWR), U2.1 (IN-)
unnamed: D1.1 (K), J3.1
unnamed: D2.1 (A1), R4.1
unnamed: D2.2 (A2), R3.1
unnamed: J7.1, R2.2, SW1.1, SW1.2
unnamed: J7.2, R1.2, SW2.1, SW2.2

Notes on the sheet:
12V -> 5V buck regulator
TODO: - Check available ESP-12E GPIOs - Check SLEEP connection

Board: 2 copper layers, 25 parts (0 on the bottom side), 26 nets, no tracks yet.
