reivax-boucoi/PCB_Kicad/GaN_Vth/GaN_Vth.kicad_pcb

## KiCad design GaN_Vth/GaN_Vth.kicad_pcb (2025-11-05)

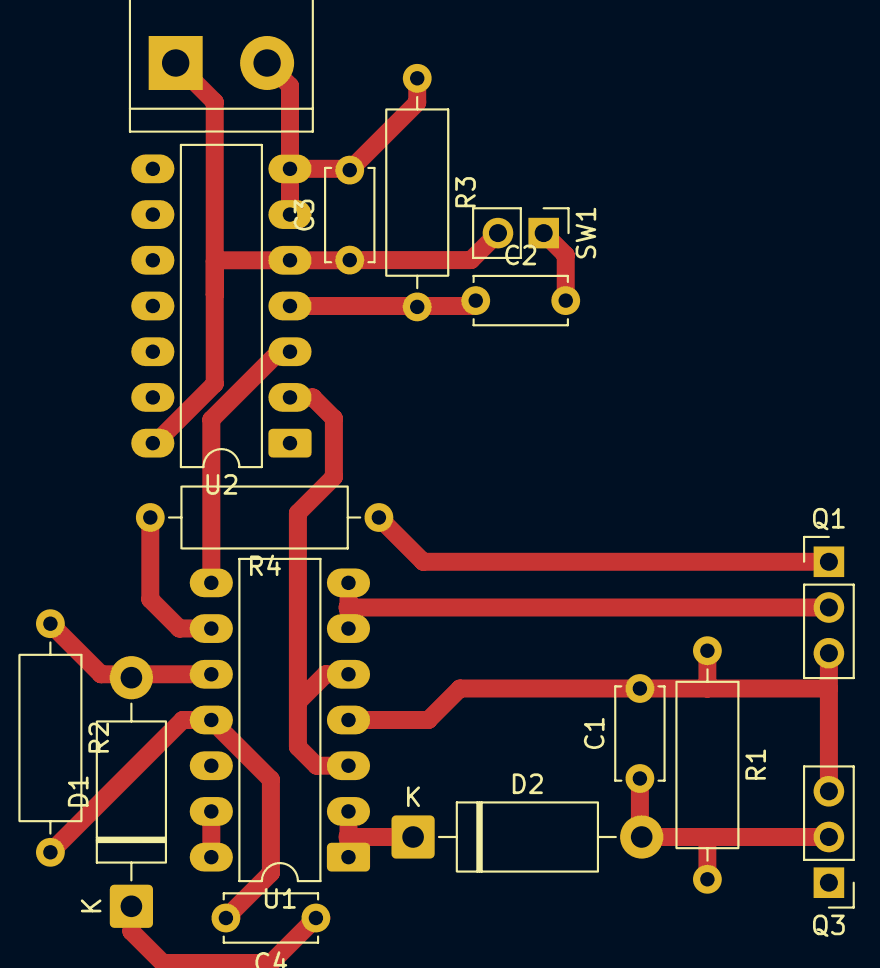
[picture p248: board GaN_Vth.kicad_pcb from above]

Board: 2 copper layers, 16 parts (0 on the bottom side), 13 nets.

Parts:
C1: C; C_Disc_D5.0mm_W2.5mm_P5.00mm
C2: 1n; C_Disc_D5.0mm_W2.5mm_P5.00mm
C3, C4: 100n; C_Disc_D5.0mm_W2.5mm_P5.00mm
D1: 3V3; D_DO-15_P12.70mm_Horizontal
D2: D_Schottky; D_DO-15_P12.70mm_Horizontal
J1: Screw_Terminal_01x02; TerminalBlock_bornier-2_P5.08mm
Q1: PMOS; PinHeader_1x03_P2.54mm_Vertical
Q3: GS66502B; PinHeader_1x03_P2.54mm_Vertical
R1: R; R_Axial_DIN0309_L9.0mm_D3.2mm_P12.70mm_Horizontal
R2, R3, R4: 10k; R_Axial_DIN0309_L9.0mm_D3.2mm_P12.70mm_Horizontal
SW1: SW_SPST; PinHeader_1x02_P2.54mm_Vertical
U1: LM324; DIP-14_W7.62mm_LongPads
U2: 4013; DIP-14_W7.62mm_LongPads

Connections:
+15V: C1.2, C3.1, C4.1, D1.1 (K), J1.1, Q1.3 (S), Q3.3 (S), R1.1, SW1.2 (B), U1.4 (V+), U2.5 (D), U2.14 (VDD)
/DC-: Q1.1 (D), R4.1
GND: C3.2, C4.2, J1.2, R2.2, R3.1, U1.11 (V-), U2.6 (S), U2.7 (VSS)
unnamed: D1.2 (A), R2.1, U1.10 (+)
unnamed: C1.1, D2.2 (A), Q3.2 (G), R1.2
unnamed: D2.1 (K), U1.1, U1.2 (-)
unnamed: Q1.2 (G), U1.6 (-), U1.7
unnamed: C2.2, SW1.1 (A)
unnamed: U1.3 (+), U1.5 (+), U2.2 (~Q)
unnamed: R4.2, U1.9 (-)
unnamed: U1.13 (-), U1.14
unnamed: U1.8, U2.3 (C)
unnamed: C2.1, R3.2, U2.4 (R)
