reivax-boucoi/PCB_Kicad/horse_feeder/HW/PCB_v2_M590E/horse_feeder.kicad_pcb

## KiCad design horse_feeder/HW/PCB_v2_M590E/horse_feeder.kicad_pcb (2025-07-24)

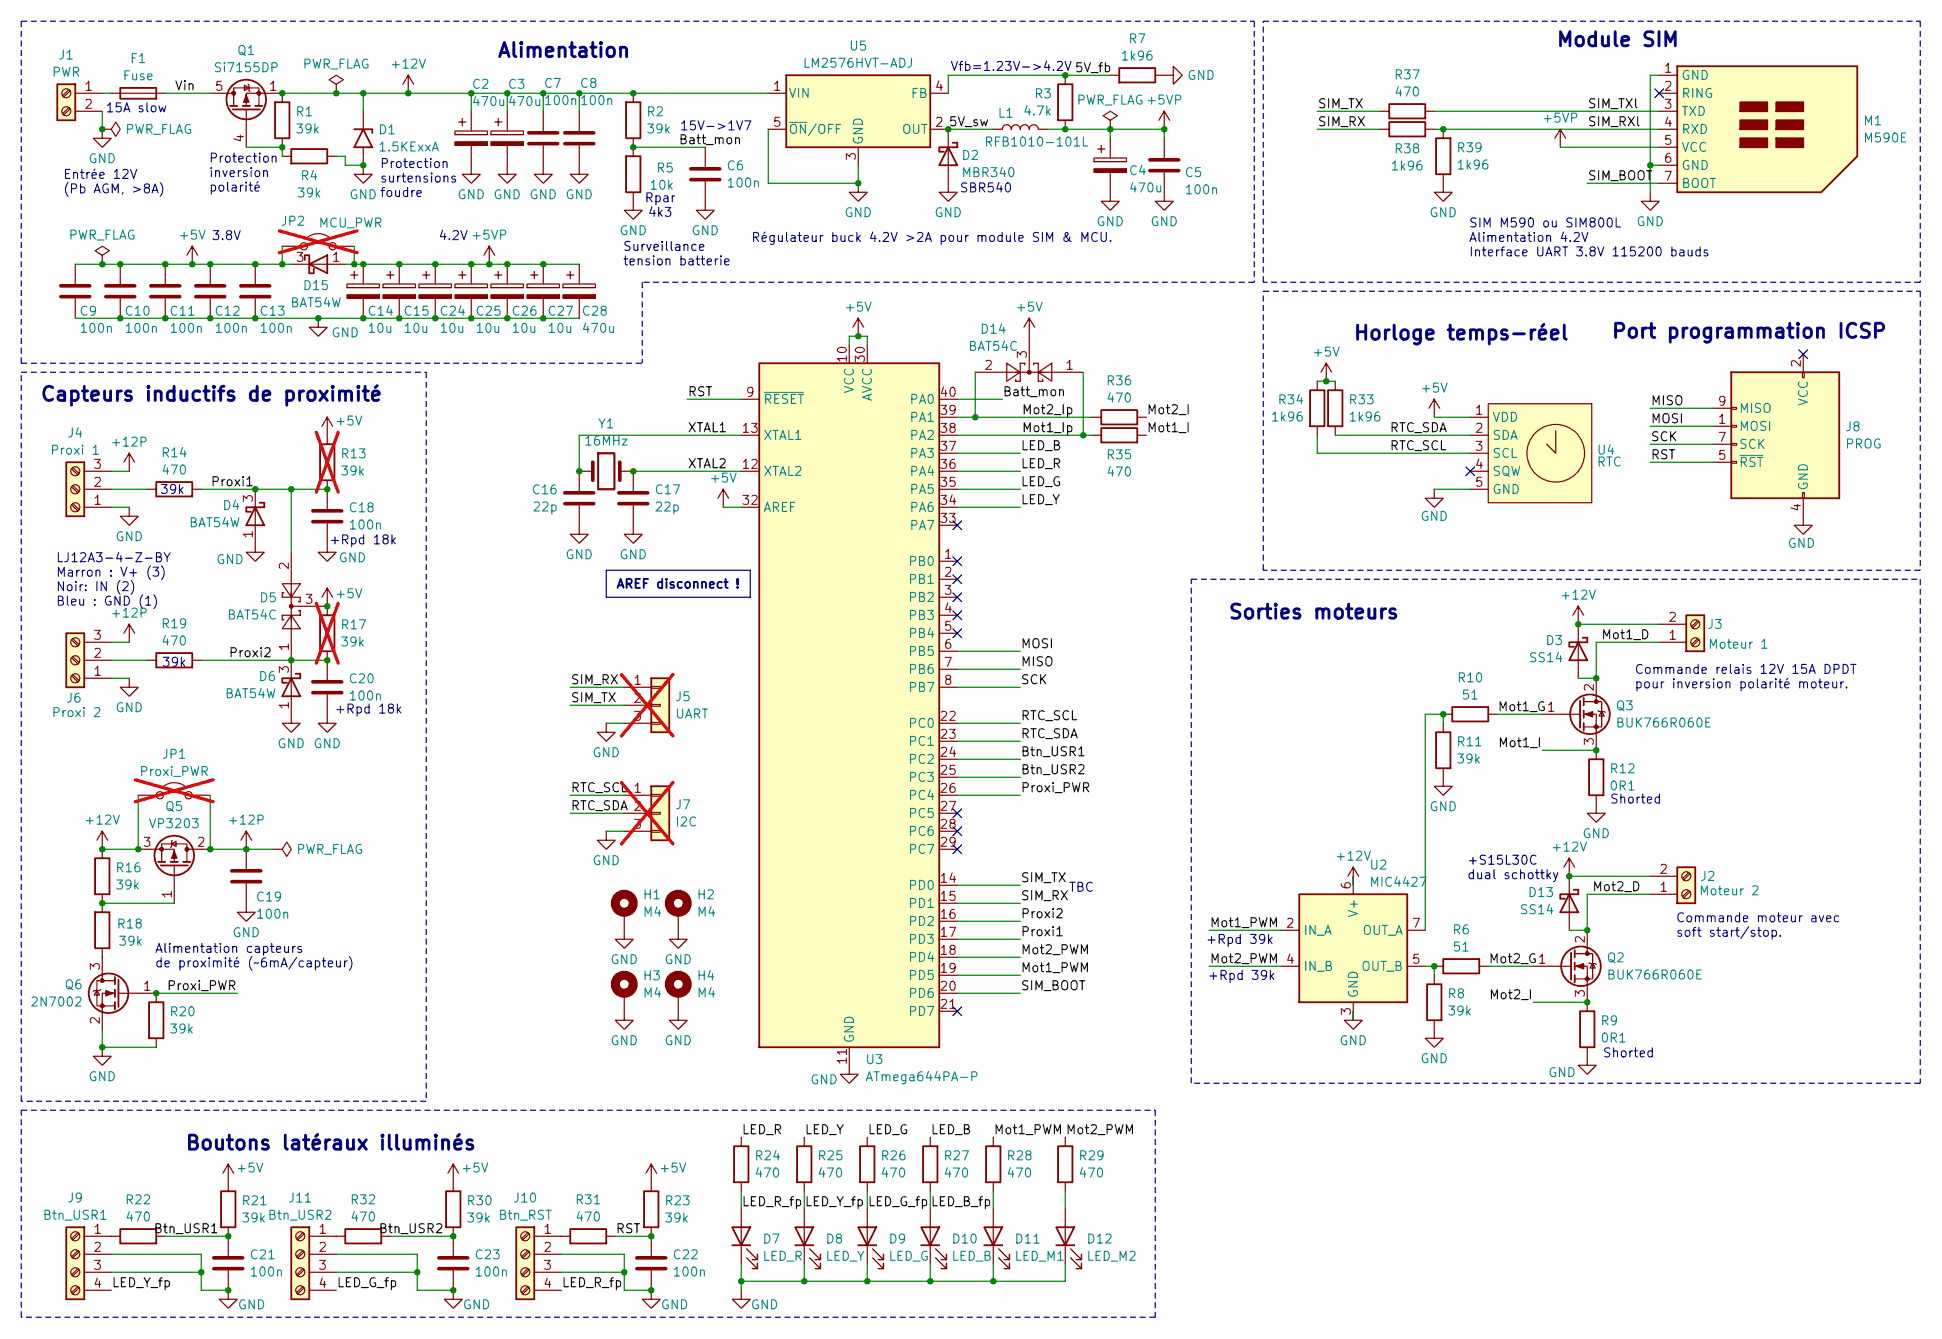
[picture p249: schematic horse_feeder.kicad_sch, Horse Feeder Controller]

Parts:
C2, C3, C4, C28: 470u; CP_Radial_D12.5mm_P5.00mm
C5, C6, C7, C8, C9, C10, C11, C12, C13, C18, C19, C20, C21, C22, C23: 100n; C_0805_2012Metric_Pad1.18x1.45mm_HandSolder
C14, C15, C24, C25, C26, C27: 10u; C_0805_2012Metric_Pad1.18x1.45mm_HandSolder
C16, C17: 22p; C_0603_1608Metric_Pad1.08x0.95mm_HandSolder
D1: 1.5KExxA; D_DO-201AE_P15.24mm_Horizontal
D2: MBR340; D_DO-201AD_P15.24mm_Horizontal
D3, D13: SS14; D_SMA
D4, D6, D15: BAT54W; SOT-23
D5, D14: BAT54C; SOT-23
D7: LED_R; LED_D5.0mm
D8: LED_Y; LED_D5.0mm
D9: LED_G; LED_D5.0mm
D10: LED_B; LED_D5.0mm
D11: LED_M1; LED_0805_2012Metric
D12: LED_M2; LED_0805_2012Metric
F1: Fuse; Fuseholder_Cylinder-5x20mm_Stelvio-Kontek_PTF78_Horizontal_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
H1, H2, H3, H4: M4; MountingHole_4.3mm_M4_Pad_Via
J1: PWR; TerminalBlock_bornier-2_P5.08mm
J2: Moteur 2; TerminalBlock_bornier-2_P5.08mm
J3: Moteur 1; TerminalBlock_bornier-2_P5.08mm
J4: Proxi 1; 282834-3
J5: UART; PinHeader_1x03_P2.54mm_Vertical; not fitted
J6: Proxi 2; 282834-3
J7: I2C; PinHeader_1x03_P2.54mm_Vertical; not fitted
J8: PROG; IDC-Header_2x05_P2.54mm_Vertical
J9: Btn_USR1; 282834-4
J10: Btn_RST; 282834-4
J11: Btn_USR2; 282834-4
JP1: Proxi_PWR; SolderJumper-2_P1.3mm_Open_RoundedPad1.0x1.5mm; not fitted
JP2: MCU_PWR; SolderJumper-2_P1.3mm_Open_RoundedPad1.0x1.5mm; not fitted
L1: RFB1010-101L; RFB1010
M1: M590E
Q1: Si7155DP; PowerPAK_SO-8_Single
Q2, Q3: BUK766R060E; TO-263-2
Q5: VP3203; SOT-89-3_Handsoldering
Q6: 2N7002; SOT-23
R1, R2, R4, R8, R11, R16, R18, R20, R21, R23, R30: 39k; R_0805_2012Metric_Pad1.20x1.40mm_HandSolder
R3: 4.7k; R_0805_2012Metric_Pad1.20x1.40mm_HandSolder
R5: 10k; R_0805_2012Metric_Pad1.20x1.40mm_HandSolder
R6, R10: 51; R_0805_2012Metric_Pad1.20x1.40mm_HandSolder
R7, R33, R34, R38, R39: 1k96; R_0805_2012Metric_Pad1.20x1.40mm_HandSolder
R9, R12: 0R1; R_1210_3225Metric_Pad1.30x2.65mm_HandSolder
R13, R17: 39k; R_0805_2012Metric_Pad1.20x1.40mm_HandSolder; not fitted
R14, R19, R22, R24, R25, R26, R27, R28, R29, R31, R32, R35, R36, R37: 470; R_0805_2012Metric_Pad1.20x1.40mm_HandSolder
U2: MIC4427; DIP-8_W7.62mm_Socket_LongPads
U3: ATmega644PA-P; DIP-40_W15.24mm
U4: RTC; DS3231_RTC_module
U5: LM2576HVT-ADJ; TO-220-5_Vertical
Y1: 16MHz; Crystal_SMD_HC49-SD

Connections:
+5V: C9.1, C10.1, C11.1, C12.1, C13.1, D5.3, D14.3, D15.3 (K), JP2.1 (A), R13.1, R17.1, R21.1, R23.1, R30.1, R33.1, R34.1, U3.10 (VCC), U3.30 (AVCC), U3.32 (AREF), U4.1 (VDD)
+5VP: C4.1, C5.1, C14.1, C15.1, C24.1, C25.1, C26.1, C27.1, C28.1, D15.1 (A), JP2.2 (B), L1.2, M1.5 (VCC), R3.2
+12P: C19.1, J4.3, J6.3, JP1.2 (B), Q5.2 (D)
+12V: C2.1, C3.1, C7.1, C8.1, D1.1 (A1), D3.1 (K), D13.1 (K), J2.2, J3.2, JP1.1 (A), Q1.1 (S), Q1.2 (S), Q1.3 (S), Q5.3 (S), R1.2, R2.2, R16.1, U2.6 (V+), U5.1 (VIN)
/5V_fb: R3.1, R7.2, U5.4 (FB)
/5V_sw: D2.1 (K), L1.1, U5.2 (OUT)
/Batt_mon: C6.1, R2.1, R5.2, U3.40 (PA0)
/Btn_USR1: C21.1, R21.2, R22.2, U3.24 (PC2)
/Btn_USR2: C23.1, R30.2, R32.2, U3.25 (PC3)
/LED_B: R27.1, U3.37 (PA3)
/LED_B_fp: D10.2 (A), R27.2
/LED_G: R26.1, U3.35 (PA5)
/LED_G_fp: D9.2 (A), J11.4, R26.2
/LED_R: R24.1, U3.36 (PA4)
/LED_R_fp: D7.2 (A), J10.4, R24.2
/LED_Y: R25.1, U3.34 (PA6)
/LED_Y_fp: D8.2 (A), J9.4, R25.2
/MISO: J8.9 (MISO), U3.7 (PB6)
/MOSI: J8.1 (MOSI), U3.6 (PB5)
/Mot1_D: D3.2 (A), J3.1, Q3.2 (D)
/Mot1_G: Q3.1 (G), R10.2
/Mot1_I: Q3.3 (S), R12.1, R35.2
/Mot1_Ip: D14.1, R35.1, U3.38 (PA2)
/Mot1_PWM: R28.1, U2.2 (IN_A), U3.19 (PD5)
/Mot2_D: D13.2 (A), J2.1, Q2.2 (D)
/Mot2_G: Q2.1 (G), R6.2
/Mot2_I: Q2.3 (S), R9.1, R36.2
/Mot2_Ip: D14.2, R36.1, U3.39 (PA1)
/Mot2_PWM: R29.1, U2.4 (IN_B), U3.18 (PD4)
/Proxi1: C18.1, D4.3 (K), D5.2, R13.2, R14.2, U3.17 (PD3)
/Proxi2: C20.1, D5.1, D6.3 (K), R17.2, R19.2, U3.16 (PD2)
/Proxi_PWR: Q6.1 (G), R20.1, U3.26 (PC4)
/RST: C22.1, J8.5 (~RST), R23.2, R31.2, U3.9 (~RESET)
/RTC_SCL: J7.1, R34.2, U3.22 (PC0), U4.3 (SCL)
/RTC_SDA: J7.2, R33.2, U3.23 (PC1), U4.2 (SDA)
/SCK: J8.7 (SCK), U3.8 (PB7)
/SIM_BOOT: M1.7 (BOOT), U3.20 (PD6)
/SIM_RX: J5.1, R38.1, U3.15 (PD1)
/SIM_RXl: M1.4 (RXD), R38.2, R39.2
/SIM_TX: J5.2, R37.1, U3.14 (PD0)
/SIM_TXl: M1.3 (TXD), R37.2
/Vin: F1.2, Q1.5 (D)
/XTAL1: C16.1, U3.13 (XTAL1), Y1.1
/XTAL2: C17.1, U3.12 (XTAL2), Y1.2
GND: C2.2, C3.2, C4.2, C5.2, C6.2, C7.2, C8.2, C9.2, C10.2, C11.2, C12.2, C13.2, C14.2, C15.2, C16.2, C17.2, C18.2, C19.2, C20.2, C21.2, C22.2, C23.2, C24.2, C25.2, C26.2, C27.2, C28.2, D1.2 (A2), D2.2 (A), D4.1 (A), D6.1 (A), D7.1 (K), D8.1 (K), D9.1 (K), D10.1 (K), D11.1 (K), D12.1 (K), H1.1, H2.1, H3.1, H4.1, J1.2, J4.1, J5.3, J6.1, J7.3, J8.4 (GND), J8.6 (GND), J8.8 (GND), J8.10 (GND), J9.2, J9.3, J10.2, J10.3, J11.2, J11.3, M1.1 (GND), M1.6 (GND), Q6.2 (S), R4.1, R5.1, R7.1, R8.2, R9.2, R11.2, R12.2, R20.2, R39.1, U2.3 (GND), U3.11 (GND), U3.31 (GND), U4.5 (GND), U5.3 (GND), U5.5 (~ON/OFF)
unnamed: D11.2 (A), R28.2
unnamed: D12.2 (A), R29.2
unnamed: F1.1, J1.1
unnamed: J4.2, R14.1
unnamed: J6.2, R19.1
unnamed: J9.1, R22.1
unnamed: J10.1, R31.1
unnamed: J11.1, R32.1
unnamed: Q1.4 (G), R1.1, R4.2
unnamed: Q5.1 (G), R16.2, R18.2
unnamed: Q6.3 (D), R18.1
unnamed: R10.1, R11.1, U2.7 (OUT_A)
unnamed: R6.1, R8.1, U2.5 (OUT_B)

Notes on the sheet:
AREF disconnect !
LJ12A3-4-Z-BY Marron : V+ (3) Noir: IN (2) Bleu : GND (1)
Boutons latéraux illuminés
15V->1V7
Surveillance tension batterie
15A slow
Capteurs inductifs de proximité
Protection inversion polarité
+Rpd 39k
+Rpd 18k
4.2V
Sorties moteurs
Module SIM
3.8V
39k
Protection surtensions foudre
Port programmation ICSP
Entrée 12V (Pb AGM, >8A)
Shorted
Horloge temps-réel
TBC
+S15L30C dual schottky
Régulateur buck 4.2V >2A pour module SIM & MCU.
Alimentation
Commande moteur avec soft start/stop.
SIM M590 ou SIM800L Alimentation 4.2V Interface UART 3.8V 115200 bauds
Commande relais 12V 15A DPDT pour inversion polarité moteur.
Vfb=1.23V->4.2V
Rpar 4k3
SBR540
Alimentation capteurs de proximité (~6mA/capteur)

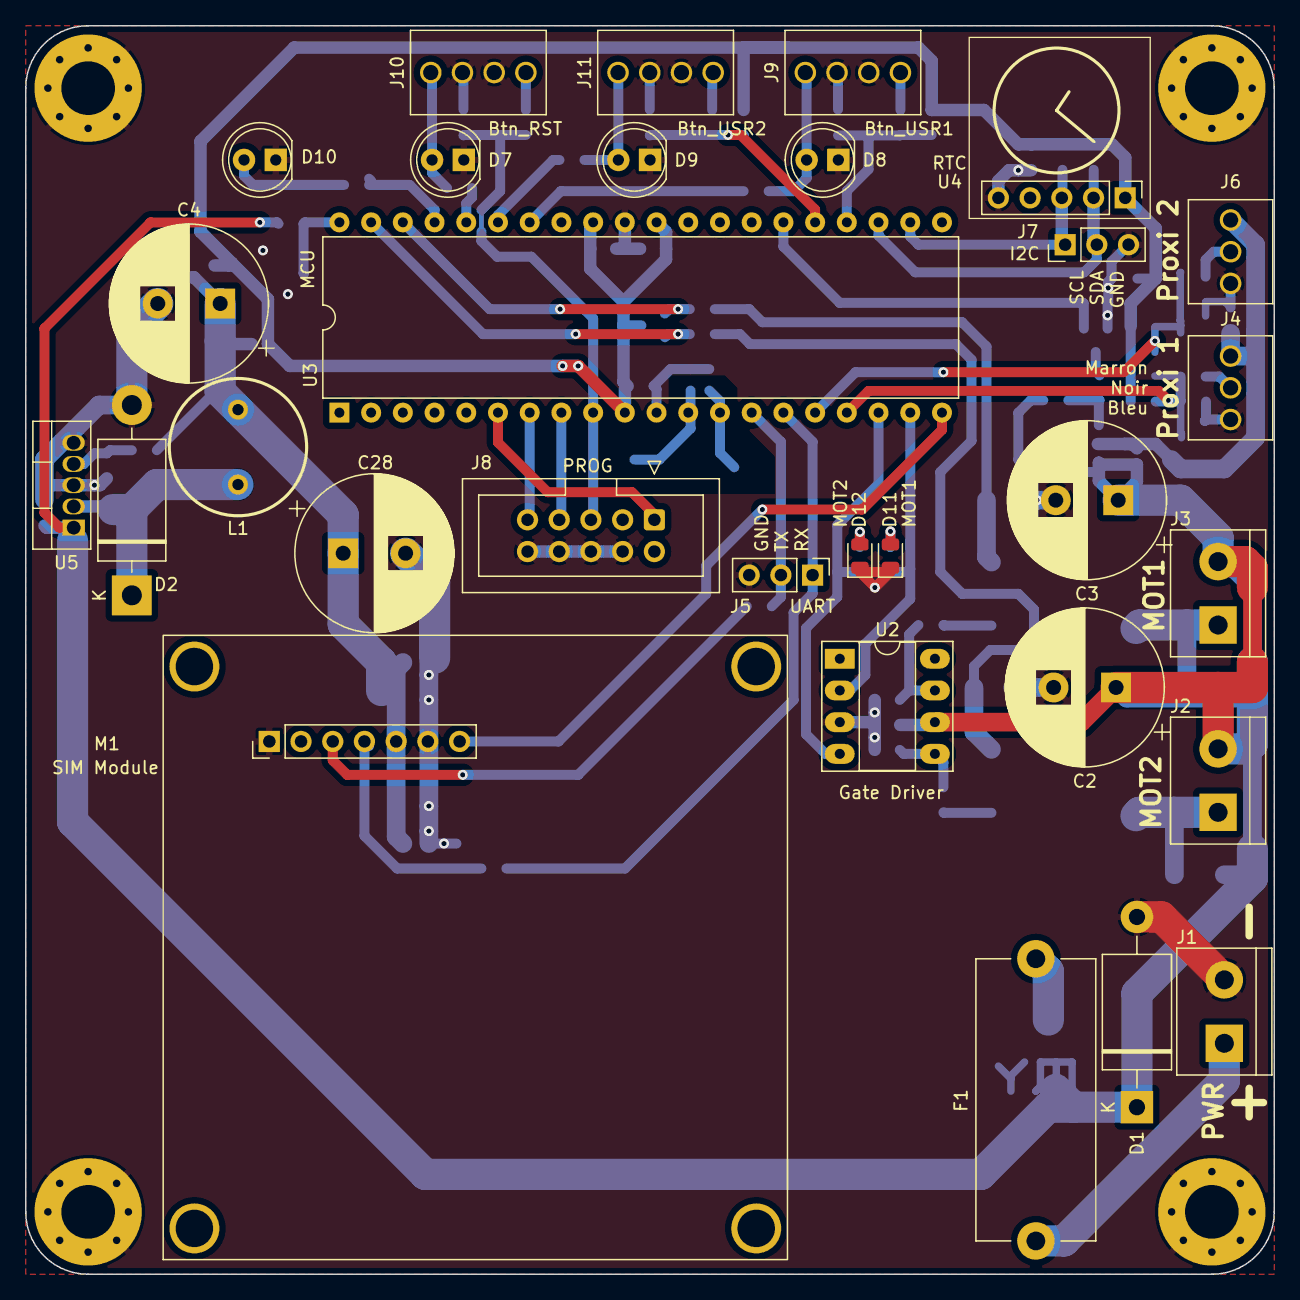
[picture p250: board horse_feeder.kicad_pcb from above]

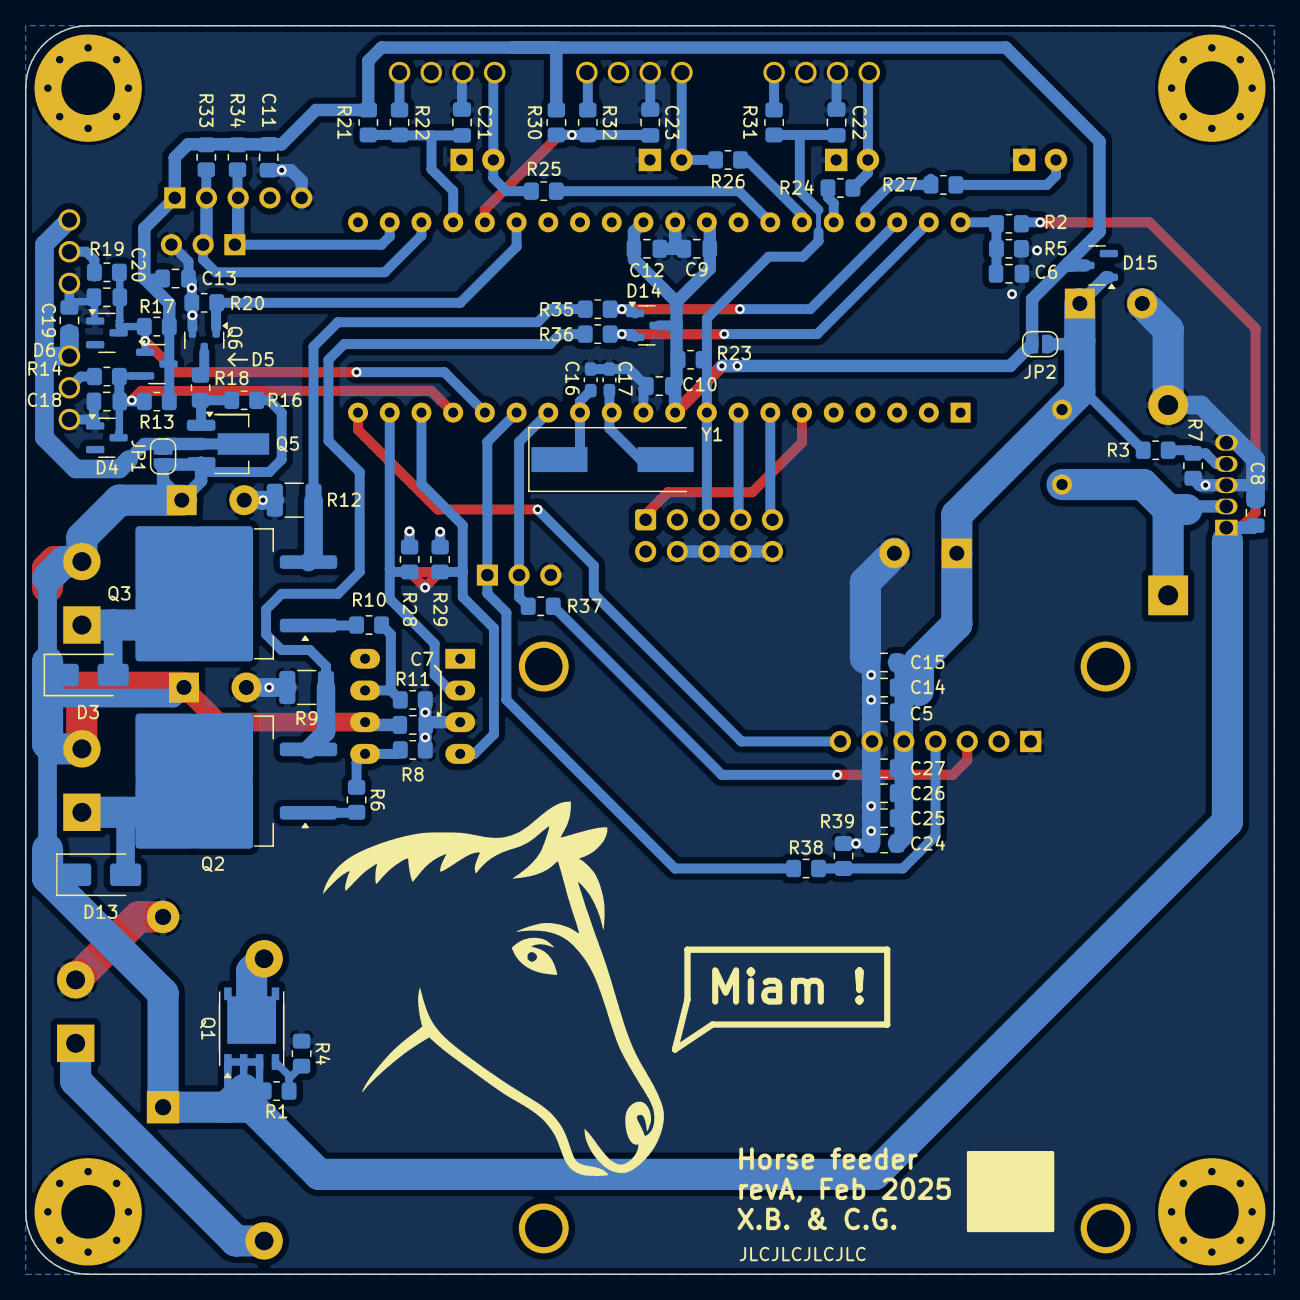
[picture p251: board horse_feeder.kicad_pcb from below]

Board: 2 copper layers, 100.0 x 100.0 mm, 110 parts (76 on the bottom side), 58 nets.
