reivax-boucoi/PCB_Kicad/LabBooster/LabBooster.kicad_pcb

## KiCad design LabBooster/LabBooster.kicad_pcb (2025-07-24)

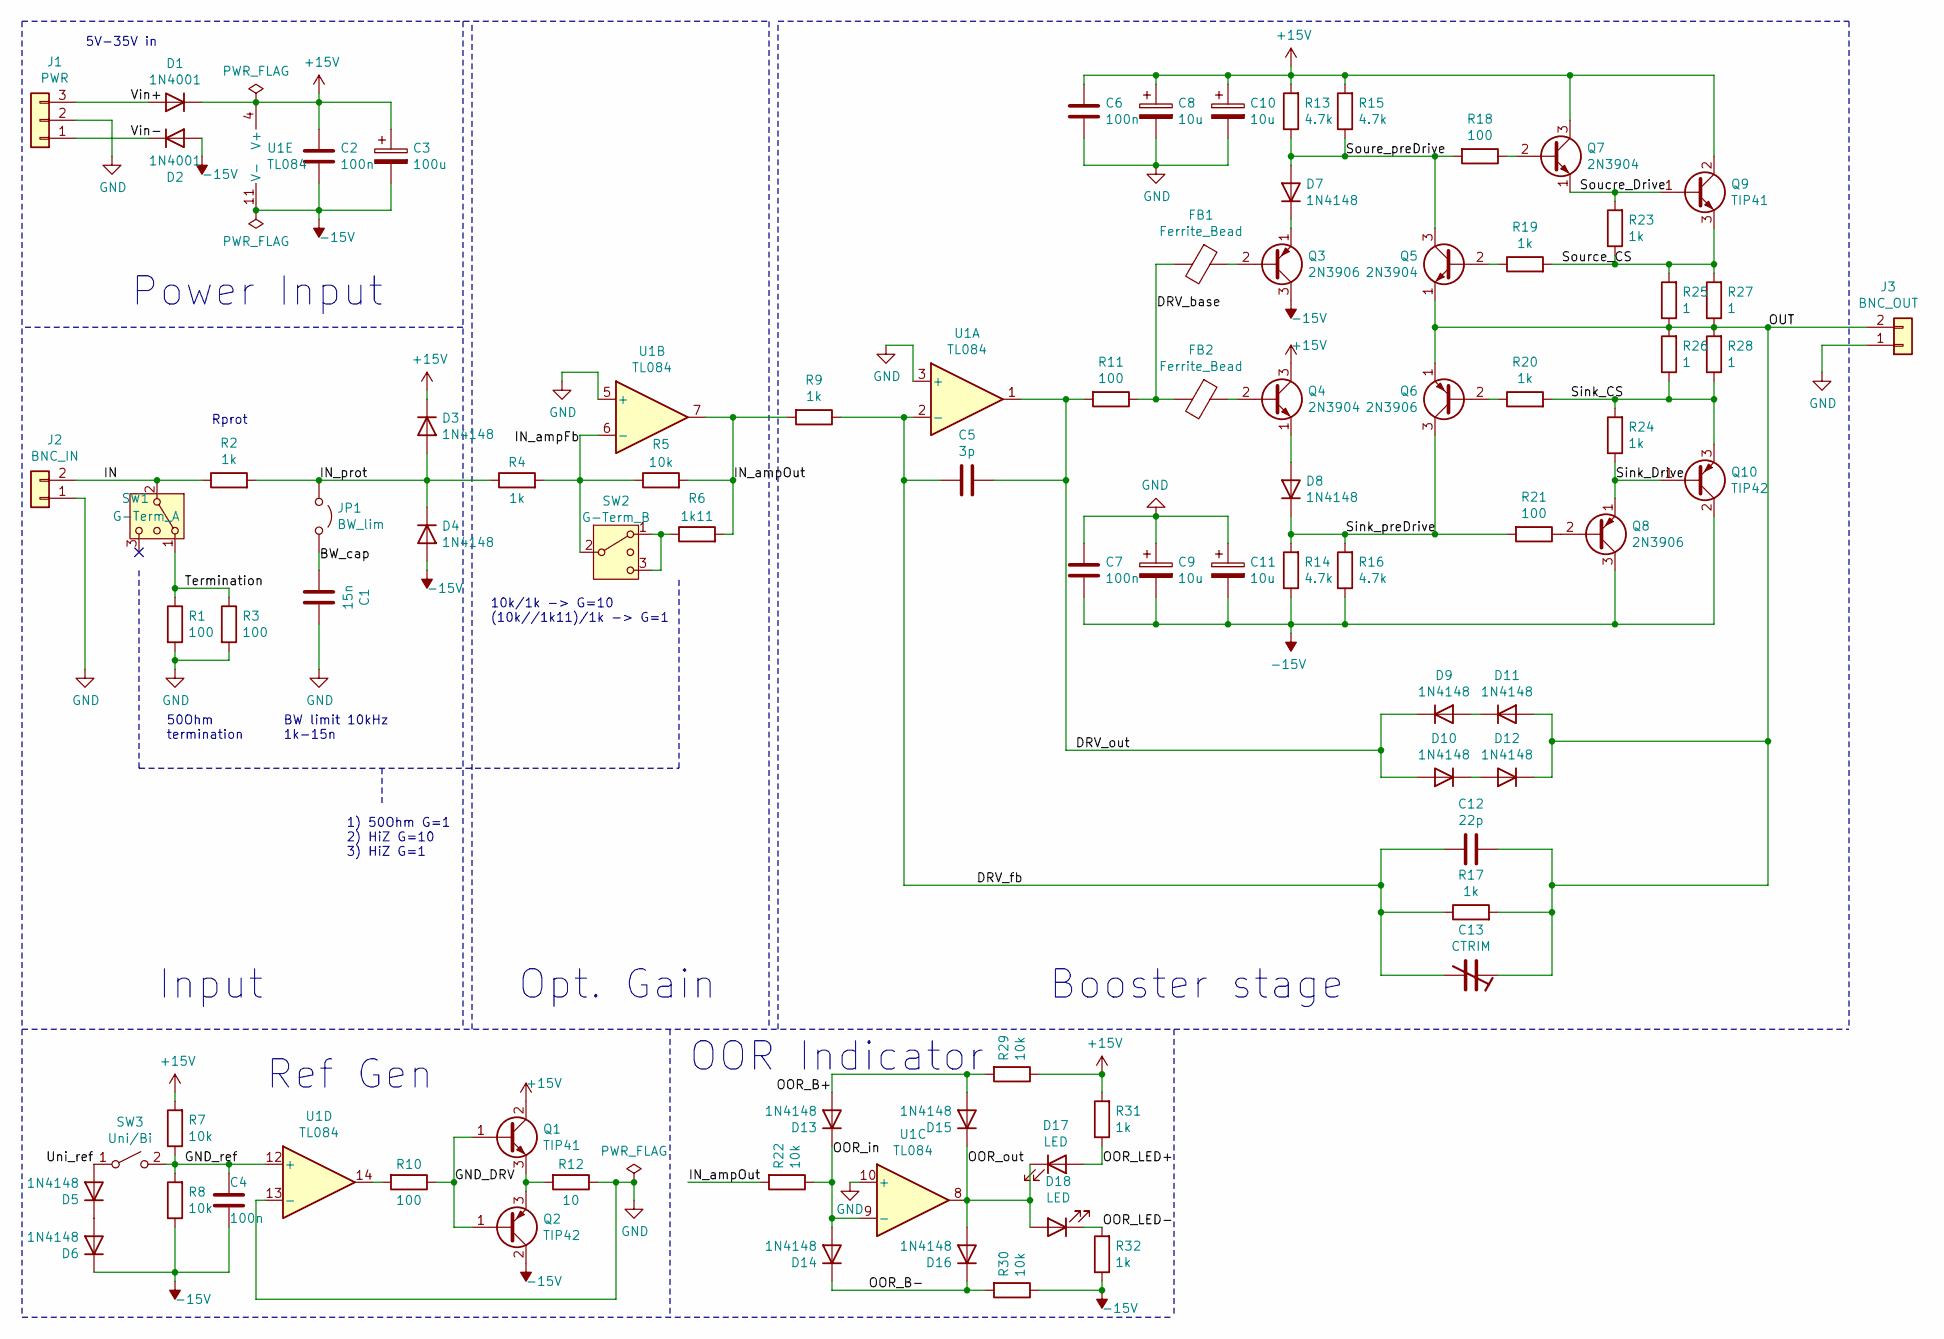
[picture p252: schematic LabBooster.kicad_sch, Lab Booster]

Parts:
C1: 15n; C_Socket_D5.0mm_W2.5mm_P5.00mm
C2, C4, C6, C7: 100n; C_Disc_D5.0mm_W2.5mm_P5.00mm
C3: 100u; CP_Radial_D10.0mm_P5.00mm
C5: 3p; C_Socket_D5.0mm_W2.5mm_P5.00mm
C8, C9, C10, C11: 10u; CP_Radial_D6.3mm_P2.50mm
C12: 22p; C_Socket_D5.0mm_W2.5mm_P5.00mm
C13: CTRIM
D1, D2: 1N4001; D_DO-41_SOD81_P10.16mm_Horizontal
D3, D4, D5, D6, D7, D8, D9, D10, D11, D12, D13, D14, D15, D16: 1N4148; D_DO-35_SOD27_P7.62mm_Horizontal
D17, D18: LED; LED_D3.0mm
FB1, FB2: Ferrite_Bead; R_Axial_DIN0309_L9.0mm_D3.2mm_P12.70mm_Horizontal
J1: PWR; SolderWirePad_1x03_P4.445mm_Drill1.5mm
J2: BNC_IN; SolderWirePad_1x02_P5.08mm_Drill1.5mm
J3: BNC_OUT; SolderWirePad_1x02_P5.08mm_Drill1.5mm
JP1: BW_lim; PinSocket_1x02_P2.54mm_Vertical
Q1, Q9: TIP41; TO-220-3_Vertical
Q2, Q10: TIP42; TO-220-3_Vertical
Q3, Q6, Q8: 2N3906; TO-92_Inline
Q4, Q5, Q7: 2N3904; TO-92_Inline
R1, R3, R10, R11, R18, R21: 100; R_Axial_DIN0207_L6.3mm_D2.5mm_P10.16mm_Horizontal
R2: 1k; R_Socket_L6.3mm_D2.5mm_P10.16mm_Horizontal
R4, R9, R17, R19, R20, R23, R24, R31, R32: 1k; R_Axial_DIN0207_L6.3mm_D2.5mm_P10.16mm_Horizontal
R5, R7, R8, R29, R30: 10k; R_Axial_DIN0207_L6.3mm_D2.5mm_P10.16mm_Horizontal
R6: 1k11; R_Socket_L6.3mm_D2.5mm_P10.16mm_Horizontal
R12: 10; R_Socket_L6.3mm_D2.5mm_P10.16mm_Horizontal
R13, R14, R15, R16: 4.7k; R_Axial_DIN0207_L6.3mm_D2.5mm_P10.16mm_Horizontal
R22: 10k; R_Socket_L6.3mm_D2.5mm_P10.16mm_Horizontal
R25, R26, R27, R28: 1; R_Axial_DIN0207_L6.3mm_D2.5mm_P10.16mm_Horizontal
SW1: G-Term_A; PinHeader_1x03_P2.54mm_Vertical
SW2: G-Term_B; PinHeader_1x03_P2.54mm_Vertical
SW3: Uni/Bi; PinSocket_1x02_P2.54mm_Vertical
U1: TL084; DIP-14_W7.62mm

Connections:
+15V: C2.1, C3.1, C6.1, C8.1, C10.1, D1.1 (K), D3.1 (K), Q1.2 (C), Q4.3 (C), Q7.3 (C), Q9.2 (C), R7.2, R13.2, R15.2, R29.1, R31.2, U1.4 (V+)
-15V: C2.2, C3.2, C4.2, C7.2, C9.2, C11.2, D2.2 (A), D4.2 (A), D6.1 (K), Q2.2 (C), Q3.3 (C), Q8.3 (C), Q10.2 (C), R8.1, R14.1, R16.1, R30.1, R32.1, U1.11 (V-)
/BW_cap: C1.2, JP1.2 (B)
/DRV_base: FB1.2, FB2.2, R11.1
/DRV_fb: C5.2, C12.2, C13.2, R9.1, R17.1, U1.2 (-)
/DRV_out: C5.1, D9.1 (K), D10.2 (A), R11.2, U1.1
/GND_DRV: Q1.1 (B), Q2.1 (B), R10.1
/GND_ref: C4.1, R7.1, R8.2, SW3.2 (B), U1.12 (+)
/IN: J2.2, R2.1, SW1.2 (3)
/IN_ampFb: R4.2, R5.1, SW2.2 (3), U1.6 (-)
/IN_ampOut: R5.2, R6.2, R9.2, R22.2, U1.7
/IN_prot: D3.2 (A), D4.1 (K), JP1.1 (A), R2.2, R4.1
/OOR_B+: D13.2 (A), D15.2 (A), R29.2
/OOR_B-: D14.1 (K), D16.1 (K), R30.2
/OOR_LED+: D17.2 (A), R31.1
/OOR_LED-: D18.1 (K), R32.2
/OOR_in: D13.1 (K), D14.2 (A), R22.1, U1.9 (-)
/OOR_out: D15.1 (K), D16.2 (A), D17.1 (K), D18.2 (A), U1.8
/OUT: C12.1, C13.1, D11.2 (A), D12.1 (K), J3.2, Q5.1 (E), Q6.1 (E), R17.2, R25.1, R26.2, R27.1, R28.2
/Sink_CS: Q10.3 (E), R20.2, R24.2, R26.1, R28.1
/Sink_Drive: Q8.1 (E), Q10.1 (B), R24.1
/Sink_preDrive: D8.1 (K), Q6.3 (C), R14.2, R16.2, R21.2
/Soucre_Drive: Q7.1 (E), Q9.1 (B), R23.2
/Source_CS: Q9.3 (E), R19.2, R23.1, R25.2, R27.2
/Soure_preDrive: D7.2 (A), Q5.3 (C), R13.1, R15.1, R18.2
/Termination: R1.1, R3.1, SW1.1
/Uni_ref: D5.2 (A), SW3.1 (A)
/Vin+: D1.2 (A), J1.3
/Vin-: D2.1 (K), J1.1
GND: C1.1, C6.2, C7.1, C8.2, C9.1, C10.2, C11.1, J1.2, J2.1, J3.1, R1.2, R3.2, R12.1, U1.3 (+), U1.5 (+), U1.10 (+), U1.13 (-)
unnamed: D5.1 (K), D6.2 (A)
unnamed: D7.1 (K), Q3.1 (E)
unnamed: D8.2 (A), Q4.1 (E)
unnamed: D10.1 (K), D12.2 (A)
unnamed: D9.2 (A), D11.1 (K)
unnamed: FB1.1, Q3.2 (B)
unnamed: FB2.1, Q4.2 (B)
unnamed: Q1.3 (E), Q2.3 (E), R12.2
unnamed: Q5.2 (B), R19.1
unnamed: Q6.2 (B), R20.1
unnamed: Q7.2 (B), R18.1
unnamed: Q8.2 (B), R21.1
unnamed: R6.1, SW2.1, SW2.3 (4)
unnamed: R10.2, U1.14

Notes on the sheet:
5V-35V in
Opt. Gain
Power Input
50Ohm termination
Input
10k/1k -> G=10 (10k//1k11)/1k -> G=1
Ref Gen
BW limit 10kHz 1k-15n
1) 50Ohm G=1 2) HiZ G=10 3) HiZ G=1
Booster stage
Rprot
OOR Indicator

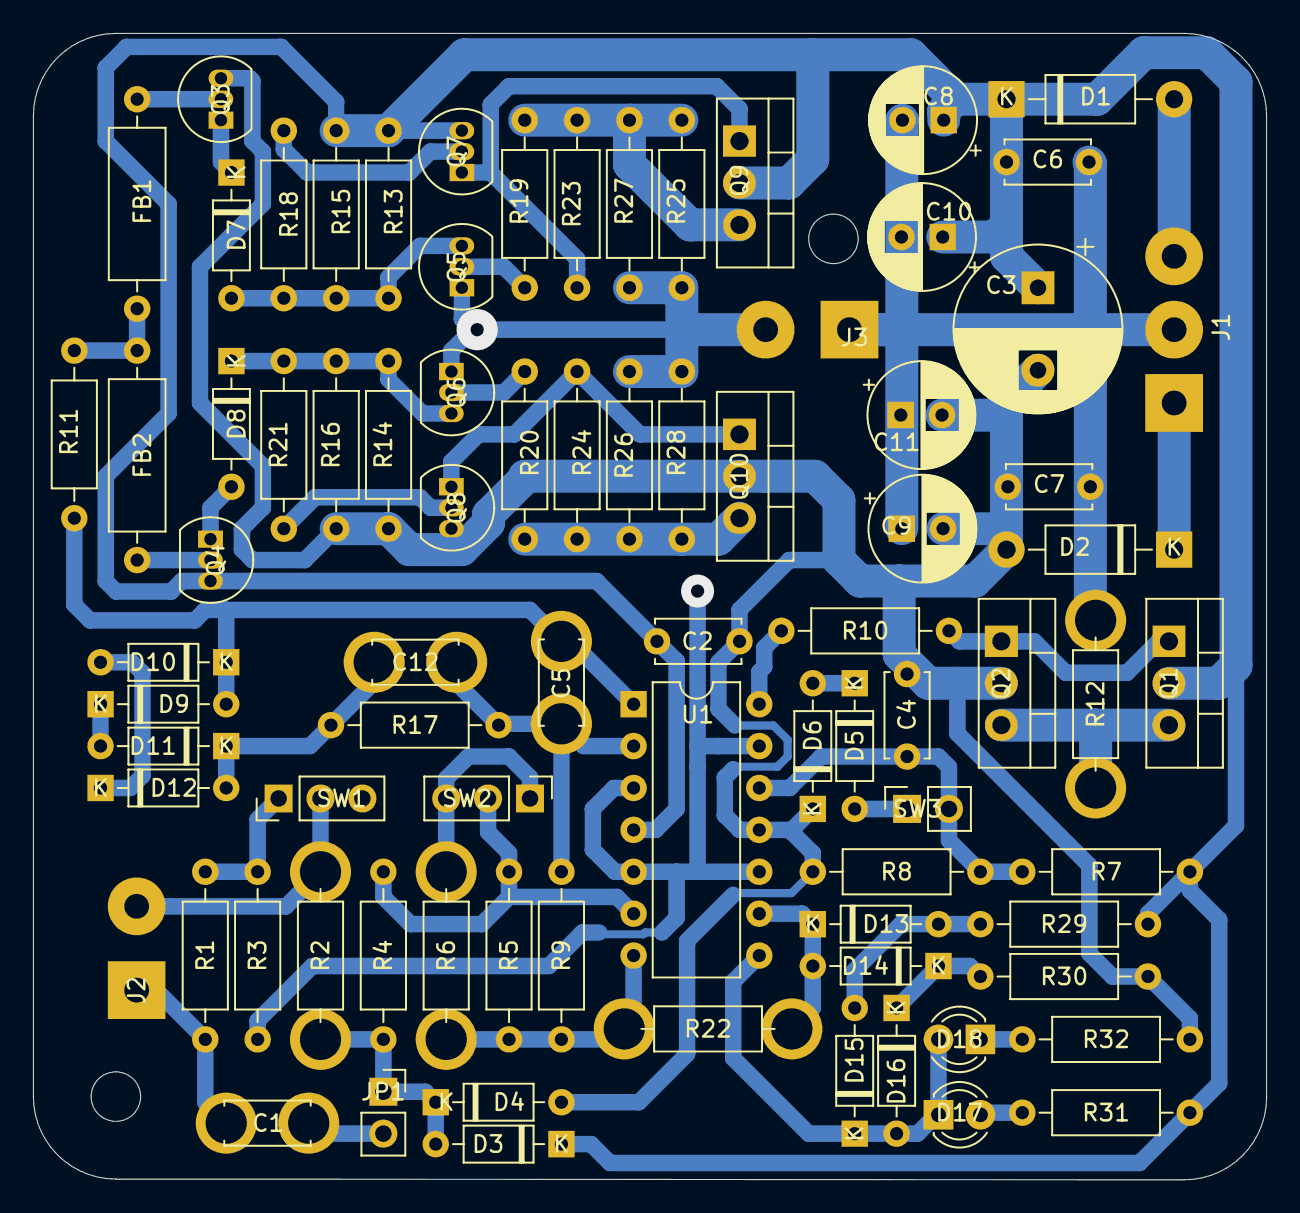
[picture p253: board LabBooster.kicad_pcb from above]

Board: 2 copper layers, 74.8 x 69.5 mm, 82 parts (0 on the bottom side), 44 nets.
