reivax-boucoi/PCB_Kicad/bike_speed_sensor/bike_speed_sensor.kicad_pcb

## KiCad design bike_speed_sensor/bike_speed_sensor.kicad_pcb (2025-07-24)

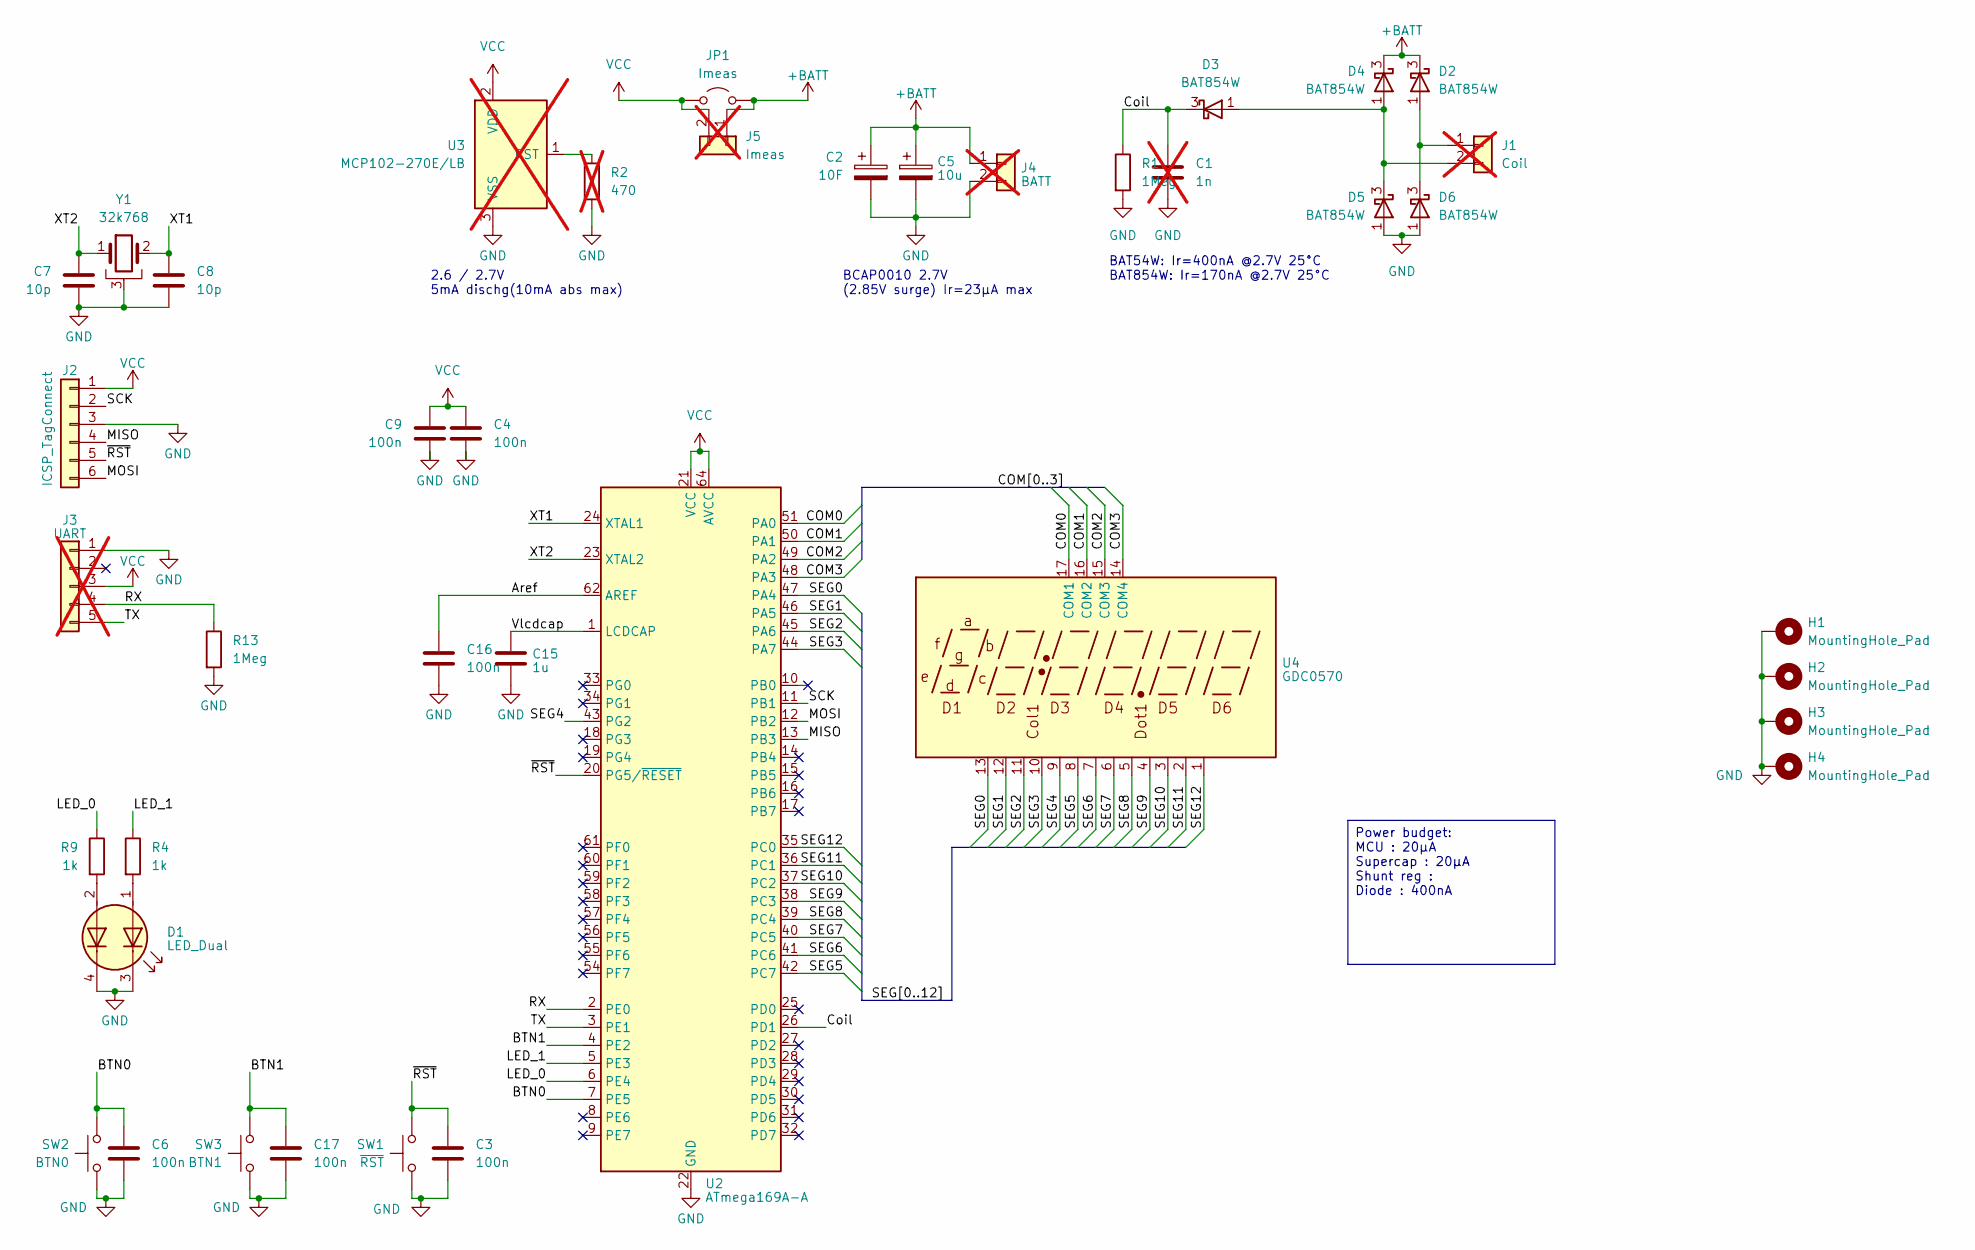
[picture p254: schematic bike_speed_sensor.kicad_sch, Bike Speed-O-meter]

Parts:
C1: 1n; C_0603_1608Metric; not fitted
C2: 10F; Board_edge_cap_P5mm_D10mm
C3, C4, C6, C9, C16, C17: 100n; C_0603_1608Metric
C5: 10u; C_1206_3216Metric_Pad1.33x1.80mm_HandSolder
C7, C8: 10p; C_0603_1608Metric
C15: 1u; C_0805_2012Metric_Pad1.18x1.45mm_HandSolder
D1: LED_Dual; LED_Cree-PLCC4_3.2x2.8mm_CCW
D2, D3, D4, D5, D6: BAT854W; SOT-323_SC-70_Handsoldering
H1, H2, H3, H4: MountingHole_Pad; MountingHole_3.2mm_M3_Pad_Via
J1: Coil; PinHeader_1x02_P2.54mm_Vertical; not fitted
J2: ICSP_TagConnect; Tag-Connect_TC2030-IDC-NL_2x03_P1.27mm_Vertical
J3: UART; PinSocket_1x05_P2.54mm_Vertical; not fitted
J4: BATT; PinHeader_1x02_P2.54mm_Vertical; not fitted
J5: Imeas; PinHeader_1x02_P2.54mm_Vertical; not fitted
JP1: Imeas; SolderJumper-2_P1.3mm_Open_RoundedPad1.0x1.5mm
R1, R13: 1Meg; R_0603_1608Metric
R2: 470; R_0603_1608Metric; not fitted
R4, R9: 1k; R_0603_1608Metric
SW1: ~{RST}; SW_PUSH_6mm_2pins
SW2: BTN0; SW_PUSH_6mm_2pins
SW3: BTN1; SW_PUSH_6mm_2pins
U2: ATmega169A-A; TQFP-64_14x14mm_P0.8mm
U3: MCP102-270E/LB; SOT-323_SC-70_Handsoldering; not fitted
U4: GDC0570; GDC0570_LCD_6digits_2mmPitch
Y1: 32k768; Crystal_SMD_MicroCrystal_MS1V-T1K

Connections:
+BATT: C2.1, C5.1, D2.3 (K), D4.3 (K), J4.1, J5.1, JP1.2 (B)
/Aref: C16.1, U2.62 (AREF)
/BTN0: C6.1, SW2.2, U2.7 (PE5)
/BTN1: C17.1, SW3.2, U2.4 (PE2)
/COM0: U2.51 (PA0), U4.17 (COM1)
/COM1: U2.50 (PA1), U4.16 (COM2)
/COM2: U2.49 (PA2), U4.15 (COM3)
/COM3: U2.48 (PA3), U4.14 (COM4)
/Coil: C1.1, D3.3 (K), R1.1, U2.26 (PD1)
/LED_0: R9.1, U2.6 (PE4)
/LED_1: R4.1, U2.5 (PE3)
/MISO: J2.4, U2.13 (PB3)
/MOSI: J2.6, U2.12 (PB2)
/RX: J3.4, R13.1, U2.2 (PE0)
/SCK: J2.2, U2.11 (PB1)
/SEG0: U2.47 (PA4), U4.13
/SEG1: U2.46 (PA5), U4.12
/SEG2: U2.45 (PA6), U4.11
/SEG3: U2.44 (PA7), U4.10
/SEG4: U2.43 (PG2), U4.9
/SEG5: U2.42 (PC7), U4.8
/SEG6: U2.41 (PC6), U4.7
/SEG7: U2.40 (PC5), U4.6
/SEG8: U2.39 (PC4), U4.5
/SEG9: U2.38 (PC3), U4.4
/SEG10: U2.37 (PC2), U4.3
/SEG11: U2.36 (PC1), U4.2
/SEG12: U2.35 (PC0), U4.1
/TX: J3.5, U2.3 (PE1)
/Vlcdcap: C15.1, U2.1 (LCDCAP)
/XT1: C8.1, U2.24 (XTAL1), Y1.2
/XT2: C7.1, U2.23 (XTAL2), Y1.1
/~RST: C3.1, J2.5, SW1.2, U2.20 (PG5/~RESET)
GND: C1.2, C2.2, C3.2, C4.2, C5.2, C6.2, C7.2, C8.2, C9.2, C15.2, C16.2, C17.2, D1.3 (K1), D1.4 (K2), D5.1 (A), D6.1 (A), H1.1, H2.1, H3.1, H4.1, J2.3, J3.1, J4.2, R1.2, R2.2, R13.2, SW1.1, SW2.1, SW3.1, U2.22 (GND), U2.53 (GND), U2.63 (GND), U3.3 (VSS), Y1.3
unnamed: D1.1 (A1), R4.2
unnamed: D1.2 (A2), R9.2
unnamed: D2.1 (A), D6.3 (K), J1.1
unnamed: D3.1 (A), D4.1 (A), D5.3 (K), J1.2
unnamed: R2.1, U3.1 (RST)
VCC: C4.1, C9.1, J2.1, J3.3, J5.2, JP1.1 (A), U2.21 (VCC), U2.52 (VCC), U2.64 (AVCC), U3.2 (VDD)

Notes on the sheet:
2.6 / 2.7V 5mA dischg(10mA abs max)
BCAP0010 2.7V (2.85V surge) Ir=23µA max
BAT54W: Ir=400nA @2.7V 25°C BAT854W: Ir=170nA @2.7V 25°C
Power budget: MCU : 20µA Supercap : 20µA Shunt reg : Diode : 400nA

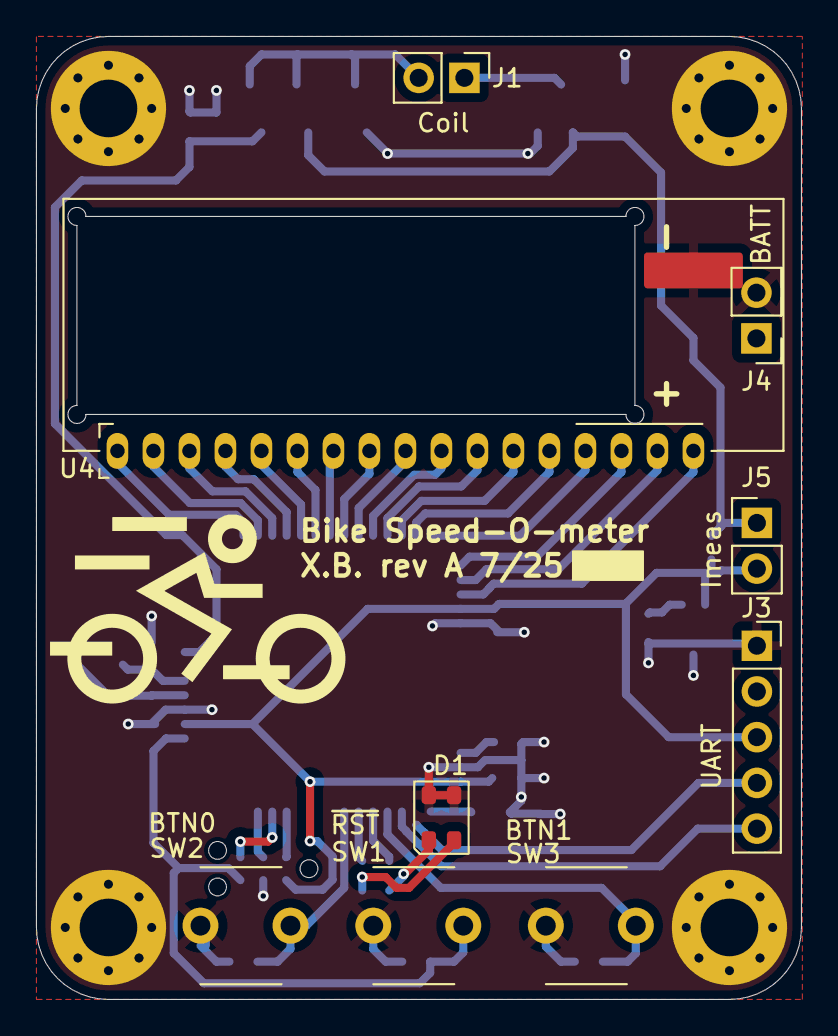
[picture p255: board bike_speed_sensor.kicad_pcb from above]

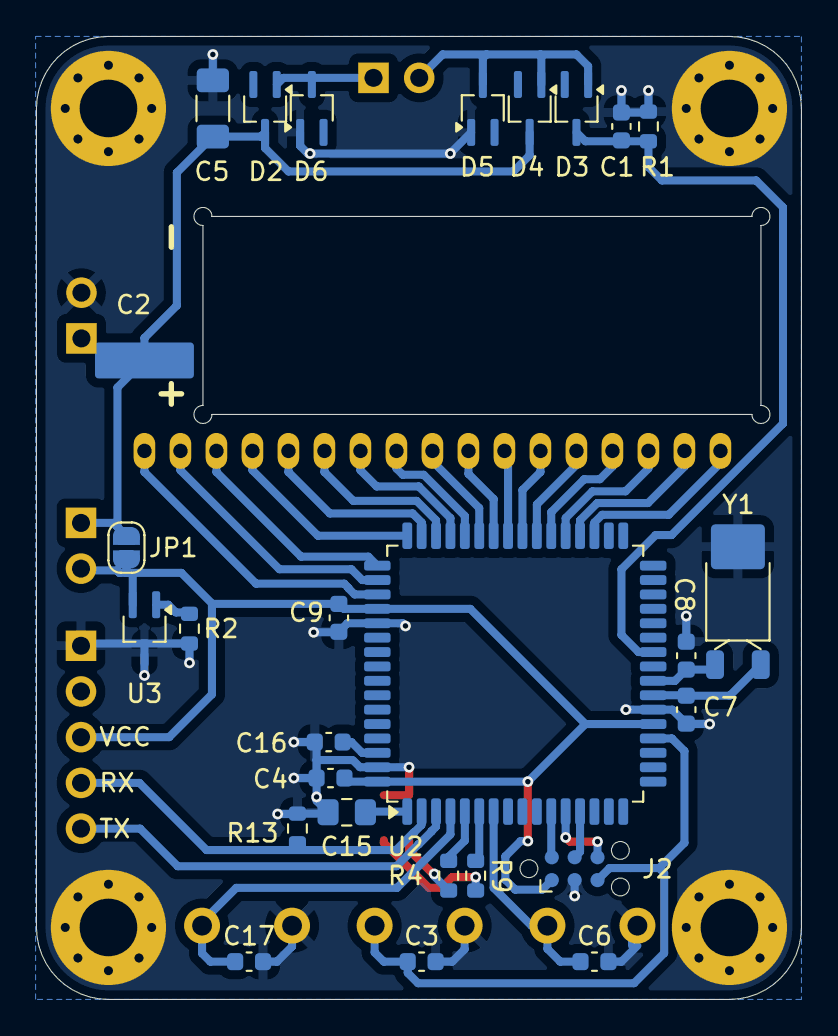
[picture p256: board bike_speed_sensor.kicad_pcb from below]

Board: 2 copper layers, 42.5 x 53.5 mm, 40 parts (27 on the bottom side), 40 nets.
