reivax-boucoi/PCB_Kicad/hv_discharge_v2c/hv_discharge_v2c.kicad_pcb

## KiCad design hv_discharge_v2c/hv_discharge_v2c.kicad_pcb (2025-07-24)

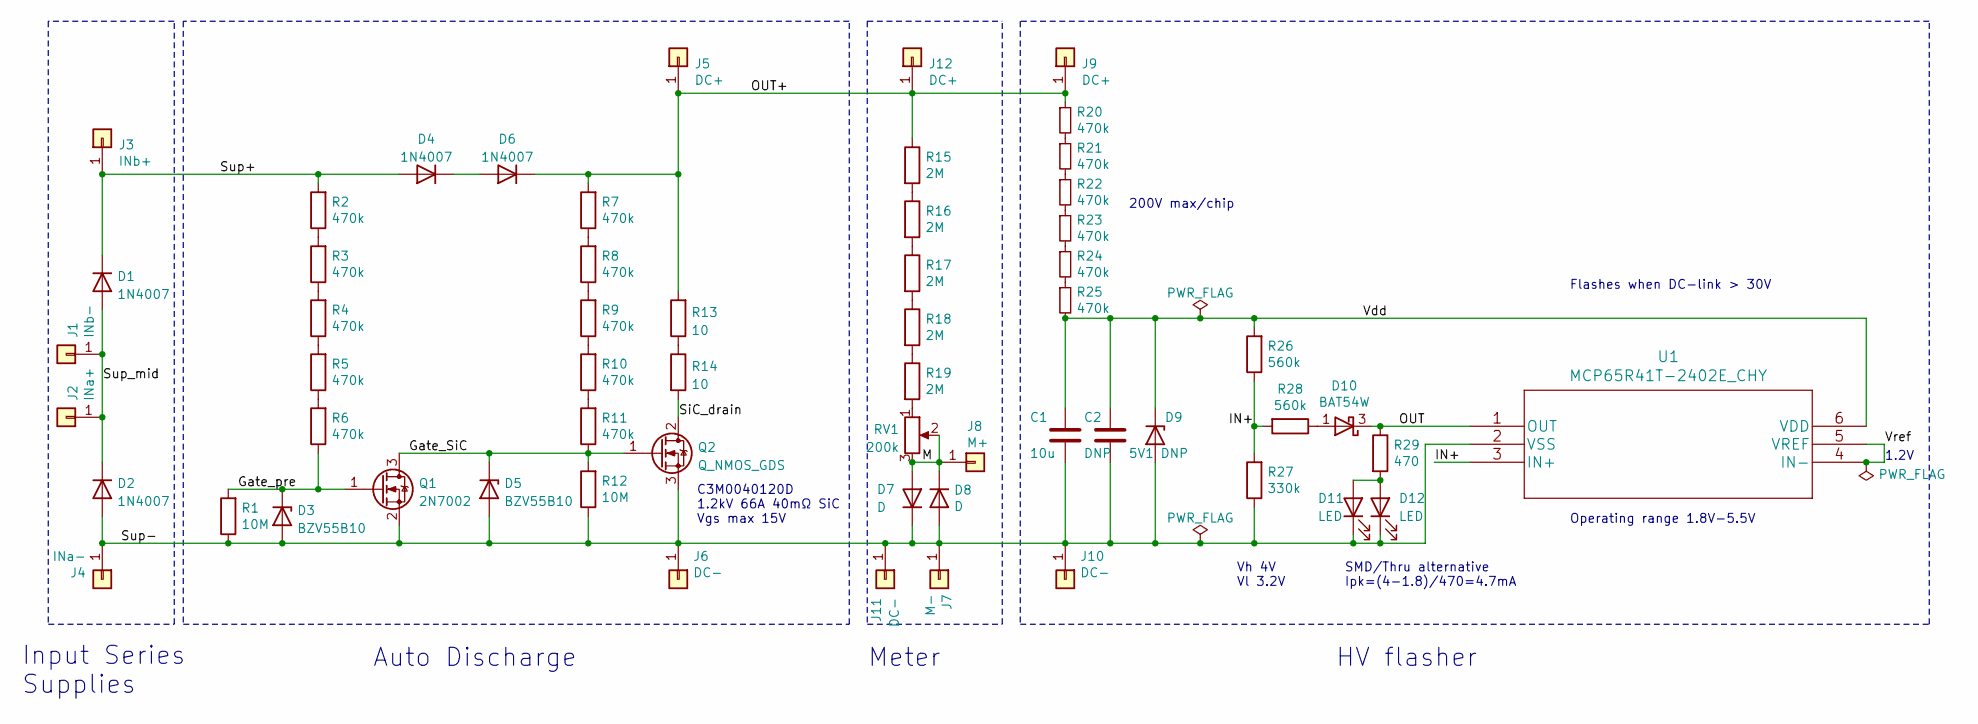
[picture p257: schematic hv_discharge_v2c.kicad_sch]

Parts:
C1: 10u; C_0805_2012Metric_Pad1.18x1.45mm_HandSolder
C2: DNP; C_0805_2012Metric_Pad1.18x1.45mm_HandSolder
D1, D2, D4, D6: 1N4007; D_DO-41_SOD81_P10.16mm_Horizontal
D3, D5: BZV55B10; D_MiniMELF
D7, D8: D; D_MiniMELF
D9: 5V1 DNP; D_MiniMELF
D10: BAT54W; SOT-23
D11: LED; LED_0805_2012Metric_Pad1.15x1.40mm_HandSolder
D12: LED; LED_D5.0mm
J1: INb-; TestPoint_THTPad_D2.5mm_Drill1.2mm
J2: INa+; TestPoint_THTPad_D2.5mm_Drill1.2mm
J3: INb+; TestPoint_THTPad_D2.5mm_Drill1.2mm
J4: INa-; TestPoint_THTPad_D2.5mm_Drill1.2mm
J5, J9, J12: DC+; TestPoint_THTPad_D2.5mm_Drill1.2mm
J6, J10, J11: DC-; TestPoint_THTPad_D2.5mm_Drill1.2mm
J7: M-; TestPoint_THTPad_D2.5mm_Drill1.2mm
J8: M+; TestPoint_THTPad_D2.5mm_Drill1.2mm
Q1: 2N7002; SOT-23
Q2: Q_NMOS_GDS; TO-247-3_Vertical
R1, R12: 10M; R_0805_2012Metric_Pad1.20x1.40mm_HandSolder
R2, R3, R4, R5, R6, R7, R8, R9, R10, R11, R20, R21, R22, R23, R24, R25: 470k; R_0805_2012Metric_Pad1.20x1.40mm_HandSolder
R13, R14: 10; THS2510RJ_special
R15, R16, R17, R18, R19: 2M; R_0805_2012Metric_Pad1.20x1.40mm_HandSolder
R26, R28: 560k; R_0805_2012Metric_Pad1.20x1.40mm_HandSolder
R27: 330k; R_0805_2012Metric_Pad1.20x1.40mm_HandSolder
R29: 470; R_0805_2012Metric_Pad1.20x1.40mm_HandSolder
RV1: 200k; Potentiometer_Bourns_3266Y_Vertical
U1: MCP65R41T-2402E_CHY; MCP65R41T-2402E

Connections:
/Gate_SiC: D5.1 (K), Q1.3 (D), Q2.1 (G), R11.1, R12.2
/Gate_pre: D3.1 (K), Q1.1 (G), R1.2, R6.1
/IN+: R26.1, R27.2, R28.2, U1.3 (IN+)
/M: D7.2 (A), D8.1 (K), J8.1, RV1.2, RV1.3
/OUT: D10.3 (K), R29.1, U1.1 (OUT)
/OUT+: D6.1 (K), J5.1, J9.1, J12.1, R7.2, R13.2, R15.1, R20.1
/SiC_drain: Q2.2 (D), R14.2
/Sup+: D1.1 (K), D4.2 (A), J3.1, R2.2
/Sup-: C1.2, C2.2, D2.2 (A), D3.2 (A), D5.2 (A), D7.1 (K), D8.2 (A), D9.2 (A), D11.1 (K), D12.1 (K), J4.1, J6.1, J7.1, J10.1, J11.1, Q1.2 (S), Q2.3 (S), R1.1, R12.1, R27.1, U1.2 (VSS)
/Sup_mid: D1.2 (A), D2.1 (K), J1.1, J2.1
/Vdd: C1.1, C2.1, D9.1 (K), R25.2, R26.2, U1.6 (VDD)
/Vref: U1.4 (IN-), U1.5 (VREF)
unnamed: D4.1 (K), D6.2 (A)
unnamed: D11.2 (A), D12.2 (A), R29.2
unnamed: R2.1, R3.2
unnamed: R3.1, R4.2
unnamed: R4.1, R5.2
unnamed: R5.1, R6.2
unnamed: R7.1, R8.2
unnamed: R8.1, R9.2
unnamed: R10.1, R11.2
unnamed: R9.1, R10.2
unnamed: R15.2, R16.1
unnamed: R16.2, R17.1
unnamed: R17.2, R18.1
unnamed: R18.2, R19.1
unnamed: R19.2, RV1.1
unnamed: R20.2, R21.1
unnamed: R21.2, R22.1
unnamed: R22.2, R23.1
unnamed: R23.2, R24.1
unnamed: R24.2, R25.1
unnamed: D10.1 (A), R28.1

Notes on the sheet:
Input Series Supplies
1.2V
Meter
Flashes when DC-link > 30V
SMD/Thru alternative Ipk=(4-1.8)/470=4.7mA
C3M0040120D 1.2kV 66A 40mΩ SiC Vgs max 15V
HV flasher
Auto Discharge
Operating range 1.8V-5.5V
Vh 4V Vl 3.2V
200V max/chip

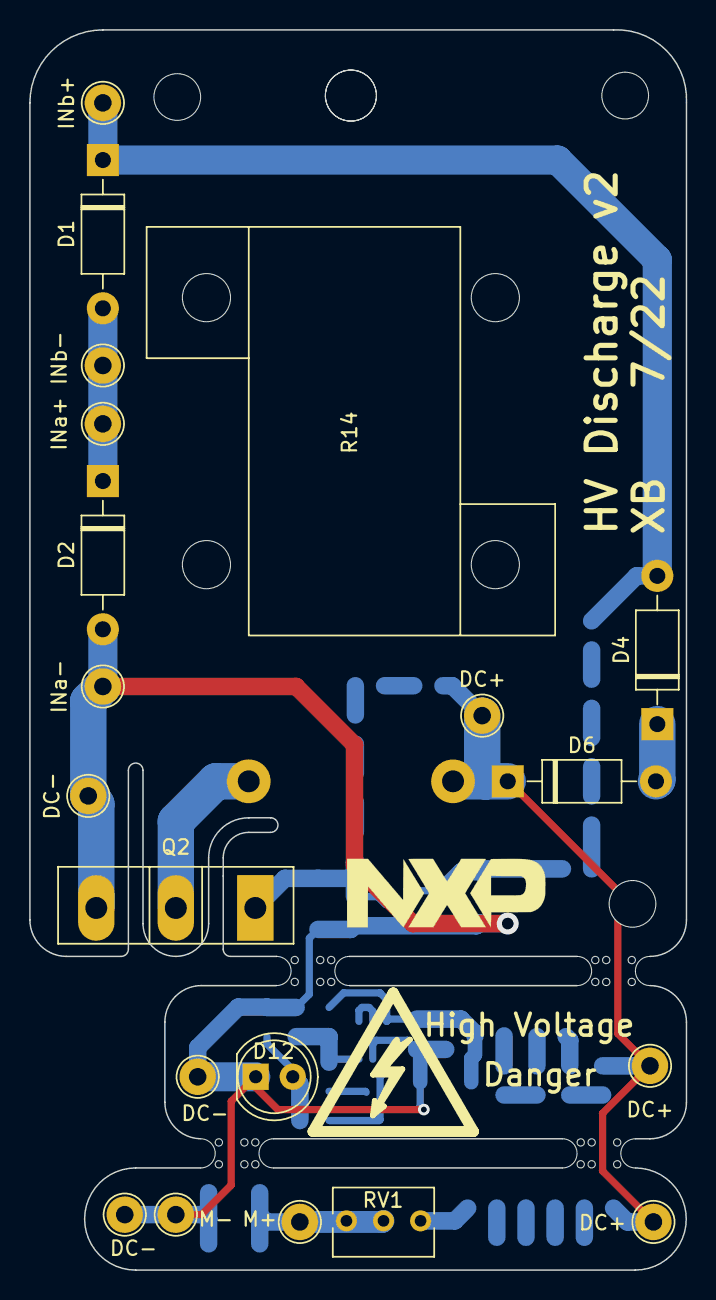
[picture p258: board hv_discharge_v2c.kicad_pcb from above]

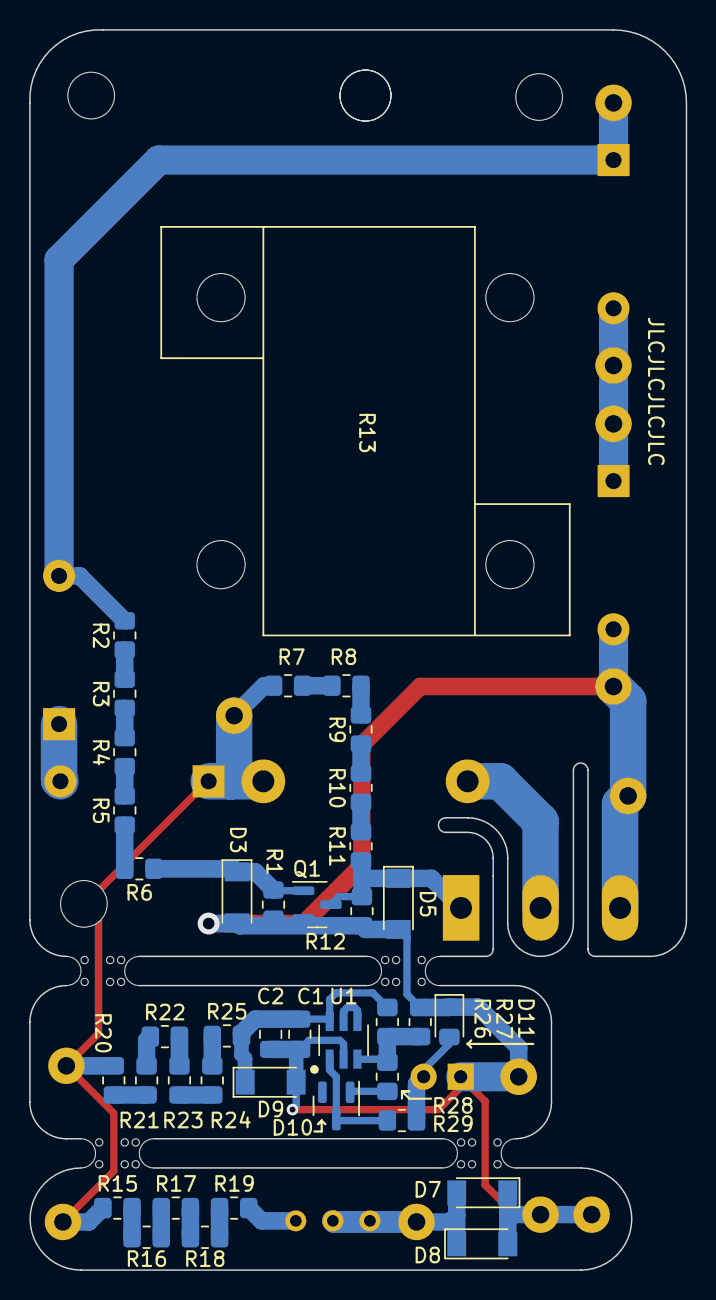
[picture p259: board hv_discharge_v2c.kicad_pcb from below]

Board: 2 copper layers, 45.0 x 85.0 mm, 63 parts (39 on the bottom side), 33 nets.

Other parts of the board:
mouse-bite-2mm-slot, mouse-bite-2mm-slot#2, mouse-bite-2mm-slot#3, mouse-bite-2mm-slot#4: VAL**; mouse-bite-2mm-slot
