reivax-boucoi/PCB_Kicad/HTOL_pulser/HTOL_pulser.kicad_pcb

## KiCad design HTOL_pulser/HTOL_pulser.kicad_pcb (2025-02-12)

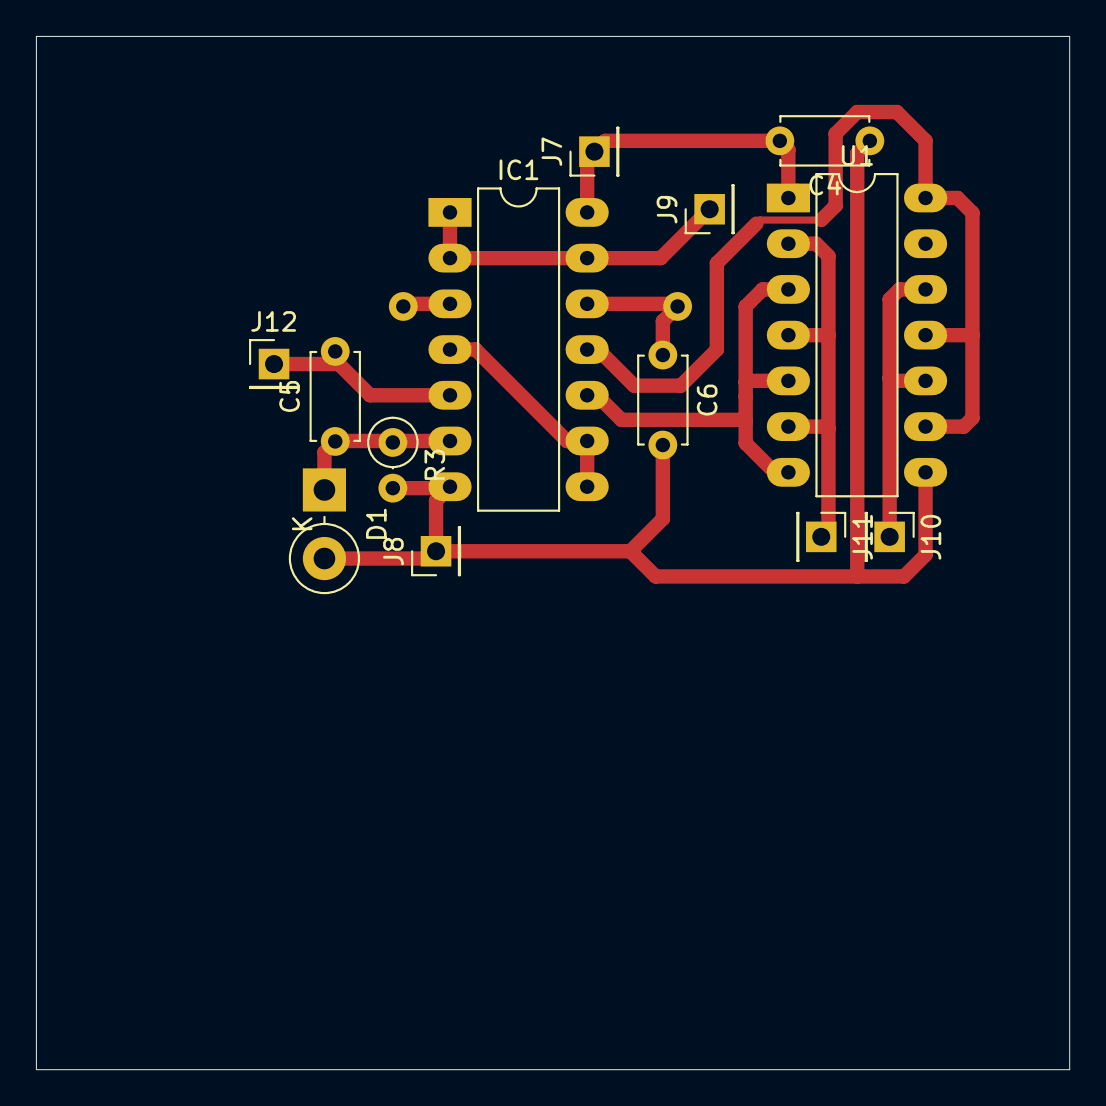
[picture p260: board HTOL_pulser.kicad_pcb from above]

Board: 2 copper layers, 57.4 x 57.4 mm, 14 parts (1 on the bottom side), 12 nets.

Parts:
C4: 100n; C_Disc_D4.7mm_W2.5mm_P5.00mm
C5, C6: 68p; C_Disc_D4.7mm_W2.5mm_P5.00mm
D1: D_Schottky; D_DO-15_P3.81mm_Vertical_KathodeUp
IC1: 4093D; DIP-14_W7.62mm_LongPads
J7: +5V; PinHeader_1x01_P2.54mm_Vertical
J8: GND; PinHeader_1x01_P2.54mm_Vertical
J9: IN_OFF; PinHeader_1x01_P2.54mm_Vertical
J10: OUT_OFF; PinHeader_1x01_P2.54mm_Vertical
J11: OUT_ON; PinHeader_1x01_P2.54mm_Vertical
J12: IN_ON; PinHeader_1x01_P2.54mm_Vertical
R3: 10k; R_Axial_DIN0207_L6.3mm_D2.5mm_P2.54mm_Vertical
R4: 10k; R_Axial_DIN0207_L6.3mm_D2.5mm_P15.24mm_Horizontal
U1: 4050; DIP-14_W7.62mm_LongPads

Connections:
+5V: C4.2, IC1.14 (VDD), J7.1, U1.1 (VCC)
GND: C4.1, C6.2, D1.2 (A), IC1.7 (VSS), J8.1, R3.2, U1.8 (VSS)
unnamed: C5.1, D1.1 (K), IC1.6 (I1), R3.1
unnamed: IC1.1 (I0), IC1.2 (I1), IC1.13 (I1), J9.1
unnamed: IC1.3 (O), R4.1
unnamed: C5.2, IC1.5 (I0), J12.1
unnamed: IC1.4 (O), IC1.8 (I0), IC1.9 (I1)
unnamed: IC1.10 (O), U1.3, U1.5, U1.7
unnamed: C6.1, IC1.12 (I0), R4.2
unnamed: IC1.11 (O), U1.9, U1.11, U1.14
unnamed: J10.1, U1.10, U1.12
unnamed: J11.1, U1.2, U1.4, U1.6
