reivax-boucoi/PCB_Kicad/MicroCurrent/MicroCurrent.kicad_pcb

## KiCad design MicroCurrent/MicroCurrent.kicad_pcb (2025-01-23)

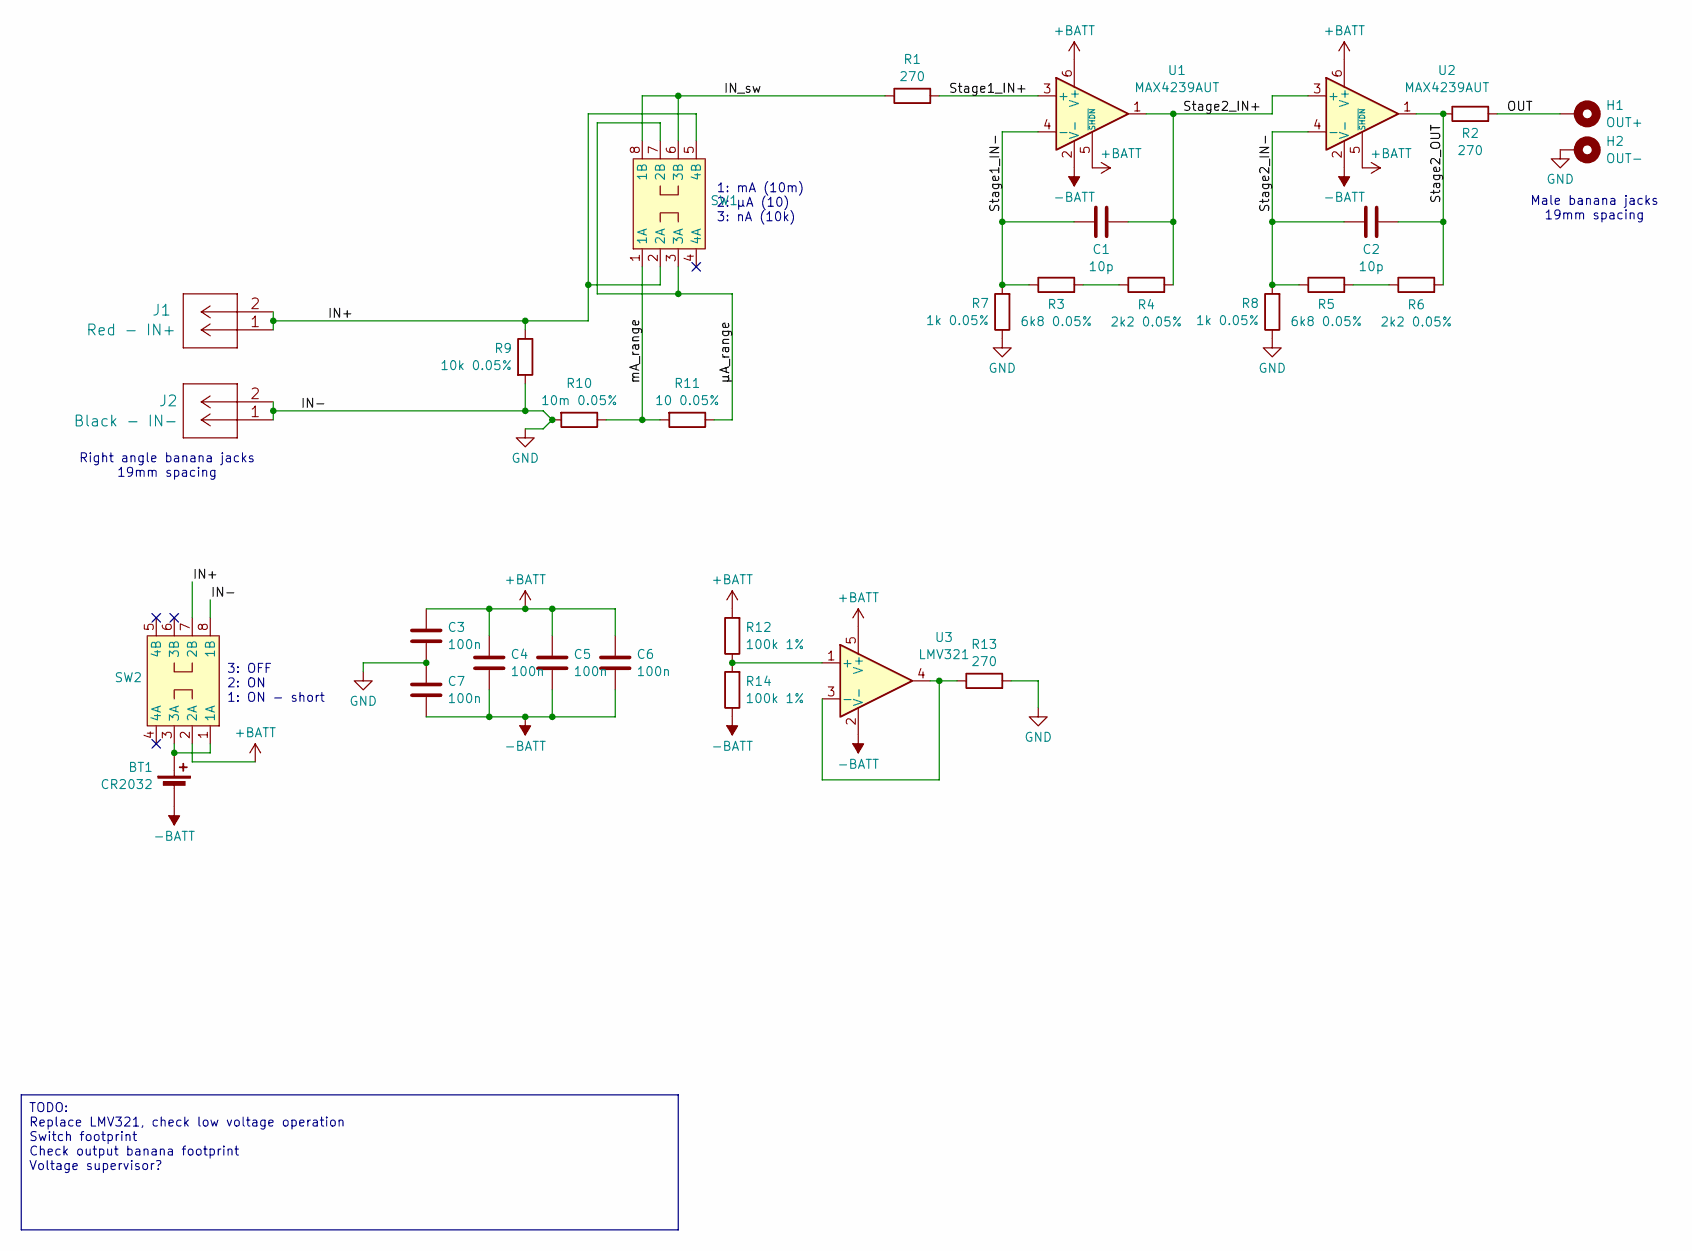
[picture p261: schematic MicroCurrent.kicad_sch, µCurrent]

Parts:
BT1: CR2032; BatteryHolder_Multicomp_BC-2001_1x2032
C1, C2: 10p; C_0603_1608Metric_Pad1.08x0.95mm_HandSolder
C3, C4, C5, C6, C7: 100n; C_0603_1608Metric_Pad1.08x0.95mm_HandSolder
H1: OUT+; MountingHole_4.3mm_M4_Pad_Via
H2: OUT-; MountingHole_4.3mm_M4_Pad_Via
J1: Red - IN+; 571-0100_Black
J2: Black - IN-; 571-0100_Black
R1, R2, R13: 270; R_0805_2012Metric_Pad1.20x1.40mm_HandSolder
R3, R5: 6k8 0.05%; R_0603_1608Metric_Pad0.98x0.95mm_HandSolder
R4, R6: 2k2 0.05%; R_0603_1608Metric_Pad0.98x0.95mm_HandSolder
R7, R8: 1k 0.05%; R_0603_1608Metric_Pad0.98x0.95mm_HandSolder
R9: 10k 0.05%; R_0603_1608Metric_Pad0.98x0.95mm_HandSolder
R10: 10m 0.05%; R_2512_6332Metric_Pad1.40x3.35mm_HandSolder
R11: 10 0.05%; R_0805_2012Metric_Pad1.20x1.40mm_HandSolder
R12, R14: 100k 1%; R_0603_1608Metric_Pad0.98x0.95mm_HandSolder
SW1, SW2: L203011MS02Q_3PDT_switch
U1, U2: MAX4239AUT; SOT-23-6
U3: LMV321; SOT-23-5_HandSoldering

Connections:
+BATT: C3.1, C4.1, C5.1, C6.1, R12.2, SW2.2 (2A), U1.5 (~SHDN), U1.6 (V+), U2.5 (~SHDN), U2.6 (V+), U3.5 (V+)
-BATT: BT1.2 (-), C4.2, C5.2, C6.2, C7.2, R14.1, U1.2 (V-), U2.2 (V-), U3.2 (V-)
/IN+: J1.1, J1.2, R9.1, SW1.2 (2A), SW1.5 (4B), SW2.7 (2B)
/IN_sw: R1.1, SW1.6 (3B), SW1.8 (1B)
/OUT: H1.1, R2.2
/Stage1_IN+: R1.2, U1.3 (+)
/Stage1_IN-: C1.1, R3.1, R7.2, U1.4 (-)
/Stage2_IN+: C1.2, R4.2, U1.1, U2.3 (+)
/Stage2_IN-: C2.1, R5.1, R8.2, U2.4 (-)
/Stage2_OUT: C2.2, R2.1, R6.2, U2.1
/mA_range: R10.1, R11.2, SW1.1 (1A)
/µA_range: R11.1, SW1.3 (3A), SW1.7 (2B)
GND: C3.2, C7.1, H2.1, J2.1, J2.2, R7.1, R8.1, R9.2, R10.2, R13.2, SW2.8 (1B)
unnamed: BT1.1 (+), SW2.1 (1A), SW2.3 (3A)
unnamed: R3.2, R4.1
unnamed: R5.2, R6.1
unnamed: R12.1, R14.2, U3.1 (+)
unnamed: R13.1, U3.3 (-), U3.4

Notes on the sheet:
TODO: Replace LMV321, check low voltage operation Switch footprint Check output banana footprint Voltage supervisor?
Right angle banana jacks 19mm spacing
3: OFF 2: ON 1: ON - short
1: mA (10m) 2: µA (10) 3: nA (10k)
Male banana jacks 19mm spacing

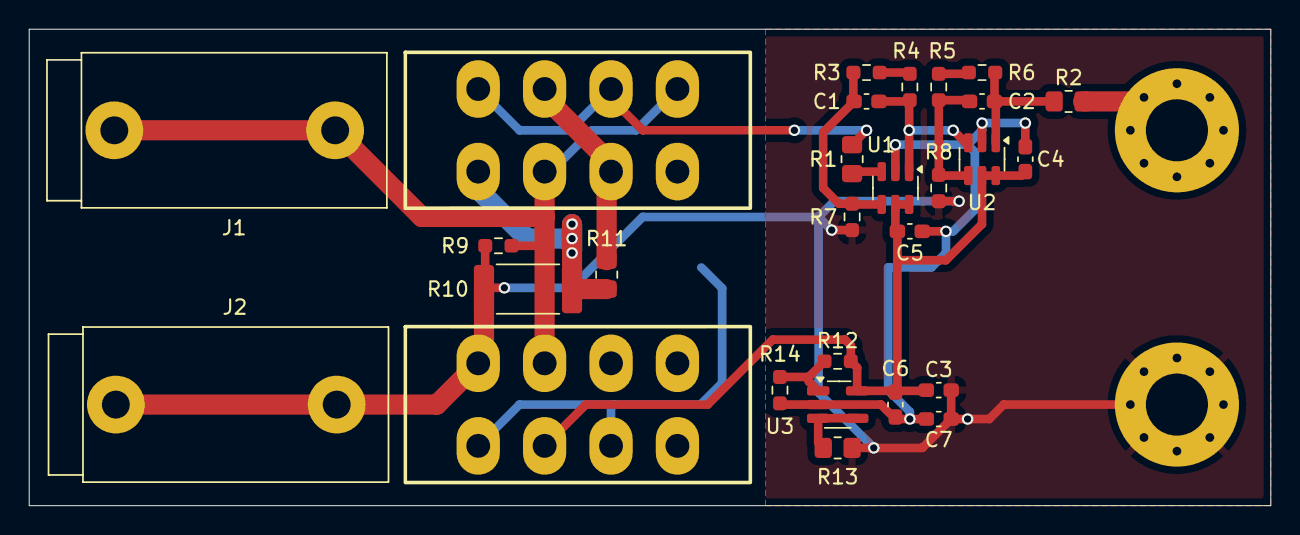
[picture p262: board MicroCurrent.kicad_pcb from above]

Board: 2 copper layers, 86.0 x 33.0 mm, 31 parts (1 on the bottom side), 18 nets.
