reivax-boucoi/PCB_Kicad/Planar_XFMR/Planar_XFMR.kicad_pcb

## KiCad design Planar_XFMR/Planar_XFMR.kicad_pcb (2024-10-03)

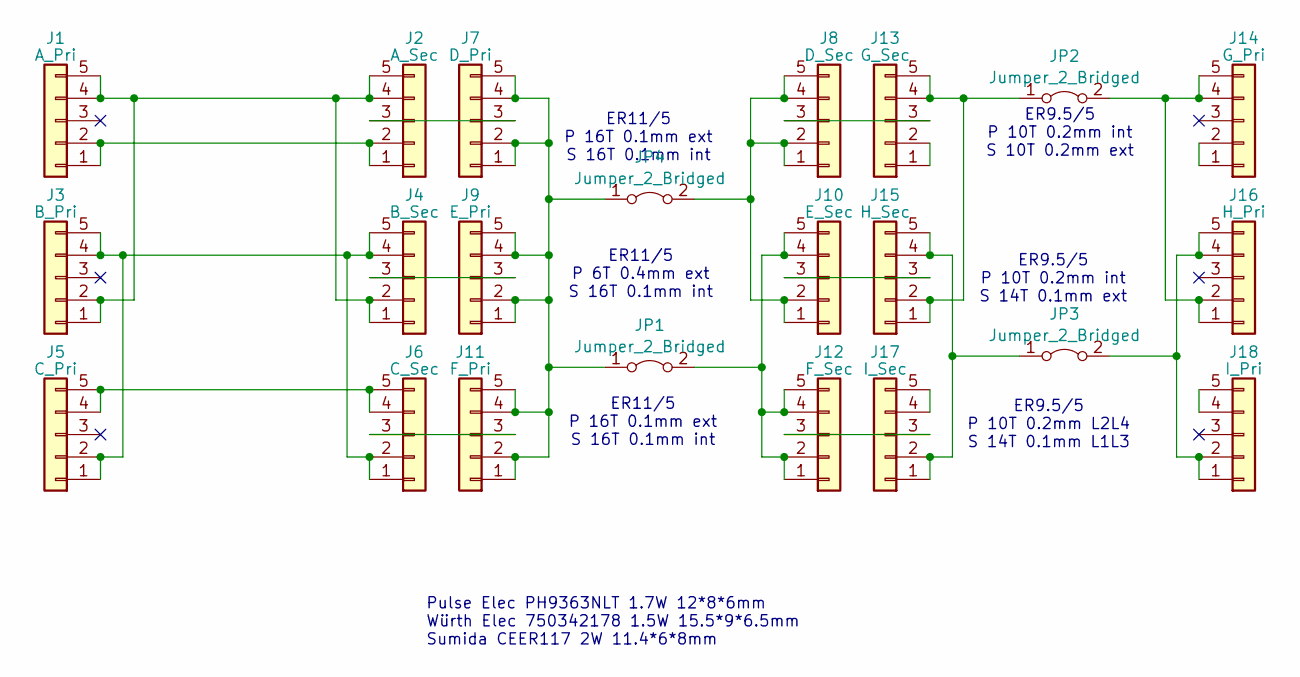
[picture p263: schematic Planar_XFMR.kicad_sch, Planar XFMR test coupon]

Parts:
J1: A_Pri; PinHeader_1x05_P2.54mm_Vertical
J2: A_Sec; PinHeader_1x05_P2.54mm_Vertical
J3: B_Pri; PinHeader_1x05_P2.54mm_Vertical
J4: B_Sec; PinHeader_1x05_P2.54mm_Vertical
J5: C_Pri; PinHeader_1x05_P2.54mm_Vertical
J6: C_Sec; PinHeader_1x05_P2.54mm_Vertical
J7: D_Pri; PinHeader_1x05_P2.54mm_Vertical
J8: D_Sec; PinHeader_1x05_P2.54mm_Vertical
J9: E_Pri; PinHeader_1x05_P2.54mm_Vertical
J10: E_Sec; PinHeader_1x05_P2.54mm_Vertical
J11: F_Pri; PinHeader_1x05_P2.54mm_Vertical
J12: F_Sec; PinHeader_1x05_P2.54mm_Vertical
J13: G_Sec; PinHeader_1x05_P2.54mm_Vertical
J14: G_Pri; PinHeader_1x05_P2.54mm_Vertical
J15: H_Sec; PinHeader_1x05_P2.54mm_Vertical
J16: H_Pri; PinHeader_1x05_P2.54mm_Vertical
J17: I_Sec; PinHeader_1x05_P2.54mm_Vertical
J18: I_Pri; PinHeader_1x05_P2.54mm_Vertical
JP1, JP2, JP3, JP4: Jumper_2_Bridged; SolderJumper-2_P1.3mm_Bridged_RoundedPad1.0x1.5mm

Connections:
unnamed: J1.1, J1.2, J2.1, J2.2
unnamed: J1.4, J1.5, J2.4, J2.5, J3.1, J3.2, J4.1, J4.2
unnamed: J2.3, J7.3
unnamed: J3.4, J3.5, J4.4, J4.5, J5.1, J5.2, J6.1, J6.2
unnamed: J4.3, J9.3
unnamed: J5.4, J5.5, J6.4, J6.5
unnamed: J8.1, J8.2, J8.4, J8.5, J10.1, J10.2, JP4.2 (B)
unnamed: J10.3, J15.3
unnamed: J10.4, J10.5, J12.1, J12.2, J12.4, J12.5, JP1.2 (B)
unnamed: J7.1, J7.2, J7.4, J7.5, J9.1, J9.2, J9.4, J9.5, J11.1, J11.2, J11.4, J11.5, JP1.1 (A), JP4.1 (A)
unnamed: J6.3, J11.3
unnamed: J12.3, J17.3
unnamed: J13.1, J13.2
unnamed: J8.3, J13.3
unnamed: J13.4, J13.5, J15.1, J15.2, JP2.1 (A)
unnamed: J14.1, J14.2
unnamed: J14.4, J14.5, J16.1, J16.2, JP2.2 (B)
unnamed: J15.4, J15.5, J17.1, J17.2, JP3.1 (A)
unnamed: J16.4, J16.5, J18.1, J18.2, JP3.2 (B)
unnamed: J17.4, J17.5
unnamed: J18.4, J18.5

Notes on the sheet:
ER9.5/5 P 10T 0.2mm L2L4 S 14T 0.1mm L1L3
ER11/5 P 6T 0.4mm ext S 16T 0.1mm int
ER9.5/5 P 10T 0.2mm int S 14T 0.1mm ext
Pulse Elec PH9363NLT 1.7W 12*8*6mm Würth Elec 750342178 1.5W 15.5*9*6.5mm Sumida CEER117 2W 11.4*6*8mm
ER9.5/5 P 10T 0.2mm int S 10T 0.2mm ext
ER11/5 P 16T 0.1mm ext S 16T 0.1mm int

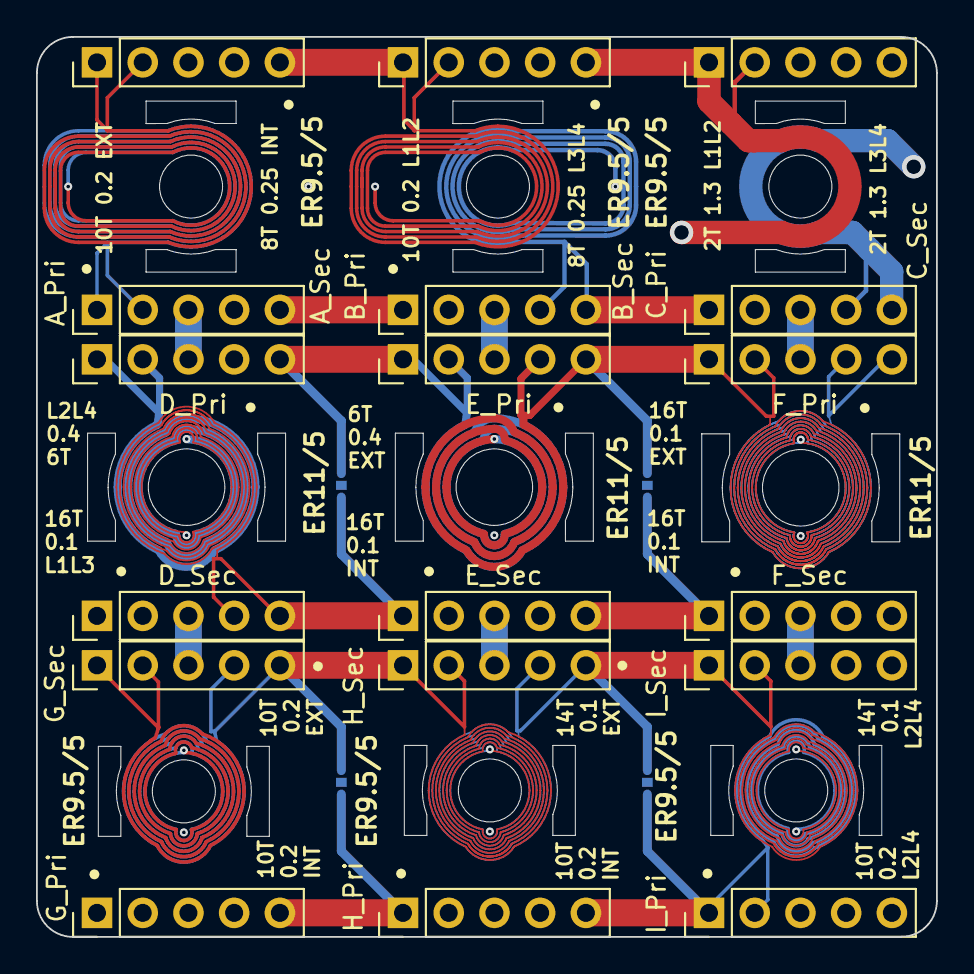
[picture p264: board Planar_XFMR.kicad_pcb from above]

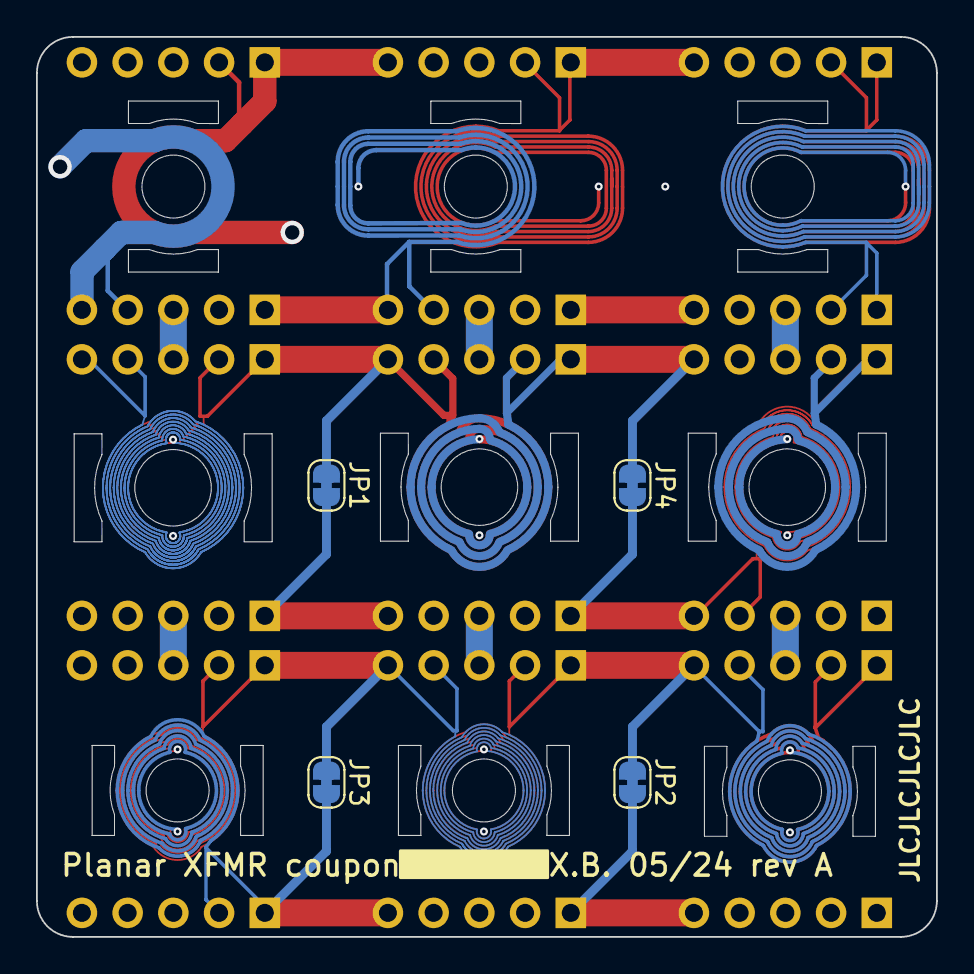
[picture p265: board Planar_XFMR.kicad_pcb from below]

Board: 4 copper layers, 50.0 x 50.0 mm, 22 parts (4 on the bottom side), 21 nets.
