reivax-boucoi/PCB_Kicad/elevator_altimeter/elevator_altimeter.kicad_pcb

## KiCad design elevator_altimeter/elevator_altimeter.kicad_pcb (2024-09-22)

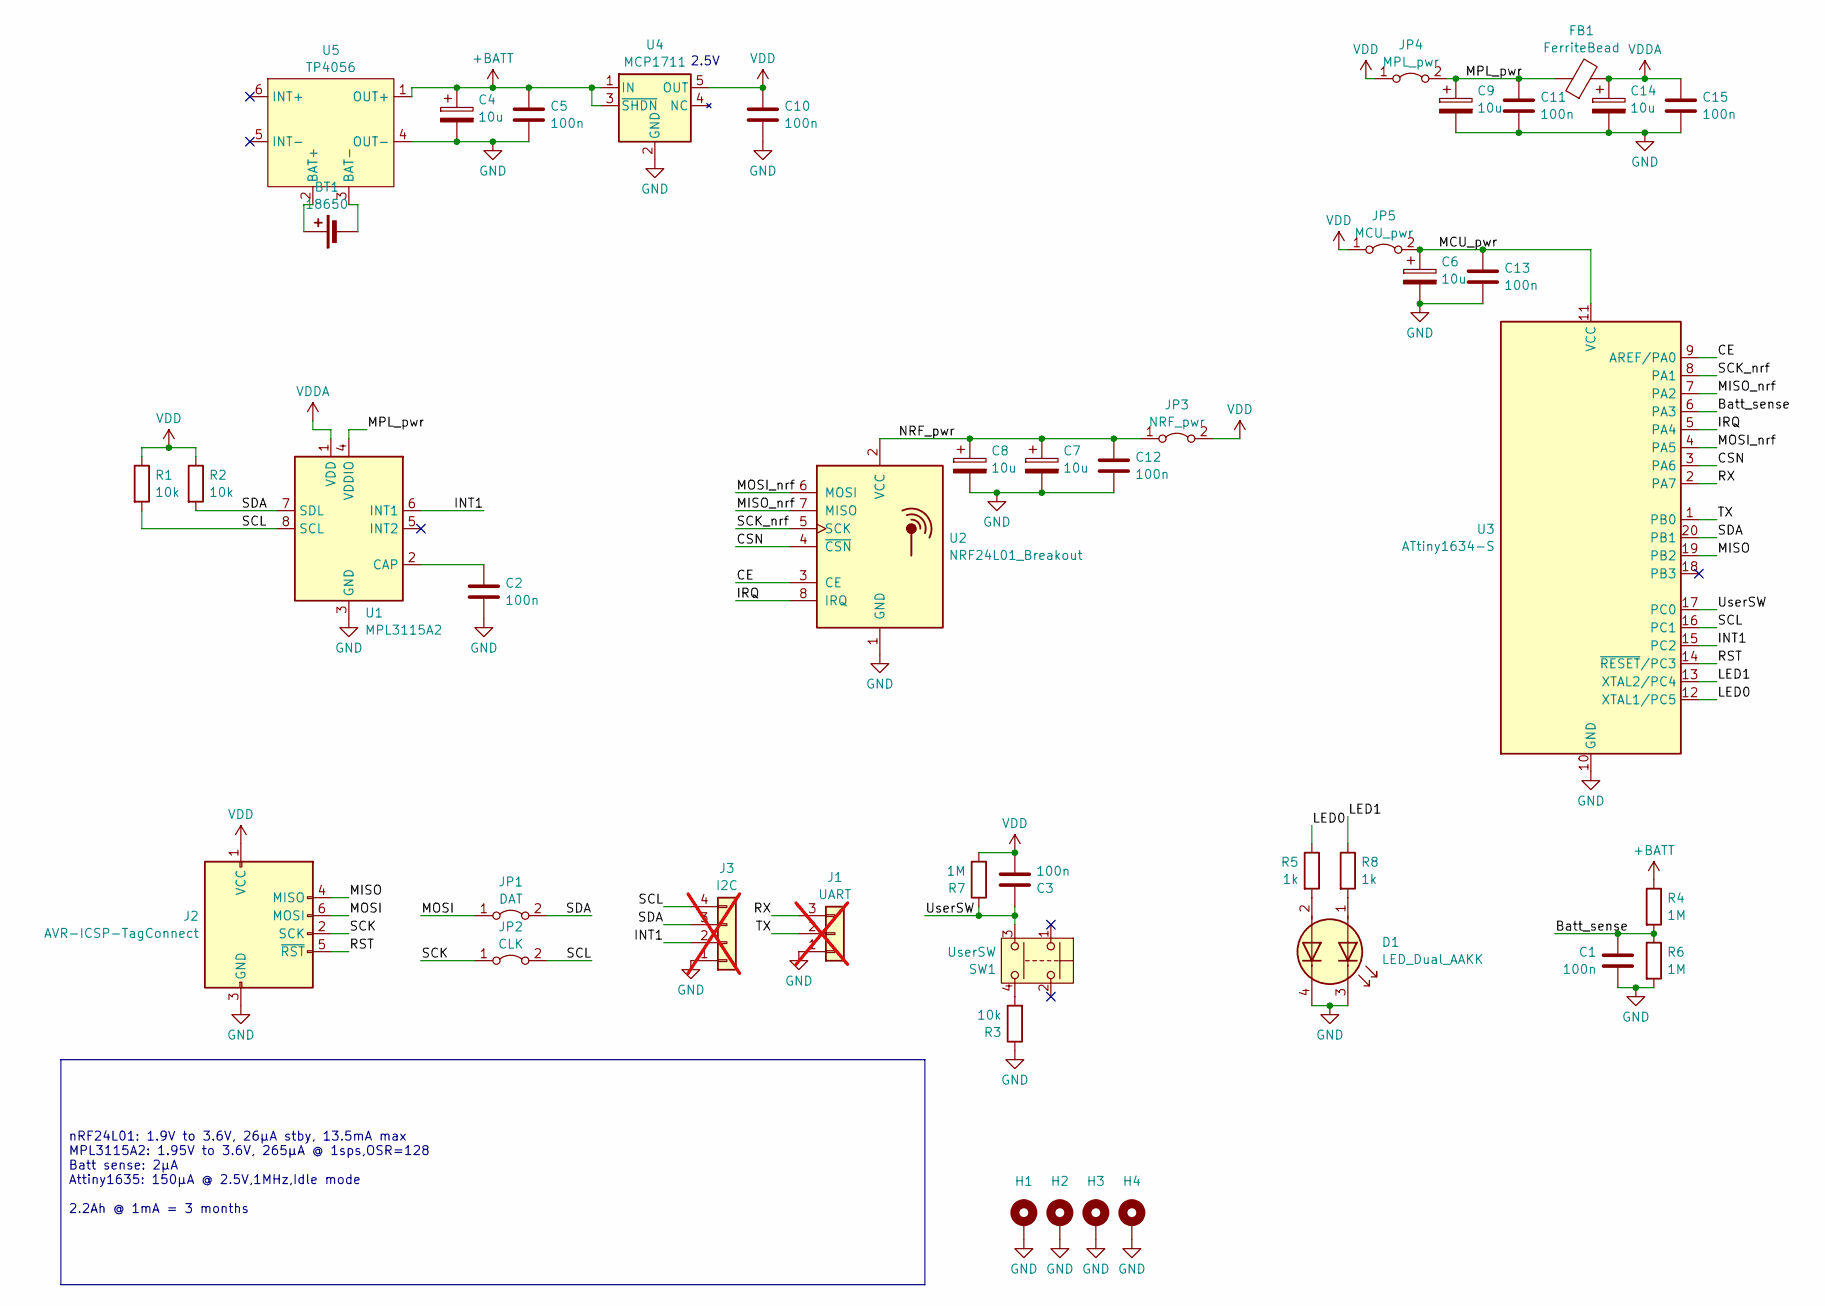
[picture p266: schematic elevator_altimeter.kicad_sch, Elevator altimeter]

Parts:
BT1: 18650; BatteryHolder_Keystone_1042_1x18650
C1, C2, C3, C5, C10, C11, C12, C13, C15: 100n; C_0603_1608Metric_Pad1.08x0.95mm_HandSolder
C4, C6, C7, C8, C9, C14: 10u; C_0805_2012Metric_Pad1.18x1.45mm_HandSolder
D1: LED_Dual_AAKK; LED_Cree-PLCC4_3.2x2.8mm_CCW
FB1: FerriteBead; L_0805_2012Metric_Pad1.05x1.20mm_HandSolder
H1, H2, H3, H4: MountingHole_3.2mm_M3_Pad_Via
J1: UART; PinHeader_1x03_P2.54mm_Vertical; not fitted
J2: AVR-ICSP-TagConnect; Tag-Connect_TC2030-IDC-NL_2x03_P1.27mm_Vertical
J3: I2C; PinHeader_1x04_P2.54mm_Vertical; not fitted
JP1: DAT; SolderJumper-2_P1.3mm_Bridged_RoundedPad1.0x1.5mm
JP2: CLK; SolderJumper-2_P1.3mm_Bridged_RoundedPad1.0x1.5mm
JP3: NRF_pwr; SolderJumper-2_P1.3mm_Bridged_RoundedPad1.0x1.5mm
JP4: MPL_pwr; SolderJumper-2_P1.3mm_Bridged_RoundedPad1.0x1.5mm
JP5: MCU_pwr; SolderJumper-2_P1.3mm_Bridged_RoundedPad1.0x1.5mm
R1, R2, R3: 10k; R_0603_1608Metric_Pad0.98x0.95mm_HandSolder
R4, R6, R7: 1M; R_0603_1608Metric_Pad0.98x0.95mm_HandSolder
R5, R8: 1k; R_0603_1608Metric_Pad0.98x0.95mm_HandSolder
SW1: UserSW; Push_E-Switch_KS01Q01
U1: MPL3115A2; NXP_LGA-8_3x5mm_P1.25mm_H1.1mm
U2: NRF24L01_Breakout; nRF24L01_Breakout
U3: ATtiny1634-S; SOIC-20W_7.5x12.8mm_P1.27mm
U4: MCP1711; SOT-23-5
U5: TP4056; TP4056_USB-C_module

Connections:
+BATT: C4.1, C5.1, R4.1, U4.1 (IN), U4.3 (~SHDN), U5.1 (OUT+)
/Batt_sense: C1.1, R4.2, R6.1, U3.6 (PA3)
/CE: U2.3 (CE), U3.9 (AREF/PA0)
/CSN: U2.4 (~CSN), U3.3 (PA6)
/INT1: J3.2, U1.6 (INT1), U3.15 (PC2)
/IRQ: U2.8 (IRQ), U3.5 (PA4)
/LED0: R5.1, U3.12 (XTAL1/PC5)
/LED1: R8.1, U3.13 (XTAL2/PC4)
/MCU_pwr: C6.1, C13.1, JP5.2 (B), U3.11 (VCC)
/MISO: J2.4 (MISO), U3.19 (PB2)
/MISO_nrf: U2.7 (MISO), U3.7 (PA2)
/MOSI: J2.6 (MOSI), JP1.1 (A)
/MOSI_nrf: U2.6 (MOSI), U3.4 (PA5)
/MPL_pwr: C9.1, C11.1, FB1.1, JP4.2 (B), U1.4 (VDDIO)
/NRF_pwr: C7.1, C8.1, C12.1, JP3.1 (A), U2.2 (VCC)
/RST: J2.5 (~RST), U3.14 (~RESET/PC3)
/RX: J1.3, U3.2 (PA7)
/SCK: J2.2 (SCK), JP2.1 (A)
/SCK_nrf: U2.5 (SCK), U3.8 (PA1)
/SCL: J3.4, JP2.2 (B), R1.2, U1.8 (SCL), U3.16 (PC1)
/SDA: J3.3, JP1.2 (B), R2.2, U1.7 (SDL), U3.20 (PB1)
/TX: J1.2, U3.1 (PB0)
/UserSW: C3.1, R7.1, SW1.3, U3.17 (PC0)
GND: C1.2, C2.2, C4.2, C5.2, C6.2, C7.2, C8.2, C9.2, C10.2, C11.2, C12.2, C13.2, C14.2, C15.2, D1.3 (K1), D1.4 (K2), H1.1, H2.1, H3.1, H4.1, J1.1, J2.3 (GND), J3.1, R3.1, R6.2, U1.3 (GND), U2.1 (GND), U3.10 (GND), U4.2 (GND), U5.4 (OUT-)
unnamed: BT1.1 (+), U5.2 (BAT+)
unnamed: BT1.2 (-), U5.3 (BAT-)
unnamed: D1.1 (A1), R8.2
unnamed: D1.2 (A2), R5.2
unnamed: R3.2, SW1.4
unnamed: C2.1, U1.2 (CAP)
VDD: C3.2, C10.1, J2.1 (VCC), JP3.2 (B), JP4.1 (A), JP5.1 (A), R1.1, R2.1, R7.2, U4.5 (OUT)
VDDA: C14.1, C15.1, FB1.2, U1.1 (VDD)

Notes on the sheet:
nRF24L01: 1.9V to 3.6V, 26µA stby, 13.5mA max MPL3115A2: 1.95V to 3.6V, 265µA @ 1sps,OSR=128 Batt sense: 2µA Attiny1635: 150µA @ 2.5V,1MHz,Idle mode 2.2Ah @ 1mA = 3 months
2.5V

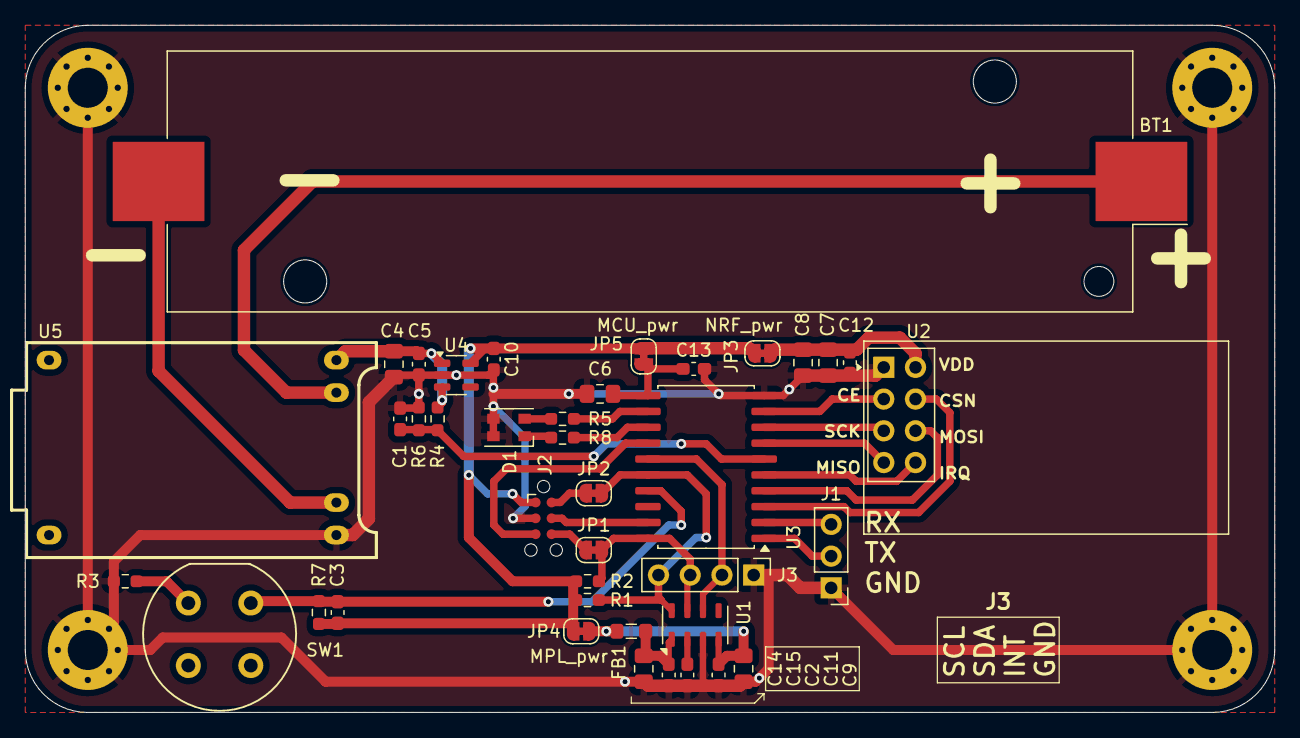
[picture p267: board elevator_altimeter.kicad_pcb from above]

Board: 2 copper layers, 100.0 x 55.0 mm, 44 parts (0 on the bottom side), 32 nets.
