reivax-boucoi/PCB_Kicad/elevator_altimeter/receiver/receiver.kicad_pcb

## KiCad design elevator_altimeter/receiver/receiver.kicad_pcb (2024-08-04)

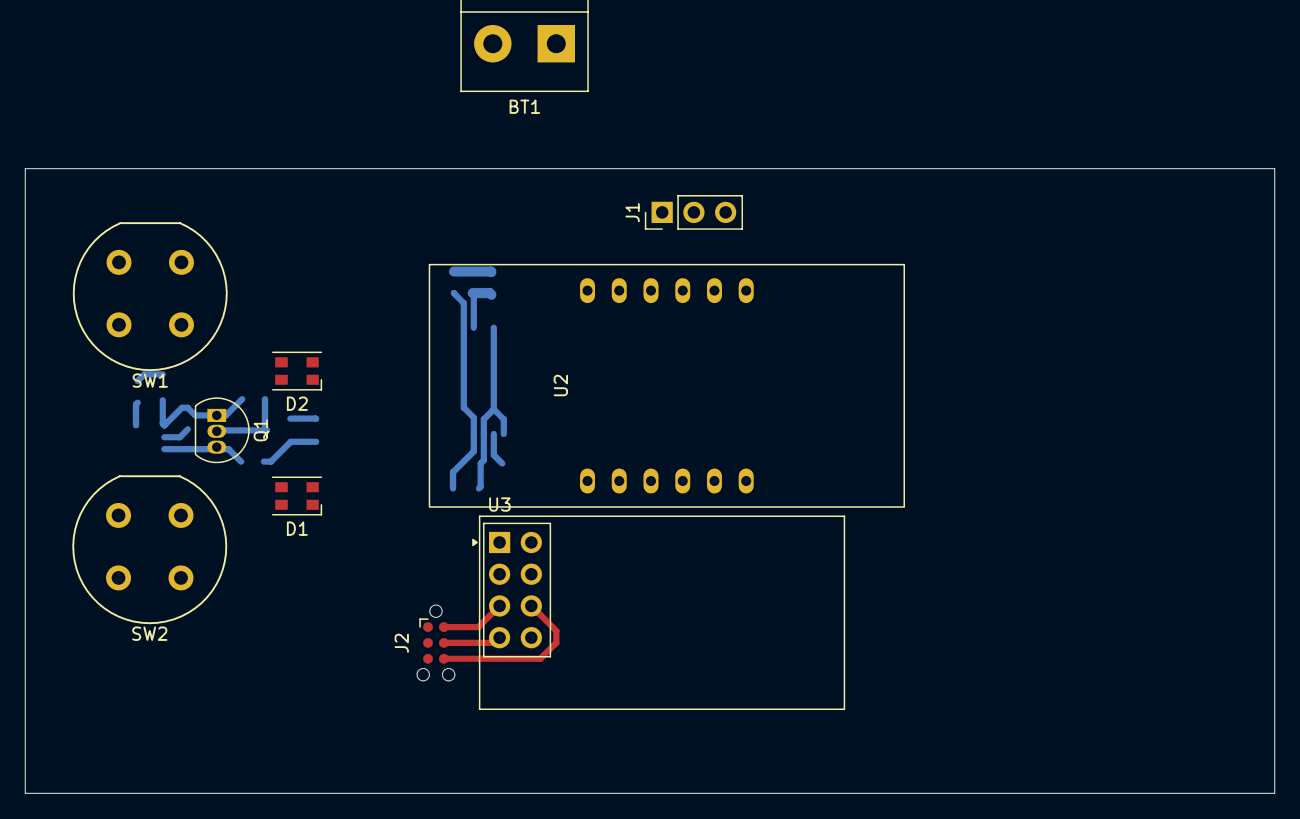
[picture p268: board receiver.kicad_pcb from above]

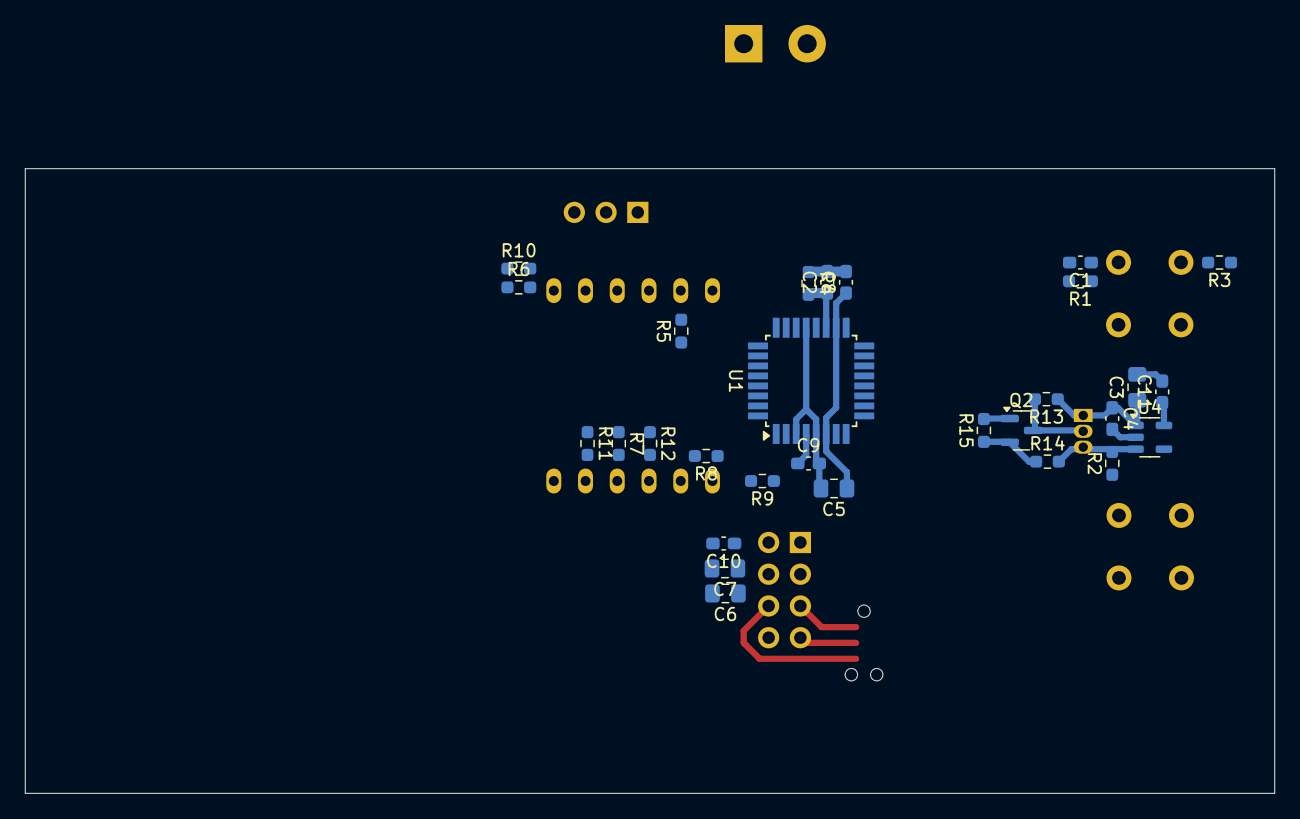
[picture p269: board receiver.kicad_pcb from below]

Board: 2 copper layers, 100.0 x 50.0 mm, 39 parts (29 on the bottom side), 36 nets.

Parts:
BT1: 18650; TerminalBlock_bornier-2_P5.08mm
C1, C2, C4, C8, C9, C10, C11: 100n; C_0603_1608Metric_Pad1.08x0.95mm_HandSolder
C3, C5, C6, C7: 10u; C_0805_2012Metric_Pad1.18x1.45mm_HandSolder
D1, D2: LED_Dual_AAKK; LED_Cree-PLCC4_3.2x2.8mm_CCW
J1: UART; PinHeader_1x03_P2.54mm_Vertical
J2: AVR-ICSP-TagConnect; Tag-Connect_TC2030-IDC-NL_2x03_P1.27mm_Vertical
Q1: TP0606; TO-92L_Inline
Q2: 2N7002; SOT-23
R1: 1M; R_0603_1608Metric_Pad0.98x0.95mm_HandSolder
R2, R3, R4, R13, R14, R15: 39k; R_0603_1608Metric_Pad0.98x0.95mm_HandSolder
R5, R6, R7, R8, R9, R10, R11, R12: 470; R_0603_1608Metric_Pad0.98x0.95mm_HandSolder
SW1: UserSW; Push_E-Switch_KS01Q01
SW2: PWR_SW; Push_E-Switch_KS01Q01
U1: ATmega8-16A; TQFP-32_7x7mm_P0.8mm
U2: 5631AH-S_3digit_7segment_display
U3: NRF24L01_Breakout; nRF24L01_Breakout
U4: MCP1711; SOT-23-5

Connections:
+BATT: BT1.1 (+), C3.1, C4.1, Q1.1 (S), R13.1, U4.1 (IN)
/A: R5.1, U1.11 (PD7)
/B: R6.1, U1.10 (PD6)
/Batt_en: Q1.3 (D), R2.2, R14.2, U4.3 (~SHDN)
/Batt_sense: C2.1, R2.1, R4.2, U1.19 (ADC6)
/C: R7.1, U1.9 (PD5)
/CE: U1.13 (PB1), U3.3 (CE)
/CSN: U1.12 (PB0), U3.4 (~CSN)
/D: R8.1, U1.2 (PD4)
/DIG1: U1.25 (PC2), U2.12 (CC1)
/DIG2: U1.26 (PC3), U2.9 (CC2)
/DIG3: U1.27 (PC4), U2.8 (CC3)
/DIG4: D1.3 (K1), D1.4 (K2), D2.3 (K1), D2.4 (K2), U1.28 (PC5)
/DP: R12.1, U1.30 (PD0)
/E: R9.1, U1.1 (PD3)
/F: R10.1, U1.32 (PD2)
/G: R11.1, U1.31 (PD1)
/IRQ: U1.14 (PB2), U3.8 (IRQ)
/MISO: J2.4 (MISO), U1.16 (PB4), U3.7 (MISO)
/MOSI: J2.6 (MOSI), U1.15 (PB3), U3.6 (MOSI)
/PWR_EN: Q2.1 (G), R15.2, U1.23 (PC0)
/RST: J2.5 (~RST), U1.29 (PC6/~RESET)
/SCK: J2.2 (SCK), U1.17 (PB5), U3.5 (SCK)
/UserSW: C1.1, R1.1, SW1.3, U1.24 (PC1)
GND: BT1.2 (-), C2.2, C3.2, C4.2, C5.2, C6.2, C7.2, C8.2, C9.2, C10.2, C11.2, J1.1, J2.3 (GND), Q2.2 (S), R3.1, R4.1, R14.1, R15.1, SW2.2, U1.3 (GND), U1.5 (GND), U1.21 (AGND), U3.1 (GND), U4.2 (GND)
unnamed: D1.1 (A1), R10.2, U2.10 (f)
unnamed: D1.2 (A2), R9.2, U2.1 (e)
unnamed: D2.1 (A1), R12.2, U2.3 (DPX)
unnamed: D2.2 (A2), R11.2, U2.5 (g)
unnamed: Q1.2 (G), Q2.3 (D), R13.2, SW2.1
unnamed: R3.2, SW1.4
unnamed: R5.2, U2.11 (a)
unnamed: R6.2, U2.7 (b)
unnamed: R7.2, U2.4 (c)
unnamed: R8.2, U2.2 (d)
VDD: C1.2, C5.1, C6.1, C7.1, C8.1, C9.1, C10.1, C11.1, J2.1 (VCC), R1.2, U1.4 (VCC), U1.6 (VCC), U1.18 (AVCC), U3.2 (VCC), U4.5 (OUT)
