reivax-boucoi/PCB_Kicad/usb_switch/usb_switch.kicad_pcb

## KiCad design usb_switch/usb_switch.kicad_pcb (2024-07-31)

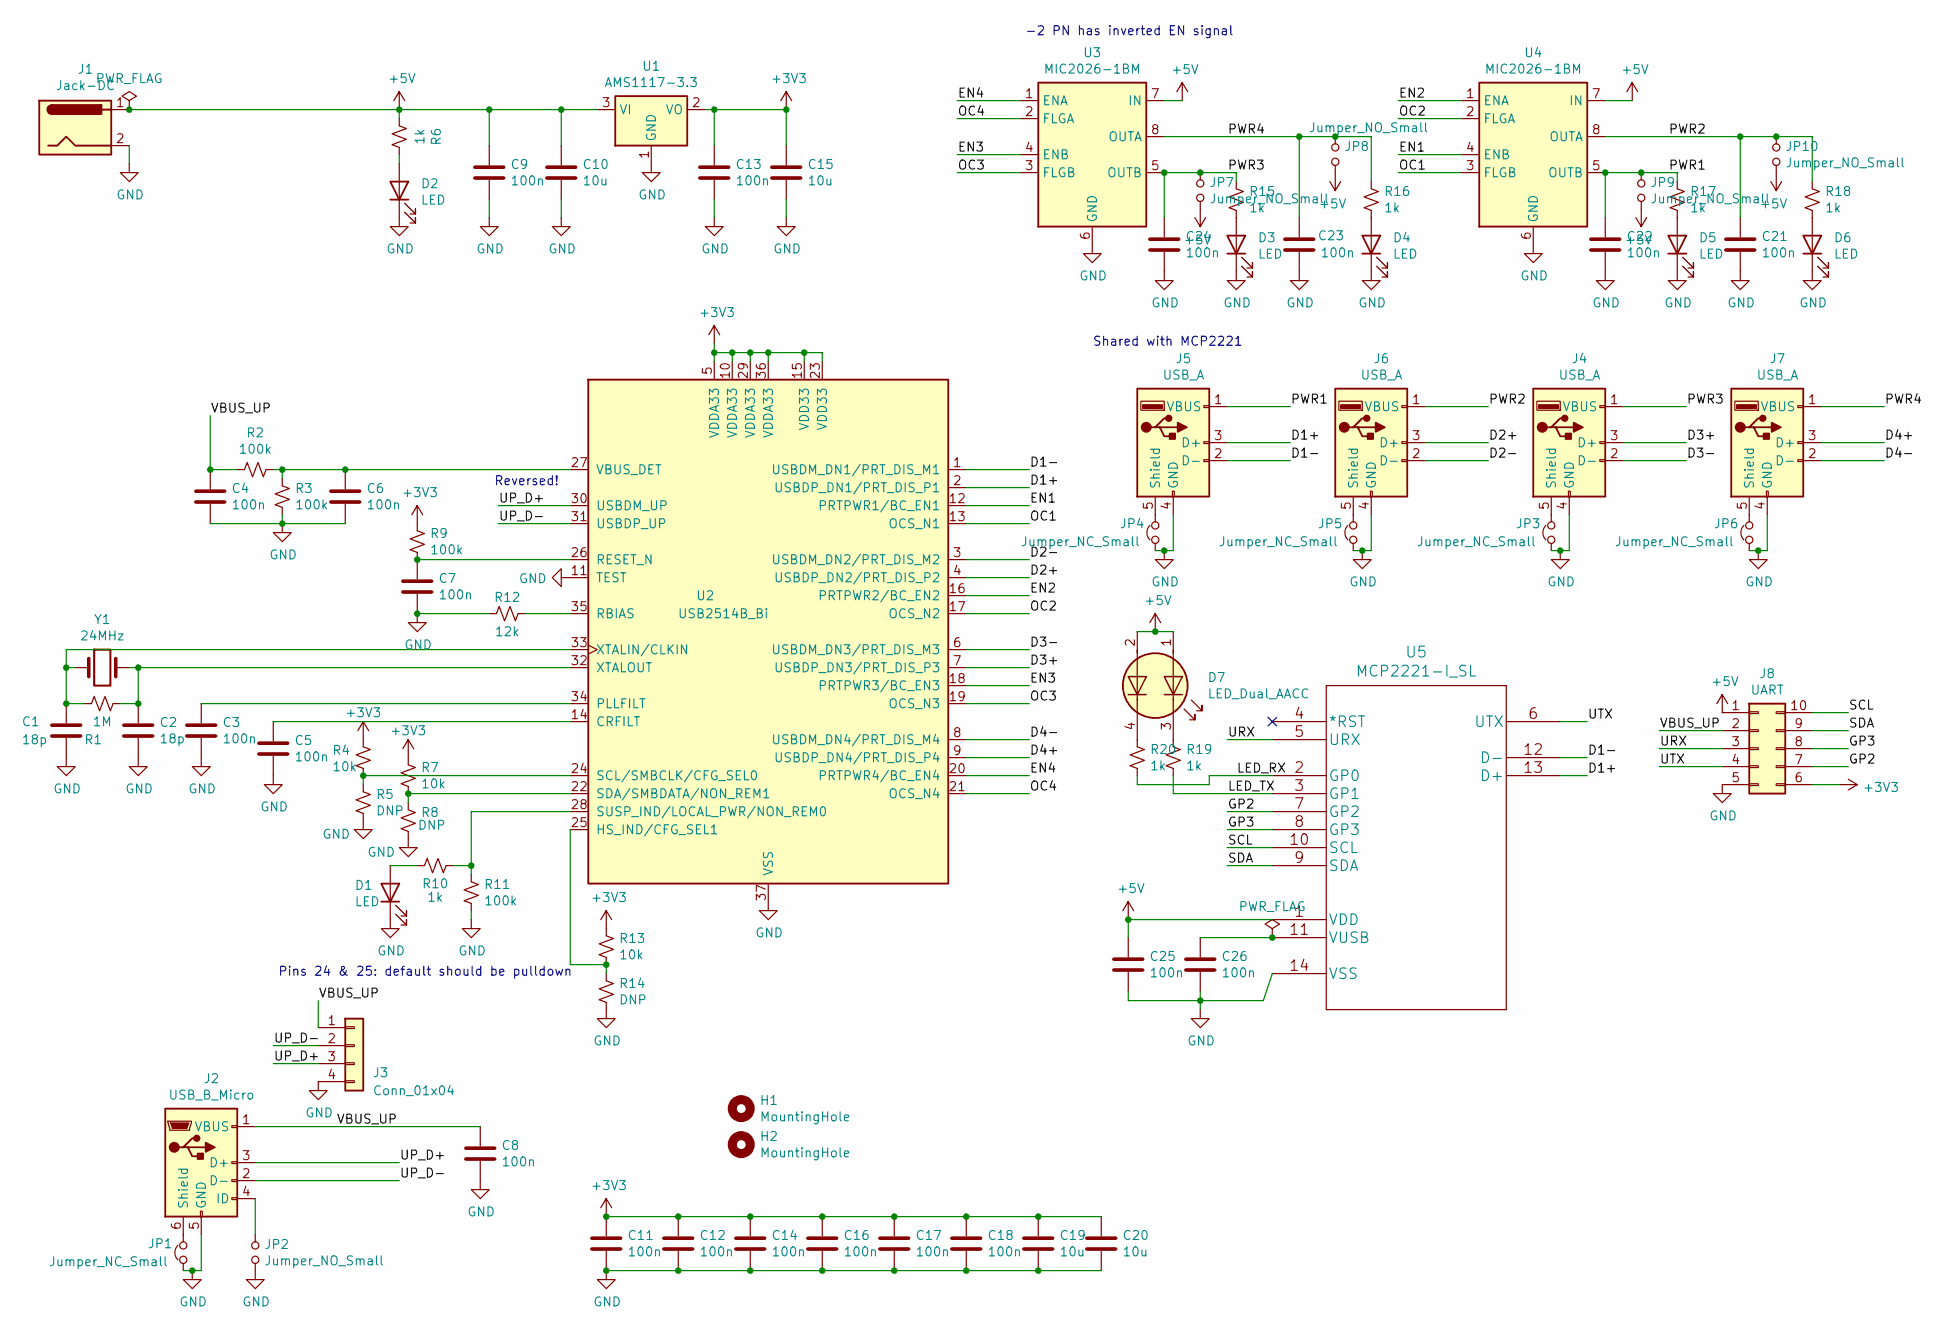
[picture p270: schematic usb_switch.kicad_sch]

Parts:
C1, C2: 18p; C_0603_1608Metric_Pad1.05x0.95mm_HandSolder
C3, C4, C5, C6, C7, C8, C9, C11, C12, C13, C14, C16, C17, C18, C21, C22, C23, C24, C25, C26: 100n; C_0603_1608Metric_Pad1.05x0.95mm_HandSolder
C10, C15, C19, C20: 10u; C_0603_1608Metric_Pad1.05x0.95mm_HandSolder
D1, D2, D3, D4, D5, D6: LED; LED_0603_1608Metric_Pad1.05x0.95mm_HandSolder
D7: LED_Dual_AACC; LED_SK6812_EC15_1.5x1.5mm
H1, H2: MountingHole; MountingHole_2.2mm_M2
J1: Jack-DC; BarrelJack_Wuerth_6941xx301002
J2: USB_B_Micro; USB_Micro-B_Molex_47346-0001
J3: Conn_01x04; PinSocket_1x04_P2.54mm_Vertical
J4, J5, J6, J7: USB_A; USB_A_Stewart_SS-52100-001_Horizontal
J8: UART; PinSocket_2x05_P2.54mm_Horizontal
JP1, JP3, JP4, JP5, JP6: Jumper_NC_Small; SolderJumper-2_P1.3mm_Bridged_RoundedPad1.0x1.5mm
JP2, JP7, JP8, JP9, JP10: Jumper_NO_Small; SolderJumper-2_P1.3mm_Open_RoundedPad1.0x1.5mm
R1: 1M; R_0603_1608Metric_Pad1.05x0.95mm_HandSolder
R2, R3, R9, R11: 100k; R_0603_1608Metric_Pad1.05x0.95mm_HandSolder
R4, R7, R13: 10k; R_0603_1608Metric_Pad1.05x0.95mm_HandSolder
R5, R8, R14: DNP; R_0603_1608Metric_Pad1.05x0.95mm_HandSolder
R6, R10, R15, R16, R17, R18, R20: 1k; R_0603_1608Metric_Pad1.05x0.95mm_HandSolder
R12: 12k; R_0603_1608Metric_Pad1.05x0.95mm_HandSolder
R19: 1k; R_0603_1608Metric
U1: AMS1117-3.3; SOT-223-3_TabPin2
U2: USB2514B_Bi; QFN-36-1EP_6x6mm_P0.5mm_EP3.7x3.7mm
U3, U4: MIC2026-1BM; SOIC-8_3.9x4.9mm_P1.27mm
U5: MCP2221-I_SL
Y1: 24MHz; Crystal_SMD_HC49-SD

Connections:
+3V3: C11.1, C12.1, C13.1, C14.1, C15.1, C16.1, C17.1, C18.1, C19.1, C20.1, J8.6, R4.1, R7.1, R9.1, R13.1, U1.2 (VO), U2.5 (VDDA33), U2.10 (VDDA33), U2.15 (VDD33), U2.23 (VDD33), U2.29 (VDDA33), U2.36 (VDDA33)
+5V: C9.1, C10.1, C25.1, D7.1 (A1), D7.2 (A2), J1.1, J8.1, JP7.2, JP8.2, JP9.2, JP10.2, R6.1, U1.3 (VI), U3.7 (IN), U4.7 (IN), U5.1 (VDD)
/D1+: J5.3 (D+), U2.2 (USBDP_DN1/PRT_DIS_P1), U5.13 (D+)
/D1-: J5.2 (D-), U2.1 (USBDM_DN1/PRT_DIS_M1), U5.12 (D-)
/D2+: J6.3 (D+), U2.4 (USBDP_DN2/PRT_DIS_P2)
/D2-: J6.2 (D-), U2.3 (USBDM_DN2/PRT_DIS_M2)
/D3+: J4.3 (D+), U2.7 (USBDP_DN3/PRT_DIS_P3)
/D3-: J4.2 (D-), U2.6 (USBDM_DN3/PRT_DIS_M3)
/D4+: J7.3 (D+), U2.9 (USBDP_DN4/PRT_DIS_P4)
/D4-: J7.2 (D-), U2.8 (USBDM_DN4/PRT_DIS_M4)
/EN1: U2.12 (PRTPWR1/BC_EN1), U4.4 (ENB)
/EN2: U2.16 (PRTPWR2/BC_EN2), U4.1 (ENA)
/EN3: U2.18 (PRTPWR3/BC_EN3), U3.4 (ENB)
/EN4: U2.20 (PRTPWR4/BC_EN4), U3.1 (ENA)
/GP2: J8.7, U5.7 (GP2)
/GP3: J8.8, U5.8 (GP3)
/LED_RX: R20.2, U5.2 (GP0)
/LED_TX: R19.2, U5.3 (GP1)
/OC1: U2.13 (OCS_N1), U4.3 (FLGB)
/OC2: U2.17 (OCS_N2), U4.2 (FLGA)
/OC3: U2.19 (OCS_N3), U3.3 (FLGB)
/OC4: U2.21 (OCS_N4), U3.2 (FLGA)
/PWR1: C22.1, J5.1 (VBUS), JP9.1, R17.1, U4.5 (OUTB)
/PWR2: C21.1, J6.1 (VBUS), JP10.1, R18.1, U4.8 (OUTA)
/PWR3: C24.1, J4.1 (VBUS), JP7.1, R15.1, U3.5 (OUTB)
/PWR4: C23.1, J7.1 (VBUS), JP8.1, R16.1, U3.8 (OUTA)
/SCL: J8.10, U5.10 (SCL)
/SDA: J8.9, U5.9 (SDA)
/UP_D+: J2.3 (D+), J3.3, U2.30 (USBDM_UP)
/UP_D-: J2.2 (D-), J3.2, U2.31 (USBDP_UP)
/URX: J8.3, U5.5 (URX)
/UTX: J8.4, U5.6 (UTX)
/VBUS_UP: C4.1, C8.1, J2.1 (VBUS), J3.1, J8.2, R2.2
GND: C1.2, C2.2, C3.2, C4.2, C5.2, C6.2, C7.2, C8.2, C9.2, C10.2, C11.2, C12.2, C13.2, C14.2, C15.2, C16.2, C17.2, C18.2, C19.2, C20.2, C21.2, C22.2, C23.2, C24.2, C25.2, C26.2, D1.1 (K), D2.1 (K), D3.1 (K), D4.1 (K), D5.1 (K), D6.1 (K), J1.2, J2.5 (GND), J3.4, J4.4 (GND), J5.4 (GND), J6.4 (GND), J7.4 (GND), J8.5, JP1.1, JP2.2, JP3.1, JP4.1, JP5.1, JP6.1, R3.2, R5.2, R8.2, R11.2, R12.2, R14.2, U1.1 (GND), U2.11 (TEST), U2.37 (VSS), U3.6 (GND), U4.6 (GND), U5.14 (VSS)
unnamed: C1.1, R1.1, U2.33 (XTALIN/CLKIN), Y1.1
unnamed: C2.1, R1.2, U2.32 (XTALOUT), Y1.2
unnamed: C3.1, U2.34 (PLLFILT)
unnamed: C5.1, U2.14 (CRFILT)
unnamed: C6.1, R2.1, R3.1, U2.27 (VBUS_DET)
unnamed: C7.1, R9.2, U2.26 (RESET_N)
unnamed: C26.1, U5.11 (VUSB)
unnamed: D1.2 (A), R10.1
unnamed: D2.2 (A), R6.2
unnamed: D3.2 (A), R15.2
unnamed: D4.2 (A), R16.2
unnamed: D5.2 (A), R17.2
unnamed: D6.2 (A), R18.2
unnamed: D7.3 (K1), R19.1
unnamed: D7.4 (K2), R20.1
unnamed: J2.4 (ID), JP2.1
unnamed: J2.6 (Shield), JP1.2
unnamed: J4.5 (Shield), JP3.2
unnamed: J5.5 (Shield), JP4.2
unnamed: J6.5 (Shield), JP5.2
unnamed: J7.5 (Shield), JP6.2
unnamed: R4.2, R5.1, U2.24 (SCL/SMBCLK/CFG_SEL0)
unnamed: R7.2, R8.1, U2.22 (SDA/SMBDATA/NON_REM1)
unnamed: R10.2, R11.1, U2.28 (SUSP_IND/LOCAL_PWR/NON_REM0)
unnamed: R12.1, U2.35 (RBIAS)
unnamed: R13.2, R14.1, U2.25 (HS_IND/CFG_SEL1)

Notes on the sheet:
Shared with MCP2221
Reversed!
Pins 24 & 25: default should be pulldown
-2 PN has inverted EN signal

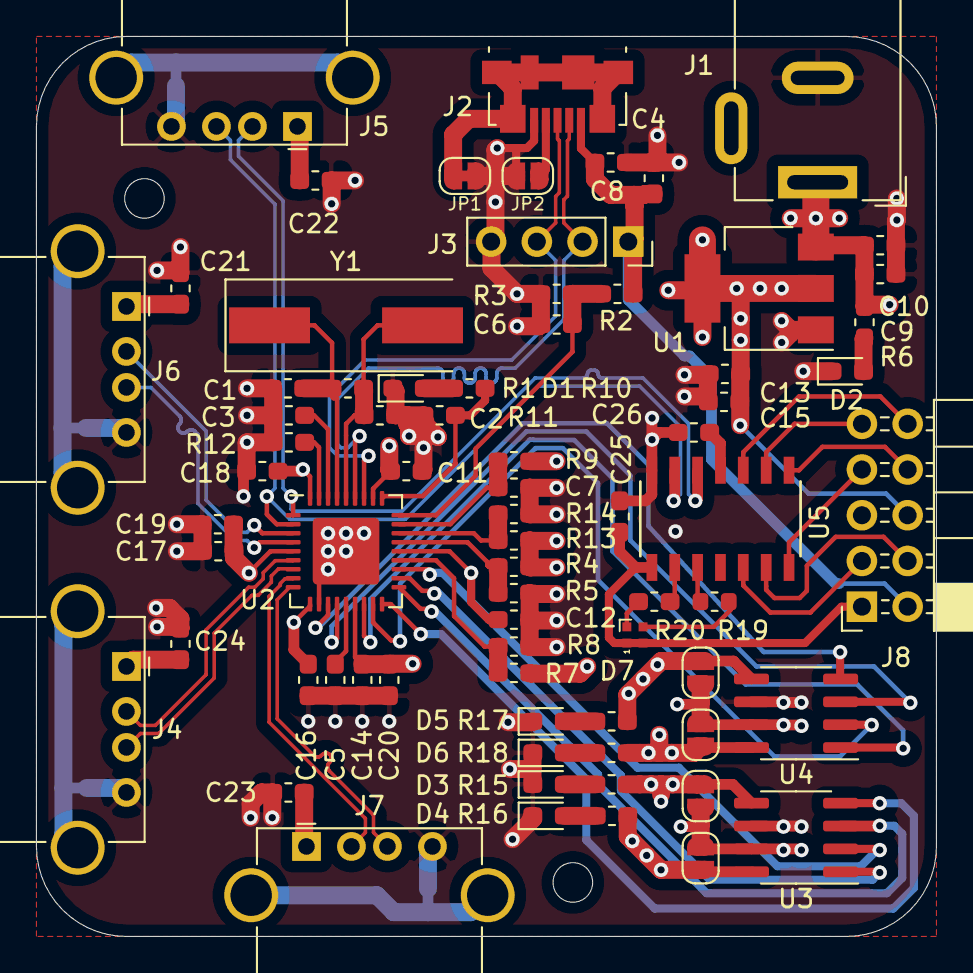
[picture p271: board usb_switch.kicad_pcb from above]

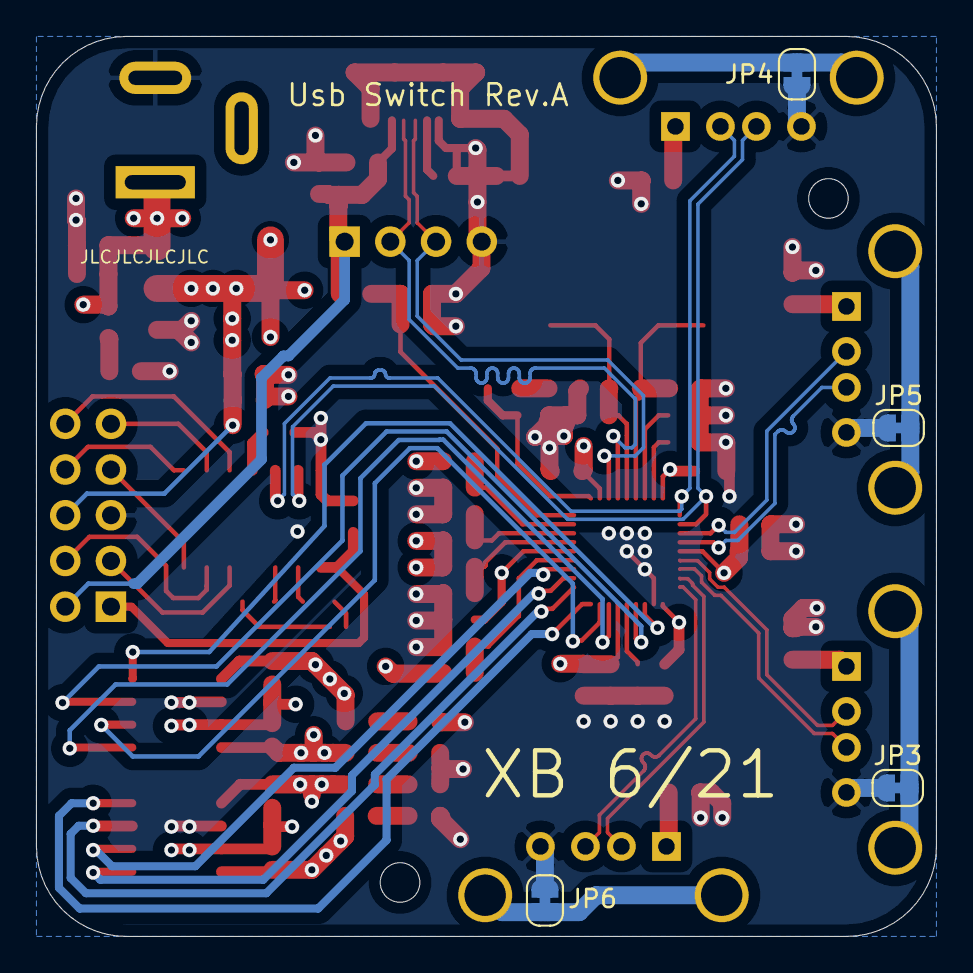
[picture p272: board usb_switch.kicad_pcb from below]

Board: 4 copper layers, 50.0 x 50.0 mm, 79 parts (4 on the bottom side), 60 nets.
