reivax-boucoi/PCB_Kicad/hall_sensor_matrix/hall_sensor_matrix_v2/hall_sensor_matrix_v2.kicad_pcb

## KiCad design hall_sensor_matrix/hall_sensor_matrix_v2/hall_sensor_matrix_v2.kicad_pcb (2024-07-31)

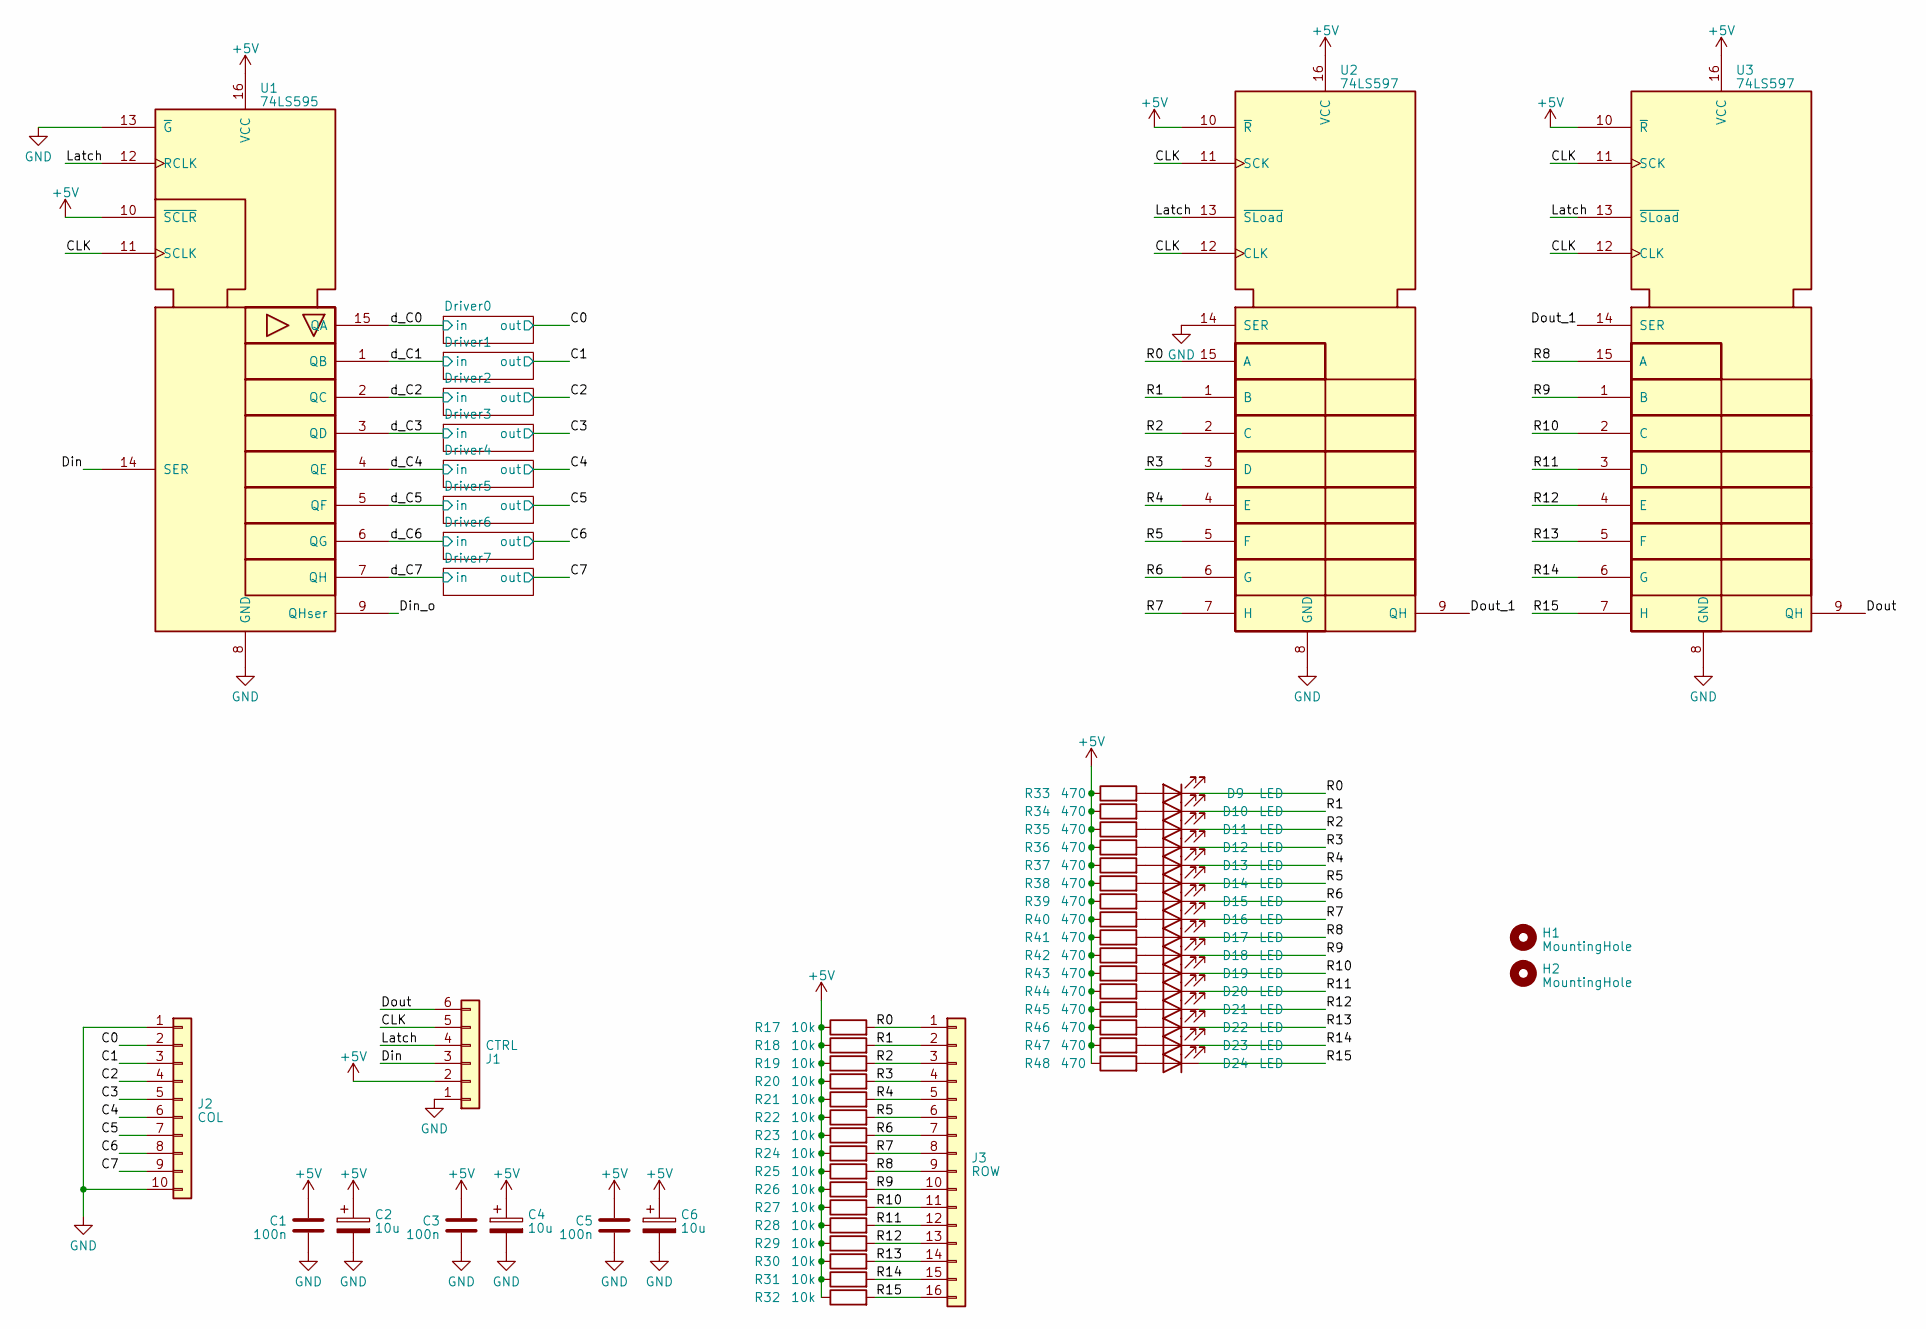
[picture p273: schematic hall_sensor_matrix_v2.kicad_sch]

Parts:
C1, C3, C5: 100n; C_0603_1608Metric_Pad1.08x0.95mm_HandSolder
C2, C4, C6: 10u; C_0805_2012Metric_Pad1.18x1.45mm_HandSolder
D9, D10, D11, D12, D13, D14, D15, D16, D17, D18, D19, D20, D21, D22, D23, D24: LED; LED_0603_1608Metric_Pad1.05x0.95mm_HandSolder
H1, H2: MountingHole; MountingHole_3.2mm_M3
J1: CTRL; PinSocket_1x06_P2.54mm_Horizontal
J2: COL; PinHeader_1x10_P2.54mm_Vertical
J3: ROW; PinHeader_1x16_P2.54mm_Vertical
R17, R18, R19, R20, R21, R22, R23, R24, R25, R26, R27, R28, R29, R30, R31, R32: 10k; R_0805_2012Metric
R33, R34, R35, R36, R37, R38, R39, R40, R41, R42, R43, R44, R45, R46, R47, R48: 470; R_0805_2012Metric
U1: 74LS595; DIP-16_W7.62mm_LongPads
U2, U3: 74LS597; DIP-16_W7.62mm_LongPads

Connections:
+5V: C1.1, C2.1, C3.1, C4.1, C5.1, C6.1, J1.2, R17.1, R18.1, R19.1, R20.1, R21.1, R22.1, R23.1, R24.1, R25.1, R26.1, R27.1, R28.1, R29.1, R30.1, R31.1, R32.1, R33.1, R34.1, R35.1, R36.1, R37.1, R38.1, R39.1, R40.1, R41.1, R42.1, R43.1, R44.1, R45.1, R46.1, R47.1, R48.1, U1.10 (~SCLR), U1.16 (VCC), U2.10 (~R), U2.16 (VCC), U3.10 (~R), U3.16 (VCC); also elsewhere on the board
/C0: J2.2; also elsewhere on the board
/C1: J2.3; also elsewhere on the board
/C2: J2.4; also elsewhere on the board
/C3: J2.5; also elsewhere on the board
/C4: J2.6; also elsewhere on the board
/C5: J2.7; also elsewhere on the board
/C6: J2.8; also elsewhere on the board
/C7: J2.9; also elsewhere on the board
/CLK: J1.5, U1.11 (SCLK), U2.11 (SCK), U2.12 (CLK), U3.11 (SCK), U3.12 (CLK)
/Din: J1.3, U1.14 (SER)
/Din_o: U1.9 (QHser)
/Dout: J1.6, U3.9 (QH)
/Dout_1: U2.9 (QH), U3.14 (SER)
/Latch: J1.4, U1.12 (RCLK), U2.13 (~SLoad), U3.13 (~SLoad)
/R0: D9.1 (K), J3.1, R17.2, U2.15 (A)
/R1: D10.1 (K), J3.2, R18.2, U2.1 (B)
/R2: D11.1 (K), J3.3, R19.2, U2.2 (C)
/R3: D12.1 (K), J3.4, R20.2, U2.3 (D)
/R4: D13.1 (K), J3.5, R21.2, U2.4 (E)
/R5: D14.1 (K), J3.6, R22.2, U2.5 (F)
/R6: D15.1 (K), J3.7, R23.2, U2.6 (G)
/R7: D16.1 (K), J3.8, R24.2, U2.7 (H)
/R8: D17.1 (K), J3.9, R25.2, U3.15 (A)
/R9: D18.1 (K), J3.10, R26.2, U3.1 (B)
/R10: D19.1 (K), J3.11, R27.2, U3.2 (C)
/R11: D20.1 (K), J3.12, R28.2, U3.3 (D)
/R12: D21.1 (K), J3.13, R29.2, U3.4 (E)
/R13: D22.1 (K), J3.14, R30.2, U3.5 (F)
/R14: D23.1 (K), J3.15, R31.2, U3.6 (G)
/R15: D24.1 (K), J3.16, R32.2, U3.7 (H)
/d_C0: U1.15 (QA); also elsewhere on the board
/d_C1: U1.1 (QB); also elsewhere on the board
/d_C2: U1.2 (QC); also elsewhere on the board
/d_C3: U1.3 (QD); also elsewhere on the board
/d_C4: U1.4 (QE); also elsewhere on the board
/d_C5: U1.5 (QF); also elsewhere on the board
/d_C6: U1.6 (QG); also elsewhere on the board
/d_C7: U1.7 (QH); also elsewhere on the board
GND: C1.2, C2.2, C3.2, C4.2, C5.2, C6.2, J1.1, J2.1, J2.10, U1.8 (GND), U1.13 (~G), U2.8 (GND), U2.14 (SER), U3.8 (GND); also elsewhere on the board
unnamed: D9.2 (A), R33.2
unnamed: D10.2 (A), R34.2
unnamed: D11.2 (A), R35.2
unnamed: D12.2 (A), R36.2
unnamed: D13.2 (A), R37.2
unnamed: D14.2 (A), R38.2
unnamed: D15.2 (A), R39.2
unnamed: D16.2 (A), R40.2
unnamed: D17.2 (A), R41.2
unnamed: D18.2 (A), R42.2
unnamed: D19.2 (A), R43.2
unnamed: D20.2 (A), R44.2
unnamed: D21.2 (A), R45.2
unnamed: D22.2 (A), R46.2
unnamed: D23.2 (A), R47.2
unnamed: D24.2 (A), R48.2

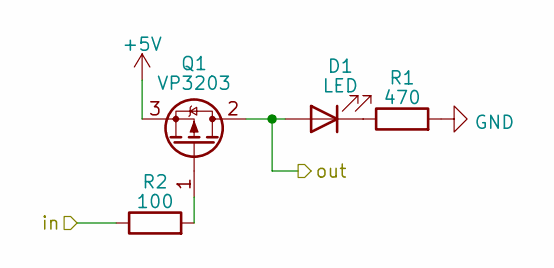
[picture p274: schematic driver.kicad_sch]

Parts:
D1: LED; LED_0603_1608Metric_Pad1.05x0.95mm_HandSolder
Q1: VP3203; SOT-89-3
R1: 470; R_0805_2012Metric
R2: 100; R_0805_2012Metric

Connections:
+5V: Q1.3 (S); also elsewhere on the board
/C0: D1.2 (A), Q1.2 (D); also elsewhere on the board
/d_C0: R2.1; also elsewhere on the board
GND: R1.2; also elsewhere on the board
unnamed: D1.1 (K), R1.1
unnamed: Q1.1 (G), R2.2

Parts of its further copies:
D2, D3, D4, D5, D6, D7, D8: LED; LED_0603_1608Metric_Pad1.05x0.95mm_HandSolder
Q2, Q3, Q4, Q5, Q6, Q7, Q8: VP3203; SOT-89-3
R3, R5, R7, R9, R11, R13, R15: 470; R_0805_2012Metric
R4, R6, R8, R10, R12, R14, R16: 100; R_0805_2012Metric

Connections of its further copies:
+5V: Q2.3 (S), Q3.3 (S), Q4.3 (S), Q5.3 (S), Q6.3 (S), Q7.3 (S), Q8.3 (S); also elsewhere on the board
/C1: D2.2 (A), Q2.2 (D); also elsewhere on the board
/C2: D3.2 (A), Q3.2 (D); also elsewhere on the board
/C3: D4.2 (A), Q4.2 (D); also elsewhere on the board
/C4: D5.2 (A), Q5.2 (D); also elsewhere on the board
/C5: D6.2 (A), Q6.2 (D); also elsewhere on the board
/C6: D7.2 (A), Q7.2 (D); also elsewhere on the board
/C7: D8.2 (A), Q8.2 (D); also elsewhere on the board
/d_C1: R4.1; also elsewhere on the board
/d_C2: R6.1; also elsewhere on the board
/d_C3: R8.1; also elsewhere on the board
/d_C4: R10.1; also elsewhere on the board
/d_C5: R12.1; also elsewhere on the board
/d_C6: R14.1; also elsewhere on the board
/d_C7: R16.1; also elsewhere on the board
GND: R3.2, R5.2, R7.2, R9.2, R11.2, R13.2, R15.2; also elsewhere on the board
unnamed: D2.1 (K), R3.1
unnamed: D3.1 (K), R5.1
unnamed: D4.1 (K), R7.1
unnamed: D5.1 (K), R9.1
unnamed: D6.1 (K), R11.1
unnamed: D7.1 (K), R13.1
unnamed: D8.1 (K), R15.1
unnamed: Q2.1 (G), R4.2
unnamed: Q3.1 (G), R6.2
unnamed: Q4.1 (G), R8.2
unnamed: Q5.1 (G), R10.2
unnamed: Q6.1 (G), R12.2
unnamed: Q7.1 (G), R14.2
unnamed: Q8.1 (G), R16.2

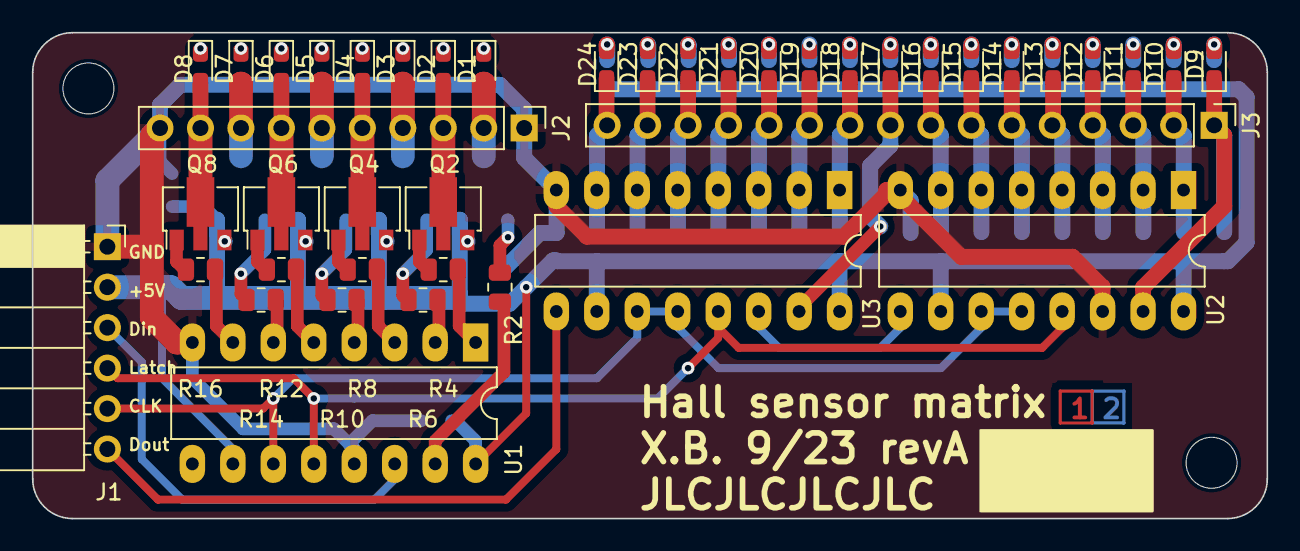
[picture p275: board hall_sensor_matrix_v2.kicad_pcb from above]

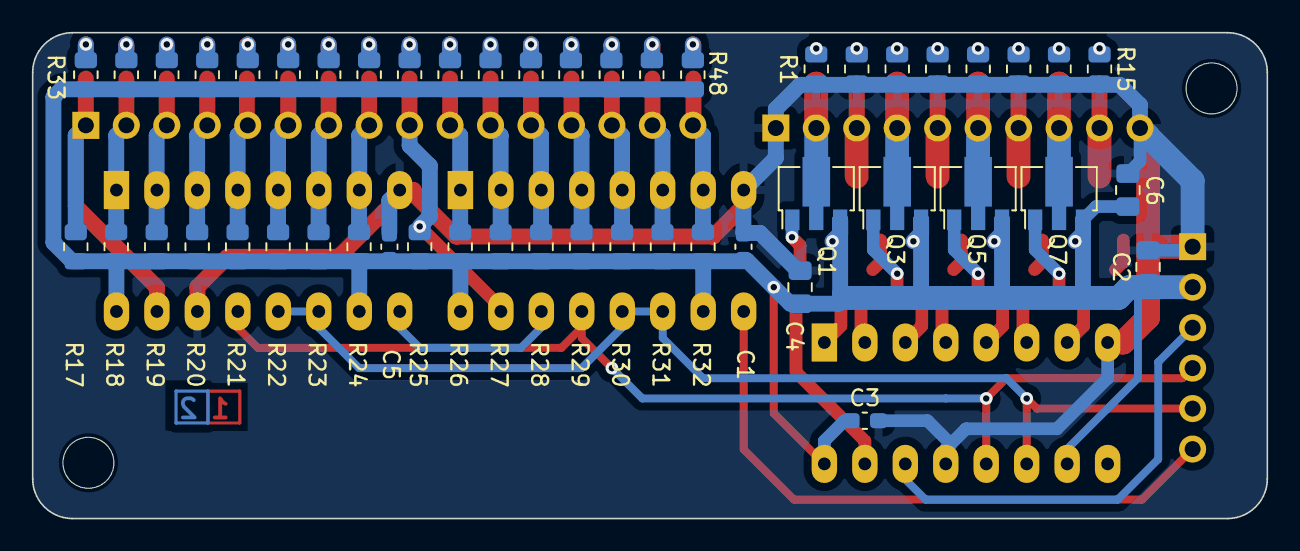
[picture p276: board hall_sensor_matrix_v2.kicad_pcb from below]

Board: 2 copper layers, 77.5 x 30.5 mm, 94 parts (50 on the bottom side), 71 nets.
