reivax-boucoi/PCB_Kicad/transistor_clock/transistor_clock.kicad_pcb

## KiCad design transistor_clock/transistor_clock.kicad_pcb (2023-10-01)

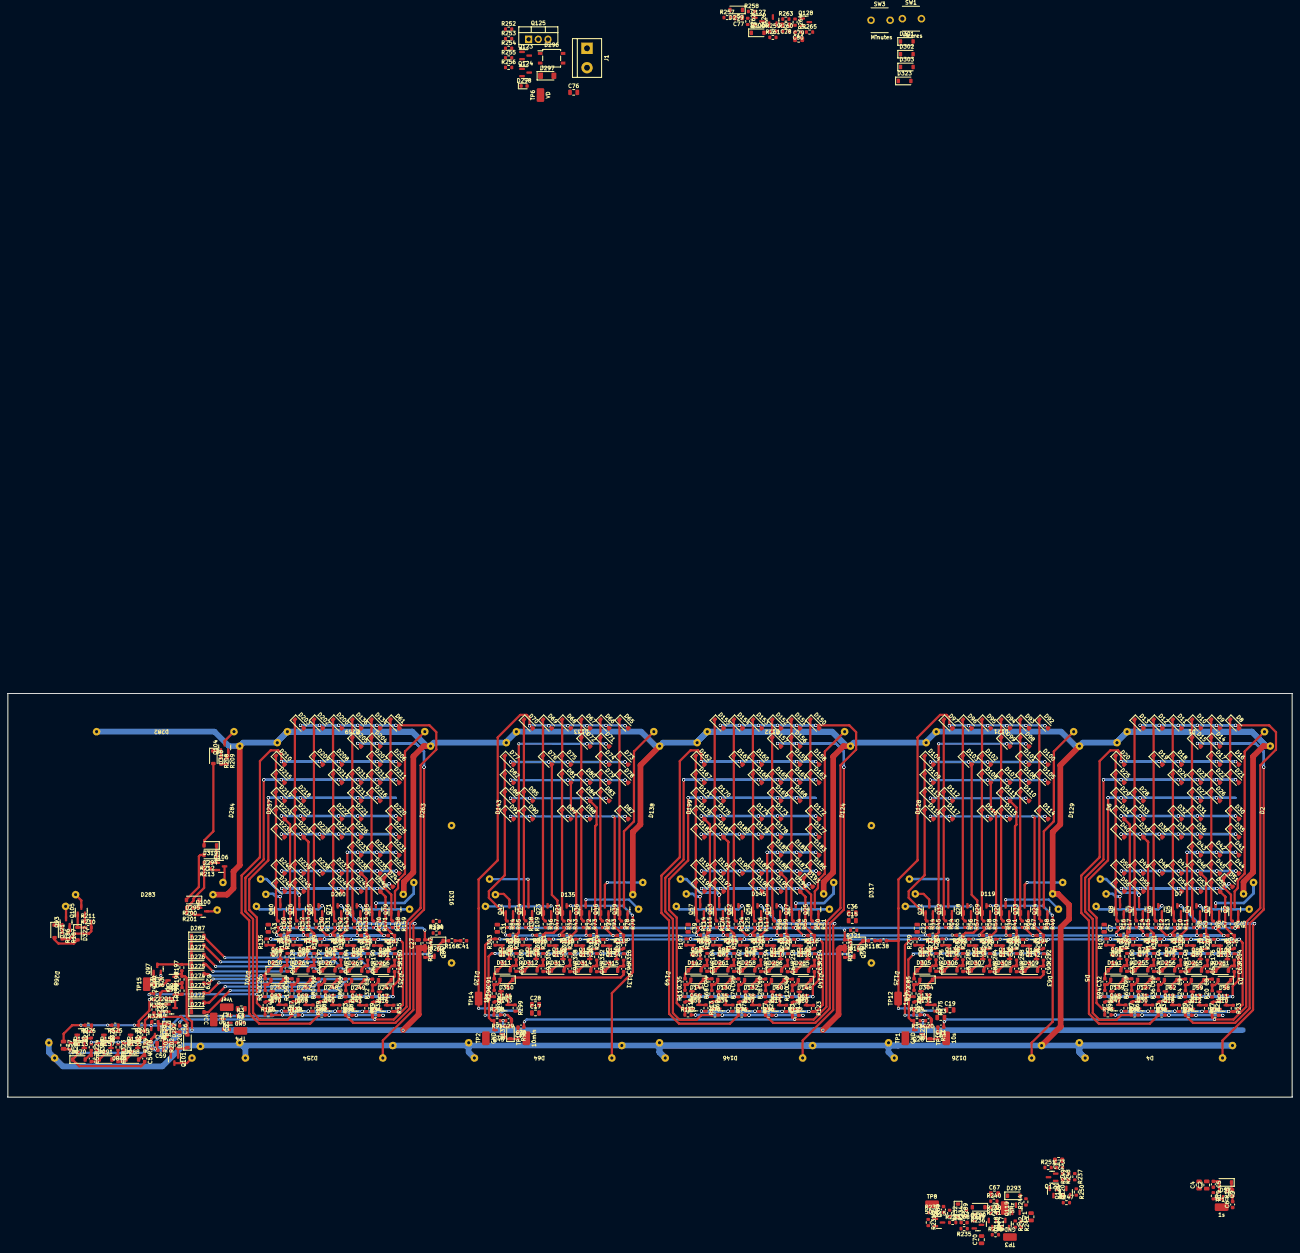
[picture p277: board transistor_clock.kicad_pcb from above]

Board: 2 copper layers, 336.5 x 105.8 mm, 907 parts (0 on the bottom side), 423 nets.

Parts:
C1, C2, C4, C7, C13, C15, C17, C19, C22, C27, C28, C31, C36, C39, C43, C57, C58, C67, C72, C76, C79: 10u; C_0805_2012Metric
C3, C8, C9, C10, C11, C12, C14, C16, C18, C23, C24, C25, C26, C32, C33, C34, C35, C40, C44, C45, C46, C47, C48, C49, C50, C51, C52, C53, C54, C55, C62, C63, C64, C85, C86, C87, C88, C89, C90, C91, C92, C93, C94, C95, C96: 1n; C_0603_1608Metric
C5, C6, C20, C21, C29, C30, C37, C38, C41, C42, C56, C59, C68, C69, C73, C80: 100n; C_0603_1608Metric
C70, C71: 1u; C_0805_2012Metric
C77: 10n; C_0805_2012Metric
C78: 220p; C_0805_2012Metric
D1, D2, D3, D4, D5, D6, D7, D63, D64, D119, D120, D121, D122, D124, D125, D126, D128, D129, D131, D133, D135, D138, D140, D143, D145, D146, D149, D199, D201, D251, D254, D257, D259, D260, D263, D268, D279, D280, D282, D283, D284, D316, D317: LED; LED_filament_38mm
D8, D9, D10, D11, D12, D13, D14, D15, D16, D17, D18, D19, D20, D21, D22, D23, D24, D25, D26, D27, D28, D29, D30, D31, D32, D33, D34, D35, D36, D37, D38, D39, D40, D41, D42, D43, D44, D45, D46, D47, D48, D49, D50, D51, D52, D53, D54, D55, D56, D57, D58, D59, D60, D61, D62, D65, D66, D67, D68, D69, D70, D71, D72, D73, D74, D75, D76, D77, D78, D79, D80, D81, D82, D83, D84, D85, D86, D87, D88, D89, D90, D91, D92, D93, D94, D95, D96, D97, D98, D99, D100, D101, D102, D103, D104, D105, D106, D107, D108, D109, D110, D111, D112, D113, D114, D115, D116, D117, D118, D123, D127, D130, D132, D134, D136, D137, D139, D141, D142, D144, D147, D148, D150, D151, D152, D153, D154, D155, D156, D157, D158, D159, D160, D161, D162, D163, D164, D165, D166, D167, D168, D169, D170, D171, D172, D173, D174, D175, D176, D177, D178, D179, D180, D181, D182, D183, D184, D185, D186, D187, D188, D189, D190, D191, D192, D193, D194, D195, D196, D197, D198, D200, D202, D203, D204, D205, D206, D207, D208, D209, D210, D211, D212, D213, D214, D215, D216, D217, D218, D219, D220, D221, D222, D223, D224, D225, D226, D227, D228, D229, D230, D231, D232, D233, D234, D235, D236, D237, D238, D239, D240, D241, D242, D243, D244, D245, D246, D247, D248, D249, D250, D252, D253, D255, D256, D258, D261, D262, D264, D265, D266, D267, D269, D270, D271, D272, D273, D274, D275, D276, D277, D278, D281, D285, D286, D287, D288, D289, D290, D291, D292, D293, D294, D295, D299, D300, D301, D302, D303, D304, D305, D306, D307, D308, D309, D310, D311, D312, D313, D314, D315, D318, D319, D320, D321, D322, D323: 1N4148W; D_SOD-123
D296: D_Bridge_+-AA; SO-4_4.4x4.3mm_P2.54mm
D297: D_Zener; D_MiniMELF
D298: LED; LED_0603_1608Metric
J1: Conn_01x02; TerminalBlock_bornier-2_P5.08mm
Q1, Q2, Q3, Q4, Q5, Q6, Q7, Q8, Q9, Q11, Q13, Q15, Q17, Q19, Q20, Q21, Q22, Q23, Q24, Q25, Q26, Q27, Q28, Q29, Q31, Q32, Q33, Q35, Q36, Q38, Q39, Q41, Q42, Q44, Q45, Q46, Q48, Q49, Q51, Q53, Q54, Q56, Q57, Q58, Q59, Q61, Q62, Q63, Q65, Q66, Q67, Q69, Q71, Q73, Q75, Q76, Q78, Q79, Q80, Q82, Q83, Q84, Q85, Q87, Q89, Q91, Q93, Q94, Q96, Q97, Q99, Q100, Q101, Q103, Q104, Q105, Q106, Q108, Q110, Q111, Q113, Q115, Q118, Q121, Q123, Q124, Q127, Q132, Q134, Q136, Q138, Q140, Q142, Q144, Q146, Q148, Q150, Q152, Q154, Q155, Q157, Q158: MMBT3904; SOT-23
Q10, Q12, Q14, Q16, Q18, Q30, Q34, Q37, Q40, Q43, Q47, Q50, Q52, Q55, Q60, Q64, Q68, Q70, Q72, Q74, Q77, Q81, Q86, Q88, Q90, Q92, Q95, Q98, Q102, Q107, Q109, Q112, Q114, Q116, Q117, Q119, Q120, Q122, Q126, Q128, Q131, Q133, Q135, Q137, Q139, Q141, Q143, Q145, Q147, Q149, Q151, Q153, Q156: MMBT5401; SOT-23
Q125: TIP41; TO-220-3_Vertical
R1: 3k9; R_0603_1608Metric
R2, R3, R5, R7, R9, R11, R13, R15, R17, R18, R21, R23, R25, R27, R29, R31, R33, R35, R37, R39, R41, R43, R45, R47, R49, R51, R52, R55, R57, R59, R61, R63, R65, R67, R69, R71, R73, R75, R77, R79, R81, R83, R85, R87, R89, R90, R93, R95, R97, R99, R101, R103, R105, R107, R109, R111, R113, R115, R117, R118, R121, R123, R125, R127, R129, R131, R133, R135, R137, R139, R141, R143, R145, R147, R149, R151, R153, R155, R157, R159, R161, R163, R165, R167, R168, R171, R173, R175, R177, R179, R181, R183, R185, R187, R189, R191, R193, R194, R195, R196, R199, R201, R203, R205, R207, R209, R211, R213, R215, R217, R219, R221, R225, R227, R229, R232, R233, R237, R238, R241, R246, R249, R251, R260, R262, R264, R265, R273, R275, R277, R279, R281, R283, R285, R287, R289, R291, R293, R295, R297, R299, R301, R303, R305, R307, R309, R311, R313, R315, R317, R319, R320, R321, R324, R326, R327, R328: 10k; R_0603_1608Metric
R4, R6, R8, R10, R12, R14, R16, R40, R42, R44, R46, R48, R50, R54, R56, R58, R64, R66, R72, R78, R84, R92, R98, R108, R114, R116, R124, R126, R130, R132, R142, R152, R158, R160, R170, R186, R198, R200, R202, R208, R210, R212, R222, R223, R230, R231, R239, R242, R247, R250, R257, R258, R259, R263, R330, R331: 100k; R_0603_1608Metric
R19, R20, R22, R24, R26, R28, R30, R32, R34, R36, R38, R53, R60, R62, R68, R70, R74, R76, R80, R82, R86, R88, R91, R94, R96, R100, R102, R104, R106, R110, R112, R119, R120, R122, R128, R134, R136, R138, R140, R144, R146, R148, R150, R154, R156, R162, R164, R166, R169, R172, R174, R176, R178, R180, R182, R184, R188, R190, R192, R197, R204, R206, R214, R216, R218, R220, R224, R226, R228, R235, R240, R243, R245, R248, R272, R274, R276, R278, R280, R282, R284, R286, R288, R290, R292, R294, R296, R298, R300, R302, R304, R306, R308, R310, R312, R314, R316, R318, R323, R325, R329: 2k2; R_0603_1608Metric
R234: 4.7k; R_0603_1608Metric
R236, R244, R255, R256, R261: 1k; R_0603_1608Metric
R252, R253, R254: 500; R_0603_1608Metric
SW1: Heures; SW_PUSH_6mm_2pins
SW3: Minutes; SW_PUSH_6mm_2pins
TP1, TP2, TP3, TP4: GND; RCSRCW_0C_testpoint_1206
TP5: VCC; RCSRCW_0C_testpoint_1206
TP6: VD; RCSRCW_0C_testpoint_1206
TP7: Vref; RCSRCW_0C_testpoint_1206
TP8: 50Hz; RCSRCW_0C_testpoint_1206
TP9: 5Hz; RCSRCW_0C_testpoint_1206
TP10: 1s; RCSRCW_0C_testpoint_1206
TP11: 10s; RCSRCW_0C_testpoint_1206
TP12: 1min; RCSRCW_0C_testpoint_1206
TP13: 10min; RCSRCW_0C_testpoint_1206
TP14: 1hr; RCSRCW_0C_testpoint_1206
TP15: 24_rst; RCSRCW_0C_testpoint_1206

Connections:
/5Hz: Q119.1 (B), R240.2, R241.1, TP9.1
/50Hz: Q128.3 (C), R230.1, R265.2, TP8.1
/Dot_H-M: D316.1 (K), R320.1
/Dot_M-S: D317.1 (K), R321.1
/Hours/24_rst: Q97.1 (B), R195.1, R196.2, TP15.1
/Hours/CLK: Q84.3 (C), R32.1, R80.1, R86.1, R128.1, R136.1, R140.1, R169.2, R172.1, R180.1, R184.1, R190.1
/Hours/Div24_t_A: D318.1 (K), Q104.1 (B), R208.1
/Hours/Div24_t_B: D294.1 (K), D319.1 (K), Q106.1 (B), R212.1
/Hours/Div24_t_C: D295.1 (K), Q100.1 (B), R200.1
/Hours/Div24_t_D: D320.1 (K), Q101.1 (B), R202.1
/Hours/Div24_t_E: D321.1 (K), Q93.1 (B), R186.1
/Hours/Div24_t_G: D322.1 (K), Q105.1 (B), R210.1
/Hours/Div24_u_A: D61.1 (K), D206.1 (K), D211.1 (K), D220.1 (K), D225.1 (K), D231.1 (K), D234.1 (K), D241.1 (K), Q79.1 (B), R158.1
/Hours/Div24_u_B: D134.1 (K), D204.1 (K), D207.1 (K), D212.1 (K), D216.1 (K), D232.1 (K), D235.1 (K), D242.1 (K), Q85.1 (B), R170.1
/Hours/Div24_u_C: D136.1 (K), D205.1 (K), D213.1 (K), D217.1 (K), D221.1 (K), D226.1 (K), D233.1 (K), D236.1 (K), D243.1 (K), Q66.1 (B), R132.1
/Hours/Div24_u_D: D200.1 (K), D208.1 (K), D214.1 (K), D222.1 (K), D227.1 (K), D237.1 (K), D244.1 (K), Q71.1 (B), R142.1
/Hours/Div24_u_E: D202.1 (K), D209.1 (K), D228.1 (K), D238.1 (K), Q65.1 (B), R130.1
/Hours/Div24_u_F: D203.1 (K), D218.1 (K), D223.1 (K), D229.1 (K), D239.1 (K), D245.1 (K), Q76.1 (B), R152.1
/Hours/Div24_u_G: D210.1 (K), D215.1 (K), D219.1 (K), D224.1 (K), D230.1 (K), D240.1 (K), D246.1 (K), Q80.1 (B), R160.1
/Hours/I0: C45.2, D247.1 (K), Q16.2 (E)
/Hours/I1: C3.2, D249.1 (K), D271.2 (A), Q43.2 (E)
/Hours/I2: C14.2, D248.1 (K), D272.2 (A), Q40.2 (E)
/Hours/I3: C11.2, D252.1 (K), D273.2 (A), Q68.2 (E)
/Hours/I4: C18.2, D253.1 (K), D274.2 (A), Q70.2 (E)
/Hours/I5: C26.2, D250.1 (K), D275.2 (A), Q64.2 (E)
/Hours/I6: C16.2, D264.1 (K), D276.2 (A), Q86.2 (E)
/Hours/I7: C44.2, D267.1 (K), D277.2 (A), Q92.2 (E)
/Hours/I8: C46.2, D269.1 (K), D278.2 (A), Q95.2 (E)
/Hours/I9: C51.2, D266.1 (K), D287.2 (A), Q90.2 (E)
/Hours/Ih0: C54.2, D270.1 (K), Q112.2 (E)
/Hours/Ih1: C52.2, D291.1 (K), Q156.2 (E)
/Hours/Ih2: C55.2, D288.1 (K), Q114.2 (E)
/Hours/O0: C56.1, D61.2 (A), D134.2 (A), D136.2 (A), D200.2 (A), D202.2 (A), D203.2 (A), Q17.2 (E), R33.2, R34.1
/Hours/O1: D204.2 (A), D205.2 (A), Q44.2 (E), R87.2, R88.1
/Hours/O2: D206.2 (A), D207.2 (A), D208.2 (A), D209.2 (A), D210.2 (A), Q41.2 (E), R81.2, R82.1
/Hours/O3: D211.2 (A), D212.2 (A), D213.2 (A), D214.2 (A), D215.2 (A), Q69.2 (E), R137.2, R138.1
/Hours/O4: D216.2 (A), D217.2 (A), D218.2 (A), D219.2 (A), Q83.2 (E), R141.2, R166.1, R222.2
/Hours/O5: D220.2 (A), D221.2 (A), D222.2 (A), D223.2 (A), D224.2 (A), Q67.2 (E), R129.2, R134.1
/Hours/O6: D225.2 (A), D226.2 (A), D227.2 (A), D228.2 (A), D229.2 (A), D230.2 (A), Q87.2 (E), R173.2, R174.1
/Hours/O7: D231.2 (A), D232.2 (A), D233.2 (A), Q94.2 (E), R185.2, R188.1
/Hours/O8: D234.2 (A), D235.2 (A), D236.2 (A), D237.2 (A), D238.2 (A), D239.2 (A), D240.2 (A), Q96.2 (E), R191.2, R192.1
/Hours/O9: D241.2 (A), D242.2 (A), D243.2 (A), D244.2 (A), D245.2 (A), D246.2 (A), Q91.2 (E), R181.2, R182.1
/Hours/Oh0: Q113.2 (E), R225.2, R226.1
/Hours/Oh1: D294.2 (A), D295.2 (A), Q157.2 (E), R324.2, R325.1
/Hours/Oh2: D318.2 (A), D319.2 (A), D320.2 (A), D321.2 (A), D322.2 (A), Q155.2 (E), R223.2, R229.2, R245.1
/Hours/SCR_stage10/RST: Q158.3 (C), R224.1, R228.1, R323.1, R329.2
/Minutes/10Decoder/1: D156.2 (A), D157.2 (A), Q15.2 (E), R29.2, R30.1
/Minutes/10Decoder/2: D158.2 (A), D159.2 (A), D160.2 (A), D161.2 (A), D162.2 (A), Q38.2 (E), R75.2, R76.1
/Minutes/10Decoder/3: D163.2 (A), D164.2 (A), D165.2 (A), D166.2 (A), D167.2 (A), Q35.2 (E), R69.2, R70.1
/Minutes/10Decoder/4: D168.2 (A), D169.2 (A), D170.2 (A), D171.2 (A), Q56.2 (E), R111.2, R112.1
/Minutes/10Decoder/5: D172.2 (A), D173.2 (A), D174.2 (A), D175.2 (A), D176.2 (A), Q53.2 (E), R105.2, R106.1
/Minutes/10Decoder/6: D177.2 (A), D178.2 (A), D179.2 (A), D180.2 (A), D181.2 (A), D182.2 (A), Q82.2 (E), R163.2, R164.1
/Minutes/10Decoder/7: D183.2 (A), D184.2 (A), D185.2 (A), Q78.2 (E), R155.2, R156.1
/Minutes/10Decoder/8: D186.2 (A), D187.2 (A), D188.2 (A), D189.2 (A), D190.2 (A), D191.2 (A), D192.2 (A), Q110.2 (E), R219.2, R220.1
/Minutes/10Decoder/9: D193.2 (A), D194.2 (A), D195.2 (A), D196.2 (A), D197.2 (A), D198.2 (A), Q108.2 (E), R215.2, R216.1
/Minutes/10counter/RST: Q59.3 (C), R28.1, R68.1, R74.1, R104.1, R110.1, R119.2, R120.1, R154.1, R162.1, R214.1, R218.1
/Minutes/10counter/SCR_stage1/NEXT: C10.2, D132.1 (K), Q37.2 (E)
/Minutes/10counter/SCR_stage2/NEXT: C25.2, D130.1 (K), Q34.2 (E)
/Minutes/10counter/SCR_stage3/NEXT: C24.2, D144.1 (K), Q55.2 (E)
/Minutes/10counter/SCR_stage4/NEXT: C35.2, D142.1 (K), Q52.2 (E)
/Minutes/10counter/SCR_stage5/NEXT: C34.2, D261.1 (K), Q81.2 (E)
/Minutes/10counter/SCR_stage6/NEXT: C50.2, D258.1 (K), Q77.2 (E)
/Minutes/10counter/SCR_stage7/NEXT: C49.2, D286.1 (K), Q109.2 (E)
/Minutes/10counter/SCR_stage8/NEXT: C64.2, D285.1 (K), Q107.2 (E)
/Minutes/10counter/SCR_stage/IN: C63.2, D148.1 (K), Q60.2 (E)
/Minutes/10counter/SCR_stage/NEXT: C40.2, D60.1 (K), Q14.2 (E)
/Minutes/Clk_in: C38.1, D301.1 (K), D302.1 (K)
/Minutes/Div10_A: D150.1 (K), D158.1 (K), D163.1 (K), D172.1 (K), D177.1 (K), D183.1 (K), D186.1 (K), D193.1 (K), Q25.1 (B), R50.1
/Minutes/Div10_B: D151.1 (K), D156.1 (K), D159.1 (K), D164.1 (K), D168.1 (K), D184.1 (K), D187.1 (K), D194.1 (K), Q27.1 (B), R54.1
/Minutes/Div10_C: D152.1 (K), D157.1 (K), D165.1 (K), D169.1 (K), D173.1 (K), D178.1 (K), D185.1 (K), D188.1 (K), D195.1 (K), Q49.1 (B), R98.1
/Minutes/Div10_D: D153.1 (K), D160.1 (K), D166.1 (K), D174.1 (K), D179.1 (K), D189.1 (K), D196.1 (K), Q58.1 (B), R116.1
/Minutes/Div10_E: D154.1 (K), D161.1 (K), D180.1 (K), D190.1 (K), Q62.1 (B), R124.1
/Minutes/Div10_F: D155.1 (K), D170.1 (K), D175.1 (K), D181.1 (K), D191.1 (K), D197.1 (K), Q63.1 (B), R126.1
/Minutes/Div10_G: D162.1 (K), D167.1 (K), D171.1 (K), D176.1 (K), D182.1 (K), D192.1 (K), D198.1 (K), Q57.1 (B), R114.1
/PSU/AC1: D296.3, J1.2
/PSU/AC2: D296.4, J1.1, R257.1
/Seconds/10Decoder/1: D14.2 (A), D15.2 (A), Q13.2 (E), R25.2, R26.1
/Seconds/10Decoder/2: D16.2 (A), D17.2 (A), D18.2 (A), D19.2 (A), D20.2 (A), Q19.2 (E), R37.2, R38.1
/Seconds/10Decoder/3: D21.2 (A), D22.2 (A), D23.2 (A), D24.2 (A), D25.2 (A), Q31.2 (E), R61.2, R62.1
/Seconds/10Decoder/4: D26.2 (A), D27.2 (A), D28.2 (A), D29.2 (A), Q48.2 (E), R95.2, R96.1
/Seconds/10Decoder/5: D30.2 (A), D31.2 (A), D32.2 (A), D33.2 (A), D34.2 (A), Q51.2 (E), R101.2, R102.1
/Seconds/10Decoder/6: D35.2 (A), D36.2 (A), D37.2 (A), D38.2 (A), D39.2 (A), D40.2 (A), Q73.2 (E), R145.2, R146.1
/Seconds/10Decoder/7: D41.2 (A), D42.2 (A), D43.2 (A), Q75.2 (E), R149.2, R150.1
/Seconds/10Decoder/8: D44.2 (A), D45.2 (A), D46.2 (A), D47.2 (A), D48.2 (A), D49.2 (A), D50.2 (A), Q89.2 (E), R177.2, R178.1
/Seconds/10Decoder/9: D51.2 (A), D52.2 (A), D53.2 (A), D54.2 (A), D55.2 (A), D56.2 (A), Q103.2 (E), R205.2, R206.1
/Seconds/10counter/RST: Q9.3 (C), R19.2, R20.1, R24.1, R36.1, R60.1, R94.1, R100.1, R144.1, R148.1, R176.1, R204.1
/Seconds/10counter/SCR_stage1/NEXT: C9.2, D62.1 (K), Q18.2 (E)
/Seconds/10counter/SCR_stage2/NEXT: C12.2, D127.1 (K), Q30.2 (E)
/Seconds/10counter/SCR_stage3/NEXT: C23.2, D139.1 (K), Q47.2 (E)
/Seconds/10counter/SCR_stage4/NEXT: C32.2, D141.1 (K), Q50.2 (E)
/Seconds/10counter/SCR_stage5/NEXT: C33.2, D255.1 (K), Q72.2 (E)
/Seconds/10counter/SCR_stage6/NEXT: C47.2, D256.1 (K), Q74.2 (E)
/Seconds/10counter/SCR_stage7/NEXT: C48.2, D265.1 (K), Q88.2 (E)
/Seconds/10counter/SCR_stage8/NEXT: C53.2, D281.1 (K), Q102.2 (E)
/Seconds/10counter/SCR_stage/IN: C62.2, D58.1 (K), Q10.2 (E)
/Seconds/10counter/SCR_stage/NEXT: C8.2, D59.1 (K), Q12.2 (E)
/Seconds/Div10_A: D8.1 (K), D16.1 (K), D21.1 (K), D30.1 (K), D35.1 (K), D41.1 (K), D44.1 (K), D51.1 (K), Q2.1 (B), R4.1
/Seconds/Div10_B: D9.1 (K), D14.1 (K), D17.1 (K), D22.1 (K), D26.1 (K), D42.1 (K), D45.1 (K), D52.1 (K), Q3.1 (B), R6.1
/Seconds/Div10_C: D10.1 (K), D15.1 (K), D23.1 (K), D27.1 (K), D31.1 (K), D36.1 (K), D43.1 (K), D46.1 (K), D53.1 (K), Q4.1 (B), R8.1
/Seconds/Div10_D: D11.1 (K), D18.1 (K), D24.1 (K), D32.1 (K), D37.1 (K), D47.1 (K), D54.1 (K), Q5.1 (B), R10.1
/Seconds/Div10_E: D12.1 (K), D19.1 (K), D38.1 (K), D48.1 (K), Q6.1 (B), R12.1
/Seconds/Div10_F: D13.1 (K), D28.1 (K), D33.1 (K), D39.1 (K), D49.1 (K), D55.1 (K), Q7.1 (B), R14.1
/Seconds/Div10_G: D20.1 (K), D25.1 (K), D29.1 (K), D34.1 (K), D40.1 (K), D50.1 (K), D56.1 (K), Q8.1 (B), R16.1
/TensMinutes/6Decoder/1: D71.2 (A), D72.2 (A), Q146.2 (E), R301.2, R302.1
/TensMinutes/6Decoder/2: D73.2 (A), D74.2 (A), D75.2 (A), D76.2 (A), D77.2 (A), Q148.2 (E), R305.2, R306.1
/TensMinutes/6Decoder/3: D78.2 (A), D79.2 (A), D80.2 (A), D81.2 (A), D82.2 (A), Q150.2 (E), R309.2, R310.1
/TensMinutes/6Decoder/4: D83.2 (A), D84.2 (A), D85.2 (A), D86.2 (A), Q152.2 (E), R313.2, R314.1
/TensMinutes/6Decoder/5: D87.2 (A), D88.2 (A), D89.2 (A), D90.2 (A), D91.2 (A), Q154.2 (E), R317.2, R318.1
/TensMinutes/6counter/RST: Q45.3 (C), R91.2, R296.1, R300.1, R304.1, R308.1, R312.1, R316.1
/TensMinutes/6counter/SCR_stage1/NEXT: C92.2, D312.1 (K), Q147.2 (E)
/TensMinutes/6counter/SCR_stage2/NEXT: C93.2, D313.1 (K), Q149.2 (E)
/TensMinutes/6counter/SCR_stage3/NEXT: C94.2, D314.1 (K), Q151.2 (E)
/TensMinutes/6counter/SCR_stage4/NEXT: C95.2, D315.1 (K), Q153.2 (E)
/TensMinutes/6counter/SCR_stage/IN: C96.2, D310.1 (K), Q143.2 (E)
/TensMinutes/6counter/SCR_stage/NEXT: C91.2, D311.1 (K), Q145.2 (E)
/TensMinutes/Div6_A: D65.1 (K), D73.1 (K), D78.1 (K), D87.1 (K), Q39.1 (B), R78.1
/TensMinutes/Div6_B: D66.1 (K), D71.1 (K), D74.1 (K), D79.1 (K), D83.1 (K), Q46.1 (B), R92.1
/TensMinutes/Div6_C: D67.1 (K), D72.1 (K), D80.1 (K), D84.1 (K), D88.1 (K), Q36.1 (B), R72.1
/TensMinutes/Div6_D: D68.1 (K), D75.1 (K), D81.1 (K), D89.1 (K), Q21.1 (B), R42.1
/TensMinutes/Div6_E: D69.1 (K), D76.1 (K), Q23.1 (B), R46.1
/TensMinutes/Div6_F: D70.1 (K), D85.1 (K), D90.1 (K), Q54.1 (B), R108.1
/TensMinutes/Div6_G: D77.1 (K), D82.1 (K), D86.1 (K), D91.1 (K), Q42.1 (B), R84.1
/TensSeconds/6Decoder/1: D98.2 (A), D99.2 (A), Q134.2 (E), R277.2, R278.1
/TensSeconds/6Decoder/2: D100.2 (A), D101.2 (A), D102.2 (A), D103.2 (A), D104.2 (A), Q136.2 (E), R281.2, R282.1
/TensSeconds/6Decoder/3: D105.2 (A), D106.2 (A), D107.2 (A), D108.2 (A), D109.2 (A), Q138.2 (E), R285.2, R286.1
/TensSeconds/6Decoder/4: D110.2 (A), D111.2 (A), D112.2 (A), D113.2 (A), Q140.2 (E), R289.2, R290.1
/TensSeconds/6Decoder/5: D114.2 (A), D115.2 (A), D116.2 (A), D117.2 (A), D118.2 (A), Q142.2 (E), R293.2, R294.1
/TensSeconds/6counter/RST: Q26.3 (C), R53.2, R272.1, R276.1, R280.1, R284.1, R288.1, R292.1
/TensSeconds/6counter/SCR_stage1/NEXT: C86.2, D306.1 (K), Q135.2 (E)
/TensSeconds/6counter/SCR_stage2/NEXT: C87.2, D307.1 (K), Q137.2 (E)
/TensSeconds/6counter/SCR_stage3/NEXT: C88.2, D308.1 (K), Q139.2 (E)
/TensSeconds/6counter/SCR_stage4/NEXT: C89.2, D309.1 (K), Q141.2 (E)
/TensSeconds/6counter/SCR_stage/IN: C90.2, D304.1 (K), Q131.2 (E)
/TensSeconds/6counter/SCR_stage/NEXT: C85.2, D305.1 (K), Q133.2 (E)
/TensSeconds/Div6_A: D92.1 (K), D100.1 (K), D105.1 (K), D114.1 (K), Q24.1 (B), R48.1
/TensSeconds/Div6_B: D93.1 (K), D98.1 (K), D101.1 (K), D106.1 (K), D110.1 (K), Q33.1 (B), R66.1
/TensSeconds/Div6_C: D94.1 (K), D99.1 (K), D107.1 (K), D111.1 (K), D115.1 (K), Q20.1 (B), R40.1
/TensSeconds/Div6_D: D95.1 (K), D102.1 (K), D108.1 (K), D116.1 (K), Q29.1 (B), R58.1
/TensSeconds/Div6_E: D96.1 (K), D103.1 (K), Q28.1 (B), R56.1
/TensSeconds/Div6_F: D97.1 (K), D112.1 (K), D117.1 (K), Q32.1 (B), R64.1
/TensSeconds/Div6_G: D104.1 (K), D109.1 (K), D113.1 (K), D118.1 (K), Q22.1 (B), R44.1
/Vref: C7.2, C22.2, C31.2, C39.2, C43.2, C57.2, Q1.2 (E), R3.1, R23.2, R27.2, R31.2, R35.2, R39.2, R63.2, R71.2, R77.2, R83.2, R89.2, R97.2, R103.2, R107.2, R113.2, R123.2, R135.2, R139.2, R147.2, R151.2, R157.2, R165.2, R167.2, R175.2, R179.2, R183.2, R189.2, R193.2, R207.2, R217.2, R221.2, R227.2, R246.2, R275.2, R279.2, R283.2, R287.2, R291.2, R295.2, R299.2, R303.2, R307.2, R311.2, R315.2, R319.2, R326.2, TP7.1
/clk_1hr: C41.1, D65.2 (A), D66.2 (A), D67.2 (A), D68.2 (A), D69.2 (A), D70.2 (A), D303.1 (K), D303.2 (A), D323.1 (K), Q144.2 (E), R297.2, R298.1, TP14.1
/clk_1min: D92.2 (A), D93.2 (A), D94.2 (A), D95.2 (A), D96.2 (A), D97.2 (A), D302.2 (A), Q132.2 (E), R273.2, R274.1, TP12.1
/clk_1s: C6.1, Q122.3 (C), R251.1, SW1.1, SW3.1, TP10.1
/clk_10min: C30.1, D150.2 (A), D151.2 (A), D152.2 (A), D153.2 (A), D154.2 (A), D155.2 (A), Q61.2 (E), R121.2, R122.1, TP13.1
/clk_10s: C21.1, D8.2 (A), D9.2 (A), D10.2 (A), D11.2 (A), D12.2 (A), D13.2 (A), Q11.2 (E), R21.2, R22.1, TP11.1
GND: C1.1, C2.2, C4.2, C5.1, C7.1, C13.2, C15.2, C17.2, C19.2, C20.1, C22.1, C27.2, C28.2, C29.1, C31.1, C36.2, C37.1, C39.1, C42.1, C43.1, C57.1, C58.2, C59.1, C67.2, C69.1, C70.1, C71.1, C72.2, C73.1, C76.2, C77.1, C79.2, C80.1, D57.2 (A), D123.2 (A), D137.2 (A), D147.2 (A), D262.2 (A), D292.2 (A), D296.2 (-), D297.2 (A), Q9.2 (E), Q26.2 (E), Q45.2 (E), Q59.2 (E), Q84.2 (E), Q97.2 (E), Q111.2 (E), Q115.2 (E), Q118.2 (E), Q121.2 (E), Q126.3 (C), Q158.2 (E), R2.2, R3.2, R4.2, R5.2, R6.2, R7.2, R8.2, R9.2, R10.2, R11.2, R12.2, R13.2, R14.2, R15.2, R16.2, R17.2, R22.2, R26.2, R30.2, R34.2, R38.2, R40.2, R41.2, R42.2, R43.2, R44.2, R45.2, R46.2, R47.2, R48.2, R49.2, R50.2, R51.2, R54.2, R55.2, R56.2, R57.2, R58.2, R59.2, R62.2, R64.2, R65.2, R66.2, R67.2, R70.2, R72.2, R73.2, R76.2, R78.2, R79.2, R82.2, R84.2, R85.2, R88.2, R92.2, R93.2, R96.2, R98.2, R99.2, R102.2, R106.2, R108.2, R109.2, R112.2, R114.2, R115.2, R116.2, R117.2, R122.2, R124.2, R125.2, R126.2, R127.2, R130.2, R131.2, R132.2, R133.2, R134.2, R138.2, R142.2, R143.2, R146.2, R150.2, R152.2, R153.2, R156.2, R158.2, R159.2, R160.2, R161.2, R164.2, R166.2, R170.2, R171.2, R174.2, R178.2, R182.2, R186.2, R187.2, R188.2, R192.2, R194.1, R196.1, R200.2, R201.2, R202.2, R203.2, R206.2, R208.2, R209.2, R210.2, R211.2, R212.2, R213.2, R216.2, R220.2, R226.2, R231.2, R239.2, R242.2, R245.2, R247.2, R250.2, R251.2, R255.2, R256.2, R262.1, R265.1, R274.2, R278.2, R282.2, R286.2, R290.2, R294.2, R298.2, R302.2, R306.2, R310.2, R314.2, R318.2, R320.2, R321.2, R325.2, R328.1, R330.2, R331.2, TP1.1, TP2.1, TP3.1, TP4.1
unnamed: C6.2, R18.1
unnamed: C21.2, R52.1
unnamed: C30.2, R90.1
unnamed: C38.2, R118.1
unnamed: C41.2, R168.1
unnamed: C56.2, R327.1
unnamed: C68.1, R233.2
unnamed: R252.2, R253.2
unnamed: D1.1 (K), Q2.3 (C)
unnamed: D2.1 (K), Q3.3 (C)
unnamed: D3.1 (K), Q4.3 (C)
unnamed: D4.1 (K), Q5.3 (C)
unnamed: D5.1 (K), Q6.3 (C)
unnamed: D6.1 (K), Q7.3 (C)
unnamed: D7.1 (K), Q8.3 (C)
unnamed: D57.1 (K), Q9.1 (B), R18.2
unnamed: C8.1, D58.2 (A), R20.2
unnamed: C9.1, D59.2 (A), R24.2
unnamed: C10.1, D60.2 (A), R28.2
unnamed: C12.1, D62.2 (A), R36.2
unnamed: D63.1 (K), Q20.3 (C)
unnamed: D64.1 (K), Q21.3 (C)
unnamed: D119.1 (K), Q22.3 (C)
unnamed: D120.1 (K), Q23.3 (C)
unnamed: D121.1 (K), Q24.3 (C)
unnamed: D122.1 (K), Q25.3 (C)
unnamed: D123.1 (K), Q26.1 (B), R52.2
unnamed: D124.1 (K), Q27.3 (C)
unnamed: D125.1 (K), Q28.3 (C)
unnamed: D126.1 (K), Q29.3 (C)
unnamed: C23.1, D127.2 (A), R60.2
unnamed: D128.1 (K), Q32.3 (C)
unnamed: D129.1 (K), Q33.3 (C)
unnamed: C24.1, D130.2 (A), R68.2
unnamed: D131.1 (K), Q36.3 (C)
unnamed: C25.1, D132.2 (A), R74.2
unnamed: D133.1 (K), Q39.3 (C)
unnamed: D135.1 (K), Q42.3 (C)
unnamed: D137.1 (K), Q45.1 (B), R90.2
unnamed: D138.1 (K), Q46.3 (C)
unnamed: C32.1, D139.2 (A), R94.2
unnamed: D140.1 (K), Q49.3 (C)
unnamed: C33.1, D141.2 (A), R100.2
unnamed: C34.1, D142.2 (A), R104.2
unnamed: D143.1 (K), Q54.3 (C)
unnamed: C35.1, D144.2 (A), R110.2
unnamed: D145.1 (K), Q57.3 (C)
unnamed: D146.1 (K), Q58.3 (C)
unnamed: D147.1 (K), Q59.1 (B), R118.2
unnamed: C40.1, D148.2 (A), R120.2
unnamed: D149.1 (K), Q62.3 (C)
unnamed: D199.1 (K), Q63.3 (C)
unnamed: D201.1 (K), Q65.3 (C)
unnamed: C3.1, D247.2 (A), R32.2
unnamed: C11.1, D248.2 (A), R80.2
unnamed: C14.1, D249.2 (A), R86.2
unnamed: C16.1, D250.2 (A), R128.2
unnamed: D251.1 (K), Q66.3 (C)
unnamed: C18.1, D252.2 (A), R136.2
unnamed: C26.1, D253.2 (A), R140.2
unnamed: D254.1 (K), Q71.3 (C)
unnamed: C47.1, D255.2 (A), R144.2
unnamed: C48.1, D256.2 (A), R148.2
unnamed: D257.1 (K), Q76.3 (C)
unnamed: C49.1, D258.2 (A), R154.2
unnamed: D259.1 (K), Q79.3 (C)
unnamed: D260.1 (K), Q80.3 (C)
unnamed: C50.1, D261.2 (A), R162.2
unnamed: D262.1 (K), Q84.1 (B), R168.2, R194.2
unnamed: D263.1 (K), Q85.3 (C)
unnamed: C44.1, D264.2 (A), R172.2
unnamed: C53.1, D265.2 (A), R176.2
unnamed: C45.1, D266.2 (A), R180.2
unnamed: C46.1, D267.2 (A), R184.2
unnamed: D268.1 (K), Q93.3 (C)
unnamed: C51.1, D269.2 (A), R190.2
unnamed: C52.1, D270.2 (A), R224.2
unnamed: D271.1 (K), D272.1 (K), D273.1 (K), D274.1 (K), D275.1 (K), D276.1 (K), D277.1 (K), D278.1 (K), D287.1 (K), Q97.3 (C), R197.2
unnamed: D279.1 (K), Q100.3 (C)
unnamed: D280.1 (K), Q101.3 (C)
unnamed: C62.1, D281.2 (A), R204.2
unnamed: D282.1 (K), Q104.3 (C)
unnamed: D283.1 (K), Q105.3 (C)
unnamed: D284.1 (K), Q106.3 (C)
unnamed: C63.1, D285.2 (A), R214.2
unnamed: C64.1, D286.2 (A), R218.2
unnamed: C54.1, D288.2 (A), R228.2
unnamed: C68.2, D289.2 (A), Q116.1 (B), R234.1
unnamed: D290.2 (A), R236.2
unnamed: D290.1 (K), Q117.2 (E)
unnamed: C55.1, D291.2 (A), R323.2
unnamed: D292.1 (K), Q158.1 (B), R327.2, R328.2
unnamed: D293.2 (A), R244.2
unnamed: D293.1 (K), Q120.2 (E)
unnamed: D296.1 (+), Q123.3 (C), Q125.2 (C), R252.1
unnamed: D297.1 (K), Q124.2 (E)
unnamed: D298.1 (K), R256.1
unnamed: C77.2, D299.2 (A), R257.2
unnamed: D299.1 (K), R258.1
unnamed: D300.2 (A), R261.1
unnamed: D300.1 (K), Q127.2 (E), R262.2
unnamed: D301.2 (A), SW3.2
unnamed: C85.1, D304.2 (A), R272.2
unnamed: C86.1, D305.2 (A), R276.2
unnamed: C87.1, D306.2 (A), R280.2
unnamed: C88.1, D307.2 (A), R284.2
unnamed: C89.1, D308.2 (A), R288.2
unnamed: C90.1, D309.2 (A), R292.2
unnamed: C91.1, D310.2 (A), R296.2
unnamed: C92.1, D311.2 (A), R300.2
unnamed: C93.1, D312.2 (A), R304.2
unnamed: C94.1, D313.2 (A), R308.2
unnamed: C95.1, D314.2 (A), R312.2
unnamed: C96.1, D315.2 (A), R316.2
unnamed: D323.2 (A), SW1.2
unnamed: C1.2, Q1.1 (B), R1.2, R2.1
unnamed: Q2.2 (E), R5.1
unnamed: Q3.2 (E), R7.1
unnamed: Q4.2 (E), R9.1
unnamed: Q5.2 (E), R11.1
unnamed: Q6.2 (E), R13.1
unnamed: Q7.2 (E), R15.1
unnamed: Q8.2 (E), R17.1
unnamed: Q10.1 (B), Q11.3 (C), R23.1
unnamed: Q10.3 (C), Q11.1 (B), R21.1
unnamed: Q12.1 (B), Q13.3 (C), R27.1
unnamed: Q12.3 (C), Q13.1 (B), R25.1
unnamed: Q14.1 (B), Q15.3 (C), R31.1
unnamed: Q14.3 (C), Q15.1 (B), R29.1
unnamed: Q16.1 (B), Q17.3 (C), R35.1
unnamed: Q16.3 (C), Q17.1 (B), R33.1
unnamed: Q18.1 (B), Q19.3 (C), R39.1
unnamed: Q18.3 (C), Q19.1 (B), R37.1
unnamed: Q20.2 (E), R41.1
unnamed: Q21.2 (E), R43.1
unnamed: Q22.2 (E), R45.1
unnamed: Q23.2 (E), R47.1
unnamed: Q24.2 (E), R49.1
unnamed: Q25.2 (E), R51.1
unnamed: Q27.2 (E), R55.1
unnamed: Q28.2 (E), R57.1
unnamed: Q29.2 (E), R59.1
unnamed: Q30.1 (B), Q31.3 (C), R63.1
unnamed: Q30.3 (C), Q31.1 (B), R61.1
unnamed: Q32.2 (E), R65.1
unnamed: Q33.2 (E), R67.1
unnamed: Q34.1 (B), Q35.3 (C), R71.1
unnamed: Q34.3 (C), Q35.1 (B), R69.1
unnamed: Q36.2 (E), R73.1
unnamed: Q37.1 (B), Q38.3 (C), R77.1
unnamed: Q37.3 (C), Q38.1 (B), R75.1
unnamed: Q39.2 (E), R79.1
unnamed: Q40.1 (B), Q41.3 (C), R83.1
unnamed: Q40.3 (C), Q41.1 (B), R81.1
unnamed: Q42.2 (E), R85.1
unnamed: Q43.1 (B), Q44.3 (C), R89.1
unnamed: Q43.3 (C), Q44.1 (B), R87.1
unnamed: Q46.2 (E), R93.1
unnamed: Q47.1 (B), Q48.3 (C), R97.1
unnamed: Q47.3 (C), Q48.1 (B), R95.1
unnamed: Q49.2 (E), R99.1
unnamed: Q50.1 (B), Q51.3 (C), R103.1
unnamed: Q50.3 (C), Q51.1 (B), R101.1
unnamed: Q52.1 (B), Q53.3 (C), R107.1
unnamed: Q52.3 (C), Q53.1 (B), R105.1
unnamed: Q54.2 (E), R109.1
unnamed: Q55.1 (B), Q56.3 (C), R113.1
unnamed: Q55.3 (C), Q56.1 (B), R111.1
unnamed: Q57.2 (E), R115.1
unnamed: Q58.2 (E), R117.1
unnamed: Q60.1 (B), Q61.3 (C), R123.1
unnamed: Q60.3 (C), Q61.1 (B), R121.1
unnamed: Q62.2 (E), R125.1
unnamed: Q63.2 (E), R127.1
unnamed: Q64.1 (B), Q67.3 (C), R135.1
unnamed: Q64.3 (C), Q67.1 (B), R129.1
unnamed: Q65.2 (E), R131.1
unnamed: Q66.2 (E), R133.1
unnamed: Q68.1 (B), Q69.3 (C), R139.1
unnamed: Q68.3 (C), Q69.1 (B), R137.1
unnamed: Q70.1 (B), Q83.3 (C), R167.1
unnamed: Q70.3 (C), Q83.1 (B), R141.1
unnamed: Q71.2 (E), R143.1
unnamed: Q72.1 (B), Q73.3 (C), R147.1
unnamed: Q72.3 (C), Q73.1 (B), R145.1
unnamed: Q74.1 (B), Q75.3 (C), R151.1
unnamed: Q74.3 (C), Q75.1 (B), R149.1
unnamed: Q76.2 (E), R153.1
unnamed: Q77.1 (B), Q78.3 (C), R157.1
unnamed: Q77.3 (C), Q78.1 (B), R155.1
unnamed: Q79.2 (E), R159.1
unnamed: Q80.2 (E), R161.1
unnamed: Q81.1 (B), Q82.3 (C), R165.1
unnamed: Q81.3 (C), Q82.1 (B), R163.1
unnamed: Q85.2 (E), R171.1
unnamed: Q86.1 (B), Q87.3 (C), R175.1
unnamed: Q86.3 (C), Q87.1 (B), R173.1
unnamed: Q88.1 (B), Q89.3 (C), R179.1
unnamed: Q88.3 (C), Q89.1 (B), R177.1
unnamed: Q90.1 (B), Q91.3 (C), R183.1
unnamed: Q90.3 (C), Q91.1 (B), R181.1
unnamed: Q92.1 (B), Q94.3 (C), R189.1
unnamed: Q92.3 (C), Q94.1 (B), R185.1
unnamed: Q93.2 (E), R187.1
unnamed: Q95.1 (B), Q96.3 (C), R193.1
unnamed: Q95.3 (C), Q96.1 (B), R191.1
unnamed: Q98.1 (B), R198.1, R199.2
unnamed: Q98.3 (C), R195.2
unnamed: Q99.1 (B), R222.1, R331.1
unnamed: Q99.3 (C), R199.1
unnamed: Q100.2 (E), R201.1
unnamed: Q101.2 (E), R203.1
unnamed: Q102.1 (B), Q103.3 (C), R207.1
unnamed: Q102.3 (C), Q103.1 (B), R205.1
unnamed: Q104.2 (E), R209.1
unnamed: Q105.2 (E), R211.1
unnamed: Q106.2 (E), R213.1
unnamed: Q107.1 (B), Q108.3 (C), R217.1
unnamed: Q107.3 (C), Q108.1 (B), R215.1
unnamed: Q109.1 (B), Q110.3 (C), R221.1
unnamed: Q109.3 (C), Q110.1 (B), R219.1
unnamed: Q111.1 (B), R223.1, R330.1
unnamed: Q99.2 (E), Q111.3 (C)
unnamed: Q112.1 (B), Q113.3 (C), R227.1
unnamed: Q112.3 (C), Q113.1 (B), R225.1
unnamed: Q114.1 (B), Q155.3 (C), R246.1
unnamed: Q114.3 (C), Q155.1 (B), R229.1
unnamed: Q115.1 (B), R230.2, R231.1
unnamed: Q115.3 (C), R232.2, R233.1
unnamed: C70.2, Q116.3 (C), R236.1
unnamed: Q116.2 (E), R235.1
unnamed: Q117.1 (B), Q118.3 (C), R238.2, R242.1
unnamed: Q117.3 (C), Q118.1 (B), R239.1
unnamed: C71.2, Q119.3 (C), R244.1
unnamed: Q119.2 (E), R243.1
unnamed: Q120.1 (B), Q121.3 (C), R237.2, R250.1
unnamed: Q120.3 (C), Q121.1 (B), R247.1
unnamed: Q122.1 (B), R248.2, R249.1
unnamed: Q123.1 (B), Q124.3 (C), R253.1
unnamed: Q123.2 (E), Q125.1 (B)
unnamed: Q124.1 (B), R254.2, R255.1
unnamed: Q126.1 (B), Q127.3 (C), R259.1
unnamed: C78.2, Q126.2 (E), R259.2, R260.1, R261.2, R263.1
unnamed: Q127.1 (B), R258.2
unnamed: C78.1, Q128.1 (B), R263.2, R264.1
unnamed: Q131.1 (B), Q132.3 (C), R275.1
unnamed: Q131.3 (C), Q132.1 (B), R273.1
unnamed: Q133.1 (B), Q134.3 (C), R279.1
unnamed: Q133.3 (C), Q134.1 (B), R277.1
unnamed: Q135.1 (B), Q136.3 (C), R283.1
unnamed: Q135.3 (C), Q136.1 (B), R281.1
unnamed: Q137.1 (B), Q138.3 (C), R287.1
unnamed: Q137.3 (C), Q138.1 (B), R285.1
unnamed: Q139.1 (B), Q140.3 (C), R291.1
unnamed: Q139.3 (C), Q140.1 (B), R289.1
unnamed: Q141.1 (B), Q142.3 (C), R295.1
unnamed: Q141.3 (C), Q142.1 (B), R293.1
unnamed: Q143.1 (B), Q144.3 (C), R299.1
unnamed: Q143.3 (C), Q144.1 (B), R297.1
unnamed: Q145.1 (B), Q146.3 (C), R303.1
unnamed: Q145.3 (C), Q146.1 (B), R301.1
unnamed: Q147.1 (B), Q148.3 (C), R307.1
unnamed: Q147.3 (C), Q148.1 (B), R305.1
unnamed: Q149.1 (B), Q150.3 (C), R311.1
unnamed: Q149.3 (C), Q150.1 (B), R309.1
unnamed: Q151.1 (B), Q152.3 (C), R315.1
unnamed: Q151.3 (C), Q152.1 (B), R313.1
unnamed: Q153.1 (B), Q154.3 (C), R319.1
unnamed: Q153.3 (C), Q154.1 (B), R317.1
unnamed: Q156.1 (B), Q157.3 (C), R326.1
unnamed: Q156.3 (C), Q157.1 (B), R324.1
unnamed: R237.1, R249.2
unnamed: R238.1, R241.2
VCC: C2.1, C4.1, C5.2, C13.1, C15.1, C17.1, C19.1, C20.2, C27.1, C28.1, C29.2, C36.1, C37.2, C42.2, C58.1, C59.2, C67.1, C69.2, C72.1, C73.2, C76.1, C79.1, C80.2, D289.1 (K), D298.2 (A), Q1.3 (C), Q98.2 (E), Q122.2 (E), Q125.3 (E), Q128.2 (E), R1.1, R19.1, R53.1, R91.1, R119.1, R169.1, R197.1, R198.2, R232.1, R234.2, R240.1, R248.1, R260.2, R264.2, R329.1, TP5.1
VD: D1.2 (A), D2.2 (A), D3.2 (A), D4.2 (A), D5.2 (A), D6.2 (A), D7.2 (A), D63.2 (A), D64.2 (A), D119.2 (A), D120.2 (A), D121.2 (A), D122.2 (A), D124.2 (A), D125.2 (A), D126.2 (A), D128.2 (A), D129.2 (A), D131.2 (A), D133.2 (A), D135.2 (A), D138.2 (A), D140.2 (A), D143.2 (A), D145.2 (A), D146.2 (A), D149.2 (A), D199.2 (A), D201.2 (A), D251.2 (A), D254.2 (A), D257.2 (A), D259.2 (A), D260.2 (A), D263.2 (A), D268.2 (A), D279.2 (A), D280.2 (A), D282.2 (A), D283.2 (A), D284.2 (A), D316.2 (A), D317.2 (A), TP6.1
