reivax-boucoi/PCB_Kicad/modPSU/MIC28517/MIC28517.kicad_pcb

## KiCad design modPSU/MIC28517/MIC28517.kicad_pcb (2023-09-26)

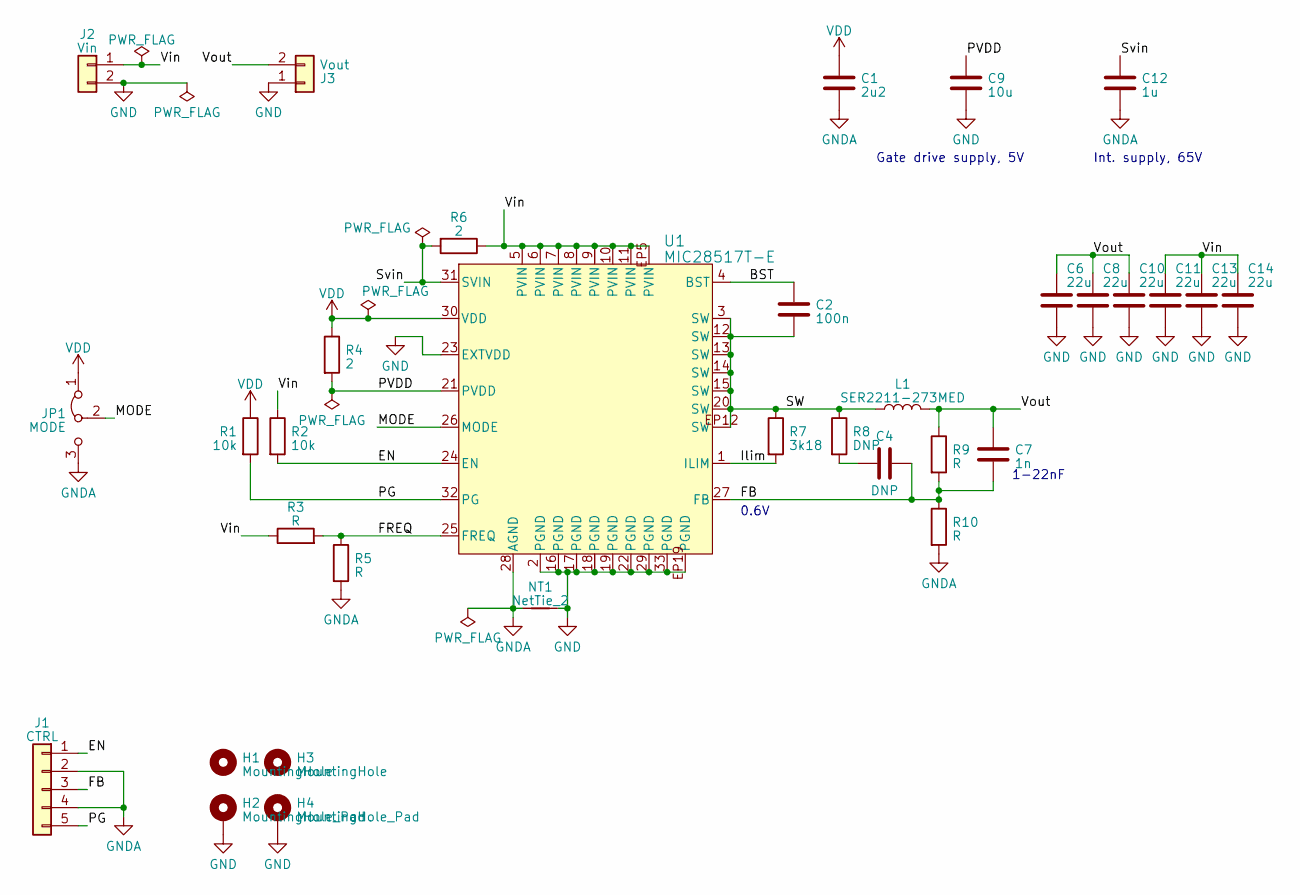
[picture p278: schematic MIC28517.kicad_sch, HV Buck]

Parts:
C1: 2u2; C_0805_2012Metric; Voltage 10
C2: 100n; C_0603_1608Metric; Voltage 100
C4: DNP; C_0603_1608Metric; Voltage 100
C6, C8, C10, C11, C13, C14: 22u; C_2220_5650Metric; Voltage 100
C7: 1n; C_0603_1608Metric; Voltage 100
C9: 10u; C_0805_2012Metric; Voltage 10
C12: 1u; C_0805_2012Metric; Voltage 100
H1, H3: MountingHole; MountingHole_4.3mm_M4
H2, H4: MountingHole_Pad; MountingHole_4.3mm_M4_Pad_Via
J1: CTRL; PinSocket_1x05_P2.54mm_Horizontal
J2: Vin; TerminalBlock_bornier-2_P5.08mm
J3: Vout; TerminalBlock_bornier-2_P5.08mm
JP1: MODE; SolderJumper-3_P1.3mm_Bridged12_RoundedPad1.0x1.5mm
L1: SER2211-273MED; SER2211_shielded_flatwire_L; Voltage 27u
NT1: NetTie_2; NetTie-2_SMD_Pad0.2mm
R1, R2: 10k; R_0603_1608Metric
R3, R5, R9, R10: R; R_0603_1608Metric
R4, R6: 2; R_0805_2012Metric
R7: 3k18; R_0603_1608Metric
R8: DNP; R_0603_1608Metric
U1: MIC28517T-E; MIC28517_VQFN32_EP_Lversion

Connections:
/BST: C2.1, U1.4 (BST)
/EN: J1.1, R2.2, U1.24 (EN)
/FB: C4.2, C7.2, J1.3, R9.2, R10.1, U1.27 (FB)
/FREQ: R3.2, R5.1, U1.25 (FREQ)
/Ilim: R7.2, U1.1 (ILIM)
/MODE: JP1.2 (C), U1.26 (MODE)
/PG: J1.5, R1.2, U1.32 (PG)
/PVDD: C9.1, R4.2, U1.21 (PVDD)
/SW: C2.2, L1.2, R7.1, R8.1, U1.3 (SW), U1.12 (SW), U1.13 (SW), U1.14 (SW), U1.15 (SW), U1.20 (SW), U1.EP12 (SW)
/Svin: C12.1, R6.2, U1.31 (SVIN)
/Vin: C11.1, C13.1, C14.1, J2.1, R2.1, R3.1, R6.1, U1.5 (PVIN), U1.6 (PVIN), U1.7 (PVIN), U1.8 (PVIN), U1.9 (PVIN), U1.10 (PVIN), U1.11 (PVIN), U1.EP5 (PVIN)
/Vout: C6.1, C7.1, C8.1, C10.1, J3.2, L1.1, R9.1
GND: C6.2, C8.2, C9.2, C10.2, C11.2, C13.2, C14.2, H2.1, H4.1, J2.2, J3.1, NT1.2, U1.2 (PGND), U1.16 (PGND), U1.17 (PGND), U1.18 (PGND), U1.19 (PGND), U1.22 (PGND), U1.23 (EXTVDD), U1.29 (PGND), U1.33 (PGND), U1.EP19 (PGND)
GNDA: C1.2, C12.2, J1.2, J1.4, JP1.3 (B), NT1.1, R5.2, R10.2, U1.28 (AGND)
unnamed: C4.1, R8.2
VDD: C1.1, JP1.1 (A), R1.1, R4.1, U1.30 (VDD)

Notes on the sheet:
Int. supply, 65V
0.6V
1-22nF
Gate drive supply, 5V

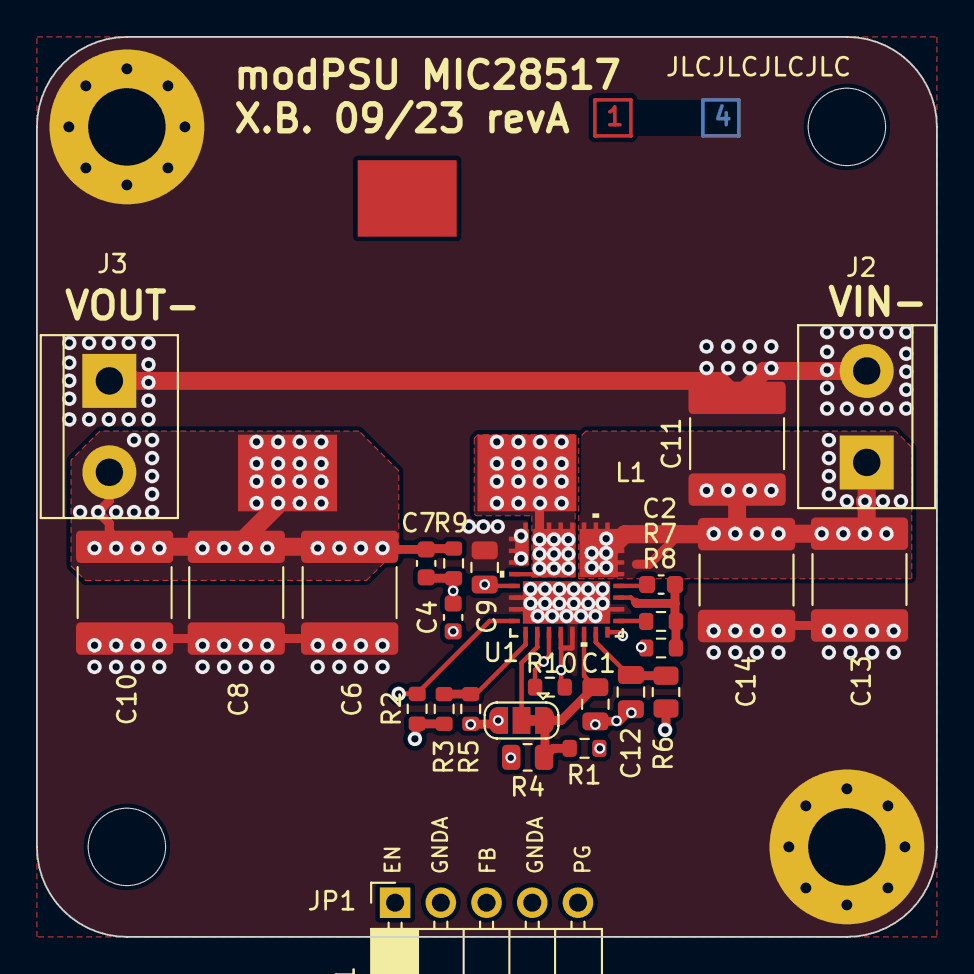
[picture p279: board MIC28517.kicad_pcb from above]

Board: 4 copper layers, 50.0 x 50.0 mm, 33 parts (0 on the bottom side), 16 nets.
