reivax-boucoi/PCB_Kicad/50W_LED_boost/led_boost/led_boost_MIC3230/led_boost_MIC3230.kicad_pcb

## KiCad design 50W_LED_boost/led_boost/led_boost_MIC3230/led_boost_MIC3230.kicad_pcb (2023-09-25)

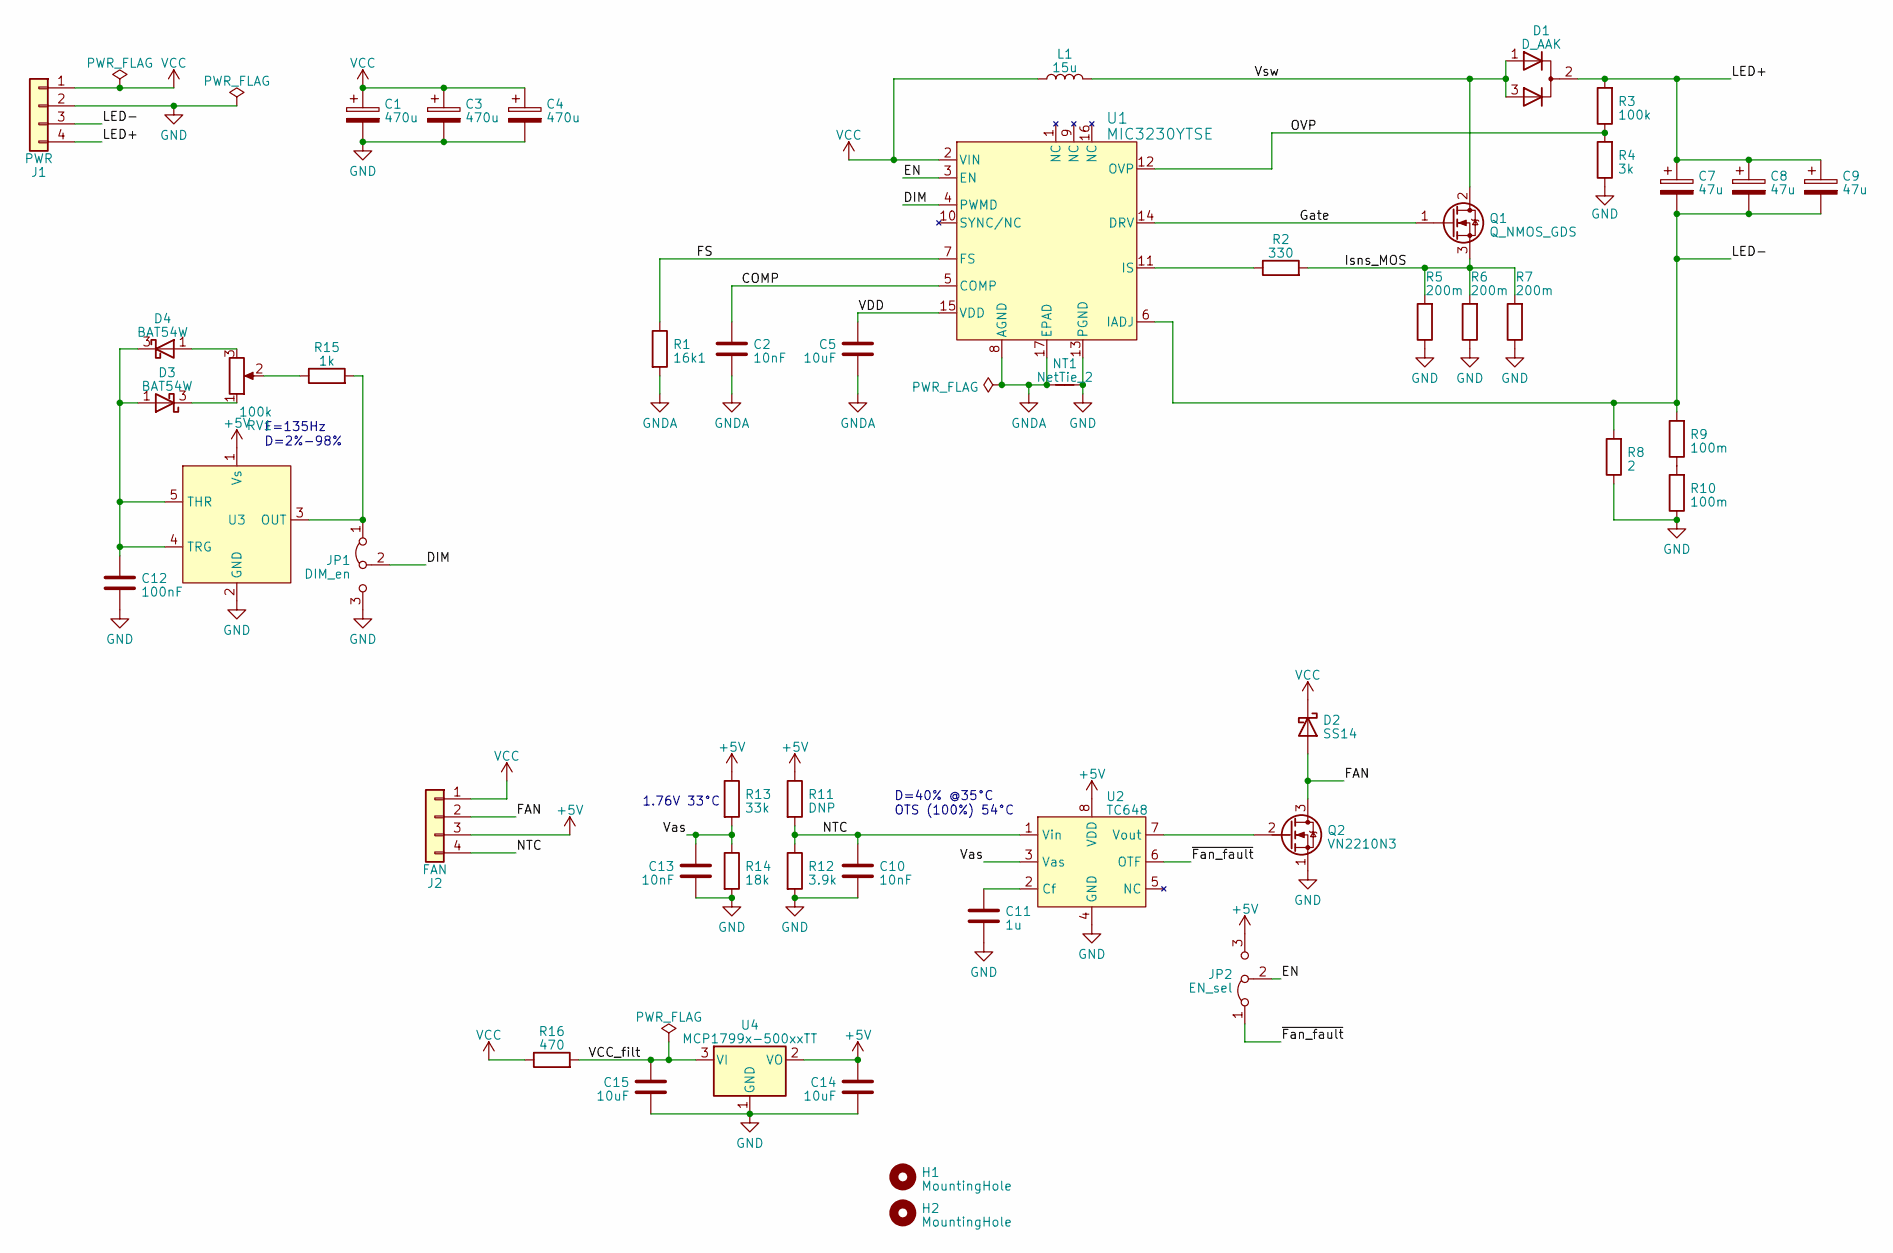
[picture p280: schematic led_boost_MIC3230.kicad_sch]

Parts:
C1, C3, C4: 470u; CP_Radial_D10.0mm_P5.00mm
C2, C10, C13: 10nF; C_0805_2012Metric_Pad1.18x1.45mm_HandSolder
C5, C14, C15: 10uF; C_0805_2012Metric_Pad1.18x1.45mm_HandSolder
C7, C8, C9: 47u; CP_Radial_D7.5mm_P2.50mm
C11: 1u; C_0805_2012Metric_Pad1.18x1.45mm_HandSolder
C12: 100nF; C_0805_2012Metric_Pad1.18x1.45mm_HandSolder
D1: D_AAK; TO-220-3_Vertical
D2: SS14; D_SMA
D3, D4: BAT54W; SOT-323_SC-70
H1, H2: MountingHole; MountingHole_3.2mm_M3
J1: PWR; 1986712-4_TE_Connectivity
J2: FAN; PinHeader_1x04_P2.54mm_Vertical
JP1: DIM_en; SolderJumper-3_P1.3mm_Bridged12_RoundedPad1.0x1.5mm
JP2: EN_sel; SolderJumper-3_P1.3mm_Bridged12_RoundedPad1.0x1.5mm
L1: 15u; PCV-1-153-10L
NT1: NetTie_2; NetTie-2_SMD_Pad0.5mm
Q1: Q_NMOS_GDS; TO-220-3_Vertical
Q2: VN2210N3; TO-92L_HandSolder
R1: 16k1; R_0603_1608Metric_Pad0.98x0.95mm_HandSolder
R2: 330; R_0603_1608Metric_Pad0.98x0.95mm_HandSolder
R3: 100k; R_0603_1608Metric_Pad0.98x0.95mm_HandSolder
R4: 3k; R_0603_1608Metric_Pad0.98x0.95mm_HandSolder
R5, R6, R7: 200m; R_2512_6332Metric
R8: 2; R_1210_3225Metric
R9, R10: 100m; R_1210_3225Metric
R11: DNP; R_0603_1608Metric_Pad0.98x0.95mm_HandSolder
R12: 3.9k; R_0603_1608Metric_Pad0.98x0.95mm_HandSolder
R13: 33k; R_0603_1608Metric_Pad0.98x0.95mm_HandSolder
R14: 18k; R_0603_1608Metric_Pad0.98x0.95mm_HandSolder
R15: 1k; R_0603_1608Metric_Pad0.98x0.95mm_HandSolder
R16: 470; R_0805_2012Metric
RV1: 100k; Potentiometer_oldTV_greyKnob
U1: MIC3230YTSE; TSSOP-16-1EP_4.4x5mm_P0.65mm
U2: TC648; SOIC-8_3.9x4.9mm_P1.27mm
U3: SOT-23-5_HandSoldering
U4: MCP1799x-500xxTT; SOT-23

Connections:
+5V: C14.1, J2.3, JP2.3 (B), R11.1, R13.1, U2.8 (VDD), U3.1 (Vs), U4.2 (VO)
/COMP: C2.1, U1.5 (COMP)
/DIM: JP1.2 (C), U1.4 (PWMD)
/EN: JP2.2 (C), U1.3 (EN)
/FAN: D2.2 (A), J2.2, Q2.3 (D)
/FS: R1.1, U1.7 (FS)
/Gate: Q1.1 (G), U1.14 (DRV)
/Isns_MOS: Q1.3 (S), R2.2, R5.2, R6.2, R7.2
/LED+: C7.1, C8.1, C9.1, D1.2 (A), J1.4, R3.2
/LED-: C7.2, C8.2, C9.2, J1.3, R8.2, R9.2, U1.6 (IADJ)
/NTC: C10.1, J2.4, R11.2, R12.1, U2.1 (Vin)
/OVP: R3.1, R4.2, U1.12 (OVP)
/VCC_filt: C15.1, R16.2, U4.3 (VI)
/VDD: C5.1, U1.15 (VDD)
/Vas: C13.1, R13.2, R14.1, U2.3 (Vas)
/Vsw: D1.1 (K), D1.3 (K), L1.2, Q1.2 (D)
/~Fan_fault: JP2.1 (A), U2.6 (OTF)
GND: C1.2, C3.2, C4.2, C10.2, C11.2, C12.2, C13.2, C14.2, C15.2, J1.2, JP1.3 (B), NT1.2, Q2.1 (S), R4.1, R5.1, R6.1, R7.1, R8.1, R10.1, R12.2, R14.2, U1.13 (PGND), U2.4 (GND), U3.2 (GND), U4.1 (GND)
GNDA: C2.2, C5.2, NT1.1, R1.2, U1.8 (AGND), U1.17 (EPAD)
unnamed: C12.1, D3.1 (A), D4.3 (K), U3.4 (TRG), U3.5 (THR)
unnamed: D3.3 (K), RV1.1
unnamed: D4.1 (A), RV1.3
unnamed: JP1.1 (A), R15.2, U3.3 (OUT)
unnamed: Q2.2 (G), U2.7 (Vout)
unnamed: R9.1, R10.2
unnamed: R15.1, RV1.2
unnamed: R2.1, U1.11 (IS)
unnamed: C11.1, U2.2 (Cf)
VCC: C1.1, C3.1, C4.1, D2.1 (K), J1.1, J2.1, L1.1, R16.1, U1.2 (VIN)

Notes on the sheet:
F=135Hz D=2%-98%
D=40% @35°C OTS (100%) 54°C
1.76V 33°C

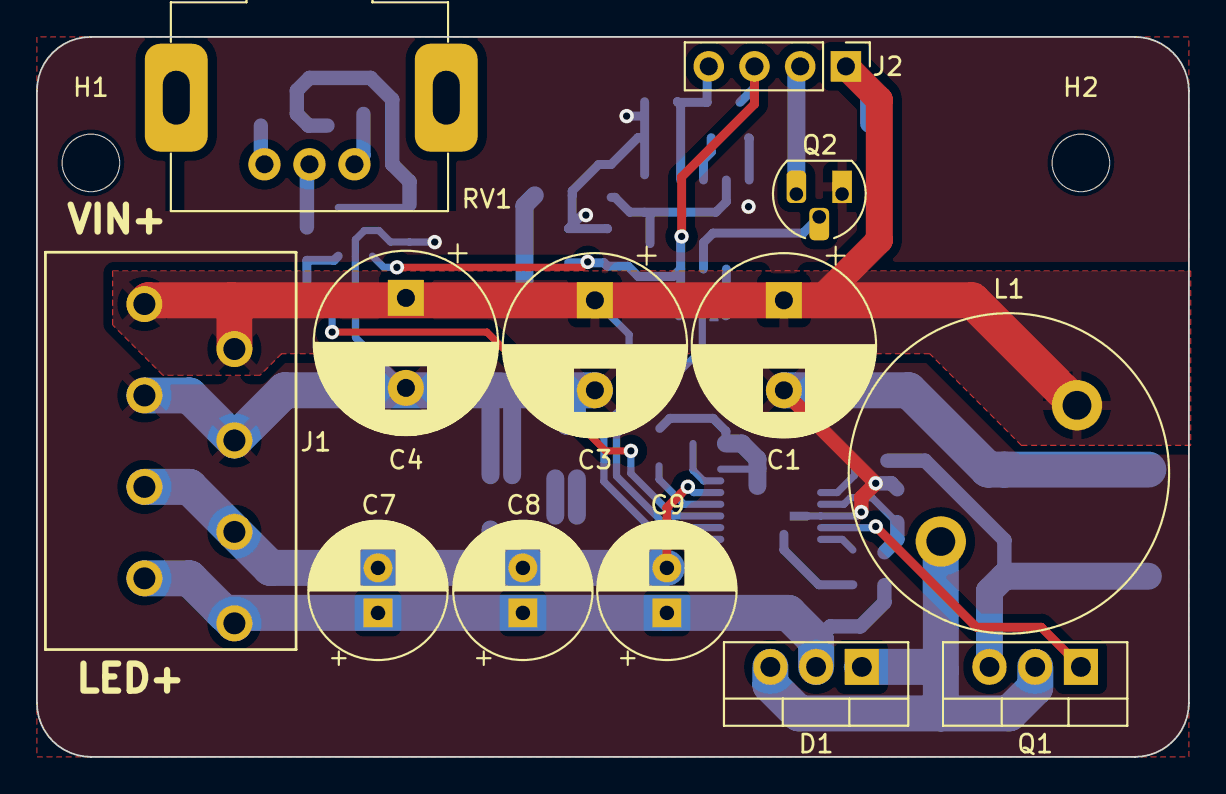
[picture p281: board led_boost_MIC3230.kicad_pcb from above]

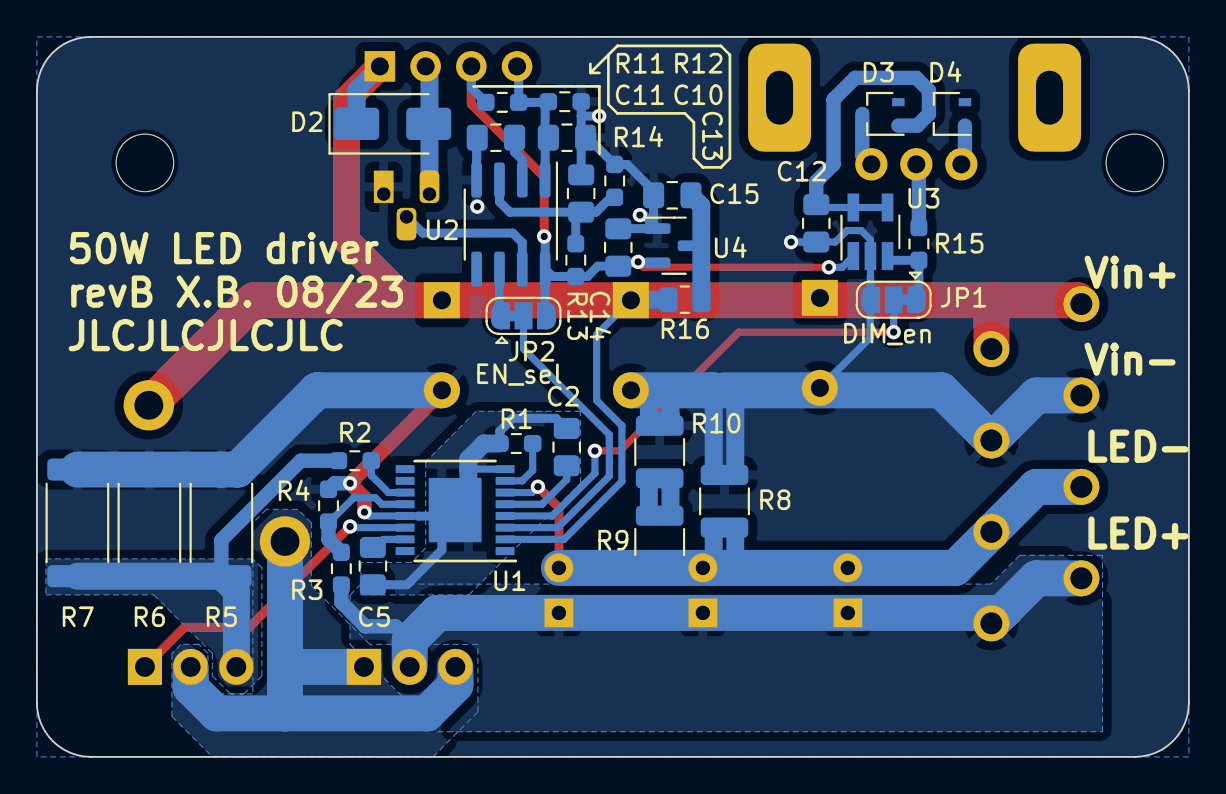
[picture p282: board led_boost_MIC3230.kicad_pcb from below]

Board: 2 copper layers, 64.0 x 40.0 mm, 49 parts (34 on the bottom side), 29 nets.
