reivax-boucoi/PCB_Kicad/RGB_strip_driver/RGB_strip_driver.kicad_pcb

## KiCad design RGB_strip_driver/RGB_strip_driver.kicad_pcb (2023-08-26)

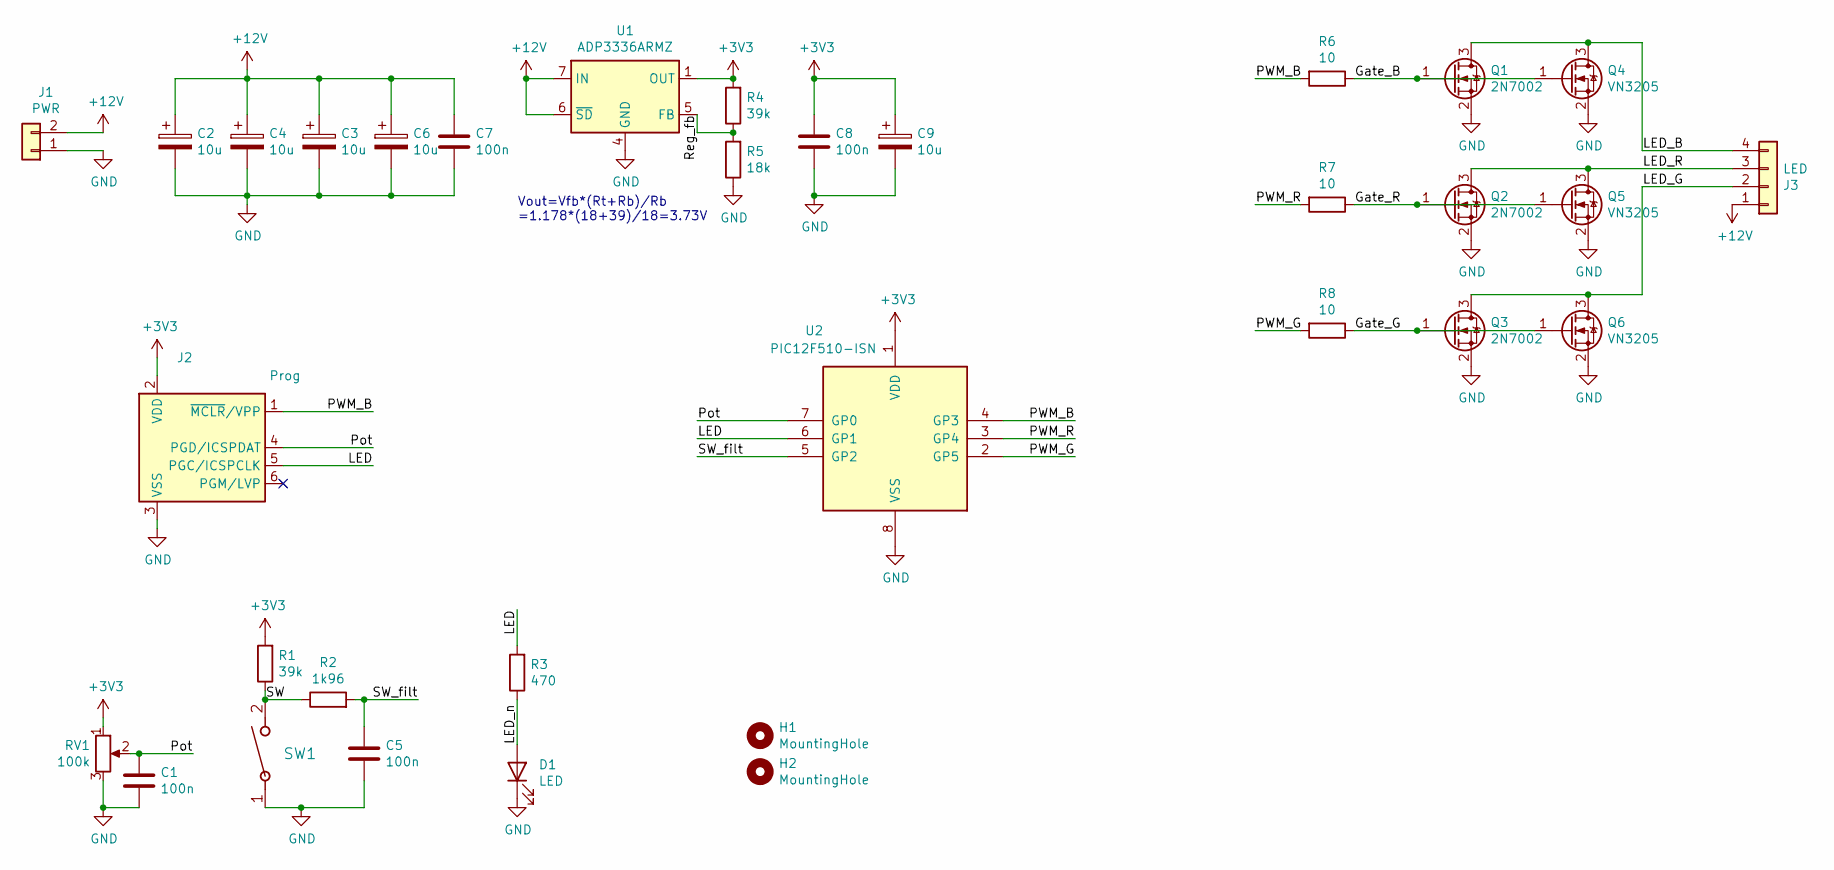
[picture p283: schematic RGB_strip_driver.kicad_sch]

Parts:
C1, C5, C7, C8: 100n; C_0603_1608Metric_Pad1.05x0.95mm_HandSolder
C2, C3, C4, C6, C9: 10u; C_1206_3216Metric_Pad1.42x1.75mm_HandSolder
D1: LED; LED_0805_2012Metric_Pad1.15x1.40mm_HandSolder
H1, H2: MountingHole; MountingHole_3.2mm_M3
J1: PWR; PinHeader_1x02_P2.54mm_Vertical
J2: Prog; Tag-Connect_TC2030-IDC-NL_2x03_P1.27mm_Vertical
J3: LED; PinHeader_1x04_P2.54mm_Vertical
Q1, Q2, Q3: 2N7002; SOT-23_Handsoldering
Q4, Q5, Q6: VN3205; SOT-89-3_Handsoldering
R1, R4: 39k; R_0603_1608Metric_Pad1.05x0.95mm_HandSolder
R2: 1k96; R_0603_1608Metric_Pad1.05x0.95mm_HandSolder
R3: 470; R_0603_1608Metric_Pad1.05x0.95mm_HandSolder
R5: 18k; R_0603_1608Metric_Pad1.05x0.95mm_HandSolder
R6, R7, R8: 10; R_0603_1608Metric_Pad1.05x0.95mm_HandSolder
RV1: 100k; Potentiometer_Piher_PT-10-H01_Horizontal
SW1: TL3330AF130QG; TL3330
U1: ADP3336ARMZ; MSOP-8_3x3mm_P0.65mm
U2: PIC12F510-ISN; SOIC-8_3.9x4.9mm_P1.27mm

Connections:
+3V3: C8.1, C9.1, J2.2 (VDD), R1.2, R4.2, RV1.1, U1.1 (OUT), U1.2 (OUT), U1.3 (OUT), U2.1 (VDD)
+12V: C2.1, C3.1, C4.1, C6.1, C7.1, J1.2, J3.1, U1.6 (~SD), U1.7 (IN), U1.8 (IN)
/Gate_B: Q1.1 (G), Q4.1 (G), R6.1
/Gate_G: Q3.1 (G), Q6.1 (G), R8.1
/Gate_R: Q2.1 (G), Q5.1 (G), R7.1
/LED: J2.5 (PGC/ICSPCLK), R3.2, U2.6 (GP1)
/LED_B: J3.4, Q1.3 (D), Q4.3 (D)
/LED_G: J3.2, Q3.3 (D), Q6.3 (D)
/LED_R: J3.3, Q2.3 (D), Q5.3 (D)
/LED_n: D1.2 (A), R3.1
/PWM_B: J2.1 (~MCLR/VPP), R6.2, U2.4 (GP3)
/PWM_G: R8.2, U2.2 (GP5)
/PWM_R: R7.2, U2.3 (GP4)
/Pot: C1.1, J2.4 (PGD/ICSPDAT), RV1.2, U2.7 (GP0)
/Reg_fb: R4.1, R5.2, U1.5 (FB)
/SW: R1.1, R2.1, SW1.2
/SW_filt: C5.1, R2.2, U2.5 (GP2)
GND: C1.2, C2.2, C3.2, C4.2, C5.2, C6.2, C7.2, C8.2, C9.2, D1.1 (K), J1.1, J2.3 (VSS), Q1.2 (S), Q2.2 (S), Q3.2 (S), Q4.2 (S), Q5.2 (S), Q6.2 (S), R5.1, RV1.3, SW1.1, U1.4 (GND), U2.8 (VSS)

Notes on the sheet:
Vout=Vfb*(Rt+Rb)/Rb =1.178*(18+39)/18=3.73V

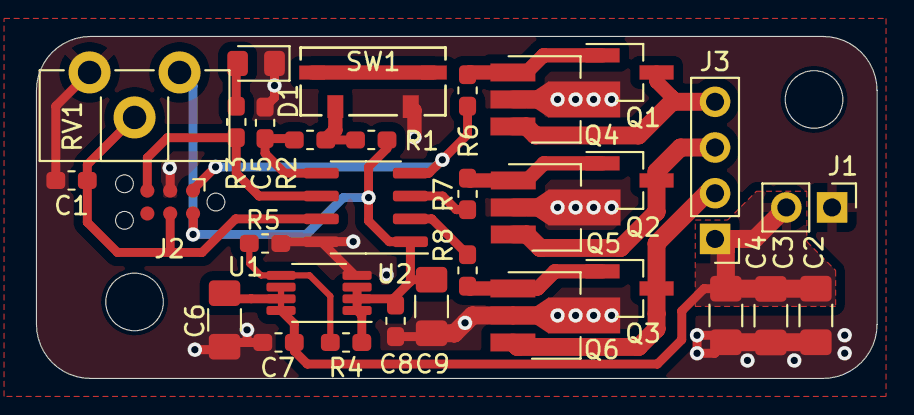
[picture p284: board RGB_strip_driver.kicad_pcb from above]

Board: 2 copper layers, 46.7 x 19.0 mm, 33 parts (0 on the bottom side), 18 nets.
