reivax-boucoi/PCB_Kicad/relay_brd/relay_brd.kicad_pcb

## KiCad design relay_brd/relay_brd.kicad_pcb (2023-04-11)

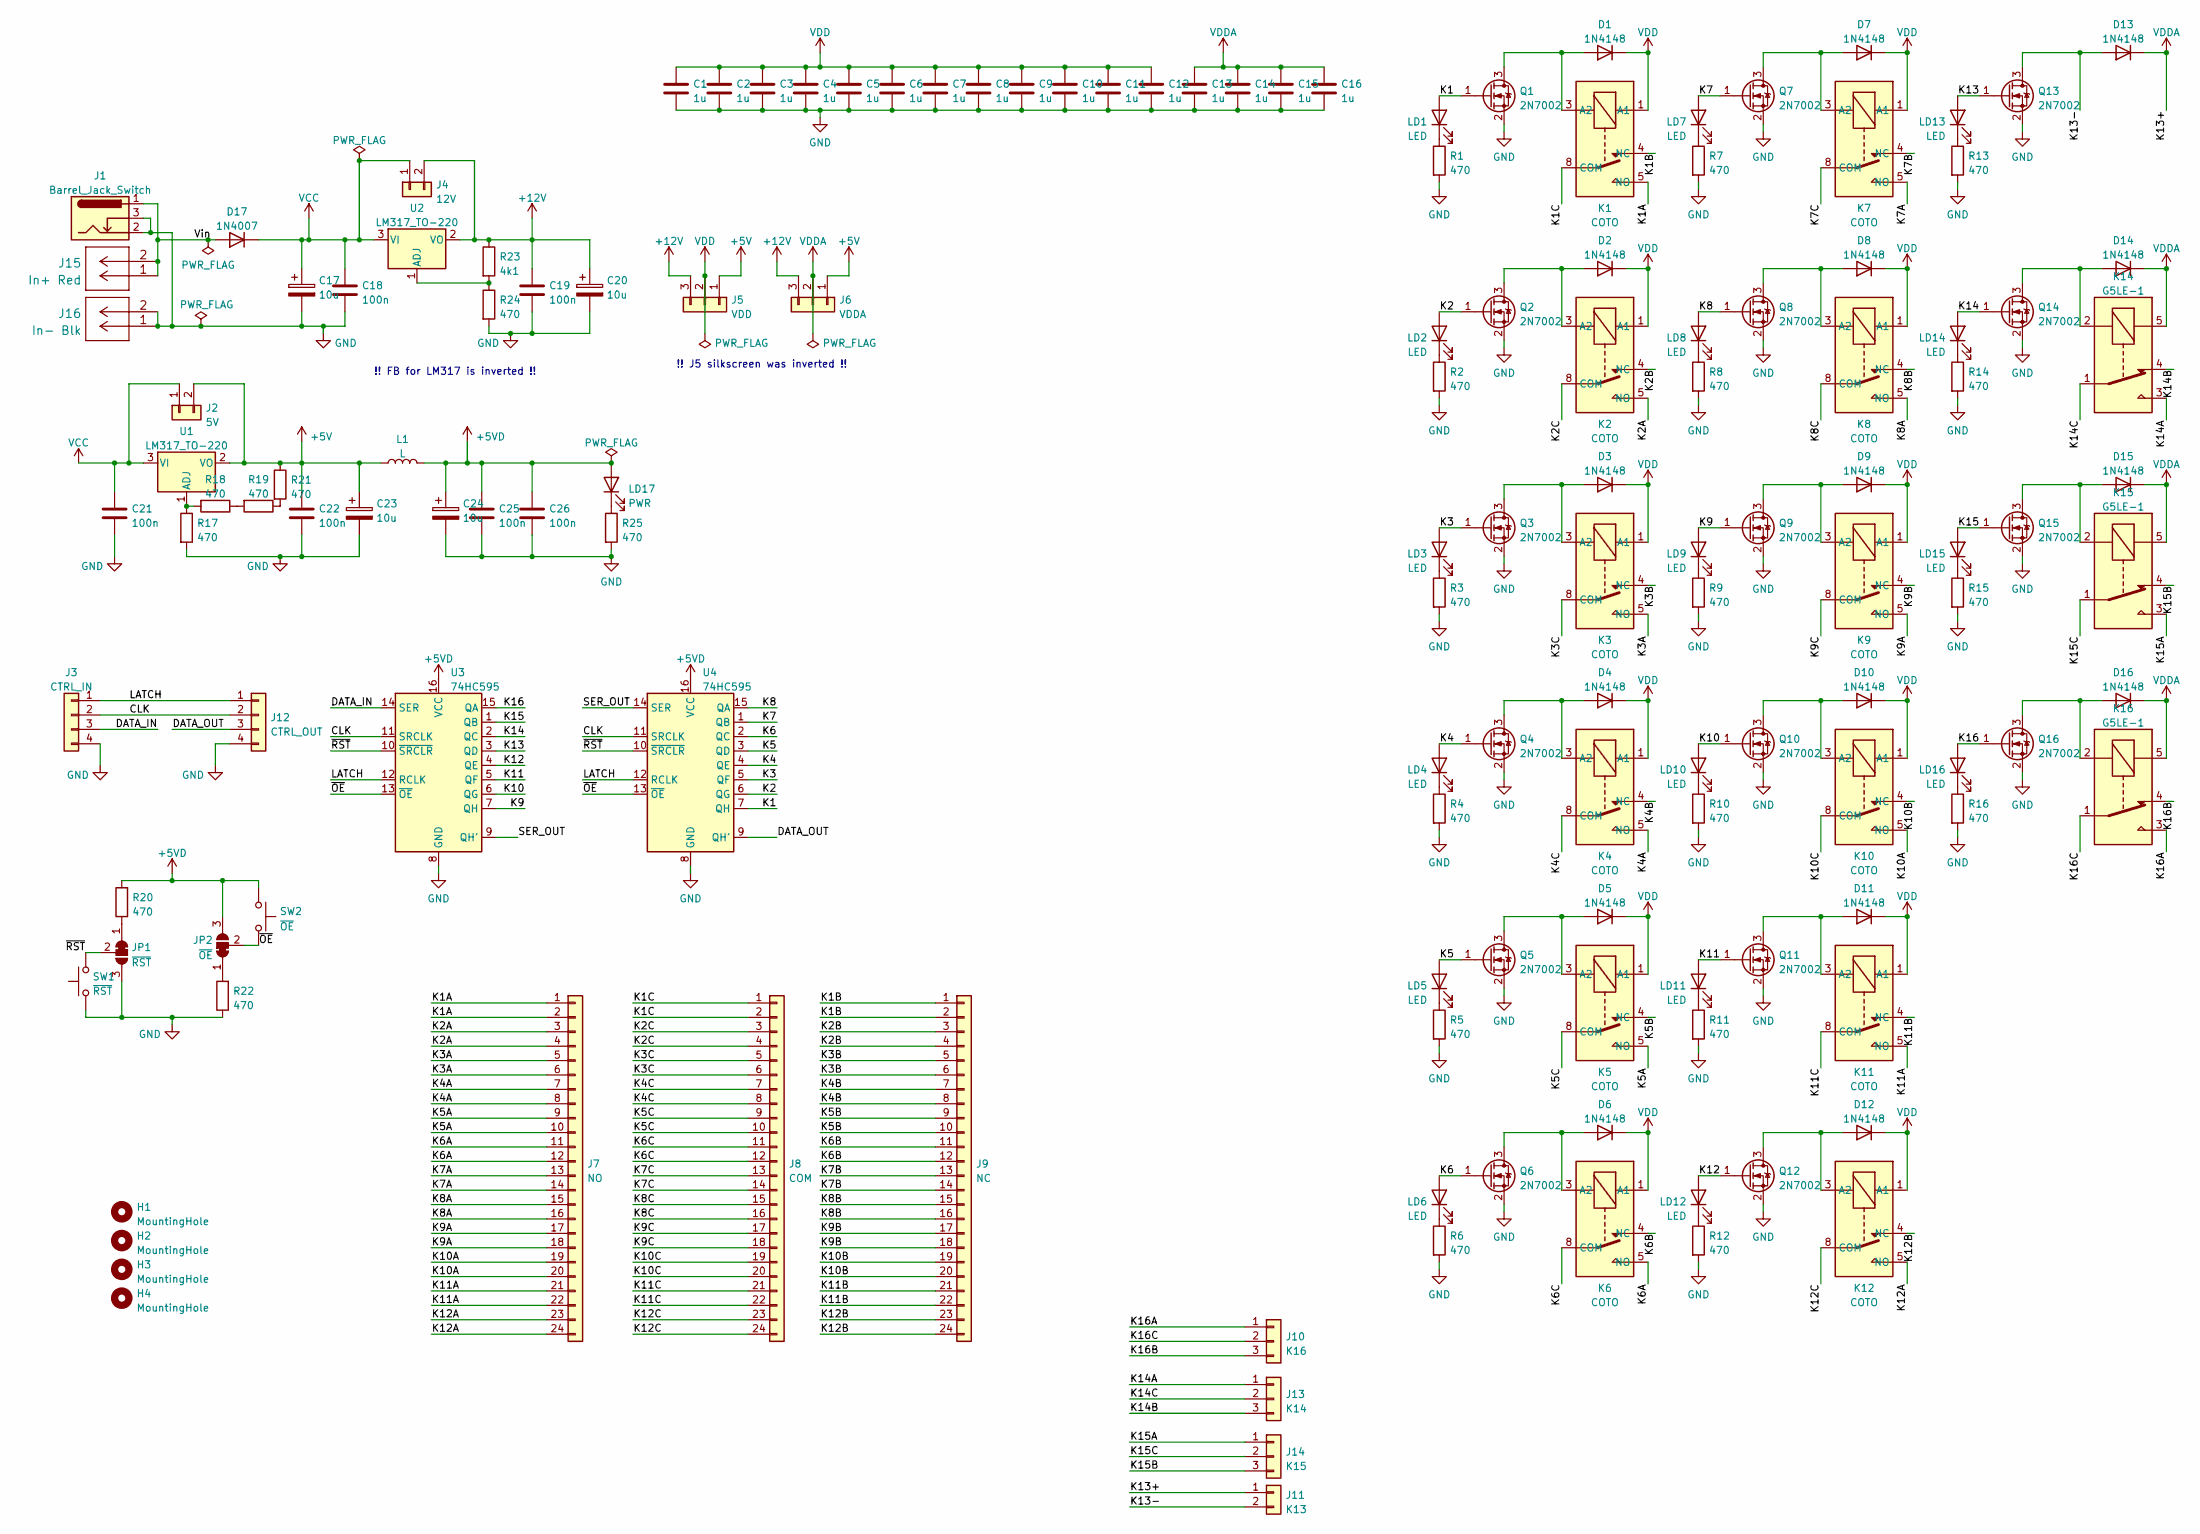
[picture p285: schematic relay_brd.kicad_sch, Serial Relay Board]

Parts:
C1, C2, C3, C4, C5, C6, C7, C8, C9, C10, C11, C12, C13, C14, C15, C16: 1u; C_0805_2012Metric
C17, C20, C23, C24: 10u; CP_Radial_D8.0mm_P3.50mm
C18, C19, C21, C22, C25, C26: 100n; C_0603_1608Metric
D1, D2, D3, D4, D5, D6, D7, D8, D9, D10, D11, D12, D13, D14, D15, D16: 1N4148; D_SOD-123
D17: 1N4007; D_DO-41_SOD81_P10.16mm_Horizontal
H1, H2, H3, H4: MountingHole; MountingHole_4.3mm_M4
J1: Barrel_Jack_Switch; BarrelJack_Horizontal
J2: 5V; PinHeader_1x02_P2.54mm_Vertical
J3: CTRL_IN; PinHeader_1x04_P2.54mm_Vertical
J4: 12V; PinHeader_1x02_P2.54mm_Vertical
J5: VDD; PinHeader_1x03_P2.54mm_Vertical
J6: VDDA; PinHeader_1x03_P2.54mm_Vertical
J7: NO; PinHeader_1x24_P2.54mm_Vertical
J8: COM; PinHeader_1x24_P2.54mm_Vertical
J9: NC; PinHeader_1x24_P2.54mm_Vertical
J10: K16; PinHeader_1x03_P2.54mm_Vertical
J11: K13; PinHeader_1x02_P2.54mm_Vertical
J12: CTRL_OUT; PinHeader_1x04_P2.54mm_Vertical
J13: K14; PinHeader_1x03_P2.54mm_Vertical
J14: K15; PinHeader_1x03_P2.54mm_Vertical
J15: In+ Red; 571-0100_Red
J16: In- Blk; 571-0100_Black
JP1: ~{RST}; SolderJumper-3_P1.3mm_Bridged12_RoundedPad1.0x1.5mm_NumberL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
JP2: ~{OE}; SolderJumper-3_P1.3mm_Bridged12_RoundedPad1.0x1.5mm_NumberL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
K1, K2, K3, K4, K5, K6, K7, K8, K9, K10, K11, K12: COTO; COTO-2900
K14, K15, K16: G5LE-1; Relay_SPDT_Omron-G5LE-1
L1: L; L_Axial_L7.0mm_D3.3mm_P12.70mm_Horizontal_Fastron_MICC
LD1, LD2, LD3, LD4, LD5, LD6, LD7, LD8, LD9, LD10, LD11, LD12, LD13, LD14, LD15, LD16: LED; LED_0805_2012Metric
LD17: PWR; LED_0805_2012Metric
Q1, Q2, Q3, Q4, Q5, Q6, Q7, Q8, Q9, Q10, Q11, Q12, Q13, Q14, Q15, Q16: 2N7002; SOT-23
R1, R2, R3, R4, R5, R6, R7, R8, R9, R10, R11, R12, R13, R14, R15, R16, R17, R18, R19, R20, R21, R22, R24, R25: 470; R_0603_1608Metric
R23: 4k1; R_0603_1608Metric
SW1: ~{RST}; SW_PUSH_6mm
SW2: ~{OE}; SW_PUSH_6mm
U1, U2: LM317_TO-220; TO-220-3_Vertical
U3, U4: 74HC595; DIP-16_W7.62mm_Socket_LongPads

Connections:
+5V: C22.1, C23.1, J2.2, J5.1, J6.1, L1.1, R21.1, U1.2 (VO)
+5VD: C24.1, C25.1, C26.1, JP2.3 (B), L1.2, LD17.2 (A), R20.2, SW2.2, U3.16 (VCC), U4.16 (VCC)
+12V: C19.1, C20.1, J4.2, J5.3, J6.3, R23.1, U2.2 (VO)
/CLK: J3.2, J12.2, U3.11 (SRCLK), U4.11 (SRCLK)
/DATA_IN: J3.3, U3.14 (SER)
/DATA_OUT: J12.3, U4.9 (QH')
/K1: LD1.2 (A), Q1.1 (G), U4.7 (QH)
/K1A: J7.1, J7.2, K1.5 (NO)
/K1B: J9.1, J9.2, K1.4 (NC)
/K1C: J8.1, J8.2, K1.8 (COM)
/K2: LD2.2 (A), Q2.1 (G), U4.6 (QG)
/K2A: J7.3, J7.4, K2.5 (NO)
/K2B: J9.3, J9.4, K2.4 (NC)
/K2C: J8.3, J8.4, K2.8 (COM)
/K3: LD3.2 (A), Q3.1 (G), U4.5 (QF)
/K3A: J7.5, J7.6, K3.5 (NO)
/K3B: J9.5, J9.6, K3.4 (NC)
/K3C: J8.5, J8.6, K3.8 (COM)
/K4: LD4.2 (A), Q4.1 (G), U4.4 (QE)
/K4A: J7.7, J7.8, K4.5 (NO)
/K4B: J9.7, J9.8, K4.4 (NC)
/K4C: J8.7, J8.8, K4.8 (COM)
/K5: LD5.2 (A), Q5.1 (G), U4.3 (QD)
/K5A: J7.9, J7.10, K5.5 (NO)
/K5B: J9.9, J9.10, K5.4 (NC)
/K5C: J8.9, J8.10, K5.8 (COM)
/K6: LD6.2 (A), Q6.1 (G), U4.2 (QC)
/K6A: J7.11, J7.12, K6.5 (NO)
/K6B: J9.11, J9.12, K6.4 (NC)
/K6C: J8.11, J8.12, K6.8 (COM)
/K7: LD7.2 (A), Q7.1 (G), U4.1 (QB)
/K7A: J7.13, J7.14, K7.5 (NO)
/K7B: J9.13, J9.14, K7.4 (NC)
/K7C: J8.13, J8.14, K7.8 (COM)
/K8: LD8.2 (A), Q8.1 (G), U4.15 (QA)
/K8A: J7.15, J7.16, K8.5 (NO)
/K8B: J9.15, J9.16, K8.4 (NC)
/K8C: J8.15, J8.16, K8.8 (COM)
/K9: LD9.2 (A), Q9.1 (G), U3.7 (QH)
/K9A: J7.17, J7.18, K9.5 (NO)
/K9B: J9.17, J9.18, K9.4 (NC)
/K9C: J8.17, J8.18, K9.8 (COM)
/K10: LD10.2 (A), Q10.1 (G), U3.6 (QG)
/K10A: J7.19, J7.20, K10.5 (NO)
/K10B: J9.19, J9.20, K10.4 (NC)
/K10C: J8.19, J8.20, K10.8 (COM)
/K11: LD11.2 (A), Q11.1 (G), U3.5 (QF)
/K11A: J7.21, J7.22, K11.5 (NO)
/K11B: J9.21, J9.22, K11.4 (NC)
/K11C: J8.21, J8.22, K11.8 (COM)
/K12: LD12.2 (A), Q12.1 (G), U3.4 (QE)
/K12A: J7.23, J7.24, K12.5 (NO)
/K12B: J9.23, J9.24, K12.4 (NC)
/K12C: J8.23, J8.24, K12.8 (COM)
/K13: LD13.2 (A), Q13.1 (G), U3.3 (QD)
/K13-: D13.2 (A), J11.2, Q13.3 (D)
/K14: LD14.2 (A), Q14.1 (G), U3.2 (QC)
/K14A: J13.1, K14.3
/K14B: J13.3, K14.4
/K14C: J13.2, K14.1
/K15: LD15.2 (A), Q15.1 (G), U3.1 (QB)
/K15A: J14.1, K15.3
/K15B: J14.3, K15.4
/K15C: J14.2, K15.1
/K16: LD16.2 (A), Q16.1 (G), U3.15 (QA)
/K16A: J10.1, K16.3
/K16B: J10.3, K16.4
/K16C: J10.2, K16.1
/LATCH: J3.1, J12.1, U3.12 (RCLK), U4.12 (RCLK)
/SER_OUT: U3.9 (QH'), U4.14 (SER)
/Vin: D17.2 (A), J1.1, J15.1, J15.2
/~OE: JP2.2 (C), SW2.1, U3.13 (~OE), U4.13 (~OE)
/~RST: JP1.2 (C), SW1.2, U3.10 (~SRCLR), U4.10 (~SRCLR)
GND: C1.2, C2.2, C3.2, C4.2, C5.2, C6.2, C7.2, C8.2, C9.2, C10.2, C11.2, C12.2, C13.2, C14.2, C15.2, C16.2, C17.2, C18.2, C19.2, C20.2, C21.2, C22.2, C23.2, C24.2, C25.2, C26.2, J1.2, J1.3, J3.4, J12.4, J16.1, J16.2, JP1.3 (B), Q1.2 (S), Q2.2 (S), Q3.2 (S), Q4.2 (S), Q5.2 (S), Q6.2 (S), Q7.2 (S), Q8.2 (S), Q9.2 (S), Q10.2 (S), Q11.2 (S), Q12.2 (S), Q13.2 (S), Q14.2 (S), Q15.2 (S), Q16.2 (S), R1.2, R2.2, R3.2, R4.2, R5.2, R6.2, R7.2, R8.2, R9.2, R10.2, R11.2, R12.2, R13.2, R14.2, R15.2, R16.2, R17.2, R22.1, R24.2, R25.2, SW1.1, U3.8 (GND), U4.8 (GND)
unnamed: D1.2 (A), K1.3 (A2), Q1.3 (D)
unnamed: D2.2 (A), K2.3 (A2), Q2.3 (D)
unnamed: D3.2 (A), K3.3 (A2), Q3.3 (D)
unnamed: D4.2 (A), K4.3 (A2), Q4.3 (D)
unnamed: D5.2 (A), K5.3 (A2), Q5.3 (D)
unnamed: D6.2 (A), K6.3 (A2), Q6.3 (D)
unnamed: D7.2 (A), K7.3 (A2), Q7.3 (D)
unnamed: D8.2 (A), K8.3 (A2), Q8.3 (D)
unnamed: D9.2 (A), K9.3 (A2), Q9.3 (D)
unnamed: D10.2 (A), K10.3 (A2), Q10.3 (D)
unnamed: D11.2 (A), K11.3 (A2), Q11.3 (D)
unnamed: D12.2 (A), K12.3 (A2), Q12.3 (D)
unnamed: D14.2 (A), K14.2, Q14.3 (D)
unnamed: D15.2 (A), K15.2, Q15.3 (D)
unnamed: D16.2 (A), K16.2, Q16.3 (D)
unnamed: JP1.1 (A), R20.1
unnamed: JP2.1 (A), R22.2
unnamed: LD1.1 (K), R1.1
unnamed: LD2.1 (K), R2.1
unnamed: LD3.1 (K), R3.1
unnamed: LD4.1 (K), R4.1
unnamed: LD5.1 (K), R5.1
unnamed: LD6.1 (K), R6.1
unnamed: LD7.1 (K), R7.1
unnamed: LD8.1 (K), R8.1
unnamed: LD9.1 (K), R9.1
unnamed: LD10.1 (K), R10.1
unnamed: LD11.1 (K), R11.1
unnamed: LD12.1 (K), R12.1
unnamed: LD13.1 (K), R13.1
unnamed: LD14.1 (K), R14.1
unnamed: LD15.1 (K), R15.1
unnamed: LD16.1 (K), R16.1
unnamed: LD17.1 (K), R25.1
unnamed: R17.1, R18.2, U1.1 (ADJ)
unnamed: R18.1, R19.2
unnamed: R19.1, R21.2
unnamed: R23.2, R24.1, U2.1 (ADJ)
VCC: C17.1, C18.1, C21.1, D17.1 (K), J2.1, J4.1, U1.3 (VI), U2.3 (VI)
VDD: C1.1, C2.1, C3.1, C4.1, C5.1, C6.1, C7.1, C8.1, C9.1, C10.1, C11.1, C12.1, D1.1 (K), D2.1 (K), D3.1 (K), D4.1 (K), D5.1 (K), D6.1 (K), D7.1 (K), D8.1 (K), D9.1 (K), D10.1 (K), D11.1 (K), D12.1 (K), J5.2, K1.1 (A1), K2.1 (A1), K3.1 (A1), K4.1 (A1), K5.1 (A1), K6.1 (A1), K7.1 (A1), K8.1 (A1), K9.1 (A1), K10.1 (A1), K11.1 (A1), K12.1 (A1)
VDDA: C13.1, C14.1, C15.1, C16.1, D13.1 (K), D14.1 (K), D15.1 (K), D16.1 (K), J6.2, J11.1, K14.5, K15.5, K16.5

Notes on the sheet:
!! J5 silkscreen was inverted !!
!! FB for LM317 is inverted !!

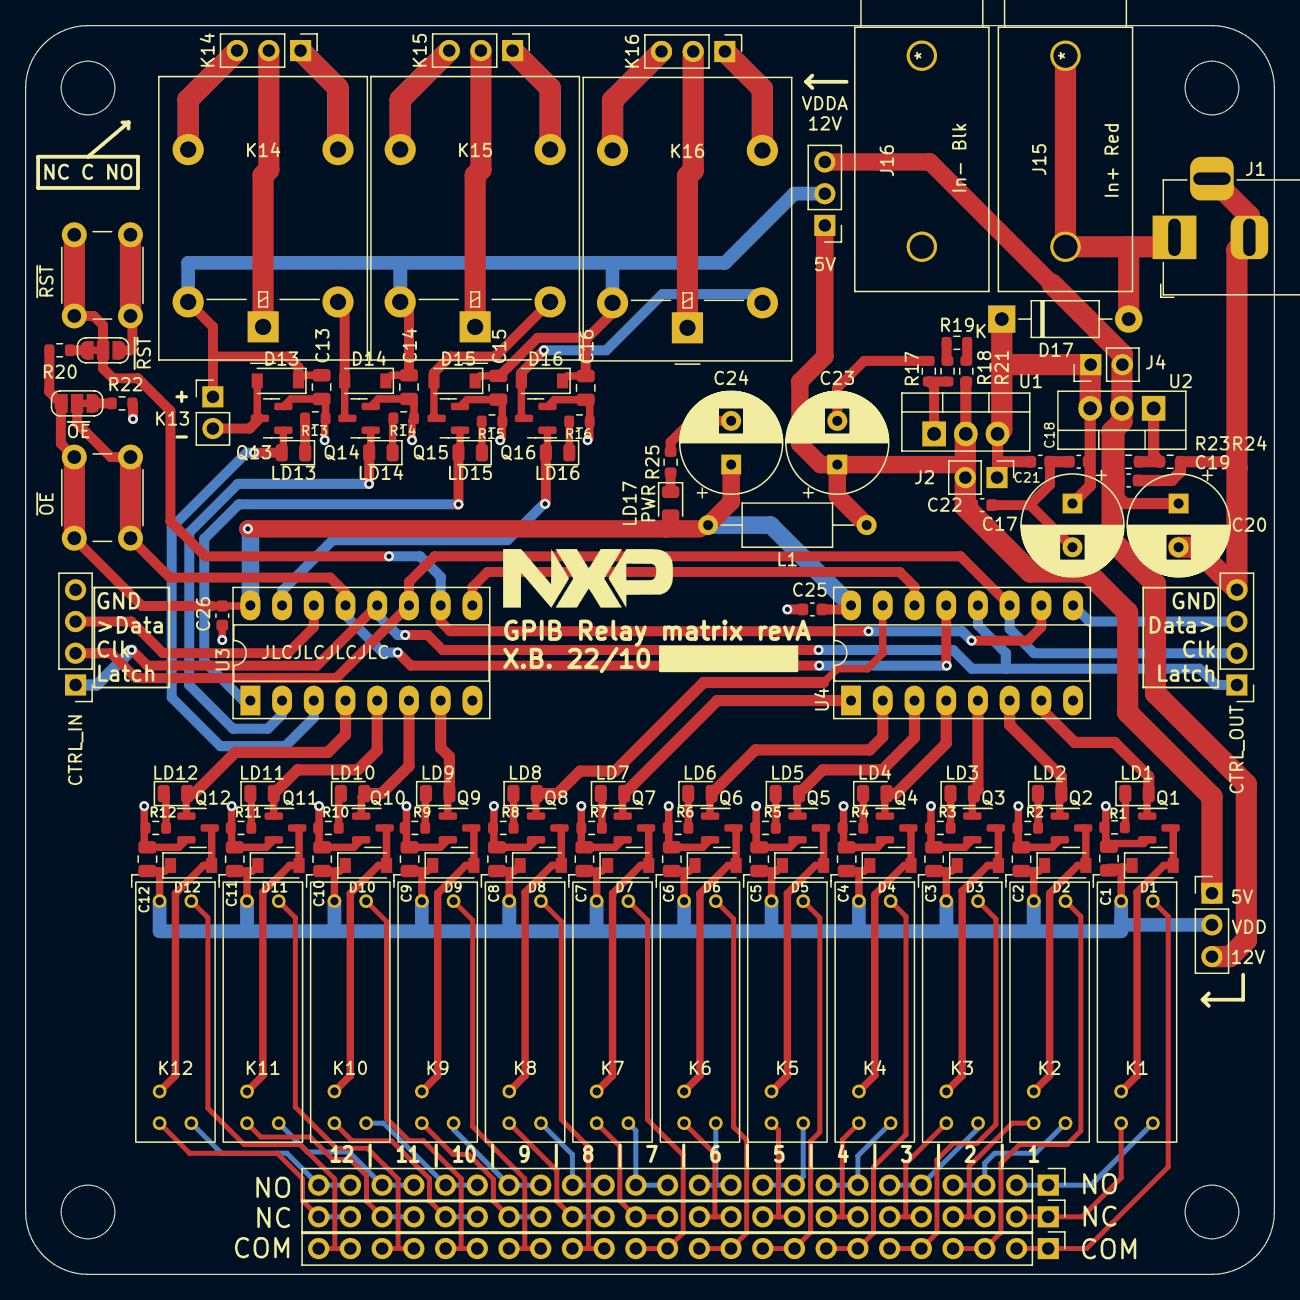
[picture p286: board relay_brd.kicad_pcb from above]

Board: 2 copper layers, 100.0 x 100.0 mm, 145 parts (0 on the bottom side), 115 nets.
