reivax-boucoi/PCB_Kicad/opposition_bench/opposition_bench.kicad_pcb

## KiCad design opposition_bench/opposition_bench.kicad_pcb (2023-04-11)

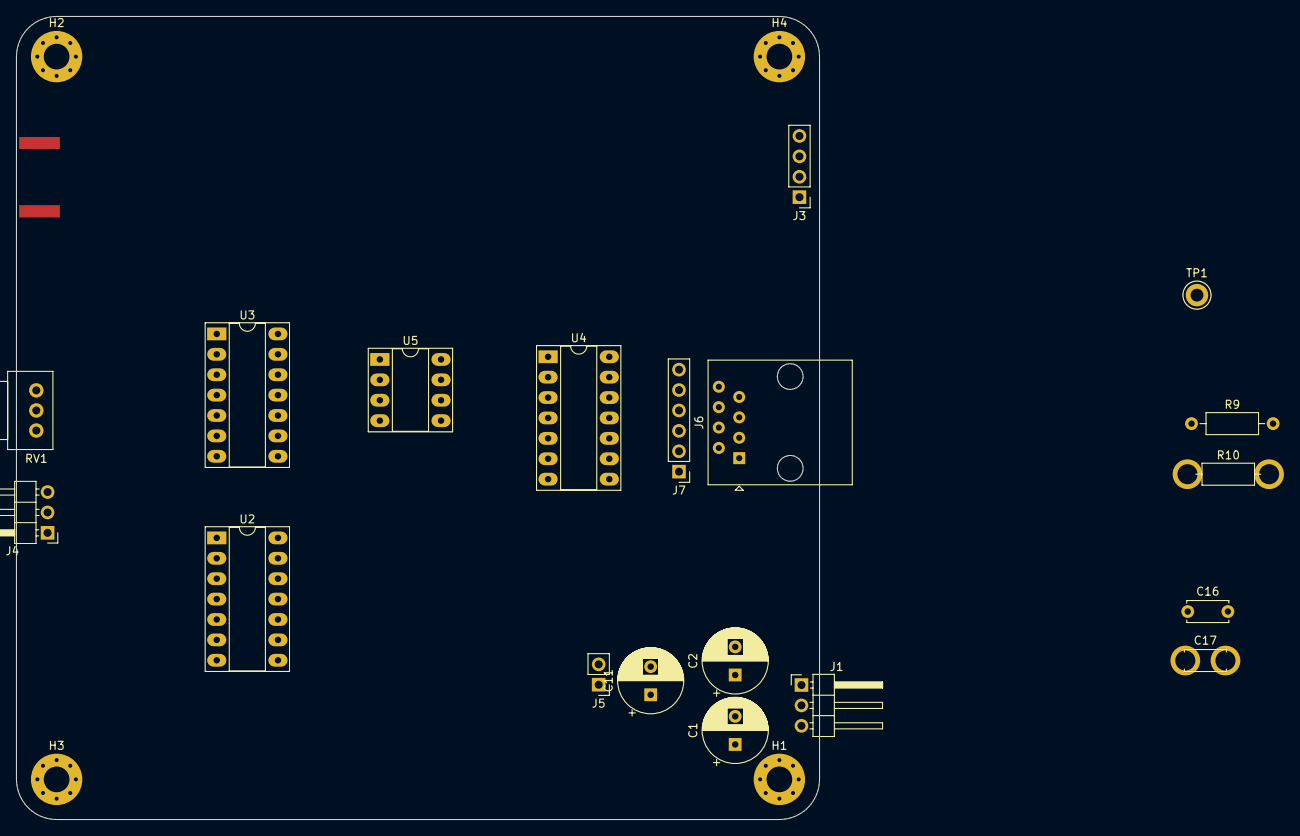
[picture p287: board opposition_bench.kicad_pcb from above]

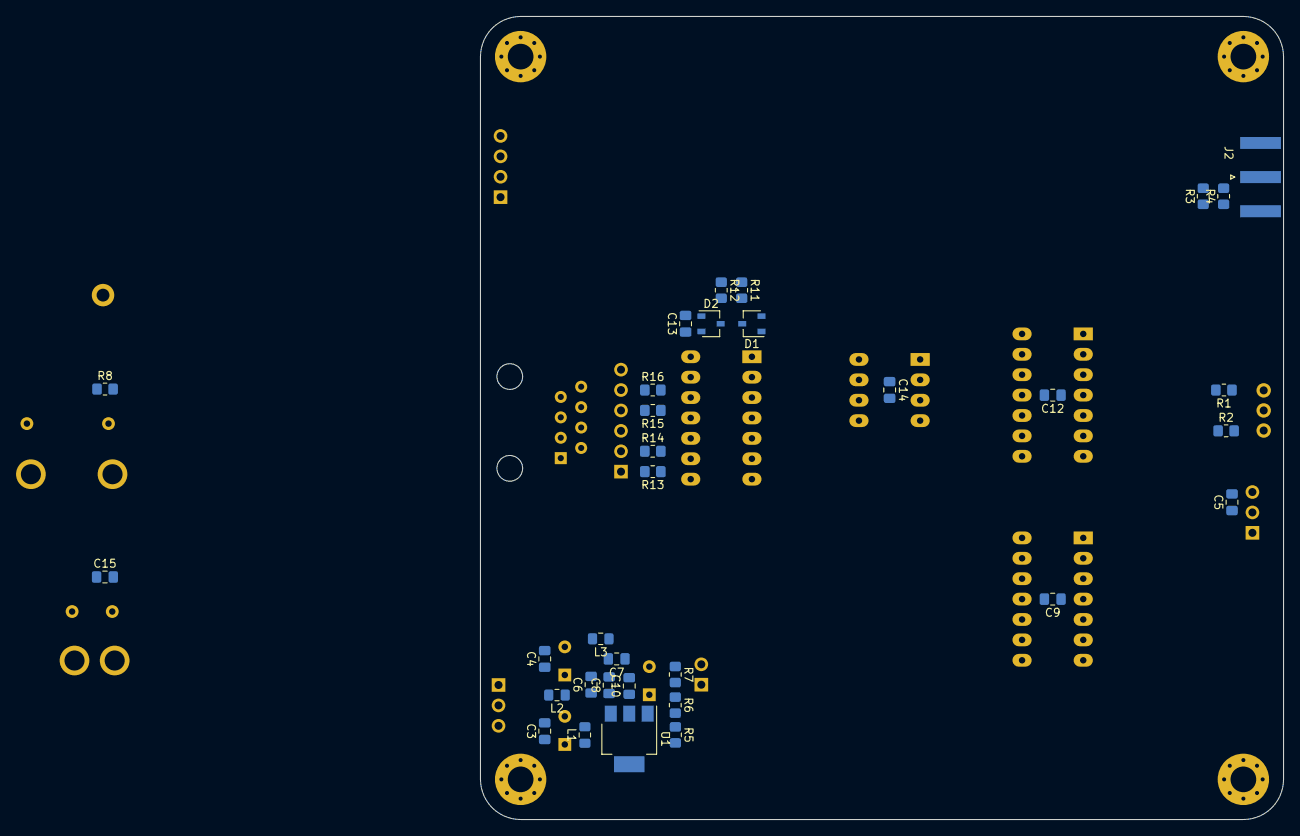
[picture p288: board opposition_bench.kicad_pcb from below]

Board: 2 copper layers, 100.0 x 100.0 mm, 56 parts (33 on the bottom side), 26 nets, no tracks yet.

Parts:
C1, C2, C11: 10u; CP_Radial_D8.0mm_P3.50mm
C3, C4, C5, C6, C7, C8, C9, C10, C12, C13, C14, C15: 100n; C_0805_2012Metric_Pad1.18x1.45mm_HandSolder
C16: 100n; C_Disc_D5.0mm_W2.5mm_P5.00mm
C17: 100n; C_Socket_D5.0mm_W2.5mm_P5.00mm
D1, D2: BAT60-04W; SOT-23W
H1, H2, H3, H4: MountingHole_Pad; MountingHole_3.2mm_M3_Pad_Via
J1: PWR_IN; PinHeader_1x03_P2.54mm_Horizontal
J2: BNC_IN; SMA_Amphenol_132289_EdgeMount
J3: Current_sensor; PinHeader_1x04_P2.54mm_Vertical
J4: Vset; PinHeader_1x03_P2.54mm_Horizontal
J5: 5V/3V3; PinHeader_1x02_P2.54mm_Vertical
J6: PWM_OUT_RJ; RJ45_Amphenol_54602-x08_Horizontal
J7: PWM_OUT; PinHeader_1x06_P2.54mm_Vertical
L1, L2, L3: 10u; L_0805_2012Metric_Pad1.15x1.40mm_HandSolder
R1, R2: 4k2; R_0805_2012Metric_Pad1.20x1.40mm_HandSolder
R3, R4: 100; R_0805_2012Metric_Pad1.20x1.40mm_HandSolder
R5: 240; R_0805_2012Metric_Pad1.20x1.40mm_HandSolder
R6: 390; R_0805_2012Metric_Pad1.20x1.40mm_HandSolder
R7: 330; R_0805_2012Metric_Pad1.20x1.40mm_HandSolder
R8, R13, R14, R15, R16: 10; R_0805_2012Metric_Pad1.20x1.40mm_HandSolder
R9: 10; R_Axial_DIN0207_L6.3mm_D2.5mm_P10.16mm_Horizontal
R10: 10; R_Socket_L6.3mm_D2.5mm_P10.16mm_Horizontal
R11, R12: 10k; R_0805_2012Metric_Pad1.20x1.40mm_HandSolder
RV1: 10k; Potentiometer_Alps_RK09Y11_Single_Horizontal
TP1: TestPoint; TestPoint_Keystone_5010-5014_Multipurpose
U1: LM317_SOT-223; SOT-223-3_TabPin2
U2, U3: LM324; DIP-14_W7.62mm_Socket_LongPads
U4: 74HC14; DIP-14_W7.62mm_Socket_LongPads
U5: LM393; DIP-8_W7.62mm_Socket_LongPads

Connections:
+5V: C10.1, C11.1, C13.1, D1.2 (K), D2.2 (K), R5.2, U1.2 (VO), U4.14 (VCC)
+15V: C6.1, C8.1, C9.1, C12.1, C14.1, J3.1, L1.2, R1.2, U1.3 (VI), U2.4 (V+), U3.4 (V+), U5.8 (V+)
-15V: C7.2, C9.2, C12.2, C14.2, J3.2, L3.1, R2.1, U2.11 (V-), U3.11 (V-), U5.4 (V-)
/15V_pre: C1.1, C3.1, J1.3, L1.1
/-15V_pre: C2.2, C4.2, J1.1, L3.2
/GND_pre: C1.2, C2.1, C3.2, C4.1, J1.2, L2.2
/I_setpoint: J2.1 (In), R3.2, R4.2
/PWMHU: R14.1, U4.6
/PWMHU_o: J6.3, J7.2, R14.2
/PWMHV: R16.1, U4.12
/PWMHV_o: J6.7, J7.5, R16.2
/PWMLU: R13.1, U4.4
/PWMLU_o: J6.1, J7.1, R13.2
/PWMLV: R15.1, U4.10
/PWMLV_o: J6.5, J7.4, R15.2
/PWMU_clmp: D1.3 (common), R11.2, U4.1, U4.5
/PWMV_clmp: D2.3 (common), R12.2, U4.9, U4.13
/Reg_fb: R5.1, R6.2, U1.1 (ADJ)
/V_setpoint: C5.1, J4.2
GND: C5.2, C6.2, C7.1, C8.2, C10.2, C11.2, C13.2, D1.1 (A), D2.1 (A), H1.1, H2.1, H3.1, H4.1, J2.2 (Ext), J3.4, J4.3, J5.2, J6.2, J6.4, J6.6, J6.8, J7.3, J7.6, L2.1, R3.1, R4.1, R7.1, U4.7 (GND)
unnamed: J4.1, RV1.2
unnamed: J5.1, R6.1, R7.2
unnamed: R1.1, RV1.1
unnamed: R2.2, RV1.3
unnamed: U4.2, U4.3
unnamed: U4.8, U4.11
