reivax-boucoi/PCB_Kicad/GD3163_flyback_DB/GD3163_flyback_DB.kicad_pcb

## KiCad design GD3163_flyback_DB/GD3163_flyback_DB.kicad_pcb (2023-04-11)

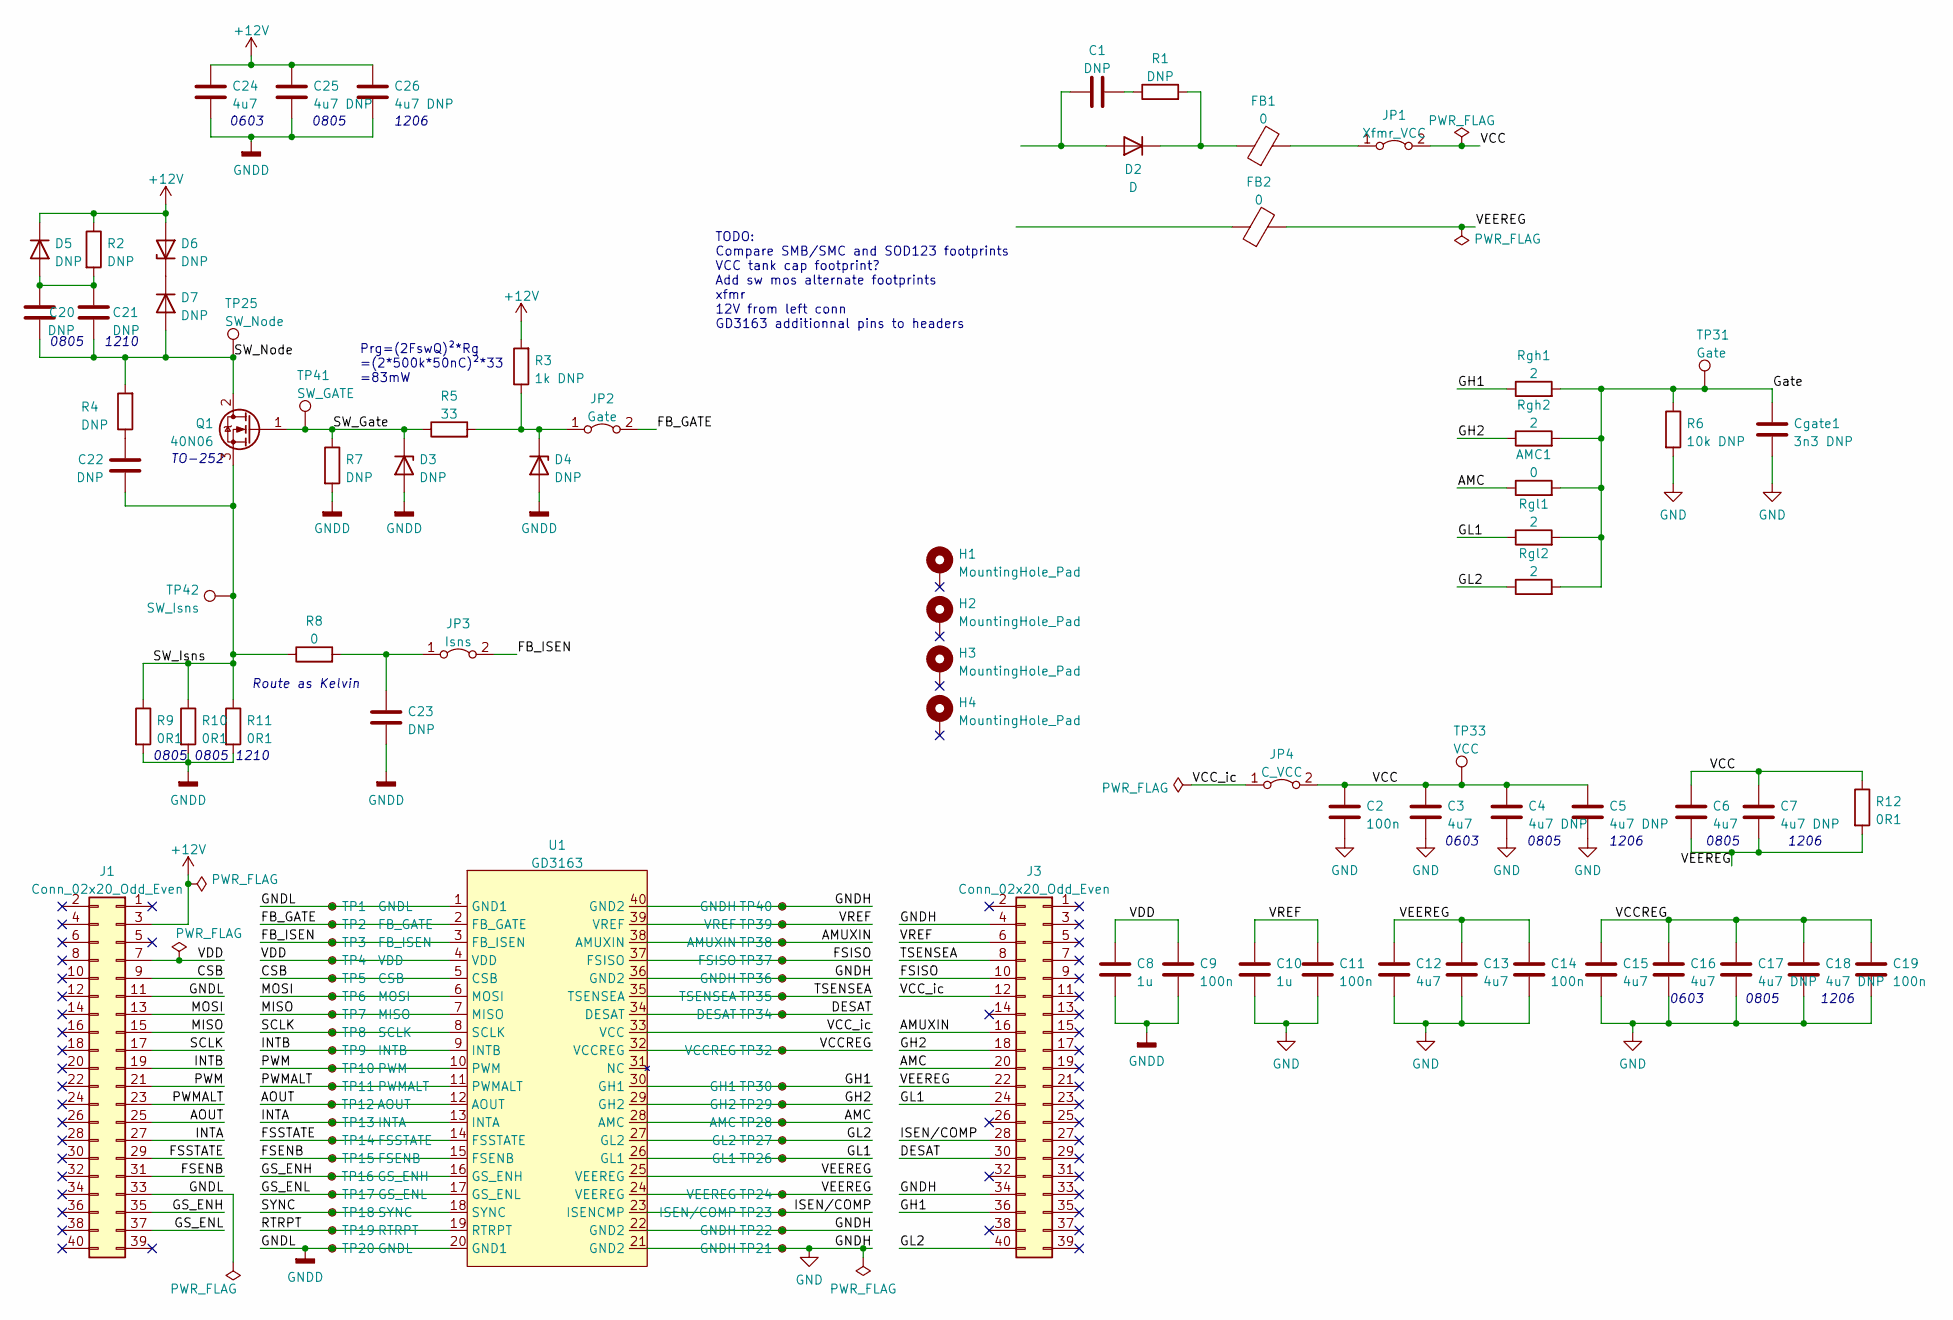
[picture p289: schematic GD3163_flyback_DB.kicad_sch, GD3163 Flyback DB]

Parts:
AMC1: 0; R_1206_3216Metric_Pad1.30x1.75mm_HandSolder
C1, C20, C22: DNP; C_0805_2012Metric_Pad1.18x1.45mm_HandSolder
C2, C9, C11, C14, C19: 100n; C_0603_1608Metric_Pad1.08x0.95mm_HandSolder
C3, C6, C12, C13, C15, C16, C24: 4u7; C_0603_1608Metric_Pad1.08x0.95mm_HandSolder
C4, C17, C25: 4u7 DNP; C_0805_2012Metric_Pad1.18x1.45mm_HandSolder
C5, C7, C18, C26: 4u7 DNP; C_1206_3216Metric_Pad1.33x1.80mm_HandSolder
C8, C10: 1u; C_0603_1608Metric_Pad1.08x0.95mm_HandSolder
C21: DNP; C_1210_3225Metric
C23: DNP; C_0603_1608Metric_Pad1.08x0.95mm_HandSolder
Cgate1: 3n3 DNP; C_0805_2012Metric_Pad1.18x1.45mm_HandSolder
D2: D; D_SMA-SMB_Universal_Handsoldering
D3, D4: DNP; D_SOD-323_HandSoldering
D5, D6, D7: DNP; D_SMA-SMB_Universal_Handsoldering
FB1, FB2: 0; L_0805_2012Metric_Pad1.05x1.20mm_HandSolder
H1, H2, H3, H4: MountingHole_Pad; MountingHole_4.3mm_M4_Pad_Via
J1, J3: Conn_02x20_Odd_Even; PinHeader_2x20_P2.54mm_Vertical
JP1: Xfmr_VCC; PinHeader_1x02_P2.54mm_Vertical
JP2: Gate; PinHeader_1x02_P2.54mm_Vertical
JP3: Isns; PinHeader_1x02_P2.54mm_Vertical
JP4: C_VCC; PinHeader_1x02_P2.54mm_Vertical
Q1: 40N06; TO-252-2
R1, R7: DNP; R_0805_2012Metric_Pad1.20x1.40mm_HandSolder
R2: DNP; R_1210_3225Metric_Pad1.30x2.65mm_HandSolder
R3: 1k DNP; R_0805_2012Metric_Pad1.20x1.40mm_HandSolder
R4: DNP; R_1206_3216Metric_Pad1.30x1.75mm_HandSolder
R5: 33; R_0805_2012Metric_Pad1.20x1.40mm_HandSolder
R6: 10k DNP; R_0805_2012Metric_Pad1.20x1.40mm_HandSolder
R8: 0; R_0805_2012Metric_Pad1.20x1.40mm_HandSolder
R9, R10: 0R1; R_0805_2012Metric_Pad1.20x1.40mm_HandSolder
R11: 0R1; R_1210_3225Metric_Pad1.30x2.65mm_HandSolder
R12: 0R1; R_SocketINSA_L6.3mm_D2.5mm_P10.16mm_Horizontal
Rgh1, Rgh2: 2; R_1206_3216Metric_Pad1.30x1.75mm_HandSolder
Rgl1, Rgl2: 2; R_1206_3216Metric_Pad1.30x1.75mm_HandSolder
TP1, TP20: GNDL; TestPoint_Keystone_5010-5014_Multipurpose
TP2: FB_GATE; TestPoint_Keystone_5010-5014_Multipurpose
TP3: FB_ISEN; TestPoint_Keystone_5010-5014_Multipurpose
TP4: VDD; TestPoint_Keystone_5010-5014_Multipurpose
TP5: CSB; TestPoint_Keystone_5010-5014_Multipurpose
TP6: MOSI; TestPoint_Keystone_5010-5014_Multipurpose
TP7: MISO; TestPoint_Keystone_5010-5014_Multipurpose
TP8: SCLK; TestPoint_Keystone_5010-5014_Multipurpose
TP9: INTB; TestPoint_Keystone_5010-5014_Multipurpose
TP10: PWM; TestPoint_Keystone_5010-5014_Multipurpose
TP11: PWMALT; TestPoint_Keystone_5010-5014_Multipurpose
TP12: AOUT; TestPoint_Keystone_5010-5014_Multipurpose
TP13: INTA; TestPoint_Keystone_5010-5014_Multipurpose
TP14: FSSTATE; TestPoint_Keystone_5010-5014_Multipurpose
TP15: FSENB; TestPoint_Keystone_5010-5014_Multipurpose
TP16: GS_ENH; TestPoint_Keystone_5010-5014_Multipurpose
TP17: GS_ENL; TestPoint_Keystone_5010-5014_Multipurpose
TP18: SYNC; TestPoint_Keystone_5010-5014_Multipurpose
TP19: RTRPT; TestPoint_Keystone_5010-5014_Multipurpose
TP21, TP22, TP36, TP40: GNDH; TestPoint_Keystone_5010-5014_Multipurpose
TP23: ISEN/COMP; TestPoint_Keystone_5010-5014_Multipurpose
TP24: VEEREG; TestPoint_Keystone_5010-5014_Multipurpose
TP25: SW_Node; TestPoint_Keystone_5010-5014_Multipurpose
TP26: GL1; TestPoint_Keystone_5010-5014_Multipurpose
TP27: GL2; TestPoint_Keystone_5010-5014_Multipurpose
TP28: AMC; TestPoint_Keystone_5010-5014_Multipurpose
TP29: GH2; TestPoint_Keystone_5010-5014_Multipurpose
TP30: GH1; TestPoint_Keystone_5010-5014_Multipurpose
TP31: Gate; TestPoint_Keystone_5010-5014_Multipurpose
TP32: VCCREG; TestPoint_Keystone_5010-5014_Multipurpose
TP33: VCC; TestPoint_Keystone_5010-5014_Multipurpose
TP34: DESAT; TestPoint_Keystone_5010-5014_Multipurpose
TP35: TSENSEA; TestPoint_Keystone_5010-5014_Multipurpose
TP37: FSISO; TestPoint_Keystone_5010-5014_Multipurpose
TP38: AMUXIN; TestPoint_Keystone_5010-5014_Multipurpose
TP39: VREF; TestPoint_Keystone_5010-5014_Multipurpose
TP41: SW_GATE; TestPoint_Keystone_5010-5014_Multipurpose
TP42: SW_Isns; TestPoint_Keystone_5010-5014_Multipurpose
U1: GD3163; GD3163_SOIC-40_1.575x0.3, 9.575w

Connections:
+12V: C24.1, C25.1, C26.1, D5.1 (K), D6.2 (A), J1.3, R2.1, R3.2
/AMC: AMC1.1, J3.20, TP28.1, U1.28 (AMC)
/AMUXIN: J3.16, TP38.1, U1.38 (AMUXIN)
/AOUT: J1.25, TP12.1, U1.12 (AOUT)
/CSB: J1.9, TP5.1, U1.5 (CSB)
/DESAT: J3.30, TP34.1, U1.34 (DESAT)
/FB_GATE: JP2.2 (B), TP2.1, U1.2 (FB_GATE)
/FB_ISEN: JP3.2 (B), TP3.1, U1.3 (FB_ISEN)
/FSENB: J1.31, TP15.1, U1.15 (FSENB)
/FSISO: J3.10, TP37.1, U1.37 (FSISO)
/FSSTATE: J1.29, TP14.1, U1.14 (FSSTATE)
/GH1: J3.36, Rgh1.1, TP30.1, U1.30 (GH1)
/GH2: J3.18, Rgh2.1, TP29.1, U1.29 (GH2)
/GL1: J3.24, Rgl1.1, TP26.1, U1.26 (GL1)
/GL2: J3.40, Rgl2.1, TP27.1, U1.27 (GL2)
/GS_ENH: J1.35, TP16.1, U1.16 (GS_ENH)
/GS_ENL: J1.37, TP17.1, U1.17 (GS_ENL)
/Gate: AMC1.2, Cgate1.1, R6.1, Rgh1.2, Rgh2.2, Rgl1.2, Rgl2.2, TP31.1
/INTA: J1.27, TP13.1, U1.13 (INTA)
/INTB: J1.19, TP9.1, U1.9 (INTB)
/ISEN/COMP: J3.28, TP23.1, U1.23 (ISENCMP)
/MISO: J1.15, TP7.1, U1.7 (MISO)
/MOSI: J1.13, TP6.1, U1.6 (MOSI)
/PWM: J1.21, TP10.1, U1.10 (PWM)
/PWMALT: J1.23, TP11.1, U1.11 (PWMALT)
/RTRPT: TP19.1, U1.19 (RTRPT)
/SCLK: J1.17, TP8.1, U1.8 (SCLK)
/SW_Gate: D3.1 (K), Q1.1 (G), R5.1, R7.1, TP41.1
/SW_Isns: C22.2, Q1.3 (S), R8.1, R9.1, R10.1, R11.1, TP42.1
/SW_Node: C20.2, C21.2, D7.2 (A), Q1.2 (D), R4.2, TP25.1
/SYNC: TP18.1, U1.18 (SYNC)
/TSENSEA: J3.8, TP35.1, U1.35 (TSENSEA)
/VCC: C2.1, C3.1, C4.1, C5.1, C6.1, C7.1, JP1.2 (B), JP4.2 (B), R12.1, TP33.1
/VCCREG: C15.1, C16.1, C17.1, C18.1, C19.1, TP32.1, U1.32 (VCCREG)
/VCC_ic: J3.12, JP4.1 (A), U1.33 (VCC)
/VDD: C8.1, C9.1, J1.7, TP4.1, U1.4 (VDD)
/VEEREG: C6.2, C7.2, C12.1, C13.1, C14.1, FB2.2, J3.22, R12.2, TP24.1, U1.24 (VEEREG), U1.25 (VEEREG)
/VREF: C10.1, C11.1, J3.6, TP39.1, U1.39 (VREF)
GND: C2.2, C3.2, C4.2, C5.2, C10.2, C11.2, C12.2, C13.2, C14.2, C15.2, C16.2, C17.2, C18.2, C19.2, Cgate1.2, J3.4, J3.34, R6.2, TP21.1, TP22.1, TP36.1, TP40.1, U1.21 (GND2), U1.22 (GND2), U1.36 (GND2), U1.40 (GND2)
GNDD: C8.2, C9.2, C23.2, C24.2, C25.2, C26.2, D3.2 (A), D4.2 (A), J1.11, J1.33, R7.2, R9.2, R10.2, R11.2, TP1.1, TP20.1, U1.1 (GND1), U1.20 (GND1)
unnamed: C1.1, D2.2 (A)
unnamed: C1.2, R1.1
unnamed: C20.1, C21.1, D5.2 (A), R2.2
unnamed: C22.1, R4.1
unnamed: C23.1, JP3.1 (A), R8.2
unnamed: D2.1 (K), FB1.1, R1.2
unnamed: D4.1 (K), JP2.1 (A), R3.1, R5.2
unnamed: D6.1 (K), D7.1 (K)
unnamed: FB1.2, JP1.1 (A)

Notes on the sheet:
0805 1210
0805 1206
0603 0805 1206
0805 0805 1210
TO-252
TODO: Compare SMB/SMC and SOD123 footprints VCC tank cap footprint? Add sw mos alternate footprints xfmr 12V from left conn GD3163 additionnal pins to headers
0603 0805 1206
Prg=(2FswQ)²*Rg =(2*500k*50nC)²*33 =83mW
Route as Kelvin

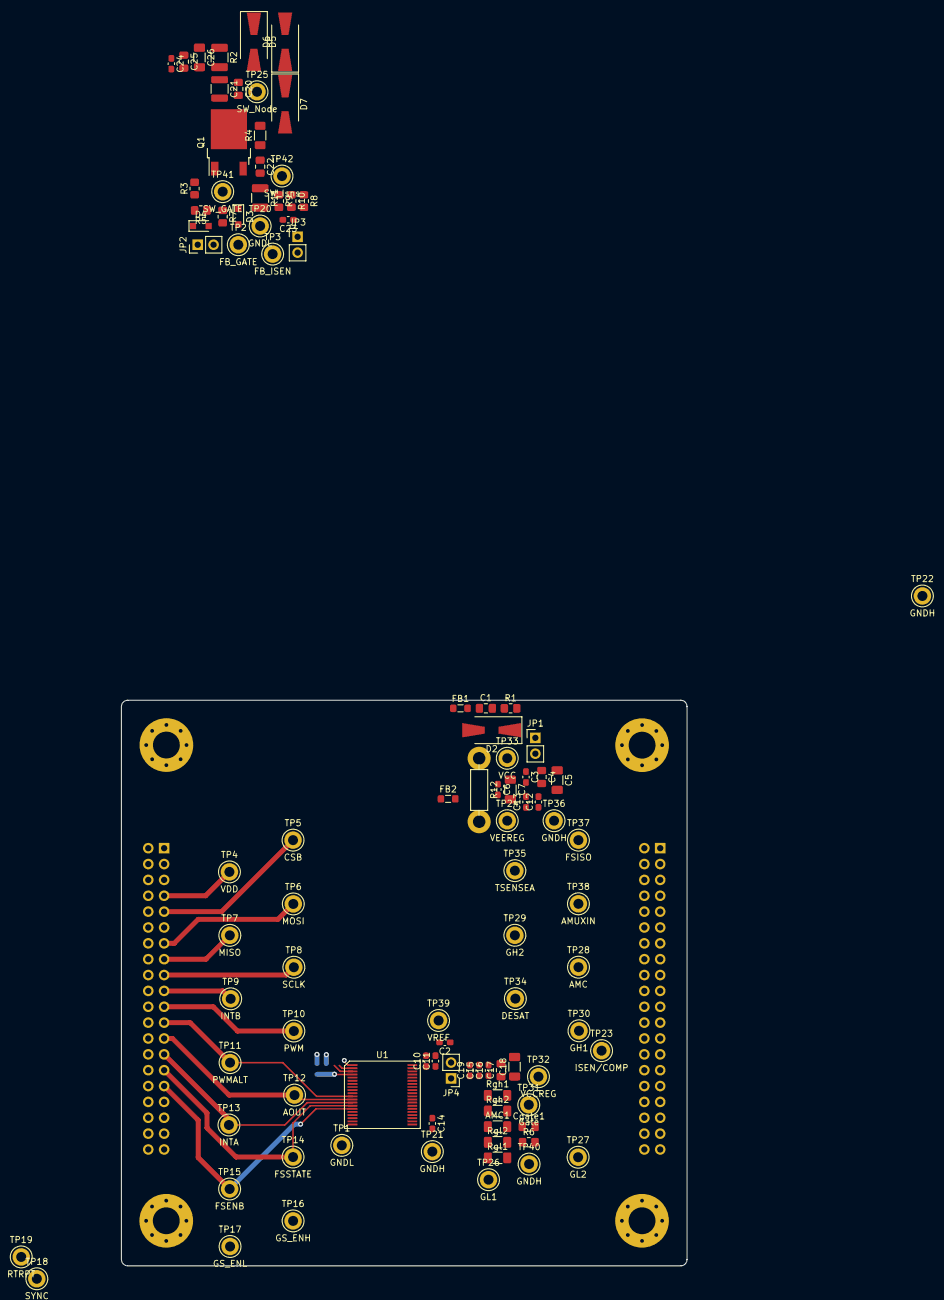
[picture p290: board GD3163_flyback_DB.kicad_pcb from above]

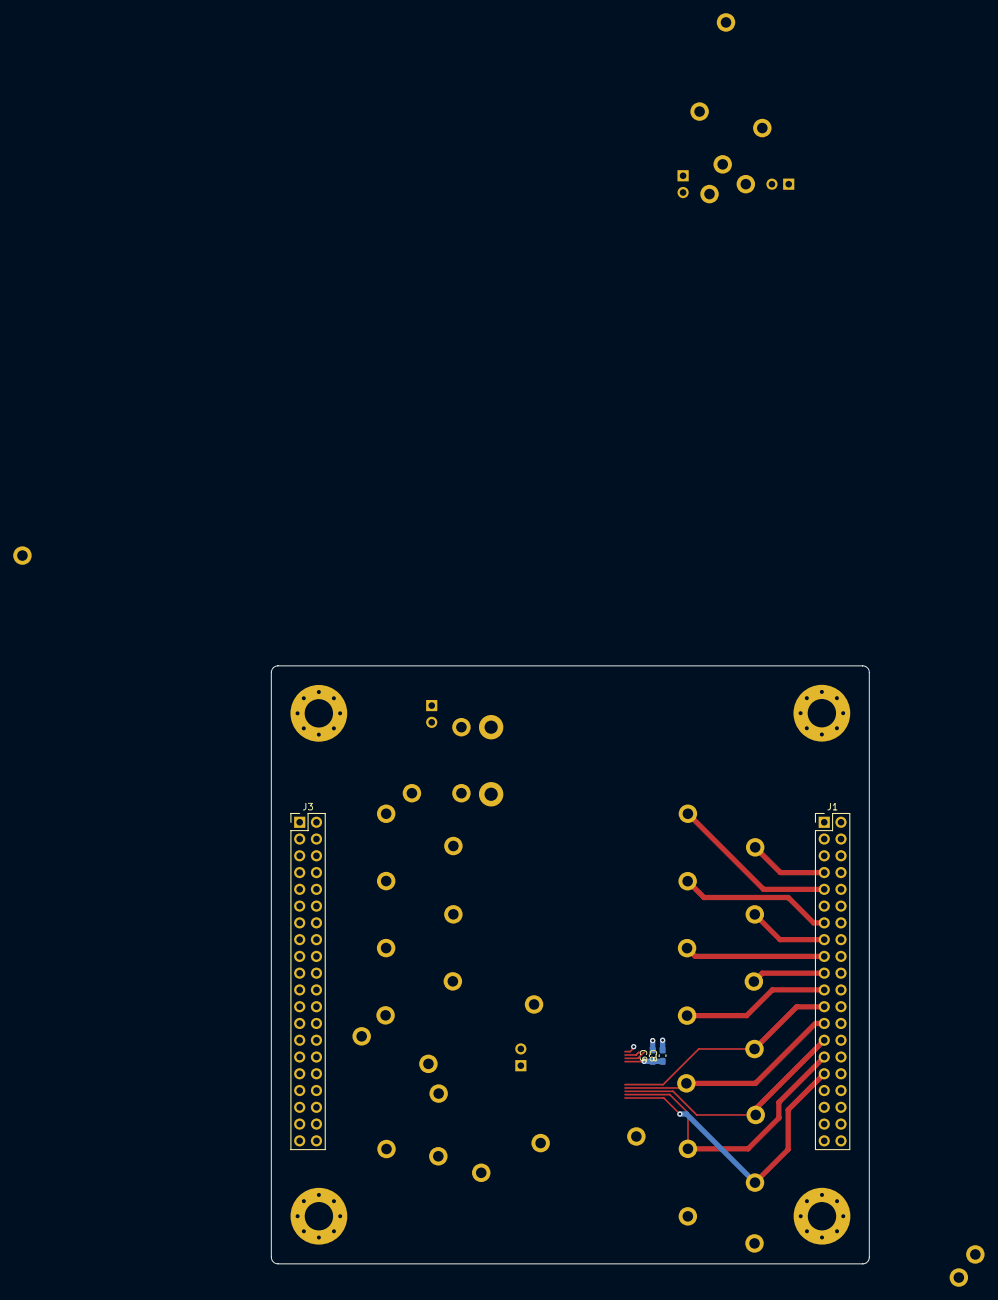
[picture p291: board GD3163_flyback_DB.kicad_pcb from below]

Board: 4 copper layers, 90.6 x 90.6 mm, 106 parts (4 on the bottom side), 49 nets.
