reivax-boucoi/PCB_Kicad/series_light/series_light.kicad_pcb

## KiCad design series_light/series_light.kicad_pcb (2023-04-10)

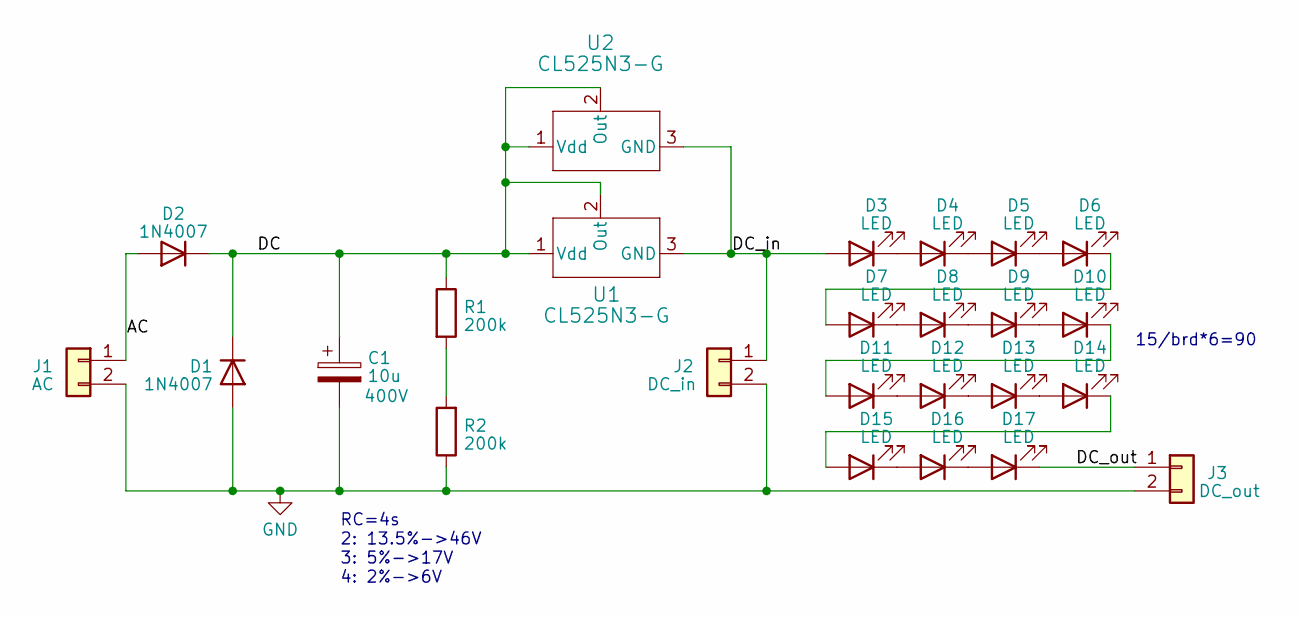
[picture p292: schematic series_light.kicad_sch, Series LED light]

Parts:
C1: 10u; Board_edge_cap_P5mm_D10mm; Voltage 400V
D1, D2: 1N4007; D_SMA
D3, D4, D5, D6, D7, D8, D9, D10, D11, D12, D13, D14, D15, D16, D17: LED; LED_PLCC_2835
J1: AC; TerminalBlock_bornier-2_P5.08mm
J2: DC_in; Board_chain_Conn
J3: DC_out; Board_chain_Conn
R1, R2: 200k; R_0805_2012Metric
U1, U2: CL525N3-G; TO-92

Connections:
/AC: D2.2 (A), J1.1
/DC: C1.1, D1.1 (K), D2.1 (K), R1.1, U1.1 (Vdd), U1.2 (Out), U2.1 (Vdd), U2.2 (Out)
/DC_in: D3.2 (A), J2.1, U1.3 (GND), U2.3 (GND)
/DC_out: D17.1 (K), J3.1
GND: C1.2, D1.2 (A), J1.2, J2.2, J3.2, R2.1
unnamed: D3.1 (K), D4.2 (A)
unnamed: D4.1 (K), D5.2 (A)
unnamed: D5.1 (K), D6.2 (A)
unnamed: D6.1 (K), D7.2 (A)
unnamed: D7.1 (K), D8.2 (A)
unnamed: D8.1 (K), D9.2 (A)
unnamed: D9.1 (K), D10.2 (A)
unnamed: D10.1 (K), D11.2 (A)
unnamed: D11.1 (K), D12.2 (A)
unnamed: D12.1 (K), D13.2 (A)
unnamed: D13.1 (K), D14.2 (A)
unnamed: D14.1 (K), D15.2 (A)
unnamed: D15.1 (K), D16.2 (A)
unnamed: D16.1 (K), D17.2 (A)
unnamed: R1.2, R2.2

Notes on the sheet:
RC=4s 2: 13.5%->46V 3: 5%->17V 4: 2%->6V
15/brd*6=90

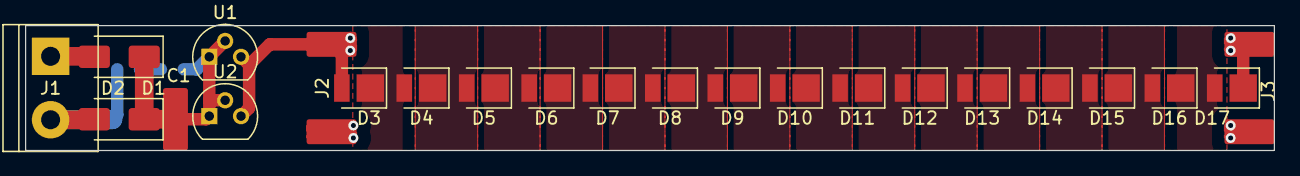
[picture p293: board series_light.kicad_pcb from above]

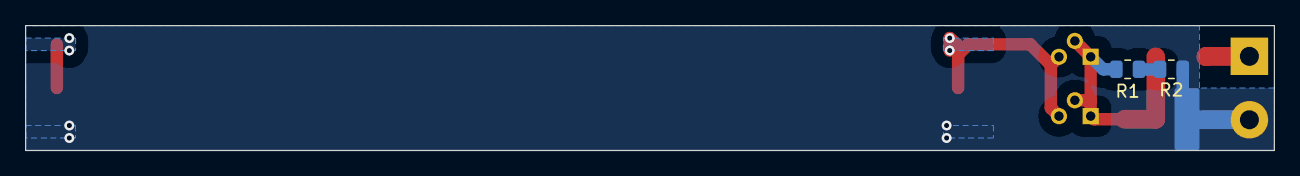
[picture p294: board series_light.kicad_pcb from below]

Board: 2 copper layers, 100.0 x 10.0 mm, 25 parts (2 on the bottom side), 20 nets.
