reivax-boucoi/PCB_Kicad/miains_timer_2/miains_timer_2.kicad_pcb

## KiCad design miains_timer_2/miains_timer_2.kicad_pcb (2023-04-03)

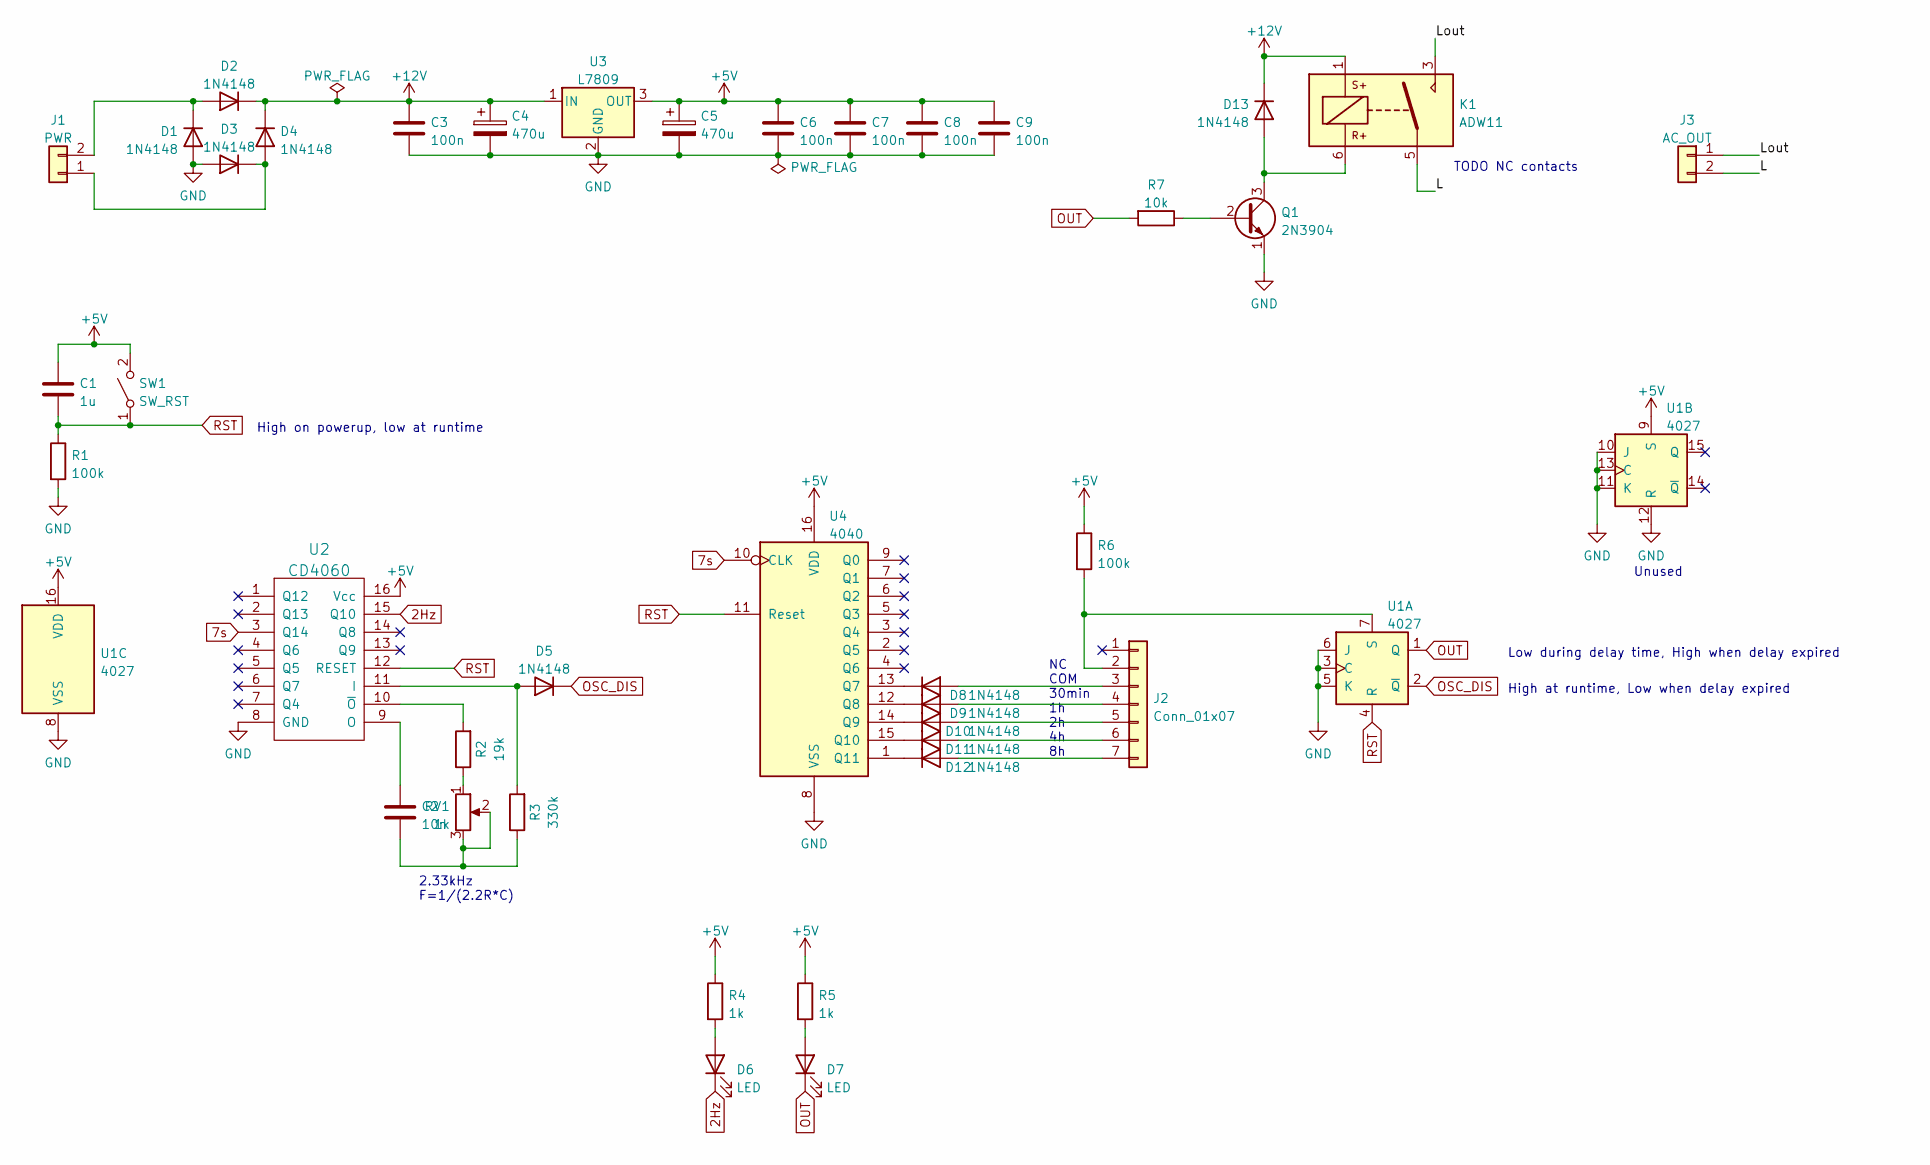
[picture p295: schematic miains_timer_2.kicad_sch]

Parts:
C1: 1u; C_0805_2012Metric_Pad1.18x1.45mm_HandSolder
C2: 10n; C_0805_2012Metric_Pad1.18x1.45mm_HandSolder
C3, C6, C7, C8, C9: 100n; C_0805_2012Metric_Pad1.18x1.45mm_HandSolder
C4, C5: 470u; CP_Radial_D8.0mm_P2.50mm
D1, D2, D3, D4, D5, D8, D9, D10, D11, D12, D13: 1N4148; D_MiniMELF
D6, D7: LED; LED_D5.0mm
J1: PWR; TerminalBlock_bornier-2_P5.08mm
J2: Conn_01x07; PinSocket_1x07_P2.54mm_Vertical
J3: AC_OUT; TerminalBlock_bornier-2_P5.08mm
K1: ADW11; Relay_1P1T_NO_10x24x18.8mm_Panasonic_ADW11xxxxW_THT
Q1: 2N3904; TO-92_Inline
R1, R6: 100k; R_0805_2012Metric_Pad1.20x1.40mm_HandSolder
R2: 19k; R_0805_2012Metric_Pad1.20x1.40mm_HandSolder
R3: 330k; R_0805_2012Metric_Pad1.20x1.40mm_HandSolder
R4, R5: 1k; R_0805_2012Metric_Pad1.20x1.40mm_HandSolder
R7: 10k; R_0805_2012Metric_Pad1.20x1.40mm_HandSolder
RV1: 1k; Potentiometer_Bourns_3386X_Horizontal
SW1: SW_RST; PinHeader_1x02_P2.54mm_Vertical
U1: 4027; DIP-16_W7.62mm_Socket_LongPads
U2: CD4060; DIP-16_W7.62mm_Socket_LongPads
U3: L7809; TO-220-3_Vertical
U4: 4040; DIP-16_W7.62mm_Socket_LongPads

Connections:
2Hz: D6.1 (K), U2.15 (Q10)
7s: U2.3 (Q14), U4.10 (CLK)
+5V: C1.1, C5.1, C6.1, C7.1, C8.1, C9.1, R4.1, R5.1, R6.1, SW1.2 (B), U1.9 (S), U1.16 (VDD), U2.16 (Vcc), U3.3 (OUT), U4.16 (VDD)
+12V: C3.1, C4.1, D2.1 (K), D4.1 (K), D13.1 (K), K1.1, U3.1 (IN)
/L: J3.2, K1.5
/Lout: J3.1, K1.3
GND: C3.2, C4.2, C5.2, C6.2, C7.2, C8.2, C9.2, D1.2 (A), D3.2 (A), Q1.1 (E), R1.2, U1.3 (C), U1.5 (K), U1.6 (J), U1.8 (VSS), U1.10 (J), U1.11 (K), U1.12 (R), U1.13 (C), U2.8 (GND), U3.2 (GND), U4.8 (VSS)
unnamed: C2.1, U2.9 (O)
unnamed: C2.2, R3.1, RV1.2, RV1.3
unnamed: D1.1 (K), D2.2 (A), J1.2
unnamed: D3.1 (K), D4.2 (A), J1.1
unnamed: D5.2 (A), R3.2, U2.11 (I)
unnamed: D6.2 (A), R4.2
unnamed: D7.2 (A), R5.2
unnamed: D8.1 (K), U4.13 (Q7)
unnamed: D8.2 (A), J2.3
unnamed: D9.1 (K), U4.12 (Q8)
unnamed: D9.2 (A), J2.4
unnamed: D10.1 (K), U4.14 (Q9)
unnamed: D10.2 (A), J2.5
unnamed: D11.1 (K), U4.15 (Q10)
unnamed: D11.2 (A), J2.6
unnamed: D12.1 (K), U4.1 (Q11)
unnamed: D12.2 (A), J2.7
unnamed: J2.2, R6.2, U1.7 (S)
unnamed: D13.2 (A), K1.6, Q1.3 (C)
unnamed: Q1.2 (B), R7.1
unnamed: R2.1, RV1.1
unnamed: R2.2, U2.10 (~O)
OSC_DIS: D5.1 (K), U1.2 (~Q)
OUT: D7.1 (K), R7.2, U1.1 (Q)
RST: C1.2, R1.1, SW1.1 (A), U1.4 (R), U2.12 (RESET), U4.11 (Reset)

Notes on the sheet:
High at runtime, Low when delay expired
Unused
Low during delay time, High when delay expired
High on powerup, low at runtime
NC COM 30min 1h 2h 4h 8h
TODO NC contacts
2.33kHz F=1/(2.2R*C)

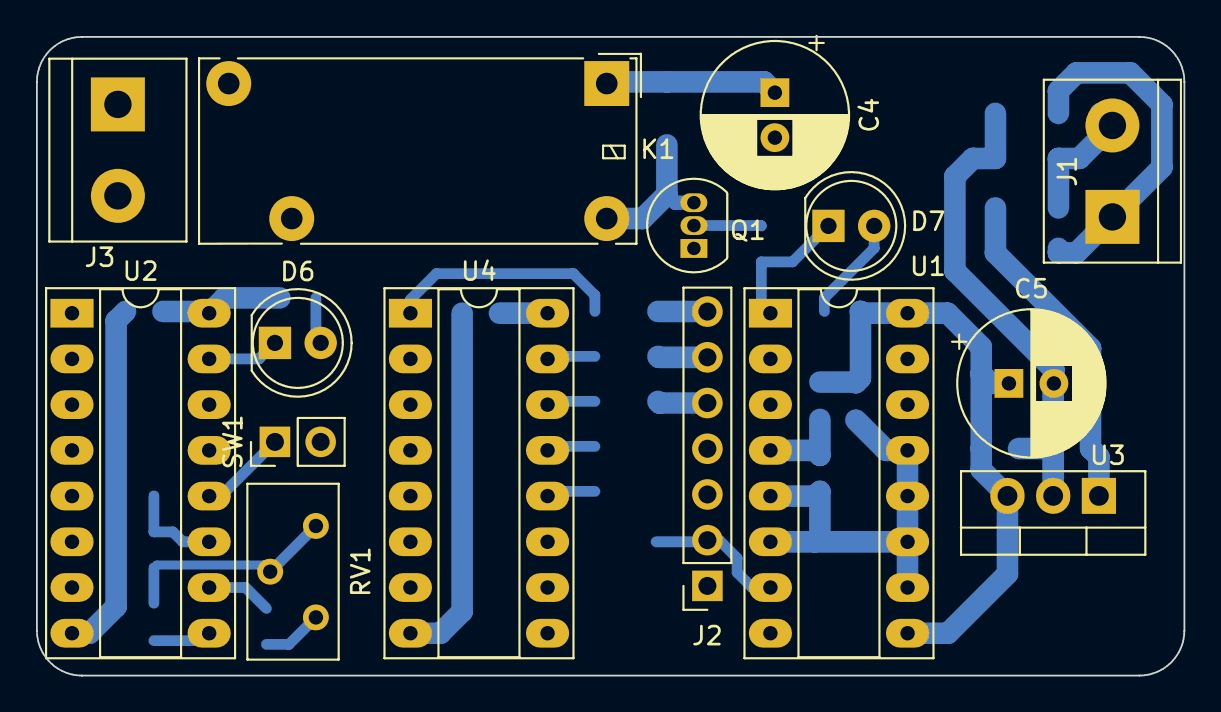
[picture p296: board miains_timer_2.kicad_pcb from above]

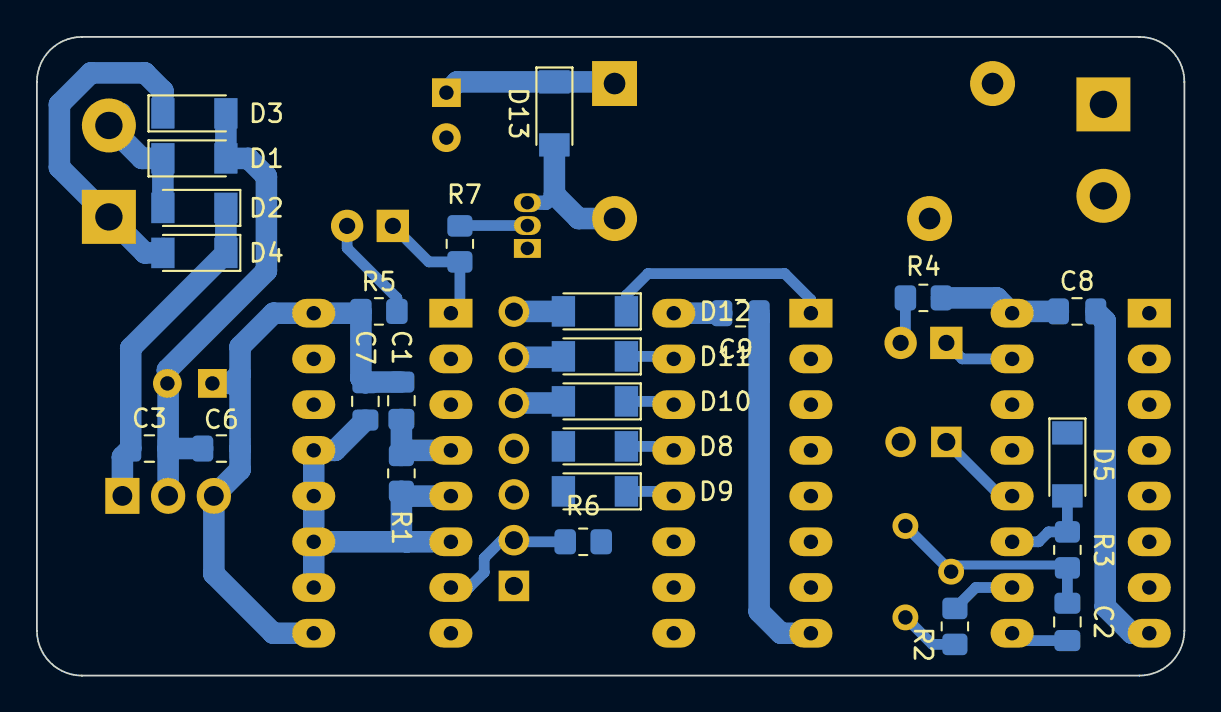
[picture p297: board miains_timer_2.kicad_pcb from below]

Board: 2 copper layers, 63.8 x 35.5 mm, 40 parts (25 on the bottom side), 32 nets.
