reivax-boucoi/PCB_Kicad/50W_LED_boost/led_boost/led_boost.kicad_pcb

## KiCad design 50W_LED_boost/led_boost/led_boost.kicad_pcb (2022-10-03)

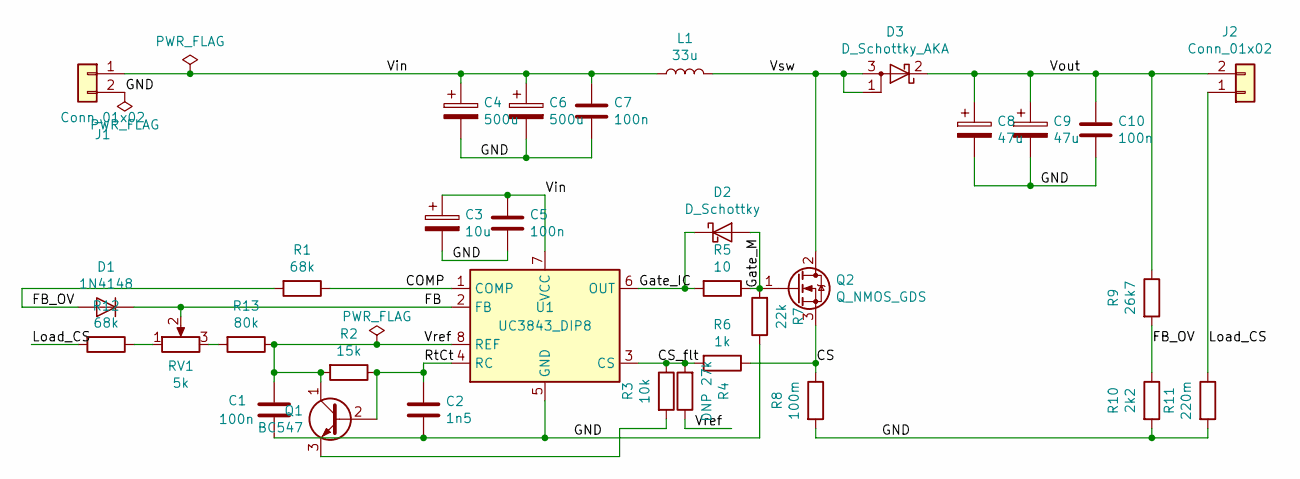
[picture p298: schematic led_boost.sch]

Parts:
C1, C5, C7, C10: 100n; C_Disc_D5.0mm_W2.5mm_P5.00mm
C2: 1n5; C_Disc_D5.0mm_W2.5mm_P5.00mm
C3: 10u; CP_Radial_D10.0mm_P5.00mm
C4, C6: 500u; CP_Radial_D13.0mm_P7.50mm
C8, C9: 47u; CP_Radial_D10.0mm_P5.00mm
D1: 1N4148; D_DO-35_SOD27_P7.62mm_Horizontal
D2: D_Schottky; D_DO-15_P12.70mm_Horizontal
D3: D_Schottky_AKA; TO-220-3_Vertical
J1, J2: Conn_01x02; TE_826576-2_1x02_P3.96mm_Vertical
L1: 33u; L_Radial_D12.5mm_P7.00mm_Fastron_09HCP
Q1: BC547; TO-92_Inline
Q2: Q_NMOS_GDS; TO-220-3_Vertical
R1, R12: 68k; R_Axial_DIN0207_L6.3mm_D2.5mm_P10.16mm_Horizontal
R2: 15k; R_Axial_DIN0207_L6.3mm_D2.5mm_P10.16mm_Horizontal
R3: 10k; R_Axial_DIN0207_L6.3mm_D2.5mm_P10.16mm_Horizontal
R4: DNP 27k; R_Axial_DIN0207_L6.3mm_D2.5mm_P10.16mm_Horizontal
R5: 10; R_Axial_DIN0207_L6.3mm_D2.5mm_P10.16mm_Horizontal
R6: 1k; R_Axial_DIN0207_L6.3mm_D2.5mm_P10.16mm_Horizontal
R7: 22k; R_Axial_DIN0207_L6.3mm_D2.5mm_P10.16mm_Horizontal
R8: 100m; R_Shunt_Vishay_WSR2_WSR3_KelvinConnection
R9: 26k7; R_Axial_DIN0207_L6.3mm_D2.5mm_P10.16mm_Horizontal
R10: 2k2; R_Axial_DIN0207_L6.3mm_D2.5mm_P10.16mm_Horizontal
R11: 220m; R_Radial_Power_L7.0mm_W8.0mm_Px2.40mm_Py2.30mm
R13: 80k; R_Axial_DIN0207_L6.3mm_D2.5mm_P10.16mm_Horizontal
RV1: 5k; Potentiometer_Bourns_3296X_Horizontal
U1: UC3843_DIP8; DIP-8_W7.62mm

Connections:
/COMP: R1.1, U1.1 (COMP)
/CS: Q2.3 (S), R6.1, R8.1
/CS_flt: R3.1, R4.2, R6.2, U1.3 (CS)
/FB: D1.1 (K), RV1.2, U1.2 (FB)
/FB_OV: D1.2 (A), R1.2, R9.2, R10.1
/GND: C1.2, C2.2, C3.2, C4.2, C5.2, C6.2, C7.2, C8.2, C9.2, C10.2, J1.2, R7.1, R8.2, R10.2, R11.2, U1.5 (GND)
/Gate_IC: D2.1 (K), R5.2, U1.6 (OUT)
/Gate_M: D2.2 (A), Q2.1 (G), R5.1, R7.2
/Load_CS: J2.1, R11.1, R12.2
/RtCt: C2.1, Q1.2 (B), R2.1, U1.4 (RC)
/Vin: C3.1, C4.1, C5.1, C6.1, C7.1, J1.1, L1.1, U1.7 (VCC)
/Vout: C8.1, C9.1, C10.1, D3.2 (K), J2.2, R9.1
/Vref: C1.1, Q1.1 (C), R2.2, R4.1, R13.1, U1.8 (REF)
/Vsw: D3.1 (A), D3.3 (A), L1.2, Q2.2 (D)
unnamed: Q1.3 (E), R3.2
unnamed: R12.1, RV1.1
unnamed: R13.2, RV1.3

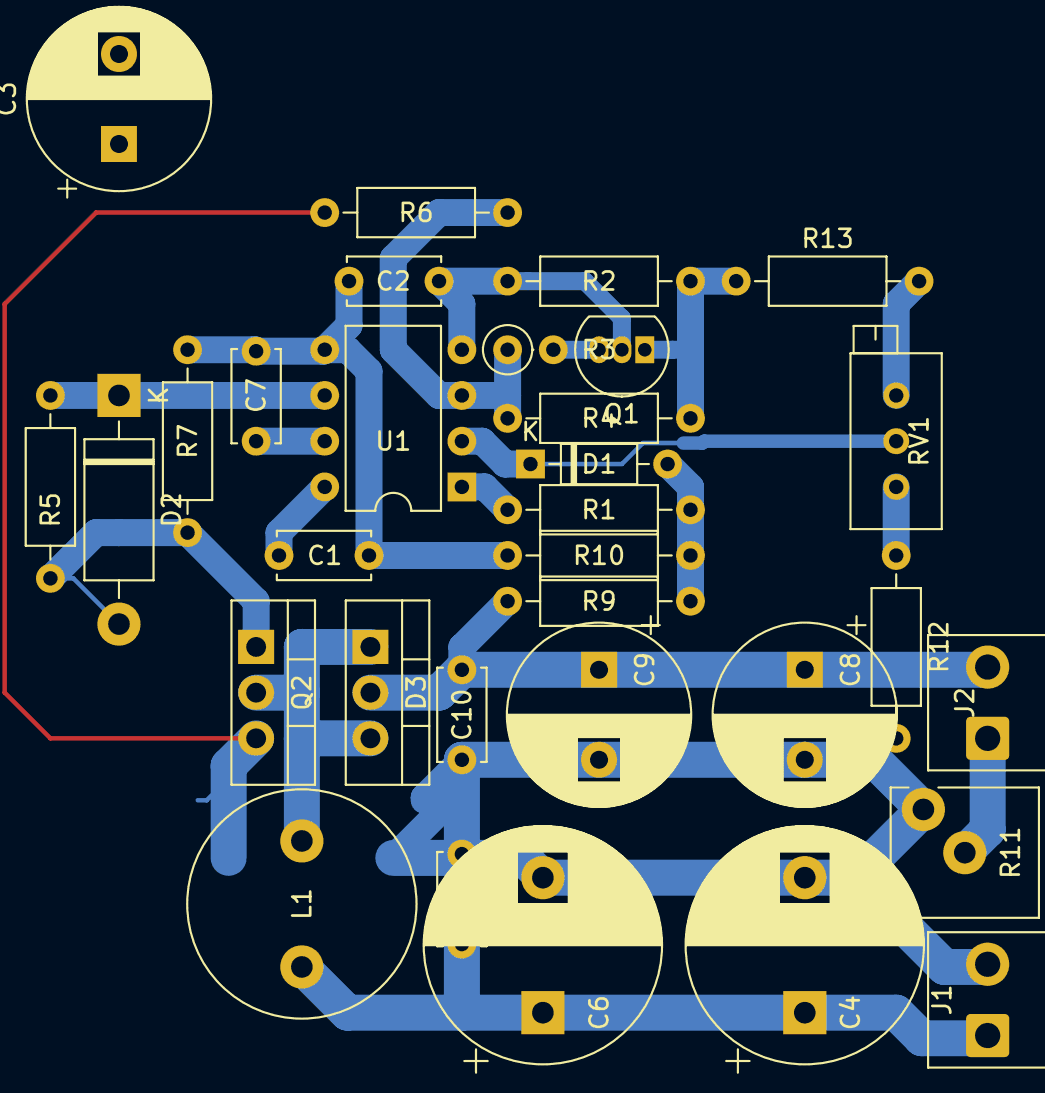
[picture p299: board led_boost.kicad_pcb from above]

Board: 2 copper layers, 33 parts (1 on the bottom side), 17 nets.
