reivax-boucoi/PCB_Kicad/hv_discharge_v2/hv_discharge.kicad_pcb

## KiCad design hv_discharge_v2/hv_discharge.kicad_pcb (2022-10-03)

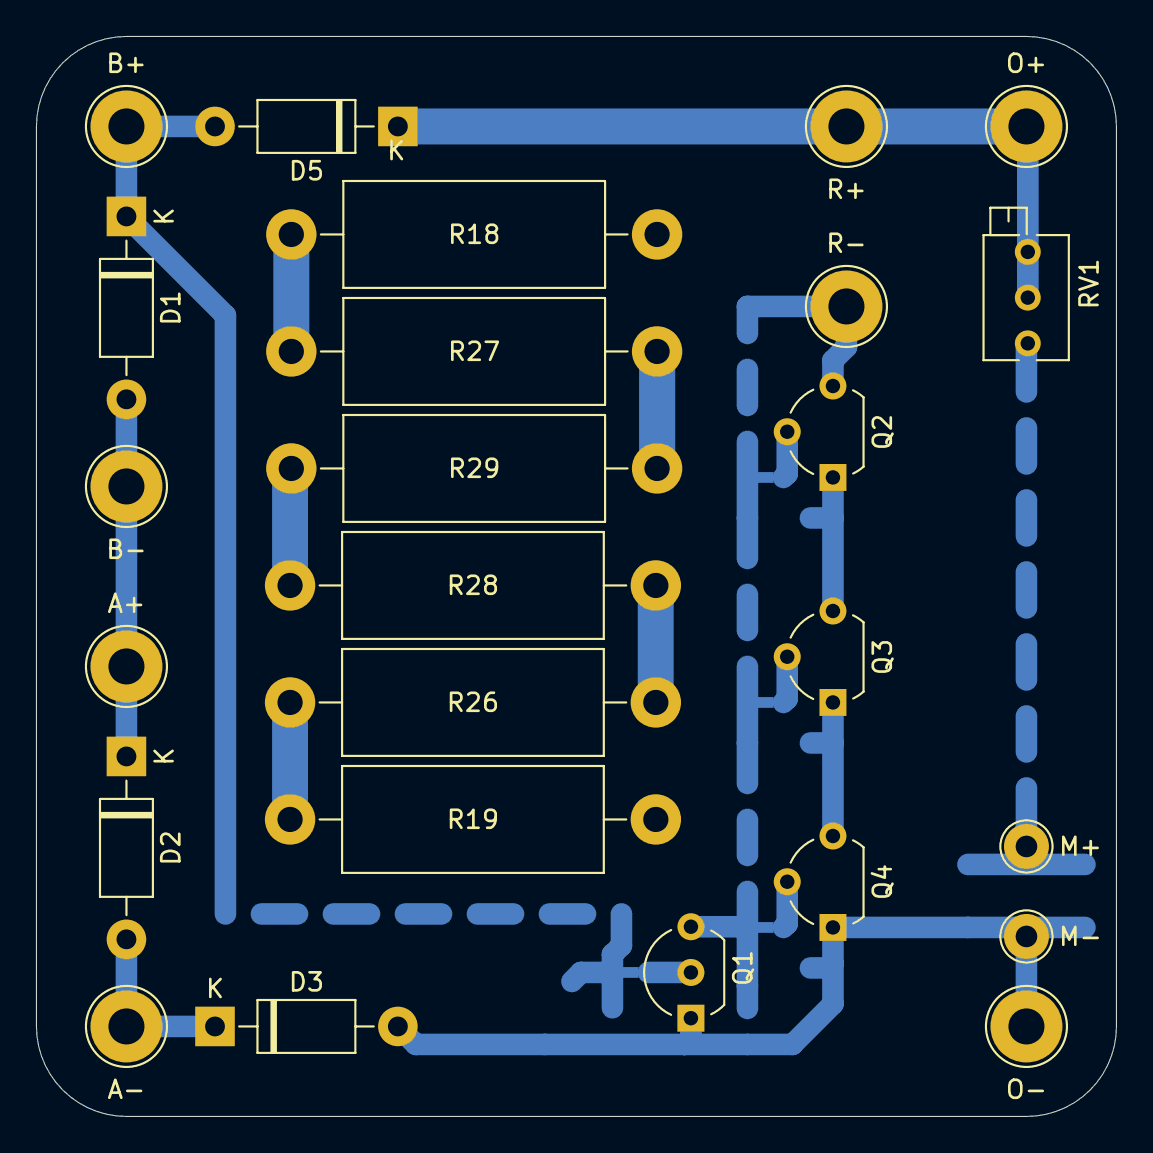
[picture p300: board hv_discharge.kicad_pcb from above]

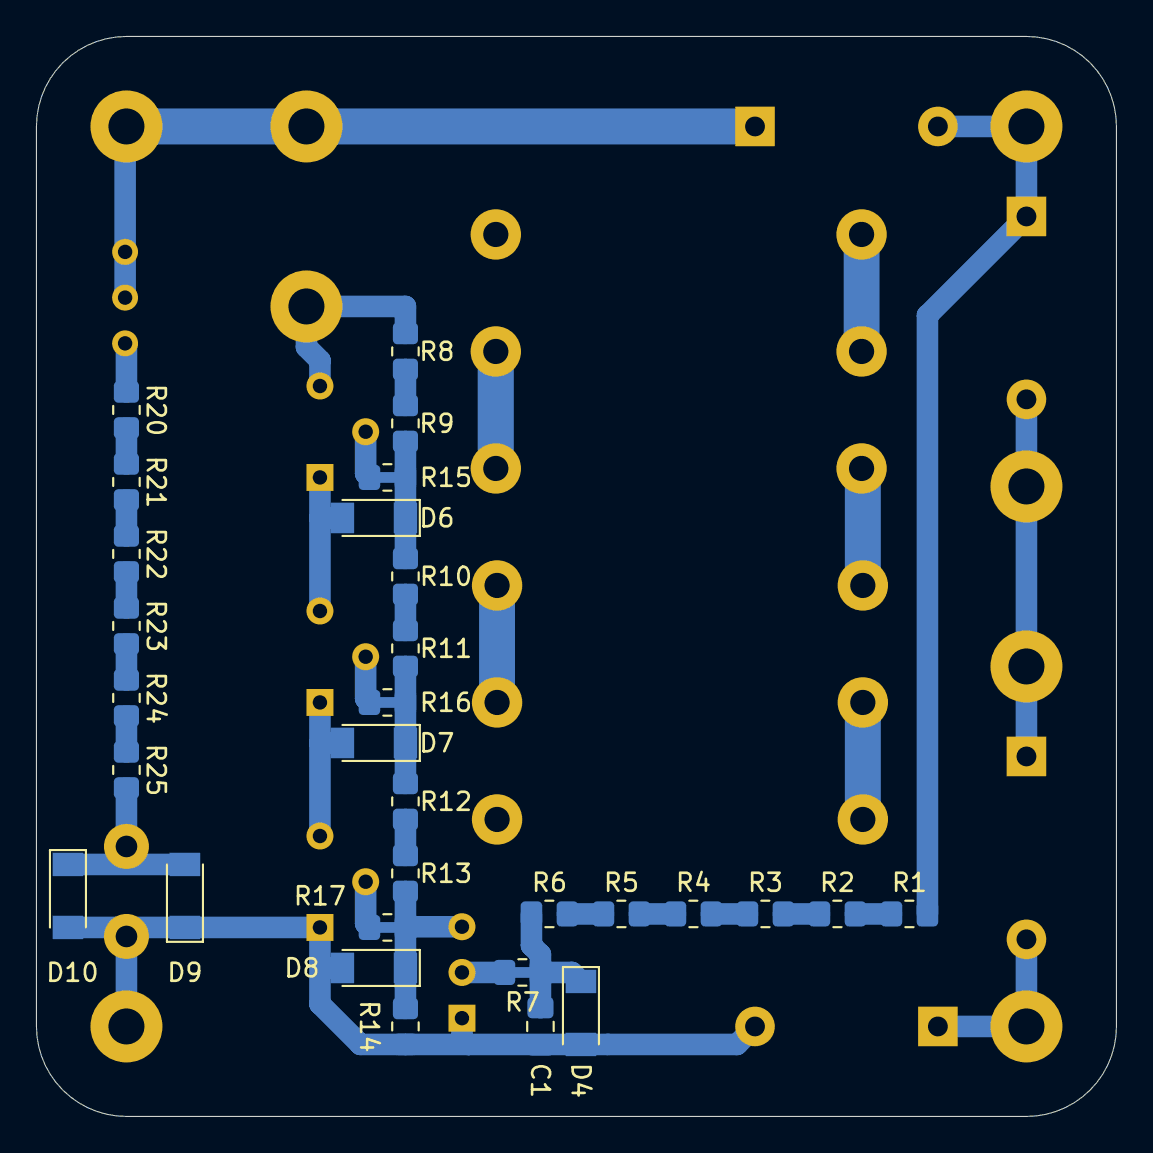
[picture p301: board hv_discharge.kicad_pcb from below]

Board: 2 copper layers, 60.0 x 60.0 mm, 55 parts (30 on the bottom side), 36 nets.

Parts:
C1: 100n; C_0805_2012Metric_Pad1.18x1.45mm_HandSolder
D1, D2, D3, D5: 1N4007; D_DO-41_SOD81_P10.16mm_Horizontal
D4, D6, D7, D8: BZV55B9V1; D_MiniMELF
D9, D10: D; D_MiniMELF
J1: B+; TestPoint_THTPad_D4.0mm_Drill2.0mm
J2: B-; TestPoint_THTPad_D4.0mm_Drill2.0mm
J3: A+; TestPoint_THTPad_D4.0mm_Drill2.0mm
J4: A-; TestPoint_THTPad_D4.0mm_Drill2.0mm
J5: R+; TestPoint_THTPad_D4.0mm_Drill2.0mm
J6: R-; TestPoint_THTPad_D4.0mm_Drill2.0mm
J7: M+; TestPoint_THTPad_D2.5mm_Drill1.2mm
J8: M-; TestPoint_THTPad_D2.5mm_Drill1.2mm
J9: O-; TestPoint_THTPad_D4.0mm_Drill2.0mm
J10: O+; TestPoint_THTPad_D4.0mm_Drill2.0mm
Q1: 2N7000; TO-92_Inline_Wide
Q2, Q3, Q4: Q_NMOS_SGD; TO-92L_Wide
R1, R2, R3, R4, R5, R6, R8, R9, R10, R11, R12, R13, R14, R20, R21, R22, R23, R24, R25: 2M; R_0805_2012Metric_Pad1.20x1.40mm_HandSolder
R7, R15, R16, R17: 10; RBridged_0805_2012Metric_Pad1.20x1.40mm_HandSolder
R18, R19, R26, R27, R28, R29: 2k2; R_Axial_DIN0614_L14.3mm_D5.7mm_P20.32mm_Horizontal
RV1: 200k; Potentiometer_Bourns_3266Z_Horizontal

Connections:
/Dischg_dis: C1.1, D4.1 (K), R6.2, R7.1
/Meter+: D9.2 (A), D10.1 (K), J7.1, R25.2
/Vd1: D7.2 (A), Q3.1 (S), Q4.3 (D)
/Vd2: D6.2 (A), Q2.1 (S), Q3.3 (D)
/Vd3: J6.1, Q2.3 (D), R8.1
/Vg1: D8.1 (K), Q1.3 (D), R13.2, R14.1, R17.1
/Vg2: D7.1 (K), R11.2, R12.1, R16.1
/Vg3: D6.1 (K), R9.2, R10.1, R15.1
/Vout+: D5.1 (K), J5.1, J10.1, RV1.2, RV1.3
/Vout-: C1.2, D3.2 (A), D4.2 (A), D8.2 (A), D9.1 (K), D10.2 (A), J8.1, J9.1, Q1.1 (S), Q4.1 (S), R14.2
/Vsup+: D1.1 (K), D5.2 (A), J1.1, R1.1
/Vsup-: D2.2 (A), D3.1 (K), J4.1
/Vsupmid: D1.2 (A), D2.1 (K), J2.1, J3.1
unnamed: Q1.2 (G), R7.2
unnamed: Q2.2 (G), R15.2
unnamed: Q3.2 (G), R16.2
unnamed: Q4.2 (G), R17.2
unnamed: R1.2, R2.1
unnamed: R2.2, R3.1
unnamed: R3.2, R4.1
unnamed: R4.2, R5.1
unnamed: R5.2, R6.1
unnamed: R8.2, R9.1
unnamed: R10.2, R11.1
unnamed: R12.2, R13.1
unnamed: R18.2, R27.1
unnamed: R19.2, R26.1
unnamed: R20.1, RV1.1
unnamed: R20.2, R21.1
unnamed: R21.2, R22.1
unnamed: R22.2, R23.1
unnamed: R23.2, R24.1
unnamed: R24.2, R25.1
unnamed: R26.2, R28.1
unnamed: R27.2, R29.1
unnamed: R28.2, R29.2
