reivax-boucoi/PCB_Kicad/hv_discharge_v2b/hv_discharge_v2b.kicad_pcb

## KiCad design hv_discharge_v2b/hv_discharge_v2b.kicad_pcb (2022-10-03)

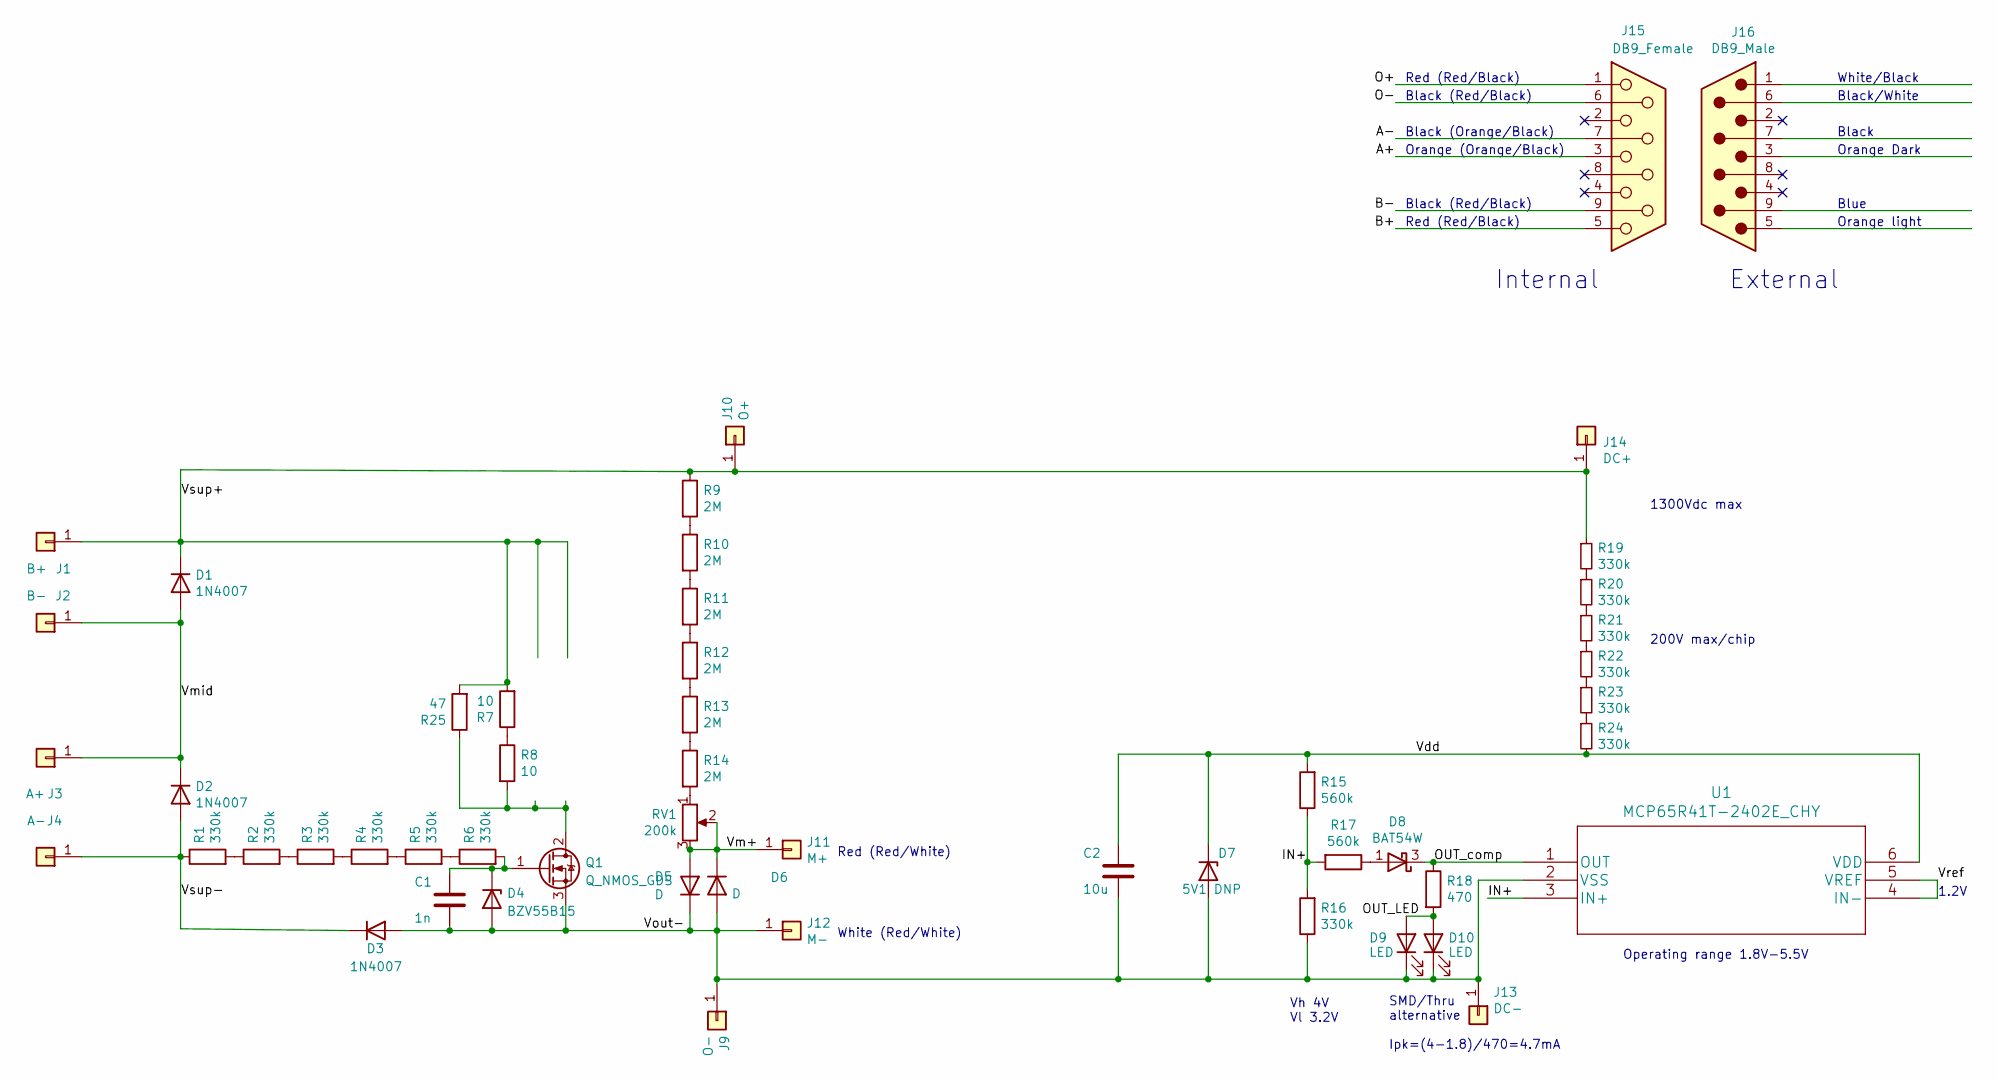
[picture p302: schematic hv_discharge_v2b.kicad_sch]

Parts:
C1: 1n; C_0805_2012Metric_Pad1.18x1.45mm_HandSolder
C2: 10u; C_0805_2012Metric_Pad1.18x1.45mm_HandSolder
D1, D2, D3: 1N4007; D_DO-41_SOD81_P10.16mm_Horizontal
D4: BZV55B15; D_MiniMELF
D5, D6: D; D_MiniMELF
D7: 5V1 DNP; D_MiniMELF
D8: BAT54W; SOT-23
D9: LED; LED_0805_2012Metric_Pad1.15x1.40mm_HandSolder
D10: LED; LED_D5.0mm
J1: B+; TestPoint_THTPad_D4.0mm_Drill2.0mm
J2: B-; TestPoint_THTPad_D4.0mm_Drill2.0mm
J3: A+; TestPoint_THTPad_D4.0mm_Drill2.0mm
J4: A-; TestPoint_THTPad_D4.0mm_Drill2.0mm
J9: O-; TestPoint_THTPad_D4.0mm_Drill2.0mm
J10: O+; TestPoint_THTPad_D4.0mm_Drill2.0mm
J11: M+; TestPoint_THTPad_D2.5mm_Drill1.2mm
J12: M-; TestPoint_THTPad_D2.5mm_Drill1.2mm
J13: DC-; TestPoint_THTPad_D2.5mm_Drill1.2mm
J14: DC+; TestPoint_THTPad_D2.5mm_Drill1.2mm
J15: DB9_Female
J16: DB9_Male
Q1: Q_NMOS_GDS; TO-247-3_Horizontal_TabDown
R1, R2, R3, R4, R5, R6, R19, R20, R21, R22, R23, R24: 330k; R_1206_3216Metric_Pad1.30x1.75mm_HandSolder
R7, R8: 10; THS2510RJ
R9, R10, R11, R12, R13, R14: 2M; R_1206_3216Metric_Pad1.30x1.75mm_HandSolder
R15, R17: 560k; R_0805_2012Metric_Pad1.20x1.40mm_HandSolder
R16: 330k; R_0805_2012Metric_Pad1.20x1.40mm_HandSolder
R18: 470; R_0805_2012Metric_Pad1.20x1.40mm_HandSolder
R25: 47; HSC100
RV1: 200k; Potentiometer_Bourns_3266Y_Vertical
U1: MCP65R41T-2402E_CHY; MCP65R41T-2402E

Connections:
/IN+: R15.1, R16.2, R17.2, U1.3 (IN+)
/OUT_LED: D9.2 (A), D10.2 (A), R18.2
/OUT_comp: D8.3 (K), R18.1, U1.1 (OUT)
/Vdd: C2.1, D7.1 (K), R15.2, R24.2, U1.6 (VDD)
/Vm+: D5.2 (A), D6.1 (K), J11.1, RV1.2, RV1.3
/Vmid: D1.2 (A), D2.1 (K), J2.1, J3.1
/Vout-: C1.2, C2.2, D3.2 (A), D4.2 (A), D5.1 (K), D6.2 (A), D7.2 (A), D9.1 (K), D10.1 (K), J9.1, J12.1, J13.1, Q1.3 (S), R16.1, U1.2 (VSS)
/Vref: U1.4 (IN-), U1.5 (VREF)
/Vsup+: D1.1 (K), J1.1, J10.1, J14.1, R7.2, R9.1, R19.1, R25.2
/Vsup-: D2.2 (A), D3.1 (K), J4.1, R1.1
unnamed: C1.1, D4.1 (K), Q1.1 (G), R6.2
unnamed: D8.1 (A), R17.1
unnamed: Q1.2 (D), R8.2, R25.1
unnamed: R1.2, R2.1
unnamed: R2.2, R3.1
unnamed: R3.2, R4.1
unnamed: R4.2, R5.1
unnamed: R5.2, R6.1
unnamed: R7.1, R8.1
unnamed: R9.2, R10.1
unnamed: R10.2, R11.1
unnamed: R11.2, R12.1
unnamed: R12.2, R13.1
unnamed: R13.2, R14.1
unnamed: R14.2, RV1.1
unnamed: R19.2, R20.1
unnamed: R20.2, R21.1
unnamed: R21.2, R22.1
unnamed: R22.2, R23.1
unnamed: R23.2, R24.1

Notes on the sheet:
1.2V
Red (Red/Black)
Black (Orange/Black)
Black (Red/Black)
Orange light
Black
Black/White
Orange (Orange/Black)
White (Red/White)
Blue
200V max/chip
Orange Dark
Red (Red/White)
1300Vdc max
Vh 4V Vl 3.2V
External
Internal
Operating range 1.8V-5.5V
SMD/Thru alternative Ipk=(4-1.8)/470=4.7mA
White/Black

Board: 2 copper layers, 50 parts (31 on the bottom side), 30 nets, no tracks yet.
