reivax-boucoi/PCB_Kicad/mains_timer/mains_timer.kicad_pcb

## KiCad design mains_timer/mains_timer.kicad_pcb (2022-10-03)

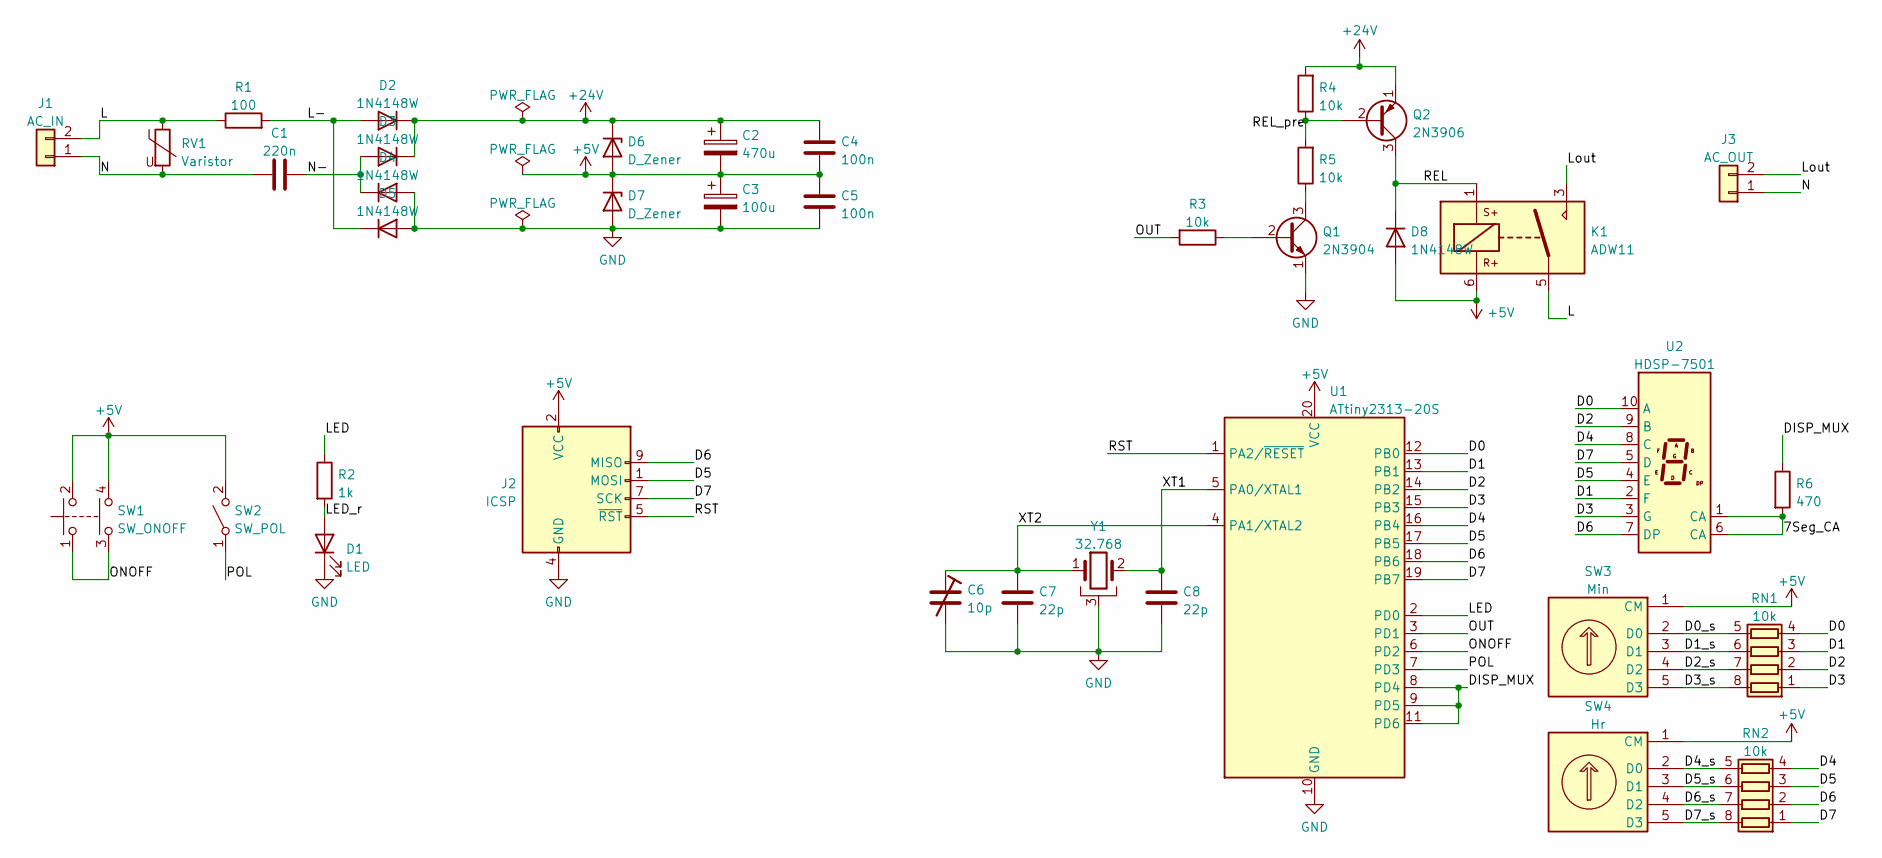
[picture p303: schematic mains_timer.kicad_sch]

Parts:
C1: 220n; C_Rect_L26.5mm_W8.5mm_P22.50mm_MKS4
C2: 470u; CP_Radial_D10.0mm_P2.50mm_P5.00mm
C3: 100u; CP_Radial_D7.5mm_P2.50mm
C4, C5: 100n; C_0603_1608Metric_Pad1.08x0.95mm_HandSolder
C6: 10p
C7, C8: 22p; C_0603_1608Metric_Pad1.08x0.95mm_HandSolder
D1: LED; LED_D5.0mm
D2, D3, D4, D5, D8: 1N4148W; D_SOD-123
D6: D_Zener; D_DO-15_P3.81mm_Vertical_AnodeUp
D7: D_Zener; D_MELF
J1: AC_IN; TerminalBlock_bornier-2_P5.08mm
J2: ICSP; PinHeader_2x05_P2.54mm_Vertical
J3: AC_OUT; TerminalBlock_bornier-2_P5.08mm
K1: ADW11; Relay_1P1T_NO_10x24x18.8mm_Panasonic_ADW11xxxxW_THT
Q1: 2N3904; TO-92_Inline
Q2: 2N3906; TO-92_Inline
R1: 100; R_Axial_DIN0309_L9.0mm_D3.2mm_P2.54mm_Vertical
R2: 1k; R_0603_1608Metric_Pad0.98x0.95mm_HandSolder
R3, R4, R5: 10k; R_0603_1608Metric_Pad0.98x0.95mm_HandSolder
R6: 470; R_0603_1608Metric_Pad0.98x0.95mm_HandSolder
RN1, RN2: 10k; R_Array_Concave_4x0603
RV1: Varistor; RV_Disc_D12mm_W4.6mm_P7.5mm
SW1: SW_ONOFF; Push_E-Switch_KS01Q01
SW2: SW_POL; PinHeader_1x02_P2.54mm_Vertical
SW3: Min; PinHeader_1x05_P2.54mm_Vertical
SW4: Hr; PinHeader_1x05_P2.54mm_Vertical
U1: ATtiny2313-20S; SOIC-20W_7.5x12.8mm_P1.27mm
U2: HDSP-7501; HDSP-A151
Y1: 32.768; Crystal_C38-LF_D3.0mm_L8.0mm_Horizontal_1EP_style2

Connections:
+5V: C2.2, C3.1, C4.2, C5.1, D6.2 (A), D7.1 (K), D8.2 (A), J2.2 (VCC), K1.6, SW1.2, SW1.4, SW2.2 (B), SW3.1 (CM), SW4.1 (CM), U1.20 (VCC)
+24V: C2.1, C4.1, D2.1 (K), D3.1 (K), D6.1 (K), Q2.1 (E), R4.2
/7Seg_CA: R6.2, U2.1 (CA), U2.6 (CA)
/D0: RN1.4 (R4.1), U1.12 (PB0), U2.10 (A)
/D0_s: RN1.5 (R4.2), SW3.2 (D0)
/D1: RN1.3 (R3.1), U1.13 (PB1), U2.2 (F)
/D1_s: RN1.6 (R3.2), SW3.3 (D1)
/D2: RN1.2 (R2.1), U1.14 (PB2), U2.9 (B)
/D2_s: RN1.7 (R2.2), SW3.4 (D2)
/D3: RN1.1 (R1.1), U1.15 (PB3), U2.3 (G)
/D3_s: RN1.8 (R1.2), SW3.5 (D3)
/D4: RN2.4 (R4.1), U1.16 (PB4), U2.8 (C)
/D4_s: RN2.5 (R4.2), SW4.2 (D0)
/D5: J2.1 (MOSI), RN2.3 (R3.1), U1.17 (PB5), U2.4 (E)
/D5_s: RN2.6 (R3.2), SW4.3 (D1)
/D6: J2.9 (MISO), RN2.2 (R2.1), U1.18 (PB6), U2.7 (DP)
/D6_s: RN2.7 (R2.2), SW4.4 (D2)
/D7: J2.7 (SCK), RN2.1 (R1.1), U1.19 (PB7), U2.5 (D)
/D7_s: RN2.8 (R1.2), SW4.5 (D3)
/DISP_MUX: R6.1, U1.8 (PD4), U1.9 (PD5), U1.11 (PD6)
/L: J1.2, K1.5, R1.1, RV1.1
/L-: D2.2 (A), D5.1 (K), R1.2
/LED: R2.1, U1.2 (PD0)
/LED_r: D1.2 (A), R2.2
/Lout: J3.2, K1.3
/N: C1.1, J1.1, J3.1, RV1.2
/N-: C1.2, D3.2 (A), D4.1 (K)
/ONOFF: SW1.1, SW1.3, U1.6 (PD2)
/OUT: R3.2, U1.3 (PD1)
/POL: SW2.1 (A), U1.7 (PD3)
/REL: D8.1 (K), K1.1, Q2.3 (C)
/REL_pre: Q2.2 (B), R4.1, R5.2
/RST: J2.5 (~RST), U1.1 (PA2/~RESET)
/XT1: C8.1, U1.5 (PA0/XTAL1), Y1.2
/XT2: C6.1, C7.1, U1.4 (PA1/XTAL2), Y1.1
GND: C3.2, C5.2, C6.2, C7.2, C8.2, D1.1 (K), D4.2 (A), D5.2 (A), D7.2 (A), J2.4 (GND), J2.6 (GND), J2.8 (GND), J2.10 (GND), Q1.1 (E), U1.10 (GND), Y1.3
unnamed: Q1.2 (B), R3.1
unnamed: Q1.3 (C), R5.1

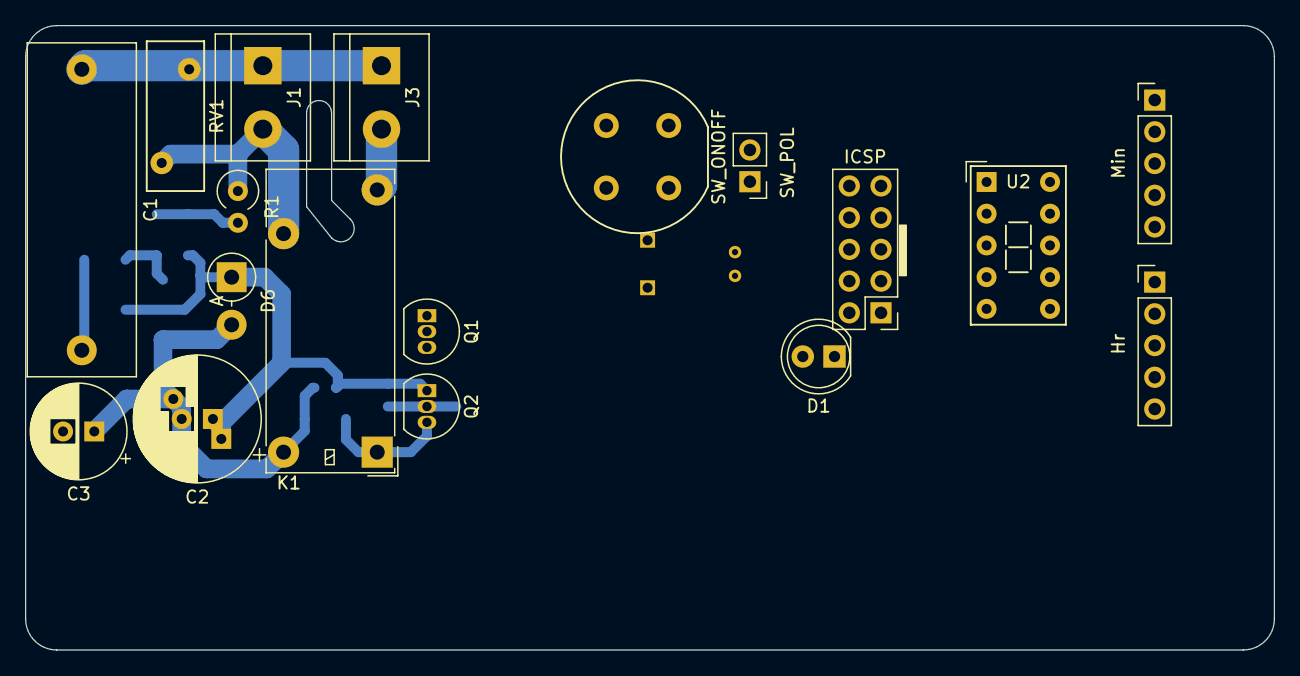
[picture p304: board mains_timer.kicad_pcb from above]

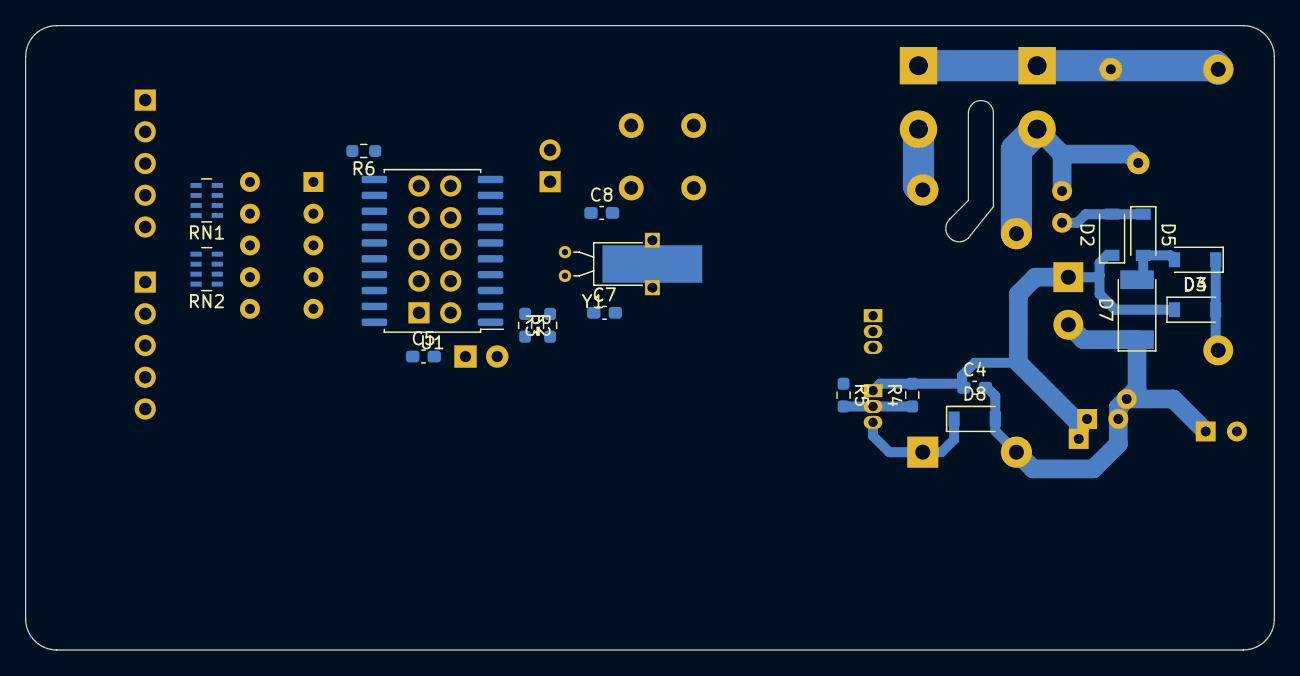
[picture p305: board mains_timer.kicad_pcb from below]

Board: 2 copper layers, 100.0 x 50.0 mm, 37 parts (19 on the bottom side), 38 nets.
