reivax-boucoi/PCB_Kicad/hv_flasher/hv_flasher.kicad_pcb

## KiCad design hv_flasher/hv_flasher.kicad_pcb (2022-01-04)

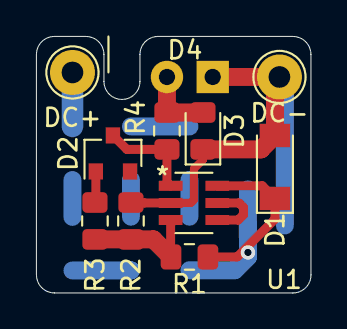
[picture p306: board hv_flasher.kicad_pcb from above]

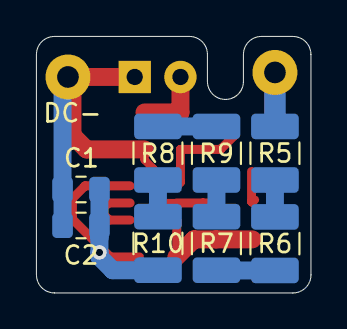
[picture p307: board hv_flasher.kicad_pcb from below]

Board: 2 copper layers, 15.2 x 14.2 mm, 19 parts (8 on the bottom side), 13 nets.

Parts:
C1, C2: 10u; C_0805_2012Metric_Pad1.15x1.40mm_HandSolder
D1: D_Zener; D_MiniMELF
D2: BAT54W; SOT-23
D3: LED; LED_0805_2012Metric_Pad1.15x1.40mm_HandSolder
D4: LED; LED_D5.0mm
DC+: DC+; TestPoint_THTPad_D2.5mm_Drill1.2mm
DC-: DC-; TestPoint_THTPad_D2.5mm_Drill1.2mm
R1, R2, R3: 100k; R_0805_2012Metric_Pad1.15x1.40mm_HandSolder
R4: 1k; R_0805_2012Metric_Pad1.15x1.40mm_HandSolder
R5, R6, R7, R8, R9, R10: 100k; R_1210_3225Metric_Pad1.42x2.65mm_HandSolder
U1: MCP65R41T-2402E_CHY; MCP65R41T-2402E

Connections:
/IN+: R1.1, R2.2, R3.2, U1.3
/OUT: D2.3, R4.1, U1.1
/Vdd: C1.1, C2.1, D1.1, R1.2, R10.2, U1.6
/Vref: U1.4, U1.5
/Vss: C1.2, C2.2, D1.2, D3.1, D4.1, DC-.1, R2.1, U1.2
unnamed: D2.1, R3.1
unnamed: D3.2, D4.2, R4.2
unnamed: DC+.1, R5.1
unnamed: R5.2, R6.1
unnamed: R6.2, R7.1
unnamed: R7.2, R8.1
unnamed: R8.2, R9.1
unnamed: R9.2, R10.1
