reivax-boucoi/PCB_Kicad/solar_switch/solar_switch.kicad_pcb

## KiCad design solar_switch/solar_switch.kicad_pcb (2022-01-03)

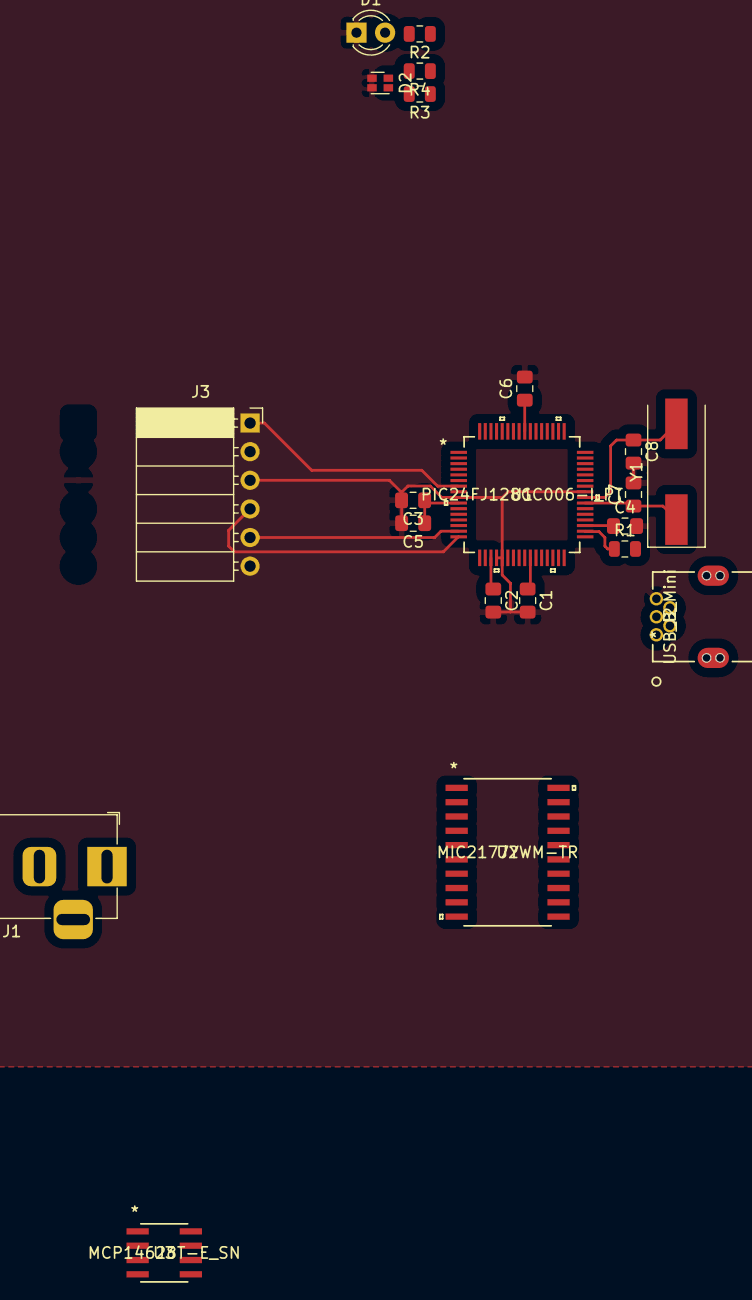
[picture p308: board solar_switch.kicad_pcb from above]

Board: 2 copper layers, 21 parts (0 on the bottom side), 21 nets.

Parts:
C1, C2, C3, C4: 100n; C_0805_2012Metric_Pad1.15x1.40mm_HandSolder
C5, C6: 10u; C_0805_2012Metric_Pad1.15x1.40mm_HandSolder
C7, C8: 15p; C_0805_2012Metric_Pad1.15x1.40mm_HandSolder
D1: LED; LED_D3.0mm
D2: LED_Dual_AACC; LED_LiteOn_LTST-C19HE1WT
J1: Jack-DC; BarrelJack_Horizontal
J2: USB_B_Mini; 54819-0519
J3: Conn_PIC_ICSP_ICD; PinSocket_1x06_P2.54mm_Horizontal
R1: 100; R_0805_2012Metric
R2, R3, R4: 470; R_0805_2012Metric
U1: PIC24FJ128GC006-I_PT; PIC24FJ128GC006-I&slash_PT
U2: MIC2177YWM-TR
U3: MCP14628T-E_SN; MCP14628T-E&slash_SN
Y1: Crystal; Crystal_SMD_HC49-SD

Connections:
+3V3: C3.1, C4.1, C5.1, J3.2, U1.10, U1.35, U1.38, U1.57
/AVDD: C2.1, U1.19
/D+: J2.3, U1.37
/D-: J2.2, U1.36
/MCLR: J3.1, U1.7
/PGEC1: J3.5, U1.15
/PGED1: J3.4, U1.16
/SVDD: C1.1, U1.26
/Vcap: C6.1, U1.56
GND: C1.2, C2.2, C3.2, C4.2, C5.2, C6.2, C7.2, C8.2, D1.1, D2.3, D2.4, J2.5, J3.3, U1.9, U1.20, U1.21, U1.41
unnamed: C7.1, U1.39, Y1.1
unnamed: C8.1, U1.40, Y1.2
unnamed: D1.2, R2.2
unnamed: D2.1, R4.2
unnamed: D2.2, R3.2
unnamed: J2.1, R1.2
unnamed: U2.1, U2.2, U2.9
unnamed: U2.3, U2.8
unnamed: U2.4, U2.5, U2.6, U2.7
unnamed: U2.14, U2.15, U2.16, U2.17
VBUS: R1.1, U1.34
