reivax-boucoi/PCB_Kicad/LED_poi/CTRL_board/LED_poi.kicad_sch

## KiCad design LED_poi/CTRL_board/LED_poi.kicad_sch (2024-03-01)

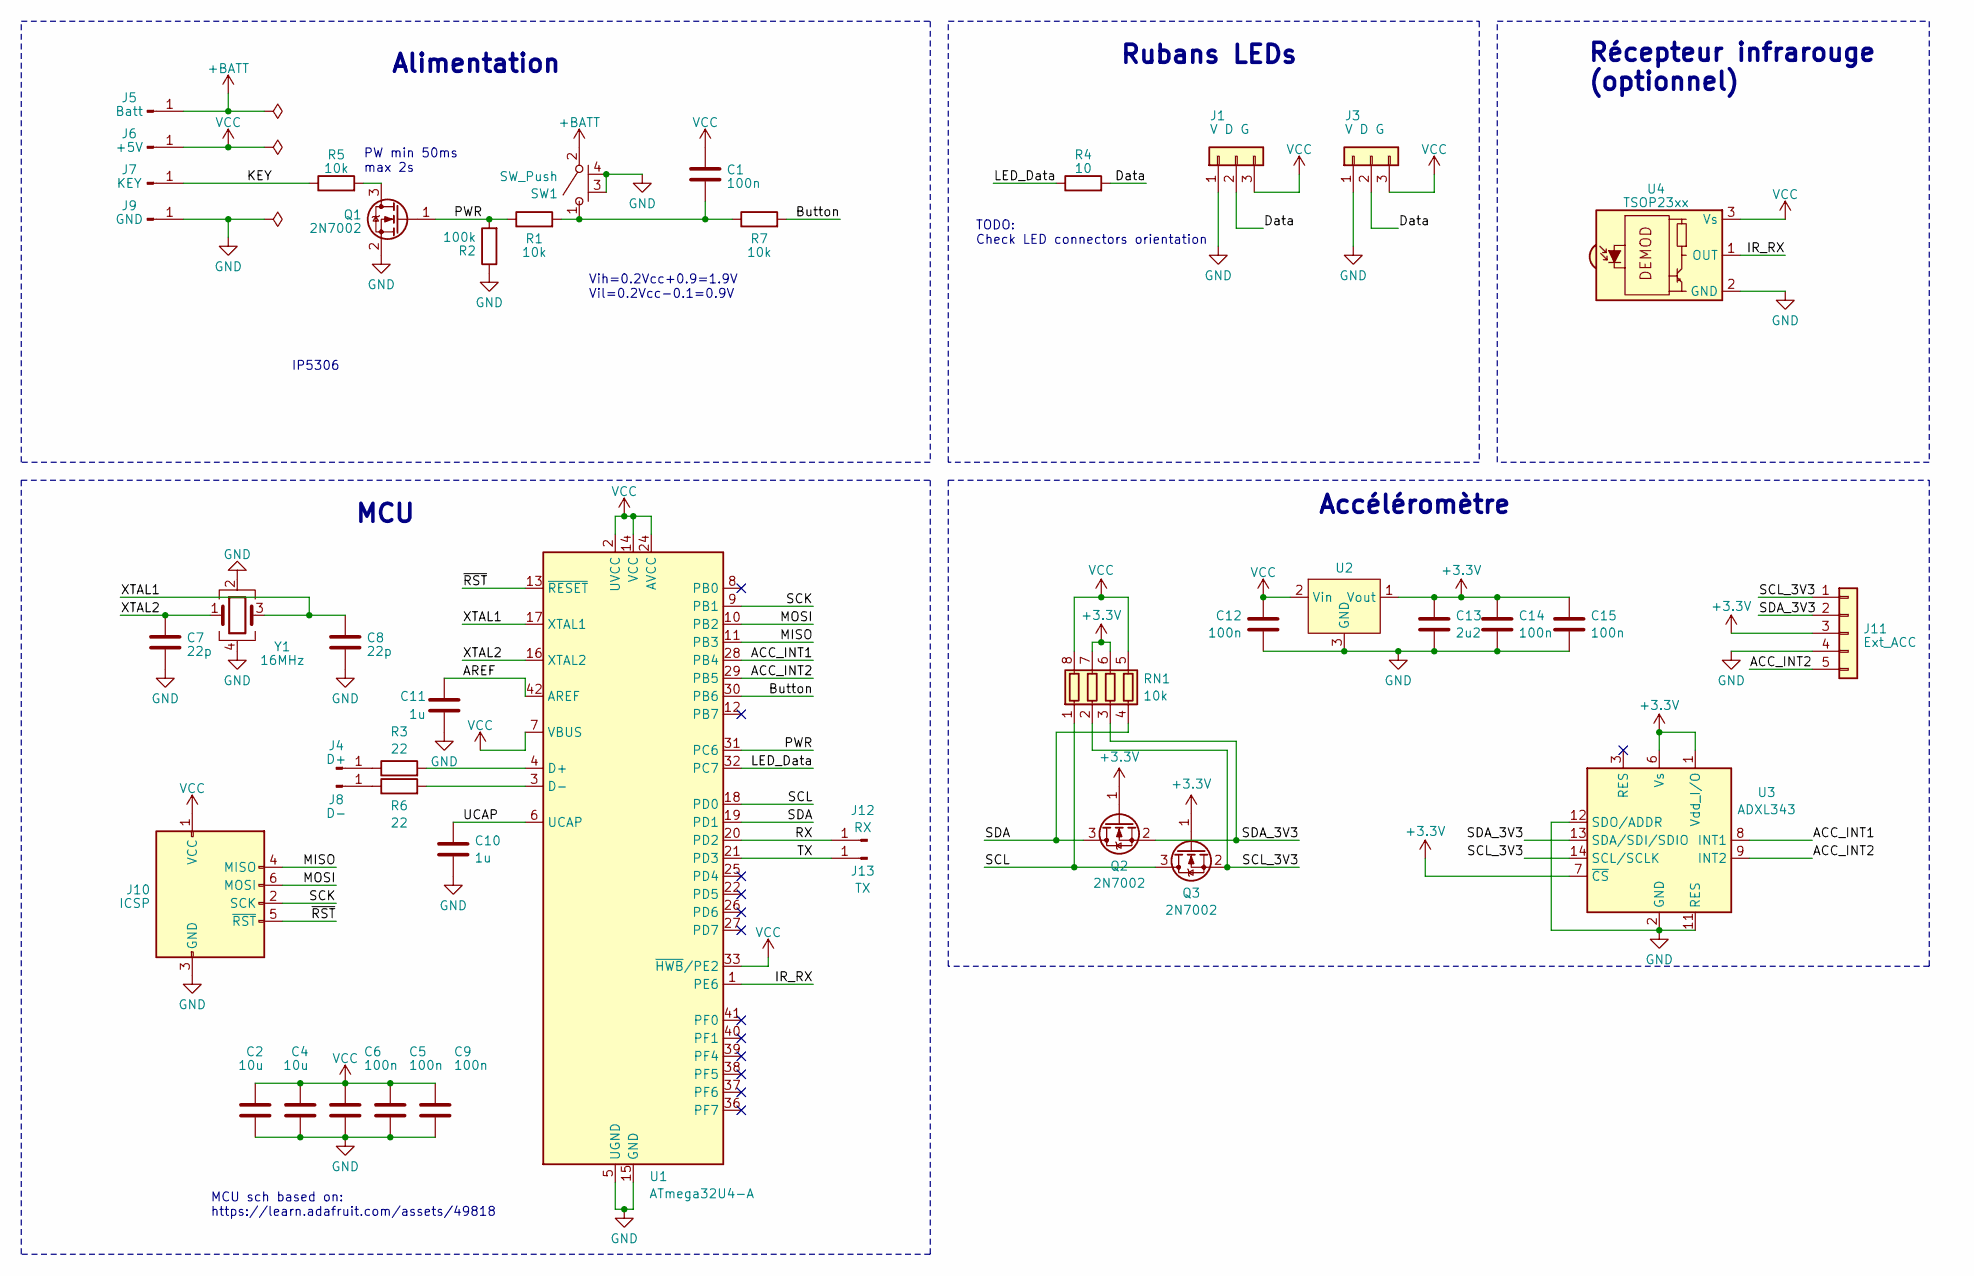
[picture p309: schematic LED_poi.kicad_sch]

Parts:
C1, C5, C6, C9, C12, C14, C15: 100n; C_0603_1608Metric
C2, C4: 10u; C_0805_2012Metric
C7, C8: 22p; C_0603_1608Metric
C10, C11: 1u; C_0603_1608Metric
C13: 2u2; C_0603_1608Metric
J1, J3: V D G; 1x03_BrdEdge_wirePad
J4: D+; SolderWirePad_1x01_SMD_1x2mm
J5: Batt; SolderWire-0.1sqmm_1x01_D0.4mm_OD1mm
J6: +5V; SolderWire-0.1sqmm_1x01_D0.4mm_OD1mm
J7: KEY; SolderWire-0.1sqmm_1x01_D0.4mm_OD1mm
J8: D-; SolderWirePad_1x01_SMD_1x2mm
J9: GND; SolderWire-0.1sqmm_1x01_D0.4mm_OD1mm
J10: ICSP; Tag-Connect_TC2030-IDC-NL_2x03_P1.27mm_Vertical
J11: Ext_ACC; 1x05_BrdEdge_wirePad
J12: RX; SolderWirePad_1x01_SMD_1x2mm
J13: TX; SolderWirePad_1x01_SMD_1x2mm
Q1, Q2, Q3: 2N7002; SOT-23
R1, R5, R7: 10k; R_0805_2012Metric
R2: 100k; R_0805_2012Metric
R3, R6: 22; R_0805_2012Metric
R4: 10; R_0805_2012Metric
RN1: 10k; R_Array_Convex_4x1206
SW1: SW_Push; TL3330
U1: ATmega32U4-A; TQFP-44_10x10mm_P0.8mm
U2: SOT-23
U3: ADXL343; LGA-14_3x5mm_P0.8mm_LayoutBorder1x6y
U4: TSOP23xx; Vishay_MINICAST-3Pin
Y1: 16MHz; Crystal_SMD_SeikoEpson_FA238-4Pin_3.2x2.5mm

Connections:
+3.3V: C13.1, C14.1, C15.1, J11.3, Q2.1 (G), Q3.1 (G), RN1.6 (R3.2), RN1.7 (R2.2), U2.1 (Vout), U3.1 (Vdd_I/O), U3.6 (Vs), U3.7 (~CS)
+BATT: J5.1, SW1.2 (B)
ACC_INT1: U1.28 (PB4), U3.8 (INT1)
ACC_INT2: J11.5, U1.29 (PB5), U3.9 (INT2)
AREF: C11.1, U1.42 (AREF)
Button: R7.2, U1.30 (PB6)
Data: J1.2, J3.2, R4.2
GND: C2.2, C4.2, C5.2, C6.2, C7.2, C8.2, C9.2, C10.2, C11.2, C12.2, C13.2, C14.2, C15.2, J1.1, J3.1, J9.1, J10.3 (GND), J11.4, Q1.2 (S), R2.1, SW1.3 (C), SW1.4 (Shield), U1.5 (UGND), U1.15 (GND), U1.23 (GND), U1.35 (GND), U1.43 (GND), U2.3 (GND), U3.2 (GND), U3.4 (GND), U3.5 (GND), U3.11 (RES), U3.12 (SDO/ADDR), U4.2 (GND), Y1.2, Y1.4
IR_RX: U1.1 (PE6), U4.1 (OUT)
KEY: J7.1, R5.1
LED_Data: R4.1, U1.32 (PC7)
MISO: J10.4 (MISO), U1.11 (PB3)
MOSI: J10.6 (MOSI), U1.10 (PB2)
unnamed: C1.1, R1.2, R7.1, SW1.1 (A)
unnamed: J4.1, R3.1
unnamed: J8.1, R6.1
unnamed: Q1.3 (D), R5.2
unnamed: R3.2, U1.4 (D+)
unnamed: R6.2, U1.3 (D-)
PWR: Q1.1 (G), R1.1, R2.2, U1.31 (PC6)
RX: J12.1, U1.20 (PD2)
SCK: J10.2 (SCK), U1.9 (PB1)
SCL: Q3.3 (D), RN1.1 (R1.1), U1.18 (PD0)
SCL_3V3: J11.1, Q3.2 (S), RN1.2 (R2.1), U3.14 (SCL/SCLK)
SDA: Q2.3 (D), RN1.4 (R4.1), U1.19 (PD1)
SDA_3V3: J11.2, Q2.2 (S), RN1.3 (R3.1), U3.13 (SDA/SDI/SDIO)
TX: J13.1, U1.21 (PD3)
UCAP: C10.1, U1.6 (UCAP)
VCC: C1.2, C2.1, C4.1, C5.1, C6.1, C9.1, C12.1, J1.3, J3.3, J6.1, J10.1 (VCC), RN1.5 (R4.2), RN1.8 (R1.2), U1.2 (UVCC), U1.7 (VBUS), U1.14 (VCC), U1.24 (AVCC), U1.33 (~HWB/PE2), U1.34 (VCC), U1.44 (AVCC), U2.2 (Vin), U4.3 (Vs)
XTAL1: C8.1, U1.17 (XTAL1), Y1.3
XTAL2: C7.1, U1.16 (XTAL2), Y1.1
~RST: J10.5 (~RST), U1.13 (~RESET)

Notes on the sheet:
MCU
TODO: Check LED connectors orientation
IP5306
Accéléromètre
Rubans LEDs
MCU sch based on: https://learn.adafruit.com/assets/49818
Alimentation
PW min 50ms max 2s
Vih=0.2Vcc+0.9=1.9V Vil=0.2Vcc-0.1=0.9V
Récepteur infrarouge (optionnel)
