reivax-boucoi/PCB_Kicad/weight_scale/Software/course/LCD.cpp

#include "LCD.h"

const uint8_t LCD::NbMap[]={0x3F,0x6,0x5B,0x4F,0x66,0x6D,0x7D,0x7,0x7F,0x6F};
LCD::digit LCD::digits[]={
		{{2,2,2,3,3,3,3},{&LCDDR1,&LCDDR6,&LCDDR11,&LCDDR16,&LCDDR11,&LCDDR1,&LCDDR6}},
		{{0,0,0,1,1,1,1},{&LCDDR1,&LCDDR6,&LCDDR11,&LCDDR16,&LCDDR11,&LCDDR1,&LCDDR6}},
		{{6,6,6,7,7,7,7},{&LCDDR0,&LCDDR5,&LCDDR10,&LCDDR15,&LCDDR10,&LCDDR0,&LCDDR5}},
		{{4,4,4,5,5,5,5},{&LCDDR0,&LCDDR5,&LCDDR10,&LCDDR15,&LCDDR10,&LCDDR0,&LCDDR5}},
		{{2,2,2,3,3,3,3},{&LCDDR0,&LCDDR5,&LCDDR10,&LCDDR15,&LCDDR10,&LCDDR0,&LCDDR5}},
		{{0,0,0,1,1,1,1},{&LCDDR0,&LCDDR5,&LCDDR10,&LCDDR15,&LCDDR10,&LCDDR0,&LCDDR5}}};

LCD::LCD(bool lowP){
	DDRB |= (1 << PB0);
	PORTB |= (1<<PB0);
	LCDCRB|=(1<<LCDMUX1)|(1<<LCDMUX0);
	
	if(lowP){
		
#if (F_CPU==1000000)
		LCDFRR|=(1<<LCDPS2)|(1<<LCDCD2)|(1<<LCDCD1)|(1<<LCDCD0); // prescaler 512, division factor 32 & K=8 for duty 1/4
#else
		LCDFRR|=(1<<LCDPS2)|(1<<LCDPS1)|(1<<LCDPS0)|(1<<LCDCD2)|(1<<LCDCD1)|(1<<LCDCD0); // prescaler 4096, division factor 32 & K=8 for duty 1/4
#endif
		LCDCCR|=(1<<LCDDC0);// 2.6V 70µs
		LCDCRA|=(1<<LCDEN)|(1<<LCDAB);//LCDAB=low power waveform
	}else{
#if (F_CPU==1000000)
		LCDFRR|=(1<<LCDPS2)|(1<<LCDCD2)|(1<<LCDCD2)|(1<<LCDCD0); // prescaler 512, division factor 8 & K=8 for duty 1/4
#else
		LCDFRR|=(1<<LCDPS2)|(1<<LCDPS1)|(1<<LCDPS0)|(1<<LCDCD2)|(1<<LCDCD2)|(1<<LCDCD0); // prescaler 4096, division factor 8 & K=8 for duty 1/4
#endif
		LCDCCR|=(1<<LCDCC1)|(1<<LCDCC2)|(1<<LCDDC1);//2.7V 1150µs
		LCDCRA|=(1<<LCDEN);
	}
}

LCD::~LCD() {
	LCDCRA|=(1<<LCDBL);
	_delay_ms(500);
	LCDCRA&=~(1<<LCDEN);
}

void LCD::setDigit(uint8_t dig, uint8_t nb) {
	for(uint8_t j=0;j<8;j++){
		if(NbMap[nb] & (1<<j)){
			*(digits[dig].dr[j]) |= (1<<digits[dig].s[j]);
		}else{
			*(digits[dig].dr[j]) &= ~(1<<digits[dig].s[j]);
		}	
	}
}

void LCD::setDigit(uint8_t dig, Symbol sy) {
	for(uint8_t j=0;j<8;j++){
		if(sy & (1<<j)){
			*(digits[dig].dr[j]) |= (1<<digits[dig].s[j]);
		}else{
			*(digits[dig].dr[j]) &= ~(1<<digits[dig].s[j]);
		}
	}
}

void LCD::setBattery(Battery b) {
	switch(b){
	case NONE:
		LCDDR1 &=~(1<<4);
		LCDDR6 &=~(1<<4);
		LCDDR11 &=~(1<<4);
		LCDDR16 &=~(1<<4);
		break;
	case EMPTY:
		LCDDR1 |=(1<<4);
		LCDDR6 &=~(1<<4);
		LCDDR11 &=~(1<<4);
		LCDDR16 &=~(1<<4);
		break;
	case FIRST:
		LCDDR1 &=~(1<<4);
		LCDDR6 &=~(1<<4);
		LCDDR11 &=~(1<<4);
		LCDDR16 |=(1<<4);
		break;
	case SECOND:
		LCDDR1 &=~(1<<4);
		LCDDR6 &=~(1<<4);
		LCDDR11 |=(1<<4);
		LCDDR16 &=~(1<<4);
		break;
	case THIRD:
		LCDDR1 &=~(1<<4);
		LCDDR6 |=(1<<4);
		LCDDR11 &=~(1<<4);
		LCDDR16 &=~(1<<4);
		break;
	case ONEBAR:
		LCDDR1 |=(1<<4);
		LCDDR6 &=~(1<<4);
		LCDDR11 &=~(1<<4);
		LCDDR16 |=(1<<4);
		break;
	case TWOBAR:
		LCDDR1 |=(1<<4);
		LCDDR6 &=~(1<<4);
		LCDDR11 |=(1<<4);
		LCDDR16 |=(1<<4);
		break;
	case FULL:
		LCDDR1 |=(1<<4);
		LCDDR6 |=(1<<4);
		LCDDR11 |=(1<<4);
		LCDDR16 |=(1<<4);
		break;
	}
}

void LCD::setDP(bool b) {
	if(b){
		LCDDR15|=(1<<4);
	}else{
		LCDDR15&=~(1<<4);
	}
}

void LCD::setClk(bool b) {
	if(b){
		LCDDR16|=1;
	}else{
		LCDDR16&=~1;
	}
}

bool LCD::getDP(void) {
	return (LCDDR15 & (1<<4));
}

bool LCD::getClk(void) {
	return (LCDDR16 & 1);
}



uint8_t LCD::setNb(int32_t nb, uint8_t dig) {
	if(nb>999999 || nb <-99999){
		return 1;
	}
	int8_t d=5;
	uint8_t min=6-dig;
	if(nb<0){
		setDigit(min,Minus);
		min++;
		nb=(~nb)+1;
	}
	while(d>=min){
		setDigit(d--,nb%10);
		nb/=10;
		if(nb==0)break;
	}
	while(d>=min)setDigit(d--,Blank);
	return 0;
}

uint8_t LCD::setNb(int32_t nb) {
	return setNb(nb,6);
}

void LCD::clear(void) {
	clear(true);
}
void LCD::clear(bool clearBatt) {
	if(clearBatt)setBattery(NONE);
	setClk(false);
	setDP(false);
	for(int8_t i=5;i>=0;i--)setDigit(i,Blank);
}
