reivax-boucoi/PCB_Kicad/LED_poi/Software/test0/utils.h

#ifndef utils_h
#define utils_h

#include <Arduino.h>
#include "Animations.h"

extern Animations* myAnimations;
#define KEY 5           //PC6 (output, active high)
#define BTN 10          //PB6 (input, active high)
#define ACC_INT1 8      //PB4 (input, active high, 3.3V)
#define ACC_INT2 9      //PB5 (input, active high, 3.3V)

void IO_initialize();

void supply_ON();
void supply_OFF();

#define BTN_SHORT_PRESS 20
#define BTN_LONG_PRESS 2000

class Button {
    private:
        bool pstate;
        bool newstate;
        uint32_t pressTime;
    public:
        Button(void);
        uint8_t wasPressed(void);
};
#endif
