reivax-boucoi/PCB_Kicad/weight_scale/Software/test_brd0/ADC.h

#ifndef ADC_H_
#define ADC_H_

#include <avr/io.h>
#include <util/delay.h>

#define MCP3462_OSR 0b1010 //20480     Use OSR>=20480 to get 50Hz rejection
#define MCP3462_AMCLK_PSC 0b00 // No divide
#define MCP3462_GAIN 0b101//Max analog gain is 16

#define SPI_CS_PORT PORTB
#define SPI_CS_PIN PINB0
#define SPI_CS_DDR DDRB

#define DATA_READY (PINE&(1<<7))


//CMD frame: 2 device addr bits / 4 reg addr bits / 2 cmd type bits
#define SPI_ADDR 0b01000000
#define SPI_TYPE_STATIC_R 0b00000001
#define SPI_TYPE_INC_R 0b00000011
#define SPI_TYPE_INC_W 0b00000010

#define REG_ADCDATA (0x00<<2)
#define REG_CONFIG0 (0x01<<2)
#define REG_CONFIG1 (0x02<<2)
#define REG_CONFIG2 (0x03<<2)
#define REG_CONFIG3 (0x04<<2)
#define REG_IRQ     (0x05<<2)
#define REG_MUX     (0x06<<2)
#define REG_SCAN    (0x07<<2)
#define REG_TIMER   (0x08<<2)

//status byte 0b00010abc
//a=data ready (active low)
//b=CRC error (active low)
//c=POR (active low)

class MCP3462 {
public:
    MCP3462(void);
    ~MCP3462(void);
    bool isDataReady(void);
    int32_t getDirectData(void);
    int32_t getGainedData(void);
private:
    uint8_t transmit(uint8_t d);
    int32_t readADCreg(void);
};


#endif
