reivax-boucoi/PCB_Kicad/weight_scale/Software/test_brd0/scale.h

#ifndef SCL_H_
#define SCL_H_

#include <avr/io.h>
#include "ADC.h"
#include "UART.h"

#define SCALE_GAIN 191//1.907g/bit

class Scale{
public:
    Scale(UART* u);
    ~Scale(void);
    int32_t gain;
    int32_t offset;
    int32_t value;
    int32_t value_scl;
    int32_t getWeight(void);
    int32_t tare(void);
    void showWeight(bool verbose);
    
private:
    MCP3462 myADC;
    UART *uart;
    
};

#endif
