reivax-boucoi/PCB_Kicad/(commit log)

2022-01-01 added project
    [3phase_gen-drl_map.dxf, 3phase_gen.kicad_pcb, 3phase_gen.ods, 3phase_gen.sch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]
2022-01-09 added case
    [LabBooster-drl_map.dxf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]
2023-04-11 PCINT and LCD low power
    [weight_scale.kicad_pcb, weight_scale.kicad_sch]
2023-04-12 reorg wieght scale folder
    [calculations.ods, weight_scale.kicad_pcb, weight_scale.kicad_sch]
2023-04-16 uart under test
    [calculations.ods, weight_scale.kicad_pcb, weight_scale.kicad_sch]
2023-04-23 ADC basics
2023-05-24 Slide switch library
    [calculations.ods, usb_switch.kicad_sch]
2023-08-26 added board gerbers
    [RGB_strip_driver-B_Cu.gbr, RGB_strip_driver-B_Mask.gbr, RGB_strip_driver-B_Paste.gbr, RGB_strip_driver-Edge_Cuts.gbr, RGB_strip_driver-F_Cu.gbr, RGB_strip_driver-F_Mask.gbr, RGB_strip_driver-F_Paste.gbr, RGB_strip_driver.drl]
2023-08-30 removed backups
    [solar_mppt1-B_Cu.gbr, solar_mppt1-B_Mask.gbr, solar_mppt1-B_Paste.gbr, solar_mppt1-B_SilkS.gbr, solar_mppt1-Edge_Cuts.gbr, solar_mppt1-F_Cu.gbr, solar_mppt1-F_Mask.gbr, solar_mppt1-F_Paste.gbr]
2023-08-30 added usb mini through hole
2023-08-30 removed old .pro
    [3phase_gen.drl]
2023-09-01 added hall sensor
    [hall_sensor_matrix.kicad_pcb, hall_sensor_matrix.kicad_sch]
2023-09-20 added v2
    [driver.kicad_sch, hall_sensor_matrix_v2.kicad_pcb, hall_sensor_matrix_v2.kicad_sch]
2023-09-24 added led driver calcs
    [weight_scale.csv]
2023-09-26 created MIC28517
    [MIC28517.kicad_pcb, MIC28517.kicad_sch]
2023-09-26 added pending items
    [10counter.kicad_sch, 10decoder.kicad_sch, 10digit.kicad_sch, 2counter.kicad_sch, 2decoder.kicad_sch, 6counter.kicad_sch, 6decoder.kicad_sch, 6digit.kicad_sch]
2023-09-27 added ltspice
    [hall_sensor_matrix_v2-B_Cu.gbr, hall_sensor_matrix_v2-B_Mask.gbr, hall_sensor_matrix_v2-B_Paste.gbr, hall_sensor_matrix_v2-B_Silkscreen.gbr, hall_sensor_matrix_v2-Edge_Cuts.gbr, hall_sensor_matrix_v2-F_Cu.gbr, hall_sensor_matrix_v2-F_Mask.gbr, hall_sensor_matrix_v2-F_Paste.gbr]
2023-10-01 added content
    [10counter.kicad_sch, 10decoder.kicad_sch, 10digit.kicad_sch, 2counter.kicad_sch, 2decoder.kicad_sch, 6counter.kicad_sch, 6digit.kicad_sch, DivBy5.kicad_sch]
2023-11-01 found sch issue
    [led_boost_MIC3230.kicad_sch]
2024-01-09 added svg viz
    [PSU.kicad_sch, segment.kicad_sch, transistor_clock.kicad_sch]
2025-11-05 added preliminary sch
    [proto_expo_v0.kicad_pcb, proto_expo_v0.kicad_sch]
2025-11-18 added proto v0
    [proto_expo_v0.kicad_pcb, proto_expo_v0.kicad_sch]
2025-11-18 added TODO list
    [proto_expo_v0.kicad_sch]
2025-11-18 added schematic pdf export
2025-11-28 fix typo
    [proto_expo_v0.kicad_pcb, proto_expo_v0.kicad_sch]
2026-03-04 local nx comm
    [RCP_PWM_breakout.kicad_pcb, RCP_PWM_breakout.kicad_sch]
2026-03-25 added PCB_Ventil revA
    [NID100-5.stp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]
2026-03-25 new rev with Mano
    [PCB_Ventil-B_Cu.gbr, PCB_Ventil-B_Mask.gbr, PCB_Ventil-B_Paste.gbr, PCB_Ventil-B_Silkscreen.gbr, PCB_Ventil-Edge_Cuts.gbr, PCB_Ventil-F_Cu.gbr, PCB_Ventil-F_Mask.gbr, PCB_Ventil-F_Paste.gbr]
2026-03-25 new BOM with resistors
    [PCB_Ventil_BOM.ods]
2026-08-23 added Liion charger
2026-08-23 export final bikelight2 docs
    [bike_lights2.step]
2026-08-24 added split_flap_driver_schematic
    [bike_lights2-B_Cu.gbr, bike_lights2-B_Mask.gbr, bike_lights2-B_Paste.gbr, bike_lights2-B_Silkscreen.gbr, bike_lights2-Edge_Cuts.gbr, bike_lights2-F_Cu.gbr, bike_lights2-F_Mask.gbr, bike_lights2-F_Paste.gbr]
2026-08-25 update TL431 to T092
    [bike_lights2-B_Cu.gbr, bike_lights2-B_Mask.gbr, bike_lights2-B_Paste.gbr, bike_lights2-B_Silkscreen.gbr, bike_lights2-Edge_Cuts.gbr, bike_lights2-F_Cu.gbr, bike_lights2-F_Mask.gbr, bike_lights2-F_Paste.gbr]
2026-08-28 added split flap source files & assembly
    [split-flap_display.kicad_pcb, split-flap_display.kicad_sch]
2026-08-30 added RCp breakout rev B
    [RCP_PWM_breakout-B_Cu.gbr, RCP_PWM_breakout-B_Mask.gbr, RCP_PWM_breakout-B_Paste.gbr, RCP_PWM_breakout-B_Silkscreen.gbr, RCP_PWM_breakout-Edge_Cuts.gbr, RCP_PWM_breakout-F_Cu.gbr, RCP_PWM_breakout-F_Mask.gbr, RCP_PWM_breakout-F_Paste.gbr]
2026-08-30 added gerbers zip
    [RCP_PWM_breakout-B_Cu.gbr, RCP_PWM_breakout-B_Mask.gbr, RCP_PWM_breakout-B_Paste.gbr, RCP_PWM_breakout-B_Silkscreen.gbr, RCP_PWM_breakout-Edge_Cuts.gbr, RCP_PWM_breakout-F_Cu.gbr, RCP_PWM_breakout-F_Mask.gbr, RCP_PWM_breakout-F_Paste.gbr]
2026-08-31 added sunlord breakout
    [Sunlord_breakout.kicad_pcb, Sunlord_breakout.kicad_sch]
2026-09-01 added revB
    [RCP_PWM_breakout.kicad_pcb, RCP_PWM_breakout.kicad_sch, RCP_PWM_breakout.step]
